owhinata/zaitaku-mealpace/docs/img/cover.png

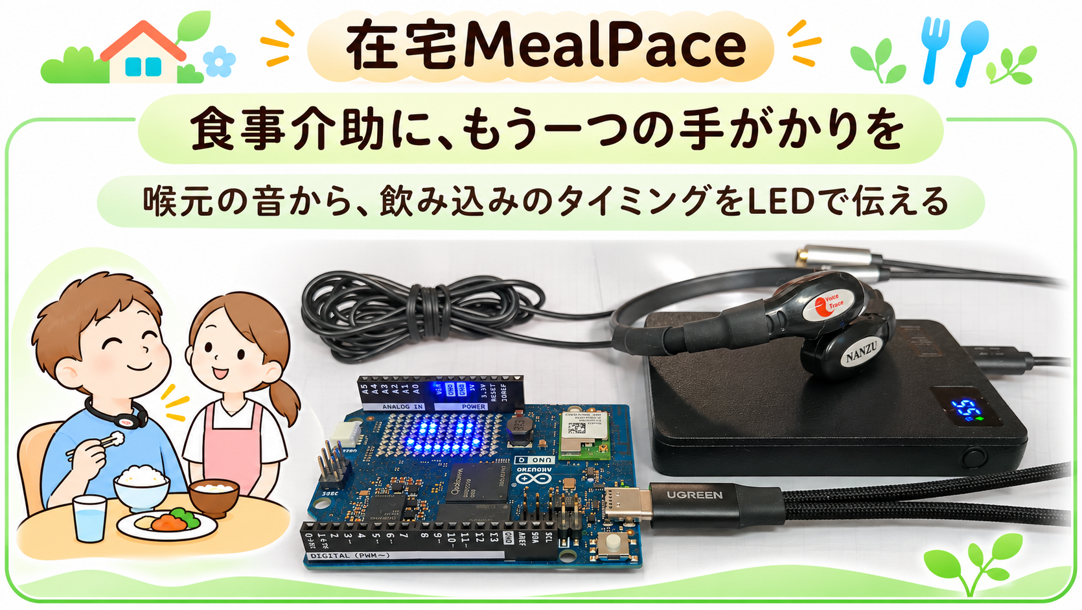
docs/img/cover.png
