owhinata/zaitaku-mealpace/data/README.md

# data/

- `raw/`: ローカルのみ。.gitignore 済み。**コミットしない。**
- `sample/`: 被験者 `self` の 10 秒以内の見本のみ。形式の確認用。
  `tools/record.py` の出力先は `raw/` 固定なので、見本は `raw/` から手でコピーして置く
  （docs/decisions/0007）。
  見本は `self` / `quiet` の記録から、連続する 10.000 秒（音声 2500 チャンクと同じ時刻の範囲の IMU）を
  切り出したもの。`sample_index` は 0 始まりに振り直し、`t_ms` は元のまま（装置の `millis()`。0 始まりではない）。
  IMU の実効レートは約 105.5 Hz（公称 104 Hz）。時刻は `t_ms` が正。

被験者 `p1` の生データは `self` と同じく `raw/` に置き、モデル確定後に削除する。`sample/` には置かない（CLAUDE.md、docs/decisions/0048）。
