owhinata/zaitaku-mealpace/analysis/README.md

# analysis/

PC 側の解析・評価。ファームウェアが何で書かれていても、`docs/data-schema.md` の形式が入力。

- `features.py`   窓ごとの特徴量（IMU＋音。M1 の式、docs/decisions/0012。咽喉マイクは音の 15 次元だけ、docs/decisions/0031）
- `features_m2.py`  窓ごとの特徴量（IMU＋音。M2 の式、docs/decisions/0020。IMU と窓は `features.py` を流用）
- `evaluate.py`   `docs/evaluation.md` の定義でイベント単位の検出率・誤検出率を出す
- `split.py`      セッション単位で学習／評価を分ける（窓単位の分割は実装しない）
- `train_eval.py` M1 の分岐点: ロジスティック回帰で学習し、上の3つを使って採点した報告を出す（`--throat` で咽喉マイクのセッション。M3）
- `features_v2.py`・`postprocess.py`・`compare.py`・`visualize.py` 咽喉マイクの特徴量の組と後処理を学習側の交差検証だけで比べ、図にする（#43、docs/decisions/0033）
- `features_np.py`・`make_features_np_consts.py` 咽喉マイクの間引き・`mfe40`・`a52`・CNN の順伝播の numpy だけの実装（装置と PC で同じコード）と、それが読むメル行列・照合用の参照を作るスクリプト（#44、docs/decisions/0035 の追記）
- `make_runtime_models.py` 乱数の重みの CNN を ONNX・TFLite・ncnn に書き出す（UNO Q の推論ランタイムの比較の計測用。学習済みではない。#51、docs/decisions/0039）
- `final_eval.py` 咽喉マイクの評価側を、事前に登録した 2 つの構成で 1 回だけ採点する（#40、docs/decisions/0034）
- `m4_compare.py` M4 の誤検出を減らす候補（後処理・種の平均・hard negative）を M4 の学習側の交差検証だけで比べ、構成（docs/decisions/0038）と最終モデルを作る（#45）
- `m4_infer.py`   M4 の推論を装置（UNO Q の `detector.py`）と PC で同じコードで行う（重みの読み込み・`model_prob`・1 窓ずつ進める `Detector`・`code_sha256`。#47。`device/unoq/m4_infer.py` はこのファイルへのリンク）
- `evaluate_detector.py` M2 の検出器のセッション（`detect.csv`・`events.csv`）を `evaluate.py` の数え方で採点した報告を出す（#23、docs/decisions/0021）
- `led_rule.py`   `detect.csv` の `positive` と `window_t_ms` から LED の状態（1 黄 / 2 緑）を docs/decisions/0018 の規則で再計算する（#25。`firmware/detector/led_rule.h` と同じ式。評価には使わない）。1 窓ずつの `LedStepper` は装置の `detector.py` も使う（#47。`led_states` はその繰り返し）
- `ei_upload.py`  M2 の特徴量ベクトル（1 窓 1 項目）を Edge Impulse に投入する（#21。生の音声・IMU は上げない）
- `m2_norm_header.py` `m2_norm.json` → `firmware/detector/m2_norm.h`（正規化の定数。#22）
- `m2_scorer.py`  書き出した C++ ライブラリを PC 上で動かす実行ファイルで窓を採点する scorer（`evaluate_detector.py --scorer` の形。#22）
- `m2_threshold.py` 検証側（収集日4）をイベント単位に採点し、閾値の表を出して `firmware/detector/m2_threshold.h` に凍結する（#22）
- `ei_testing_result.py` Edge Impulse の Model testing の窓ごとの結果を API で取り、PC の確率と突き合わせる（#22）

M1 では `features.py` ＋ ロジスティック回帰、M2 から Edge Impulse。

## 特徴量（`features.py`）

窓は 1.0 秒 / 0.25 秒（`evaluate.py` の `WINDOW_S` / `HOP_S` を import する）。1窓 29 次元。式の定義と理由は
`docs/decisions/0012-feature-definitions.md`。M1 の PC 側の評価用の定義で、#13 の結果を見てから動かさない。
依存は numpy と標準ライブラリだけ。

```
python analysis/features.py <セッションフォルダ>
```

表示するのはセッション名・窓の数・次元・`valid` の数・最初と最後の `t_start_s` だけ。特徴量の値は表示しない。
特徴量をファイルに書く機能は無い（使う側が `extract_session` を呼んで、その場で計算する）。

```python
f = features.extract_session(session_dir)   # WindowFeatures(session, t_start_s (n,), X (n, 29) float32, valid (n,) bool)
s = features.Standardizer.fit([学習側の WindowFeatures, ...])   # valid な窓だけ。s.sessions に使ったセッション名
Z = s.transform(f.X)
```

`extract_session` は常に正規化前の値を返す。正規化の統計量は `Standardizer.fit` に渡したセッションだけから作る
（評価側を渡さない）。`std` が 0 の次元は 1 に置き換える。有効な窓が無い `fit`、末尾が 29 次元でない `transform` は
`ValueError`。戻り値に生の波形と IMU の系列は含めない。

### 次元の一覧（`FEATURE_NAMES` と同じ順）

前処理: 加速度 3 軸とジャイロ 3 軸は、それぞれ窓内の平均を引く。フィルタは掛けない。分散・RMS は ÷ n。

| # | 名前 | 定義 | 次元 |
|---|---|---|---|
| 0–2 | `acc_ptp_x` `acc_ptp_y` `acc_ptp_z` | 振幅: 加速度の各軸の peak-to-peak（g） | 3 |
| 3 | `gyro_norm_ptp` | 振幅: ジャイロのノルムの peak-to-peak（deg/s） | 1 |
| 4–6 | `acc_rms_x` `acc_rms_y` `acc_rms_z` | RMS: 加速度の各軸 | 3 |
| 7–9 | `gyro_rms_x` `gyro_rms_y` `gyro_rms_z` | RMS: ジャイロの各軸 | 3 |
| 10 | `acc_peak_count` | ピーク数: 加速度のノルムの局所極大（`x[i] > x[i−1]` かつ `x[i] ≥ x[i+1]`、窓の両端は数えない）。高さがノルムの窓内 RMS × 1.0 以上、最小間隔 50 ms（`t_ms` の差。近いものは高いほうを残す） | 1 |
| 11–13 | `acc_axis_x` `acc_axis_y` `acc_axis_z` | 主軸方向: 加速度の 3×3 共分散行列の第1固有ベクトル（単位ベクトル）。符号は Y、X、Z の順で最初の `|成分|` ≥ 1e-6 を正に。λ1 < 1e-8 g²（静止）か `λ1 − λ2 < 0.01 × λ1` のときは `[0, 1, 0]` | 3 |
| 14–26 | `mfcc_0` 〜 `mfcc_12` | MFCC: フレーム 25 ms（400）/ 10 ms（160）、Hamming、プリエンファシス 0.97、`n_fft` 512、パワーは `|FFT|² ÷ 512`、メル 26 本（0〜8000 Hz、HTK 式、三角フィルタは面積の正規化なし）、`log(E + 1e-10)`、DCT-II（ortho）の先頭 13 係数（c0 を含む）。窓内の 98 フレームの平均 | 13 |
| 27 | `spectral_centroid_hz` | スペクトル重心: フレーム（MFCC と同じ切り方、Hamming、プリエンファシス前）ごとの `Σ f·P / Σ P`（Hz）の窓内平均。`Σ P < 1e-12` のフレームは 0 | 1 |
| 28 | `zero_crossing_rate` | ゼロ交差率: 窓内の平均を引いた波形の符号（`≥ 0` を正）の変化回数 ÷ (N − 1) | 1 |

音声は int16 を 32768 で割った float32。読み込みは標準ライブラリの `wave`。

### 定数（`features.py` の冒頭）

| 定数 | 値 | 意味 |
|---|---|---|
| `AUDIO_HZ` | 16000 | これ以外のサンプルレートは `ValueError` |
| `AUDIO_CHUNK_T_OFFSET_MS` | 0.0 | 先頭サンプルの時刻への換算のあとに足す補正（下の #15 の注記） |
| `GAP_RATIO` | 1.5 | 1周期のこの倍以上の差分を飛びとする（`tools/check_session.py` と同じ）。音声は空白が周期の `GAP_RATIO − 1` 倍以上 |
| `MIN_IMU_ROW_RATIO` | 0.9 | 窓の IMU 行数が期待（1.0 ÷ 周期）のこの割合未満なら `valid = False` |
| `PEAK_HEIGHT_RMS_RATIO` / `PEAK_MIN_DISTANCE_S` | 1.0 / 0.050 | ピーク数 |
| `AXIS_SIGN_EPS` / `AXIS_MIN_EIGENVALUE` / `AXIS_MIN_EIGEN_GAP_RATIO` / `AXIS_DEFAULT` | 1e-6 / 1e-8 / 0.01 / `[0, 1, 0]` | 主軸方向 |
| `FRAME_LEN` / `FRAME_HOP` / `PREEMPHASIS` / `N_FFT` / `N_MEL` / `MEL_FMIN_HZ`–`MEL_FMAX_HZ` / `LOG_FLOOR` / `N_MFCC` | 400 / 160 / 0.97 / 512 / 26 / 0–8000 / 1e-10 / 13 | MFCC |
| `CENTROID_MIN_POWER` | 1e-12 | スペクトル重心を 0 にするフレームの `Σ P` の境 |

### `t_ms` の扱いと窓

- 時間軸は装置の `t_ms` ÷ 1000（秒）。0 への付け替えはしない。`evaluate.load_events` と同じ軸なので、`t_start_s` は
  そのまま `event_metrics` の `positive_windows` に使える。
- チャンクの `t_ms` は、装置がそのチャンクを読み出した直後の時刻（論理上はチャンクの終端側。`docs/data-schema.md`、
  docs/decisions/0013）。チャンクごとの長さ `L[i] = sample_index[i+1] − sample_index[i]`（最終行は WAV のサンプル数 −
  `sample_index[last]`）を使い、先頭サンプルの時刻のアンカーを
  `anchor[i] = (t_ms[i] − 1000 × L[i] ÷ 16000 + AUDIO_CHUNK_T_OFFSET_MS) ÷ 1000` 秒とする（64 サンプルなら `t_ms` の 4 ms 前）。
- 音声サンプルの時刻は `(sample_index[i], anchor[i])` から出す。チャンクの間は線形補間、最後のアンカー以後は 16 kHz の
  傾きで WAV の最後まで補外する。最頻のチャンク長（`sample_index` の差分の最頻値）は、入力の検証と音声の1周期に使う。
- 各ストリームの範囲は半開区間。音声は `[先頭サンプルの時刻, 最終サンプルの直後の時刻)`、IMU は
  `[最初の行の t_ms, 最後の行の t_ms + 1周期)`。窓は両者の重なりに、遅いほうの開始から 0.25 秒刻みで置く。
  IMU の1周期は、飛びでない `t_ms` の差分（中央値の 1.5 倍未満）の平均。
- IMU は `t_ms` が `[開始, 開始 + 1.0)` に入る行（約 105 行）。音声は窓の開始時刻に最も近いサンプルから 16000 サンプル固定。
- 取りこぼし: IMU は `t_ms` の差分が 1.5 周期以上の箇所を飛びとし、飛びの区間は `(前の時刻, 次の時刻)`。音声は換算後の
  時刻から出す。前のチャンクの推定の終端 `end[i] = anchor[i] + L[i] ÷ 16000` と次のチャンクの推定の先頭 `anchor[i+1]` の
  間の空白が、周期（最頻のチャンク長 ÷ 16000）の `GAP_RATIO − 1` = 0.5 倍（64 サンプルなら 2 ms）以上なら飛びとし、
  飛びの区間は `(end[i], anchor[i+1])`。チャンク長が一定なら「`t_ms` の差分が 1.5 周期以上」（`tools/check_session.py`）と
  同じ判定で、長さの違う正常なチャンク（32 / 96 サンプル）は飛びにならない。
- 飛びの区間と交わる窓、IMU の行数が期待の 90% 未満の窓、音声が 16000 サンプルに満たない窓は `valid = False`。
  窓は落とさず、グリッドは等間隔のまま返す。
  無効な窓でも `X` は有限値（窓に入ったサンプルで計算。IMU が 2 行未満なら IMU の 14 次元、音声が足りなければ音の
  15 次元を 0 にする）。無効な窓を学習と正規化から外すこと、評価での扱いは #13 で決める。
- 入力の検証（合わなければ `ValueError`）: `audio.wav` が mono・int16・16000 Hz（`meta.json` のトップレベル `audio_hz`
  を優先し、無ければ `sample_rates.audio_hz`。docs/decisions/0006。WAV のヘッダーとも一致）、`audio_chunks.csv` が
  2 行以上・最初の `sample_index` が 0・`sample_index` が狭義の単調増加・`t_ms` が単調非減少、最終チャンクの長さ
  （WAV のサンプル数 − 最後の `sample_index`）が 1 以上チャンク長以下、`imu.csv` が 2 行以上で `t_ms` が単調非減少。

### #15 の注記（`AUDIO_CHUNK_T_OFFSET_MS`）

#15 の結論（docs/decisions/0013）: 文書を実装に合わせた。チャンクの `t_ms` は「読み出した直後の時刻」で、先頭サンプルの
時刻は上の換算（`t_ms` − チャンクの長さぶん）で出す。この換算はコードから定めた論理上の時刻で、約 4 ms を実測で証明した
ものではない。記録済みのセッションの変換は要らない（CSV と WAV の値は変わらず、読み方だけが変わる）。
`AUDIO_CHUNK_T_OFFSET_MS`（既定 0.0）は、換算のあとに足す補正（ms）。系統的なずれが分かったとき用で、0.0 のまま残してある。

## M2 の特徴量（`features_m2.py`）

M2 の検出器（Edge Impulse の分類器）に渡す 29 次元。式の定義と理由は `docs/decisions/0020-m2-audio-features.md`。
0012 の式のうち音の 15 次元（MFCC 13、スペクトル重心、ゼロ交差率）だけを M2 用に置き換えたもので、IMU 14 次元・
読み込みと検証・チャンクの時刻の換算・飛び・窓の格子・`valid` の規則は `features.py` の関数を import して使う
（`features.py` は M1 の定義として残し、変えていない）。依存は numpy と標準ライブラリだけ。

| 項目 | M2（`features_m2.py`） | M1（`features.py`） |
|---|---|---|
| 音の周波数 | 8 kHz（16 kHz の隣り合う 2 サンプルの平均 `(a + b) >> 1`。int32 の整数演算、奇数長は最後を捨てる） | 16 kHz |
| 窓 | 8000 サンプル（開始に最も近い 8 kHz のサンプルから固定長） | 16000 |
| フレーム | 25 ms（200）/ stride 25 ms（200、重なりなし）。1 窓 40 フレーム、1 ホップ 10 フレーム | 400 / 160、98 フレーム |
| プリエンファシス | 0.97。フレームごとに独立（各フレームの `pre[0] = x[0]`） | 窓全体に掛けてから切る |
| FFT・メル | Hamming（200）、`n_fft` 256（129 ビン）、メル 26 本 0〜4000 Hz、DCT-II の先頭 13 | 512、0〜8000 Hz |
| スペクトル重心 | MFCC と同じ（プリエンファシス後の）パワースペクトルから | プリエンファシス前の別の FFT |
| ゼロ交差率 | 8000 サンプル ÷ 7999 | 16000 ÷ 15999 |

- 公開する API は `features.py` と同じ形。`extract_session(session_dir) → features.WindowFeatures`（`X` は (n, 29) float32、正規化前）。
  窓の数・`t_start_s`・IMU 14 次元・`valid` は同じセッションに対して `features.extract_session` と一致する。
- `FEATURE_NAMES` は `features.FEATURE_NAMES` の再公開（同じ順・同じ名前）。M1 の値と取り違えない目印は
  `FEATURE_SET = "m2-0020"`（`analysis/m2_norm.json` と検出器のセッションの `meta.json` の `feature_set` に書く）。
- 正規化は `features.Standardizer` をそのまま使う（`fit` / `transform` は次元数 29 だけを見る）。
- 表示（`python analysis/features_m2.py <セッションフォルダ>`）はセッション名・式の識別子・窓の数・次元・`valid` の数・最初と最後の
  `t_start_s` だけ。特徴量の値は表示せず、ファイルにも書かない。
- 定数（`FEATURE_SET`、`AUDIO_HZ_IN`、`AUDIO_HZ`、`DECIMATION`、`WINDOW_SAMPLES`、`HOP_SAMPLES`、`FRAME_LEN`、`FRAME_HOP`、`PREEMPHASIS`、
  `N_FFT`、`N_MEL`、`MEL_FMIN_HZ`–`MEL_FMAX_HZ`、`LOG_FLOOR`、`N_MFCC`、`CENTROID_MIN_POWER`）はモジュール冒頭。0020 で固定し、動かさない。
- 装置側の同じ式は `firmware/bench/`（`-DAF_PROFILE=1`）で、`firmware/bench/host/check_port.py --profile m2` が `features_m2` と比べる。

## Edge Impulse への投入（`ei_upload.py`）

`features_m2.extract_session` で出した 29 次元を `features.Standardizer` で正規化し、1 窓 = 1 項目（`swallow` / `cough` / `other`）として
Edge Impulse（EI）の ingestion API に送る。生の音声・IMU の窓は上げない。投入するデータ・ラベルの規則・分け方は docs/decisions/0019、
式と正規化の定数は 0020。依存は numpy と標準ライブラリ（`urllib`）だけで、EI の SDK は使わない。

```
python analysis/ei_upload.py data/raw --bucket training --days 20260921,20260922,20260923 --workers 8 [--dry-run]
python analysis/ei_upload.py data/raw --bucket training --days 20260921 --reuse-norm --workers 8 [--dry-run]
python analysis/ei_upload.py data/raw --bucket testing --days 20260924 --workers 8 [--dry-run]
python analysis/ei_upload.py --probe [--dry-run]
```

- **分割**: `split.split_sessions(root, 7, "self")` の `train` が収集日 `20260921`・`20260922`・`20260923` の各 7 本、`eval` が `20260924` の
  7 本ちょうどであることを検査する（外れたら止まる）。`--days` はその収集日の部分集合。`--bucket training` に収集日4 は入れられず、
  `--bucket testing` は収集日4 だけを受け付ける。subject は `self` 固定（`p1` のセッションは投入しない）。
- **ラベル**（`window_labels3`）: 全窓を `other` にし、各 `c` について窓の中心が `[t_c − 0.5, t_c + 1.5]` の窓を境目、次に `[t_c, t_c + 1.0]` を
  `cough` にし、その後で各 `s` について同じ形で境目 → `swallow` を掛ける（`s` の陽性と境目が `c` の規則より優先。近接した 2 つの嚥下では
  陽性が境目より優先）。`swallow` の窓は `train_eval.window_labels` の陽性と同じ集合。`t`・`n`・`q` は `other`。
- **投入しない窓**: `valid = False` の窓と境目の窓。除外した数（無効 / 境目）をセッションごとに出す。`other` の間引きはしない。
- **正規化**: `--bucket training` は fit セッション（`--days` から `--validation-day` を除いたもの）の `valid` な窓の全部で
  `Standardizer.fit` し、定数を `analysis/m2_norm.json`（`feature_set`、`feature_names`、`mean`、`std`、`stats_sessions`、`n_windows`、
  `commit`。集計値のみ）に書く。ファイルが既にあって `commit` 以外の内容が違えば止まる（黙って上書きしない。作り直すときは人が消す）。
  `--bucket testing` はそのファイルを読んで使い（無ければ止まる。`stats_sessions` に収集日4 があれば止まる）、収集日4 から統計量を作らない。
  投入する値は `transform` の後の float32。
- **`--reuse-norm`**（既定 off。`--bucket training` 専用）: 一部の収集日だけを入れ直すとき（例 `--days 20260921`）、統計量を作り直さず
  既存の `m2_norm.json` をそのまま使う。`stats_sessions` が収集日1〜3 の 21 本で `--days` のセッションを含み、`feature_set` と
  `feature_names` が一致することを確かめ、違えば止まる。ファイルは書き換えない。一覧の「正規化の定数」に「既存の定数を使用」と出す。
  `--reuse-norm` なしで `--days` が 3 日そろっていないと、`m2_norm.json` があれば従来どおり内容の不一致で止まる。
- **項目の形**: EI のデータ取得の JSON（`protected.alg = "none"`、`interval_ms` 1000、`sensors` は `FEATURE_NAMES` の 29 個、`values` は
  1 行 29 個）。ファイル名 `<セッション名>_<t_ms>.json`（`t_ms` は窓の開始 `round(t_start_s × 1000)`）。ヘッダは `x-label`、
  `x-metadata`（`session`・`day`・`t_ms`・`subject`・`feature_set`。値はすべて文字列）、`x-file-name`（ファイル名と同じ。EI の ingestion API が
  要求し、無いと HTTP 422。#21 の probe で判明）、`x-disallow-duplicates: 1`、`x-api-key`。multipart の form field 名は `data`。
  `protected.iat` は決定的（セッション名の先頭 `YYYYMMDD-HHMMSS` を JST の epoch 秒にし `t_ms // 1000` を足す。実行時刻は使わない）なので、
  再送は同じバイト列になり EI の重複検査で弾かれる。
- **転送**: `https://ingestion.edgeimpulse.com/api/<training|testing>/data` に multipart/form-data を POST。**1 リクエスト 1 項目**
  （`x-metadata` がリクエスト単位に掛かるため）。失敗（HTTP 4xx/5xx、接続の失敗）は 3 回まで再試行し（待ち 1・2・4 秒）、それでも
  失敗したら、止まった場所（セッション名、そのセッションで送った項目数、全体で受け付けられた項目数）を出して止まる。
  `x-disallow-duplicates` で弾かれた項目（HTTP 400 で本文に duplicate / already exists）は再試行せず数だけ数える（再実行のとき）。
  進み具合はセッションごとに 1 行。送信の関数は `run(argv, send=..., sleep=...)` で差し替えられる（`send(url, headers, files) → (status, body)`）。
- **`--workers N`**（既定 1 = 逐次）: N 本のスレッドで項目を並列に送る（1 リクエスト 1 項目・ヘッダ・再試行・重複の扱いは同じ）。
  進み具合の 1 行はセッションの全項目が終わってから。ある項目が 4 回失敗したら、未着手の項目を取り消し、進行中の送信を待ってから止まる。
- **API キー**: 環境変数 `EI_API_KEY`。無ければ `--dry-run` 以外は止まる。値を標準出力・例外・ログに出さない（応答の本文に含まれていても伏せる）。
- **`--dry-run`**: 送信も `m2_norm.json` の書き込みもせず、一覧だけを出す。投入の前に人が一覧を見る。
- **`--probe`**: 乱数（seed 固定）の 29 次元を 9 項目（`swallow` / `cough` / `other` × 3。群 `probe-a` / `probe-b` / `probe-c`、
  `day` = `probe-1` / `probe-2` / `probe-3`、件数 2 / 3 / 4、`t_ms` は群の中で 0, 1000, …。`subject` と `feature_set` は `probe`）を
  training に送り、EI の受け付け（1 行の項目、`x-metadata`、メタデータの鍵による validation の分割）を確かめる。実データは使わない。
  送る先は `EI_API_KEY` の指すプロジェクト（#17 のダミー）。
- **標準出力**（`docs/log/` に貼る）: 実行の条件（コマンドライン、コミット、`feature_set`、numpy の版、dry-run か）、セッションごとの表
  （収集日、bucket、役割 fit / validation / test、全窓、`valid`、投入、クラスごと、除外）、合計（bucket・役割・収集日・クラスごと）、
  `stats_sessions` と窓の数、収集日ごとの投入数、送信したリクエスト数と受け付けられた項目数（Studio の項目数と照合する）。
  `--bucket training` では収集日ごとの投入数が互いに異なることを検査する（同数の日があれば止まる。EI の validation の件数から
  選ばれた日を読み取るため）。特徴量の値・波形・個々の窓の一覧は出さない。

## 学習と評価（`train_eval.py`）

M1 の分岐点の数字（#13）を出す。手順の定義と理由は `docs/decisions/0014-m1-training-procedure.md`。
実データを見る前に固定した。結果を見てから、ラベルの規則・閾値の決め方・モデルの設定・分割を動かさない。
依存は numpy と scikit-learn（`tools/requirements.txt`）。

```
python analysis/train_eval.py data/raw --eval-min <N>           # 既定。学習側だけ
python analysis/train_eval.py data/raw --eval-min <N> --final   # 評価側を採点する
```

- `--eval-min` は必須。最後の2収集日のセッション数（`docs/recording-protocol.md`。`--throat` では最後の 1 収集日、下の「咽喉マイク」）。subject は `self` 固定。
- **既定の実行**は学習側のセッションだけを使い、交差検証の数字と閾値を出す。何度実行してもよい。評価側は
  `meta.json`（`split_sessions` が subject の検査に読む）のほかは開かず、報告にはセッション名だけを出す。
- **`--final`** を付けたときだけ、評価側を採点する。実行した後は評価側を動かさない。
- 報告は標準出力に Markdown で出す。ファイルは書かない（モデル・特徴量・確率を保存しない）。
  波形、特徴量の値、個々の窓の確率は出さない。

### 手順の要約

1. 分割: `split_sessions(root, eval_min, subject="self")`。フォルダ名の日付で、評価側がちょうど 2 収集日、学習側が
   1 収集日以上、学習側のどの日も評価側のどの日より前、を検査する。外れたら止まる。
2. 特徴量: `features.extract_session`。`valid = False` の窓は学習と正規化に使わず、採点では陰性として扱う
   （陽性にしない）。数を報告に出す。
3. 学習のラベル: 嚥下のマーカー `t` に対して、窓の中心 `w + 0.5` が `[t, t + 1.0]` に入る窓が陽性。中心が
   `[t − 0.5, t)` か `(t + 1.0, t + 1.5]` の窓は学習に使わない。どの嚥下の `[t − 0.5, t + 1.5]` にも中心が入らない窓が
   陰性。学習のラベルだけの規則で、評価の数え方（`docs/evaluation.md`、docs/decisions/0011）は変えない。
4. モデル: `features.Standardizer`（統計量は、学習に使うセッションの `valid` な窓の全部。「使わない」窓も入れる）＋
   `LogisticRegression(C=1.0, class_weight="balanced", max_iter=1000)`（`lbfgs`。乱数を使わない）。探索しない。
5. 交差検証（学習側だけ）: 学習側の収集日が 2 日以上なら収集日ごと、1 日なら1セッションごと。fold ごとに
   `Standardizer` とモデルを作り直す。グループが 2 つ未満、fold の学習側に陽性と陰性がそろわない、合算で嚥下が 0 件か
   非嚥下の時間が 0、のときは fold とセッション名を示して止まる。
6. 閾値: 候補 0.05, 0.10, …, 0.95 を、交差検証の確率に対して評価と同じ数え方（`event_metrics` → 回数の合算）で採点する。
   誤検出率が 3.0 回/分以下の候補のうち検出率が最大（同率なら高いほう）。無ければ誤検出率が最小（同率なら高いほう）。
7. 最終モデルは学習側の全セッションで作り直す。`--final` のときだけ、評価側のセッションごとに `event_metrics` を計算し、
   `split_sessions` が返した `eval` の一覧をそのままキーにして `evaluate.aggregate` に渡す。
8. 参考値として、常時陽性の場合（全窓を陽性にした場合）の数字と、陽性窓の割合（陽性窓 ÷ 全窓）を並べる
   （docs/decisions/0011「既知の弱点」）。

### 再現の条件

同じ入力で、同じコミット・同じ依存の版（scikit-learn、numpy）・同じ実行環境なら、報告は一字一句同じになる
（`lbfgs` は乱数を使わない）。版や BLAS、実行環境をまたいだ一致は保証しない。報告の「実行の条件」に出る
コミットのハッシュと scikit-learn・numpy の版が、再現の条件。
追跡しているファイルに未コミットの変更があると、報告のコミットに `-dirty` が付く。`--final` は、その状態では
採点せずに止まる（先にコミットする）。既定の実行は止まらない。

### 咽喉マイク（`--throat`。M3、docs/decisions/0031・0032）

咽喉マイクのセッション（`meta.json` の `fw` が `pc-throat`、iface `sh12jk-wired-unoq-usbaudio`。docs/decisions/0028・0029）は、
**咽喉マイクのセッションだけで**分割・学習・評価する（M1 の 28 本・M2 の `meal` と混ぜない）。

```
python analysis/split.py data/raw --kind throat --eval-min 7                 # 分割の一覧だけ（ファイルの中身は開かない）
python analysis/train_eval.py data/raw --eval-min 7 --throat                 # 既定。学習側だけ
```

- **`--throat --final` は止まる**（CLI と `run()` の両方。評価側のファイルを開く前）。咽喉マイクの評価側は `final_eval.py` で 1 回だけ採点する
  （下の「咽喉マイクの評価側の採点」、docs/decisions/0034）。

- 分割: `split_sessions(root, eval_min, subject="self", kind="throat")`（CLI は `split.py --kind throat`。既定の `kind="m1"` は
  今までどおり）。`kind="throat"` は `fw` が `pc-throat` のセッションだけを分け、M1 と `detector` は戻り値の `excluded` に並べる。
  iface が違う、`throat.wav`・`throat_chunks.csv` が無い、`imu.csv`・`audio.wav`・`audio_chunks.csv`・`detect.csv`・`feat.csv` の
  どれかがある、のときは止まる（`meta.json` とファイルの有無だけを見る）。`kind="m1"` は咽喉マイクのセッションを `train` / `eval` に
  入れず、戻り値の `throat` に並べる。`fw` が `pc-throat` でないのに `throat.wav` があるセッションは、どちらの `kind` でも止まる。
  `data/raw/` の直下で名前がちょうど `trial-throat` のディレクトリ（シンボリックリンクでないもの）は読まずに飛ばし、`skipped` に並べる。
- **評価側の収集日は最後の 1 収集日**（`train_eval.THROAT_EVAL_DAYS = 1`。docs/decisions/0032）。M1 は最後の 2 収集日
  （`EVAL_DAYS = 2`）のまま。日数は `--throat` の有無だけで決まり、引数では選べない。`--eval-min` は最後の 1 収集日のセッション数。
  学習側は 1 収集日なので、交差検証は1セッションごと（0014 手順 4）。
- 特徴量: `features.extract_throat_session`。0012 の音の 15 次元（`AUDIO_FEATURE_NAMES` = `FEATURE_NAMES[14:]`）、IMU なし（0026）。
  `throat.wav` の L（ch0）を `scipy.signal.resample_poly(x, 1, 3)` で 16 kHz に落とし、32768 で割る。16 kHz のサンプル `j` の時刻は
  `tools/throat_check.py` の `sample_time_map` の対応で `τ(3j)`（叩きの `Δ` で直さない）。窓の作り方は M1 と同じで、
  `valid = False` は 16000 サンプルに満たない窓だけ。入力の検査（`fw`、`sample_rates.audio_hz` と WAV のヘッダが 48000、2 ch・16 bit、
  `sample_index` が 0 から厳密に増加して N 未満）と、`throat_check.check()` の `flags`（overrun の行・`|推定差|` > 125 ms・段差）に
  当たるセッションは `ValueError` で止まる。叩きの `tap_flags` では止めない。
- 記録の範囲: `evaluate.throat_session_span`。始まり = `events.csv` の `o start`（note が `start` の `o`）の `t_ms`、終わり = 最後の
  サンプルの時刻 `τ(N)`。`o start` が無い・2 つ以上、始まりが終わり以降、`throat_chunks.csv` の `t_ms` の逆行・1 秒超の飛びは止まる。
  `s` 以外のマーカーが `o start` より前にあっても止めない（範囲の外の `s` は `event_metrics` がエラー）。
- 既定の実行では評価側の `throat.wav`・`throat_chunks.csv`・`events.csv` を開かない。報告の見出しは「M3 咽喉マイク」、
  実行の条件に対象・`kind=throat`・評価側の収集日（1）・scipy の版が出る。M3 の数字を M1 と並べるときは「評価側 1 収集日」を注記する。
- 依存: 咽喉マイクの経路だけ scipy を使う（`.venv` にある）。scipy と `tools/throat_check.py` は咽喉マイクの経路の関数の中で読み込み、
  M1 の経路は numpy だけで動く。**再現の条件**は上の M1 の条件に scipy の版を足したもの（`resample_poly` が採点の経路に入る）。

## 咽喉マイクの特徴量の組と後処理の比較（`features_v2.py`・`postprocess.py`・`compare.py`・`visualize.py`。#43）

式・格子・選び方は `docs/decisions/0033-throat-mic-feature-set-comparison.md`（学習側の数字を見る前に固定）。手順は 0014・0032 のまま
（ラベル、正規化、ロジスティック回帰、閾値の格子と規則、止まる条件、評価側 = 最後の 1 収集日）。**学習側（収集日 1）だけを読む。**
評価側は `split_sessions` が返す名前だけを扱い、`throat.wav`・`throat_chunks.csv`・`events.csv` を開かない。評価側を採点する引数は無い
（評価側の数字は #40 で、選んだ組について 1 回だけ）。

```
python analysis/compare.py data/raw --eval-min 7                                   # 比較の表（標準出力に Markdown）
python analysis/compare.py data/raw --eval-min 7 --figures docs/log/<日付>-43       # 選んだ行の図も描く
python analysis/visualize.py data/raw --eval-min 7 --set a52 --post hyst --out docs/log/<日付>-43 [--sessions <名前> ...]
```

- `features_v2.py`: 組 `base15`（0012 の 15 次元。`features._audio_features` と同じ値を librosa の部品で）、`a52`（MFCC 13 係数、メル 26 本
  0〜4000 Hz の、窓内の平均・最大・標準偏差・デルタの絶対値の平均。52）、`base15_mw`・`a52_mw`（同じ式を判定の窓と中心をそろえた
  0.5・1.0・2.0 秒に当てて並べる。45・156）、CNN の入力 `mfe40`（対数メル 40 本 0〜4000 Hz、98 × 40）。中心はメモリ上の信号から作る
  `window_features(x16k, starts, feature_set, lo, hi)`・`features_one(seg_by_length, feature_set)`・`mfe_one(seg)` で、セッションフォルダの
  読み込みは外側の `extract(session_dir, feature_set)`・`extract_mfe(session_dir)` だけ。窓の格子・`valid`・記録の範囲・サンプルの時刻は
  `features._throat_windows`（`extract_throat_session` と同じもの）。CNN の numpy の順伝播 `cnn_forward` もここから同じ名前で出す
  （本体は `features_np.py`。`mfe40`・`a52` の式も `features_np.py` を呼ぶ。下の節。#44）。
- **`o start` より前の音**: 16 kHz の信号はセッション全体を `features_np.decimate3`（`resample_poly(x, 1, 3)` と同じ係数・位置合わせ。#44）で落としてから窓を切る（`extract_throat_session` と同じ）。
  保証するのは窓の選び方で、どの窓（0.5・2.0 秒を含む）も `[lo, hi)`（`lo` = `o start` に最も近いサンプル、`hi` = 時刻が範囲の終わりより
  前のサンプルの数）の外を切り出さない（2.0 秒の窓は範囲の端で切り詰める）。リサンプルのフィルタの裾（数 ms）による `o start` 直前の音の
  混入は `extract_throat_session`（基準 15 次元）と同じで、変えない。
- 複数窓の 0.5・2.0 秒の窓の開始は、判定の窓の開始サンプルからの固定の差（+4000 / −8000 サンプル）。2.0 秒の窓は判定の窓の終端より
  0.5 秒先の音を要るので、装置では結果が 0.5 秒遅れて出る（報告の「追加の待ち時間」。採点はこの遅れを含まない）。
- `postprocess.py`: `threshold(prob, valid, thr)`（`train_eval.positive_windows` と同じ規則）と `hysteresis(prob, valid, enter, exit, t_start_s)`
  （初期は陰性、陰性のとき `valid` かつ `prob >= enter` で入り、陽性のとき `prob < exit` か `valid = False` で出る）。格子 `HYST_GRID` は
  enter 0.05〜0.95、exit = enter − 0.1 / 0.2 / 0.3（exit ≥ 0.05）の 45 点。多数決は入れない。
- `compare.py`: 組 5 つ × 後処理 2 = 10 行。ロジスティック回帰は `train_eval.cross_validate`、CNN は同じ fold（`cv_groups`）で fold の学習側
  だけで正規化（メルの帯域ごと）・陽性の重み・学習（PyTorch、CPU、種 0、決定的、4 スレッド）。採点の確率は numpy の順伝播。閾値は
  `train_eval.threshold_table`・`pick_threshold`、ヒステリシスは格子の各点を同じ規則で選ぶ。**#40 の候補はロジスティック回帰の 8 行だけ**
  （CNN の 2 行と種 1・2 は参考。#40 で採点する構成は docs/decisions/0034 で改めた。下の節）。報告は標準出力だけ（ファイルを書かない）。波形・特徴量の値・個々の窓の確率は出さない。
- `visualize.py`: 学習側のセッションだけ（評価側・`self` 以外は止まる）。PNG は `docs/log/` の下だけ（外は止まる）、100 dpi。
  セッションごとの図（窓平均 RMS、窓平均メル（0.25 秒ごと）、マーカー、陽性確率、後処理後の陽性、検出／見逃し／誤検出）、イベントごとの
  小図（`s` の前後 2 秒の 20 ms の包絡とフレームごとのメル。検出・見逃し・誤検出から各 4 件、1 枚に 2 件）、組の比較の散布図。
  1 枚の細かい表示（波形と 25 ms 以下の時間分解能）の合計が 10 秒を超えたら止まる（0033 の 6）。
- 依存: librosa・matplotlib（`tools/requirements.txt`）、PyTorch CPU（`analysis/requirements-cnn.txt`。CPU の索引から入れる）。
  `features.py`・`evaluate.py`・`split.py`・`train_eval.py` はこれらを読まない。torch は CNN の学習の関数の中でだけ読む。
- **再現の条件**: 同じコミット・同じ依存の版（報告の実行の条件に `.venv` の全パッケージの版を出す）・同じ実行環境で同じ報告
  （末尾の「時間の実測」の節を除く）。CNN は PyTorch の版・CPU の命令セットをまたいだ一致を保証しない。
  librosa のキャッシュの環境変数（`LIBROSA_CACHE_DIR`（空でも）、`LIBROSA_CACHE_VERBOSE` > 0）や import 済みの librosa のキャッシュが
  有効なときは、特徴量をディスク・標準出力に出さないため `features_v2.py` が止まる（環境変数を外して実行し直す）。
- 計算の時間（D8）: 1 回の実行が PC で 30 分以内の予算。CNN の学習（14 fold × 20 エポック × 種 3 つ）が大半を占める。

## numpy だけの間引き・特徴量・順伝播（`features_np.py`・`make_features_np_consts.py`。#44）

UNO Q の Linux 側（numpy 2.2.4 だけ。librosa・scipy は無い）と PC で同じコードを使う（0025、0035 の追記）。`device/unoq/features_np.py` は
このファイルへのリンクで、`deploy-unoq` が中身を配る。依存は numpy と標準ライブラリだけ。ファイルを書かず、標準出力に出さない。

- 間引き（48 kHz → 16 kHz）: `decimate3(x)`（セッション全体。`scipy.signal.resample_poly(x, 1, 3)` と同じ 61 タップ（`firwin(61, 1/3,
  window=("kaiser", 5.0))` と同じ式）・同じ位置合わせ・長さ ceil(n / 3)）と、ブロックごとの `Decimate3().process(block)`（出力をつなぐと
  `decimate3` の先頭と一致。遅れは入力 30 サンプル）。`tools/throat_check.py` の `to_analysis` も `decimate3` を使うので、学習用 `meal` の経路
  （`features._throat_windows` → `features_v2`）も装置と同じ係数で間引く。
- 特徴量: `mfe40(seg)`（`features_v2.mfe_one` と同じ式、(98, 40) float32）、`a52(seg)`（MFCC 13 は DCT-II（ortho）の行列、デルタは中心の係数
  k / 60・端は複製で `librosa.feature.delta(width=9, mode="interp")` と同じ値）。`cnn_forward(params, M)`（`features_v2` から移した）。
- メル行列は `mel40_htk_0_4000.npy`（40 × 257）・`mel26_htk_0_4000.npy`（26 × 257）を読む（`librosa.filters.mel`、HTK、0〜4000 Hz、面積の
  正規化なし）。`features_np_ref.npz` は照合用の参照（間引きのタップと、決定的な合成入力（`reference_signal`・`reference_cnn`。乱数を使わない
  数式）に対する librosa 版の `mfe40`・`a52` と順伝播の出力。入力の信号そのものは入れない）。どれも音声ではない。
- 作り直し（PC。librosa・scipy を使う）: `python analysis/make_features_np_consts.py` は作り直した値と既にあるファイルを比べるだけ（違えば 1）。
  `--write` のときだけ上の 3 つを書く。`features_v2` は import の時点で `.npy` を読むので、消えたときは git から戻す。
- 装置の計測は `device/unoq/bench_infer.py`（合成入力だけ。最初に `features_np_ref.npz` と照合）。走らせ方は docs/unoq-setup.md、結果は docs/log/2026-10-24.md。
- `random_cnn(rng)` は時間を測るための乱数の重み（`compare.measure_timings` と同じ作り方。学習済みではない）。`bench_infer.py`・`bench_runtimes.py`・
  `make_runtime_models.py`・`test_runtime_models.py` が同じこの関数から重みを作る（#51）。

## 推論ランタイムの比較の計測用のモデル（`make_runtime_models.py`。#51）

UNO Q の CNN の段を別の推論ランタイムに替えて時間を測るため（docs/decisions/0039。計測だけで、装置の推論は numpy のまま）、`random_cnn(default_rng(0))` の重みを
`compare._make_net`（M3 の学習と同じ定義）に載せ、入力 (1, 98, 40) float32・出力ロジット (1,) で書き出す。どれも音声・学習の成果・特徴量ではない（合計 87,069 B）。

- `cnn_rand0.onnx`: `torch.onnx.export`（dynamo、外部データなし）。dynamo は opset 18 で作るので、この CNN で 17 と 18 で違う ReduceMean の axes を属性に戻して opset 17 にし
  （ほかの演算子が出たら止まる）、`ir_version` を 10 以下にする（UNO Q の Debian の ONNX Runtime 1.21 でも読める値）。
- `cnn_rand0.ncnn.param`・`cnn_rand0.ncnn.weights`: `pnnx.export`（`fp16=False`）を一時フォルダに書かせ、ncnn の 2 つだけを持ってくる。最後の 0 次元への Reshape は ncnn で
  実行できないので外す。重みの名前は `.gitignore` の `*.bin` を避けて `.ncnn.weights`。
- `cnn_rand0.tflite`: `litert_torch.convert`（float32、量子化しない）。変換用の venv（リポジトリの外）で走らせる。
- 既定は作り直した物の出力が、置いてある物の出力と同じかを比べるだけ（違えば・無ければ 1）。変換は版でバイト列が変わるので比べるのは出力。`--write` で上の固定のパスに書く。
  `--only onnx,ncnn`（`.venv`）、`--only tflite`（変換用の venv）。
- 依存（装置には要らない）: `.venv` に `requirements-runtimes.txt`（onnx・onnxscript・onnxruntime・ai-edge-litert・ncnn・pnnx。torch は `requirements-cnn.txt` から先に入れる）。
  変換用の venv（`~/.venvs/zaitaku-mealpace-litert-convert`）に `requirements-convert-litert.txt`（torch・numpy・litert-torch と、`compare` が import する scipy・librosa・scikit-learn）。
  作り方は各ファイルの先頭のコメント。
- UNO Q での計測は `device/unoq/bench_runtimes.py`（`bench_infer.py` の (c)・(f) の CNN の段だけをバックエンドに替える。numpy の書き方 3 つ、ONNX Runtime、LiteRT、Arm NN、
  ncnn の CPU と GPU。合成入力だけ、ファイルを書かない）。モデルは `device/unoq/` の同名のリンクで配る。走らせ方は docs/unoq-setup.md、結果は docs/log/2026-10-24.md「#51」。

## 咽喉マイクの評価側の採点（`final_eval.py`。#40）

構成と手順は `docs/decisions/0034-throat-mic-final-eval-cnn-judgment.md`（評価側を開く前に固定し、コミットしてから実行する）。
評価側（最後の 1 収集日の 7 本。0032）を **1 回だけ**採点し、その 1 回で事前に登録した 2 つの構成の数字を出す。

- 構成 J（判定（#41）に使う）: CNN、入力 `mfe40`、種 0、0033 §2 の構成と学習、ヒステリシス 入り 0.95・出 0.85。
- 構成 R（M1 と同じ手法の参照）: `a52` ＋ ロジスティック回帰（0014）、ヒステリシス 入り 0.85・出 0.65。

どちらも学習側の全 14 本で学習し直す（正規化・陽性の重みも学習側だけ）。閾値・後処理・組・種は選び直さない。

```
python analysis/split.py data/raw --kind throat --eval-min 7   # 分割の一覧（名前だけ）を 0034 の FINAL-TRAIN・FINAL-EVAL と照らす
python analysis/final_eval.py data/raw                          # 評価側を 1 回だけ採点する（引数は root だけ）
```

- **引数は root だけ。** 構成・閾値・後処理・種・評価側の日数・`--eval-min`（定数 `EVAL_MIN = 7`）を選ぶ引数も、再実行の引数（`--reproduce` など）も無い。
- **止まる条件**（どれもデータを開く前。印も書かない）: 追跡しているファイルに未コミットの変更がある（`train_eval.git_dirty()`）、
  `analysis/`・`tools/`・`docs/decisions/`・`docs/evaluation.md` に未コミットの変更か未追跡のファイルがある、git が使えない、0034 が無い・git に
  追跡されていない、0034 の `FINAL-` で始まる行が `final_eval.py` の定数（`CONFIGS`・`EXPECTED_TRAIN`・`EXPECTED_EVAL`）と一字一句一致しない、
  印 `docs/log/m3-final-40.txt` がある（中身は見ない）、図の出力先 `docs/log/<実行日>-40/` が既にある、torch・librosa・matplotlib を import できない・
  librosa のキャッシュが有効。続いて `split_sessions(kind="throat")` の一覧が `EXPECTED_TRAIN`・`EXPECTED_EVAL`（順序も）と違えば止まる
  （ここまでで開くのは `meta.json` とファイルの有無だけ）。学習側で止まる条件は 0014・0033 のまま（このときも印は書かない）。
- **印（1 回だけにする仕組み）**: 学習が済み、評価側を開く直前に、固定のパス `docs/log/m3-final-40.txt` を `O_EXCL` で排他作成し、書き込み・fsync・
  close（親のディレクトリも fsync）の後に評価側を開く。中身は実行の開始時刻・HEAD のコミット・0034 のパス・コマンドだけ。作成・書き込み・fsync の
  どれかに失敗したら評価側を開かずに止まる。印は、その後の手順で止まっても消さない（評価側を開いたかもしれない実行として扱う）。
  実行の後、印は log・図と一緒にコミットする。以後、`final_eval.py` はどのコミット・どの実行日からでも止まる。
- **再現**: 人が、初回の採点に使ったコミット（印に書いたコミット）の別 worktree（`git worktree add <場所> <そのコミット>`）で、同じ入力
  （元の `data/raw/` を絶対パスで渡す。`data/raw/` には何も書かない）・同じ依存の版・同じ環境で同じコマンドを走らせ、元の log に
  「再現の実行（初回のコミットの別 worktree）」として記録する。worktree の中の印と図は worktree ごと捨てる。再現の実行の数字は、#41 の数字の
  差し替えにも、構成・閾値・種の選択にも使わない。初回と差が出たら記録して人に渡す。
- **出すもの**: 標準出力に Markdown（実行の条件、学習・評価のセッション一覧と cond、構成ごとの学習の要約・セッションごとの表・合算・混同行列・
  参考値（常時陽性、陽性窓の割合）・合格線との比較（満たす / 満たさない の事実だけ。M3 の判定は #41 で人が行う）、注記、末尾に時間の実測）。
  図は `docs/log/<実行日>-40/`（PNG、100 dpi）: 構成 J のセッションごと（`session_<名前>.png`）、イベントごとの小図（`events_NN.png`）、
  評価側の構成 J・R の 2 点と合格線の比較（`final.png`）。図は手順 5 の確率と mask から描き、採点し直さない。
- **出さないもの**: 波形、特徴量の値、個々の窓の確率。モデル・特徴量・確率はファイルに保存しない（書くのは印と PNG だけ）。
- 評価側の図は `visualize.draw(..., side="eval")`（`final_eval.py` からだけ。`visualize.py` の CLI には無い）。評価側の名前だけを受け付け
  （学習側の名前・`self` 以外は止まる）、出力先が既にあれば止まる。細かい表示の 10 秒の上限は学習側と同じ。
- 依存と再現の条件は `compare.py` と同じ（報告の実行の条件に `.venv` の全パッケージの版、CPU、torch のスレッド数を出す）。
- `fixed_eval.py`: 0034 の評価側の 7 本（`FINAL-EVAL`）が学習側に入る分割では、`train_eval.py --throat`・`compare.py`・`visualize.py` がデータを読む前に
  止まる（後日セッションを足しても評価側を学習・交差検証に戻さない）。印があるときは、`--throat` と `compare.py` の報告の冒頭に「評価側は採点済み」の 1 行が出る。
- `fixed_eval.py` の M4 の定数と検査（#46、docs/decisions/0037）: M4 は日付の境と名前の固定の一覧で分ける（締め `M4_TRAIN_CUTOFF` = 20261028、
  評価側の窓 `M4_EVAL_FROM`〜`M4_EVAL_TO` = 20261029〜20261101。0037 の追記（10/29）で同じ日数のまま前倒し）。M3 の 21 本（`M4_TRAIN_M3`。M3 の評価側だった 7 本を含む）は M4 では学習側。
  `assert_m4_train` は締めより後の日付・`M4_EXPECTED_EVAL` の名前・21 本の欠け・`M4_EXPECTED_TRAIN` との不一致で止まり、`assert_m4_eval` は
  `M4_EXPECTED_EVAL` が `None`（一覧の追記の前）・一覧との不一致・窓の外の日付・3 本未満で止まる。`m4_lines_match` は 0037 の `M4-` で始まる行と
  定数の一致を返し、印のパスは `M4_MARKER`（`docs/log/m4-final-49.txt`）。どれも名前だけを見てデータを開かない。呼ぶのは #45（学習の入口）と
  #49（評価側の入口）で、#46 の時点ではどこからも呼んでいない。M3 の一覧と `assert_fixed_eval_not_in` は変えていないので、学習用 `meal` を
  `data/raw/` に足すと M3 の経路（`train_eval.py --throat`・`compare.py`）は今までどおり止まる。テストは `test_fixed_eval.py`（合成の名前だけ）。
- `train_eval._git()` の作業ディレクトリはリポジトリ直下（`train_eval.GIT_ROOT`）。パスを指定した `git status` のため。

## M4 の誤検出を減らす候補の比較と構成の固定（`m4_compare.py`。#45）

手順は plan #45（学習側の数字を見る前に固定）。構成は docs/decisions/0038（ステップ 2 で書く）に、評価用 `meal`（11/1〜）の記録の前に固定する。
**M4 の学習側だけを読む。** 評価側（`M4_EVAL_FROM` 以降の名前）は開かない・採点しない（#49）。

```
python analysis/m4_compare.py data/raw --smoke                                        # ステップ 1: 予行（性能の数字を出さない）
python analysis/m4_compare.py data/raw --figures docs/log/2026-10-29-45               # ステップ 2: 本番（表・選んだ行・誤検出の中身・図）
python analysis/m4_compare.py data/raw --final-model analysis/models/m4-0038.npz      # ステップ 3: 最終モデル
```

- **順序**（コードで止める）: 予行は `fixed_eval.M4_EXPECTED_TRAIN` が `None` の間だけ（入っていれば止まる）。本番は `M4_EXPECTED_TRAIN` が入っていて
  0037 の `M4-` の行と一致し（`m4_lines_match`）、追跡しているファイルに未コミットの変更が無いときだけ（どれもデータを読む前に止まる）。最終モデルは
  さらに `fixed_eval.M4_CONFIG` が入っていて 0038 の `M4-CONFIG`・`M4-MODEL` の行と一致するときだけ（`m4_config_file_matches`）。出力先が既にあれば止まる。
- **学習側の一覧**（`list_train`）: `data/raw/` の直下を名前順に見る。名前の日付が `M4_TRAIN_CUTOFF`（20261028）より後のフォルダは `meta.json` を含めて
  何も開かず、名前だけを報告に出す（`M4_EVAL_FROM` 以降を含む）。残りには `split.split_sessions` と同じ検査（シンボリックリンク、名前の形、`meta.json`、
  subject の一致、`fw` と `throat.wav`・`detect.csv`・`feat.csv` の組、`pc-throat` の iface とファイルの有無）を同じ順で当て、`self` の `pc-throat` だけを採る
  （`p1`・`fw` が無い・`detector` は採らない）。最後に `fixed_eval.assert_m4_train`。M3 の `assert_fixed_eval_not_in` は呼ばない（0037 の 2）。
- **交差検証**: `train_eval.cv_groups`（学習側が 2 収集日以上なら収集日ごと）。正規化・陽性の重み・hard negative は fold の学習側だけで作る。
- **候補**: 分類器 C1（LR `a52`、0014）・C2（CNN 種 0、0033 §2）・C3（C2 ＋ hard negative）・C4（CNN 種 0・1・2 の確率の算術平均）・C5（C4 の各種を
  hard negative で学習）× 後処理 P0（なし、閾値 19 点）・P1（ヒステリシス 45 点）・P2（＋不応期 0.5 秒）・P3（＋塊の上限 1.5・2.0・2.5 秒、135 点）・
  P4（＋上限＋不応期、135 点）= 25 行。参考の行: R0（構成 J のまま、入り 0.95・出 0.85 に固定）、CNN 種 1・2 の単独、その hard negative の単独。
- **hard negative**: 学習の集合 S の中の交差検証（`cv_groups(S)`）で同じ種の C2 が出した確率に、固定の動作点 0.95 / 0.85 を当て、0011 の数え方で誤検出に
  なった塊のうち、陰性のラベルで `valid` な窓の損失に 3.0 を掛ける（条件別のセッションだけ。`meal` には付けない）。外側の fold k の hard negative は、
  k の学習側の中の交差検証だけで決める（入れ子。外側の検証側の窓・確率・マーカーを使わない）。内側の学習は「学習に使うセッションの集合」の鍵で使い回す。
  重み付きの学習は `compare.cnn_fit(..., sample_weight=…)`（省くと今の経路のまま。`compare.weighted_loss` は全部 1 なら今の損失と同じ）。
- **後処理**（`postprocess.py`、装置にも配る）: `PostStepper` は 1 窓ずつ進める状態機械（ヒステリシス → 不応期 → 塊の上限。因果的）。不応期は、新しい塊の
  最初の窓と直前の塊の最後の窓の開始時刻の差が 0.5 秒以下なら塊ごと抑える。塊の上限は、抑えていない塊の最初の窓から `cap_s ÷ 0.25` 窓までを陽性に
  し、それより後は陰性。`post_mask` は `PostStepper` を先頭から回すだけで、上限・不応期が無ければ `hysteresis` とビット一致する。`ensemble_mean` は
  種ごとの確率の算術平均。数え方・窓・非嚥下区間・ホップは変えない。
- **選び方**: 行の中では、誤検出率が 1.0 回/分以下の点のうち検出率が最大（同率なら 入り・出・上限 が高い・長いほう、P0 は閾値が高いほう。無ければ誤検出率が
  最小）。25 行の中では、同じ規則で、同率なら単純なほう（C1 < … < C5、次に P0 < … < P4）。比べるのは学習側の全セッションの合算（`meal` だけ・条件別だけの
  数字は並べるが選択に使わない）。検出率の合格線（85%）は選択に入れない。0014・0033 の 3.0 を 1.0 に読み替えたもの。
- **報告**（本番）: 標準出力に Markdown。実行の条件（コミット、依存の版、CPU、種、格子、hard negative の値）、学習側のセッション（cond、`s` の数、非嚥下の
  分数）、使わないセッション（名前だけ）、fold と正規化のセッション、fold ごとの hard negative の窓の数、25 行と参考の行の表（検出率・誤検出率・TP / FN / FP・
  陽性窓の割合・`meal` だけ・条件別だけ・合格線 85% / 1.0 を満たすか）、常時陽性の場合、選んだ行と 0038 の `M4-CONFIG` の行、誤検出の中身（R0 と選んだ行。
  主分類は排他: 嚥下の直後の延び・直前・動作に付くもの（t・c・n）・`meal` の会話あり・なし・その他。主分類の合計が誤検出の回数と一致しなければ止まる）、
  付録に行ごとの格子、末尾に時間の実測。
- **予行**（`--smoke`）: 学習側の一覧・使わない名前・fold の分け方・窓の数・`plan_trainings` の回数（予行の時点と、学習用 `meal` を 1〜3 収集日に分けた本番の
  見込み 3 通り）と、外側の最初の fold・種 0 の 3 回の学習（重みなし、その内側の最初の fold の重みなし、予行専用の重み付き）の時間・窓 1,000 あたりの時間・
  本番の見積もり・最大の常駐メモリだけを出す。検出率・誤検出率・陽性窓・hard negative の窓の数・確率・選んだ行は出さず、図も描かない。
- **図**（本番の `--figures`。`docs/log/` の下だけ）: `visualize.draw_m4`（`draw(..., side="m4train")`。M4 の学習側の一覧にある名前だけ）。25 行の比較
  （破線 85% / 1.0 回/分）、選んだ行のセッションごとの図（`meal` は 300 秒ごとの頁、条件別は誤検出か見逃しがあるものだけ）、イベントごとの小図（条件別だけ。
  **`meal` の細かい表示（20 ms の包絡・フレームごとのメル・波形）は描かない**。0037 の 4 と同じ理由）、誤検出の中身の棒。
- **最終モデル**（`--final-model`。`analysis/models/m4-0038.npz`）: 0038 の構成で学習側の全セッションから学習し（hard negative は全セッションの交差検証で決める）、
  `numpy.savez`（`allow_pickle` を使わない）で保存する。鍵: `config`（`M4-CONFIG` の値）・`format`（1）、CNN は種ごとに `s<種>/conv1.weight` など
  PyTorch の名前の重み（float32）と `s<種>/mean`・`s<種>/std`（float64、40）、LR は `std_mean`・`std_std`・`coef`（52、陽性の向き）・`intercept`。保存の直後に
  `load_model` で読み戻し、学習側の全窓で確率の差の最大 1e-6 以下・後処理の出力の完全な一致を確かめ、外れたらファイルを消して止まる。報告に
  `M4-MODEL: path=… sha256=…` の行を出す。`load_model`・`model_prob` などの推論の部分は #47 で `m4_infer.py` に移した（`m4_compare.py` は同じ名前を
  再輸出する。`m4_compare.py` の import は scikit-learn・librosa・torch の経路を含むので装置に配れない。下の「装置と PC で共有する M4 の推論」）。
- `fixed_eval.py` の `M4_CONFIG`・`M4_MODEL`（ステップ 1 では `None`）と `m4_config_lines_match`・`m4_config_file_matches`: 0038 の `M4-CONFIG:`・`M4-MODEL:` で
  始まる行と定数の一字一句の一致。
- ファイルは書かない（`--figures` の PNG と `--final-model` の重みを除く）。波形・特徴量の値・個々の窓の確率は出さない。計算の予算は本番 1 回が PC で 3 時間以内。

## 検出器の評価（`evaluate_detector.py`）

M2 の数字（#27）を出す。検出器ファームウェア（#24）で録ったセッションには `imu.csv`・`audio_chunks.csv` が無く、
`detect.csv`（`t_ms, window_t_ms, positive, prob, led`）・`feat.csv`・`events.csv`・`meta.json` がある（`docs/data-schema.md`）。
数え方は `evaluate.event_metrics` / `evaluate.aggregate` をそのまま使う。記録の範囲だけを検出器のセッション向けに読み替え、
docs/decisions/0021 に記録した。`positive` と `events.csv` の `s` だけを使い、`led` と `prob` は評価に使わない。
依存は標準ライブラリと、`train_eval` 経由の numpy / scikit-learn。

```
python analysis/evaluate_detector.py data/raw                        # 既定: self の meal で fw が detector のセッション全部
python analysis/evaluate_detector.py data/raw --sessions A B C        # 明示したセッションだけ（除外を報告に出す）
python analysis/evaluate_detector.py data/raw --scorer path/to/m2_scorer.py   # feat.csv の再採点と装置の出力の差（#22）
```

- **対象**: 既定は subject `self`・cond `meal`・`meta.json` の `fw` が `detector` のセッション全部。`meal` なのに `fw` が
  `detector` でないセッションがあれば止まる（消してから走らせる）。`--sessions` で明示したときはそれだけ（cond は問わず、
  `meal` 以外は「M2 の数字に使わない」と印を付ける）。root の検出器のセッション全部と採否を報告に出す。評価に使うセッションの
  `threshold`・`model`・`feature_names` が一致しなければ止まる（同じファームウェアで録ったものだけを合算する）。
- **記録の範囲**（docs/decisions/0021）: 始まりは `detect.csv` の最初の窓の開始。終わりは `detect.csv` の送信時刻、最後の窓の終端、
  `feat.csv`（あれば）の送信時刻の最大。両ファイルで `window_t_ms` は狭義に単調増加、`t_ms` は単調非減少、隣との差 1000 ms 以下、
  送信の遅れ `t_ms − (window_t_ms + 1000)` は 1000 ms 以下（`MAX_SEND_LAG_MS`）。`feat.csv` の窓は `detect.csv` の窓の部分集合。
  外れたセッションは止まる。範囲より前のマーカーは `event_metrics` がエラーにする。
- **合算**: 既定の実行は `evaluate.aggregate`（3 セッション未満は止まる）。`--sessions` で 3 セッション未満のときだけ、
  セッションごとの数字を出し、合算は「出さない」と明記する（#24 の 60 秒の確認用。M2 の数字ではない）。
- **参考値**: 常時陽性の場合の数字、陽性窓の割合、`positive != (prob >= threshold)` の行数（比較は float32）、`c` に紐づく
  誤検出の塊（塊の最初の窓の中心 − `t_c` が `[−1.0, +5.0]` 秒）、収集日ごと・会話の有無ごと（`o` の note が `conv`）の合算。
  `led` と、`positive`・`window_t_ms` から 0018 の規則で再計算した値（`led_rule.py`）の不一致の行数（不一致の行の `led` の値と
  セッションごとの内訳。#25）。装置の `led` は実際に表示していた状態なので、NINA の書き込みを飛ばした窓もここに現れる。評価の数字には使わず、止めない。
- **`--scorer PATH`**: `score(features: list[list[float]], meta: dict) -> list[float]` を持つ Python ファイルで `feat.csv` を
  再採点し、装置の `positive` との差（装置 1 / PC 0、装置 0 / PC 1、`|prob − prob_pc|` の最大）と PC の陽性で数えた数字を出す。
  閾値は `meta.json` の `threshold`（上書きの引数は無い）。scorer の実物は `m2_scorer.py`（下の「M2 の scorer と閾値」）。
- 報告は標準出力に Markdown。ファイルは書かない。個々の窓の確率と特徴量の値は出さない。未コミットの変更があってもコミットに
  `-dirty` を付けて止めない（#27 の M2 の数字はコミット済みの状態で走らせる）。

`split.py` は `fw` が `detector` のセッションを M1 の分割（`train` / `eval`）に入れず、戻り値の `detector` に列挙する。
`fw` が `unoq-detector`（M4 の装置のセッション。#47）も同じ扱い（`--kind throat` では `excluded`。`m4_compare.list_train` も同じ集合で見る）。
`fw` がどちらでもないのに `detect.csv` か `feat.csv` があるセッションは止まる。`evaluate_detector.py` は `fw` = `detector` だけを拾う（変えていない。M4 の採点の入口は #49）。

## 装置と PC で共有する M4 の推論（`m4_infer.py`。#47）

- `m4_compare.py` から移したもの: `CONFIG_KEYS`・`CNN_SHAPES`・`N_MEL`・`N_LR`・`MODEL_FORMAT`・`CNN_SET`・`LR_SET`・`HN_WEIGHT`・`parse_config`・`config_mask`・
  `_expected_keys`・`_check_arrays`・`load_model`・`model_prob`（`m4_compare` は同じ物を再輸出する）。依存は numpy・`features_np`・`postprocess`・`led_rule` と標準ライブラリだけ。
- `Detector(model, feat=False).step(seg16k, window_t_ms) -> (prob, positive, led, feat | None)`: 1 窓（16 kHz・16000 サンプル・`/ 32768` の後の float32）を
  `mfe40`（`feat=True` なら `features_np.mfe_and_feat` で FEAT の 82 次元も）→ `model_prob`（窓 1 つ）→ `postprocess.PostStepper`（0038 の enter 0.85・exit 0.65・不応期 0.5 秒、
  t = 0.25 k）→ `led_rule.LedStepper` の順に進める。`model_prob` を窓 1 つずつ呼んだ値とは同じ式（差 1e-12 以内）。まとめて呼んだ値（バッチ）とは float32 の行列の積の
  和の順が変わるので 1e-8 程度の差がある（einsum の版でも同じ。テストは 1e-6 で確かめる）。`positive`・`led` は `post_mask`・`led_states` と完全に一致。
- `sha256_file`、`code_sha256(paths)`: 拡張子が `.py`・`.npy`・`.npz` のファイルを名前の順に並べ、各行「`<名前> <sha256>`」をつないだ文字列の sha256。
  装置は配った先のディレクトリの中、PC（`tools/record.py --unoq-detector`）は `device/unoq/DEPLOY_FILES` の行で計算し、H 行の `code_sha256` と照らす。
- `features_np.mfe_and_feat(seg)`: `mfe40` と同じ値（ビット一致）と FEAT の 82 次元（`FEAT82_NAMES`。式は `docs/data-schema.md` の装置のセッション）。
- `features_np._conv3x3` は im2col ＋ 行列の積（docs/decisions/0040 決定 1）。旧実装（einsum）は `test_features_np.py` に写してあり、乱数の重み・`m4-0038.npz`・
  `features_np_ref.npz` で差 1e-6 以下（参照とは 1e-5 以下）を確かめる。
- PC の道具（`tools/`）: `unoq_replay_check.py`（学習用 `meal` の `throat.wav` を装置の再生モードに流し、PC の再計算と比べる。集計だけを出し、ファイルを書かない）、
  `unoq_session_check.py`（評価用 `meal` の採否の材料。`detect.csv`・`feat.csv` は時刻の列だけを読む）。

## M4 の評価側の採点（`m4_final_eval.py`。#49）

手順・記録の範囲・出す数字・切り分けの定義は `docs/decisions/0041-m4-final-eval-procedure.md`（評価側を開く前に固定し、コミットしてから実行する）。
対象は 0037 の `M4-EVAL` の 4 本（`fixed_eval.M4_EXPECTED_EVAL`。`evaluate_detector.scan_root` は使わない）、構成は 0038。評価側を **1 回だけ**採点する。
採点するのは装置の `detect.csv` の `positive`（0038 の後処理の出力）で、PC では採点し直さない。`evaluate_detector.py`（M2 の数字を出したコード）は変えず、
その関数（`DetectRow`・`SessionData`・`cough_linked`・`led_mismatch`・`_runs`）と `evaluate`・`train_eval.sum_metrics`・`m4_compare.classify_run`・`fp_runs` を使う。

```
python analysis/m4_final_eval.py data/raw     # 引数は root だけ
```

- **引数は root だけ。** 構成・閾値・後処理・対象・記録の範囲を選ぶ引数も、再実行の引数（`--reproduce` など）も無い。
- **印の前に止まる条件**（評価側のファイルを 1 つも開かない。印も作らない）: 追跡しているファイルに未コミットの変更がある、`analysis/`・`tools/`・`device/`・
  `docs/decisions/`・`docs/evaluation.md` に未コミットの変更か未追跡のファイルがある、git が使えない、0037・0038・0041 が無い・git に追跡されていない、
  0037 の `M4-` の行・0038 の `M4-CONFIG`・`M4-MODEL` の行・0041 の `M4-EVAL-PROC:` の行（定数 `PROC_LINE`）が一字一句一致しない、`M4_EXPECTED_EVAL` が `None`・
  `assert_m4_eval` に当たる、印 `docs/log/m4-final-49.txt` がある（リンクを含む）、依存を import できない、`analysis/models/m4-0038.npz` の sha256 が `M4-MODEL` と違う、
  4 本のフォルダが `root` 直下に無い・ディレクトリでない・シンボリックリンク（`lstat` だけで見る）。
- **印（1 回だけにする仕組み）**: 固定のパス `docs/log/m4-final-49.txt` を `O_EXCL` で排他作成し、書き込み・fsync・close（親のディレクトリも fsync）の後に評価側を開く。
  中身は開始時刻・HEAD のコミット・決定（0037 0038 0041）・コマンド・4 本の名前だけ（数字は書かない）。印は、その後の手順で止まっても消さない。
- **印の後・数字の前に止まる条件**（印は残る。標準出力は実行の条件だけ、標準エラーに `未完了:` の行、終了コード 1）: `meta.json` の照合（`fw` `unoq-detector`・
  `m4_config`・`model.sha256`・`feature_set`・`feature_names`・`rpc` false・`window_ms`・`hop_ms`・`unoq_detector.header.code_sha256` が手元の `DEPLOY_FILES` の値と一致）、
  `events.csv` の `o start`（ちょうど 1 つ、最初の窓より前でない、終わりより前、その前に `s`・`t`・`c` が無い）、終わりの 1.5 秒以内の `s`、`detect.csv`・`feat.csv` の
  形と時刻（0021）、`feat.csv` の窓が `detect.csv` の部分集合、窓の隣との差が 250 ms、`PostStepper` と `post_mask` の一致、誤検出の主分類の合計の一致。
  実行の条件・報告の書き出しと flush の失敗（容量不足・パイプの切断）も同じ扱い（印は残る。`未完了:` に段の名前と例外の型の名前だけ、終了コード 1）。
  標準出力が閉じていても、失敗した出力先の記述子を `/dev/null` に差し替えるので、終了時の再 flush のメッセージ（「Exception ignored」・終了コード 120）は出ない。
- **記録の範囲**: 始まり = `o start`、採点に入れる窓 = 開始が `o start` 以上（0041。0021 の始まりの読み替え）、終わり = 0021 のまま。装置と PC の一致だけは全窓で見る。
- **出すもの**（標準出力に Markdown。最後に `完了:` の行）: セッションごとの表、合算・混同行列・評価に使ったセッション一覧、合格線（0.85 / 1.0 回/分）との比較
  （満たす / 満たさない）、参考値（常時陽性・陽性窓の割合・収集日ごと・会話の有無ごと）、装置と PC の一致（`positive`・丸めの候補の窓・`led`）、切り分け
  （`classify_run` の主分類・`cough_linked`・見逃しの ±3.0 秒・塊の長さ）、M2・M3 と並べる表、注記。
- **出さないもの**: 波形、FEAT の値と集計、個々の窓の `prob`、行の中身、例外のメッセージとトレースバック（印の後の想定外の例外は型の名前だけ）。
  `feat.csv` は各行の先頭 2 列（`t_ms`・`window_t_ms`）のほかを保持も変換もしない。ファイルに書くのは印だけ。
- 依存は `.venv`（`m4_compare` を import するので scikit-learn を含む。torch は要らない）。
- テスト（`test_m4_final_eval.py`、plan #49 の E1〜E10）は合成のリポジトリ（0037・0038・0041 の文、重みの代わりのファイル、`DEPLOY_FILES`）と合成の 4 本の
  セッションを一時フォルダに作り、`fixed_eval.REPO_ROOT`・`fixed_eval.M4_MODEL`・`train_eval._git` を差し替える。印の前に `root` の中を開かないこと
  （`open`・`io.open` を見張る）、診断に値・行の中身が出ないこと、装置と PC の一致（9 桁の有効数字の `prob` から）を確かめる。`data/` は使わない。
  実物から読むのは docs/decisions の 0027・0036・0037・0038・0041 の本文だけ。

## M2 の scorer と閾値（`m2_norm_header.py`・`m2_scorer.py`・`m2_threshold.py`・`ei_testing_result.py`）

Issue #22。Edge Impulse から書き出した C++ ライブラリ（`firmware/detector/src/`。zip の中身をそのまま置き、編集しない）を PC 上で動かし、
検証側（収集日4）をイベント単位に採点して閾値を凍結する。前提は docs/decisions/0019（正規化の定数と閾値を `firmware/detector/` に置く、
閾値は収集日4 だけで 0014 の形で決めて凍結）・0020（式 `m2-0020`）・0021（`score(features, meta)`、閾値は float32 で比べる）。
**ここで出す数字は装置上の推論の前の参考値で、M2 の合格線の数字は #27 で出す。**

### 正規化の定数のヘッダ（`m2_norm_header.py`）

```
python analysis/m2_norm_header.py            # analysis/m2_norm.json → firmware/detector/m2_norm.h
python analysis/m2_norm_header.py --check    # 一致するかだけを返す
```

- `M2_FEATURE_SET`（`"m2-0020"`）、`M2_N_FEATURES`（29）、`M2_FEATURE_NAMES`、`M2_NORM_MEAN` / `M2_NORM_STD`（double、`%.17g`。JSON の float64 が
  そのまま往復する桁数）、`m2_normalize(const float* x, float* z)`（double で `(x − mean) / std` を計算してから float32 に落とす。
  `features.Standardizer.transform` と同じ順序なので、同じ `x` に対して PC の実行ファイル・装置・EI に投入した値が同じ float32 になる）。
  `<stdint.h>` 以外を include しない（docs/decisions/0001）。
- 書いた後に読み戻し、定数が JSON とビット一致することを確かめる。`std` に 0 か有限でない値があれば止まる。出力が既にあって内容が違えば止まる
  （黙って上書きしない。作り直すときは人が消す）。コメントに書くのは `stats_sessions` の本数・`n_windows`・`commit` だけ（`self` の集計値なので公開してよい）。

### PC 上の実行ファイル（`firmware/detector/host/score_windows.cpp`、`build.sh`）

```
bash firmware/detector/host/build.sh         # → build-host/score_windows（firmware/detector/src/ に書き出しが要る。無ければ止まる）
```

- 標準入力の 1 行 1 窓（正規化前の 29 個、`FEATURE_NAMES` の順、空白区切り）を `m2_normalize` → `run_classifier` に掛け、見出し行
  （`model <project_id> <deploy_version>`、`feature_set`、`n_features`、`labels`、`input_datatype`、`quantized`、`selfcheck`）の後に
  1 行 1 窓で `LABEL_COUNT` 個の確率（`%.9g`、`labels` の順）を出す。`static_assert` で書き出しの define（29 次元、3 クラス、EI 側の正規化なし）を、
  起動時に Raw data ブロックが 1 つで `scale_axes == 1` であることを確かめる。「特徴量の後の装置の経路」の PC 版で、#24 の装置も同じ `m2_norm.h` と
  `run_classifier` を使う。
- `build.sh` は g++ で EI の `example-standalone-inferencing` の Makefile と同じソースの集合（`tflite-model/`、`dsp/kissfft`、`dsp/dct`、
  `porting/posix`、`tensorflow/lite/...`）をコンパイルする。CMSIS は x86 では使わないので入れない。CMake のターゲットは足さない。

### scorer（`m2_scorer.py`）

```python
import m2_scorer

s = (
    m2_scorer.Scorer()
)  # 既定 build-host/score_windows。環境変数 M2_SCORE_BIN で差し替え（テスト用）
s.model, s.labels, s.n_features, s.swallow_index
P = s.score_rows(
    rows
)  # (n, LABEL_COUNT)。1 回の起動で全行を流す。行数が合わなければ止まる
m2_scorer.score(
    features, meta
)  # evaluate_detector.py --scorer の形。swallow の列を返す
```

- `Scorer` は起動時に見出しの `selfcheck`（実行ファイルが `SELFCHECK_INPUT` の 29 個を `m2_normalize` した値）を、`m2_norm.json` から作った
  `Standardizer.transform` の同じ入力の結果とビット一致で比べ、違えば止まる（ヘッダと JSON の食い違い、演算の順序の違いをここで捕まえる）。
- `score(features, meta)` は `meta["feature_set"]`（`m2-0020`）、`feature_names`、次元、`meta["model"]`（あれば `project_id` と
  `deploy_version` が実行ファイルの見出しと一致すること。装置と違うライブラリで再採点しない）を検査する。閾値との比較は `evaluate_detector.py` が行う。
- scorer は正規化しない（実行ファイルの中で `m2_norm.h` が行う）。特徴量・確率をファイルに書かず、標準出力に値を出さない。

### 検証側の採点と閾値の凍結（`m2_threshold.py`）

```
python analysis/m2_threshold.py data/raw              # 表と参考値（ファイルは書かない）
python analysis/m2_threshold.py data/raw --freeze     # 加えて firmware/detector/m2_threshold.h を書く（未コミットの変更があれば止まる）
```

1. `ei_upload.check_split` で `train` = 収集日1〜3 各 7 本、`eval` = 収集日4 の 7 本を検査する。対象は `eval` だけ。収集日1〜3 は `meta.json` 以外を開かない。
2. `m2_norm.json` の `stats_sessions` に収集日4 が無いこと、`m2_norm.h` が `m2_norm.json` と一致すること（`m2_norm_header.differences`）を検査する。
3. 7 本それぞれを `features_m2.extract_session` → 実行ファイルに流し、`swallow` の確率を得る。`valid = False` の窓は陽性にしない。
4. 候補 0.05, 0.10, …, 0.95（`train_eval.THRESHOLDS`）ごとに `evaluate.event_metrics` → `train_eval.sum_metrics` で合算し、表にする。
5. 規則（`pick_threshold(table, 1.0)`）: 誤検出率が 1.0 回/分以下の候補のうち検出率が最大（同率なら高いほう）。無ければ誤検出率が最小（同率なら高いほう）。
   3.0 のときは `train_eval.pick_threshold` と同じ結果になる（テストで固定）。候補と規則は引数で変えられない。
6. 採用した閾値で、セッションごとの表、`evaluate.aggregate`（辞書のキーが `eval` の一覧と一致することを確かめる）の検出率・誤検出率・混同行列（TP / FN / FP）、
   合格線（85% / 1 回/分）との比較（参考）、参考値（常時陽性、陽性窓の割合、`c` に紐づく誤検出の塊、無効な窓）、窓単位（投入した窓の argmax × ラベルの 3 × 3 と accuracy。
   EI の Model testing との突き合わせ用）を Markdown で出す。波形・特徴量の値・個々の窓の確率は出さない。
7. `--freeze` は `train_eval.git_dirty()` なら止まる。`m2_threshold.h` は `static const float M2_THRESHOLD = 0.85f;` の形（値は候補の短い表記。
   コメントに float32 の 9 桁 `%.9g` と「META の `threshold` にはこの 9 桁の値を書く」）と `M2_THRESHOLD_FP_PER_MIN_LIMIT 1.0`、決めた日・コミット・
   EI の deploy version。既にあって内容が違えば止まる。順序は「書き出し・ヘッダ・スクリプト・テストをコミット → `--freeze` → `m2_threshold.h` をコミット」。
   以降、#27 の記録が終わるまで閾値もモデルも変えない。

### EI の Model testing との突き合わせ（`ei_testing_result.py`）

```
EI_API_KEY=... python analysis/ei_testing_result.py data/raw --project-id <ID>
```

- `GET https://studio.edgeimpulse.com/v1/api/<projectId>/classify/page?variant=int8&limit=..&offset=..` をページ分割で全件取り、
  `variant=float32` も参考に取る。**応答はメモリ上で突き合わせ、ファイルにも scratchpad にも書かない。** 標準出力に出すのは集計値だけ。
- PC 側は `m2_threshold.py` と同じ経路で収集日4 の投入した窓（`valid` かつ境目でない窓）を採点し、`(session, t_ms)` で対応づける。EI の項目数が投入数と
  一致しなければ止まる。`--project-id` は実行ファイルの見出しと一致しなければ止まる（値は出さない）。閾値は `firmware/detector/m2_threshold.h` から読む。
- 出す数字: 窓の数、int8 同士の `max |Δp|`（クラスごと）、`|Δp| > 0` / `> 1/256` の窓の数、argmax が違う窓の数、凍結した閾値で `swallow` の陽性・陰性が違う窓の数、
  3 × 3 の混同行列の一致、参考として float32（EI）と int8（PC）の `max |Δp|`。「一致」は argmax の不一致 0・閾値での不一致 0・`max |Δp| = 0` のときだけ（決定 F1）。
- 応答の項目名（`result[].sample.name / metadata / label`、`classifications[0].result[0]` のクラス名 → 確率）は EI の API 文書の要約から置いた仮定で、
  実際の応答で確かめて `parse_item` を直す（コードに注がある）。送受信は `run(argv, fetch=...)` で差し替えられ、テストは偽の応答で動く。
- API キーは環境変数 `EI_API_KEY`、プロジェクト ID は引数。どちらも標準出力・例外に出さない。

## テスト

`evaluate.py` と `split.py` の数え方、`features.py` の窓と特徴量、`train_eval.py` の手順、`evaluate_detector.py` の記録の範囲と
対象の選び方は、合成データのテスト
（`test_evaluate.py`・`test_split.py`・`test_features.py`・`test_train_eval.py`・`test_evaluate_detector.py`・`test_features_m2.py`・`test_ei_upload.py`・
`test_m2_norm_header.py`・`test_m2_scorer.py`・`test_m2_threshold.py`・`test_m2_ei_testing_result.py`・`test_led_rule.py`）で固定している。
`test_led_rule.py` の入力の表は `firmware/detector/host/test_detector.cpp` の `test_led_rule` と同じ（値を両方に書いてある）。
`test_features.py`・`test_features_m2.py`・`test_ei_upload.py`・`test_m2_*.py` は numpy、`test_train_eval.py` は numpy と scikit-learn を使う。
咽喉マイクの経路のテスト（`test_features.py`・`test_evaluate.py`・`test_train_eval.py` の Throat の付くクラス）は、48 kHz・2 ch の
合成の `throat.wav` を一時フォルダに作り、scipy と `tools/throat_check.py` を使う。
#44 のテスト（`test_features_np.py`）は librosa・scipy を使い、`features_np.py` のメル行列・タップ・間引き・`mfe40`・`a52`・デルタを librosa・scipy の式と
比べ、合成の咽喉マイクのセッションを旧の参照経路（`resample_poly` と librosa・scipy の式。変更前の式を写したもの）と今の経路の両方に通して比べる。
`features_np_ref.npz` が古くなっていないこと、`features_np.py` が numpy と標準ライブラリ以外を import せず書き込みと `print` が無いことも確かめる。
#51 のテスト（`test_runtime_models.py`）は onnxruntime・ai-edge-litert・ncnn（`requirements-runtimes.txt`）を使い、torch は使わない。4 つのモデルの CPU（fp32）の出力に
sigmoid を掛けた値が `cnn_forward`（同じ乱数の重み）と 1e-5 以内であること（合成の入力 6 つ）、演算子が標準のものだけであること、ONNX の opset 17・`ir_version` 10 以下、
合計 200 KB 以下を確かめる。ランタイムが入っていない形式は飛ばす（このリポジトリの確かめでは飛ばし 0 件を見る）。
#43 のテスト（`test_features_v2.py`・`test_postprocess.py`・`test_throat_compare.py`・`test_visualize.py`）と #40 のテスト（`test_final_eval.py`）は
librosa・matplotlib・torch を使い、
`test_throat_compare.py`・`test_visualize.py` は合成の咽喉マイクのセッション 6 本で交差検証（CNN を含む）を回すので 1 分ほど掛かる。
#45 のテスト（`test_m4_compare.py`、`test_postprocess.py`・`test_visualize.py`・`test_fixed_eval.py` に足した分）は、合成の `data/raw`（`meta.json` と空のファイル）と
合成の SessionData で、CNN の学習を偽の関数に差し替えて回す（`compare.cnn_fit` の `sample_weight` と `weighted_loss` だけは本物の torch）。図の頁分けは
合成の咽喉マイクのセッション（320 秒の `meal` を含む）で確かめる。
`compare.py` のテストの名前が `test_compare.py` でないのは、`test_ei_upload.py` より前に並ぶテストのモジュールがあると、unittest が
モジュールの終わりに登録済みの片付けを全部実行し、`test_ei_upload.py` が import の時点で作った一時フォルダが先に消えるため。
図は一時フォルダに書く（`visualize.LOG_ROOT` を差し替える）。`test_final_eval.py` は印・図・合成の 0034 を一時フォルダに置き
（`final_eval.REPO_ROOT` も差し替える）、git の検査は `train_eval._git` を差し替えるか、一時フォルダの git リポジトリで確かめる
（このリポジトリの git と `docs/log/` は使わない。git が要る）。
ほかは標準ライブラリの `unittest` だけで動く。
合成データは一時フォルダに作り、`data/` は使わない。`test_train_eval.py` は 60 秒の合成セッションを 9 つ作って
学習を繰り返すので、20 秒ほど掛かる。#22 のテストは実行ファイルを一時フォルダの Python スクリプトで、EI の送受信を偽の応答で差し替え、
ネットワークに出ず g++ も要らない。

```
python -m unittest discover -s analysis -v
```

`docs/evaluation.md` が決めていない点（窓が区間に「ある」の判定、連続する陽性の数え方、記録の範囲、
複数セッションの集計、混同行列）の解釈は `docs/decisions/0011-evaluation-interpretation.md` にある。
