owhinata/zaitaku-mealpace/docs/status.md

# 現在地

更新: 2026-11-13

## 段階

M4 検出器（咽喉マイク版）の関門（#50）は 11/1 に**通過しない**と人が判定した（docs/decisions/0042。検出率 0.957 は合格線を満たす、誤検出率 1.25 回/分は満たさない。`review-M4` = `5601b59`。人がタグを打ち、#50 と Milestone M4 を close した（11/1）。次の関門のレビューの base は `review-M4`）。**時間がないので M5（公開、11/8〜11/17、11/10 に下書き公開）へ進む**（人の決定 11/1）。M5 の前に行うこと: MCU の自律消灯（0035 を改める decision、関門レビューの指摘 2）→ 済み（#52、0049）、UNO Q の自動起動 → 済み（#53、0050）、1 ホップ 0.1 秒と `p1` の記録先を M5 の前に決めるか（0042。1 ホップは 0.25 秒のまま（#54、0047）、`p1` は `self` と同じ扱い（#55、0048））。M5 の後の改善候補: マイクへの接触・叩きの音を hard negative として学習で弾く（人の観察 11/1、0042）。
M5 公開の Issue は 11/1 夜に起票した（#52〜#59。草案は人がレビューし、人の決定で直してから起票。控えは `~/work/zaitaku-mealpace-scratch/m5issues/`）。**M5 は 11/2 から前倒し**（人の決定 11/1。11/10 に一般公開（開発中）、11/17 まで更新。plan.md と Milestone の説明は 11/1 にメインが直した。Milestone の期限は 11/17 のまま）。
M3 咽喉マイクの試用は 10/13 に**通過**と人が判定した（docs/decisions/0036。`gate-M3` = `595650f`。人の指示でメインがタグを打った。#41 は人が close（10/13 夜））。M4 検出器（咽喉マイク版）の Issue は 10/14 未明に起票した（#44〜#50。草案は人がレビューし、起票後に削除。控えは `~/work/zaitaku-mealpace-scratch/m4issues/`）。人の決定: M4 は 10/14 から前倒し（11/7 まで。plan.md と Milestone の説明は 11/1 にメインが直した。Milestone の期限は 11/17 のまま）。M2 検出器の関門（#28）は 10/4 に**通過しない**と判定した（docs/decisions/0027。検出率 0.150、誤検出率 2.03 回/分。`review-M2` タグは人）。0024 のとおり咽喉マイクへ進む:
咽喉マイク SH-12JK は発注済み、基板は手元の UNO Q、IMU なしで始める（docs/decisions/0025・0026）。本人試用は応募期間の外（0024）。M1 ロギング・分岐点の関門は 9/24 に通過（docs/decisions/0017、`gate-M1` = `b70a0cb`）。
M0 準備の関門は 9/20 に通過（docs/decisions/0010、`gate-M0`）。

## 直近の状態

- リポジトリ初期化。文書・骨格・記録スクリプトを配置。
- GitHub に Milestone M0〜M6 とラベル3つを作成。
- M0 の Issue（#1〜#6）と M1 の Issue（#7〜#15）を起票。
- Codex のレビュールールと plan レビューのゲートを配置（docs/workflow.md、docs/decisions/0004）。
  承認は plan ファイルのハッシュと Codex 出力の PLAN-SHA 行に結びつく。hook は判定できないとき block する。
  hook は単体で動作確認済み（承認→通過、plan を1文字変えると block）。
- #1: 開発環境を導入し、`firmware/logger` のビルドが無修正で通った（arduino:mbed_nano 4.6.0、docs/log/2026-09-19.md）。
  Python 依存は `.venv` に入れ、`-DPYTHON3=` で渡す。
- #2: 実機への書き込みと10秒の記録が通った。META 1 / IMU 1045 / AUDIO 2475 フレーム、XOR 不一致 0、
  実効 105.5 Hz / 16006.5 Hz（docs/log/2026-09-19.md）。`record` ターゲットの引数の不具合を直し、
  `tools/record.py` に `--duration` とフレーム数の表示を足した。`docs/data-schema.md` の記載漏れ2点は
  docs/decisions/0006 に記録。音声チャンクの `t_ms` の食い違いは #15 に切り出した。
- Codex を実際に呼ぶ plan レビューを #2 で初めて通した（3回、計約41分、CONCERN 10件、BLOCKING 0）。
- #3: 生の音声波形の線引きを docs/decisions/0005 に記録し、AGENTS.md・docs/workflow.md・codex-review skill を直した。
  CLAUDE.md の該当行も差し替え済み。
- #4: Edge Impulse のプロジェクト `zaitaku-mealpace` を作成（Private、One label per data item、
  Target は Raspberry Pi RP2040 / RAM 264 KB / ROM 16 MB、docs/log/2026-09-20.md）。データは未投入。
- #6: 関門のレビュー（Codex、base は初期コミット）を1回回した。公開情報の線引きへの指摘はなし。
  指摘は1件: `tools/record.py` の `--out` と `.gitignore` の `!data/sample/**` により、p1 の生データを
  コミットできる場所へ記録できる。対応として `--out` を廃止し、出力先を `data/raw/` に固定した
  （docs/decisions/0007）。リポジトリ外の cwd から3秒の記録で確認済み。`git add -f` と手での移動は塞いでいない。
  再レビュー1回目の指摘（`cond` に `../` を入れると `data/raw/` の外に記録できる）には、`cond` を英数字と
  ハイフンに限り、`Session` が出力先の直下にしか作らない形で対応した。
  再レビュー2回目（最後）の指摘は1件: `data/raw` をシンボリックリンクに差し替えると直下の検査を抜ける。
  今の `data/raw` は実ディレクトリで、違反は起きていない。人の判断で CONCERN とし、運用で注意する
  （docs/decisions/0007「塞がっていない経路」）。関門のレビューに BLOCKING は残っていない。
- #6: plan の再レビューは前回の Codex スレッドを resume する（docs/decisions/0008）。初回と関門は fresh。
  再レビューの回数の上限はなくした。止める条件は BLOCKING の有無と人の採否（docs/decisions/0009）。
- #7: 喉元に装着して60秒記録した（`self` / `quiet`）。IMU 6321 / AUDIO 14976 フレーム、XOR 不一致 0、
  `t_ms` の飛びは IMU・音声とも 0 箇所（取りこぼしの推定 0.000%）、実効 105.51 Hz / 15999.7 Hz
  （docs/log/2026-09-20.md）。ファームウェアは直していない。数えるために `tools/check_session.py` を足した
  （`imu.csv` と `audio_chunks.csv` の `t_ms` の飛びから取りこぼしを推定する。以降の記録でも使う）。
- #8: `self` の記録手順を `docs/recording-protocol.md` に固定した。1セッション 180 秒、1収集日 = 7セッション
  （`water` ×2、`saliva`、`talk`、`cough`、`neck`、`quiet`）。評価に回すのは最後の2収集日のセッション全部で、
  日数は先に固定しない。非嚥下の「50回」は `t`+`c`+`n` の合計50以上・各10以上・`quiet` 合計5分以上。
  手順を決める前のセッション（#2・#6・#7 の確認用）は M1 の学習・評価に使わない。
  plan レビューは1回（BLOCKING 0、CONCERN 4、採否は #8 のコメント）。
- #10: `analysis/evaluate.py` と `analysis/split.py` に、`docs/evaluation.md` との食い違いが9件あった
  （同じ陽性窓を検出と誤検出の両方に数える、重なった嚥下の区間を二重に引く、記録の端を切り詰めない、
  区間をまたぐ連続を2回と数える、`--eval-min 0` で全セッションが評価側になる、など）。実装のほうを直し、
  合成データのテスト 42 件で数え方を固定した（`python -m unittest discover -s analysis -v`）。
  定義が決めていない点の解釈（窓の中心で判定、連続は塊で1回、記録の範囲、回数の合算、イベント単位の混同行列）は
  docs/decisions/0011。`docs/evaluation.md` は変えていない。plan レビューは2回（初回 BLOCKING 2、再レビューで3面 LGTM）。
  コミット前の adversarial-review の指摘3件のうち、外れた `t_ms` による記録の長さの水増しと、シンボリックリンクの
  セッションは直した。`aggregate` が呼び出し側を信用する点は CONCERN とし、#13 で経路を1本にする。
  既知の弱点: 常に陽性を出す分類器でも M1 の合格線を通りうる。定義は動かさず、#13 の報告に常時陽性の場合の数字と
  陽性窓の割合を並べ、#14 で人が見る。
- #11: `analysis/features.py` を足した。窓（1.0 秒 / 0.25 秒）ごとに 29 次元（IMU 14: 振幅 4・RMS 6・ピーク数 1・
  主軸方向 3、音 15: MFCC 13・スペクトル重心 1・ゼロ交差率 1）。`docs/evaluation.md` は特徴量の名前だけを決めていて
  式が無いので、実データを見る前に式を docs/decisions/0012 に固定した。#13 の結果を見てから式を動かさない。
  IMU のキャリブレーションは前提にせず、加速度とジャイロの両方で窓内の平均を引く。依存は numpy だけ。特徴量は
  ファイルに保存しない。正規化（`Standardizer`）は渡されたセッションだけから統計量を作る。取りこぼしに掛かる窓は
  落とさず `valid = False` で返す（評価での扱いは #13 で決める）。合成セッションのテスト 34 件（全体で 76 件）が通る。
  60 秒のセッションで約 0.16 秒。plan レビューは3回（BLOCKING 0、CONCERN 7 → 3 → 0）。
  この定義は M1 の PC 側の評価用で、M2 の装置上の実装は保証しない。
- #9: `data/sample/20260920-000000_self_quiet/` に `self` / `quiet` の見本を置いた。音声 10.000 秒（2500 チャンク）と同じ時刻の
  範囲の IMU 1055 行。`sample_index` は 0 始まりに振り直し、`t_ms` は元のまま。`tools/check_session.py` は飛び 0、
  `analysis/features.py` は 36 窓 × 29 次元（#11 の見本での確認）。最初の見本はテレビの音が入っていたので捨て、
  録り直してから人が音声を聞いて確かめた。コミット前の adversarial-review は2回（1回目の指摘2件は CONCERN として
  `data/README.md` に明記、2回目は approve）。見本の `meta.json` には装置の申告値（`fw` など）が無い。基板をリセットせずに
  記録を始めると META フレームが届かないためで、#12 の記録でも起こりうる（扱いは docs/decisions/0006）。
- #15: 音声チャンクの `t_ms` の意味を、文書を実装に合わせる形でそろえた（docs/decisions/0013）。`t_ms` は装置が
  チャンクを読み出した直後の `millis()` で、論理上は終端側の時刻。先頭サンプルの時刻は `t_ms − 1000 × サンプル数 ÷ audio_hz` ms。
  ファームウェアと記録済みのデータは変えていない（読み方だけが変わる）。`analysis/features.py` の換算と音声の飛びの判定を直し、
  テストは 81 件。叩きの実測（50 対）は、どちらの読み方でも ±10 ms 程度（中央値 −3.9 / −7.9 ms）で、4 ms を切り分ける
  分解能は無い。送信中のバッファの上書きの競合は塞がっていない点として 0013 に記録した。plan レビューは3回
  （BLOCKING 0、CONCERN 5 → 1 → 0）。
- #13（スクリプトまで）: 実データを見る前に、学習と評価のやり方を `analysis/train_eval.py` とテストで固定した
  （docs/decisions/0014）。学習のラベルは窓の中心が `[t, t + 1.0]` なら陽性・境目は使わない、モデルは
  `LogisticRegression(C=1.0, class_weight="balanced")` で探索なし、閾値は学習側の交差検証（収集日ごと）で誤検出 3.0 回/分以下の
  うち検出率が最大、正規化は学習側の `valid` な窓の全部。既定の実行は学習側だけで、`--final` のときだけ評価側を採点する。
  報告には、学習と評価のセッションの一覧、混同行列、常時陽性の場合の数字、陽性窓の割合を出す。`scikit-learn` を足した。
  テストは全体で 120 件。plan レビューは2回（BLOCKING 0、CONCERN 4 → 0）。コミット前の adversarial-review の指摘2件のうち、
  未コミットの変更の検出（`-dirty` の表示、`--final` は止まる）は直し、セッションの中のファイルのリンクやコピーは CONCERN として
  0014 に記録した。**実データでの実行はまだ**（#12 のデータがそろってから、0014 の手順で行う）。
- #16: `tools/record.py` が終わった後、端末に打った文字が表示されなくなるのを直した（docs/log/2026-09-20.md）。
  原因は、マーカー入力の daemon スレッドが `tty.setcbreak()` を戻す `finally` を、プロセス終了時に実行しないこと。
  端末の設定の保存と復元をメイン（`atexit` と `finally`）に移し、入力スレッドは `select` + `os.read` で
  終了の印を見て自分で止まる形にした。`o` の note は元の設定に戻してから読む（打っている文字が見える。打ち終える前に
  終了したら、その `o` は記録しない）。SIGTERM も後始末を通すようにし、`Session.mark()` は `close()` の後は書かない。
  記録の形式・マーカーの時刻の取り方・引数・出力先は変えていない。pty の上で子プロセスを動かすテスト 13 件を足した
  （`tools/test_record_tty.py`。修正前のコードでは 12 件が落ちる）。実機での確認（10 秒の記録。終了後の入力、マーカー、
  `o` の note の表示）は人が行い、問題は無かった。
- 進め方: plan の素案づくりと Codex の plan レビューの実施も subagent に移した（docs/decisions/0016、docs/workflow.md
  「メインと subagent」、codex-review skill）。メインが plan mode にいるのは、確定した plan を承認する間だけ。
  `plan-approve.sh` はメインだけが実行する（plan を書いた本人が承認しない）。ゲートの hook と
  「Issue の着手は plan mode から」は変えていない。
- #12（着手）: 人が試しに1セッション（180 秒）を録った。記録は取りこぼし 0.000%（IMU・音声とも飛び 0）、マーカーの
  キーは全部記録された。試しの1本は1セッションに全部の条件を入れていたので、本番には使わず消す。手順の読み違い
  （1セッションで全部の条件を行う）が元だったので、`docs/recording-protocol.md` の冒頭に早見表（7本のコマンド、
  打つマーカー、回数の目安）を足し、「1セッションで行う条件は1つだけ」を明記した。1セッション 180 秒、回数、基準は
  変えていない（300 秒にする案は、読み違いが分かったので取り下げた）。
- #12（収集日1）: 7セッションを録り、人が収集日1として採用した（docs/log/2026-09-21.md に集計表）。`s` 32、`t`+`c`+`n` 45
  （20 / 10 / 15）、`quiet` 3 分。取りこぼしは全部基準内。採用を決めた後で、解析の経路と信号を集計値で確かめた
  （`features.py` は7本とも通る。`s` の 32 回すべてでマーカーの位置に IMU と音の信号がある。首の動き・咳・発話は
  嚥下より大きく出るので、大きさだけでは区別できない。区別できるかは未確認）。`train_eval.py` は収集日が3日そろうまで
  設計どおり止まる。人の決定で、収集日1の7本だけの交差検証（セッションごとの fold、既存の `cross_validate` をそのまま呼ぶ使い捨て）を
  1回だけ走らせた: 閾値 0.95 で検出 22/32、誤検出 60 回 / 19.94 分 = 3.01 回/分（混同行列とセッション一覧は log）。
  同じ日・同じ装着の中の数字で楽観側に出るので、合格線との比較にも #13 の報告にも使わない。誤検出の 65% は `neck` と
  `cough` のセッション。式（0012）と手順（0014）は動かしていない。「各50回以上」にはまだ届いていない。
- #12（収集日2）: 7セッションを録った（docs/log/2026-09-22.md に集計表）。`s` 43、`t`+`c`+`n` 62（22 / 17 / 23）、
  `quiet` 3 分。取りこぼしは全部基準内（IMU 0、音声は最大 0.004%）、`t_ms` の逆行 0、`o` 0。`water` の `s` の間隔
  10 秒未満が4箇所（区間の重なりは無し）、`cough` の中に `s` 2回、2本目の `water` の最後の `s` が記録の端の 0.6 秒前。
  **採否は未決（人が決める）。** 特徴量と分類器は走らせていない。採用すれば収集日1+2で `s` 75、`t`+`c`+`n` 107、
  `quiet` 6 分となり「各50回以上」は満たすが、評価には収集日3が要る（評価側は最後の2収集日）。→ 9/24 に採用。
- #12（収集日3）: 7セッションを録った（docs/log/2026-09-23.md に集計表）。`s` 35、`t`+`c`+`n` 52（22 / 11 / 19）、
  `quiet` 3 分。取りこぼしは全部基準内（IMU 最大 0.005%、音声は最大 0.004%）、`t_ms` の逆行 0、`o` 0。`water` の `s` の
  間隔 10 秒未満は 0、`talk` の中に `s` 1回。2本目の `water` の後に記録ファームウェアがフレームを送らなくなり（USB の列挙は
  残る、約 22 分動いた後）、人が挿し直して回復した。1回きりとして Issue は立てず、収集日4で様子を見る。止まっていた間の
  `20260923-223501_self_cough` は空（0 行、マーカー `c` 2つが `t_ms` 0）で、`cough` は `223530` を使う。
  **収集日2・3の採否と空の `223501` の扱いは未決（人が決める）。** 特徴量と分類器は走らせていない。収集日2・3を採用すれば
  収集日1+2+3で `s` 110、`t`+`c`+`n` 159、`quiet` 9 分となり、分割の決まりの上では評価を始められる（評価側は収集日2+3）。
  人は 9/24 を最終の収集日にする予定で、その場合は評価側が収集日3+4になるので、#13 は収集日4の採否の後に回す。→ 9/24 に採用（空の `223501` は人が消した）。
- #12（収集日4）: 7セッションを録った（docs/log/2026-09-24.md に集計表）。人の決定で収集の最終日。`s` 34、`t`+`c`+`n` 54
  （24 / 12 / 18）、`quiet` 3 分。取りこぼしは全部基準内（IMU 最大 0.011%、音声は最大 0.007%、どちらも `quiet`）、`t_ms` の逆行 0、
  `o` 0。`water` の `s` の間隔 10 秒未満は 0、非嚥下の条件の中の `s` は 0、終わりの 1.5 秒以内の `s` は 0。記録ファームウェアは
  止まらなかった（基板は 7 本を通してリセットなしで約 26.4 分動き、収集日3で止まった約 22 分を越えた）。収集日3の空の
  `20260923-223501_self_cough` は人が `data/raw/` から消していた。**人が収集日1〜4の全部を採用した（9/24）。** 特徴量と分類器は
  走らせていない。累計 `s` 144、`t`+`c`+`n` 213、`quiet` 12 分で、学習側は収集日1+2（`s` 75）、評価側は
  収集日3+4（14本、`s` 69）で確定。`analysis/split.py data/raw --eval-min 14` の `eval` は収集日3+4の14本の名前とちょうど一致した。
  収集日3の挿し直しのとき基板は首から外していない（人に確認）。#12 は人が閉じた（9/24）。次は #13 の実データでの実行。
- #13（実データ）: docs/decisions/0014 の手順どおりに走らせた（docs/log/2026-09-24.md に `--final` の出力の全文）。コードと手順は
  変えていない。コミット `d5330ef`、`--eval-min 14`、学習側は収集日1+2、評価側は収集日3+4（一覧を照合済み）。閾値 0.90（学習側の
  交差検証で決定。交差検証は検出率 0.453、誤検出率 2.61 回/分）。評価側: 検出率 0.783（54/69）、誤検出率 1.99 回/分（79 回 / 39.70 分）、
  混同行列 TP 54 / FN 15 / FP 79。合格線は両方とも満たす。ただし常時陽性でも検出率 1.000、誤検出率 0.35 回/分で合格線を通る
  （docs/decisions/0011「既知の弱点」）。モデルの陽性窓の割合は 0.031。交差検証と評価側の検出率の開きは調べていない。
  誤検出の多いセッションは評価側の `cough`（収集日4、15 回）と `neck`（収集日3、14 回）。`--final` は1回だけで、評価側はこれ以降動かさない。
- #14: 関門のレビュー（Codex、`--base gate-M0`）を1回回した。指摘は1件（セッションのフォルダの中のファイルのリンクやコピーで、
  評価側の中身を学習側に重ねられる）。docs/decisions/0014「塞がっていない経路」と同じ経路で、実データでは起きていない（28 セッションで
  シンボリックリンク 0、リンク数 2 以上のファイル 0、4 種のファイルの sha256 の重複 0）。人の判断で CONCERN。公開の線引きへの指摘は無し。
  判定の材料として事後の参考解析をした（#13 の数字・定義・手順は変えない。集計値は docs/log/2026-09-24.md）。常時陽性が合格線を通るのは
  指標の本当の穴だが、モデルは陽性窓 3.1% で、偶然の基準は 200 シードのどれも検出率 0.783 に届かない。評価側の PR-AUC 0.357（偶然 0.028）。
  **人が M1 を通過とした（9/24、docs/decisions/0017）。** 条件として M2 の課題を3つ明記した: 日をまたいでも崩れないこと
  （交差検証の fold で検出率 0.938 と 0.093）、咳のときの誤検出を減らすこと（咳のマーカーの 48% に誤検出）、IMU と音の結合の方式を
  決めること（評価側の検出率は IMU のみ 0.464、音のみ 0.435、両方 0.783）。今の特徴量とモデルでは、M2 の合格線（85% / 1 回/分）を
  同時に満たす閾値は無い（事後の参考）。人が `gate-M1` タグを `b70a0cb` に打ち、#14 を閉じた（9/24）。
- #19: 一口ボタンは M2 で使わず、LED は緑・黄の2色を「目安」として点ける規則を docs/decisions/0018 に記録した。
  緑は最初の陽性窓で点け、最後の陽性窓から 2.0 秒（開始が 1.75 秒以内の窓まで）保ってから黄に戻る。赤・点滅・音は無し。
  窓の結果が 1.0 秒出なければ消灯（`millis()` の独立したタイムアウト）。
  装置の LED は基板の RGB（WiFiNINA 経由、#25 で `deps` に足す）で、隠れる・処理が収まらない・ビルドできないときは外付け 2 灯に切り替える。
  DETECT の `led` は 0 消灯 / 1 黄 / 2 緑（#23）。点灯の条件を案A（最初の陽性窓）のままにするかは #20 の塊の長さ別の集計で確かめ、
  案C（2 窓連続）に変えるなら #25 の plan で記録に追記する。装置に貼る表示とカードの文面は記録にある。`docs/evaluation.md` は変えていない。
- #20: **参考のみ。#13 の数字は変えていない。** 既存の 28 本で、収集日を 1 日ずつ検証側にする 4 fold（残り 3 日で 0014 の手順）を回した
  （使い捨てスクリプト、集計値は docs/log/2026-09-24.md「#20」）。方式 A の検出率は 0.349（収集日2）〜0.938（収集日1）、誤検出率 1.01〜4.41 回/分、
  ROC-AUC 0.851〜0.947。#21 と同じ分け方（学習側 収集日1〜3、検証側 収集日4）は 0.735 / 1.01 回/分で、M2 の合格線には届かない。
  仮説: H1（学習日数）は 1 日 → 2 日で残り 2 日 → 3 日は判断できない、H2（収集日2 が当てにくい。IMU の主軸方向のずれが最大）は残る、
  H3（確率の目盛りのずれ）は残る、H4（夜の音のずれ）は判断できない。日をまたいで動くのは音の特徴量（ずれの平均 0.205 vs IMU 0.090）。
  日ごとの正規化（検証日の特徴量で正規化した原因切り分けで、運用可能な性能値ではない）で陽性窓の割合の開きは縮まるが、検出率と誤検出率が
  同時に良くなる fold は無い。咳: `c` に紐づく誤検出は全誤検出の 20.8%（37/178）、`c` 50 回の 52% に誤検出が付く。`c` と `s` は 29 次元で
  線形に分かれる（fold の外の ROC-AUC 合算 0.902）ので 3 クラスにする意味はあるが、減る誤検出は最大でも約 2 割。咳の直後の陽性は咳の開始から
  90 パーセンタイルで 2.37 秒続く。`s` の最初の陽性の遅れは中央値 0.35 秒、1 窓の塊の 78% が誤検出（#19 の材料。決めるのは #19）。
- #17: 装置上の特徴量の計算コストを 3 案で測った（`firmware/bench/`、合成信号のみ、docs/log/2026-09-24.md「#17」）。
  1 ホップ（250 ms）あたり: 案3（0012 の IMU 14 次元）8.1 ms で収まる。案2（0012 の音 15 次元の移植）は全窓 4.18 秒、フレーム再利用でも
  1.10 秒。案1（EI の DSP ブロック、ダミー impulse `bench-dummy-17`）は MFCC 全窓 3.55 秒 / スライス 0.73 秒、MFE 2.21 秒 / 0.56 秒。
  音の 3 案はどれも 250 ms に収まらない（FPU なしの soft-float FFT が支配的。案2 は FFT が 1 ホップの約 82%）。RAM は全案で収まる
  （静的＋ヒープ最大＋スタック 32 KB: 案1 155648 B、案2 173660 B、案3 117004 B / 256 KB）。案1 のフラッシュ 241613 B には落ちない tflite の
  ランタイムとモデル 85 KB を含む。見立て: 窓長・次元・周波数のどれか 1 つでは足りず、効くのは 1 ホップのフレーム数（フレーム stride）と
  FFT の回数（8 kHz ＋ 重心なし ＋ stride 20 ms で約 150 ms の見込み。実測ではない）。#18 の判断材料（0012 の式は変えていない。
  docs/decisions/0001 の再検討条件に当たるかは人が決める）。案2 の移植は `analysis/features.py` と答え合わせ済み（最大相対誤差 1e-6）。
  ボードには bench（案1 の裏取りビルド）が入ったまま。logger は書き戻していない。
- #26: M2 の通し記録（`meal`）の手順を `docs/recording-protocol.md` に足した（早見表の小表と末尾の節）。1 セッション = 1 食
  （`--duration 1800` を上限に Ctrl-C で止める。30 分で自動終了した記録もそのまま 1 セッション）、3 セッション以上・合計 `s` 50 以上・会話なし 1・会話あり 1・収集日 2 日以上が
  望ましい。打つのは `s`（嚥下ごと）・`c`（咳ごと）・`t`（話し始め、5 秒以上黙った後に 1 回）で、`b`・`n`・`q` は打たない
  （docs/decisions/0018）。50 口は `s` の合計で数える。非嚥下の回数の下限は置かない。採否の材料は M1 と同じに `fw` が
  `detector` であることを足した。会話ありは記録の最初に `o` の note `conv` で示す。M2 の数字は検出器で録った `meal` だけで出す。
  `record.py` の引数・`detect.csv`・`feat.csv`・`check_session.py` の対応は #23 で確定（手順に「#23 で確定」と明記）。
  68 行目の一口ボタンの記述は 0018 への参照に直した。`docs/evaluation.md`・`docs/data-schema.md` は変えていない。
  plan レビューは 4 回（BLOCKING 1 → 0、CONCERN 4 → 4 → 1 → 0）。
- #18: IMU と音の結合の方式を docs/decisions/0019 に記録した。装置が窓ごとに IMU 14 次元（0012 のまま）と M2 用に削った音の特徴量を自前で計算し、
  1 本のベクトルにして Edge Impulse で学習した分類器（int8）に入れる。EI は分類器の学習・量子化・C++ ライブラリの書き出しだけに使う（EI の DSP は使わない）。
  音の式は 0012 のままでは載らない（#17: 1099 ms）ので、8 kHz・重心は同じ FFT から・stride 20 ms を既定の候補として（`docs/evaluation.md` 8 行目の特徴量の名前の
  並びは保つ。重心を落とす段は評価の定義の逸脱として記録が要る）、#21 の plan で実機の計測と収集日1〜3 の中の確認を通してから新しい記録に固定する
  （0012 は M1 の定義として残す）。投入は `self` 28 セッションの特徴量ベクトル（1 窓 1 項目、正規化の統計量は fit に使うセッションだけ）。ラベルは 0014 のまま。
  学習は 3 クラス（`swallow` / `cough` / `other`）、装置の出力は 2 値で `cough` は陰性に畳む。EI の training は収集日1〜3、test は収集日4、validation はメタデータで
  セッション単位。公開範囲は Public（#21 で投入後に `self` のみ・線引き（所有者の表示名を含む）の確認を log に書いてから切り替え）。C++ ライブラリは書き出しのまま
  コミット（`model_metadata.h` の ID・所有者名は残す。API キーは含まれない）。`docs/evaluation.md`・0012・0014 は変えていない。
- #23: 検出器の DETECT（`0x04`: 窓の開始 `window_t_ms`、`swallow` の確率 float32、`positive`、`led`）と FEAT（`0x05`: `window_t_ms` ＋ 正規化前の特徴量 float32 × N。
  N はフレームの長さ、名前は `meta.json` の `feature_names`）の形式を `docs/data-schema.md` と docs/decisions/0021 に固定した。`frame.h` に enum を足しただけで
  logger は変えていない。`tools/record.py` は `detect.csv`・`feat.csv` を書き、ストリームのファイルは最初のフレームで作る（検出器のセッションに空の `imu.csv` を
  作らない）。マーカーの `t_ms` は送信時刻のまま。`tools/check_session.py` は `window_t_ms` の飛びで取りこぼしを出す（陽性は数えない）。
  `analysis/evaluate_detector.py`（新規）は `detect.csv` の `positive` と `s` から 0011 の数え方で数字を出し、記録の範囲は最初の窓の開始〜最後の窓の終端か
  最後に届いたフレーム（DETECT / FEAT）の送信時刻の遅いほう。送信の遅れは 1.0 秒まで（0011 の読み替え。0021）。`--scorer` で `feat.csv` の再採点と装置の出力の差を出す（scorer の中身は #22）。`analysis/split.py` は
  `fw` が `detector` のセッションを M1 の分割に入れない。テストは合成データで 201 件（`analysis` 172 件、`tools` 29 件）。実機には触っていない。
  plan レビューは 3 回（BLOCKING 2 → 1 → 0、CONCERN 2 → 2 → 0）。
- #21: M2 の音の式を docs/decisions/0020 に固定し（8 kHz・25 ms フレーム・stride 25 ms。`analysis/features_m2.py`、`FEATURE_SET = "m2-0020"`、実機 1 ホップ IMU 込み 134.3 ms）、
  `analysis/ei_upload.py` で正規化後の 29 次元の特徴量ベクトルを 1 窓 1 項目で Edge Impulse に投入した（training = 収集日1〜3 の 21 本 14440 項目、swallow 437 /
  cough 152 / other 13851。testing = 収集日4 の 7 本 4824 項目。生の音声・IMU は上げていない。定数は `analysis/m2_norm.json`、21 本の `valid` な窓 15030）。
  EI のメタデータの鍵による分割は群を指定できず C-1（validation = 収集日3）は成立しなかったので、人の決定で C-2（鍵 `session`、33%。0019 に追記）。EI が選んだ
  validation のセッション名は取得できていない（`cough` の 3 本が含まれないことだけ分かる）。学習は Raw data・3 クラス・Auto-weight・cycles 50・lr 0.0005・batch 32 で、
  候補 B（Dense 32 → Dropout 0.1 → Dense 16）を人が選び（validation int8: accuracy 91.2%、`swallow` F1 0.46、再現率 65.6%。再学習の差 0）、版 1「#21 candidate B 2026-09-24」に
  固定した。test set（収集日4）の Model testing は最後の 1 回: accuracy 85.74%（float32）/ 85.28%（int8）、`swallow` の再現率 52.2 / 54.4%（**窓単位の参考値。合格線は
  イベント単位で #27**）。以後モデル・設定は変えない。**Public に切り替え済み（9/24）**（条件 1 は log に記録。条件 2（プロジェクト名・説明・所有者の表示名）は
  人が確認した。Private に戻す操作は Dashboard にある。戻していない）。plan レビューは 3 回（BLOCKING 0、CONCERN 2 → 1 → 0）。
- #22: 版 1「#21 candidate B 2026-09-24」の C++ ライブラリ（Quantized int8、EON Compiler、deploy version 2、Studio 1.95.14）を `firmware/detector/src/` に書き出しのまま
  置いた（1383 ファイル、編集しない。ラベル順 cough / other / swallow、`scale_axes` 1、EI 側の正規化なし。Public なので ID・所有者名は書き換えない）。PC 上の実行ファイルは
  `bash firmware/detector/host/build.sh` → `build-host/score_windows`（13 秒、警告 0、CMSIS 不要）。正規化の定数は `firmware/detector/m2_norm.h`（`analysis/m2_norm.json` から生成、
  double で計算して float32 に落とす。selfcheck ビット一致）。検証側（収集日4、7 本）の参考値: 閾値 0.95 で検出率 58.8%（20 / 34）、誤検出率 0.75 回/分（15 回 / 19.87 分）、
  TP 20 / FN 14 / FP 15。**85% と 1.0 回/分を同時に満たす閾値は無い**（0.85 で 85.3% / 1.76 回/分。**参考値。M2 の合格線の数字は #27**）。人の決定で 0.95 を
  `firmware/detector/m2_threshold.h` に凍結（float32 0.949999988。#27 の記録が終わるまで閾値もモデルも変えない）。EI の Model testing（int8、API で 4824 窓）との突き合わせは
  **差あり**（閾値での陽性・陰性の不一致 0、argmax の不一致 3。API の 5 桁の丸めを合わせると完全一致 4648 / 差あり 176 窓、最大 43/256。入力の量子化は原因でなく、推論エンジンの
  丸めの違いと推定。許容幅は決めず、装置との一致は #24 で見る）。`firmware/bench/src/`（#17 のダミー）は人が削除。plan レビューは 3 回（BLOCKING 1 → 1 → 0、CONCERN 3 → 2 → 1、
  残りは E1 の突き合わせで解消）。
- #24: 検出器ファームウェア `firmware/detector/` を作った（`detector.ino` ＋ `sensors` / `audio_capture` / `imu_capture` / `pipeline` / `classify` / `detector_meta` / `detector_frames`。
  Arduino / mbed の API は `detector.ino` と `sensors.cpp` だけ、Edge Impulse SDK は `classify.cpp` だけ。bench・logger のソースはシンボリックリンクで参照。コミット `04a84a9`（段階 1）・
  `f72fbf6`（段階 2〜3）、docs/log/2026-09-26.md）。生の音声は 16 kHz の 2 面（最長 0.5 秒）と 8 kHz のリングにしか無く、送信関数の呼び出しは META・DETECT・FEAT の 3 箇所だけ
  （grep は log）。`CMakeLists.txt` は `SKETCH_NAME=detector` で基底フラグを自動付与（`build-detector`。logger は `build` のまま）。PC のテスト 230 件（`bash firmware/detector/host/test_detector.sh`）。
  実機では最初、4 スライス目の全窓計算 1.2 秒で追いつかず窓が出なかったので、`firmware/bench/audio_features.cpp` の再利用版をスライスごとの分割計算に変えた（**plan の「bench を
  変えない」から外れる**。`check_port.py` はビット一致）。次に IMU の poll スレッド（2 ms・I2C 100 kHz）が 1 ホップを 293 ms にしていたので、切り分け P1〜P6 の後、人の決定で
  本番の既定を I2C 400 kHz・poll 4 ms・`-Os` にした（`-O2` は利得 2% で採らない）。**1 ホップ 208 ms**（音 188・IMU 12・推論 6・送信 1。壁時計 最大 214 ms）で 250 ms に収まり、
  docs/decisions/0001 の再検討には当たらない。RAM は静的 161872 B ＋ ヒープ最大 5644 B ＋ スタック（主 32 KB ＋ IMU 2 KB）≒ 200 KB / 264 KB、フラッシュ 159190 B。
  IMU の基準の周期は「直近 512 行の全差分の平均を公称の 1/1.25〜1.25 倍に収める」に変えた（plan の「飛びでない差分の移動平均」は起動直後に自己固定して約 11 秒窓が出なかった）。
  60 秒の記録 `20260926-114039_self_water`（装着、水 5 回）: DETECT 206 / FEAT 206 / META 1、XOR 0、飛び 0、逆行 0、DETECT と FEAT の不一致 0。PC の再採点（`--scorer`）との差は
  装置 1 / PC 0 = 0、装置 0 / PC 1 = 0、`max |prob − prob_pc|` = 0（ビット一致）。**#24 の完了の条件 4 つを満たした。** 参考値（1 セッション。M2 の数字ではない）: 検出 4 / 5、
  誤検出 0 回。記録は `data/raw/` に残す（M1 の分割にも #27 の既定にも入らない）。マーカーの `t_ms` は押した時刻より 0〜0.25 秒早い側（装着 120 秒、10 回、d1 0.1〜228 ms）で
  `docs/recording-protocol.md` の前提と合う。**人に諮ること: 送信の遅れの上限 1000 ms（0021）を詰めるか。** 実測は `t_ms − window_t_ms` 1201〜1205 ms（窓の終端から 201〜205 ms）。
  詰めるなら 0021 に追記して `analysis/evaluate_detector.py` を直す（別の作業、Codex のレビュー）。確かめていないこと: IMU スレッドのスタック高水位（走査が 2044 を返す）、
  DRDY 割り込み（未実装。要らなかった）、実信号での特徴量の正しさ（bench の合成信号の答え合わせに依る）、窓の数 206 が見込み 236〜238 より少ない理由。
  **実機には本番の detector が入ったまま。logger は書き戻していない。**
- #25: 検出器に LED の表示（嚥下の「目安」。判定ではない）を載せた。`led_rule`（0018 の規則。Arduino 依存なし）と `led_out`（基板の RGB LED を NINA 経由で書く。黄 = 赤＋緑。
  WiFiNINA の API は `led_out.cpp` だけ）、DETECT の `led` は実際に表示している状態、1.0 秒結果が出なければ消灯。PC 側は `analysis/led_rule.py` で再計算し、`evaluate_detector.py` の
  参考値に `led` の不一致の行数を出す。コミット `795773a`、docs/log/2026-09-26.md「#25」。WiFiNINA 2.1.1 / Arduino_SpiNINA 0.0.2。本番 160682 B / 162048 B（#24 比 +1492 / +176 B）。
  実機: 極性 `HIGH` = 点灯で正しい（起動直後は消灯、ポートを開くと黄）。止めると約 1 秒以内に消灯。プロファイル 60 秒（装着）で `total_max` 207.9 ms・`wall_max` 212 ms、
  `digitalWrite` 1 回の最大 373 µs、`led_skipped` 0、飛び 0 で 250 ms に収まった。記録 A `20260926-142926_self_water`（水 6 口）と B `20260926-144044_self_cough`（咳払い 3・首 3）で
  `led` の不一致 0、PC の再採点との差 0、飛び 0。緑の遅れ（A。緑ありは 6 口のうち 3 口）中央値 750 ms・最大 1250 ms、嚥下に紐づかない緑は A 1 回・B 0 回（参考。M2 の数字ではない）。
  **0018 の切り替え条件 (a) に当たった: 基板の LED は喉に当てる面にあり、装着すると見えない。** (b)(c) には当たらない。緑は目で確かめられていない（データでは緑への書き込み 37 行）。
  **人に諮ること: 外付け 2 灯（RP2040 の GPIO 直結の緑・黄）へ切り替えるか（切り替えの実装は別の Issue）、案A のままか案C にするか。** どちらも未決。
  META の無い B の 2 本（USB を挿し直しても META が届かなかった回を含む）は評価に使わない。**実機には LED 付きの本番 detector（`795773a`）が入ったまま。logger は書き戻していない。**
- #29: 検出器の基板の LED が装着で見えない（0018 の (a)）ので、もう 1 枚の Nano RP2040 Connect を表示器にし（`firmware/indicator/`）、`record.py --indicator` が
  DETECT の `led` を 1 バイトずつ USB シリアルで中継する形にした（人の決定。0018 に追記）。検出器のファームウェアと記録の形式は変えていない。表示器の緑 → 黄を目で確かめた（6/6 口）。
  表示器の有無で検出器の記録は変わらない（セッション C `20260926-161925_self_water`・D `20260926-162247_self_water`（途中で表示器を抜いた。記録は続き、送った 58 / 失敗 134）とも
  取りこぼし 0%、飛び 0、`t_ms − window_t_ms` 1202〜1208 ms、`led` 不一致 0、再採点の差 0。#25 の A と同じ）。PC → 表示器の往復（同期で送ったとき。状態が変わる回）
  中央値 0.82 / 最大 2.13 ms（本番の送信スレッドの起床と PC の読み取りの待ち 最大約 50 ms は含まない。測っていない）。コミット `8680504`（段階 1）、indicator 本番 94961 B / 43828 B。
  書き込みは by-id のパスでは 1200 bps のタッチの後にポートを見失って失敗し、実体の `/dev/ttyACM1` で通った（README と `CMakeLists.txt` の書き込みの例は実体のパスに直した）。
  docs/log/2026-09-26.md「#29」。BLE への置き換えは #30。**実機: 検出器に本番 detector（`795773a`）、表示器に本番 indicator（`8680504`）が入っている。logger は書き戻していない。**
- #32: 表示器を UNO R4 WiFi の 12×8 LED マトリクスに替え、状態を形で示す（1 = 流れる波線の動画、2 = 微笑む顔、0 = 消灯。人の決定。0018 に追記）。
  `led` の値・規則・記録の形式・検出器のファームウェアは変えていない。顔に変わり約 2 秒で戻るのを目で確かめた（最初の C' で 3/6 口。この C' は META が届かず消した。録り直しの C' では数えていない）。
  食卓の距離での見え方: 「問題なかった」（開発者が介助者の代わりに見た。形の見分け・明るさ・赤・波線が急かすように見えないか、とも問題なし）。
  表示器の有無で検出器の記録は変わらない（C' `20261001-134602_self_water`・D' `20261001-134924_self_water`（途中で表示器を抜いた。記録は続き、表示器は消えた）とも
  取りこぼし 0%、飛び 0、`t_ms − window_t_ms` 1202〜1206 ms、`led` 不一致 0、再採点の差 0。#29 の C・D と同じ。`record.py` の終了時の XOR 不一致と転送の件数は控えていない）。
  PC → 表示器の往復（同期で送ったとき。状態が変わる回）中央値 1.42 / 最大 2.12 ms（#29 は 0.82 / 2.13。本番の送信スレッドの起床と PC の読み取りの待ちは含まない）。
  コミット `2bc1ef6`（段階 1）、indicator 本番 54792 B / 6996 B（ボードコア `arduino:renesas_uno` 1.6.0）。detector の `.bin` の sha256 は変わらない。
  書き込みの `-DPORT` は実体の `/dev/ttyACMx`（by-id は bossac で失敗）。検出器の USB を挿し直さずに始めると META が届かなかった（0006。#25 の B で 2 回、#32 で 1 回）。#33 で対策した（挿し直しは不要になった）。
  docs/log/2026-10-01.md「#32」。**実機: 検出器に本番 detector（`795773a`）、表示器に本番 indicator（`2bc1ef6`、UNO R4 WiFi）が入っている。logger は書き戻していない。**
- #33: `record.py` が開始時に合図 `'M'` を送り、検出器が META を送り直す。5 秒以内に届かなければ記録を始めない（フォルダを作らない）。挿し直しは不要（検出器のみ。
  logger は合図に応えないので今までどおり挿し直す）。META の JSON・フレーム形式・`meta.json` のキーは変えていない（0006 に追記、0021 に 1 行）。コミット `102a83e`（段階 1）、
  detector 本番 160808 B / 162056 B（#25 比 +126 / +8）。挿し直さずに 2 回続けて録って両方 META が届いた。60 秒の `water`（表示器なし・あり）で取りこぼし 0・`led` 不一致 0・
  再採点の差 0、1 ホップの時間は #24 と同等（`total_max` 207.2〜208.0 ms、`wall_max` 211〜212 ms、再送の所要は最大 2620 µs）。範囲外の既存の欠点（SYNC の途中で読み取りが切れると
  フレームを 1 つ失う）は #34。docs/log/2026-10-01.md「#33」。**実機: 検出器に本番 detector（`102a83e`。計測の後に人が書き戻した）、表示器に本番 indicator（`2bc1ef6`）。logger は書き戻していない。**
- #34: `tools/record.py` の `parse_frames` を直し、SYNC（`0xA5` `0x5A`）の間で読み取りが切れてもフレームを失わないようにした（末尾が `0xA5` なら 1 バイト残す）。
  テストは tools 47 → 50、analysis 261（不変）。PC 側だけの変更で、ファームウェア・フレーム形式は変えていない。docs/log/2026-10-01.md「#34」。
- #27: `meal` の 1 本目を録った（会話あり、`s` 45）。採否の規則を変え、10/4 で打ち切ると決めた（`s` の打ち忘れ・打ち遅れで捨てない、
  `s` は意識した食べ物・飲み物の嚥下。docs/decisions/0023）。陽性は見ていない。予行の `water`（参考。M2 の数字ではない）で、装着し直すと検出が 0 / 3 から 3 / 3 に
  変わった（装着で検出が変わる。#20 の主軸方向のずれと同じ形、断定はしない）。docs/log/2026-10-02.md。
- #27: `meal` の 2 本目 `20261003-194511_self_meal` を録った（会話なし、`s` 49）。0023 で採用（XOR 不一致 0）。採用 2 本（会話あり 1・会話なし 1）、`s` 合計 94、収集日 2 日。陽性は見ていない。docs/log/2026-10-03.md。
- #27: `meal` の 3 本目 `20261004-192754_self_meal` を録った（会話なし、`s` 46、記録の途中で付け直し）。0023 で採用（XOR 不一致 0）。10/4 で打ち切り。採用 3 本（会話あり 1・会話なし 2）、`s` 合計 140、収集日 3 日（記録手順の望ましい条件は全部届いた）。採否の確認の前に `detect.csv` の 4 行（`positive` 0）が目に入った逸脱あり（採否には使っていない。扱いは人の判断）。docs/log/2026-10-04.md。
- #27: 検出器で `meal` を 3 セッション（収集日 3 日、会話なし 2・会話あり 1、`s` 合計 140）録り、`evaluate_detector.py`（既定の対象、HEAD `4f4ca8e`）で
  検出率 0.150（TP 21 / FN 119）、誤検出率 2.03 回/分（FP 89 回 / 非嚥下 43.86 分）。M2 の合格線（85% 以上、1 回/分以下）に対して 検出率 満たさない・誤検出 満たさない。
  評価に使ったセッション: `20261002-203031_self_meal`、`20261003-194511_self_meal`、`20261004-192754_self_meal`。再採点の差は装置 1 / PC 0 が 0、装置 0 / PC 1 が 0、
  max |prob − prob_pc| 0。`positive` と `prob`、`led` と再計算の不一致は 0 行。定義・閾値・モデルは動かしていない。扱いは #28（人）。docs/log/2026-10-04.md「#27 M2 の数字」。
- #28: 関門のレビュー（Codex、`--base gate-M1`、`b70a0cb`..`4d48e9d`）を 1 回回した。指摘 3 件（合格線未達 [high]、検出器の取り込み面の波形が上書きまで RAM に残る [high]、
  `evaluate_detector.py` の `--sessions` が `cond` を確かめない [medium]）。公開の線引きへの指摘は無し。人の判断で後の 2 件は CONCERN（RAM 上の上書き待ちは「破棄」に含める解釈を 0027 に残す。
  `--sessions` は運用で注意）。BLOCKING は残っていない。**人が M2 を通過しないと判定した（10/4、docs/decisions/0027）**: 検出率 0.150（TP 21 / FN 119）、誤検出率 2.03 回/分（FP 89 / 43.86 分）、
  評価に使ったセッションは `meal` 3 本（docs/log/2026-10-04.md）。次の段は 0024・0025 のとおり咽喉マイク＋UNO Q。`gate-M2` は打たず、人が `review-M2` タグを判定のコミットに打つ。#28 を閉じるのは人。
- 10/2: 人の決定でマイルストーンを組み替え（0024）、音を咽喉マイク＋UNO Q に切り替え（0025）、
  IMU なしで始める（0026）。docs/plan.md・docs/proposal.md・AGENTS.md を直した。GitHub の Milestone も合わせた（M3「咽喉マイクの試用」、M4「検出器（咽喉マイク版）」、Issue なしの「応募後」を新設。期限は変えていない。付け替えた Issue は無い）。CLAUDE.md の差し替えは人。
- 10/3: CLAUDE.md の「データの扱い」の 1・2 項目と「実装方針」を UNO Q の構成に合わせて差し替えた（人がメインに頼んだ。文面は人が承認した
  組み替えの plan の 7.2・7.3、記録は docs/decisions/0025）。同じコミットで AGENTS.md の冒頭と不変条件 4・8、codex-review skill の観点 1（生データ。検出器の全体で保存も送信もしないか）・
  観点 3（M2 の構成と UNO Q の構成に分けた）、docs/workflow.md の旧構成前提の例 2 行とセンサ構成の参照先（0002・0025・0026）を直した。M1・M2（Nano）の決まり（EI の C++ ライブラリ形式、A 案、検出器は生の音声を保存も送信もしない）は残した。
  0025 の「UNO Q の推論のコードを書く前」の条件はこれで満たす。無線リンクの境界は #42。
- 10/3: コードにフォーマッタをかけた（人の依頼。行幅 80）。Python は ruff（`pyproject.toml`）、C++ と .ino は clang-format（`.clang-format`、Google スタイル土台）。`bash tools/format.sh` で両方を実行する。`firmware/detector/src/`（EI の書き出し）は整形しない。生成物 `shapes.h` は gen_shapes.py が `// clang-format off` を出す。clang-format のコメント折り返しは切った（日本語の文中に空白が入る）。代わりに、行が 80 を超える行末コメントは前の行へ移し、80 を超えるコメント行は使い捨てのスクリプトで折り返した（空白・句読点を優先、カタカナ語の途中では切らない）。docstring も同じ規則で折り返し、使い方の表はコマンドの行と説明の行に分けた。出力の文面の文字列、生成物のヘッダ（m2_norm.h・m2_threshold.h は整形しない）、detector_meta.h の JSON の例と URL は 80 を超えたまま。テスト（analysis 261、tools 50、test_detector 309、test_indicator 837）と logger・detector・indicator のビルドは整形後も通る。
- #36（10/7、main）: PC がアダプタ（UGREEN CM721）を認識せず UNO Q が認識するので、UNO Q の `arecord` の生 PCM を ssh で PC に流して録る経路にした（docs/decisions/0028、`fdde805`）。
  `tools/record.py --throat <iface>`（装置をつながない咽喉マイクだけのセッション。`throat.wav` 48 kHz・2 ch 受けたまま、`throat_chunks.csv`、`fw` = `pc-throat`、時計は PC の単調時計）、
  `tools/throat_check.py`（受信の時刻による対応、叩きの確かめ、使わない目安）、`docs/data-schema.md` の追記、docs/decisions/0029。判定の条件は #37 の記録の前に
  docs/log/2026-10-07.md に固定した（コミット済み）。合成で対応の誤差 最大 1.8 ms（20 ms の要求の内）。実機の疎通 10 秒で overrun 0・`buffer_size` 96000。
  コミット前の adversarial-review 1 回目で PCM 名の検査の穴を 1 件直した。2 回目の指摘（ALSA の設定による再定義）は CONCERN（人の決定）で、起動前の `~/.asoundrc`・`/etc/asound.conf` の検査と 0029 の記録で対応した。テストは tools 50 → 75、analysis 261（不変）。集計スクリプトは使い捨て（`~/work/zaitaku-mealpace-scratch/issue36/`）。docs/log/2026-10-07.md。
- #37（10/8、有線のみ）: 人が有線（`sh12jk-wired-unoq-usbaudio`）で 5 条件を録った（`data/raw/trial-throat/`。中断の 1 本は使わない。採否は数字の前に人が決定）。5 本とも overrun 0・段差 0・使わない目安に当たらない。叩きは 5 / 5 見つかったが `Δ` の中央値が −55〜−74 ms で 50 ms を超え、人の決定で直さず印を付けて使う。
  10/7 の規則のまま集計した: `s` の振幅の比の中央値 137.66（IQR 103.65〜193.95）、`quiet` 1.10（1.08〜1.44）、`c` 405.35・`n` 40.12・`t` 22.60。条件 1〜3 は 3 つとも満たす（条件 3 は 6 回のうち 6 回）。**信号の有無の判定は人**。NZ-210C 経由は未（変換ケーブル待ち）で、経路の差もその後。docs/log/2026-10-08.md。
- #38（10/8、plan の前の実機の試し）: NZ-210C の直接ペアリング（A2DP）は**構成 B（送信機 → UNO Q）で動いた**（SBC、`pw-record` の標準出力に 48 kHz・2 ch、マイクの音が乗る）。要ったのは Class of Device を Audio/Video に（人、sudo）、lightdm 側の bluez の監視を止める（人、sudo）、arduino 側の seat-monitoring を disabled、鍵を消してからエージェント NoInputNoOutput で承認。
  3 秒の 0 の区間（原因未確認）、`JustWorksRepairing = always`（未適用）、記録の経路にする手順は plan で。構成 A は試していない。UNO Q のホームと `/tmp` に音声のファイルは無い（確認の方法は log）。#38 の他の項目（LED の RPC、PD 電源、arduino-cli）は未着手。docs/log/2026-10-08.md。
- #38（10/9、main）: plan #38（Codex の 3 面 LGTM）を実装した。**実装済み・実測待ち。** `tools/record.py --throat sh12jk-nz210c-a2dp-unoq` で、UNO Q の bluez_input のノードから ssh 越しの `pw-record`（標準出力だけ、`-P` で node.dont-reconnect・node.dont-fallback・node.name = zm-throat-record）を受ける。
  `--throat-device` は iface と形を結ぶ（構成 B は bluez_input だけ、USB は hw / plughw だけ）、省けば自動で探す。起動前の PipeWire の確認（設定・ノード・ミュート・他の取り込み・pipe-tunnel）、起動後のリンクの確認（`throat.pipewire.link_check`）、2 秒の受信の止まり（`stall`）。
  `tools/throat_check.py` に 0 の区間（構成 B だけ使わない目安）。`alsa` の経路は変えていない。`docs/data-schema.md`、0029 に 1 行、`docs/unoq-setup.md`（新規）。テストは tools 75 → 84、analysis 261（不変）。
  **実測 E1〜E9 は未実測**（UNO Q に届かない。10/8 と同じ）。`ZERO_RUN_MS` = 10 ms は仮置きで、合成と疎通にだけ使う。E3 → 人の閾値決定 → 規則の log のコミット → E7 (b)（6b）→ 疎通の後でなければ #37 の構成 B の正式な記録に進まない。
  #38 の従の項目（LED の RPC、PD 電源、arduino-cli）は #38 の未完として残し、次の plan で扱う（10/10 は #38b に切り出す案だったが、人の決定（10/12）で #38 のまま進める）。docs/log/2026-10-09.md。
- #38（10/10）: **実測 E1〜E6・E9 済み、取りこぼしの規則を固定、6b（E7 (b)）待ち。** 人が `ZERO_RUN_MS` = 100 ms に決め、plan 第 4.2 節の規則を docs/log/2026-10-10.md に固定した（E3: 自然な 0 の最長 0.06 ms、63.8 ms の途切れ 1 回）。
  plan の見込みと違った 6 点（ノードの `media.class` は `Stream/Output/Audio`、`90-bluez-no-seat.conf` は入れ子の 5 行、ノードは 44100 Hz、E6 は child-exit、linger が要る、`stream-properties` は音声でない）に合わせて検査・テスト・`docs/unoq-setup.md` を直した。
  E9: `JustWorksRepairing = always` ＋ trust 1 回でエージェントは要らない。再起動後は `pairable on` と WirePlumber の再起動。linger はメインが有効にする。E7 (a)・E8 は未。次は 6b → 疎通 → #37 の構成 B の記録。
  **6b 合格（10/10）。正式な記録に進める。** E7 (b) は時間終了・Ctrl-C・stall・起動待ちのタイムアウト (b)（実在のノードに SIGTERM）のどれでも UNO Q に `pw-record` とストリームが残らなかった（(a) は 1 回試して窓に当たらず、人の決定で (b) で足りるとした）。
  E8: 送信機の入れ直しでノード名は `.2` のまま。trust 済み・エージェントなしで約 2 秒で再接続。次は疎通（任意）→ #37 の構成 B の 5 条件（人）→ 集計と経路の差。docs/log/2026-10-10.md。
  **構成 B の 1 回目の 5 本は送信機のノイズゲートの 0 で使わない（10/10）。取説の確認待ち。** 5 本とも 0 の区間で使わない目安に当たった。切り分け（各 60 s）で、送信機 NZ-W210C が入力のごく小さいとき（RMS おおよそ 10〜15 LSB 未満）にちょうど 0 を送ると分かった（PipeWire・Bluetooth・PC 側ではない）。
  `quiet` が 0 に寄るので plan #38 第 4.2 節により止まり、振幅の集計はしていない。人が取説でゲートを切れるか確かめてから扱いを決める。叩きの `Δ` は +31〜+168 ms（無線の遅延）。docs/log/2026-10-10.md。
- #46（10/24）: plan #46（Codex 2 回、3 面 LGTM。人が 10/24 に承認）を実装した。M4 の学習・評価の分割と記録の計画を docs/decisions/0037（採用）に、
  M4 のどの記録も録る前に固定した。評価側は装置で録る `self` の `meal` 3 本以上・収集日 2 日以上（窓は 10/29〜11/1 に前倒し（0037 の追記 10/29。日数は同じ）、打ち切り 11/1 の終わり）、学習側は M3 の 21 本
  （M3 の評価側だった 7 本を含む）＋学習用 `meal` 3 本（10/25〜10/28、締め 10/28 の終わり）。追加の条件別セッションは録らない。評価用では FEAT を窓ごとの要約の値（82 次元の方針）で有効にする。
  `analysis/fixed_eval.py` に M4 の定数と検査（`assert_m4_train`・`assert_m4_eval`・`m4_lines_match`・`M4_MARKER`。呼ぶのは #45・#49）を足し、M3 の一覧と検査は変えていない。
  `tools/record.py --throat` が `--cond meal` を有線の iface（`sh12jk-wired-unoq-usbaudio`）だけ受けるようにした。`docs/recording-protocol.md` に「M4 の `meal`（咽喉マイク）」の節と早見表。
  テストは analysis 390 → 410、tools 86 → 88。`split.py --kind throat` の一覧は 0034 の 14 本・7 本のまま。合成の 30 分のセッションで `throat_check.py` と
  `throat_session_span` が通った（PC で 27 秒、最大常駐 約 3.6 GiB。docs/log/2026-10-24.md「#46」）。`M4-TRAIN`・`M4-EVAL` の一覧は締め・打ち切りの後に 0037 と `fixed_eval.py` に追記する。
- #44（10/24）: plan #44（Codex 3 回、3 面 LGTM。人が 10/24 に承認）を実装し、UNO Q で測った。`analysis/features_np.py`（numpy だけの間引き・`mfe40`・`a52`・
  `cnn_forward`。`features_v2.py`・`tools/throat_check.py` もこれを呼ぶ）、メル行列の `.npy` と照合用の `features_np_ref.npz`（`make_features_np_consts.py`）、
  `device/unoq/bench_infer.py`、`analysis/` へのリンクと `deploy-unoq` の `--copy-links`・リンクの先の検査（配るのは 9 つ）。テストは analysis 378 → 390、tools 85 → 86、device/unoq 19 → 24。
  合成のセッションで旧の経路（`resample_poly`・librosa）との差は 0（M3 の性能の数字は確かめ直していない）。UNO Q（numpy 2.2.4、参照の BLAS、1 スレッド）で照合 OK（最大の差 6.1e-08）、
  1 窓の全体（間引き → 特徴量 → 推論 → 後処理 → RPC）の中央値は構成 J 41.6〜45.0 ms、構成 J＋R 48.2〜53.8 ms、最大 58.1 ms 以下で、ホップ 0.25 秒の 250 ms・0.1 秒の 100 ms に収まる
  （CNN だけで約 27.8 ms）。ホップの変更は決めていない（別の decision）。`arduino-router` 0.11.0 でソケットの権限が変わり、人が `arduino` を `arduino-router` のグループに足した。
  UNO Q に音声のファイルは無い。docs/log/2026-10-24.md「#44」、0035 の追記。ランタイムの比較（B・C・D）は人の決定で別 Issue。
- #51（10/24）: plan #51（Codex 2 回、3 面 LGTM。人が 10/24 に承認）を実装し、UNO Q で測った（計測だけ。装置の推論は numpy のまま、採否は別の decision で #47 の plan の前）。
  `analysis/make_runtime_models.py`（乱数の重みの CNN を ONNX・TFLite・ncnn に。4 つで 87,069 B、PC の CPU で `cnn_forward` と 1e-7 以下）、`test_runtime_models.py`、
  `device/unoq/bench_runtimes.py`（`bench_infer` の (c)・(f) の CNN の段を替える。CPU 時間・60 秒の持続的な負荷・スレッドで投入する重ね合わせも測る）、配る一覧は 14 個。
  テストは analysis 410 → 418、device/unoq 24 → 30。一時的に入れたものと装置で使うものの区別は docs/decisions/0039（採用）、0035 に追記。
  UNO Q（合成入力・乱数の重み・RPC 込み）: CNN 1 窓の中央値は numpy 27.7 ms（参照 BLAS）・14.6〜14.9 ms（OpenBLAS）、CPU のランタイム（LiteRT・ONNX Runtime・ncnn・Arm NN CpuAcc）
  1.3〜2.2 ms、GPU（ncnn の Vulkan）8.7〜9.7 ms（CPU 時間 約 2.5 ms）。構成 J の全体は測れた全部の行で 250 ms・100 ms 未満（中央値 17.3〜45.9 ms。numpy の書き方の
  einsum `optimize=False` だけ 80〜86 ms）。動作しなかったもの: ONNX Runtime の XNNPACK の EP、Arm NN GpuAcc（ACL）、LiteRT の GPU（SIGILL）。既定のスレッドの ONNX Runtime と
  OpenBLAS は持続的な負荷でこのプロセスの CPU 使用率 118〜320%（1 スレッド指定で 13〜76%）。ONNX Runtime は `~/.cache/Microsoft/` にファイルを書く（音声ではない）。
  BLAS の alternatives は参照実装に戻したが manual mode。UNO Q に音声のファイルは無い。docs/log/2026-10-24.md「#51」。
- #45 ステップ 1（10/24）: plan #45（Codex 3 面レビュー LGTM。人が 10/24 に承認）のステップ 1 のコードと合成のテストを書いた（M4 のどの性能の数字も見ていない）。
  `analysis/postprocess.py` に 1 窓ずつ進める後処理 `PostStepper`（ヒステリシス → 不応期 0.5 秒（塊ごと抑える）→ 塊の上限 1.5・2.0・2.5 秒）・`post_mask`・`ensemble_mean`
  （上限・不応期なしは `hysteresis` とビット一致。装置に配るので numpy と `evaluate` だけ）、`compare.cnn_fit` に省略可の `sample_weight`（省くと今の経路のまま）、
  `analysis/m4_compare.py`（M4 の学習側の一覧 `list_train`（締めより後は `meta.json` も開かない）、収集日ごとの CV、入れ子の hard negative、種の平均、分類器 5 × 後処理 5 = 25 行と
  参考の行、選び方（1.0 回/分以下で検出率が最大、同率は単純なほう）、誤検出の中身の排他の主分類、報告、`--smoke`・`--final-model`、`load_model`・`model_prob`、`plan_trainings`）、
  `visualize.py` の `side="m4train"`（`meal` は 300 秒ごとの頁、細かい表示を描かない）、`fixed_eval.py` の `M4_CONFIG`・`M4_MODEL`（`None`）と 0038 の行の照合。
  テストは analysis 418 → 472（device/unoq 30・tools 88 は変わらず）。予行（`--smoke`）の結果は docs/log/2026-10-24.md「#45 ステップ 1」。
- GitHub Projects `zaitaku-mealpace - Development Management`（`https://github.com/users/owhinata/projects/6`、Private）を 11/2 に作った（docs/decisions/0046）。フィールド 8 つと View 5 つ（Overview / Execution Board / Milestone / Gate / Risks & Decisions / Roadmap）、#1〜#59 を登録して初期値を付けた。正の所在と更新の規則は docs/workflow.md「GitHub Projects」。グループ化・並び順・Board の列・Roadmap の日付欄は API に無く、人が Web UI で設定する。
- #54（11/3）: 1 ホップは M5 では 0.25 秒のまま（人の決定 11/1、(a)）を docs/decisions/0047 に記録した。公開の数字は 0.25 秒のもの。1 ホップの `proc_ms` は 30 分で中央値 79.8・最大 86.1 ms、180 秒の回に最大 106.2 ms があり「0.1 秒に収まる」とは書かない。
  0.1 秒は M6 以降で、新しい評価側の記録と 1 回だけの採点、`docs/evaluation.md` の変更（人、Codex のレビュー）、LiteRT CPU の採否（0040 決定 4）、MCU の表示の更新間隔、M2・M4 との並べ方をそろえてから。文書だけ（コード・`docs/evaluation.md` は変えていない）。
- #55（11/3）: `p1` の記録先を docs/decisions/0048 に記録した（人の決定 11/3。11/1 の (a) は取り消し）。`p1` は `self` と同じく `data/raw/` に記録し、暗号化ディスクの要件を外す。コミットしない・貼らない・公開は集計値と匿名化した切り出しのみ・モデル確定後に削除、は変えない。
  `tools/record.py`・`analysis/` は変えず、本人試用の前の実装 Issue も作らない。CLAUDE.md の該当行は人が書き換え、AGENTS.md は同じコミットで見直す（暗号化に触れる行は無い）。`data/README.md` と `docs/plan.md` を直した。
- #52（11/3）: MCU は `loop()` が `zm_set_state` の受信に気づいてから約 2 秒（2000 ms）次の受信が無ければ自分で消灯する（docs/decisions/0049、0035 に追記。plan は Codex 3 回・BLOCKING なし）。
  Linux 側の `detector.py` は変えず（窓ごとに送る）、`led_check.py` の文言だけを直したので `code_sha256` は `88af2198…`（配り直し済み）。実機の確かめ (0)〜(4) は人が行い通過（router の停止では即消えた。理由は推測。
  docs/log/2026-11-03.md）。確かめ用の `water` 4 本は人の決定で消した。
- #58（11/13）: README の 3 点だけを直して済みとした（人の決定。コミット `3d922c2`・`8f31e80`、コードは変えていない。Issue #58 のコメント）。人が close した。作品ページは https://protopedia.net/prototype/10013 。残り: #56 の公開（11/14〜15）と応募フォーム（11/24 まで）、#59 の関門の判定。
- #57（11/13）: 動画を人がアップロードした（https://youtu.be/y1x6TrA4hLw ）。素材は動画・アイキャッチ・構成図の 3 つですべて（人の決定）。PR #60 は 11/9 に人がマージした。`story.md`（元のドラフト）と `story.1.md`（公開に使う修正版）は両方残す（人の決定 11/9）。残り: 作品ページへの貼りつけ（LED の絵の URL の置き換え）、11/14〜15 の公開、応募フォーム、#58、#59。
- #56（11/5〜11/9）: ストーリーの修正は PR #60（ブランチ `56-story-revision`、`docs/protopedia/story.1.md`）で、人がチャットで細かく指示し、メインが当てた。4 節（場面 / 目安 / 作り方 / どこまでできたか）。評価は検出率 95.7%・誤検出率 1.25 回/分と目標との比較、M2 との比較表だけで、混同行列・セッション一覧・分母は本文に置かない（人の決定 11/5、docs/decisions/0051。CLAUDE.md「評価」と AGENTS.md の該当行に例外を書いた。人の指示でメインが書き換えた）。LED の表の絵は `tools/gen_led_images.py` が `docs/img/led_*.png` に作る（赤。実機は青だが人の判断でそのまま、11/9）。扉絵 `docs/img/cover.png` と構成図 `docs/img/system-diagram.png` は人が作り、11/9 にコミットした。**公開は 11/14〜15 に変更**（人の決定 11/9。動画 #57 が 11/11 の後になるため）。概要欄は 92 字の新版（Issue #56 のコメント 11/9）。残り: 動画（#57）、PR #60 のマージ、貼る版の画像 URL の置き換え、公開、応募フォーム。
- #56（11/4）: ストーリー本文の下書きを人が書き、`docs/protopedia/story.md` に置いた（見出しに絵文字。内容は人のドラフトのまま）。人の決定 11/4: 細かい結果レポート（セッション一覧の表・誤検出の内訳）は本文に入れない、既存製品の調査日は無くてよい、誤検出の原因は推測の書き方で十分。残りの枠: 動画 URL（#57）、「評価資料」の図。メインが数字と固有名を 0042・0027・proposal 6 章に当てて確かめた（食い違い無し。禁句・公開の線引きも問題無し）。
- #53（11/3、ステップ B 済み）: 単独モード `detector.py --live --standalone`（標準入力・標準出力を使わず、journald には文だけ）、ユニット `device/unoq/zaitaku-detector.service`（`flock -n -F -E 75 /home/arduino` の下で起動、`Restart=on-failure`、10 回/120 秒で止まる）、`record.py` の排他（記録の子と検出器を同じロックの下で起動、起動前にユニットの状態を確かめる）を実装した（docs/decisions/0050）。
  ロックの fd は `arecord` にも渡し、`/proc/self/fd` の列挙と fstat の失敗は fail-closed（adversarial-review 3 回の指摘。4 回目は回さず収束しないとして人がコミットを決定）。テスト 129 件。
  実機の確かめ (0)〜(8) は人が行い通過（docs/log/2026-11-03.md「#53」）。`code_sha256` は `1fd5b820…`（配り直し済み）。ユニットは link・enable 済みで、電源投入から PC なしで動く（波線まで約 40 秒。起動直後は MCU の RPC が揃わず 2 回再起動）。
  打ち切り（11/7）は要らない。(6) の後にアダプタを戻して電源投入すると自動で active になり波線が戻った。確かめ用のセッション 2 本は人の決定で消した。

## 次にやること

M0〜M3 は済み（関門の判定: 0010・0017・0027（M2 は通過しない）・0036。M2・M3 の Issue の結果は「直近の状態」と各 decision にある）。

M4 検出器（咽喉マイク版）（10/14〜11/7、人の決定で前倒し。Issue #44〜#51。草案は人がレビューし、起票後に削除。控えは `~/work/zaitaku-mealpace-scratch/m4issues/`）:

日程（人の決定 10/24、docs/decisions/0037。10/13 の 10/18〜10/22・10/30〜11/2 を改めた）: 学習用 `meal` は 3 本（10/25〜10/28、締め 10/28 の終わり）、評価用 `meal` は 3 本以上・収集日 2 日以上（10/29〜11/1 に前倒し、打ち切り 11/1 の終わり。0037 の追記 10/29）、#49 は 11/5、#50 は 11/7 まで。追加の条件別セッションは録らない。削るかは 10/28 ごろに判断。
起票時の人の決定（10/14）: 評価用の `meal` では FEAT（窓ごとの要約の値）を有効にする（D7 の例外、0005 の範囲内。中身は 0037）、48 kHz → 16 kHz の間引きは装置と PC で同じ numpy のコード（#44 で実装）、不応期は N = 0.5 秒だけ（嚥下回数と衝突）、hard negative を候補に明示、`detector.py` は `python3 -u` で起動し受信時刻との差を log に、D8 は (b)（検出器に音声の出口を作らない）。

**今（11/1、計測終了）:** 人の決定で評価用 `meal` の記録を 4 本で終えた（打ち切り 11/1。0037 の `M4-EVAL` と `fixed_eval.M4_EXPECTED_EVAL` に 4 本を固定、追記 2026-11-01。性能の数字は未見。テストは None 前提の箇所を差し替え。docs/log/2026-11-01.md）。次は #49 の plan（評価側を 1 回だけ、M2・M3 と並べる。11/5 まで）→ #50（11/7 まで）。#48 は人が close した（11/1）。**plan #49 は承認済み（11/1。Codex 4 回、PLAN-SHA `15e1f59302953f8c`、3 面 LGTM。人の決定は docs/log/2026-11-01.md）**。**ステップ A・B・C は済み（11/1）**。評価側 4 本を 1 回だけ採点した（人の合図、メインが実行、印 `docs/log/m4-final-49.txt`）: 検出率 0.957（199/208）は合格線（0.85）を満たす、誤検出率 1.25 回/分（70 回 / 56.00 分）は合格線（1.0）を**満たさない**。装置と PC の不一致 0。会話あり 1.56・会話なし 0.95 回/分。主分類は会話あり 26・会話なし 22・直後の延び 10・直前 6・動作 6。出力の全文は docs/log/2026-11-01.md、結果の追記は 0041。#49 は人が close した（11/1）。評価側を見た後に構成・閾値・後処理を変えない（0038）。
**#50（関門）:** 関門のレビュー（adversarial-review、base `gate-M3`、39 コミット）は 11/1 に 1 回回した: needs-attention、high 2 件、BLOCKING なし。人の決定（11/1）: 1（印がチェックアウトごとで `497b066` の別 worktree で再採点できる）は CONCERN・運用で注意（0041 に追記済み）、2（Linux と MCU の RPC が途切れると最後の表示が残る。MCU に消灯タイマーが無い）は CONCERN・M5 の前に MCU 側の自律消灯を 0035 を改める decision つきで足す。生の出力と裏取りは Issue #50 のコメント。判定の decision は 0042: **人の判定（11/1）: 通過しない。M5 へ進む。** `review-M4` = `5601b59`（人が打った）。#50 と Milestone M4 は人が close した（11/1）。
**前（11/1 昼）:** 評価用 `meal` の 4 本目を録った（`20261101-134412_self_meal`、会話なし、同席者なし、855 秒、`s` 54・`t` 0・`c` 0、窓 3415・取りこぼし 0、`delay_meas` 最大 640 ms、時計のずれ 11 ms、`proc_ms` 中央値 63.8 ms。0037 の 5 の 1〜9 に当たらず、人の決定で採用。陽性・`prob`・FEAT の値は見ていない。docs/log/2026-11-01.md）。累計 4 本（会話あり 2・なし 2）・収集日 3 日・`s` 208。打ち切りは 11/1 の終わり。打ち切りの後に 0037 の `M4-EVAL` と `fixed_eval.M4_EXPECTED_EVAL` に一覧を追記してから #49。
**前（10/31 夜）:** 評価用 `meal` の 3 本目を録った（`20261031-195410_self_meal`、会話なし、同席者なし、1076 秒、`s` 51・`t` 0・`c` 1、窓 4300・取りこぼし 0、`delay_meas` 最大 513 ms、時計のずれ 12 ms、`proc_ms` 中央値 63.6 ms。0037 の 5 の 1〜9 に当たらず、人の決定で採用。陽性・`prob`・FEAT の値は見ていない。docs/log/2026-10-31.md）。累計 3 本（会話あり 2・なし 1）・収集日 2 日・`s` 154 で 0037 の目安を満たした。打ち切りは 11/1 の終わり（それまでの採用分はすべて評価側）。打ち切りの後に 0037 の `M4-EVAL` と `fixed_eval.M4_EXPECTED_EVAL` 相当に一覧を追記してから #49。
**前（10/31）:** 評価用 `meal` の 2 本目を録った（`20261031-145803_self_meal`、会話あり、同席者あり、850 秒、`s` 50・`t` 0・`c` 1、窓 3397・取りこぼし 0、`delay_meas` 最大 412 ms、時計のずれ 11 ms、`proc_ms` 中央値 63.6 ms。0037 の 5 の 1〜9 に当たらず、人の決定で採用。陽性・`prob`・FEAT の値は見ていない。docs/log/2026-10-31.md）。累計 2 本・収集日 2 日・`s` 103。残りは 11/1 で 1 本以上（会話なしが目安）。打ち切りは 11/1 の終わり。採否の後に 0037 の `M4-EVAL` と `fixed_eval` に一覧を追記してから #49。
**前（10/30 夜）:** 評価用 `meal` の 1 本目を録った（`20261030-201124_self_meal`、会話あり、同席者あり、1023 秒、`s` 53・`t` 8・`c` 2、窓 4088・取りこぼし 0、`delay_meas` 最大 564 ms、時計のずれ 18 ms、`proc_ms` 中央値 63.8 ms。0037 の 5 の 1〜9 に当たらず、人の決定で採用。陽性・`prob`・FEAT の値は見ていない。docs/log/2026-10-30.md）。残りは 10/31・11/1 で 2 本以上（うち会話なし 1 が目安）、収集日あと 1 日以上。打ち切りは 11/1 の終わり。採否の後に 0037 の `M4-EVAL` と `fixed_eval` に一覧を追記してから #49。
**前（10/29 夜）:** #47 は実装・配置・動作確認まで済み（plan #47、人の承認 10/29。ハートビートの追記は人の決定で Codex を回さない）。装置は UNO Q の Linux 側の `detector.py`
（numpy の im2col ＋ OpenBLAS 1 スレッド、0038 の構成と重み）、PC は `record.py --unoq-detector`。再生モードで装置と PC の再計算が一致（窓 3979、`prob` の差 1.61e-07、`positive`・`led` の
不一致 0）、ライブの `water` で人がマトリクスの波線 → 顔 → 波線を目で確かめ、Ctrl-C・Wi-Fi 切断（2 秒で消灯）・`kill -9` の後始末・`--no-rpc` の前の消灯が通った。1 ホップの `proc_ms` は
30 分で中央値 79.8・最大 86.1 ms（0040 の目安に当たらない）、電池は約 8%/時。数字は docs/log/2026-10-29.md「#47」。評価用 `meal` は 10/29〜11/1（0037 の追記 10/29。#48、`--feat --no-rpc`、
`docs/recording-protocol.md`）。コミット前の adversarial-review（3 回、収束せず人に渡した）の指摘で配るファイル（`detector.py`・`audio_in.py`・`features_np.py`）を直したので、
10/29 夜に配り直して照合した（`--selftest` OK、H 行の `code_sha256` `7b98bde5…` = PC、再生モードの一致は前回と同じ値。UNO Q の `core_pattern` は `core`、zram の書き戻し無し）。
ステップ B の 11.2・11.3 の数字は修正の前のコードで測った（修正はホップの処理に触れない）。配り直しの後に人が短いライブ（`water` 60 秒、RPC あり）で起動・受信・終了時の消灯を確かめた（10/29。proc_ms 中央値 80.5 ms）。
**人の作業（#47）:** 条件 4（受信の遅れ）の当て方と時計のずれの許す幅は**済み（10/29）**（人の決定: `delay_meas` の最大 > 1000 ms、`anchor_spread_ms`・`clock_drift_*_ms` の絶対値 > 250 で当たる。0037 の追記と `tools/unoq_session_check.py`。評価用の叩きはしないまま）。
10/29 の `water` のセッション 6 本を `data/raw/` から消す（人の決定 10/29: 残さない）。#47 の close。
**前（10/29、#47 の前）:** #44・#46・#51 は済み（人が close）。#45 は plan が承認され（10/24）、ステップ 1（コード・合成のテスト・予行）まで済み。学習用 `meal` は 5 本（10/25 会話あり、10/26 会話なし、10/27 会話あり 2 本、10/28 会話なし。すべて採用、docs/log/2026-10-25.md〜2026-10-28.md。収集日 4 日、`s` 合計 257。10/28 の 1 本は叩きの `Δ` 中央値 −72.3 ms で印つきのまま使う）。学習用の締めは 10/28 の終わり。#45 ステップ 2 の (1) は 10/28 夜に済み（0037 の `M4-TRAIN` と `fixed_eval.M4_EXPECTED_TRAIN` に 26 本 = M3 の 21 本＋`meal` 5 本。性能の数字は未見）。#45 ステップ 2 の (2) 本番 CV は 10/28 夜に済み（学習 81 回、2 時間 35 分。docs/log/2026-10-28.md、図は docs/log/2026-10-28-45/）、(3) の 0038 は 10/29 に人の決定で確定（採用: CNN `mfe40` 種 0・1・2 の平均、hard negative なし、ヒステリシス 入り 0.85・出 0.65 ＋ 不応期 0.5 秒、塊の上限なし = C4 × P2。規則が選んだのは P4（0.960 / 0.99 回/分）だったが、誤検出側の余裕と評価側が `meal` だけであることを理由に人が次点の P2（0.955 / 0.86 回/分、`meal` だけ 0.973 / 1.25）に変えた。0038 の決定 2 に理由と代償。`fixed_eval.M4_CONFIG` に同じ値。学習側 CV の数字は楽観側で、合格線の判定には使わない）。ステップ 3 の最終モデルも 10/29 に済み（`analysis/models/m4-0038.npz`、sha256 `c786086f…`、0038 の `M4-MODEL` と `fixed_eval.M4_MODEL` に同じ値。読み戻しの確率の差の最大 0・後処理の出力は完全に一致。docs/log/2026-10-29.md）。#45 は人が close した（10/29）。ランタイムの採否は 0040（人の決定 10/29）: 装置は numpy の im2col ＋ OpenBLAS（1 スレッド。`libopenblas0-pthread` を人が入れ直す）、LiteRT CPU は M5 へ、GPU は採らない。#47 で 1 ホップ全体を実測し、中央値 125 ms 超または最大 250 ms 超なら見直す。次は #47 の plan。
次は学習用 `meal` の締め（10/28）と採否の後のステップ 2（0037 の `M4-TRAIN`・`fixed_eval.M4_EXPECTED_TRAIN` の追記 → 本番の実行 → 0038）、ステップ 3（最終モデルと sha256）を 10/29〜10/30 に。#47 の plan は 0038 の後で、0038 と #47 の実装は 10/29〜10/31 に収める必要がある（評価用 `meal` が 11/1 から）。装置のランタイムの採否（候補: numpy im2col＋OpenBLAS / LiteRT CPU / ncnn CPU / ncnn Vulkan。材料は docs/log/2026-10-24.md「#51」）は 0038 の後に別の decision で決める（0039 決定 5。0038 が LR なら numpy のまま）。
**人の作業（#47 の前）:** 学習用 `meal` の記録と一覧の固定は 10/28 に済み（#48 の学習用。評価用 `meal` は 10/29〜11/1）。plan.md の M4 の日程（10/14〜11/7）と Milestone の日付、`device/` を edit-gate の対象に（#38 D8）。CLAUDE.md・AGENTS.md の文言（0035 D1b）は 10/29 に人の指示でメインが直した（再生モードの入力も入れた。#47 plan Q12）。Issue #44・#46・#51 は人が close した（10/24）。

| Issue | 内容 | 依存 |
|---|---|---|
| #44 | **済み（10/24）** UNO Q の Linux 側で推論を動かす土台と 1 窓の処理時間の計測。numpy だけの `features_np.py`、`bench_infer.py`。全体 45 ms（0.25 秒ホップ、RPC 込み）で 250 ms・100 ms に収まる（docs/log/2026-10-24.md「#44」、0035 追記） | なし |
| #45 | 誤検出を減らす検討（学習側だけ。候補: ヒステリシスの出、塊の上限、不応期 0.5 秒、種の平均、データ増強と hard negative。構成を 0038 で事前に固定） | #46 |
| #46 | **済み（10/24）** M4 の学習・評価の分割と記録の計画（0037 採用。評価側は装置の `meal` 3 本以上・2 収集日以上（11/1〜11/4）、学習は M3 の 21 本＋`meal` 3 本、FEAT は窓ごとの要約 82 次元、`record.py --throat --cond meal` は有線だけ） | なし |
| #47 | **実装・配置・動作確認まで済み（10/29）** 装置上の推論と表示（`detector.py`、`audio_in.py`、マトリクス、`record.py --unoq-detector`、標準入力のハートビート。音声の出口を作らない。再生モードで再計算が一致、ライブの消灯の確かめが通過、`proc_ms` 中央値 79.8 ms。close は人） | #44、#45 |
| #48 | **記録は済み（11/1）** 学習用 `meal` 5 本（10/25〜10/28）、評価用 `meal` 4 本（10/30・10/31×2・11/1。すべて採用）。0037 の `M4-TRAIN`・`M4-EVAL` と `fixed_eval` に固定済み。人が close（11/1） | #46、#47 |
| #49 | **済み・人が close（11/1。採点 1 回: 検出率 0.957 満たす、誤検出率 1.25 回/分 満たさない）** M4 の評価（評価側を 1 回だけ。M2・M3 と並べる。11/5 まで） | #45、#47、#48 |
| #50 | **判定済み・人が close（11/1、通過しない。0042。`review-M4` = `5601b59`）** M4 の判定（関門。人が閉じる。11/7 まで） | #49 |
| #51 | **済み（10/24）** UNO Q の推論ランタイムの比較（計測のみ。CNN 1 窓: numpy 27.7 ms、OpenBLAS 14.7、CPU のランタイム 1.3〜2.2、ncnn Vulkan 8.7〜9.7（CPU 時間 2.5）。全行 250/100 ms 未満。0039、docs/log/2026-10-24.md「#51」。計測用の導入は外した。残り: 採否の decision） | #44 |

マイルストーンなし（M0 は 9/22 にクローズ）

- #5 代替センサ（ロボセンサー技研）の入手性を問い合わせる（人、優先度最低）。

## 次にやること（M5 公開、11/2〜11/17。Issue #52〜#59）

| Issue | 中身 | 依存 | 目安 |
|---|---|---|---|
| #52 | **済み（11/3、0049。close は人）** MCU の自律消灯（最後の更新から 2 秒。0035 を改める decision。関門 #50 の指摘 2） | なし | 11/2〜11/4 |
| #53 | **済み（11/3、0050。close は人）** UNO Q での検出器の自動起動（単独モード、systemd のユーザーサービス、`record.py` との排他）。11/7 までに電源投入からの確かめが取れなければ M6 か応募後へ | #52 | 11/3〜11/7 |
| #54 | **decision 済み（11/3、0047。close は人）** 1 ホップ 0.1 秒の扱いの決定（人の決定: 0.25 秒のまま。decision だけ） | なし | 11/2〜11/4 |
| #55 | **decision 済み（11/3、0048。close は人）** `p1` の記録先の決定（人の決定 11/3: `self` と同じ扱い、暗号化ディスクの要件を外す。11/1 の (a) は取り消し。CLAUDE.md の該当行は人が書き換える） | なし | 11/2〜11/4 |
| #56 | **本文の下書き済み（11/4、`docs/protopedia/story.md`）** ProtoPedia の作品ページ（タイトル「在宅MealPace」、アカウント・枠・応募手順の確認済み（11/2）。構成は mfmf（9969）の 7 段。既存製品の位置づけと経緯を入れる。**公開は 11/14〜15 に変更（人の決定 11/9）**、11/17 まで更新。修正は PR #60） | #57、#54 | 11/2〜11/17 |
| #57 | **済み（11/13、人が動画の中身を確かめて close）** 動画 https://youtu.be/y1x6TrA4hLw 、アイキャッチ `docs/img/cover.png`、構成図 `docs/img/system-diagram.png`。素材はこの 3 つですべて（人の決定 11/13。装着写真と表示の文言の写真は用意しない）。動画の中身は人が確かめて問題なし（docs/log/2026-11-13.md） | #52、#53 | 11/5〜11/14 |
| #58 | **済み（11/13、人が close）** README の 3 点だけを直した（構成と使い方を UNO Q に、数字に混同行列とセッション 4 本と 0042 へのリンク、作品ページと動画へのリンク）。ほかは現状のまま（人の決定 11/13） | #54、#55 | 11/8〜11/15 |
| #59 | 【判定】M5 公開（人が閉じる。関門レビューの base は `review-M4`） | 全部 | 11/16〜11/17 |

人の作業（11/1 夜時点）: 応募手順（イベントページでの応募操作とタグ）と作品ページの枠の確認（11/5 まで、#56）。済み: plan.md と Milestone（メインが直した）、ProtoPedia のアカウント（人、11/1）、**作品タイトル「在宅MealPace」（人の決定 11/1）**。

## 保留中の判断

- M5 の後の改善候補（人の観察 11/1、0042 末尾）: 咽喉マイクに手で触れる・叩くと必ず誤認識する。接触・叩きの音を非嚥下の学習データ（hard negative）として集めて学習時に弾く。
  進め方は `touch` の条件別セッション → 学習側に足して CV → 新しい評価側の `meal` で 1 回だけ採点。M5 の後に Issue にする。
- 済み（11/3、#52）: MCU 側に、`loop()` が受信に気づいてから約 2 秒（2000 ms）次の受信が無ければ自律的に消灯する規則を足した（0042、関門レビューの指摘 2。0035 に追記）。docs/decisions/0049。
- 咽喉マイク SH-12JK は発注済み（10/2、0025）。人の作業: Qwiic の LSM6DSOX を先に手配しておく（音だけで M3 の分岐点の合格線に届かなければ M3 の中で IMU を足して再試験するため。0026）。手元に無く、人が手配する（10/3。使うのは音だけで届かなかった場合に限る）。NZ-210C の受信機を 3.5 mm の入力へつなぐ変換ケーブルは手配しない（10/8、構成 A は使わない）。圧電の再試行は配線の改良から（#35）。
- 済み（11/3、#55）: `p1` の記録先は `self` と同じく `data/raw/`。暗号化ディスクの要件は外す（人の決定 11/3）。docs/decisions/0048。CLAUDE.md の該当行は人が書き換える。
- 済み（10/3）: CLAUDE.md の実装方針・データの扱いの差し替え（人の依頼）、AGENTS.md の冒頭と不変条件 4・8、codex-review skill の観点 1・3、
  docs/workflow.md の例 2 行と参照先 1 行の直し（0025）。
  組み替えの plan の 7.1 の任意の 1 文は入れていない。無線リンクの境界は #42 で決める。
- 済み（10/10 夜）: NZ-W210C のノイズゲートは取説に切替なし。人の決定で構成 B を記録の経路から外し、有線で進む（docs/log/2026-10-10.md「人の決定（10/10 夜）」）。0025 への追記は #42。本人試用で無線が要るならゲートのない送信機を別に探す（人）。
- 済み（10/12、#42）: 無線化と CLAUDE.md「検出器は生の音声波形を保存も送信もしない」の関係は docs/decisions/0025 の追記（2026-10-12）で決めた（入力のリンクは装置の内側。受け取った後の禁止は変えない。無線を採る前の条件）。proposal.md 7 章の 1 文も入れた。CLAUDE.md・AGENTS.md の差し替えは、無線の入力を検出器で採るときに人が行う。
- 済み（11/3、#54）: 1 ホップは M5 では 0.25 秒のまま（人の決定 11/1）。docs/decisions/0047。0.1 秒は M6 以降で、0047 決定 3 の条件をそろえてから（人の意向 10/11 の出どころは docs/log/2026-10-11.md）。
