owhinata/zaitaku-mealpace/docs/protopedia/story.md

## 🍽️ 「ごっくん、できた？」

食事の介助をしているとき、気になることがあります。  
**「今の一口、ちゃんと飲み込めたのだろうか？」**  
口に食べ物を運び、飲み込むのを待つ。  

でも、口の動きが止まったからといって、飲み込めたとは限りません。  
喉の動きを見ていても、よく分からないことがあります。  

次の一口を運ぶタイミングは、介助者が本人の様子を見ながら考えています。  
病院では、嚥下内視鏡検査（VE）などで飲み込みの状態を詳しく調べることができます。  
しかし、それは検査を受けたときの状態です。  

家での食事は毎日のこと。  
体調も、姿勢も、食べるペースも、毎回同じではありません。  

**専門職が見ていない日々の食卓で、飲み込みのタイミングを知る手がかりを作れないだろうか。**  
そんな思いから「在宅MealPace」の開発を始めました。  

## 💡 飲み込んだ「目安」を光で伝える

在宅MealPaceは、喉元に装着した小さなマイクから音を取り込み、AIで飲み込みのタイミングを推定する装置です。  
結果はLEDで介助者に伝えます。  

- **波線の表示：** 装置が動作している
- **顔の表示：** 飲み込みを検出した目安
- **消灯：** 装置が動作していない

介助者が食事中に、手元の表示で飲み込みの目安を確かめられるようにします。  
ただし、この装置で分かるのは、音から推定した飲み込みのタイミングです。  

食べ物が安全に飲み込めたかどうかは分かりません。  
食べ物が気道に入ったかどうかも分かりません。  

LEDは、次の一口を出してよいという合図ではありません。  
**介助者が本人の様子を確かめるための、もう一つの手がかり。**  
それが、在宅MealPaceの役割です。  

## 👀 介助者が、その場で確かめられること

目指したのは、複雑な操作を必要としない装置です。  
食事のたびにPCを操作したり、画面のグラフを読み取ったりするのではなく、飲み込みを検出したときに光で知らせる。  
介助者は、その表示と本人の様子を合わせて確認できます。  
そのために、装置は次のことを重視しました。  

- 食事中に使えること
- できるだけ操作を増やさないこと
- 飲み込みの目安をその場で返すこと
- 食卓の会話を録音・保存しないこと

現段階では、開発者自身の食事で装置の動作を確かめています。  
実際の介護を受ける人が使用した場合の有効性や使いやすさは、まだ確かめられていません。  

## 🛠️ どうやって作ったのか

### 🔬 最初は、Arduinoのセンサだけで試した

開発当初は、Arduino Nano RP2040 Connectに搭載されているマイクと加速度・角速度センサ（IMU）を使っていました。  
音と動きから特徴量を取り出し、機械学習で飲み込みを識別する方法です。  
しかし、実際の食事で評価すると、飲み込みの検出率は **0.150** でした。  
この構成では、必要な情報を十分に捉えられていないと考えました。  

次に、喉元の振動を捉える圧電コンタクトマイクも試しましたが、試作した構成では利用できる信号を得られませんでした。  

そこで、喉元の音を拾う咽喉マイクを使うことにしました。  
失敗した試作も含めて、この経緯を残しています。  

### 🎤 咽喉マイクとArduino UNO Q

現在の構成は次のとおりです。

**咽喉マイク → USBオーディオアダプタ → Arduino UNO Q → LED**

咽喉マイクにはSH-12JKを使用しています。  
Arduino UNO QのLinux側で音声を取り込み、特徴量を計算します。  
その特徴量をCNN（畳み込みニューラルネットワーク）で処理し、飲み込みらしい音があったかを推定します。  
推定結果を後処理したあと、UNO QのMCU側へ伝え、LEDに表示します。  

Linux側とMCU側を分担させることで、AIによる推論と表示制御を一つの装置で行っています。

### 🔒 食卓の音を残さないために

マイクを使う以上、プライバシーも重要です。  
装置の検出プログラムでは、生の音声をメモリ上で特徴量に変換し、処理後に破棄します。  
音声波形をファイルに保存したり、外部へ送信したりしない設計です。  
なお、モデルの学習に必要な音声を収集するための開発用記録システムは別に用意しています。  

### ⚖️ 動いた。でも、まだ十分ではなかった

ここが、この作品で最も伝えたいところです。  
咽喉マイクを使った構成では、Arduino UNO Q上で飲み込みの検出とLED表示を動かせました。  
では、実際の食事でどのくらい正しく検出できるのでしょうか。  

開発者自身の食事を使って評価しました。

### 📊 評価結果

| 評価項目 | 結果 | 目標 | 比較 |
|---|---:|---:|---|
| 検出率 | 0.957 | 0.85以上 | 満たす |
| 誤検出率 | 1.25回/分 | 1.00回/分以下 | 満たさない |

混同行列の主要な集計値は次のとおりです。

| 項目 | 件数 |
|---|---:|
| TP：正しく検出した飲み込み | 199 |
| FN：見逃した飲み込み | 9 |
| FP：誤って検出したもの | 70 |

※評価には、事前に分離した評価用セッション4本を使用しました。学習結果を見たあとで評価データに合わせた調整を行わないよう、評価側の採点は1回だけとしました。

**飲み込みを検出する性能は目標を満たしましたが、誤検出率は目標を満たしませんでした。**

食卓では会話や食器の音、マイクへの接触など、飲み込み以外の音も発生します。  
そうした音を十分に区別できないことが、今後解決すべき課題です。  

### 🔁 最初の構成から何が変わったのか

| 項目 | 基板搭載センサ（M2） | 咽喉マイク（M4） |
|---|---:|---:|
| 検出率 | 0.150 | 0.957 |
| 誤検出率 | 2.03回/分 | 1.25回/分 |

センサと処理方式を見直した結果、検出率と誤検出率の両方に改善が見られました。  
ただし、M2とM4ではセンサ・モデル・評価用の食事データが異なるため、この比較だけから改善の原因を一つに特定することはできません。  

### 🎬 今回の動画で見せること

開発者自身が装置を装着し、水や食事を飲み込んだ際に、LEDがどのように変化するかを紹介します。  
動画は、実際に装置が動くことを示すためのものです。  
動画だけで検出性能や介護現場での有効性を証明するものではありません。  

### ❓ まだ確かめていないこと

現時点では、次のことは未検証です。

- 実際に介護を受ける人による試用
- 食事中の姿勢と飲み込みの同時記録
- マイクの接触・叩きなどによる誤検出への十分な対策
- 音声の取り込み経路の違いによる影響
- 介助者が日常的に使った場合の負担や有用性

できたことと、できていないことを分けて公開することも、この開発の大切な部分だと考えています。

## 🏠 目指しているのは、いつもの食卓で使える道具

飲み込みの状態を詳しく調べるには、専門職による評価が必要です。  
その一方で、家庭では検査と検査の間にも毎日の食事があります。  
在宅MealPaceが目指すのは、専門職の検査に代わることではありません。  

**専門職が見ていない日々の食卓で、飲み込みを観察する手がかりを増やすことです。**

既存の取り組みには、嚥下を計測するGOKURIや、訓練を支援するB4Sなどがあります。  
在宅MealPaceでは、家庭の毎食で使い、介助者にその場で飲み込みの目安を返すことに重点を置きました。  
※既存製品との比較は公開情報に基づくものであり、調査日と参照元を公開時に追記します。

将来的には、飲み込みの記録と姿勢の変化を同時に捉えることも考えています。  

ただし、まず必要なのは、飲み込み以外の音による誤検出を減らすことです。  
マイクへの接触音や叩いた音などを学習データに加え、食卓でより安定して使える検出器へ改善していきます。  
そのうえで、本人の同意を得た試用を通じて、実際の介護場面で使えるかを確かめたいと考えています。  

## ✨ 小さな光が、介助の手がかりになる未来へ

「ごっくん、できた？」

その答えを、この装置だけで確実に知ることはできません。

でも、これまで目で見るしかなかった飲み込みのタイミングに、別の手がかりを加えることはできるかもしれません。  
Arduinoと小さなマイク、そしてAI。  
特別な検査室ではなく、いつもの食卓で使える道具を目指しています。  

**在宅MealPaceは、まだ開発途中です。**

今回の評価では、目標に届かなかった項目もあります。  
その結果を隠さずに公開し、一つずつ改善を重ねていきます。  
食事をする人にも、介助する人にも、少しでも安心して向き合える時間を増やせるように。  

## 📦 開発とデモについて

### 🧰 使用技術・機材

- Arduino UNO Q（Linux側でAI推論、MCU側でLED制御）
- SH-12JK 咽喉マイク
- USBオーディオアダプタ
- Python / NumPy / CNN
- Edge Impulse（初期試作のM2で使用）
- GitHub（開発記録、設計判断、評価結果の管理）

設計・実装・文章の整理には、AIコーディングエージェントやCodexも活用しています。  
ただし、評価基準、使用データ、構成の変更、公開内容については人が確認・決定する形で進めています。  
評価に使用したデータは開発者自身のものです。今回のデモや評価には家族のデータを使用していません。  

### 💻 ソースコード・開発記録

https://github.com/owhinata/zaitaku-mealpace

### ▶️ デモ動画

［Issue #57で作成した動画のURLを挿入］

### 📁 評価資料

［評価用4セッションの一覧、混同行列の図、誤検出の分類図を挿入］
