owhinata/zaitaku-mealpace/docs/log/2026-11-03.md

# 2026-11-03

## #52 MCU の自律消灯（docs/decisions/0049）

plan #52（PLAN-SHA `93a3cc05c81d9aad`、Codex の plan レビュー 3 回・BLOCKING なし、人が 11/3 に承認。指摘と裏取りは Issue #52 のコメント）。
MCU は `loop()` が `zm_set_state` の受信に気づいてから約 2 秒（2000 ms）次の受信が無ければ自分で消灯する。Linux 側（`detector.py`）は変えていない（窓ごとに送る）。

### ステップ A（エージェント、PC だけ）

- `firmware/unoq_mcu/`: `rx_hold.h/.cpp`（Arduino 非依存、`UNOQ_RX_OFF_MS = 2000`）、`led_out.cpp`（受信の数の `std::atomic<uint32_t>`、`static_assert(std::atomic<uint32_t>::is_always_lock_free)`）、
  コメントと README の直し、ホストテストを 8 件足した（`test_8`〜`test_15`）。
- `device/unoq/led_check.py` の文言だけを直した（送る値は同じ）。`device/unoq/test_detector.py` に `test_r11_same_state_resent_every_window`（合成の入力だけ）、
  `device/unoq/test_mcu_rpc.py` の Arduino 非依存の検査に `rx_hold` を足した。`detector.py`・`DEPLOY_FILES` は変えていない。
- テストとビルドの結果: 下の「テスト」。実機と `data/raw/` には触れていない。

### `code_sha256` と「評価の期間中は変えない」

- `led_check.py` は配るファイルなので、H 行の `code_sha256` が評価用 `meal` 4 本の値（`7b98bde5…`、10/29 夜の配布）から変わる。`record.py --unoq-detector` は H 行と手元の
  `DEPLOY_FILES` の値を比べるので、次の記録の前に `deploy-unoq` で配り直す。
- 0037 の 5「途中で装置の構成やプログラムを書き換えたら、それより前の評価用 `meal` は M4 の数字に使わない」・0041 の採点の手順の期間は、評価用 `meal` の打ち切り（11/1 の終わり）、
  評価側の 1 回だけの採点（11/1、印 `docs/log/m4-final-49.txt`）と関門の判定（0042、11/1）で終わっている。M4 の評価側は再採点しない（0041 決定 6。`analysis/m4_final_eval.py` は印があるので
  実行の前に止まる）。`code_sha256` の変化と MCU のスケッチの書き換えは M4 の数字に影響しない。

### ステップ B（人が行う。結果を下の雛形に書く）

準備（UNO Q の USB-C を PC に直挿し）:

```
ssh arduino@unoq.local 'python3 -B ~/zaitaku-mealpace-device/led_check.py bench --n 100 --warmup 5'   # 書き込み前
cmake --build build-unoq --target build && cmake --build build-unoq --target upload                     # 書き込み（remoteocd）
cmake --build build-unoq --target deploy-unoq                                                            # 配り直し
ssh arduino@unoq.local 'ls -A ~/zaitaku-mealpace-device/'                                                # 一覧と一致、__pycache__ 無し
ssh arduino@unoq.local 'cd ~/zaitaku-mealpace-device && env OPENBLAS_NUM_THREADS=1 OMP_NUM_THREADS=1 MKL_NUM_THREADS=1 python3 -B detector.py --selftest --expect-config "set=mfe40 classifier=cnn seeds=0,1,2 hard_negative=none post=hyst threshold=- enter=0.85 exit=0.65 cap_s=none refractory_s=0.5" --expect-sha256 c786086f069c55c55b27eea860963c3c950c04b728fe65d52bc35a7a4a806d90'
ssh arduino@unoq.local 'python3 -B ~/zaitaku-mealpace-device/led_check.py bench --n 100 --warmup 5'   # 書き込み後
```

(0)・(1) で確かめるのは、操作（`led_check.py` の実行、`kill -9`）から消灯までの全体の時間（人の目視。ストップウォッチ可）。受信から `loop()` が気づくまでの遅れは切り分けない。

- (0) MCU だけ: `ssh arduino@unoq.local 'python3 -B ~/zaitaku-mealpace-device/led_check.py smile'`（`wave`・`off` も）→ 約 2 秒で消える（`off` は消えたまま）。
- (1) 検出器の `kill -9`（直接起動。`record.py` の後始末の `led_check.py off` が混ざらないように）: PC の端末で
  `while true; do echo; sleep 0.5; done | ssh arduino@unoq.local 'cd ~/zaitaku-mealpace-device && exec env OPENBLAS_NUM_THREADS=1 OMP_NUM_THREADS=1 MKL_NUM_THREADS=1 python3 -u -B detector.py --live --expect-config "<上と同じ>" --expect-sha256 <上と同じ>' > /dev/null`
  （改行を 0.5 秒ごとに送ってハートビートの代わりにする。標準出力は捨てる。記録ではないので `data/raw/` に何も書かない）。嚥下して顔が出た間（打てなければ波線の間）に、
  別の端末で `ssh arduino@unoq.local 'pkill -9 -f detector.py'` → 約 2 秒で消える。続けて `record.py --unoq-detector` の経路でも 1 回 `kill -9` し、消えるまでの様子を書く。
- (2) router の停止: `.venv/bin/python tools/record.py --unoq-detector --position lateral-below-cricoid --band sh12jk-strap --cond water`（RPC あり）。波線・顔が出ている間に
  UNO Q で `sudo systemctl stop arduino-router` → 約 2 秒で消える。`record.py` は窓ごとの行を表示せず、窓が届き始めた時・1 秒以上届かない時（「窓の行が N 秒届いていない」）・
  届き直した時だけを表示する。止めている間は、`record.py` が動き続けていて「窓の行が N 秒届いていない」が出ないことを確かめる（言えるのは「1 秒以上の途切れは表示されなかった」まで）。
  `sudo systemctl start arduino-router` で戻し、表示が戻るかを見る。その後に Ctrl-C で止め、終わりの集計の「RPC の失敗」の数を控える。router を止めている間に Ctrl-C しない。
- (3) 通常の動作: `.venv/bin/python tools/record.py --unoq-detector --position lateral-below-cricoid --band sh12jk-strap --cond water --duration 180`（RPC あり）。波線・顔が 2 秒ごとに途切れないことを目で見る。
  終わりの集計の `proc_ms`（中央値・95 パーセンタイル・最大）と「RPC の失敗」を控える。
- (4) `--no-rpc` の起動直後の消灯: `.venv/bin/python tools/record.py --unoq-detector --no-rpc --position lateral-below-cricoid --band sh12jk-strap --cond water --duration 60`。
  先に消灯が送られ、マトリクスが消えていることを確かめて Enter。記録の間ずっと消灯のまま。
- 終わりに UNO Q の読み取りの確かめ（docs/unoq-setup.md「確かめ方（読み取り）」）: 新しいファイル 0 件、音声の拡張子 0 件、`__pycache__` 無し。
- (1)・(2)・(3)・(4) で `data/raw/` にできた `water` のセッションは動作の確かめ用で、M4・M5 の数字に使わない。残すか消すかは人が決める。中身（`prob`・`positive`・`led` の列）は log に出さない。

### 結果（ステップ B。人が行い、メインが控えたものを写した。数字は計算し直していない）

- 書き込み: 2026-11-03 09:48 JST ごろ、USB-C を PC に直挿し（adb 越しの remoteocd）、スケッチ 90,348 B、コア `arduino:zephyr@1.0.0`・`Arduino_RouterBridge@0.4.3`。
  1 回目は UGREEN アダプタ（PD 給電 + USB オーディオ）が UNO Q の USB-C を占めていて adb に見えず失敗した。アダプタを外して PC に直挿しすると `lsusb` に `2341:0078` が出て
  `/dev/ttyACM0` と adb に現れ、書き込みが通った。書き込みの後にアダプタを戻した。
- 配り直し（`deploy-unoq`）: 09:4x JST。一覧 14 個と一致、`__pycache__` 無し。`code_sha256` は `88af2198…`（評価用 `meal` 4 本の H 行は `7b98bde5…`）。
  `--selftest` OK（参照との差の最大 2.04e-08、im2col 7.39e-09、重みの sha256 一致、構成一致）。
- 往復（`led_check.py bench --n 100 --warmup 5`）: 書き込み前 中央値 / 95% / 最大 = 5.295 / 5.418 / 5.486 ms、書き込み後 = 5.292 / 5.418 / 5.467 ms。
- (0) smile → 約 2 秒で消えた / wave → 約 2 秒で消えた / off → 消えたまま（人の目視。2 回送って 2 回目で確かめた）。**通過。**
- (1a) 直接起動で `kill -9`（09:54:35、波線の間）→ 約 2 秒で消えた（人の目視）。**通過。**
- (1b) `record.py --unoq-detector` の経路（`20261103-095644_self_water`、`--duration 120`）で `kill -9`（09:57:02）→ 約 2 秒で消えた（人の目視）。**通過。**
  `record.py` の集計: 止まり方 `child-exit`（終了コード 255。ssh の終了コードで、遠隔が SIGKILL）、窓 74、取りこぼし 0、行の途切れ 0 回、`proc_ms` 中央値 81.0・95% 82.7・最大 85.0 ms
  （RPC あり）、RPC の失敗 `None`（E 行が来ないため）。
- (2) `record.py --unoq-detector` の経路（`20261103-095812_self_water`）で `arduino-router` を停止（人、`sudo`）→ マトリクスは**停止と同時に（即）消えた**（人の目視。約 2 秒ではなく即）。
  約 2 秒より早い理由は、router の停止が MCU 側の接続を切る経路と見られる（推測。確かめていない）。止めている間、`record.py` は動き続け、「窓の行が N 秒届いていない」は出なかった
  （1 秒以上の途切れは表示されなかった）。`start` の後: 波線が戻った（人の目視。つなぎ直しは 1 秒ごと）。**通過。**
  Ctrl-C の後の集計: 窓 404、止まり方 `interrupt`（検出器 `eof`）、overrun 0、RPC の失敗 37、行の途切れ 0 回、`proc_ms` 中央値 73.1・95% 81.7・最大 85.3 ms。
- (3) `water` 180 秒（`20261103-101054_self_water`、RPC あり）: 窓 721、取りこぼし 0、止まり方 `duration`、overrun 0、RPC の失敗 0、行の途切れ 0 回。
  `proc_ms` 中央値 79.0・95% 82.0・最大 95.5 ms（#47: 79.8 / 81.4 / 86.1（30 分）、79.9 / 82.8 / 106.2（180 秒））。波線・顔の途切れ: なし（2 秒ごとの途切れは無く、飲み込んだときに顔が出た。
  人の目視）。**通過。**
- (4) `--no-rpc` 60 秒（`20261103-101428_self_water`）: 記録の前の消灯を確かめて Enter → 記録の間ずっと消灯のまま（人の目視）。**通過。** 窓 241、`proc_ms` 中央値 63.8・95% 66.9・最大 78.9 ms（RPC なし）。
- UNO Q の読み取り（10:2x JST、メインが ssh で読むだけ）: 09:40 以降の新しい普通のファイル 0 件（`~`・`/tmp`・`/var/tmp`、`-xdev`）、音声の拡張子（wav/raw/pcm/flac/ogg/mp3）0 件、
  `~/zaitaku-mealpace-device` に `__pycache__` 無し、`/var/lib/systemd/coredump` は空、配布ファイル 14 個。
- 確かめ用の `water` セッション 4 本（`20261103-095644`・`095812`・`101054`・`101428`、いずれも `self`）: M4・M5 の数字に使わない。人の決定（11/3）で消した（メインが `rm`）。
- 補足: (1a)・(1b) の `kill -9` は、1 回目に `pkill -9 -f detector.py` が ssh 側の自分のシェルにも当たり、ssh が 255 で終わった（検出器は消えていた。`pgrep` で確かめた）。
  (1b) は `pkill -9 -x python3` で行った。

`proc_ms` と往復は合否を付けない（上の値を並べるだけ）。

### コミット前の adversarial-review（11/3）

- 指摘 2 件（README の数字は #58 へ、一周の再点灯は採って直した）。直した版の書き込みは下。
- 直したこと: `rx_hold_shown` は時間切れになったら `has_rx` を下ろし、次の受信に気づくまで消灯を保つ（受信が無いまま約 49.7 日たって `millis()` の差が一周しても再点灯しない）。
  ホストテストを 1 件足した（`test_16`）。0049 の決定 1 に 1 文を足した。上の (0)〜(4) は直す前の版で確かめた。
- 直した版の書き込み: 2026-11-03 10:43 JST、スケッチ 90,348 B（前と同じ大きさ）。USB の直挿しをせず、**ssh 経由で書いた**: remoteocd が adb で運ぶ 3 つのファイル
  （vendor の `flash_sketch.cfg`、`zephyr-arduino_uno_q_stm32u585xx.elf`、`unoq_mcu.ino.elf-zsk.bin`。sha256 を PC と照合）を scp で `/tmp/remoteocd/` に置き、基板上の
  `/opt/openocd/bin/openocd -s /opt/openocd -f /opt/openocd/openocd_gpiod.cfg -c "set filename0 …elf" -c "set filename1 …bin" -f /tmp/remoteocd/flash_sketch.cfg` を
  `arduino`（gpiod グループ）で実行（`-s` が無いと `stm32u5x.cfg` が見つからず init の前で止まる）。出力は adb 経由と同じ（verify → write、`shutdown command invoked`）。
  書いた後に `/tmp/remoteocd` を消した。remoteocd 自身の ssh モード（`-a`）はパスワード認証だけで鍵では入れない。
  確かめ: 往復 bench 中央値 5.383 / 95% 5.524 / 最大 5.660 ms。(0) smile → 約 2 秒で消えた / wave → 約 2 秒で消えた / off → 消えたまま（人の目視。2 回送って 2 回目で確認）。通過。
  (1)〜(4) はやり直していない（通常の動作は変わらない。変わるのは受信が無いまま約 49.7 日たった後だけ）。

### テスト（ステップ A）

- `bash firmware/unoq_mcu/host/test_unoq_mcu.sh`: 3653 passed, 0 failed（足した 8 件を含む）。
- `.venv/bin/python -m unittest discover -s device/unoq`: 59 件 OK（`test_r11` を含む）。
- `bash firmware/detector/host/test_detector.sh`: 309 passed, 0 failed。`bash firmware/indicator/host/test_indicator.sh`: 837 passed, 0 failed（共有の `led_rule.h` は変えていない）。
- `cmake --build build-unoq --target build`: 通った（スケッチ 90,348 B）。

## #53 UNO Q での検出器の自動起動（単独モード、docs/decisions/0050）

plan #53（PLAN-SHA `8d08124527bcf3e6`、Codex の plan レビュー 4 回。1・2 回目の BLOCKING（排他の確かめと起動の隙間、ロックのパスが ssh のユーザーで変わる）は直した。
人が 11/3 に承認。指摘と裏取りは Issue #53 のコメント）。

### ステップ A（エージェント、PC だけ）

- `device/unoq/detector.py`: `--live --standalone`（`--feat`・`--no-rpc`・`--replay`・`--selftest` とは併用しない）。単独モードは `NullOutput`（行を捨てる）、標準入力を `select` に入れず
  ハートビートを作らない。標準エラーに始めの `code_sha256` の先頭 12 桁と、終わりの `windows`・`rpc_errors`・`overrun_lines` を 1 行ずつ。`record.py` から起動したときの振る舞いは変えていない。
- `device/unoq/zaitaku-detector.service`（新規）と DEPLOY_FILES に 1 行（15 個）。ユニットは `flock -n -F -E 75 /home/arduino` の下で `detector.py --live --standalone` を起動する。
- `tools/record.py`: UNO Q の上の子（`arecord`・`pw-record`・`detector.py`）を `exec flock -n -F -E 75 /home/arduino` の下で起動する（`UNOQ_LOCK_DIR`）。起動前に
  `systemctl --user is-active zaitaku-detector.service` を読み、`inactive`・`failed` 以外なら始めない（`--unoq-detector` と UNO Q を通す `--throat`）。子が最初のバイト・H 行の前に 75 で
  終わったらロックの文で止める（フォルダを作らない）。
- 文書: 0050（新規。「確かめたこと」は空欄）、0025・0035・0037 の末尾に追記、`docs/unoq-setup.md`（常駐の記述、配る一覧、止め方、「自動起動」の節）。
- テスト: 下の「テスト（ステップ A）」。実機と `data/raw/` には触れていない。

### `code_sha256`

- `detector.py`・`audio_in.py` が変わったので、H 行の `code_sha256` は #52 の配布の `88af2198…` から `1fd5b820…` に変わる（`.service` は数えない。`audio_in.py` はコミット前の adversarial-review の指摘 3 件で、ロックの fd を `arecord` に渡すこと、
`/proc/self/fd` を読めなければ入力を開かないこと、受け継いだ fd の `fstat` が `EBADF` 以外で失敗したら入力を開かないこと（fail-closed）を直した）。次の記録・自動起動の前に `deploy-unoq` で配り直す。
- 0037 の 5・0041 の期間は 11/1 に終わっている（#52 の節と同じ）。評価用 `meal` 4 本の H 行は `7b98bde5…`。M4 の数字に影響しない。

### ステップ B（人が行う。結果を下の雛形に書く）

非対話の ssh から `systemctl --user` を打つとき、効かなければ `XDG_RUNTIME_DIR=/run/user/$(id -u)` を前に付ける（docs/unoq-setup.md「自動起動」）。

- **(0) `flock` の確かめ（最初に行う）**:

  ```
  ssh arduino@unoq.local 'flock --version; flock --help | grep -e --no-fork; ls -ld /home/arduino'
  ssh arduino@unoq.local 'flock -n -F -E 75 /home/arduino true; echo $?'                  # 0
  ssh arduino@unoq.local 'flock -n -F -E 75 /home/arduino sleep 30'                        # 端末 1（持つ）
  ssh arduino@unoq.local 'flock -n -F -E 75 /home/arduino true; echo $?'                  # 端末 2: 75
  ```

  `--no-fork`（`-F`）が無ければ**ここで止め、ユニットを有効にせず、plan を直す**（人の決定 11/3）。
- **準備**: #52 のスケッチ（0049）が入っていること（済み、11/3）。`cmake --build build-unoq --target deploy-unoq` → `ls -A ~/zaitaku-mealpace-device/` が 15 個 → `--selftest` OK
  （docs/unoq-setup.md「検出器」）→ `ssh arduino@unoq.local 'systemd-run --user --wait -P id'`（`arduino-router`・`audio` があること）→
  `systemctl --user link ~/zaitaku-mealpace-device/zaitaku-detector.service` → `systemctl --user enable zaitaku-detector` → 時刻を控える（`date -u`）。
- **(1) 電源投入**: 電源を切り、USB オーディオアダプタと咽喉マイクを挿したまま入れる。PC から ssh しない。波線が出るまでの秒数（目視）。後で
  `journalctl --user -u zaitaku-detector -b` で再起動が何回あったか。
- **(2) 飲み込む → 顔**: 咽喉マイクを着けて水を飲み込む → 微笑む顔（目安）。数回。
- **(3a) 直接起動で `kill -9`（消灯）**: `systemctl --user stop zaitaku-detector` の後、PC の端末で

  ```
  while true; do echo; sleep 0.5; done | ssh arduino@unoq.local 'cd ~/zaitaku-mealpace-device && exec flock -n -F -E 75 /home/arduino env OPENBLAS_NUM_THREADS=1 OMP_NUM_THREADS=1 MKL_NUM_THREADS=1 python3 -u -B detector.py --live --expect-config "set=mfe40 classifier=cnn seeds=0,1,2 hard_negative=none post=hyst threshold=- enter=0.85 exit=0.65 cap_s=none refractory_s=0.5" --expect-sha256 c786086f069c55c55b27eea860963c3c950c04b728fe65d52bc35a7a4a806d90' > /dev/null
  ```

  （標準出力は捨てる。記録ではないので `data/raw/` に何も書かない）。顔か波線の間に、別の端末で `ssh arduino@unoq.local 'pgrep -a -x python3'`（この検出器だけのこと）→
  `ssh arduino@unoq.local 'pkill -9 -x python3'` → 約 2 秒で消えて、消えたまま（再起動が無い）。
- **(3b) ユニットで `kill -9`（戻り）**: `systemctl --user start zaitaku-detector` の後、顔か波線の間に
  `ssh arduino@unoq.local 'systemctl --user kill --kill-whom=main --signal=SIGKILL zaitaku-detector'` → 消える → 約 2 秒＋起動の時間の後に波線が戻る。消えていた間が見えたか、戻るまでの秒数、
  `systemctl --user show -p NRestarts,ExecMainStatus,ExecMainCode zaitaku-detector`。
- **(4) `stop`** → すぐ消える、`inactive`、再起動しない。`start` で戻る。
- **(5) 電源を切る** → 消える。
- **(6) アダプタ未接続**: アダプタを抜いて `start`（または電源投入）→ 0 以外で終わって 2 秒ごとに起動し直し、120 秒に 10 回を超えて `failed`。**終了コードの実測値を書く**
  （`systemctl --user show -p ExecMainStatus zaitaku-detector` と `journalctl` の `detector: ` の文。読みでは 1 の見込み）。その間マトリクスは消えたまま（推測。目で見る）。
  挿して `reset-failed` → `start` で戻る。
- **(7) 排他**: ユニットが動いている間に `record.py --unoq-detector --cond water` → 「自動起動の検出器…が動いています」で始めない、`data/raw/` にフォルダができない。
  `record.py --throat sh12jk-wired-unoq-usbaudio --cond quiet` → 始めない。`stop` の後に `record.py --unoq-detector --cond water` が始まる（10 秒で `q`。動作の確かめ用で数字に使わない。残すか消すかは人）。
  逆向き: `record.py --throat …` で記録している間に `systemctl --user start` → 75 で終わり、再起動しない（`failed`、`ExecMainStatus=75`）。
  ロックを手で持つ: UNO Q で `flock -n -F -E 75 /home/arduino sleep 30` の間に `record.py --throat …` → 「ロックを持っています」で始めない。
  `kill -9` の直後（`activating` の 2 秒の間）に `record.py --unoq-detector` → 始めない。
- **(8) 読み取り**:
  - 普通のファイル: `find ~ /tmp /var/tmp -xdev -type f -newermt "<時刻>"` が 0 件。音声の拡張子の `find`（docs/unoq-setup.md）が 0 件、`__pycache__` 無し、`ls /var/lib/systemd/coredump/ /var/crash/` が空。
  - リンク: 時刻に頼らず `find ~ -xdev -type l` で全部出す。ユニットの 2 つのリンクの先が `~/zaitaku-mealpace-device/zaitaku-detector.service` か `~/.config/systemd/user/zaitaku-detector.service` の
    どちらかで、ほかに知らないリンクが無いこと。
  - journald: `journalctl --user -u zaitaku-detector -b --no-pager -o cat` の全行で、まず D/T/F/H/E の形の行が 0 であることを確かめる。そのうえで「`detector: ` の行」
    「systemd の既知の行」「どちらでもない行」の 3 つに分けて数え、3 つ目が 1 行でもあれば中身の種類を調べる。中身は貼らず、数と文の種類だけを書く。journald の置き場所（`ls /var/log/journal`）。
  - 動画を撮るならマトリクスだけを写し、人を含めない。

### 結果（ステップ B。人が行い、メインが控えたものを写した。数字は計算し直していない）

- **(0) flock**: util-linux 2.41.5、`-F`（`--no-fork`）あり。`/home/arduino` はディレクトリ。`flock -n -F -E 75 /home/arduino true` → 0、別のプロセスが持っている間 → 75。通過。
- **前提**: user manager のグループに `arduino-router` と `audio` あり（`systemd-run --user --wait --pipe id`）。`sound.target` は user manager にある（loaded inactive dead）。journald は永続（`/var/log/journal` あり）。
- **配り直し**（`deploy-unoq`、11:3x JST、#52 と別）: 15 個（`zaitaku-detector.service` を含む）、`__pycache__` 無し。`--selftest` OK。`code_sha256` `1fd5b820…`（journal の始めの文の先頭 12 桁 `1fd5b820f452`。
  評価用 `meal` 4 本の H 行は `7b98bde5…`）。0037 の 5・0041 の期間は 11/1 に終わっている。
- **時刻の控え**: 2026-11-03 02:41:41 UTC（11:41 JST）。
- **link・enable**: `~/.config/systemd/user/zaitaku-detector.service` と `default.target.wants/zaitaku-detector.service` の 2 つのリンク（どちらも `~/zaitaku-mealpace-device/zaitaku-detector.service` を指す）。enable 済み。
- **start**（11:41 JST）: active、MainPID は python3（`flock -F` で本体が python3）、NRestarts 0。journal: Started の行と `detector: ` の文 5 行（照合 OK ×2、重みの sha256 一致、構成一致、
  単独モードで始める（`code_sha256` 先頭 12 桁））。窓の行なし。
- **(1) 電源投入**（boot 12:17 JST。PC から ssh せず）→ 波線まで約 40 秒（人の目視）。journal: 起動の失敗 2 回（どちらも「RPC を開けない（始めない）: McuRpcError: zm_set_state の誤り:
  method zm_set_state not available」= MCU の RPC がまだ揃っていない → 終了コード 1 → 2 秒後に再起動）、3 回目で動いた。NRestarts 2。D/T/F/H/E の形の行 0。
  `detector: ` の文は照合 OK ×2・重みの sha256・構成・単独モードで始める・RPC を開けない ×2・終わり（error）windows=0 ×2。systemd の行は Started ×3、Main process exited ×2、Failed ×2、
  Consumed ×2、Scheduled restart ×2。通過（起動の順は `Restart` が受け持つ設計どおり）。
- **(2) 飲み込む → 顔**: 出た（人の目視、数回）。通過。
- **(3a) 直接起動で `kill -9`**: `systemctl --user stop` → inactive、python3 なし（12:2x JST）。flock の下で直接起動した検出器に 12:20:13 に `kill -9` → 約 2 秒で消え、消えたまま（人の目視）。
  `kill` の 1.5 秒後にはロックも外れていた（`flock … true` → 0）。通過。
- **(3b) ユニットで `kill -9`**: 12:21:48 に本体へ SIGKILL（`systemctl --user kill --kill-whom=main`）→ 波線が消え、2〜3 秒で波線が戻った（人の目視。消えた間は見えた）。NRestarts 1、
  ExecMainStatus 0（再起動後）。journal は文だけ。通過。
- **(4) stop・start**: 12:22:18 に stop → inactive、python3 なし、再起動なし。journal「終わり（signal）windows=102 rpc_errors=0 overrun_lines=0」（数だけ）。12:22:32 に start → active。
  やり直し（12:32:16 stop → 12:32:25 start）で人が目視: stop で消え、start で波線が戻った。通過。
- **(5) 電源断** → マトリクスが消えた（人の目視）。通過。
- **(6) アダプタ未接続**（UGREEN のアダプタを外し、PC の USB-C から給電して電源投入。boot 12:33 JST）: マトリクスは消えたまま（人の目視、一瞬も出ない）。ユニットは失敗を繰り返し、
  起動から約 2 分の時点で failed（Result exit-code、NRestarts 10、「Start request repeated too quickly」= `StartLimitBurst` 10／120 秒）。**終了コードの実測値 1**（ExecMainStatus 1）。
  失敗の文: 1 回目は「RPC を開けない（始めない）: … method zm_set_state not available」（起動直後、MCU の RPC がまだ無い）、2〜10 回目は「入力の標準エラー: arecord: audio open error: No such device」
  「ALSA lib … Cannot get card index for Audio」「入力が途中で終わった」。journal の `detector: ` の文は照合・重み・構成・単独モードで始める ×10、終わり（error）windows=0 ×10（数だけ）、
  窓の行なし。暴走しない。通過。
- **(6) の戻し**: アダプタを戻して電源投入（boot 12:41 JST）→ ユニットは起動時に自動で active（NRestarts 0。`failed` と start-limit は再起動で消えるので `reset-failed` は要らなかった。打っても害はない）→ 波線が出た（人の目視）。journal は文だけ。**通過。**
- **(7) 排他**（5 つの形）:
  - ユニットが active の間: `record.py --unoq-detector` → 「自動起動の検出器（zaitaku-detector.service）が動いています（active）…始めません」終了コード 1、フォルダなし。
    `record.py --throat sh12jk-wired-unoq-usbaudio` → 同じ文で始めない。通過。
  - stop の後: `record.py --unoq-detector --duration 10` が始まった（窓 41、止まり方 duration）。通過。
  - 手で持ったロック（`flock -n -F -E 75 /home/arduino sleep 40`）の間の `record.py --throat` → 「UNO Q で別の記録か検出器がロックを持っています（…0050 決定 4）。記録を始めません」、フォルダなし。通過。
  - `record.py --throat`（30 秒。`arecord` が flock の下で動く）の間に `systemctl --user start` → ExecMainStatus 75、Result exit-code、failed、NRestarts 0（再起動しない）。
    journal「Main process exited, code=exited, status=75/TEMPFAIL」。記録は 30 秒で正常に終わった。通過。
  - ユニット active → 本体に SIGKILL → 0.3 秒後 activating → その間に `record.py --unoq-detector` → 「…動いています（activating）…」で始めない、フォルダなし。その後ユニットは active に戻った（NRestarts 1）。通過。
- **(8) 読み取り**（12:2x JST、メインが ssh で読むだけ。時刻の控え 02:41:41 UTC 以降）:
  - 新しい普通のファイルは 2 件で、どちらも検出器のものではない（`~/.local/state/wireplumber/stream-properties` = PipeWire の状態、`/tmp/.X0-lock` = X のロック。どちらも docs/unoq-setup.md の既知のもの）。
    音声の拡張子 0 件。`~/zaitaku-mealpace-device` に `__pycache__` 無し。`/var/lib/systemd/coredump` 空、`/var/crash` 無し。journald は永続（`/var/log/journal/<machine-id>`）。
  - リンク: `~` 全体で 9 件。新しいのはユニットの 2 件（`~/.config/systemd/user/zaitaku-detector.service` と `default.target.wants/zaitaku-detector.service`。どちらも
    `~/zaitaku-mealpace-device/zaitaku-detector.service` を指す）。残り 7 件は前からある（arduino-app-cli の AGENTS.md、zephyr の toolchain）。
  - journal（今の起動）: D/T/F/H/E の形の行 0。`detector: ` の行 44（照合 ×16（2 種 ×8）、重みの sha256 ×8、構成 ×8、単独モードで始める ×8、RPC を開けない ×2、終わり ×5（error ×2、signal ×3。数だけ））。
    systemd の行 40（Started ×9、Stopping ×3、Stopped ×3、Consumed ×7、Failed（exit-code ×3、signal ×2）、Killing process (arecord) SIGKILL ×2（`KillMode=mixed` の後始末）、
    Main process exited ×5、Scheduled restart ×4、Sent signal SIGKILL ×2）。どちらでもない行 0。窓ごとの値は無い。通過。
- **確かめ用のセッション 2 本**（`20261103-122332_self_water`（(7) の stop の後、10 秒）、`20261103-122409_self_water`（(7) の `--throat` 30 秒。生の音声あり））: 数字に使わない。人の決定（11/3）で消した（メインが `rm`）。
- 打ち切り（11/7）は要らない（(1) が 11/3 に取れた）。

### 打ち切り（人の決定 11/1）

11/7 の終わりまでに (1)（電源投入から PC なしで目安が動く）が取れなければ、動画（#57）は `record.py --unoq-detector` で撮り、#53 は M6 か応募後に回す。

### テスト（ステップ A）

- `PYTHONPATH=device/unoq:tools .venv/bin/python -m unittest device/unoq/test_detector.py device/unoq/test_mcu_rpc.py tools/test_record_unoq.py tools/test_record_throat.py`:
  123 件 OK（足したもの: `test_detector.py` の `StandaloneTest` 7 件（sa1〜sa7）、`test_record_unoq.py` の `test_u3b`・`test_c4`（PC の `flock` でロックの競合と `kill -9` の後の解放）、
  `test_record_throat.py` の `test_h18`・`test_h19`）。`PYTHONPATH` なしでは `record` を import できず読み込みで止まる（パスでテストを渡す形のとき）。
- `bash tools/format.sh`: 4 ファイルを整形（ruff format）。`analysis/` の前からの差分には触れていない。
- コミット前の adversarial-review の指摘（ロックの fd が `arecord` に渡らない）を直した後: 同じコマンドで 126 件 OK（足したもの: `test_detector.py` の `LockFdTest` 2 件、
  `test_record_unoq.py` の `test_c5`（PC の `flock` で、持ち手が SIGKILL で死んでも子が生きている間は 75、子が死ねば 0。`pass_fds` を外すと 0 になることを手で確かめた））。
- 2 回目の adversarial-review の指摘（`/proc/self/fd` を読めないとロックを渡さずに起こす）を直した後: 127 件 OK（`LockFdTest` の `test_l3`: 列挙できなければ偽の arecord を起こさず、
  `detector.main` は 1 で終わる。`test_l2` は空を返す代わりに例外を確かめる形に直した）。
- 3 回目の adversarial-review の指摘（ロックの fd の `fstat` の失敗を飛ばして起こす）を直した後: 129 件 OK（`test_l4`: `EACCES` で `InputError`、偽の arecord を起こさない。
  `test_l5`: `EBADF` は飛ばして起こす）。再レビューはしない（人の決定 11/3）。
