owhinata/zaitaku-mealpace/docs/decisions/0025-throat-mic-uno-q.md

# 0025 音のチャンネルを咽喉マイク SH-12JK に替え、基板を手元の UNO Q にする

日付: 2026-10-02　状態: 採用　追記: 2026-10-12（#42）

人が 10/2 に決めた（決定 3・4・6・7・8）。IMU の扱い（決定 5）は docs/decisions/0026、日程（決定 1・2）は docs/decisions/0024。
`docs/evaluation.md`・`docs/data-schema.md`・`analysis/`・`tools/`・`firmware/` は変えていない。CLAUDE.md の「実装方針」「データの扱い」の該当行は人が差し替える
（下の「CLAUDE.md・AGENTS.md との関係」）。M1・M2 の記録・数字・決定（0001〜0023）は Nano RP2040 Connect の構成のものとして残す。

## 決定

### センサ

- 音のチャンネルを咽喉マイク 南豆無線 SH-12JK（エレクトレット、3.5 mm 3 極）にする。発注済み（10/2、即納）。
- M1・M2 の第一候補（Nano RP2040 Connect 基板の LSM6DSOX と PDM マイク MP34DT06JTR、docs/decisions/0002）は、M3 以降の構成では使わない。
  IMU は 0026 の条件で外付けを足す。

### 基板

- 手元の Arduino UNO Q を使う。4GB 版を検出器、2GB 版をベンチと予備にする。
- 「UNO Q は応募時点では使わない」というこれまでの前提（`docs/proposal.md` 7 章）を取り消す。

### 構成

```
 [咽喉マイク SH-12JK]（喉元。エレクトレット）
        │ 3.5 mm 3 極
 [USB オーディオアダプタ]
        │ USB
 [USB-C ハブ（PD パススルー）] ◀── [PD 対応モバイルバッテリー]
        │ USB-C
 [UNO Q]
   ├─ Linux 側: ALSA → メモリ上のバッファ → 窓ごとの特徴量 → 推論 → 波形は破棄
   │             （ディスクに音声を書かない。WAV・raw とも）
   │        ▲▼ RPC（表示の状態を渡す。音声は渡さない）
   └─ MCU 側: LED（表示。docs/decisions/0018 の規則）
```

- Linux 側: ALSA から音声をメモリに取り、`docs/evaluation.md` の窓（1.0 秒 / ホップ 0.25 秒）ごとに特徴量に変換して破棄する。ディスクに WAV を書かない。
- MCU 側: LED。Linux 側と RPC で結合する。
- 電源は PD 対応モバイルバッテリー。

### データの扱い（検出器）

- 検出器の Linux 側は音声をディスクに書かない（WAV・raw とも）。メモリ上で特徴量に変換して破棄する。ログ、標準出力、ネットワーク、MCU への RPC にも
  音声の波形を出さない。docs/decisions/0005 の「検出器ファームウェアは生の音声波形を保存も送信もしない」を、UNO Q の構成では Linux 側のプログラムと
  MCU 側のスケッチの両方に当てる。
- 学習用の `self` の生の音声（開発用の計測。0005 の記録ファームウェアに当たるもの）は、USB オーディオアダプタを PC に挿して PC で録り、`data/raw/` に置く
  （`self` のみ。CLAUDE.md「データの扱い」の `self` の規則）。UNO Q の検出器のプログラムには録音の機能を持たせない。UNO Q を通した生の音声の記録が要る
  ことになったら、検出器とは別のプログラムとして、先に `docs/decisions/` に記録する。
- 検出器が窓ごとの特徴量と検出の結果を PC に送る経路と形式（0021 の DETECT / FEAT に当たるもの）は、M3・M4 の Issue で決め、`docs/data-schema.md` を直す
  plan で Codex のレビューを通す。特徴量は生の波形ではないので 0005 の範囲内（`self` のみ。`p1` は本人試用の前に別に決める）。
- `docs/data-schema.md` は、時刻の基準を装置の `millis()` とし（「共通」の節）、音声を基板の PDM マイクから装置経由で受ける前提で書かれている。この記録だけでは
  M3・M4 の数字は出せない。後の plan（M3 の Issue。`docs/data-schema.md`・`tools/`・`analysis/` を同時に直す）で、少なくとも次を決める。
  1. PC で録る咽喉マイクの音声と、マーカー（`events.csv`）の時刻の合わせ方（共通の時計を何にするか）。
  2. 音声の形式（サンプリング周波数、ビット深度、チャンネル数、ファイル名）と `meta.json` の `sensors`・`sample_rates`。
  3. UNO Q の検出器が PC に送る DETECT / FEAT に当たるものと META（0021 の形式をそのまま使うか、変えるか）。
  4. 既存の評価器（`analysis/split.py`、`analysis/evaluate.py`、`analysis/evaluate_detector.py`）との接続（読めるファイルの形にするか、読み口を足すか）。

### 0001（開発環境・実装方針）との関係

- 0001 の「推論は Edge Impulse の C++ ライブラリ形式で書き出す」は、咽喉マイク版の検出器では UNO Q の Linux 側の Python に置き換わる。装置の推論と PC 側の
  解析・評価は同じ Python のコードを使う。分類器を何で作るか（Edge Impulse を使うか、PC の Python で学習するか）は M4 の plan で決める。
- 0001 の A 案（CMake が arduino-cli を呼ぶ）は、UNO Q の MCU 側のスケッチに当てる。Linux 側の Python の配置の方法は M3 の Issue で決める。
- 「Arduino の型を漏らさない」は MCU 側に当てる。RPC の呼び出しは Linux 側・MCU 側とも 1 つのモジュールの内側に閉じ、特徴量の計算と記録の形式に
  RPC と Arduino の型を漏らさない。
- 「解析と評価は PC 側の Python で完結させる」は変えない。
- 0001 の「再検討の条件」（M2 で RP2040 の性能が足りないと判明したら Nano 33 BLE Sense Rev2）は、10/2 の時点で成立していない。基板を替えるのは、その条件に
  よらず、下の「理由」による人の判断。

### 0002（センサ）との関係

- 0002 の「切り替えの条件」（M1 分岐点で届かない場合に圧電を追加、基板マイクが食卓の音に負ける（M2 以降で誤検出が減らない）場合にピエゾ電線を検討）は、
  10/2 の時点で成立を確かめていない。M1 は通過し（docs/decisions/0017）、M2 の数字（#27）は 10/4 の打ち切りの後に出る。
- この記録は、条件の成立を待たずに、人の判断で咽喉マイクを代替候補に加えて切り替えるもの。咽喉マイクは 0002 の代替候補 1（圧電コンタクトマイク）・
  2（ピエゾ電線）のどちらでもない。条件が成立したかどうか（M2 が届いたか）は #28 の記録に書く。
- 圧電（#35、ブランチ `trial/piezo-dfr0052`。信号の大半がハムで、配線の改良が要る）とピエゾ電線（#5）は、選択肢として残す。

### 0019（結合の方式）との関係

- 0019 の結合の方式（窓ごとの特徴量ベクトルを 1 本の分類器に入れる）は特徴量の結合の話で、変わらない。IMU を足す場合（0026）もこの形で結合する。
- 0019 のうち Edge Impulse に関わる部分（EI の分類器、int8、C++ ライブラリのコミット、EI プロジェクトの公開範囲）と RP2040 の 1 ホップの時間の制約は、
  M2（Nano）の構成についての決定として残す。咽喉マイク版に当てるかは、上の「0001 との関係」と同じく M4 の plan で決める。

### 評価の定義との関係（決定 7）

- `docs/evaluation.md` は変えない。窓（1.0 秒 / 0.25 秒）、イベント単位の数え方、非嚥下区間、セッション単位の分割、評価 3 セッション以上、混同行列と
  セッション一覧、合格線の数字を、そのまま新しいセンサに当てる。
- 定義は変えないが、新しい構成では次の箇所をこう読む（`docs/evaluation.md` は書き換えない）。
  - 8 行目の特徴量（IMU（振幅、RMS、ピーク数、主軸方向）＋ 音（MFCC 13 次元、スペクトル重心、ゼロ交差率））: 音の名前の並びを咽喉マイクの音に当てる。
    IMU の特徴量は、IMU なしで始める間は無い。これは 0019 が「評価の定義からの逸脱に当たる。記録を先に書く」とした経路（IMU の特徴量を外す）に当たり、
    その記録は docs/decisions/0026。
  - 29 行目（M2 検出器の手法「Edge Impulse（int8、Nano 上で推論）」）: 咽喉マイク版の検出器（M4）では手法を「UNO Q の Linux 側の Python で推論」と読み、
    合格線の数字（検出率 85% 以上、誤検出 1 回/分以下）を当てる。
  - 28 行目（M1 分岐点「手作り特徴量＋ロジスティック回帰」、70% / 3 回/分）: M3 の (3) にそのまま当てる。
  - 34 行目（「`p1` については、M4 で本人データで再学習」）: docs/decisions/0024 のとおり「応募後の本人試用」と読む。
- 音のサンプリング周波数は `docs/evaluation.md` に無い。USB オーディオアダプタで取る周波数と記録の形式は、M3 の Issue で `docs/data-schema.md` を直す plan で決める。

### 試用（決定 8）

- マイクの PC 録音による信号の確認と UNO Q の立ち上げは、#35 と同じ「代替センサの試用」として、試用ブランチで #28 の前に始めてよい。main に入れるのは
  #28 の後。扱いは docs/decisions/0024「関門の決まりとの関係」。

### CLAUDE.md・AGENTS.md との関係

- CLAUDE.md の「実装方針（docs/decisions/0001）」と「データの扱い」の該当行は、この記録と合わない箇所がある（EI の C++ ライブラリ形式、検出器ファームウェア）。
  差し替えは人が行う。
- 順序: UNO Q の推論のコード（Linux 側の Python。試用ブランチを含む）を書く前に、人が CLAUDE.md を差し替え、同じコミットで `AGENTS.md` の冒頭と不変条件 8 を
  直す。それまでは、試用ブランチで行うのはマイクの PC 録音と UNO Q の立ち上げ（音が取れること、LED が点くこと）までにし、推論のコードは書かない。
- `AGENTS.md` の不変条件 4 に「検出器の Linux 側は音声をディスクに書かない（WAV・raw とも）。メモリ上で特徴量に変換して破棄する」を足した。
  `AGENTS.md` の冒頭の要約と不変条件 8 は、CLAUDE.md の差し替えと同じコミットで直す（`docs/workflow.md`「CLAUDE.md を変えたら `AGENTS.md` も同じコミットで直す」）。

## 理由（人）

- UNO Q は手元にある。
- 咽喉マイクの入力が、USB オーディオアダプタで電子工作なしに取れる見込み（バイアスと ALSA での取り込みは未確認。M3 で確かめる。下の「確かめていないこと」）。
- 装置と PC の推論コードが同じ Python になる。

## 選ばなかった案

- **UNO Q＋UNO Media Carrier（3.5 mm のマイク・ヘッドホン兼用ジャック）、UNO Q＋UNO Breakout Carrier（MIC IN がピン。ジャックとバイアスは自作）。**
  兼用ジャックに 3 極のマイクを挿せるか、バイアスが出るかが未確認。USB オーディオアダプタなら電子工作が要らない。
- **今の Nano RP2040 Connect＋プリアンプ→ADC。** #35 と同じ道で、ハムと ADC の取りこぼしが課題。
- **圧電の再試行を先にする。** #35 の構成では信号が見えず、配線の改良からになる。
- **#28 の判定を待ってから決める。** 次の手に移るのが遅れる（0024）。

## 確かめていないこと

- SH-12JK で嚥下の信号が見えるか（M3 の (1)）。
- USB オーディオアダプタがマイクのバイアス（プラグインパワー）を出すか。UNO Q の ALSA で取れるか。取れるサンプリング周波数。
- PD パススルーのハブ経由で UNO Q とアダプタが給電されたまま動くか。モバイルバッテリーの持ち時間。電源由来の雑音。
- arduino-cli で UNO Q の MCU 側のビルドと書き込みができるか（0001 の A 案）。
- Linux 側の 1 ホップ（0.25 秒）の処理時間、RPC の遅れ。
- LED をどこに出すか（UNO Q の基板の LED か、#32 の表示器か）。0018 の規則（緑・黄の「目安」、更新が 1.0 秒無ければ消灯）をそのまま当てられるか。

## 追記（2026-10-12）: NZ-210C の構成 A・B の結果と、検出器の境界（#42）

#37・#38 の結果と、人の決定（10/8・10/10 夜・10/11）による。上の本文（決定・理由・選ばなかった案・確かめていないこと）は変えていない。
学習用の記録の経路は docs/decisions/0028（有線、`sh12jk-wired-unoq-usbaudio`）と 0030（構成 B、`sh12jk-nz210c-a2dp-unoq`）。0030「検出器と無線リンクの境界」が
「#42 で決める」とした点に、この追記で答える。

### 構成 A・B の結果

- 構成 A（送信機 NZ-W210C → 受信機 NZ-W210R → USB オーディオアダプタ → UNO Q）は試していない。人の決定（10/8）で使わない（受信機の出力を 3.5 mm の入力へ
  つなぐ変換ケーブルは手配しない）。iface の名前 `sh12jk-nz210c-rx-unoq-usbaudio` は予約のまま（0030 決定 9）。
- 構成 B（送信機 → UNO Q の A2DP シンク → `pw-record` の標準出力 → ssh → PC。記録専用の経路、0030）は 10/8 に動いた。`tools/record.py`・`tools/throat_check.py` の
  対応と実測（取りこぼしの規則 `ZERO_RUN_MS` = 100 ms、止めた後に UNO Q に `pw-record` が残らないこと）は 10/9〜10/10 に済ませた（docs/log/2026-10-08.md〜2026-10-10.md）。
- 構成 B の 1 回目の 5 本（`self`）は、5 本とも 0 の区間で使わない目安に当たった。切り分けで、送信機 NZ-W210C が入力のごく小さいとき（RMS おおよそ 10〜15 LSB 未満。
  L を 16 bit で読んだ値）に無音（ちょうど 0）を送るノイズゲートを持つと分かった。PipeWire・Bluetooth・PC 側の原因ではない。取扱説明書にゲートの記述と切替は無い。
  静かな区間が無音に置き換わることは確かめた。嚥下の信号への影響は確かめていない（0 の区間は動作の最中にも出た）。
  叩きの `Δ` の中央値は +31〜+168 ms（無線と符号化の遅延。有線は −55〜−74 ms）。docs/log/2026-10-10.md。
- #37 の経路の差（有線の中央値に対する相対差 20% 以内）は「判定できない」として記録した。規則は変えていない。

### 採った構成（人の決定、10/10 夜）

- 構成 B は学習用の記録に使わない。#39 以降の記録と M4 の検出器は有線（UNO Q の USB オーディオアダプタ、0028）で進める。
  理由: 装着して静止した間（`quiet`）が無音に置き換わり、10/7 の規則の `quiet` の基準が成り立たない。学習データとしても静かな区間の情報が失われる。遅延が大きく、記録ごとに揺れる。
- NZ-W210C は、記録にも検出器にも採らない。無線そのものは閉じない。本人試用（応募後、0024）で無線が要るときは、ゲートの無い送信機を人が探す。
- 構成 B の実装（`record.py`・`throat_check.py`、0030）と UNO Q の設定（`docs/unoq-setup.md`）は残す。CLAUDE.md「データの扱い」の構成 B の文（記録専用の経路として
  認める）も残す。再び使うときの手順は `docs/unoq-setup.md`。

### UNO Q の Bluetooth（10/11）

- 人が `sudo rfkill block bluetooth` で無効にした（構成 B を使わないと決めた後も Discoverable が yes のまま残っていたため）。状態は再起動後も保たれる。
  `rfkill block all` は使わない（Wi-Fi も止まり、ssh の経路が落ちる）。
- 構成 B を再び試すときだけ、人が `sudo rfkill unblock bluetooth` で戻す（`docs/unoq-setup.md`）。無効の間、`record.py --throat sh12jk-nz210c-a2dp-unoq` は起動前の検査で止まる。
- 送信機の BD アドレスは文書に書かない（0030）。

### 検出器の境界

1. 装置（食卓で使う形態）は、咽喉マイク、マイクから UNO Q への入力のリンク、UNO Q（Linux 側・MCU 側）、LED までを指す。
2. マイクから UNO Q への入力のリンクは、有線（3.5 mm のケーブルと USB オーディオアダプタ）でも無線（送信機から UNO Q の Bluetooth の A2DP シンクへ）でも、
   装置の内側のセンサ入力として扱う。マイクの音がこのリンクを通ることは、検出器が生の音声波形を「送信する」ことに当たらない。無線の入力は USB オーディオの入力と同じに扱う。
3. 「検出器は生の音声波形を保存も送信もしない」（CLAUDE.md「データの扱い」、0005、上の「データの扱い（検出器）」）は、検出器のプログラム（UNO Q の Linux 側のプログラム・
   MCU 側のスケッチ）が入力を受け取った後の扱いの決まりで、変えない。Linux 側は受けた音声をメモリ上で特徴量に変換して破棄し、ディスク（WAV・raw・一時ファイルとも）、
   ログ、標準出力、ネットワーク、MCU への RPC に波形を出さない。無線で受けた入力にも同じに当てる。
4. 入力を受けた後に、検出器のプログラムの外の仕組みが波形を別の出口へ流すことも、送信（または保存）に当たるものとして扱う。例: PipeWire / WirePlumber が入力のノードを
   再生の出力（USB オーディオアダプタのヘッドホン出力など）、別のユーザーのセッション、ネットワークのモジュールにつなぐこと。構成 B の試しでは、既定の自動リンクで
   アダプタの再生側へつながり、設定の前はログイン画面（lightdm）側の PipeWire が音を受けていた（docs/log/2026-10-08.md、0030「UNO Q に残した設定」）。
5. 無線のとき、送信機が音を送ってよい相手は、その家庭の装置の UNO Q だけ（ペアリング済みの 1 台）。送信機が他の機器（スマートフォン、他の Bluetooth の受信機など）と
   つながりうる状態は、装置の外への出力として扱う。
6. 学習用の記録の経路（0028・0030。生の音声を ssh で PC に流し、PC が `data/raw/` に書く）は、検出器ではなく記録専用の経路のまま（0005 の記録ファームウェアと
   同じ扱い。`self` のみ）。この境界は記録の経路を広げない。同じ UNO Q で検出器と記録を同時に動かさない（0028 決定 3）も変えない。

### この境界で認めること・認めないこと

- 認める: 検出器の入力を無線の送信機にすること自体を、「検出器は送信しない」の違反としない（下の「無線を採る前の条件」を満たしたうえで）。
- 認めない（今までどおり）: 検出器の Linux 側が音声をディスク・ログ・標準出力・ネットワーク・RPC に出すこと。UNO Q から外へ音声を出すこと（Bluetooth・Wi-Fi・有線の
  ネットワーク・再生の出力）。PC へ生の音声を送る機能を検出器に持たせること。`p1` の生の音声の記録の経路を、この追記で決めること（本人試用の前に別に決める。0024、0028 決定 4）。
- 今は採っていない: 検出器（M4）の入力は有線。無線の入力を検出器で採るときは、次の条件を満たす送信機と設定を `docs/decisions/` に新しく記録し、Codex の plan レビューを
  通し、CLAUDE.md の該当行（「UNO Q の Linux 側は ALSA からメモリに取り」。A2DP の入力は PipeWire から取る）を人が直してから実装する。それまでは、検出器のプログラムが
  無線の入力を読む plan は、CLAUDE.md の今の文言のとおりに扱う。

### 無線を採る前の条件（採るときの記録で満たす）

- 入力が小さいときに無音に置き換えない送信機（ゲートが無いか、切れる）。`quiet` の基準を、有線と同じ規則（10/7 に固定した規則）で確かめる。
- 送信機は家庭内で UNO Q とだけペアリングする。初回のペアリングは UNO Q を先に起動して行う。ペアリングの後は、UNO Q の Discoverable・Pairable を切る。
- 送信機の接続先を UNO Q に固定する方法と、UNO Q が無い・切断した・再起動したときにも送信機が他の機器へ音声を送らないことの確かめ方（上の境界 5）。
  今の送信機は電源を入れるたびに新規ペアリングで来る（0030「UNO Q に残した設定」）。確かめられるまでは採らない。
- 入力のノードを、検出器のプログラムの外の出口（再生の出力、別のユーザーのセッション、ネットワーク）へつながない設定と、その確かめ方（上の境界 4）。
- ProtoPedia の記事に、マイクと UNO Q の間が無線であることと、届く範囲（使う送信機の仕様の値）を書く。
- 遅延（構成 B では叩きの `Δ` が +31〜+168 ms）が、LED の目安の表示（docs/decisions/0018 の規則）とイベントの数え方に与える影響を確かめる。

### 根拠（人の考え、10/3）

- 決まりの意図は、食卓の会話を録音・保存せず、音声を装置の外へ出さないこと（`docs/proposal.md` 5 章「処理は装置内で完結し、音声も映像も外に出さない」
  「食卓の会話を録音・保存しない」）。マイクから基板への無線のリンクは装置への入力で、有線のケーブルを置き換えたもの。
- ただし電波は家の外へ届きうる。送信機は起動後に近くの接続できる機器を探す（10/8 は UNO Q の Class of Device を Audio/Video に変えるまで UNO Q を相手にしなかった）。
  そのため、境界 4・5 と「無線を採る前の条件」を文章にした。

### 確かめていないこと

- 無線のリンクの暗号化の有無。構成 B のペアリングは Secure Simple Pairing（入出力の無い承認、Just Works）で行ったが、リンクが暗号化されていたかは確かめていない。
  Just Works は中間者への耐性が無い。
- ペアリングの相手を取り違えたとき（近くに別の A2DP の受け手がある、別の UNO Q がある）の送信機の挙動。`JustWorksRepairing = always` の下で、同じアドレスを名乗る
  機器の再ペアリングを UNO Q が受けるか。
- 製品ページ・取扱説明書の電波に関する注意書きの中身（10/10 に人が取扱説明書の 5・6 を読み、ゲートの記述が無いことだけを確かめた）。
- 家の外へ届く距離（取扱説明書の通信距離 約 20 m は見通しの値）。
- ゲートの無い送信機の候補と、その遅延・コーデック。
- NZ-W210C のノイズゲートが嚥下の信号に与える影響（静かな区間が無音に置き換わることだけを確かめた）。
- メーカー（南豆無線）が公開している使用例（咽喉マイクを食事中に着けて嚥下音を確かめた例、言語聴覚士が嚥下音と咽頭の残留音を聞いた例）の出どころ（人の考え 10/3 の材料。出どころを確かめていない）。

## 追記（2026-11-03、Issue #53）: 単独モード

上の決定の本文は変えない。

- 「データの扱い（検出器）」は、PC なしで電源投入から動かす単独モード（docs/decisions/0050）にもそのまま当てる。単独モードは標準出力にも行を出さず、
  journald（標準エラー）には文だけ（照合・止まり方、`code_sha256` の先頭 12 桁、窓の数と失敗の数）を出す。窓ごとの値・特徴量・波形は出さない。音声はメモリだけで、ディスクに書かない。
- 「装置の推論と PC 側の解析・評価は同じ Python のコード」は変わらない（単独モードも同じ `detector.py`・`m4_infer.py`）。
