owhinata/zaitaku-mealpace/docs/log/2026-10-27.md

# 2026-10-27

## #48 学習用 `meal` 3 本目（学習用の収集日 3）

- M4 の学習用 `meal`（docs/decisions/0037。3 本、10/25〜10/28、締め 10/28 の終わり）。PC の記録の経路（`record.py --throat sh12jk-wired-unoq-usbaudio --cond meal --duration 1800`、
  docs/decisions/0028）。手順は `docs/recording-protocol.md`「M4 の `meal`（咽喉マイク）」。被験者 `self`。1 本目は docs/log/2026-10-25.md、2 本目は docs/log/2026-10-26.md。
- `throat_check.py --tap-mode enter` の数字は人が実行した出力から写した。マーカーの数は `events.csv`、記録の形は `meta.json` から写した（音声の中身は見ていない。
  振幅・特徴量・分類器の結果は出していない）。採否は人が記録の直後に決めた（下の「人の決定（10/27）」）。
- 装着の側は M3 と同じ側。

| セッション | 条件 | 長さ（秒） | 止まり方 | 会話 | 同席者 | `s` | `t` | `c` | `o`（tap / start / conv / その他の note） | overrun の行 | 推定差（ms） | 段差 | 叩き 見つかった数 / `Δ` 中央値 | 使わない目安 | 打ち忘れの体感 | 打ち遅れの体感 | 記録時の `s` の決まり | 採否と理由 |
|---|---|---|---|---|---|---|---|---|---|---|---|---|---|---|---|---|---|---|
| `20261027-144545_self_meal` | meal | 1303.625 | interrupt（食べ終わって Ctrl-C） | あり（`o conv`） | あり | 60 | 3 | 0 | 5 / 1 / 1 / 0 | 0 | −8 | なし | 5 / 5、−46.2 ms（印なし。\|Δ\| ≤ 50 ms） | 当たらない | 数回 | ほぼ無し | 0023（意識した食べ物・飲み物の嚥下に `s`） | 採用（人の決定 10/27、数字を見る前） |

- `o start` は 1 つ（43.2 秒）で、その前に `s`・`t`・`c` は無い。`o conv` は `o start` の 2.4 秒後。`o start` から記録の終端まで 21.0 分。`s` はすべて `o start` の後で、
  最初の `s` は `o start` の 31.4 秒後、最後の `s` は終端の 9.8 秒前（0023 の 6「終わりの 1.5 秒以内の `s`」に当たらない）。`s` の間隔 10 秒未満は 15 組（`meal` では制限なし）。
- 時刻の対応: c0 −140.2 ms、クロックの差 +5.0 ppm、残差の中央値 8.5 ms・95 パーセンタイル 23.9 ms・最大 306.7 ms。L と R の相関 1.000、RMS の比 1.000。0 の区間 0 回。
  `meta.json`: `fw` `pc-throat`、`sensors[0].iface` `sh12jk-wired-unoq-usbaudio`、`position` `lateral-below-cricoid`、`band` `sh12jk-strap`、`throat.mixer` Mic 58・on、`throat.stop` `interrupt`。
- 捨てる条件（0037 の 5: M3 の 1〜7・9・10、0023 の 6・8・9）はどれにも当たらない。叩きの `Δ` の中央値は 50 ms 以下で、印は付かない（3 本のうち初めて）。
- 学習用 `meal` の累計: 3 本（10/25 会話あり、10/26 会話なし、10/27 会話あり）、収集日 3 日、`s` の合計 174、`o start` から後の合計 65.5 分。会話あり 1・会話なし 1 の目安は満たしている。

### 人の決定（10/27）

- 採用。体感: 打ち忘れ「数回」、打ち遅れ「ほぼ無し」。体感は採否に使わない（0023）。
- 同席者あり、会話あり。食べ終わって Ctrl-C で止めた。
- 4 本目を 10/28 に録る予定（締めの 10/28 の終わりまでの採用分はすべて学習側に入る。0037）。

## #48 学習用 `meal` 4 本目（同じ日の 2 本目。収集日は 3 日のまま）

- 同じ経路・同じ手順。`throat_check.py --tap-mode enter` の数字は人が実行した出力から写し、マーカーの数は `events.csv`、記録の形は `meta.json` から写した（音声の中身は見ていない）。
  採否は人が記録の直後に決めた（下の「人の決定（10/27、2 本目）」）。装着の側は M3 と同じ側。
- 同じ日の 2 本は 1 収集日に数える（0014・0031。フォルダ名の日付）。学習側 CV の fold は収集日ごとなので、この 2 本は同じ fold に入る。

| セッション | 条件 | 長さ（秒） | 止まり方 | 会話 | 同席者 | `s` | `t` | `c` | `o`（tap / start / conv / その他の note） | overrun の行 | 推定差（ms） | 段差 | 叩き 見つかった数 / `Δ` 中央値 | 使わない目安 | 打ち忘れの体感 | 打ち遅れの体感 | 記録時の `s` の決まり | 採否と理由 |
|---|---|---|---|---|---|---|---|---|---|---|---|---|---|---|---|---|---|---|
| `20261027-203815_self_meal` | meal | 1113.875 | interrupt（食べ終わって Ctrl-C） | あり（`o conv`） | あり | 42 | 2 | 0 | 5 / 1 / 1 / 0 | 0 | +77 | なし | 5 / 5、−39.3 ms（印なし。\|Δ\| ≤ 50 ms） | 当たらない | ほぼ無し | 数回 | 0023（意識した食べ物・飲み物の嚥下に `s`） | 採用（人の決定 10/27、数字を見る前） |

- `o start` は 1 つ（49.5 秒）で、その前に `s`・`t`・`c` は無い。`o conv` は `o start` の 3.2 秒後。`o start` から記録の終端まで 17.7 分。`s` はすべて `o start` の後で、
  最初の `s` は `o start` の 61.3 秒後、最後の `s` は終端の 17.0 秒前（0023 の 6 に当たらない）。`s` の間隔 10 秒未満は 8 組（`meal` では制限なし）。
- 時刻の対応: c0 −135.2 ms、クロックの差 +83.0 ppm、残差の中央値 8.9 ms・95 パーセンタイル 27.7 ms・最大 165.1 ms。L と R の相関 1.000、RMS の比 1.000。0 の区間 0 回。
  `meta.json`: `fw` `pc-throat`、`sensors[0].iface` `sh12jk-wired-unoq-usbaudio`、`position` `lateral-below-cricoid`、`band` `sh12jk-strap`、`throat.mixer` Mic 58・on、`throat.stop` `interrupt`。
- 注記（捨てる理由ではない）: 叩きの `Δ` は 5 回のうち 1 回だけ +200.8 ms に外れ、ほかの 4 回は −58.4〜−38.7 ms。規則（条件 9・10）は中央値で見るので印は付かない。
  推定差 +77 ms とクロックの差 +83 ppm は前の 3 本（−8〜+27 ms、+5〜+27 ppm）より大きいが、使わない目安（125 ms）の内。`Δ` で時刻の対応は直さない（0029）。
- 捨てる条件（0037 の 5: M3 の 1〜7・9・10、0023 の 6・8・9）はどれにも当たらない。
- 学習用 `meal` の累計: 4 本（10/25 会話あり、10/26 会話なし、10/27 会話あり 2 本）、収集日 3 日、`s` の合計 216、`o start` から後の合計 83.2 分。

### 人の決定（10/27、2 本目）

- 採用。体感: 打ち忘れ「ほぼ無し」、打ち遅れ「数回」。体感は採否に使わない（0023）。
- 同席者あり、会話あり。食べ終わって Ctrl-C で止めた。
- 10/28 にもう 1 本録る予定（締めの 10/28 の終わりまでの採用分はすべて学習側に入る。0037）。

## 次

- 学習用 `meal` 5 本目（10/28）。締め（10/28 の終わり）の後、採用分の名前を 0037 の `M4-TRAIN` と `fixed_eval.M4_EXPECTED_TRAIN` に追記（plan #45 のステップ 2 の (1)）。
