owhinata/zaitaku-mealpace/docs/log/2026-10-13.md

# 2026-10-13

## #40 評価側の採点（1 回だけ）

Issue #40。docs/decisions/0034 と plan #40（PLAN-SHA `32c78f532c84a0a7`）のステップ 2。人の合図の後、subagent（opus）が 1 回だけ実行した。

### 実行の条件

- 実行: リポジトリのルートで `( time .venv/bin/python analysis/final_eval.py data/raw )`（標準出力を scratchpad のファイルへ、標準エラーを別のファイルへ）。1 回だけ。終了コード 0。
- HEAD: `45f329e`（`git status --short` は空）。docs/decisions/0034 はこのコミット（2026-10-13 00:53）に入っており、実行（05:30）より前にコミット済み。
- 実行の前の確認: `split.py data/raw --kind throat --eval-min 7` の学習側 14 本・評価側 7 本は 0034 の `FINAL-TRAIN`・`FINAL-EVAL` と名前が一致した。
  印 `docs/log/m3-final-40.txt` と図の出力先 `docs/log/2026-10-13-40/` は実行の前には無かった。
- 印 `docs/log/m3-final-40.txt`（実行で作られた）: 見出しの 1 行（この印があれば `final_eval.py` は止まる）、`started`（2026-10-13T05:30:25+09:00）、
  `commit`（45f329e の全桁）、`decision`（0034 のパス）、`command`（`python analysis/final_eval.py data/raw`）。数字は含まない。
- 壁時計: 1 分 29 秒（`time` の real 88.98 秒。上限 15 分以内）。`time` の行は標準エラーに出た（標準出力には入っていない）。
  標準エラーはこのほかに図の枚数の 1 行（12 枚）だけ。

### `final_eval.py` の出力（そのまま）

見出しがこの log の見出しと混ざらないよう、コードブロックに入れた。中身は標準出力のままで、手を加えていない（`diff` で一致を確かめた）。
個々の窓の確率・特徴量の値は含まれない。

````markdown
# M3 咽喉マイク: 評価側の採点（1 回だけ。#40、docs/decisions/0034）

## 実行の条件

- 実行: 評価側の採点（印 `docs/log/m3-final-40.txt` を作成してから評価側を開いた）
- `--eval-min` に当たる定数: 7（引数では選べない）
- subject: `self`、分割: `kind=throat`
- 評価側の収集日: 1（docs/decisions/0032。M1 は 2 収集日）
- コミット: 45f329e
- 手順と構成の定義: docs/decisions/0034-throat-mic-final-eval-cnn-judgment.md
- numpy 2.5.3、scipy 1.18.1、scikit-learn 1.9.1、librosa 1.0.0、torch 2.14.1+cpu
- `.venv` の全パッケージ（間接依存を含む）: certifi==2026.7.22、cffi==2.1.1、charset-normalizer==3.5.2、cloudpickle==3.1.2、contourpy==1.4.0、cycler==0.12.1、decorator==5.3.1、filelock==3.32.3、fonttools==4.66.1、fsspec==2026.7.0、idna==3.20、jinja2==3.1.6、joblib==1.6.0、kiwisolver==1.5.1、lazy-loader==0.6、librosa==1.0.0、llvmlite==0.50.0、markupsafe==3.0.3、matplotlib==3.11.2、mpmath==1.3.0、msgpack==1.2.3、narwhals==2.26.0、networkx==3.6.1、numba==0.68.0、numpy==2.5.3、packaging==26.3、pillow==12.3.0、pip==24.0、platformdirs==4.13.0、pooch==1.9.0、pycparser==3.11、pyparsing==3.3.3、pyserial==3.5、python-dateutil==2.9.0.post0、requests==2.34.2、ruff==0.16.10、scikit-learn==1.9.1、scipy==1.18.1、setuptools==78.1.0、six==1.17.0、soundfile==0.14.0、soxr==1.1.0、sympy==1.14.0、threadpoolctl==3.7.0、torch==2.14.1+cpu、typing_extensions==4.16.0、urllib3==2.8.0
- Python 3.12.3
- CPU: AMD Ryzen 7 8840U w/ Radeon 780M Graphics、コア数（os.cpu_count）16
- torch のスレッド数: 4
- 構成 J の固定値（0034）: `FINAL-CONFIG J: set=mfe40 classifier=cnn seed=0 post=hyst enter=0.95 exit=0.85`
- 構成 R の固定値（0034）: `FINAL-CONFIG R: set=a52 classifier=lr post=hyst enter=0.85 exit=0.65`
- ロジスティック回帰: LogisticRegression(C=1.0, class_weight="balanced", max_iter=1000, solver="lbfgs")（docs/decisions/0014）
- CNN: Conv 1→8→16→32（3×3）、パラメータ 5921、Adam 学習率 0.001、バッチ 64、20 エポック、陽性の重み = 陰性数 ÷ 陽性数、決定的（docs/decisions/0033 §2）
- 窓 1.0 秒 / ホップ 0.25 秒

## 学習に使ったセッション（14）

- 20261011-100847_self_quiet（quiet）
- 20261011-101644_self_water（water）
- 20261011-102354_self_talk（talk）
- 20261011-102854_self_saliva（saliva）
- 20261011-103352_self_neck（neck）
- 20261011-103912_self_water（water）
- 20261011-104408_self_cough（cough）
- 20261011-202238_self_quiet（quiet）
- 20261011-202730_self_water（water）
- 20261011-203152_self_talk（talk）
- 20261011-203631_self_saliva（saliva）
- 20261011-204057_self_neck（neck）
- 20261011-204526_self_water（water）
- 20261011-204956_self_cough（cough）

## 評価に使ったセッション（7）

- 20261012-191826_self_quiet（quiet）
- 20261012-192531_self_water（water）
- 20261012-193001_self_talk（talk）
- 20261012-193459_self_saliva（saliva）
- 20261012-193929_self_neck（neck）
- 20261012-194417_self_water（water）
- 20261012-194854_self_cough（cough）

## 構成 J（判定に使う）: mfe40 CNN 種 0、ヒステリシス 入り 0.95・出 0.85

### 学習（学習側だけ）

- 正規化と学習に使ったセッション: 14 本（学習側 14 本のうち。学習側だけ: はい）
- fit に使った窓（valid かつ陽性か陰性）: 9221
- 陽性の重み（陰性数 ÷ 陽性数）: 33.4067

### セッションごと

| セッション | cond | 嚥下 | 検出 | 誤検出（回） | 非嚥下（分） | 陽性窓 / 全窓 |
|---|---|---|---|---|---|---|
| 20261012-191826_self_quiet | quiet | 0 | 0 | 0 | 2.79 | 0 / 665 |
| 20261012-192531_self_water | water | 11 | 11 | 1 | 2.60 | 61 / 708 |
| 20261012-193001_self_talk | talk | 0 | 0 | 4 | 2.89 | 8 / 689 |
| 20261012-193459_self_saliva | saliva | 9 | 9 | 5 | 2.61 | 44 / 696 |
| 20261012-193929_self_neck | neck | 0 | 0 | 5 | 2.92 | 14 / 697 |
| 20261012-194417_self_water | water | 10 | 10 | 8 | 2.65 | 74 / 712 |
| 20261012-194854_self_cough | cough | 0 | 0 | 0 | 2.91 | 0 / 695 |

### 合算

- 検出率: 1.000（30/30）
- 誤検出率: 1.19 回/分（23 回 / 19.36 分）
- 無効な窓（採点では陰性として扱う）: 0 / 4862

### 混同行列（イベント単位。TN は定義できないので出さない）

| | 陽性と出た | 陽性と出なかった |
|---|---|---|
| 嚥下 | TP 30 | FN 0 |
| 非嚥下区間 | FP 23（回） | — |

### 参考値（docs/decisions/0011「既知の弱点」）

- 常時陽性の場合（全窓を陽性にした場合）: 検出率 1.000（30/30）、誤検出 7 回、誤検出率 0.36 回/分
- モデルの陽性窓の割合（陽性窓 ÷ 全窓）: 0.041（201/4862）

### 合格線との比較（docs/evaluation.md、M1 分岐点の合格線を咽喉マイクに当てる。docs/plan.md の M3 (3)）

- 検出率 1.000（合格線 0.70 以上）: 満たす
- 誤検出率 1.19 回/分（合格線 3.0 回/分以下）: 満たす

## 構成 R（M1 と同じ手法の参照）: a52 ロジスティック回帰、ヒステリシス 入り 0.85・出 0.65

### 学習（学習側だけ）

- 正規化と学習に使ったセッション: 14 本（学習側 14 本のうち。学習側だけ: はい）
- fit に使った窓（valid かつ陽性か陰性）: 9221

### セッションごと

| セッション | cond | 嚥下 | 検出 | 誤検出（回） | 非嚥下（分） | 陽性窓 / 全窓 |
|---|---|---|---|---|---|---|
| 20261012-191826_self_quiet | quiet | 0 | 0 | 0 | 2.79 | 0 / 665 |
| 20261012-192531_self_water | water | 11 | 11 | 4 | 2.60 | 76 / 708 |
| 20261012-193001_self_talk | talk | 0 | 0 | 3 | 2.89 | 3 / 689 |
| 20261012-193459_self_saliva | saliva | 9 | 9 | 9 | 2.61 | 54 / 696 |
| 20261012-193929_self_neck | neck | 0 | 0 | 4 | 2.92 | 10 / 697 |
| 20261012-194417_self_water | water | 10 | 10 | 4 | 2.65 | 63 / 712 |
| 20261012-194854_self_cough | cough | 0 | 0 | 1 | 2.91 | 1 / 695 |

### 合算

- 検出率: 1.000（30/30）
- 誤検出率: 1.29 回/分（25 回 / 19.36 分）
- 無効な窓（採点では陰性として扱う）: 0 / 4862

### 混同行列（イベント単位。TN は定義できないので出さない）

| | 陽性と出た | 陽性と出なかった |
|---|---|---|
| 嚥下 | TP 30 | FN 0 |
| 非嚥下区間 | FP 25（回） | — |

### 参考値（docs/decisions/0011「既知の弱点」）

- 常時陽性の場合（全窓を陽性にした場合）: 検出率 1.000（30/30）、誤検出 7 回、誤検出率 0.36 回/分
- モデルの陽性窓の割合（陽性窓 ÷ 全窓）: 0.043（207/4862）

### 合格線との比較（docs/evaluation.md、M1 分岐点の合格線を咽喉マイクに当てる。docs/plan.md の M3 (3)）

- 検出率 1.000（合格線 0.70 以上）: 満たす
- 誤検出率 1.29 回/分（合格線 3.0 回/分以下）: 満たす

## 注記

- 判定（#41）は構成 J の数字で読む。構成 J は `docs/evaluation.md` 28 行目の手法（手作り特徴量＋ロジスティック回帰）と8 行目の特徴量の並びからの記録した逸脱（docs/decisions/0034）。構成 R の `a52` は 8 行目の「広げた読み」（docs/decisions/0033 §5）で、28 行目の手法のまま。
- 2 つの構成は評価側を開く前に固定した（docs/decisions/0034）。どちらも学習側の全 14 本で学習し直し、閾値・後処理・種は選び直していない。
- 評価側は 1 収集日（docs/decisions/0032）。M1 の評価側は 2 収集日。
- 参考: M1 の評価側の数字（基板の IMU＋PDM マイク、docs/decisions/0017）は検出率 0.783（54/69）、誤検出率 1.99 回/分。センサも装着も手法も違うので、そのまま比べない。
- 学習側 CV の数字（docs/log/2026-10-12.md「#43 段階 2」）は選択に使った数字で楽観側。評価側の数字とは別に読む。

## 時間の実測（再現の条件の対象外）

- 手順 1〜5 の時間: 79.4 秒
- 学習（構成 J、特徴量の計算を含む）: 46.9 秒
- 学習（構成 R、特徴量の計算を含む）: 14.6 秒
- 評価側の特徴量と採点（構成 J）: 10.3 秒
- 評価側の特徴量と採点（構成 R）: 6.7 秒
- 図（12 枚）: 8.1 秒
- 全体: 87.5 秒
````

### 図（`docs/log/2026-10-13-40/`、12 枚）

- `session_<セッション名>.png` 7 枚（評価側の 7 本、構成 J の確率）: `20261012-191826_self_quiet`・`20261012-192531_self_water`・`20261012-193001_self_talk`・
  `20261012-193459_self_saliva`・`20261012-193929_self_neck`・`20261012-194417_self_water`・`20261012-194854_self_cough`。題に「評価側（#40、1 回だけの採点の確率）」。
- `events_01.png`〜`events_04.png` 4 枚（構成 J のイベントの小図。1 枚に 2 つ、各 ±2 秒）: 01・02 は検出の 4 例（`192531_self_water`）、
  03・04 は誤検出の 4 例（`192531_self_water` 1、`193001_self_talk` 3）。
- `final.png` 1 枚（評価側の構成 J・R の 2 点と、合格線 70% / 3 回/分の破線）。
- 12 枚を開いて確かめた: 題が評価側であること、イベントの小図が 1 枚に 2 つ以下（細かい表示は 4 秒）、`final.png` の 2 点と破線。禁じた語は無い。

### #41 に渡す数字

判定（#41）は構成 J の数字で読む。構成 R は M1 と同じ手法の参照として並べるだけ（0034「事前登録と、後から選ばないこと」）。

| | 構成 J（判定に使う） | 構成 R（参照） |
|---|---|---|
| 構成 | `mfe40` CNN 種 0、ヒステリシス 入り 0.95・出 0.85 | `a52` ＋ ロジスティック回帰、ヒステリシス 入り 0.85・出 0.65 |
| 混同行列 | TP 30、FN 0、FP 23 回 | TP 30、FN 0、FP 25 回 |
| 検出率 | 1.000（30/30） | 1.000（30/30） |
| 誤検出率 | 1.19 回/分（23 回 / 19.36 分） | 1.29 回/分（25 回 / 19.36 分） |
| 陽性窓の割合 | 0.041（201/4862） | 0.043（207/4862） |
| 常時陽性の場合 | 検出率 1.000（30/30）、誤検出 7 回、0.36 回/分 | 同じ |
| 検出率（合格線 0.70 以上） | 満たす | 満たす |
| 誤検出率（合格線 3.0 回/分以下） | 満たす | 満たす |

セッションごと（検出 / 嚥下、誤検出の回数。非嚥下の分は上の出力の表）:

| セッション | cond | J 検出 | J 誤検出 | R 検出 | R 誤検出 |
|---|---|---|---|---|---|
| 20261012-191826_self_quiet | quiet | — （嚥下 0） | 0 | — （嚥下 0） | 0 |
| 20261012-192531_self_water | water | 11/11 | 1 | 11/11 | 4 |
| 20261012-193001_self_talk | talk | — （嚥下 0） | 4 | — （嚥下 0） | 3 |
| 20261012-193459_self_saliva | saliva | 9/9 | 5 | 9/9 | 9 |
| 20261012-193929_self_neck | neck | — （嚥下 0） | 5 | — （嚥下 0） | 4 |
| 20261012-194417_self_water | water | 10/10 | 8 | 10/10 | 4 |
| 20261012-194854_self_cough | cough | — （嚥下 0） | 0 | — （嚥下 0） | 1 |

- 評価に使ったセッション（7、収集日 2 = 2026-10-12）: `quiet`・`water`・`talk`・`saliva`・`neck`・`water`・`cough` 各 1（名前は上の出力）。
- 学習に使ったセッション（14、収集日 1 = 2026-10-11）: 上の出力の一覧。0034 の `FINAL-TRAIN` と同じ。
- 見逃しは J・R とも 0。誤検出は J では `194417_self_water`（8）・`193459_self_saliva`（5）・`193929_self_neck`（5）・`193001_self_talk`（4）に集まり、`quiet`・`cough` は 0。
- 常時陽性の場合の誤検出率（0.36 回/分）は J・R の誤検出率より低い。0011「既知の弱点」のとおり、誤検出の数え方では陽性を出し続けると少なく数えられる。
  J・R の陽性窓の割合は 0.041・0.043 で、陽性を出し続けた結果ではない。

注記（#41 の判定と並べ方に添える）:

- 構成 J は `docs/evaluation.md` 28 行目（手法）と 8 行目（特徴量の並び）からの記録した逸脱（docs/decisions/0034）。
- 構成 R の `a52` は 8 行目の「広げた読み」（docs/decisions/0033 §5）。手法は 28 行目のまま。
- 評価側は 1 収集日（docs/decisions/0032）。M1 の評価側は 2 収集日。
- M1 の数字（docs/decisions/0017: 検出率 0.783、誤検出率 1.99 回/分）とは、センサ・装着・手法・評価側の日数が違うので、そのまま比べない。
- 評価側は `meal` を含まない 7 条件の 1 セット（嚥下 30 回、非嚥下 19.36 分）。
- CNN の UNO Q での推論時間は未確認（M4）。PC では numpy の順伝播で 1 窓 1.05 ms（docs/log/2026-10-12.md）。
- 判定は人が #41 で行う。この log は数字と合格線との比較（満たす / 満たさない）だけを記録する。

## M1 と M3 の評価側の比較（#41 の材料。メインが整理、人の指示 10/13）

出典: M1 は docs/decisions/0017 と docs/log/2026-09-24.md「#13 実データでの実行」、M3 は上の「#40 評価側の採点（1 回だけ）」と docs/decisions/0034。

### 合算

| 項目 | M1（0017） | M3 構成 J（CNN、判定） | M3 構成 R（a52＋LR、参照） |
|---|---|---|---|
| センサ | Nano の IMU 14 次元＋PDM マイク 15 次元 | SH-12JK 咽喉マイク、音のみ | 同左 |
| 手法 | 手作り特徴量＋ロジスティック回帰、閾値 0.90 | 対数メル 40 本＋小さな CNN、ヒステリシス 0.95/0.85 | MFCC 統計 52 次元＋LR、ヒステリシス 0.85/0.65 |
| 評価側 | 2 収集日、14 本、嚥下 69、非嚥下 39.70 分 | 1 収集日、7 本、嚥下 30、非嚥下 19.36 分 | 同左 |
| 検出率 | 0.783（54/69） | 1.000（30/30） | 1.000（30/30） |
| 誤検出率 | 1.99 回/分（79 回） | 1.19 回/分（23 回） | 1.29 回/分（25 回） |
| 陽性窓の割合 | 3.1% | 4.1% | 4.3% |
| 常時陽性の参照 | 0.35 回/分 | 0.36 回/分 | 0.36 回/分 |
| 合格線 70% / 3 回/分 | 満たす | 満たす | 満たす |

### 条件ごとの誤検出率（回/分。M3 は構成 J、非嚥下区間で数える）

| 条件 | M1 | M3 構成 J |
|---|---|---|
| cough | 3.33 | 0.00（0 回 / 2.91 分） |
| saliva（非嚥下区間） | 3.08 | 1.92（5 / 2.61） |
| neck | 2.83 | 1.71（5 / 2.92） |
| talk | 1.34 | 1.38（4 / 2.89） |
| water（非嚥下区間） | 1.04 | 1.71（9 / 5.25） |
| quiet | 1.17 | 0.00（0 / 2.79） |

### 読み取り

- 見逃しが M1 の 15 回から 0 回。M1 の最大の課題だった「日が変わると確率の目盛りがずれる」（学習側 CV 0.453 と評価側 0.783 の乖離、0017）は、M3 では学習側 CV（J 67/67、R 67/67）と評価側（30/30）で検出率が揺れていない。
- M1 の 2 番目の課題だった咳の誤検出（マーカーの 48% に誤検出、3.33 回/分）は M3 で 0 回。首の動きも半分近く（2.83 → 1.71）。咽喉マイクが喉の振動を直接拾い、体動や口の音を拾いにくいことと合う。
- 水の嚥下の区間（嚥下の直前直後、飲む音）と会話では M3 の方が多め。M3 の誤検出 23 回のうち 9 回が water の非嚥下区間。
- 陽性窓の割合は 3〜4% で同程度。誤検出率の差は陽性を出し続けた結果ではない。常時陽性の参照がどちらの数字より低いという 0011 の既知の弱点は M1 と M3 で同じ。

### そのまま比べられない点

- 評価側の大きさが半分（嚥下 30、1 収集日）。検出率の 1 回分は M1 の 1.4 ポイントに対し M3 では 3.3 ポイント。誤検出率は非嚥下 19 分で数えている。
- 評価側が 1 日分（0032）なので、M1 で見えた「日をまたぐ揺れ」は M3 では 1 回しか試していない。M3 の学習側は 2 セットとも同じ日。
- 構成 J は手法が違う（`docs/evaluation.md` 28 行目からの記録した逸脱、0034）。手法をそろえた比較は構成 R と M1 の間で、R でも検出率 1.000、誤検出 1.29 回/分。
- M2（検出器で `meal` を通し記録、0027: 0.150、2.03 回/分）は条件が食事の通し記録なのでここには並べない。

### 動作の密度の違い（人の指摘 10/13: M1 の方がイベントの間隔が狭く、誤検出が多めに出ていないか）

誤検出率は非嚥下の分数で割るが、誤検出の多くは咳・首の動き・発話の動作に付くので、動作の密度が違えば分母が同じでも回数が変わる。評価側の密度を数えると M1 の方が詰まっている。

| | M1（評価側、14 本） | M3（評価側、7 本） |
|---|---|---|
| 非嚥下の動作 `t`+`c`+`n` | 106 回 / 39.70 分 = 2.67 回/分（talk 46、neck 37、cough 23） | 33 回 / 19.36 分 = 1.70 回/分（talk 12、neck 11、cough 10） |
| 嚥下 `s` | 69 回（1.74 回/分） | 30 回（1.55 回/分） |

動作 1 回あたりの誤検出（その条件のセッションの誤検出 ÷ 動作の数。個別の突き合わせではない粗い値。M3 は構成 J）:

| 条件 | M1 | M3 構成 J |
|---|---|---|
| cough | 20 / 23 = 0.87 | 0 / 10 = 0.00 |
| neck | 17 / 37 = 0.46 | 5 / 11 = 0.45 |
| talk | 8 / 46 = 0.17 | 4 / 12 = 0.33 |
| water（嚥下 1 回あたり、非嚥下区間の誤検出） | 11 / 44 = 0.25 | 9 / 21 = 0.43 |
| saliva（同上） | 16 / 24 = 0.67 | 5 / 9 = 0.56 |

- 密度をそろえても残る改善は咳（1 回あたり 0.87 → 0）。首の動きは同じ程度。発話と水の嚥下まわりは動作 1 回あたりでは M3 の方が多め。
- 合算の「M3 は誤検出が 4 割少ない（1.99 → 1.19 回/分）」は密度の差で膨らんでいる。M1 と同じ密度なら M3 の誤検出率は 1.19 回/分より上に出ると見るのが妥当。
- 検出率（見逃し 15 → 0）と咳の改善は密度の影響を受けない。
- M1 の 0017 にある「咳のマーカーの 48% に誤検出が付く」のような動作ごとの突き合わせは、M3 側では出していない（出すなら #41 の前に学習側・評価側の採点結果からではなく、記録の手順を変えずに後から数えられる。評価側の確率は保存していないので、数えるなら再現の実行が要る）。

## #38 の続き（LED の RPC・PD 電源・arduino-cli）の plan

- 人の合図（10/13）で着手。plan の素案と Codex の plan レビューは subagent（opus）。UNO Q には ssh が届かなかった（名前も IP も応答なし。電源が切れていると思われる）ので、
  RPC の仕組み・LED・numpy の実機の確認は実装の最初の読み取りの手順（R0）に回し、plan では「見込み（確かめていない）」と書く。
  見込み: `arduino-router` が UNIX ソケットで MessagePack-RPC を仲立ちし、MCU 側は `Arduino_RouterBridge` の `Bridge.provide` で関数を公開する。PC の arduino-cli は 1.5.1、UNO Q のコアは未導入（索引に `arduino:zephyr` 1.0.0）。FQBN は `arduino:zephyr:unoq` の見込み。
  書き込みは USB の adb 越しの見込み（A3 で確かめる）。副作用: `arduino-cli lib search` で PC の索引のキャッシュだけが更新された。
- 1 回目（fresh、PLAN-SHA `b5da59363b6ce6d0`）: 制約 CONCERN 1・評価 LGTM・設計 CONCERN 2、BLOCKING なし。
- 人の決定（10/13）: D1 Linux 側のコードは `device/unoq/` に置き、決めたファイルだけを rsync で UNO Q の `~/zaitaku-mealpace-device/` に配る（常駐させない。0035 に記録。0028「UNO Q 側にプログラムを置かない」は記録の経路の決まりという読みも 0035）。
  D1b CLAUDE.md の「置かず」の文言は M4 で人が直す。D2 素の MessagePack-RPC で router のソケットを呼ぶ。D3 版は UNO Q の上の版に合わせる（分からなければコア 1.0.0・RouterBridge 0.4.3）。
  D4 名前はスケッチ `firmware/unoq_mcu/`、`build-unoq`、`deploy-unoq`、`zm_set_led`。D5 PD 電源の 60 秒のセッションは `data/raw/trial-throat/` へ。D6 MCU 側の RGB LED の 1 色。
  D7 UNO Q での 1 窓の計算時間の実測は M4 に回す（numpy・librosa を UNO Q に入れるかは M4 の設計と一緒に決める）。D8 `device/` を edit-gate の対象に入れる（hook の変更は人が承認する別コミット）。
  CONCERN 3 件は採用（P2 に `--subject self`、UNO Q の実行は `python3 -B`、消灯を送るのは `bench` だけ）。
- 再レビュー（resume、同じスレッド、PLAN-SHA `fa908f0da6355c58`）: 3 面 LGTM、残る CONCERN なし。メインが plan ファイルへコピーし `plan-approve.sh` を通した（10/13）。Issue #38 のコメントに全文（折りたたみ）。
- 実装は subagent（opus）。順: R0（UNO Q の読み取り。電源が要る）→ PC にコアとライブラリ → 空のスケッチ → `firmware/unoq_mcu/`・CMake・`device/unoq/`・テスト → 書き込み（USB-C 直挿し）→ 配る → LED と往復の遅れ（人が目で見る）→ PD 電源（人が配線）→ 音声が無いことの確かめ → 0035・unoq-setup。
  UNO Q に届かない間は PC 側の作業だけを進め、実機の手順は人が電源を入れてから。

## #38（続き）R0 と PC 側の実装（subagent）

- R0（10/13 06:45 JST、読み取りだけ。UNO Q は UTC で 10/12 21:45）: 分かれ道 (a)。見込みとの違いは無く plan の直しは要らない。
  - Debian 13、カーネル 7.0.0。arduino のグループは adm・dialout・sudo・audio・docker・gpiod など。
  - `arduino-router.service` が active（`--unix-port /var/run/arduino-router.sock --serial-port /dev/ttyHS1 --serial-baudrate 115200`）。ソケットは `srw-rw-rw- root` で arduino から開ける。
    ほかに arduino-app-cli.service（:8800）、arduino-router-serial、cloud-connector、docker が動いている。router の journal は内部メソッドの登録とシリアルの open だけ。
  - 基板の上: arduino-cli 1.5.1、arduino-app-cli 0.13.0、arduino-router 0.10.0（dpkg）。コア zephyr 1.0.0、Arduino_RouterBridge 0.4.3、Arduino_RPClite 0.3.1、MsgPack 0.4.2。Python 3.13.5。msgpack・numpy は無い。
  - App Lab のアプリは examples だけ（uninitialized）。既定のアプリは無い。
  - `/sys/class/leds`: mmc0::、unoq:{bt-blue2, panic-red2, user-blue1, user-green1, user-red1, wlan-green2}（Linux 側。使わない）。
  - rfkill0 soft=1、Bluetooth は Powered: no（無効のまま）。
- PC: コア `arduino:zephyr@1.0.0` と `Arduino_RouterBridge@0.4.3` を入れた（基板の上の版と同じ。D3）。依存の RPClite は 0.3.0 → 0.3.1。FQBN は `arduino:zephyr:unoq`（`board listall`）。
  variant `arduino_uno_q_stm32u585xx` の LED は LED3_R/G/B（PH10/11/12）と LED4_R/G/B、LED_BUILTIN は PH10。極性は dts が ACTIVE_LOW、ピン表の旗は 0 で、LOW で点く見込み（実機で確かめる）。
  書き込みは platform.txt の `tools.remoteocd.upload.pattern`（adb のシリアル番号で基板の上の openocd を動かす）。network 用（`remoteocd_network`、パスワードの欄あり）もある。`board list` には今は network の `192.168.11.22` だけ（USB は未接続）。
- ビルド: 空のスケッチ 73,396 B（9%）、`unoq_mcu` 89,280 B（11%、警告なし）。既定の `SKETCH_NAME` の FQBN は今までどおり。
- 足したもの: `firmware/unoq_mcu/`（`unoq_mcu.ino`、`led_out.h/.cpp`、`rpc_server.h/.cpp`。RPC は `rpc_server.cpp` だけ。LED3 の緑 1 色、赤・青は起動時に消す。`rpc_poll()` は作らない。RouterBridge 0.4.3 は別スレッドで RPC を受けるため。ハンドラは `provide`）、
  `device/unoq/`（`mcu_rpc.py`: router のソケットへの素の MessagePack-RPC、符号化は内蔵。`led_check.py`: on / off / bench。`DEPLOY_FILES`: 2 ファイル。`test_mcu_rpc.py`: 16 件）、
  `CMakeLists.txt`（`unoq_mcu` の FQBN、`deps` に固定版の 2 行、`deploy-unoq` と `UNOQ_HOST`）、docs/decisions/0035（状態「案（実測待ち）」）。
- subagent が自分で決めたこと: `set_led` は応答の result が true でなければ `McuRpcError`。テスト 8 の socket の検査から `test_*.py` を外した（偽の router に socketpair を使う。テストは配らない）。
- テスト: device/unoq 16 件、analysis 378 件、tools 85 件 OK。`tools/format.sh` と `clang-format --dry-run`（未追跡のため別に）で差分なし。
- 残り（実機。人の作業が要る）: USB-C を PC に直につないで書き込み（4.3）→ 配る（6.3）→ LED の点灯・消灯を人が目で見る、`bench`（6.4）→ PD 電源 P1〜P4（人が配線）→ §11 の find と R0-9 → 0035 を「採用」、docs/unoq-setup.md。

## #38（続き）実機: 書き込み・配置・LED・往復の遅れ（10/13 06:00〜07:20 JST）

- 人が UNO Q の USB-C を PC に直につないだ。`arduino-cli board list` に `/dev/ttyACM0 serial "Serial Port (USB)" Arduino UNO Q arduino:zephyr:unoq`（中身は adb の USB ポート。vid 0x2341 / pid 0x0078）。
- 書き込み（4.3）: `-DPORT=/dev/ttyACM0` で `--target upload`。経路は remoteocd（adb で UNO Q の `/tmp/remoteocd/` に置き、基板の上の openocd が SWD で書く）。所要 10.3 秒、89,280 B（11%）。
  成功の行: `Cortex-M33 r0p4 processor detected`、`device idcode = 0x30076482 (STM32U57/U58xx)`、`Built target upload`。消したのはスケッチの領域だけで、ローダは書いていない（ブートローダの書き込みはしていない）。
  UNO Q の `/tmp/remoteocd/` に書き込みツールの残り 3 ファイル（flash_sketch.cfg、unoq_mcu.ino.elf-zsk.bin、zephyr-…elf。音声ではない）。消すかは人。
- 配置（6.3）: 1 回目の `deploy-unoq` は UNO Q に rsync が無く失敗（何も書かれていない）。人の決定が「tar を ssh で流す」→「rsync を入れる」と変わり、その間に subagent が tar の形で一度配置と `on` を実行した
  （置かれたファイルは同じ）。人が UNO Q に rsync 3.5.0 を入れた後、CMake と 0035 を rsync の文言に戻し（plan どおり。差分なし）、rsync で配り直した（中身が同じなので書き換えなし）。
  `~/zaitaku-mealpace-device/` は `led_check.py` 3,237 B と `mcu_rpc.py` 10,375 B の 2 つだけ（DEPLOY_FILES と一致）。`__pycache__` は無い（`python3 -B`）。
- LED（6.4、USB-C 直挿し）: `led_check.py on` → **人が LED3 の緑の点灯を確認**（LOW で点く。`led_out.cpp` の見込みどおり）。`off` → **人が消灯を確認**。
  `bench --n 100 --warmup 5`: 件数 100、**中央値 5.103 ms、95 パーセンタイル 5.239 ms、最大 5.377 ms**（ssh の外側の時間は含まない。Linux 側の Python から RPC を送って応答を受けるまで）。終わりに消灯。
- router の journal: `on`・`off`・bench は `Accepted connection` / `Connection closed by peer` だけでエラーなし。書き込み直後の MCU の起動時刻に `decoding packet: invalid packet, expected array` が 6〜14 行
  （RouterBridge が起動時にシリアルへ書く "MCU starting RPC Bridge communication" を router が読んだものという見立て。その後の RPC はすべて通る）。router の PID が R0 の 624 から 626 に変わっていた（再起動の時刻は未確認）。
- 残り: PD 電源（第 7 節、人が配線）→ §11 の find と R0-9 → 0035 を「採用」→ docs/unoq-setup.md。

## #38（続き）PD 電源 P1・P3・P2b（10/13 07:20〜 JST）

- 機器（人）: バッテリー SMARTCOBY SLIM CIO-MB20W2C-5000（5000 mAh）。USB-C は UGREEN の USB-C → 3.5 mm オーディオ変換アダプタ（DAC 搭載、PD 60 W パススルー、ASIN B0CJXWJ596。`lsusb` では `2b89:64ed UGREEN CM721 USB Audio`）。
  plan のハブではなく、このアダプタの PD の入口にバッテリーをつなぎ、3.5 mm に SH-12JK を挿す構成。
- P1: PD 給電で起動し Wi-Fi に乗った。`arecord -l` に `card 0: Audio [UGREEN CM721 USB Audio]`（`hw:CARD=Audio`）。見えた。
- P3: `/sys/class/power_supply/` は無く電圧は読めない。今の起動のカーネルログに電圧・過電流・USB のリセットの行は無い。起動から 8.1 秒に `usb 1-1: USB disconnect, device number 2` が 1 行
  （起動の途中の数え直しと見ている。今は Device 003 で見える）。`--list-boots` では今の起動（22:18 UTC）の直前に約 9 秒だけの起動が 1 回（PD へ切り替えたときの電源の入り直しの可能性。見立て）。
  その前の起動は 22:02 で、USB-C を PC につないだときの再起動と見ている（router の PID が 624 → 626 に変わっていた理由）。
- P2b（PD 給電）: `on`・`off` とも rc=0（点灯・消灯の目視は間が短く未確認）。`bench --n 100 --warmup 5`: 中央値 5.090 ms、95 パーセンタイル 5.216 ms、最大 5.341 ms。直挿し（5.103 / 5.239 / 5.377）とほぼ同じ。
  router の warning 以上は無し。`~/zaitaku-mealpace-device` は 2 ファイルのまま、`__pycache__` 無し。
- 残り: P2（装着して 60 秒の `quiet` の記録。`throat_check.py` → `trial-throat/` へ）、P4（持ち時間。任意）、§11 の確かめ、0035 を採用、docs/unoq-setup.md。

## #38（続き）P4 持ち時間（止めた。人の判断 10/13）

- 20:39 に LCD 34% から PD 給電の待機で開始し、PC から 5 分おきに ssh の応答を記録（UNO Q には書かない）。応答は 21:19 まですべて返った（起動から 49 分）。
- 減り方: 20:39 の 34% → 21:07 の 31%（28 分で 3 ポイント。LCD の % は粗く ±1 ポイントの幅）。待機だけの消費で約 6〜7% / 時間、満充電の上限の概算は 15 時間前後。
- 21:23 にメインが記録を止めた。人の「待機だけの計測に意味はあるか」という問いかけを決定と取り違えたもので、人の判断ではない。21:25 に再開（放電は続いていたので 20:39 の 34% からの計測として継続。ssh の記録に 7 分の空きがある）。
- 22:24 の LCD は 22%。34% → 22% が 105 分（6.8 %/時。28 分の区間の 6.4 %/時とほぼ同じ）。**人の決定（22:25）: 減り方が揃ったのでここで止める。** 満充電からの待機の上限の概算は約 14〜15 時間（LCD の % の粗さによる幅あり）。
  ssh の応答は 20:39〜22:25 の全部の記録（5 分おき。21:18〜21:25 の空きを除く）で返った。UNO Q は待機のまま落ちなかった。
- M4 では音声の取り込みと推論を回しながらの持ち時間も測る（M4 の Issue の草案に入れる）。待機の値は上限の参考値。

## #38（続き）マトリクス版の書き込みと確認（10/13 22:30〜22:35 JST）

- 1 回目の USB-C の接続では PC から UNO Q が見えなかった（UNO Q の USB-C に CM721 がついたままで、UNO Q がホストのまま）。人が CM721 を外して PC に直結し、`/dev/ttyACM0`（adb）が出た。
- マトリクス版（c15f9a9）を USB（adb、remoteocd）で書き込み（88,208 B、10.2 秒）。`on` で顔は出たが、**人の目視で上下が反転**して見えた。
  `led_out.cpp` で行を上下反転して書く版（表 `shapes_unoq.h` は #32 のまま、左右はそのまま。UNO Q のマトリクスは R4 WiFi と行の向きが逆）に直して書き込み直し（10.25 秒）、**人が「これでよい」と確認**。
- `off` で全消灯（**人が確認**）。`bench --n 100 --warmup 5`（直挿し、マトリクス版）: 中央値 5.293 ms、95 パーセンタイル 5.412 ms、最大 5.471 ms（LED3 版より約 0.2 ms 遅い。マトリクスの描画の分）。
- router の journal: MCU 起動時の `expected array` の行だけ。`on`・`off`・bench の接続にエラーなし。`~/zaitaku-mealpace-device` は 2 ファイルのまま、`__pycache__` 無し。rfkill0 soft=1、Powered: no。
- 0035 の決定 7 と「確かめたこと」（遅れの表を 3 行に）、docs/unoq-setup.md を更新。device/unoq 16 件 OK、format・clang-format 差分なし。
- #38 の 3 項目はこれで全部済み（LED の RPC = マトリクスの顔、PD 電源、arduino-cli）。
- **人の決定（22:40）: 非嚥下の画（流れる波線）も #38 のうちに入れる。** RPC を状態（0 消灯 / 1 波線 / 2 顔。0018 の `led` の値）に替え、`firmware/indicator/` の波線 6 フレームと `shape_seq` を UNO Q に移す。
  受け取った状態をそのまま表示するだけで、0018 の規則（保持 2.0 秒、1.0 秒で消灯）は M4。表示ロジックは制約領域なので短い plan を書いて Codex のレビューを 1 回通す（subagent）。close はその後、人。

## #38（続き 2）波線の plan（承認）

- plan-38d（subagent）。1 回目（PLAN-SHA `b6c8cfe04a10a085`）は制約・評価 LGTM、設計 CONCERN 3（volatile では同期にならない／描画と範囲の検査にテストが無い／新しい bench は描画を含まない）。
  人の決定（10/13 夜）: A `zm_set_led` は残さず `zm_set_state(int)`（0 消灯 / 1 波線 / 2 顔。0018 の値）に一本化。B 図形と順序のコードは `firmware/indicator/`（`shapes.h`・`shape_seq`）と `firmware/detector/led_rule.h` へのシンボリックリンク（`shapes_unoq.h` は消す）。
  C サブコマンドは `wave` / `smile` / `off` / `bench`（`ok` は「許可」と読めるので採らない）。CONCERN 3 件は採用（状態は `std::atomic<uint8_t>` で共有し描画は main スレッドだけ、Arduino 非依存の `matrix_frame` と g++ のホストテスト、bench の文言「描画は含まない」）。
- 2 回目（resume、PLAN-SHA `1922dee707ff3658`）は 3 面 LGTM。メインが plan ファイルへコピーし `plan-approve.sh` を通した。#38 のコメントに全文（折りたたみ）。
- 表示の規則（0018 の保持・消灯のタイムアウト）は持たず、受け取った状態をそのまま画にする。規則は M4。0018 は変えない。

## #38（続き 2）波線と顔の版: 実装・書き込み・確認（10/13 22:45〜23:00 JST）

- 実装（subagent、plan-38d）: RPC は `zm_set_state(int)`（0 消灯 / 1 流れる波線 / 2 微笑む顔。`zm_set_led` は残さない）。`firmware/unoq_mcu/` に Arduino 非依存の `matrix_frame.h/.cpp`（範囲の検査、上下反転と 13 列の左寄せ、同じフレームを書き直さない）、
  `led_out`（状態は `std::atomic<uint8_t>` で共有、`static_assert` で lock-free、描画は `loop()` の `led_tick()` だけ）、`firmware/indicator/` の `shapes.h`・`shape_seq.h/.cpp` と `firmware/detector/led_rule.h` へのシンボリックリンク（`shapes_unoq.h` は削除）。
  `device/unoq/`: `set_state(int)`（bool と範囲外は ValueError）、`led_check.py` は `wave` / `smile` / `off` / `bench`（bench の文言「状態を渡して応答が返るまで。描画は含まない」）。
- テスト: device/unoq 19 件、`host/test_unoq_mcu.sh` 793 件、indicator のホストテスト 837 件と gen_shapes の一致、analysis 378・tools 85、すべて OK（メインの環境でも確認）。ビルド 89,972 B（リンクの .cpp と `static_assert` がビルドに入ったことを出力で確認）。
- 実機: USB（adb）で書き込み（10.4 秒）、rsync で配置（2 ファイル、`__pycache__` 無し）。`wave`: **人が確認。点滅せず流れるが、上下反転の結果、左から右へ流れて見える。人はこのままでよいとした**（0018 の追記は「左へ流れる」。UNO Q では右へ。表は変えない）。
  `smile` で顔、`off` で全消灯（**人が確認**）。`bench --n 100 --warmup 5`: 中央値 5.301 ms、95 パーセンタイル 5.426 ms、最大 5.574 ms（描画を含まない。前の数字（ハンドラの中で描画）とは範囲が違う）。
  router の journal は MCU 起動時の行だけでエラーなし。
- §11（基準 2026-10-12 21:44:57 UTC）: 音声の拡張子 0 件。新しいファイルは配った 2 つ、既知の非音声 3 つ、`/tmp/remoteocd/` の 3 つ（書き込みツールの残り。tmpfs）。rfkill0 soft=1、Powered: no。
- subagent の注意: `test_mcu_rpc.py` の機械的な置き換え 1 回を sed で行った（指示は Edit）。中身はテストで確認。
- 0035（決定 4・7、確かめたこと、遅れの表 4 行）と docs/unoq-setup.md を波線版に合わせた。0018 は変えない。
- **#38 の残り 3 項目はすべて済み。close は人。** D8（`device/` を edit-gate に入れる hook の変更）は人が承認する別コミット。

## #41 M3 の判定の材料と関門レビュー（10/13 夜）

- 人の合図で着手。#41 の本文の `--base gate-M2` は人の指示で `--base review-M2` に直した（M2 は通過しなかったので `gate-M2` は無い。0027）。
- 関門の adversarial-review（`--base review-M2`、e175e69 → f1aa122、65 コミット）: **approve、実質的な指摘なし**。焦点は検出器の側の生の音声の経路（0025 の追記の境界）、評価の分割・1 回だけ・事前登録、公開の線引き。
  Codex の環境では RPC の通信テストが sandbox で動かなかった（メインの環境では device/unoq 19 件 OK）。全文は #41 のコメント（折りたたみ）。
- 判定の材料（subagent が下書き、メインが確認）: docs/decisions/0036「判定待ち（人）」。完了の条件のうち Issue の close（#36〜#40・#42・#43・#38）、混同行列とセッション一覧、評価の分割、生の音声の確かめ、関門レビューは揃った。
  残りは人の判定（通過／IMU を足して再試験／やり直し）と M4 で削るものの判断、`gate-M3`、close。
- 注記: 構成 J の 1.19 回/分は M3 の合格線（3 回/分）を満たすが M4 の合格線（1 回/分）には届かない値。M3 で確かめた「音声を保存・送信しない」は、今あるプログラムが音声を扱わないことまで（音声を受けて推論する検出器は M4 で作る）。
- **人の判定（10/13 夜）: M3 は通過。M4 へ。** 0036 を「採用」にした。`gate-M3` と close は人。
- M4 で削るものは今は決めない（人）。人の考え: このまま進めても構成 J の 1.19 回/分では M4 の合格線（1 回/分）を通らないので、誤検出を減らす取り組みが要る。UNO Q での推論時間の計測は必要。M4 の草案の中心に据える。

## M4 の Issue の草案（メイン、10/13 深夜）

- 人の指示（#41 の close の後、席を外す間）: M4 の草案を作り、決定が要るものは推奨で埋め、何を・なぜ・どのようにを報告する。
- `docs/m4-issues-draft.md` に 7 本（M4-1〜M4-7）と、メインが決めた点 D1〜D11、人に決めてもらう点 8 つを書いた。起票は人のレビューの後。
- 主な決め方: M4 を 10/14 から前倒し（M3 が早く終わった）。評価側は `meal` 3 本以上・最後の 2 収集日（M2 と同じ）、学習に `meal` を入れる（M2 は条件別だけで学習して `meal` で 0.150）。
  装置の推論は numpy だけ（メルの行列は PC で作って定数として配る。UNO Q に入れるのは `python3-numpy` だけ）。判定の構成は M4-2 で学習側だけで選び直して 0038 に事前に固定（候補: ヒステリシスの出、塊の上限、不応期、種の平均、データ増強。多数決は採らない）。
  1 ホップは 0.25 秒のまま（0.1 秒は実測の後に別の decision）。表示の規則は Linux 側、MCU は画にするだけ。PC への出力は窓ごとの結果だけ。評価用の `meal` は検出器だけで録り、再計算の一致は学習用 `meal` の再生モードで確かめる（検出器に音声の出口を作らない）。
  削るかは 10/28 ごろに判断（候補の順: 評価用 `meal` を 3 本に絞る → 装置の推論を PC に置き換え）。
- 人のレビュー（10/13 深夜）: 承認できる水準。直す点 4 つ（評価用 `meal` の原因切り分けの材料として FEAT を有効に／48 kHz → 16 kHz の間引きを装置と PC で同じコードに／不応期は嚥下回数と衝突するので N ≤ 0.5 秒／ssh の標準出力の遅れに `python3 -u` と受信時刻の差の記録）と、D8 の表の行を (b) に揃える。
  人の決定: D1 採用（plan.md の日付は人）、D2 採用で学習用 `meal` 3 本、D8 は (b)＋FEAT、D4 は候補 1・2・4・5 と hard negative、D9・D10 採用。日程は学習用 10/18〜10/22、評価用 10/30〜11/2。人の作業（edit-gate、CLAUDE.md・AGENTS.md）は #47 の plan の前。
- 草案を直して起票（10/14 未明）: #44〜#50（Milestone M4）。草案は削除し、控えは `~/work/zaitaku-mealpace-scratch/m4issues/`。
