owhinata/zaitaku-mealpace/docs/log/2026-10-10.md

# 2026-10-10

## やったこと

- #38: UNO Q に届くようになったので、plan #38 第 2.3 節の実測 E1〜E6（実装担当の subagent）と E9（メイン）を行った。E7 (a)・E8 は行っていない（人が送信機の電源を切る操作が要る）。
  UNO Q では読み取りと標準出力への `pw-record` だけを行い、受けた PCM はファイルにせず、PC のパイプで集計値だけを出した。送信機の BD アドレスは `<addr>` と書く。
- 人が `ZERO_RUN_MS` を **100 ms** に決めた（10/10。下の「#38 構成 B の取りこぼしの規則」）。
- plan の見込みと違った点（下の 6 点）に合わせて、`tools/record.py` の起動前の検査と `tools/test_record_throat.py`、`tools/throat_check.py`（`ZERO_RUN_MS` = 100）と
  `tools/test_throat_check.py`（k8）、`docs/unoq-setup.md` を直した。plan #38 の本文は直していない。

## #38 構成 B の取りこぼしの規則（#37 の構成 B の記録の前に固定）

人が 10/10 に決めた。plan #38 第 4.2 節の規則に、閾値 `ZERO_RUN_MS` = 100 ms を入れたもの。**#37 の構成 B の記録を見る前に固定し、結果を見てから緩めない**（0030 決定 5）。

- **0 の区間**: L と R が**両方ちょうど 0** のフレームが **100 ms（48 kHz で 4,800 フレーム）以上**続く区間。`tools/throat_check.py` が回数・合計の ms・最長・位置（秒）を出す。
  - 記録の**先頭**（フレーム 0 から始まる）の区間は「先頭の 0」として別に出し、回数に入れない。末尾の区間は回数に入れる。
  - 100 ms 未満の 0 の連続の最長も参考に出す。
- **使わない目安**（録り直す）。iface が `sh12jk-nz210c-a2dp-unoq` のときだけ当てる:
  1. 0 の区間（先頭を除く）が 1 回以上。
  2. `throat.stop` が `stall`（受信が 2 秒止まった）。
  3. `throat.pipewire.link_check` が `ok` でない。
- 10/7 の 3 つの目安（overrun の行 > 0 は構成 B では `null` で当たらない、`|推定差|` > 125 ms、段差 50 ms 超）と叩きの規則は、構成 B にもそのまま当てる（数字は変えない）。
- `alsa` の iface（有線など）では 0 の区間を数えて表示するだけで、使わない目安に入れない（10/7 の規則と 10/8 の有線の 5 本の扱いは変えない）。
- 根拠（E3、静かにしたまま 60 秒、1 回）: 自然な信号の中の「両方 0」の連続の最長は 3 フレーム（0.06 ms）。先頭以外で 1 ms を超えた区間は 1 回だけで 63.8 ms（12.2 秒目。前後の振幅に変化なし）。
  100 ms はこの 63.8 ms の途切れ 1 回を許し、10/8 に見えた 3 秒級の 0 は拾う。仮の値（10 ms）なら 63.8 ms で毎回当たっていた。
- 0 の区間が「静かにしている間にだけ」出る挙動かは、60 秒 1 回では分からない（63.8 ms は静かな区間の真ん中）。構成 B の `quiet` が毎回この目安に当たるようなら、
  規則を緩めずに止まり、構成 B を `quiet` の基準に使えるかを人に渡す（plan 第 4.2 節）。
- 合成の確かめ（k8。**合成**。48 kHz・2 ch、雑音 RMS 約 60 LSB に、ちょうど 0 の区間を 5 ms・25 ms・64 ms・3 s、先頭に 200 ms、L だけ 0 の区間を 150 ms 入れた）:
  100 ms 以上の区間は 1 回（3 s、10.0 秒目）、合計 3000 ms、最長 3000 ms。先頭の 0 は 200 ms で回数に入らない。L だけ 0 の区間は数えない。100 ms 未満の最長 64.00 ms。
  構成 B の iface では使わない目安に当たり、有線の iface では当たらない。

## 実測の結果（E1〜E6・E9。plan #38 第 2.3 節）

| # | 結果 |
|---|---|
| E1 ノードの性質 | ノード `bluez_input.<addr>.2`: **`media.class` = `Stream/Output/Audio`**、`api.bluez5.profile` = `a2dp-source`・`api.bluez5.codec` = `sbc` は**ノードの props**（デバイス `bluez_card.<addr>` の props には無い）。`params.Format` は S16LE・**44100 Hz**・2 ch。`params.Props` は `mute` false、`channelVolumes` [1.0, 1.0]。`node.driver-id` はヘッドホン出力（48 kHz）で、bluez のノードは driver ではない。リンクは bluez のノード → ヘッドホン出力（WirePlumber の自動リンク）。pipe-tunnel のモジュールは無い。`pw-dump` は 0.6 秒前後、約 124 KB |
| E2 `pw-record` の引数 | 1.4.2 の `--help` に `--raw`・`-P` がある。記録中の `pw-dump` で、ストリームに `node.name` = `zm-throat-record`・`node.dont-fallback`・`node.dont-reconnect` が付いた（`Stream/Input/Audio`、48 kHz）。ストリームの入力は bluez のノードだけ |
| E3 60 秒の連続受信（静かにしたまま、1 回） | 2,970,624 フレーム（61.888 秒）、最初のバイトまで 0.62 秒、到着から見たレート 48,007 フレーム/秒。到着の間隔は中央値 21.3 ms、95 パーセンタイル 23.9 ms、最大 97.1 ms。0 の区間は上の「根拠」。1 秒ごとの RMS（L）は 23.5〜78.7（36 秒目から底が上がった。原因未確認）。「話す・叩く」の 60 秒は行っていない |
| E4 xrun | `pw-top` の ERR は前・最中・後とも、bluez のノード・ストリーム・ヘッドホン出力のどれも 0。E3 の後、UNO Q に `pw-record` のプロセスは無い |
| E5 設定の場所 | `~/.config/pipewire`・`~/.config/wireplumber/wireplumber.conf`・`/etc/pipewire`・`/etc/wireplumber` は無い。`wireplumber.conf.d/` は `90-bluez-no-seat.conf` だけで、中身はコメント 1 行と**入れ子の 5 行**（`wireplumber.profiles = { main = { monitor.bluez.seat-monitoring = disabled } }`） |
| E6 目的のノードが無いとき | 架空のノード名と同じ `-P` で起動すると、PC に届いたバイトは 0。`pw-record` は約 0.6 秒で自分から終わった（終了コード 1、「defined target not found」）。既定の入力に落ちなかった |
| E7 (a) | 行っていない（人が送信機の電源を切る操作が要る）。記録中に送信機が切れたときの止まり方は 6b の stall で見た（下） |
| E8 再接続で `N` が変わるか | 20:32 に送信機の電源を入れ直した後もノード名は `bluez_input.<addr>.2` のまま（N は変わらなかった。1 回） |
| E9 `JustWorksRepairing` | 人が適用済み（`/etc/bluetooth/main.conf`）。エージェントなしだと再ペアリングは通るが A2DP の認可が拒まれた（bluetoothd「Authentication attempt without agent」）。`bluetoothctl trust <addr>` の後は、送信機の次の試行で A2DP がつながった。**答え: `JustWorksRepairing = always` ＋ trust（1 回）でエージェントは要らない。** UNO Q の再起動の後は `bluetoothctl pairable on` と `systemctl --user restart wireplumber`（A2DP Sink の登録が戻る）が要った |

- E9 の補足（20:32）: trust 済み・エージェントなしで、送信機の電源を入れて約 2 秒で再接続した（`JustWorksRepairing = always`）。
- UNO Q に音声のファイルが無いことの確認（10/8 の方法）: 実測の開始より新しいファイルは `~/.local/state/wireplumber/stream-properties`（WirePlumber の音量の復元の状態。テキスト、音声ではない）の 1 つだけ。音声の拡張子のファイルは 0 件。

## plan の見込みと違った点とその扱い（plan #38 は直していない）

1. bluez のノードの `media.class` が `Stream/Output/Audio`（plan 第 3.3 節は `Audio/Source` を求めていた）。→ 起動前の検査と自動で探す条件を「`media.class` が `Stream/Output/Audio` か `Audio/Source`」かつ
   `api.bluez5.profile` = `a2dp-source` に直す。テストは実物の形に合わせ、`Audio/Source` も受けることを 1 件で確かめる。
2. `90-bluez-no-seat.conf` は入れ子の 5 行（plan は 1 行の形を見込んでいた）。→ 中身の検査を、コメント行と空行を除き空白を正規化した上で、期待する 5 行と一致するかを確かめる形にする（1 行の正規表現は使わない）。
3. ノードの形式のレートは 44100。→ `throat.pipewire.node_rate_hz` には 44100 が入る（`pw-record --rate 48000` は PipeWire の変換）。SBC の符号化のレート（`codec_rate_hz`）は確かめていないので `null` と理由のまま。
4. E6 では子がすぐ終わる（起動待ちのタイムアウトではなく `child-exit` の経路。安全側）。→ E7 (b) の「起動待ちのタイムアウト (b)」は架空のノードでは 10 秒より前に子が終わるので、
   実在のノードに対して子と同じ argv を起動し、10 秒後にプロセスグループへ SIGTERM を送る形に変える。
5. ssh のセッションが無いと約 10 秒で arduino の PipeWire が止まり、送信機の A2DP が切れる（`Linger=no`）。→ linger を有効にする（人が決定、メインが `loginctl enable-linger arduino` を実行）。`docs/unoq-setup.md` の設定の表に足した。
6. `pw-record` の起動で WirePlumber が `~/.local/state/wireplumber/stream-properties` を書く（音声ではない状態ファイル）。→ 音声のファイルの確認から除く（`docs/unoq-setup.md`）。

## E7 (b): 記録を止めた後に UNO Q 側の `pw-record` が残らないこと（plan #38 第 2.4 節、6b。メインが実機で、20:27〜20:33）

- 「残りなし」の確かめ方: 終了の 2 秒後に UNO Q で `pgrep -c pw-record` が 0、`pw-dump` に `node.name` = `zm-throat-record` のノードが 0。UNO Q では読み取りだけ。
- 録ったセッション（`self`）は数字（振幅）を見ずに消した。見たのは `stop`・`frames`・`link_check` だけ。

| 止め方 | 結果 | 可否 |
|---|---|---|
| 時間終了（`--duration 10`） | 残りなし | 合格 |
| Ctrl-C（SIGINT、8 秒） | `stop` = `interrupt`、`link_check` = `ok`、残りなし。1 回目はメインの手順のミス（別の PID を掴み、記録中にフォルダを消した）で無効とし、やり直した | 合格 |
| stall（記録中に送信機の電源を切る） | 25.0 秒で「受信が 2 秒止まった」の警告、`stop` = `stall`、終了コード 1、残りなし | 合格 |
| 起動待ちのタイムアウト (a) `record.py` の経路 | 1 回試したが、送信機を切るのが音の到着（約 0.6 秒）より遅れ、13.3 秒の記録の後に stall で止まった（窓に当たらず、数えない）。残りなし | 当たらず（人の決定で (b) の合格で足りるとした） |
| 起動待ちのタイムアウト (b) 止め方の仕組み | `record.py` の外で子と同じ argv を**実在のノード**に対して新しいセッションで起動し（上の「違った点」4）、10 秒後にプロセスグループへ SIGTERM。9.3 秒分を受信、終了コード 255、残りなし | 合格 |

- 人の決定（10/10）: 起動待ちのタイムアウトは (b) の合格で足りるとし、次へ進む。(a) は「1 回試して窓に当たらなかった」とだけ残す。
- **6b は合格**（どの止め方でも `pw-record` とストリームが残らなかった）。取りこぼしの規則の log はコミット済み（`5de0a4f`）なので、#37 の構成 B の正式な記録に進める（plan 第 4.3 節の 2 つの前提がそろった）。

## #37 構成 B の記録（1 回目）と切り分け: 送信機のノイズゲート

人とメインが実機で行った（21:02〜21:42）。被験者は `self`。数字は `tools/throat_check.py`（規則は上の「#38 構成 B の取りこぼしの規則」、`ZERO_RUN_MS` = 100 ms）の出力から写した。
振幅の集計（`s` の比など）はしていない。

### 記録の表（5 本。21:02〜21:14）

- 配置: 送信機は机の上（装着していない）。UNO Q まで約 50 cm で、間にノート PC。`--throat sh12jk-nz210c-a2dp-unoq --position lateral-below-cricoid`。手順は plan #38 第 8.1 節（冒頭の叩きは Enter をマイクのケースで押す）。
- セッション（`throat_check.py` の出力から。メインが転記）:
  `20261010-210231_self_quiet`（100.0 s、`o` 5、`Δ` 中央値 +30.9 ms）、`20261010-210506_self_water`（126.7 s、`s` 6・`o` 5、+94.6 ms）、
  `20261010-210813_self_cough`（87.5 s、`c` 6・`o` 5、+151.7 ms）、`20261010-211027_self_neck`（88.3 s、`n` 6・`o` 5、+151.9 ms）、
  `20261010-211233_self_talk`（83.8 s、`t` 6・`o` 5、+168.0 ms）。L と R の相関 1.000、RMS の比 0.998〜1.000。

| 条件 | overrun | 推定差 | 段差 | `link_check` | stop | 0 の区間 回数 / 合計 / 最長（先頭の 0） | 叩き 見つかった数 | 使わない目安 | 採否 |
|---|---|---|---|---|---|---|---|---|---|
| `quiet` | なし（`null`） | ±11 ms 以内 | 0 | ok | stall なし | 6 回 / 5.4 s / 1.3 s（位置 17〜33 s、装着の後） | 4 / 4 | 当たる（0 の区間） | **使わない**（0 の区間） |
| `water` | なし（`null`） | ±11 ms 以内 | 0 | ok | stall なし | 16 回 / 11.6 s / 3.8 s | 5 / 5 | 当たる（0 の区間） | **使わない**（0 の区間） |
| `cough` | なし（`null`） | ±11 ms 以内 | 0 | ok | stall なし | 13 回 / 11.5 s / 1.9 s | 5 / 5 | 当たる（0 の区間） | **使わない**（0 の区間） |
| `neck` | なし（`null`） | ±11 ms 以内 | 0 | ok | stall なし | 2 回 / 1.8 s / 1.6 s（先頭の 0 1.2 s） | 5 / 5 | 当たる（0 の区間） | **使わない**（0 の区間） |
| `talk` | なし（`null`） | ±11 ms 以内 | 0 | ok | stall なし | 11 回 / 7.9 s / 1.5 s（先頭の 0 0.7 s） | 5 / 5 | 当たる（0 の区間） | **使わない**（0 の区間） |

- 叩きの `Δ` の中央値は 5 本で **+31〜+168 ms**（音がマーカーより遅れる。無線と符号化の遅延）。有線（10/8）は −55〜−74 ms で向きが逆。50 ms を超えるので規則どおり印が付く。
  時刻の対応は受信の時刻のまま（直さない）。
- 0 の区間は、叩きの最中（1〜5 s、マイクを手に持つ）と動作の最中（`water` の 50〜120 s など）、`quiet` の装着後の静かな間に集まっていた。
  E3（机の上・静か・60 s）の 63.8 ms 1 回とは様子が違う。

### 切り分けの表（各 60 s、`self`。振幅は見ずに削除）

| # | 時刻 | 配置と動作 | 0 の区間 | 読み |
|---|---|---|---|---|
| (1) | 21:19 | 装着・静止（UNO Q は約 50 cm、間に PC） | 0 回 | 装着だけでは出ない |
| (2) | 21:21 | 装着・首と体を動かす（同じ配置） | 0 回 | 動きだけでは出ない |
| (3) | 21:22 | 送信機を手で覆う・マイクを手に持つ・腕を喉元へ上げる（同じ配置） | 11 回 / 合計 9.2 s / 最長 3.2 s | 出た（この時点では遮蔽と見た） |
| (4) | 21:25 | 送信機と UNO Q を間に何も置かず 20〜30 cm の見通しに並べ、(3) と同じ動作 | 0 回 | 出なかった |
| 録り直しの `quiet` | 21:28 | UNO Q は送信機のすぐ横（遮れない配置）。5 条件の録り直しの 1 本目 | 2 回 / 合計 3.4 s（1.4 s・4.8 s、叩きの最中） | 使わない目安に当たる → **使わない**。叩き 5 / 5、`Δ` +74 ms。`t` の誤入力 1 件（無害） |
| (5) | 21:34 | 同じ配置で、マイクをノート PC のケースに強く打ち付ける・大声（手は送信機と UNO Q から離す。人の申告: PC のケースを叩いた） | 0 回（RMS 最大 5044） | 大きな音も、マイクの PC への接近も原因でない |
| 読み取りの停止 | 21:37 | PC 側の読み取りを 8 s 目に 1.5 s 止める | 止めた位置と無関係に 2〜9 s・12〜20 s に長い 0 | PC 側の詰まりでない。その間、人がマイク面に触れていた可能性 |
| (6) | 21:41 | マイク面を指でふさぐ 10 s ↔ 離す 10 s を 3 回 | ふさいだ間に 0 | 1 秒ごとの RMS(L) と 0 の割合が対応。RMS ≤ 9 の秒は 0 が 70〜100%、RMS ≥ 20 の秒は 0%。先頭 3.4 s も 0（最初からふさいでいた） |

- RMS は L を 16 bit で読んだ値（LSB）。波形とサンプル値は貼らない。

### 結論

- **送信機 NZ-W210C は、入力がごく小さいとき（RMS おおよそ 10〜15 LSB 未満、L を 16 bit で読んだ値）に無音（ちょうど 0）を送るノイズゲートを持つ。**
- 0 の区間は、PipeWire の補填でも、Bluetooth の途切れでも、PC 側の詰まりでもない。大きな音（(5)）は無関係。
- (3) の遮蔽は、同時にマイク面に触れていた可能性があり、切り分けられていない。(4) で 0 回だった理由も分けられていない。

### 影響と扱い

- 構成 B の `quiet` は、装着して静止すると入力が小さくてゲートが閉じ、0 が並ぶ（1 回目の `quiet` は 17〜33 s）。
  10/7 の規則の条件 3 の「静止の中央値」と、条件 2 の `quiet` の四分位範囲が 0 に寄り、条件 2・3 と経路の差（20%）の基準が成り立たない。
- plan #38 第 4.2 節の「0 の区間が静かな間にだけ出る場合は、規則を緩めずに止まり、構成 B を `quiet` の基準に使えるかを人に渡す」に当たる。
  そのため振幅の集計（plan 第 8.2 節）は行っていない。規則も変えていない。採否は人。1 回目の 5 本は「使わない」。
- **人の決定（10/10）**: 送信機の取扱説明書で、ノイズゲート・無音検出・オートミュートの設定の有無を確かめてから決める。
  - 切れるなら切って、5 条件を録り直す。
  - 切れなければ、構成 B を記録の経路から外して有線で進むか、ゲートを前提に規則を変えるか（docs/decisions に記録して Codex のレビュー）を人が決める。

### 配置の知見（M4 で装置を食卓に置くときの条件の候補。断定しない）

- 送信機と UNO Q の間に PC や手・腕が入る配置で (3) の途切れが出たが、(6) の結果から、原因が遮蔽かゲートかの切り分けは済んでいない。
  見通しを確保する配置を勧めるにとどめる。

### 置き場所

- 使わない 6 本（21:02〜21:14 の 5 本と 21:28 の録り直しの `quiet`）は `data/raw/trial-throat/` に置いた。消すかは人。
- 切り分けの (1)〜(6) と読み取りの停止の記録は、振幅を見ずに消した。

## 人の決定（10/10 夜）: 構成 B は記録の経路から外し、有線で進む

- 取扱説明書（5. 主な仕様、6. 注意事項）にノイズゲート・無音検出・オートミュートの記述と切替は無い（Bluetooth V2.1 EDR、A2DP、Class 1、通信距離約 20 m、
  送信出力 +5 dBm、周波数特性 25〜19 kHz（NZ-W210C））。ゲートは送信機の内部の挙動で、こちらから変えられない。
- 人の決定: **構成 B（NZ-W210C → UNO Q の A2DP）は咽喉マイクの学習用の記録に使わない。#39 以降の記録と M4 の検出器は有線（UNO Q の USB オーディオアダプタ、0028）で進める。**
  理由: 静かな区間が無音に置き換わり、10/7 の規則の `quiet` の基準（静止の中央値、IQR）が成り立たず、有線と同じ規則で比べられない。学習データとしても静かな区間の情報が失われる。
  遅延も +31〜+168 ms と大きく、記録ごとに揺れる。
- #37 の「経路の差」（有線の中央値に対する相対差 20% 以内）は、**判定できない（送信機のゲートで構成 B の `quiet` が成り立たない）**として記録する。規則は変えない。
- `record.py`・`throat_check.py` の構成 B の実装（0030、`3d000d0`・`5de0a4f`）と UNO Q の設定（`docs/unoq-setup.md`）は残す（消さない）。「動いたが記録には使わない」経路として、
  0025 への追記（#42）でまとめて記録する。本人試用で無線が要るときは、ゲートのない送信機を別に探す（人）。
- 使わない 6 本（`data/raw/trial-throat/` の 10/10 の分）を消すかは人。

## 人の判定（10/10 夜）: #37 有線で嚥下の信号は見えた

- 有線（`sh12jk-wired-unoq-usbaudio`）の 5 本（10/8。docs/log/2026-10-08.md）について、人が **「信号が見えた」と判定**した。M3 の (1)（docs/decisions/0024）の判定。
  根拠は 10/7 に固定した 3 条件をすべて満たすこと（`s` の振幅の比の中央値 137.66、`s` の IQR が `quiet` の IQR と重ならない、6 回のうち 6 回）。
  叩きの `Δ` が 50 ms を超えた印（−55〜−74 ms）は付いたままで、人がそのまま判定した。
- 経路の差は「判定できない」（上の人の決定）。#37 の完了の条件のうち NZ-210C 経由の表は、構成 B の 1 回目（使わない）の表で代える。#37 を閉じるのは人。

## 次

1. #42: docs/decisions/0025 の追記（構成 A は使わない、構成 B は動いたがノイズゲートで記録に使わない、M3・M4 は有線、無線リンクと検出器の境界）。plan と Codex のレビュー。
2. #38b（LED の RPC・PD 電源・arduino-cli）の plan。
3. #39: 記録の経路は有線（`sh12jk-wired-unoq-usbaudio`）。信号の有無の判定（#37、人）の後に着手。
