owhinata/zaitaku-mealpace/docs/log/2026-10-09.md

# 2026-10-09

## やったこと

- #38: plan #38（構成 B を `record.py --throat` の記録の経路にする）を Codex の 3 面レビュー（LGTM）の後に実装した（plan 第 11 節 5・6・7）。実装は main。
  - `tools/record.py`: iface ごとに子の種類を持たせた（`alsa` = `arecord`、`a2dp` = `pw-record`）。`sh12jk-nz210c-a2dp-unoq` の子は ssh 越しの
    `pw-record --target <ノード> --rate 48000 --channels 2 --format s16 -P '{ node.dont-reconnect = true node.dont-fallback = true node.name = zm-throat-record }' --raw -`（出力先は標準出力だけ）。
    `--throat-device` はこの iface では `bluez_input.<XX_XX_XX_XX_XX_XX>.<番号>` だけを受け、USB の iface では今までどおり hw / plughw だけを受ける（iface と形を結ぶ）。
    省けば `pw-dump` から条件に合うノードがちょうど 1 つのときだけそれを使う（`device_source` = `auto`）。
  - 子を起動する前に 1 回の ssh で、ユーザーの PipeWire・WirePlumber の設定、ノードの有無・`media.class`・プロファイル・ミュート、他の取り込みのストリーム、pipe-tunnel のモジュールを
    読み取りで確かめ、当たれば記録を始めない（asoundrc の検査と `amixer` は構成 B では行わない）。起動後に `pw-dump` をもう 1 回読み、`zm-throat-record` のストリームが
    目的のノードにだけつながっているかを `throat.pipewire.link_check`（`ok` / `ng` / `error`）に残す。受信が 2 秒止まったら記録を止める（`stop` = `stall`、終了コード 1）。
    `alsa` の経路（`arecord` の引数、asoundrc の検査、ミキサー、`meta.json` のキー）は変えていない。
  - `tools/throat_check.py`: L と R が両方ちょうど 0 のフレームが `ZERO_RUN_MS` 以上続く区間（0 の区間）を数えて出す。先頭の区間は「先頭の 0」として別に出し、回数に入れない。
    構成 B の iface だけ、0 の区間が 1 回以上・`stop` = `stall`・`link_check` が `ok` でない、を使わない目安に入れる。有線の iface では表示だけ（10/7 の規則と 10/8 の有線の 5 本の扱いは変えない）。
  - テスト（合成。ssh・実機を使わない）: `tools/test_record_throat.py` に h12〜h17、`tools/test_throat_check.py` に k8・k9。tools のテストは 75 → 84（全部通る）。analysis は 261（変わらない）。
  - 文書: `docs/data-schema.md`（構成 B の iface・`device` の形・`device_source`・`stall`・`throat.pipewire`・`meta.json` の例）、docs/decisions/0029 に 0030 への 1 行、
    `docs/unoq-setup.md`（新規。UNO Q に残した設定、構成 B の接続の手順、音声のファイルの確かめ方）。
- 実測 E1〜E9（plan 第 2.3 節）を始めようとしたが、UNO Q に届かなかった（下）。

## 分かったこと

- **E1〜E9 は全部未実測。** UNO Q に届かなかった（ssh は `No route to host`、ping に応答なし、ARP も返らない、`unoq.local` も引けない。PC は同じ網にいてルータには届く）。
  plan を書いた 10/8 の状況（plan 第 2.1 節）が続いた。UNO Q の電源が切れているか、ネットワークから外れている見込み（確かめていない）。
  UNO Q では何も実行していない（読み取りも含めて）ので、音声のファイルの確かめも行っていない。
- よって、`pw-record` の `-P` で `node.name` がストリームに付くか（E2）、0 の区間の長さと出方（E3）、`/etc/pipewire` の配布元のファイル（E5）、ノードが無いとき既定の入力に落ちないか（E6）、
  `JustWorksRepairing` の適用（E9）は分からないまま。`-P` の固定の文字列は plan のとおりに実装した。
- **`ZERO_RUN_MS` = 10 ms は仮置き。** 合成テスト（k8）と疎通にだけ使う。E3 → 人の決定 → 第 4 節の規則の log のコミットが済むまで、#37 の構成 B の正式な記録には進まない（plan 第 4.3 節、0030 決定 5）。
  第 4 節の規則はこの log にはまだ固定しない（E3 の後に人が決めてから別に書く）。
- 合成の確かめ（k8。**合成**。48 kHz・2 ch、雑音 RMS 約 60 LSB に、ちょうど 0 の区間を 5 ms・25 ms・3 s、先頭に 200 ms、L だけ 0 の区間を 50 ms 入れた）:
  10 ms 以上の区間は 2 回、合計 3025 ms、最長 3000 ms、位置 5.0 秒・10.0 秒。先頭の 0 は 200 ms で回数に入らない。L だけ 0 の区間は数えない。閾値未満の 0 の連続の最長 5.00 ms。
  構成 B の iface では使わない目安に当たり、有線の iface では当たらない。
- 実機で確かめていないこと（実装の前提）: `~/.config/wireplumber/wireplumber.conf.d/90-bluez-no-seat.conf` の実物が、許す 1 行の形に合うか（合わなければ起動前の確認で止まる）。
  `pw-dump` に `params.Format`・`node.driver-id` が無い場合は `node_rate_hz`・`driver` が `null` になる（PC の `pw-dump` では使われていないノードの `Format` が空だった）。疎通で確かめる。

## Issue #38 の本文との違い（plan #38 第 0 節）

- ブランチ: 本文は試用ブランチ `trial/throat-mic`。#28 は 10/4 に判定済みなので、#36 と同じく main で行った（0024）。
- 取り出しのコマンド: 本文は `arecord`。bluez のノードは PipeWire にあり ALSA の PCM としては出ていない（10/8 の試し）ので `pw-record`。
- 「UNO Q を通した生の音声の記録を仕組みとして作らない（0025。要るなら先に `docs/decisions/` に記録）」: この plan はその仕組みを作るので、先に docs/decisions/0030 を書き、人が採用した（10/8）。
- #38 の他の項目（USB オーディオの確認の整理、LED の RPC、PD 電源、arduino-cli）は、plan #38 では確かめの手順（第 10 節）だけを書き、実装は次の plan **#38b** に分けた（人の決定 Q11）。
  これらは #38 の未完として残る。

## 次

1. UNO Q の電源とネットワークを戻し（人）、送信機の電源を入れて、実測 E1〜E9（plan 第 2.3 節）。UNO Q では読み取りと標準出力への `pw-record` だけ。
2. E3 の数字を見て、人が `ZERO_RUN_MS` と規則を決める。
3. 第 4 節の規則（決めた値を含む）を log に書き、メインがコミットする（構成 B の記録の前）。
4. 実測 E7 (b)（記録を止めた後に UNO Q 側の `pw-record` が残らないこと。plan 第 2.4 節、6b）。どれかで残れば先に進まない。
5. 疎通（構成 B で `--cond quiet --duration 10` を 1 回、`throat_check.py`、数字だけを log に書いてフォルダは消す）。UNO Q に音声のファイルが無いことを確かめる。
6. #37 の構成 B の 5 条件の記録（人）と、集計・経路の差（エージェント。plan 第 8 節）。
7. #38b（LED の RPC、PD 電源、arduino-cli）の plan。
