owhinata/zaitaku-mealpace/docs/log/2026-10-08.md

# 2026-10-08

この日の #37 の集計は docs/log/2026-10-07.md「#36 判定の条件（#37 の記録の前に固定）」の規則による（規則は変えていない）。

## やったこと

- #37 の有線の経路（`sh12jk-wired-unoq-usbaudio`）で 5 条件を録った（人）。記録は `data/raw/trial-throat/` の 6 フォルダ（1 本は中断）。NZ-210C 経由はまだ録っていない（変換ケーブル待ち）。
- 採否は人が数字（振幅の比）を見る前に決めた（10/8）。中断の 1 本を使わず、5 本を使う。
- `tools/throat_check.py` を 6 本に当て、使い捨ての集計 `~/work/zaitaku-mealpace-scratch/issue36/aggregate_throat.py` を有線の経路で 1 回だけ走らせた
  （`--path wired --quiet <quiet> --sessions <water> <cough> <neck> <talk>`）。出力の全文は貼らず、集計値を下に写す。スクリプトは直していない。
- `s` の 1 回分の包絡を SVG に描いた（下の「波形の切り出し」）。
- #38: NZ-210C の直接ペアリング（A2DP）を、plan の前に人とメインが実機で試した（下の「#38 NZ-210C の直接ペアリング（構成 B）の試し」）。推論・特徴量のコードと `record.py` には触れていない。

## 分かったこと

- 有線の 5 本は overrun の行 0、段差 0、使わない目安に当たらない。叩きは 5 本とも 5 / 5 回見つかった。
- 叩きの `Δ` の中央値が 5 本とも −55〜−74 ms で、判断の 50 ms を超えた（音がマーカーより先に立ち上がる向き）。人の決定で、対応は直さず、表に印を付けて使う（下の「叩きの Δ」）。
- 判定の条件 1〜3 の値は下の「判定の条件に照らした結果」。**信号の有無の判定は人**。経路の差は NZ-210C 経由を録ってから。
- クロックの差（受信の時刻による対応の傾き）は −10.9〜−26.6 ppm で、10/7 の実測（180 秒、−8.1 ppm）より大きめに出た。原因は確かめていない。
- #38: **構成 B（送信機 → UNO Q の A2DP シンク）は動いた**（SBC、`pw-record` の標準出力に 48 kHz・2 ch）。要ったのは Class of Device を Audio/Video に、lightdm 側の bluez の監視を止める、arduino 側の seat-monitoring を disabled、鍵を消してからの承認。
- #38: 12 秒の確認の途中に 3 秒ちょうど 0 の区間があった（原因未確認）。構成 A は試していない。UNO Q のホームと `/tmp` に音声のファイルは無い。

## 人の決定（10/8）: NZ-210C は構成 B だけを使い、構成 A は使わない

- 構成 B（送信機 NZ-W210C → UNO Q の A2DP シンク）が動いたので（下の #38 の節）、構成 A（送信機 → 受信機 NZ-W210R → 変換ケーブル → UNO Q の USB オーディオ）は**使わない**。
  受信機の 6.3 mm 出力を 3.5 mm の入力へつなぐ変換ケーブルは手元に無く、手配もしない。
- #37 の「経路の差」（有線の中央値に対する相対差で 20% 以内。10/7 に固定）の比べる相手は、`sh12jk-nz210c-rx-unoq-usbaudio`（構成 A）から
  `sh12jk-nz210c-a2dp-unoq`（構成 B）に替える。数字（20%）と計算（比だけで比べる）は変えない。経路の名前だけの置き換えで、構成 B の記録はこの決定より後に録る。
- 構成 B で `self` を録るには、`tools/record.py` の `--throat` の子プロセスを `pw-record`（PipeWire のノード）にも向けられるようにする必要がある（今は `arecord` と `hw` / `plughw` だけ。
  10/7 の adversarial-review で絞った検査を広げることになるので、#38 の plan で Codex のレビューを通す）。
- docs/decisions/0025 への追記（構成 A/B、無線リンクと検出器の境界）は #42 で行う。この決定はその材料。

## 次

- #38 の plan: `record.py` の `--throat` を構成 B（`pw-record`、`sh12jk-nz210c-a2dp-unoq`）に対応させる（`--throat-device` の検査の広げ方、取りこぼしの検査、毎回のペアリングの手順、エージェントの起動、
  `JustWorksRepairing`、3 秒の 0 の区間の切り分け）。残りの項目（PD 電源、LED の RPC、arduino-cli）も同じ plan か別の plan で。
- 人: `JustWorksRepairing = always` を適用し、送信機の電源を入れ直すだけで再接続できるかを確かめる。
- 人: 構成 B で #37 の 5 条件を録る（`record.py` の対応の後。同じ手順、冒頭の叩き、記録の直後に `throat_check.py`、すぐに `data/raw/trial-throat/` へ移す）。
- エージェント: 構成 B の集計（同じスクリプトを 1 回）と、経路の差 `|s の比の中央値（B） − s の比の中央値（有線）| ÷ s の比の中央値（有線）` の計算（`--compare`）。
- 人: 信号の有無の判定（経路ごと）と経路の差の判定。

## #37 有線（`sh12jk-wired-unoq-usbaudio`）

Issue #37。被験者 `self`。UNO Q に挿した USB オーディオアダプタから `arecord` の生 PCM を ssh で PC に流す経路（docs/decisions/0028・0029）。
`meta.json` の装着の値は 6 本とも `position` = `midline-below-thyroid`、`band` = `elastic-25mm`、`firmware_sha` = `25af568`（PC 側の HEAD）。
`position` は `record.py` の既定値のままで、実際の装着位置は気管の脇・輪状軟骨の直下（人の申告、10/8）。以後の咽喉マイクの記録は `--position lateral-below-cricoid` で指定する。
ミキサーは 6 本とも `Mic Capture` 58（+4.00 dB、on）。

### 記録の表

`throat_check.py`（`--tap-mode enter`）の出力から写した。推定差は `meta.json` の値（到着から再計算した診断値を括弧に）。叩きの `Δ` に「印」とあるのは `|Δ の中央値|` > 50 ms。

| セッション | 条件 | 長さ（フレーム / 秒） | 終わり方 | マーカー | overrun の行 | 推定差（フレーム） | 段差 | 叩き 見つかった数 / `Δ` 中央値 | 使わない目安 | 採否と理由 |
|---|---|---|---|---|---|---|---|---|---|---|
| `20261008-203539_self_quiet` | `quiet` | 408,000 / 8.500 | **中断**（Ctrl-C、8.5 秒） | なし | 0 | −273（−288、−6 ms） | 0 | 0 / 0（叩きなし） | 当たらない（叩き 3 回未満の印） | **使わない**（中断。人の決定） |
| `20261008-203608_self_quiet` | `quiet` | 4,806,000 / 100.125 | 時間（`--duration`） | `o`（tap）5 | 0 | −499（−528、−11 ms） | 0 | 5 / 5、−55.2 ms（**印**） | 当たらない | 使う（`Δ` に印） |
| `20261008-203930_self_water` | `water` | 5,226,000 / 108.875 | Ctrl-C | `o`（tap）5、`s` 6 | 0 | −689（−720、−15 ms） | 0 | 5 / 5、−72.7 ms（**印**） | 当たらない | 使う（`Δ` に印） |
| `20261008-204146_self_cough` | `cough` | 3,978,000 / 82.875 | Ctrl-C | `o`（tap）5、`c` 6 | 0 | +164（+144、+3 ms） | 0 | 5 / 5、−66.2 ms（**印**） | 当たらない | 使う（`Δ` に印） |
| `20261008-204335_self_neck` | `neck` | 4,380,000 / 91.250 | Ctrl-C | `o`（tap）5、`n` 6 | 0 | −221（−240、−5 ms） | 0 | 5 / 5、−73.7 ms（**印**） | 当たらない | 使う（`Δ` に印） |
| `20261008-204532_self_talk` | `talk` | 3,930,000 / 81.875 | Ctrl-C | `o`（tap）5、`t` 6 | 0 | −301（−336、−7 ms） | 0 | 5 / 5、−70.9 ms（**印**） | 当たらない | 使う（`Δ` に印） |

- 録音の取りこぼし（overrun の行）は 6 本とも 0。
- 長さは Issue の目安（`quiet` 60 秒、`water` 120 秒、`cough`・`neck` 90 秒、`talk` 60 秒）と違う。`quiet` は 100 秒、ほかは人が Ctrl-C で止めた。どの本もマーカーは 6 回ずつそろっている。

時刻の対応と L / R（`throat_check.py`）:

| セッション | 到着の行 | `c0` | クロックの差 | 残差 中央値 / 95 パーセンタイル / 最大 | L と R の相関 / RMS の比（R / L） | 叩きの `Δ` 四分位範囲 / 最小 / 最大 |
|---|---|---|---|---|---|---|
| `203539_quiet`（中断） | 68 | −141.0 ms | 0（20 秒未満） | 8.0 / 17.0 / 52.0 ms | 1.000 / 1.000 | — |
| `203608_quiet` | 801 | −146.5 ms | −10.9 ppm | 8.7 / 20.4 / 42.7 ms | 1.000 / 1.000 | −59.9〜−34.4 / −76.5 / −32.5 ms |
| `203930_water` | 871 | −138.4 ms | −26.6 ppm | 8.4 / 28.7 / 173.8 ms | 1.000 / 1.000 | −75.8〜−64.0 / −113.3 / +50.3 ms |
| `204146_cough` | 663 | −132.0 ms | −11.8 ppm | 8.1 / 18.9 / 39.1 ms | 1.000 / 1.000 | −97.4〜−40.7 / −111.8 / +130.9 ms |
| `204335_neck` | 730 | −140.1 ms | −18.3 ppm | 8.5 / 19.5 / 71.3 ms | 1.000 / 1.000 | −153.0〜−48.4 / −208.7 / −33.9 ms |
| `204532_talk` | 655 | −140.2 ms | −22.5 ppm | 8.4 / 19.8 / 80.7 ms | 1.000 / 1.000 | −90.2〜−53.2 / −239.3 / −47.6 ms |

- L と R は 6 本とも相関 1.000、RMS の比 1.000（10/7 の実測と同じく、L と R は同じ値）。
- クロックの差は −10.9〜−26.6 ppm で、10/7 の実測（180 秒の連続受信、−8.1 ppm）より大きめに出た。記録の長さは 82〜109 秒。原因は確かめていない（推測しない）。
- `water` の残差の最大 173.8 ms は、到着の遅れ（下側の包絡からの上振れ）の 1 回。段差（区間の最小の差 50 ms 超）には当たっていない。

### 叩きの Δ が 50 ms を超えた件

- 5 本とも叩きは 5 / 5 回見つかったが、`Δ` の中央値が −55.2〜−73.7 ms で、判断の `|Δ の中央値|` ≤ 50 ms を外れた。向き（負。音の立ち上がりがマーカーの `t_ms` より前）と大きさは 5 本でそろっている。
  合成の確かめ（10/7。鍵盤の遅れ 3 ms で `Δ` −11 ms）から、包絡の窓による前への出方は 10 ms 程度で、残りの大半は Enter のキーが押されてから `record.py` が `t_ms` を取るまでの遅れと見られる（確かめていない）。
- 人の決定（10/8）: 規則のとおり `Δ` で対応を直さない。表に「`Δ` が 50 ms 超」の印を付けて使う。
- 判定の条件の窓（`(t, t + 1.5 s]`、`[t − 0.5 s, t + 1.5 s]`）の幅に比べると約 70 ms は小さいが、影響の大きさは測っていない。

### 集計の表（有線）

`aggregate_throat.py` の出力から写した。単位は LSB（L を 16 kHz に落とした値）。比と塊は使ったマーカーごとの値の中央値（四分位範囲）と最小・最大。

静止（`20261008-203608_self_quiet` の 16 kHz の値全体。冒頭の叩きを含む）:

| 項目 | 値 |
|---|---|
| 平均 / 標準偏差 | −0.27 / 1017.16 |
| 最小 / 最大 | −42455 / 39960 |
| 包絡 中央値 / 95 パーセンタイル / 最大 | 43.35 / 516.11 / 26134.40 |
| 条件 3 の「静止の中央値」（仮のマーカーの `[t − 2 s, t + 2 s]` を合わせた範囲の包絡の中央値） | 43.29 |
| L と R の相関 / RMS の比 | 1.000 / 1.000 |

ラベルごと:

| ラベル | マーカー | 使った | 除外（端 / 別のマーカー） | 振幅の比 中央値（IQR） | 比 最小 / 最大 | 塊の長さ 中央値（IQR） | 塊 最小 / 最大 | 基準の包絡の中央値（中央値） |
|---|---|---|---|---|---|---|---|---|
| `s` | 6 | 6 | 0 / 0 | 137.66（103.65〜193.95） | 48.42 / 235.02 | 258.2 ms（183.1〜356.7） | 164.1 / 508.5 ms | 18.50 |
| `c` | 6 | 6 | 0 / 0 | 405.35（334.12〜517.04） | 282.35 / 592.06 | 317.5 ms（309.9〜342.9） | 282.6 / 411.3 ms | 20.68 |
| `n` | 6 | 6 | 0 / 0 | 40.12（21.86〜45.52） | 11.35 / 54.04 | 1124.7 ms（989.9〜1231.0） | 42.8 / 1624.6 ms | 32.50 |
| `t` | 6 | 6 | 0 / 0 | 22.60（19.02〜24.22） | 17.31 / 36.71 | 380.9 ms（269.9〜543.6） | 144.4 / 728.1 ms | 24.24 |
| `quiet`（仮のマーカー） | 25 | 20 | 0 / 5 | 1.10（1.08〜1.44） | 1.06 / 62.63 | 18.2 ms（11.5〜24.5） | 0.0 / 235.1 ms | 43.32 |

- `c`・`n`・`t` との違いは数字を並べるだけにする（条件にしない。分けられるかは #40）。
- `quiet` の仮のマーカーの除外 5 は、冒頭の叩きの `o` の近く（別のマーカー）。比の最大 62.63 の 1 回が何によるかは見ていない。
- 基準の包絡の中央値は `quiet` のセッション（43.32）が `water`（18.50）・`cough`（20.68）・`talk`（24.24）・`neck`（32.50）より大きい。条件 3 のしきい（静止の中央値の 2 倍 = 86.6）は
  `quiet` のセッションから取る規則のとおり（規則は変えていない）。

帯域のエネルギーの割合（100〜4000 Hz の和に対する割合。条件にしない）:

| ラベル | 100〜500 Hz | 500〜1000 Hz | 1000〜2000 Hz | 2000〜4000 Hz |
|---|---|---|---|---|
| `s` | 0.029 | 0.112 | 0.326 | 0.533 |
| `c` | 0.152 | 0.058 | 0.274 | 0.516 |
| `n` | 0.034 | 0.021 | 0.116 | 0.829 |
| `t` | 0.894 | 0.046 | 0.017 | 0.043 |
| `quiet` | 0.131 | 0.126 | 0.223 | 0.520 |

### 判定の条件に照らした結果（有線）

| 条件 | 値 | 結果 |
|---|---|---|
| 1. `s` の振幅の比の中央値が 2 以上 | 137.66 | 満たす |
| 2. `s` の IQR が `quiet` の IQR と重ならない | `s` の第 1 四分位 103.65 > `quiet` の第 3 四分位 1.44 | 満たす |
| 3. 6 回の `s` のうち 5 回以上で `(t, t + 1.5 s]` に包絡 > 静止の中央値の 2 倍（86.6） | 使えた `s` 6 回ちょうど。6 回のうち 6 回 | 満たす |

- 3 つとも満たす（スクリプトの出力）。ただし 5 本とも叩きの `Δ` に印が付いている（上）。**信号の有無の判定は人**。
- 経路の差（20% 以内）は NZ-210C 経由を録ってから計算する。

「規則の外」の集計はしていない。

### 波形の切り出し

self、water、1 回目の s の包絡（有線）

- `20261008-203930_self_water` の 1 回目の `s`（時刻の順で最初。選んでいない）の `[t − 0.5 s, t + 1.5 s]`（2 秒）。L を 16 kHz に落とし、集計と同じ包絡
  （`|x − 静止の中央値|` の 20 ms 中心の移動 RMS）を、描画のため 5 ms ごとの最大に間引いて描いた。横軸は受信の時刻による対応での `t` からの時間（叩きの `Δ` の印あり、直していない）。
- この 1 回の振幅の比は 48.42（6 回のうちの最小）、基準の包絡の中央値 18.94 LSB、最大 916.9 LSB。
- `self` の包絡（波形のサンプル値そのものではない）。描画の使い捨てのスクリプトはリポジトリに入れていない。

## #38 NZ-210C の直接ペアリング（構成 B）の試し

Issue #38 の項目のうち「NZ-210C の直接ペアリング」だけを、plan を書く前に人とメインが実機で確かめた（人の希望、10/8）。被験者 `self`（開発用の計測）。
推論・特徴量のコードは書いていない。`tools/record.py` には触れていない（A2DP の経路を `record.py` に足すのは #38 / #39 の plan で、`--throat-device` の検査を広げる必要がある）。
受信機 NZ-W210R は電源 OFF のまま（Issue のとおり）。送信機 NZ-W210C は受信機と一度もつないでいない。#38 の他の項目（USB オーディオの確認の整理、LED の RPC、PD 電源、arduino-cli）は未着手。

### 版と機器

| 項目 | 値 |
|---|---|
| 基板 | UNO Q、Linux 側 Debian 13 (trixie) aarch64 |
| Bluetooth | コントローラ hci0（UART）、bluez 5.82-1.1 |
| 音声 | PipeWire 1.4.2-1~qcom1（libspa-0.2-bluetooth 1.4.2）、WirePlumber 0.5.8-2。pulseaudio-utils は無い |
| 送信機 | NZ-W210C（Taiwan Carol Electronics の OUI）。接続が無いと約 3 分で自動 OFF。電源を入れるたびにペアリングモードで来る |
| コーデック | SBC（UNO Q 側の A2DP Sink のエンドポイントは sbc / opus_05 / opus_g。aptX 系は無い。送信機とは SBC で合意） |

送信機の BD アドレスは log に載せない（機器の識別子。下のノード名も `<addr>` に置き換えた）。

### 経過（試した順）

| # | 何をしたか | 結果 | 分かった原因 |
|---|---|---|---|
| 1 | UNO Q を discoverable（180 秒、のちに timeout 0）にし、エージェント NoInputNoOutput で待ち受け。送信機をペアリングモードに | 送信機から来ない。LE の scan では見えない。`transport bredr` の scan で一度見えたが、scan を止めると bluez のキャッシュから消えて `pair` できない。以後 inquiry にも出ない | 送信機は自分から探す側で、探す相手を Class of Device で絞っていると見た。UNO Q の既定の Class は 0x6c0000（major = Misc） |
| 2 | `/etc/bluetooth/main.conf` に `Class = 0x240414` を書き、bluetooth を再起動（人、sudo） | 実効 0x6c0414（Audio/Video・Loudspeaker）。直後に送信機が UNO Q を見つけ、ペアリング・ボンディング成立（送信機の UUID は Audio Source のみ） | 見立てどおり Class で絞っていた |
| 3 | A2DP の接続を待つ / UNO Q から connect | AVDTP が成立しない（timeout、`Host is down`、`Connection refused`。ACL は一瞬つながって切れる） | 下の 4・5 |
| 4 | btmon（人、sudo。HCI ログ、音声なし） | 送信機は NoInputNoOutput・General Bonding で SSP を始めるが、UNO Q が User Confirmation に即 Negative Reply → Authentication Failure → 送信機が切断 | (a) `bluetoothctl` にコマンドを流し込む形ではエージェントが登録されていなかった（"Failed to register agent object"）。(b) 鍵が残っていると bluez の既定 `JustWorksRepairing = never` で再ペアリングを拒む。送信機は電源のたびに新規ペアリングで来るので、UNO Q 側の鍵を `bluetoothctl remove` で消す必要がある |
| 5 | `bluetoothctl --agent NoInputNoOutput` を起動し、標準入力に `yes` を 0.5 秒おきに流す | ペアリング成立、A2DP の接続成立（UUID に Advanced Audio Distribution が増えた）。trust 済み | ただし A2DP のエンドポイントを bluez に登録していたのは lightdm（ログイン画面）の WirePlumber で、arduino の PipeWire には bluez のノードが無い（先に登録した側が持つ） |
| 6 | lightdm 側で bluez の監視を止める: `/var/lib/lightdm/.config/wireplumber/wireplumber.conf.d/90-disable-bluez.conf`（`monitor.bluez` / `monitor.bluez-midi` = disabled）を置き、lightdm の wireplumber を止めた（人、sudo） | lightdm 側のエンドポイントは消えたが、arduino 側の WirePlumber も登録しない | arduino の WirePlumber は bluez の監視を logind の seat に結んでいて、ssh のセッションは seat0 の active ではない（"Seat state changed: online"）。`WIREPLUMBER_DEBUG=3` で確認 |
| 7 | `~/.config/wireplumber/wireplumber.conf.d/90-bluez-no-seat.conf`（`wireplumber.profiles.main.monitor.bluez.seat-monitoring = disabled`。arduino のホーム、sudo 不要）を置き、`systemctl --user restart wireplumber` | arduino の WirePlumber が A2DPSink（sbc など）を登録 | — |
| 8 | UNO Q 側の鍵を `bluetoothctl remove` で消し、5 のエージェントを起動した状態で送信機の電源を入れる | **構成 B 成立**。PipeWire に Device `NZ-W210C [bluez5]` と Source `bluez_input.<addr>.2`（codec sbc、profile a2dp-source） | WirePlumber の既定でアダプタの再生側に自動でつながる（ヘッドホン出力に流れる。記録には関係しない） |
| 9 | `pw-record --target bluez_input.<addr>.2 --rate 48000 --channels 2 --format s16 --raw -`（標準出力だけ。ファイルに書かない） | S16_LE・48 kHz・2 ch が出る。8.9 秒で 425,984 フレーム（48 kHz で連続）。L と R は同じ値ではない | — |
| 10 | 9 の出力をその場で 1 秒ごとの RMS（L）に畳み、マイクを叩く・声を出す（12 秒） | RMS の列: 58, 71, 58, 255, 541, 0, 0, 0, 2362, 6647, 6008, 6034（最大絶対値 32768 でクリップあり）。マイクの音は乗る | 途中にちょうど 3 秒の 0 の区間がある。ストリームの停止か PipeWire の無音の補填か、原因は確かめていない |

### 結果

- **構成 B（送信機 NZ-W210C → UNO Q の A2DP シンク）は動いた**（条件: 上の版、Class = 0x240414、lightdm 側の bluez の監視を止め、arduino 側の seat-monitoring を disabled、鍵を消してからエージェント NoInputNoOutput で承認、取り出しは `pw-record` の標準出力）。
- 構成 A（送信機 → 受信機 → USB オーディオ → UNO Q）は今日は試していない（受信機を 3.5 mm の入力へつなぐ変換ケーブルの有無は人）。
- Issue の文面の `arecord` ではなく `pw-record` で取った（bluez のノードは PipeWire にあり、ALSA の PCM としては出ていない）。

### UNO Q に残した設定とファイル（音声は無い）

| 場所 | 中身 | 置いた人 |
|---|---|---|
| `/etc/bluetooth/main.conf` | `Class = 0x240414` | 人（sudo） |
| `/var/lib/lightdm/.config/wireplumber/wireplumber.conf.d/90-disable-bluez.conf` | lightdm の WirePlumber で bluez の監視を止める | 人（sudo） |
| `~/.config/wireplumber/wireplumber.conf.d/90-bluez-no-seat.conf`（arduino） | bluez の監視を seat に結ばない | メイン（ssh。sudo 不要） |
| `~/btmon-nz2.txt`（arduino） | 人が取った HCI ログ（音声なし。消してよい） | 人 |

- `bluetoothctl --agent` のプロセスは ssh のバックグラウンドの終了で消える。ペアリングの鍵は残っているが、送信機は次も新規ペアリングで来るので消す必要がある（上の 4）。

### UNO Q に音声のファイルが残っていないことの確認

- 取り出しは `pw-record … -`（標準出力）だけで、ファイルには書いていない。RMS もその場で畳んだ。UNO Q の上で `arecord` は今日のこの試しでは使っていない。
- 確認の方法（読み取りのみ。10/8 にメインが実行）: 試しを始める前の時刻を基準に、ホームと `/tmp` の新しいファイルを列挙する。

  ```
  ssh arduino@<UNO Q> 'find ~ /tmp -xdev -type f -newermt "2026-10-08 11:00" 2>/dev/null'
  ssh arduino@<UNO Q> 'find ~ /tmp -xdev -type f \( -iname "*.wav" -o -iname "*.raw" -o -iname "*.pcm" -o -iname "*.flac" -o -iname "*.sbc" -o -iname "*.mp3" -o -iname "*.ogg" \)'
  ```

- 結果: 新しいファイルは 5 つ。`~/btmon-nz2.txt`（HCI ログ）、`~/.config/wireplumber/wireplumber.conf.d/90-bluez-no-seat.conf`（上の設定）、`~/.bash_history`、
  `~/.local/state/wireplumber/stream-properties`（WirePlumber の音量などの状態。ASCII テキスト）、`/tmp/.X0-lock`。音声の形式のものは無い。音声の拡張子のファイルはホームと `/tmp` に 0 件。
- `/etc` と `/var/lib/lightdm` の設定（上の表）は人が置いたもので、この確認の範囲の外。

### 未適用・未確認

- `/etc/bluetooth/main.conf` の `JustWorksRepairing = always`（sudo。未適用）。無いと送信機の電源を入れるたびに UNO Q 側で `bluetoothctl remove` が要る。
- 3 秒の 0 の区間の原因。長時間の安定（今日は 12 秒まで）。
- #38 の他の項目: PD 電源、LED の RPC、arduino-cli のビルドと書き込み（未着手）。
- 記録の経路として使う場合に要るもの（毎回のペアリングの手順、エージェントの起動、取りこぼしの検査）は #38 / #39 の plan で決める。無線リンクの扱い（検出器の境界）は #42。
