owhinata/zaitaku-mealpace/docs/log/2026-10-01.md

# 2026-10-01

## やったこと

- #32 表示器を Arduino UNO R4 WiFi の 12×8 LED マトリクスに替え、状態を形で示すようにした（1 = 流れる波線の動画、2 = 微笑む顔、0 = 消灯。人の決定）。
  段階 1（ファームウェア、テスト、文書、0018 の追記）はコミット `2bc1ef6`。段階 2（書き込み、表示器単体の目視、往復の計測）と段階 3（記録 C'・D'）は実機の確認と記録だけで、ソースは変えていない。
  実機の操作と `data/raw/` の記録は人、ビルドと PC 側の集計、log は subagent。
- 記録は C' を 2 回録った。最初の C' は検出器の USB を挿し直さずに始めて META が届かず、人が消した。録り直しの C' と D'（途中で表示器を抜く）を使った。
- #33 `record.py` が開始時に合図 `'M'` を送り、検出器が META を送り直すようにした。届かなければ記録を始めない。段階 1 はコミット `102a83e`、段階 2 は実機の確認（人）。

## 分かったこと

- 表示器を UNO R4 WiFi に替えても、検出器の記録は変わらない（C'・D' とも取りこぼし 0%、飛び 0、`led` 不一致 0、再採点の差 0。#29 の C・D と同じ）。
- PC → 表示器の往復（同期で送ったとき）は、状態が変わる回で中央値 1.42 ms・最大 2.12 ms（単体）。変わらない回でも中央値 1.16〜1.56 ms で、#29 の Nano 版（0.29〜0.30 ms）より大きい。
  UNO R4 WiFi は USB を別のチップ（ブリッジ）が受けて UART で渡すので、その分の見込み（測り分けていない）。どれも 1 窓の間隔（250 ms）より十分小さい。
- **検出器の USB を挿し直さずに `record.py` を始めると META が届かない**（docs/decisions/0006 の手順どおり、挿し直しが要る）。#25 の B で 2 回、#32 の最初の C' で 1 回。
  META の無いセッションは `evaluate_detector.py` が止まるので評価に使えない。対策は別の Issue（メインが起票）。→ #33 で対策した（下の「#33」）。
- #33 の後は、検出器の USB を挿し直さずに続けて録っても META が届く（10 秒 ×2、60 秒 ×2）。60 秒の `water` で取りこぼし 0、`led` 不一致 0、再採点の差 0、
  1 ホップの時間は #24・#25 と同等（`total_max` 207.2〜208.0 ms、`wall_max` 211〜212 ms）。META の再送の所要は最大 2620 µs。

## 次

- 人: #32 を閉じるか。META の取りこぼしの対策の Issue。#27 `meal` の通し記録（表示器はつながない）。
- 実機には検出器に本番 detector（`795773a`）、表示器に本番 indicator（`2bc1ef6`、UNO R4 WiFi）が入っている。logger は書き戻していない。
- （#33 の後）人: #33 を閉じるか。次は #27 の `meal`（挿し直しは不要）。#34（SYNC の途中で読み取りが切れるとフレームを 1 つ失う）。
  実機は検出器に本番 detector（`102a83e`。計測の後に人が書き戻した）、表示器に本番 indicator（`2bc1ef6`）。

## #32 表示器を UNO R4 WiFi の LED マトリクスに（形で示す）

Issue #32。plan は Codex のレビュー（再レビュー 1 で 3 面 LGTM。PLAN-SHA `c9eafda1aa42c649`）を通した。人が決めた点と Codex の CONCERN の採否は plan 第 13 節
（Issue #32 のコメント）。実施日は 10/1（段階 1〜3）。表示は嚥下の「目安」で、判定ではない（docs/decisions/0018、`firmware/indicator/README.md`）。
**この節の検出・誤検出の数字は 1 セッションずつの参考値で、M2 の数字ではない（M2 の数字は #27）。**

### 条件

- コミット: 段階 1 `2bc1ef6`（`firmware/indicator/` の UNO 版、`CMakeLists.txt` の FQBN の自動切り替え、`tools/record.py` のコメント、README 2 つ、`docs/data-schema.md` の `led` の説明、
  コメントの色名、0018 の追記）。段階 2〜3 は実機の確認と記録だけで、ソースは変えていない（`evaluate_detector.py` の出力のコミット表示も `2bc1ef6`）。
- 開発環境: arduino-cli 1.5.1、ボードコア `arduino:renesas_uno` 1.6.0（表示器、FQBN `arduino:renesas_uno:unor4wifi`）。検出器・logger は `arduino:mbed_nano` 4.6.0 のまま。
- **検出器のファームウェアは `795773a`（#25 の本番）のまま。** 書き込み直していない。セッション C'・D' の `meta.json` の `firmware_sha` は記録したときの PC 側の HEAD で、
  検出器に入っているのは `795773a` のビルド（#29 と同じ）。
- ビルドの表示（`arduino-cli compile`。表示器はフラッシュの最大 262144 B、RAM の最大 32768 B。検出器はフラッシュの最大 16777216 B、RAM の最大 270336 B）:

| ビルド | `BUILD_FLAGS` | スケッチ（フラッシュ） | グローバル変数（静的 RAM） |
|---|---|---|---|
| indicator 本番（`2bc1ef6`、UNO R4 WiFi） | 空 | 54792 B（20%） | 6996 B（21%） |
| indicator 計測（`2bc1ef6`） | `-DINDICATOR_PROFILE=1` | 54888 B | — |
| detector 本番（変えていない） | 空 | 160682 B | 162048 B（#25 と同じ） |

  警告 0。indicator 計測のグローバル変数は控えていない。detector の `.bin` の sha256 は変更（`firmware/detector/led_rule.h:2` のコメント）の前後で同じ
  （`248e6b1460f688364c0a116aea9a8d3b348624a0fc2aebd36672a7617fe573d4`）。logger のビルドも変わらない。
- PC のテスト: host tests indicator 837（`gen_shapes.py --check`: `shapes.h` は元と一致）・detector 300、tools 37、analysis 261 すべて通過（10/1、HEAD `2bc1ef6` で再実行）。
- 実機の書き込み・目視・記録は人（開発者 `self`）。subagent はビルドと PC 側の集計、log まで。

### 人の決定と 0018 の追記

- 9/29（Issue #32 の本文）: 表示器の基板を UNO R4 WiFi に替え、基板上の 12×8 LED マトリクスで形によって示す。B: 明るさは固定（段階の表示にしない）。
- 10/1（Issue #32 のコメント「形は Q3」。候補 12 組を実機で見比べた）: 状態 1 = 波線がゆっくり左へ流れる動画（1 列ずつ 200 ms × 6 フレーム、周期 1.2 秒、どのフレームも 12 個が点く）、
  状態 2 = 微笑む顔（静止画。輪郭は描かない）、状態 0 = 消灯。0018 が避けていた点滅と、Issue の当初の方針（静止した 2 種類）から外れて動画と顔を使うのは人の決定。
- 10/1（plan の初回レビューの後）: C1（Nano の表示器を UNO 版に置き換える。Nano 版は `8680504` に残る）、S1（`shapes/gen_shapes.py` と `shapes.h` の両方をコミットし、`--check` をテストに入れる）、
  F1（スケッチ名で FQBN を自動に決める）、T1（200 ms × 6 で固定）、W1（カードに「顔は嚥下の目安で、食べ方のよしあしを表すものではありません」）、
  R1（「赤い色に意味はありません」を貼る表示とカードの両方に）。すべて推奨どおり。Codex の初回レビューの CONCERN 3 件（流れる波線が急かすように見えないかの目視、
  境界の grep をコメントを除いてから掛ける、語の grep から `×` を外す）を採った。D（#30 の BLE の受け側）はこの Issue では決めない。
- docs/decisions/0018 の末尾に「追記（2026-10-01、Issue #32）」を足した（既存の本文と #29 の追記は変えていない）。`led` の値（`0` / `1` / `2`）・条件（案A、`[w − 1.75, w]`、保持 2.0 秒、
  消灯 1.0 秒）・PC が 1 バイトずつ中継する形・記録の形式は変えない。マトリクスの赤は基板の発光色で、合図の色ではない。表示器が実際に何を表示したかは記録に残らない（#29 と同じ）。
- `meal`（#27）では表示器をつながない（#29 の決定 I1 のまま）。

### ファイル構成と Arduino の閉じ込め（docs/decisions/0001）

| ファイル | 役割 | Arduino / ライブラリの API |
|---|---|---|
| `indicator.ino` | `setup()`（`Serial.begin(115200)`、`matrix_out_begin()`、`indicator_rx_init`）、`loop()`（受けたバイトを読み、目標を決めて `matrix_out_show`） | `Serial`、`millis` |
| `indicator_rx.h/.cpp` | 受けたバイト列から表示の目標を決める（#29 のまま） | 無し（PC のテスト） |
| `shape_seq.h/.cpp` | 目標の状態と時刻から、出すフレームの番号を決める（動画の位相、状態が変わったら最初から） | 無し（PC のテスト） |
| `shapes.h` | 図形の表（`FRAMES`、`FRAME_MS`、状態ごとの最初のフレームと枚数）。生成物 | 無し |
| `matrix_out.h/.cpp` | マトリクスの初期化と、フレームが変わったときだけの書き込み。起動失敗の `LED_BUILTIN` の点滅 | `Arduino_LED_Matrix.h`（`ArduinoLEDMatrix`、`begin`、`renderBitmap`）、`pinMode`・`digitalWrite`（`LED_BUILTIN`）。このファイルだけ |
| `led_rule.h` | リンク → `../detector/led_rule.h`。`LedState` と `led_off_due` | 無し |
| `shapes/gen_shapes.py` | 図形の元（ASCII）と `shapes.h` の生成、`--check` | （PC の Python。標準ライブラリだけ） |
| `host/test_indicator.cpp`・`test_indicator.sh` | `indicator_rx` と `shape_seq` と `shapes.h` の PC 上のテスト | 無し |

境界の grep（plan 第 12 節 5。コメントを `g++ -fpreprocessed` で除いてから見る。行番号はコメントを消した後のもの。10/1、HEAD `2bc1ef6` で再実行）:

```
$ for f in firmware/indicator/*.h firmware/indicator/*.cpp firmware/indicator/*.ino; do
    g++ -x c++ -fpreprocessed -dD -E -P "$f" 2>/dev/null | grep -nE '#include *[<"](Arduino|Arduino_LED_Matrix)\.h|ArduinoLEDMatrix|renderBitmap|LED_BUILTIN|pinMode|digitalWrite|\bSerial\b|\bmillis *\(' | sed "s|^|$f:|"
  done
firmware/indicator/matrix_out.cpp:1:#include <Arduino.h>
firmware/indicator/matrix_out.cpp:2:#include "Arduino_LED_Matrix.h"
firmware/indicator/matrix_out.cpp:8:static ArduinoLEDMatrix s_matrix;
firmware/indicator/matrix_out.cpp:17:  s_matrix.renderBitmap(s_frame, 8, 12);
firmware/indicator/matrix_out.cpp:26:    pinMode(LED_BUILTIN, OUTPUT);
firmware/indicator/matrix_out.cpp:27:    digitalWrite(LED_BUILTIN, LOW);
firmware/indicator/matrix_out.cpp:35:      digitalWrite(LED_BUILTIN, level);
firmware/indicator/indicator.ino:9:  Serial.begin(115200);
firmware/indicator/indicator.ino:16:  uint32_t now = millis();
firmware/indicator/indicator.ino:17:  while (Serial.available() > 0) {
firmware/indicator/indicator.ino:19:    while (n < sizeof buf && Serial.available() > 0) {
firmware/indicator/indicator.ino:20:      int c = Serial.read();
firmware/indicator/indicator.ino:25:    now = millis();
firmware/indicator/indicator.ino:29:  now = millis();
firmware/indicator/indicator.ino:32:  if (total > 0) { uint8_t e = matrix_out_state(); Serial.write(&e, 1); }
$ ls -l firmware/indicator/ | grep -- "->"
lrwxrwxrwx led_rule.h -> ../detector/led_rule.h
```

`Arduino.h`・`Arduino_LED_Matrix.h` の `#include`、`ArduinoLEDMatrix`、`renderBitmap`、`LED_BUILTIN`、`pinMode`、`digitalWrite` は `matrix_out.cpp` の 7 行だけ。`Serial` と `millis(` は
`indicator.ino` の 8 行だけ。`indicator_rx.*`・`shape_seq.*`・`shapes.h`・`matrix_out.h`・`led_rule.h`（リンク）は何も出さない。リンクは `led_rule.h` だけ（`led_out.*` のリンクは消した）。

### 書き込みのポート

- `-DPORT=` には実体のパス `/dev/ttyACM0`（表示器）を渡して書き込んだ。by-id のパスを渡すと bossac に `serial/by-id/...` が渡って失敗する（10/1 の下調べ。#29 の Nano とは失敗の仕方が違う）。
  1200 bps のタッチの後もポート名は変わらない。`CMakeLists.txt` のコメントと `firmware/indicator/README.md` に、`ls -l /dev/serial/by-id/` で表示器（名前に `UNO_WiFi_R4`）の実体を確かめてから渡すと書いた（段階 1）。
- 記録と計測のスクリプト（`record.py --port` / `--indicator`、`indicator_rtt.py`）には by-id のパスを渡した（検出器と表示器の取り違えを避けるため）。
- configure の表示は `FQBN=arduino:renesas_uno:unor4wifi`（スケッチ名から自動。決定 F1）。

### 表示器単体の確認と見え方（段階 2、机上。人の目視）

scratchpad の使い捨てスクリプト `issue29/indicator_manual.py`（コミットしない）で、本番ビルドの表示器に 0.25 秒ごとに値を送って見た（plan 第 10.2 節）。
人の報告は**「問題なかった」**（個別の言葉は無し）。報告に含まれる項目:

- 波線が左へ流れ続ける（止まらない、速さが変わらない）、顔は静止している。
- `1` を 1 回だけ送ると約 1 秒で消える。ゴミのバイトを混ぜても形は変わらない。スクリプトを止めると消灯する。
- **見え方（完了の条件）:** 食卓の距離と斜めから 2 つの形が見分けられる、明るさは足りる、赤が「異常」に見えない、流れる波線が急かすように見えない。いずれも問題なし。
  見たのは開発者（`self`）で、介助者の代わり。

### 遅れの計測（段階 2、`-DINDICATOR_PROFILE=1`、机上、装着なし）

scratchpad の使い捨てスクリプト `issue29/indicator_rtt.py`（コミットしない。ファイルに書かない。集計値だけを表示）の出力（そのまま）。返送なしは 0 で、無効の測定は無い。
計測の後、表示器は本番のビルドに書き戻した（人の報告）:

```
$ .venv/bin/python $S/indicator_rtt.py solo --indicator $IND
== 単体 60 秒（0.25 秒ごと、状態 1 を 8 回 → 状態 2 を 8 回 の繰り返し）
  状態が変わった回（書き込みあり）: 30 件  中央値 1.42 ms  90% 1.98 ms  最大 2.12 ms
  変わらない回（書き込みなし）: 210 件  中央値 1.56 ms  90% 1.95 ms  最大 2.28 ms
  返送なし 0 / 返送の値が送った値と違う 0 / 書けなかった 0
$ .venv/bin/python $S/indicator_rtt.py with-detector --indicator $IND --port $DET
== 検出器と一緒 60 秒（DETECT の led を同期で送る）
  状態が変わった回（書き込みあり）: 1 件  中央値 0.89 ms  90% 0.89 ms  最大 0.89 ms
  変わらない回（書き込みなし）: 231 件  中央値 1.16 ms  90% 2.09 ms  最大 2.64 ms
  返送なし 0 / 返送の値が送った値と違う 0 / 書けなかった 0
  DETECT 232 本 / led を取れなかった 0 / XOR 不一致 0
```

（`$IND`・`$DET` は表示器・検出器の by-id のパス。検出器と一緒の 60 秒は机上で陽性が無く、状態の変化は消灯 → 状態 1 の 1 回だけ。）

#29（Nano RP2040 Connect、RGB LED）との比較:

| 測った回 | #29 Nano（中央値 / 最大 ms） | #32 UNO R4 WiFi（中央値 / 最大 ms） |
|---|---|---|
| 単体・状態が変わった回 | 0.82 / 2.13 | 1.42 / 2.12 |
| 単体・変わらない回 | 0.30 / 0.55 | 1.56 / 2.28 |
| 検出器と一緒・状態が変わった回（1 件） | 0.84 / 0.84 | 0.89 / 0.89 |
| 検出器と一緒・変わらない回 | 0.29 / 0.70 | 1.16 / 2.64 |

読み方:

- 得られた値は**同期で送ったときの往復**（PC の送信 → USB → 表示器の読み取りとマトリクスへの書き込み → 返送の到着）。
  **本番の `record.py` の送信スレッドの起床と PC の読み取りの待ち（最大約 50 ms。コードからの読み）は含まない**（測っていない）。この値を「本番の転送の上限」とは呼ばない。
- 変わらない回（書き込みなし）でも 1.2〜1.6 ms かかり、#29 より 1 ms ほど大きい。UNO R4 WiFi は USB を別のチップ（ブリッジ）が受けて UART で主のマイコンに渡すので、その分と見ている（測り分けていない）。
  状態が変わる回の最大は #29 とほぼ同じ。どれも 1 窓の間隔（250 ms）や送信の遅れ（`t_ms − window_t_ms` 約 1.2 秒）より十分小さい。

### 記録（段階 3、検出器は本番 `795773a`、表示器は本番 `2bc1ef6`、装着、`self`）

`fw` が `detector` で cond が `water` なので、M1 の分割にも #27 の既定にも入らない（docs/decisions/0021）。記録は `data/raw/` に残す（最初の C' を除く）。

**最初の C'** `20261001-134204_self_water`（消した）

- 検出器の USB を挿し直さずに始めたので、META が届かなかった（docs/decisions/0006）。`evaluate_detector.py` は「`--sessions` のセッションが root の検出器のセッション（fw が detector）にありません」で止まった。
- `check_session.py`: 窓 361、飛び 0、取りこぼし率 0.000%、`t_ms − window_t_ms` 1202 / 1204 / 1207 ms（DETECT）。陽性窓 6、`led` = 2 の行 27、`s` 6。
  `led` と PC の再計算の不一致は 0 / 361 行（`analysis/led_rule.py` で直接計算）。
- 目で見た結果（人）: **6 口中 3 口で表示器が微笑む顔に変わり、波線に戻った。**
- META が無く評価に使えないので、人が消した（`data/raw/` に無い）。

**セッション C'** `data/raw/20261001-134602_self_water`（録り直し。検出器の USB を挿し直してから `record.py --port <検出器> --indicator <表示器> --cond water --duration 90`、
表示器を正面の机に置く、水 6 口、`s` 6）

- META 1。陽性窓 10、`led` = 2 の行 38。
- 目で見た口の数は数えていない（人）。`record.py` の終了時の表示（XOR 不一致、表示器への転送）は控えていない。
- `.venv/bin/python tools/check_session.py data/raw/20261001-134602_self_water` の出力（そのまま）:

```
=== data/raw/20261001-134602_self_water ===
[DETECT]
  窓の数: 271
  記録の長さ（DETECT だけの値。目安）: 68.707 秒
  実効レート（装置の送信時刻から。窓の開始の間隔）: 4.00 窓/秒（公称 4 Hz 比 100.0%）
  飛び: 0 箇所 / 失われた窓数(推定): 0 / 取りこぼし率: 0.000%
  window_t_ms の最大差分: 251 ms / window_t_ms の逆行: 0 箇所 / t_ms の逆行: 0 箇所
  送信時刻 − 窓の開始（t_ms − window_t_ms）: 最小 1202 / 中央値 1204 / 最大 1206 ms
[FEAT]
  窓の数: 271
  次元数 N: 29
  記録の長さ（FEAT だけの値。目安）: 68.707 秒
  実効レート（装置の送信時刻から。窓の開始の間隔）: 4.00 窓/秒（公称 4 Hz 比 100.0%）
  飛び: 0 箇所 / 失われた窓数(推定): 0 / 取りこぼし率: 0.000%
  window_t_ms の最大差分: 251 ms / window_t_ms の逆行: 0 箇所 / t_ms の逆行: 0 箇所
  送信時刻 − 窓の開始（t_ms − window_t_ms）: 最小 1203 / 中央値 1204 / 最大 1207 ms
  DETECT との window_t_ms の不一致: 0 窓（DETECT にだけある 0 / FEAT にだけある 0）

[判定] 取りこぼし率 1%未満を「基準内」とする（Issue #7 の作業上の基準。docs/evaluation.md の合格線ではない）
  DETECT:基準内（0.000%）
  FEAT:  基準内（0.000%）
  ※ XOR 不一致数はここでは分からない。tools/record.py の終了時の表示を見ること。
```

- `python analysis/evaluate_detector.py data/raw --sessions 20261001-134602_self_water --scorer analysis/m2_scorer.py` の出力（そのまま。参考値。M2 の数字ではない）:

```markdown
# M2 検出器の評価（detect.csv の positive と events.csv の s）

## 実行の条件

- 実行: `python analysis/evaluate_detector.py data/raw --sessions 20261001-134602_self_water --scorer analysis/m2_scorer.py`
- 対象: --sessions で明示したセッション
- コミット: 2bc1ef6
- 窓 1.0 秒 / ホップ 0.25 秒。数え方は docs/evaluation.md と docs/decisions/0011、記録の範囲（送信の遅れの上限 1000 ms）は docs/decisions/0021
- `threshold`: 0.949999988（float32 0.949999988。装置の申告値）、`model`: {"deploy_version": 2, "project_id": 1117130, "source": "edge-impulse"}、`feature_set`: 'm2-0020'

## root の検出器のセッション（fw が `detector`。7）

| セッション | cond | 評価 | 理由 |
|---|---|---|---|
| 20260926-114039_self_water | water | 使わない | --sessions に無い |
| 20260926-142926_self_water | water | 使わない | --sessions に無い |
| 20260926-144044_self_cough | cough | 使わない | --sessions に無い |
| 20260926-161925_self_water | water | 使わない | --sessions に無い |
| 20260926-162247_self_water | water | 使わない | --sessions に無い |
| 20261001-134602_self_water | water | 使う |  |
| 20261001-134924_self_water | water | 使わない | --sessions に無い |

## 評価に使ったセッション（1）

| セッション | cond | 収集日 | 会話 | 嚥下 | 検出 | 誤検出（回） | 非嚥下（分） | 次元数 | FEAT に無い窓 | M2 の数字 |
|---|---|---|---|---|---|---|---|---|---|---|
| 20261001-134602_self_water | water | 20261001 | なし | 6 | 4 | 0 | 0.95 | 29 | 0 | 使わない（cond が meal でない） |

## 合算

合算は出さない（1 セッション。3 セッション未満。M2 の数字ではない）。

## 参考値（docs/decisions/0011「既知の弱点」、#27）

- 常時陽性の場合（全窓を陽性にした場合）: 検出率 1.000（6/6）、誤検出 1 回、誤検出率 1.06 回/分（非嚥下 0.95 分）
- 陽性窓の割合（陽性窓 ÷ 全窓）: 0.037（10/271）
- `positive != (prob >= threshold)` の行数（float32 で比較）: 0
- `led` と docs/decisions/0018 の規則からの再計算（`analysis/led_rule.py`）の不一致の行数（評価には使わない）: 0
- `c` に紐づく誤検出の塊（塊の最初の窓の中心 − t_c が [-1.0, +5.0] 秒）: `c` 0 回、紐づく塊 0 / 誤検出の塊 0、紐づく塊が 1 つ以上ある `c` の割合 —（0/0）
- 収集日ごと（式は回数の合算。3 セッション未満でも出す）:
  - 20261001: 検出率 0.667（4/6）、誤検出 0 回、誤検出率 0.00 回/分（非嚥下 0.95 分）
- 会話の有無ごと（`o` の note が `conv` のセッションが会話あり）:
  - 会話なし: 検出率 0.667（4/6）、誤検出 0 回、誤検出率 0.00 回/分（非嚥下 0.95 分）

## 再採点（`--scorer analysis/m2_scorer.py`。feat.csv を PC で採点し、閾値 float32 0.949999988 で陽性にした）

| セッション | 窓 | 装置 1 / PC 0 | 装置 0 / PC 1 | max abs(prob − prob_pc) | 装置: 検出 / 誤検出 | PC: 検出 / 誤検出 |
|---|---|---|---|---|---|---|
| 20261001-134602_self_water | 271 | 0 | 0 | 0 | 4/6 / 0 回 | 4/6 / 0 回 |

- 装置の合算: 検出率 0.667（4/6）、誤検出 0 回、誤検出率 0.00 回/分（非嚥下 0.95 分）
- PC の合算: 検出率 0.667（4/6）、誤検出 0 回、誤検出率 0.00 回/分（非嚥下 0.95 分）
- 差のある窓の合計: 装置 1 / PC 0 が 0、装置 0 / PC 1 が 0
```

**セッション D'** `data/raw/20261001-134924_self_water`（同じコマンド、`--duration 60`。途中で表示器の USB を抜き、水を飲んで記録を続けた。`s` 5）

- META 1。陽性窓 8、`led` = 2 の行 30。
- 人の報告: **表示器を抜いた後も記録は止まらずに続き、表示器は消えた。** `record.py` の終了時の「表示器への転送」（送った / 失敗の件数）と最初の失敗の文、XOR 不一致は控えていない。
- `.venv/bin/python tools/check_session.py data/raw/20261001-134924_self_water` の出力（そのまま）:

```
=== data/raw/20261001-134924_self_water ===
[DETECT]
  窓の数: 232
  記録の長さ（DETECT だけの値。目安）: 58.956 秒
  実効レート（装置の送信時刻から。窓の開始の間隔）: 4.00 窓/秒（公称 4 Hz 比 100.0%）
  飛び: 0 箇所 / 失われた窓数(推定): 0 / 取りこぼし率: 0.000%
  window_t_ms の最大差分: 251 ms / window_t_ms の逆行: 0 箇所 / t_ms の逆行: 0 箇所
  送信時刻 − 窓の開始（t_ms − window_t_ms）: 最小 1202 / 中央値 1204 / 最大 1206 ms
[FEAT]
  窓の数: 232
  次元数 N: 29
  記録の長さ（FEAT だけの値。目安）: 58.956 秒
  実効レート（装置の送信時刻から。窓の開始の間隔）: 4.00 窓/秒（公称 4 Hz 比 100.0%）
  飛び: 0 箇所 / 失われた窓数(推定): 0 / 取りこぼし率: 0.000%
  window_t_ms の最大差分: 251 ms / window_t_ms の逆行: 0 箇所 / t_ms の逆行: 0 箇所
  送信時刻 − 窓の開始（t_ms − window_t_ms）: 最小 1203 / 中央値 1204 / 最大 1206 ms
  DETECT との window_t_ms の不一致: 0 窓（DETECT にだけある 0 / FEAT にだけある 0）

[判定] 取りこぼし率 1%未満を「基準内」とする（Issue #7 の作業上の基準。docs/evaluation.md の合格線ではない）
  DETECT:基準内（0.000%）
  FEAT:  基準内（0.000%）
  ※ XOR 不一致数はここでは分からない。tools/record.py の終了時の表示を見ること。
```

- `python analysis/evaluate_detector.py data/raw --sessions 20261001-134924_self_water --scorer analysis/m2_scorer.py` の出力（そのまま。参考値。M2 の数字ではない）:

```markdown
# M2 検出器の評価（detect.csv の positive と events.csv の s）

## 実行の条件

- 実行: `python analysis/evaluate_detector.py data/raw --sessions 20261001-134924_self_water --scorer analysis/m2_scorer.py`
- 対象: --sessions で明示したセッション
- コミット: 2bc1ef6
- 窓 1.0 秒 / ホップ 0.25 秒。数え方は docs/evaluation.md と docs/decisions/0011、記録の範囲（送信の遅れの上限 1000 ms）は docs/decisions/0021
- `threshold`: 0.949999988（float32 0.949999988。装置の申告値）、`model`: {"deploy_version": 2, "project_id": 1117130, "source": "edge-impulse"}、`feature_set`: 'm2-0020'

## root の検出器のセッション（fw が `detector`。7）

| セッション | cond | 評価 | 理由 |
|---|---|---|---|
| 20260926-114039_self_water | water | 使わない | --sessions に無い |
| 20260926-142926_self_water | water | 使わない | --sessions に無い |
| 20260926-144044_self_cough | cough | 使わない | --sessions に無い |
| 20260926-161925_self_water | water | 使わない | --sessions に無い |
| 20260926-162247_self_water | water | 使わない | --sessions に無い |
| 20261001-134602_self_water | water | 使わない | --sessions に無い |
| 20261001-134924_self_water | water | 使う |  |

## 評価に使ったセッション（1）

| セッション | cond | 収集日 | 会話 | 嚥下 | 検出 | 誤検出（回） | 非嚥下（分） | 次元数 | FEAT に無い窓 | M2 の数字 |
|---|---|---|---|---|---|---|---|---|---|---|
| 20261001-134924_self_water | water | 20261001 | なし | 5 | 3 | 0 | 0.82 | 29 | 0 | 使わない（cond が meal でない） |

## 合算

合算は出さない（1 セッション。3 セッション未満。M2 の数字ではない）。

## 参考値（docs/decisions/0011「既知の弱点」、#27）

- 常時陽性の場合（全窓を陽性にした場合）: 検出率 1.000（5/5）、誤検出 1 回、誤検出率 1.23 回/分（非嚥下 0.82 分）
- 陽性窓の割合（陽性窓 ÷ 全窓）: 0.034（8/232）
- `positive != (prob >= threshold)` の行数（float32 で比較）: 0
- `led` と docs/decisions/0018 の規則からの再計算（`analysis/led_rule.py`）の不一致の行数（評価には使わない）: 0
- `c` に紐づく誤検出の塊（塊の最初の窓の中心 − t_c が [-1.0, +5.0] 秒）: `c` 0 回、紐づく塊 0 / 誤検出の塊 0、紐づく塊が 1 つ以上ある `c` の割合 —（0/0）
- 収集日ごと（式は回数の合算。3 セッション未満でも出す）:
  - 20261001: 検出率 0.600（3/5）、誤検出 0 回、誤検出率 0.00 回/分（非嚥下 0.82 分）
- 会話の有無ごと（`o` の note が `conv` のセッションが会話あり）:
  - 会話なし: 検出率 0.600（3/5）、誤検出 0 回、誤検出率 0.00 回/分（非嚥下 0.82 分）

## 再採点（`--scorer analysis/m2_scorer.py`。feat.csv を PC で採点し、閾値 float32 0.949999988 で陽性にした）

| セッション | 窓 | 装置 1 / PC 0 | 装置 0 / PC 1 | max abs(prob − prob_pc) | 装置: 検出 / 誤検出 | PC: 検出 / 誤検出 |
|---|---|---|---|---|---|---|
| 20261001-134924_self_water | 232 | 0 | 0 | 0 | 3/5 / 0 回 | 3/5 / 0 回 |

- 装置の合算: 検出率 0.600（3/5）、誤検出 0 回、誤検出率 0.00 回/分（非嚥下 0.82 分）
- PC の合算: 検出率 0.600（3/5）、誤検出 0 回、誤検出率 0.00 回/分（非嚥下 0.82 分）
- 差のある窓の合計: 装置 1 / PC 0 が 0、装置 0 / PC 1 が 0
```

**#29 のセッション C・D（Nano の表示器）との比較**（表示器を替えても検出器の記録が変わらないこと）:

| 項目 | C `20260926-161925`（#29、表示器あり） | D `20260926-162247`（#29、途中で切り離し） | C' `20261001-134602`（#32、表示器あり） | D' `20261001-134924`（#32、途中で切り離し） |
|---|---|---|---|---|
| DETECT / FEAT / META | 292 / 292 / 1 | 192 / 192 / 1 | 271 / 271 / 1 | 232 / 232 / 1 |
| `record.py` の XOR 不一致 | 0 | 0 | 控えていない | 控えていない |
| 飛び / 取りこぼし率（DETECT） | 0 / 0.000% | 0 / 0.000% | 0 / 0.000% | 0 / 0.000% |
| `t_ms − window_t_ms`（DETECT、最小 / 中央値 / 最大 ms） | 1202 / 1204 / 1208 | 1202 / 1204 / 1206 | 1202 / 1204 / 1206 | 1202 / 1204 / 1206 |
| DETECT と FEAT の `window_t_ms` の不一致 | 0 | 0 | 0 | 0 |
| `led` と PC の再計算（`analysis/led_rule.py`）の不一致 | 0 | 0 | 0 | 0 |
| `positive` の再採点の差（装置 1 / PC 0、装置 0 / PC 1）、`max abs(prob − prob_pc)` | 0、0、0 | 0、0、0 | 0、0、0 | 0、0、0 |
| 表示器への転送（送った / 失敗） | 292 / 0 | 58 / 134 | 控えていない | 控えていない |
| 目で見た口（顔・緑になった口 / 口） | 6 / 6（緑） | — | 数えていない（最初の C' で 3 / 6） | — |

→ 取りこぼし 0%、飛び 0、`t_ms − window_t_ms` 1202〜1206 ms、`led` 不一致 0、再採点の差 0 で #29 の C・D と同じ。**表示器を UNO R4 WiFi に替えても、途中で抜いても、検出器の記録は変わらなかった。**
参考値（1 セッションずつ。M2 の数字ではない）: C' は検出 4/6・誤検出 0 回 / 0.95 分、D' は検出 3/5・誤検出 0 回 / 0.82 分。

### META の取りこぼし

- 検出器の USB を挿し直さずに `record.py` を始めると META が届かない（docs/decisions/0006 の手順は挿し直してから始める）。これまでに #25 の B で 2 回、#32 の最初の C' で 1 回。
- META の無いセッションは `evaluate_detector.py` の対象（fw が `detector`）に入らず、評価に使えない。録り直しが要る。
- 対策（記録の前に META が届いたかを確かめる、など）は別の Issue（メインが起票）。この Issue では手順も `record.py` も変えていない。

### 語の grep（plan 第 12 節 4。10/1、HEAD `2bc1ef6` で再実行。段階 1 と同じ）

`firmware/indicator`・`tools/record.py`・`docs/data-schema.md`・`firmware/detector/README.md` に plan 第 12 節 4 の語（英語の禁止の名前と、合図・警告・許可・異常・安全などの語）を掛けた。出たのは次だけ:

- `firmware/indicator/indicator.ino:4` のコメント「表示は嚥下の目安で、判定ではない。」
- README 2 つ（`firmware/indicator/README.md:52,61`、`firmware/detector/README.md:35,44`）の貼る表示の 1 行目「嚥下の目安（判定ではありません）」とカードの 1 行目（否定の文。0018 の追記と一字一句同じ）。
- `tools/record.py:293,403` の既存の「警告:」（PC の端末への表示で、装置の表示の文言ではない）と、`:300,531` の「正常受信フレーム数」（受信の数え方の名前）。

`docs/data-schema.md` には出ない。`OK`・`NG`・`✓`（語として）は `firmware/indicator` と `firmware/detector/README.md` に 0 件。
0018 の追記の節に同じ語を掛けると、出るのは否定の文だけ（「点滅を急かす合図に見えるとして採らず」「安全・許可の意味を持たない」「『OK』『NG』『✓』…は使わない」「赤は…『異常』と読まれやすい」
「禁止の名前は使わない」、貼る表示とカードの 1 行目）。README 2 つの貼る表示とカードは 0018 の追記と一字一句同じ（段階 1 で `diff`）。

### plan から外れた点

- 段階 3 の C' を録り直した（最初の C' は META が無く、評価に使えない）。目で見た口の数は最初の C' の 3/6 口だけで、録り直しの C' では数えていない。
- `record.py` の終了時の表示（XOR 不一致、表示器への転送の件数、D' の最初の失敗の文）を C'・D' とも控えていない（plan 第 10.4 節 8・9 は控える手順だった）。
- 表示器単体の目視（plan 第 10.2 節）は、項目ごとの言葉ではなく「問題なかった」の一言で受けた。

### 確かめていないこと

- **録り直しの C' の目視の口の数**（数えていない）。完了の条件の「顔に変わり約 2 秒で戻る」は、最初の C'（6 口中 3 口）と段階 2 の単体の確認で見た。顔にならなかった 3 口と
  陽性窓（最初の C' で 6）の対応は、口ごとには突き合わせていない。
- **C'・D' の `record.py` の XOR 不一致と表示器への転送の件数**（控えていない）。D' で抜いた後に書き込みが毎回失敗して数えられたか（#29 の D のような件数）は、この記録では分からない。
- 2 つの形の見分け、赤が「異常」と読まれないか、明るさ、波線が急かすように見えないかは、開発者が介助者の代わりに見た（問題なし）。介助者本人と、実際の食卓の明るさでは見ていない。
- `renderBitmap`（`loadFrame` の `memcpy`）と、マトリクスの割り込みが同じ framebuffer を読む間の食い違い（1 走査分のちらつき）。目視で問題なしだけで、測っていない。
- PC がポートを開いたときに表示器が再起動するか（ブリッジの DTR の扱い）。単体の確認の報告に個別の言葉が無く、控えていない。
- `Arduino_LED_Matrix` は `ArduinoGraphics` があると継承の形が変わる（今は入っていない）。`deps` の `core install arduino:renesas_uno` は版を固定しない（今は 1.6.0）。版が上がるとビルドが通らなくなるおそれ。
- PC の負荷で `record.py` の読み取りが遅れたときに、表示器の消灯（1.0 秒）が遅れる、または一時的に消灯するか（#29 と同じ。DETECT の到着間隔は #25 で最大 270.7 ms）。
  送信スレッドの起床と読み取りの待ち（最大約 50 ms）は測っていない。
- 表示器が実際に何を表示したかは記録に残らない（目視と `INDICATOR_PROFILE` の返送でしか分からない）。
- 食事の一口の間隔に対して 2.0 秒の保持が長すぎないか（#27 の `meal` では表示器をつながないので、別に見る必要がある）。
- #30（BLE）の受け側を UNO R4 WiFi にできるか（UNO R4 WiFi の BLE は ESP32-S3 側で、ArduinoBLE で使えるかは未確認。#30 で決める）。
- 実機には検出器に本番 detector（`795773a`、`BUILD_FLAGS` 空）、表示器に本番 indicator（`2bc1ef6`、UNO R4 WiFi、`BUILD_FLAGS` 空）が入っている。logger は書き戻していない。

## #33 META を記録の開始時に確実に受け取る

Issue #33。plan は Codex のレビュー（再レビュー 2 で 3 面 LGTM、BLOCKING・CONCERN 0。PLAN-SHA `d14af4eb565ac3e8`）を通した。plan とレビューの経過は Issue #33 のコメント。
実施日は 10/1（段階 1〜3）。記録の手順の不具合の対策で、M2 の数字は出さない。
**この節の検出・誤検出の数字は 1 セッションずつの参考値で、M2 の数字ではない（M2 の数字は #27）。** 被験者は `self` のみ。

### 背景

- 検出器は `setup()` の `while (!Serial) {}` の後に META を 1 回だけ送る。mbed_nano 4.6.0 の `SerialUSB::write()` はポートが開かれていない（DTR が立っていない）と
  何も送らない。起動後に最初にポートを開いた相手が META を受け、その後に始めた `record.py` には届かない。#25 の B で 2 回、#32 の最初の C' で 1 回、録り直しになった（上の「#32」の「META の取りこぼし」）。

### 人の決定（10/1）

- 案 **A1**: `record.py` が開始時に合図を送り、検出器が `setup()` と同じ META を送り直す（起動時の 1 回は残す）。
- 合図のバイトは **`'M'`（0x4D）**（表示器の値 0/1/2 と制御文字を避けた）。
- META が 5 秒以内に届かなければ **警告して止まる**。記録を始めず、フォルダを作らない（`meal` で気づかずに 1 食を無駄にする事故を開始時に止める）。
  記録ファームウェア（logger）は合図に応えないので、logger で録るときは今までどおり挿し直す（忘れると止まる）。
- 決定の記録は **docs/decisions/0006 に追記＋0021 に 1 行**。`meta.json` に合図で受けたことは **書かない**（形式とキーを変えない）。
- 受信の確認の間隔は **20 ms ごと**。
- plan レビュー 1 回目の CONCERN C1〜C4 と、再レビュー 1 回目の C2 の残り（`fw` は空でない文字列に限る。`--cond meal` では `fw == "detector"` も開始の条件）をすべて採る。
- #27 の `meal` の記録の前に行う（`data/raw/` に `meal` は 0 本）。

### 変えたファイル（段階 1、コミット `102a83e`）

- `firmware/detector/detector.ino`: `loop()` の先頭で 20 ms ごとに受信を確かめ（1 回に最大 64 バイト）、合図 `'M'` で `setup()` と同じ META を 1 回送り直す。他のバイトは捨てる。
  `DETECTOR_PROFILE` の統計行に `meta_resends`（送り直した回数）・`meta_send_max`（合図による META の `frame_send` 1 回の所要の最大、µs）を足した。
- `firmware/detector/detector_meta.h/.cpp`: 合図のバイトを見分ける関数 `detector_meta_is_request` を足した。META の JSON の中身は 1 バイトも変えていない。
- `tools/record.py`: 開始の順を「表示器 → 検出器のポート → 合図 → META を待つ → セッションを作る」にした。待つ間に届いた DETECT・FEAT は記録の開始前として書かない。
  META の後ろに続いたバイトは記録に引き継ぐ。止まる場合はいずれもフォルダを作らず終了コード 1。
- テスト: `tools/test_record.py`（r18〜r24）、`tools/test_record_tty.py`（偽物のシリアルを合図に合わせ、t10 を足した）、`firmware/detector/host/test_detector.cpp`。
- 文書: `docs/recording-protocol.md`（M2 は挿し直し不要。M1 の logger は挿し直す）、`docs/data-schema.md` の文 2 箇所、docs/decisions/0006 の追記、0021 の 1 行、`firmware/detector/README.md`。
  段階 3 で `firmware/indicator/README.md` の「ポートの見分け方」の記録の行（挿し直してから → 挿し直し不要）を直した。
- 変えていないもの: `firmware/logger/`、`firmware/bench/`、`firmware/indicator/` のソース、`analysis/`、`docs/evaluation.md`、フレーム形式、META の JSON の中身、
  セッションのファイル・列・`meta.json` のキー、検出・特徴量・推論・閾値・LED の規則。

### テストとビルド（段階 1）

- PC のテスト: tools 47（r18〜r24、t10 を含む）、host（detector）309（`test_meta` の期待値は変えずに通る = META の JSON は不変）、analysis 261（変えていない）。すべて通過。
- ビルドの表示（`arduino-cli compile`。フラッシュの最大 16777216 B、RAM の最大 270336 B）:

| ビルド | `BUILD_FLAGS` | スケッチ（フラッシュ） | グローバル変数（静的 RAM） |
|---|---|---|---|
| detector 本番（`102a83e`） | 空 | 160808 B（#25 の 160682 B から +126） | 162056 B（#25 の 162048 B から +8） |
| detector 計測 | `-DDETECTOR_PROFILE=1` | 163788 B | 164672 B |
| detector FEAT なし | `-DDETECTOR_SEND_FEAT=0` | 160744 B | — |
| logger | 空 | 変わらない | 変わらない |

### grep（段階 1）

- `grep -n "frame_send" firmware/detector/*.ino firmware/detector/*.cpp` → `detector.ino` の META 2 箇所（`setup()` と合図）・DETECT・FEAT の 4 箇所だけ。`FRAME_AUDIO` を送る呼び出しは無い。
- `grep -n "Serial\." firmware/detector/detector.ino` → `begin`・`available`・`read`・`write`（統計行のみ）。`Serial.print`・`println` は無い。
- `git diff --stat` で `analysis`・`docs/evaluation.md`・`firmware/logger`・`firmware/bench`・`firmware/indicator` は空。
- 追加行に CLAUDE.md が禁じる表現は新しく入っていない（plan 4.1 の語の確認）。LED は「目安」のまま。

### 実機の確認（段階 2、人。検出器に本番 `102a83e` を書き込み、`self`）

書き込みの `-DPORT` は実体の `/dev/ttyACMx`。セッションは `data/raw/` に残す（`fw` が `detector`、cond が `water` なので M1 の分割にも #27 の既定にも入らない。docs/decisions/0021）。

**挿し直さずに 2 回続けて 10 秒**（`record.py --cond water --duration 10`）

| セッション | 開始時の表示 | DETECT / FEAT | META | XOR 不一致 |
|---|---|---|---|---|
| `20261001-155956_self_water` | 「META を受けました（fw=detector）」 | 36 / 36 | 2（書き込み直後の起動時の META ＋ 合図の再送） | 0 |
| `20261001-160014_self_water` | 同 | 40 / 40 | 1（合図の再送だけ） | 0 |

**USB を挿し直してから 1 回 10 秒**

| セッション | 開始時の表示 | DETECT / FEAT | META | XOR 不一致 |
|---|---|---|---|---|
| `20261001-160046_self_water` | 「META を受けました（fw=detector）」 | 36 / 36 | 2（観察。起動時の META ＋ 再送。plan 2.4 の見込みどおり） | 0 |

**60 秒の `water`**（表示器なし・あり）

| 項目 | `20261001-160128_self_water`（表示器なし） | `20261001-160247_self_water`（表示器あり、`--indicator`） |
|---|---|---|
| META / DETECT / FEAT / XOR 不一致 | 1 / 240 / 240 / 0 | 1 / 240 / 240 / 0 |
| 飛び、取りこぼし率 | 0、0.000% | 0、0.000% |
| `t_ms − window_t_ms`（DETECT、最小 / 中央値 / 最大 ms） | 1201 / 1204 / 1208 | 1201 / 1203 / 1206 |
| DETECT と FEAT の `window_t_ms` の不一致 | 0 | 0 |
| `led` と PC の再計算（`analysis/led_rule.py`）の不一致 | 0 | 0 |
| 再採点の差（装置 1 / PC 0、装置 0 / PC 1）、`max abs(prob − prob_pc)` | 0、0、0 | 0、0、0 |
| `detect.csv` の最初の `window_t_ms` ≦ 最初の `s` の `t_ms` | 範囲内 | 範囲内 |
| `evaluate_detector.py` | エラーなし | エラーなし |
| 表示器への転送（送った / 失敗） | — | 240 / 0 |

- 5 本すべて `meta.json` に `fw`（`detector`）・`threshold`（0.949999988）・`model`・`feature_names`（29）が入った。
- 取りこぼし 0、`t_ms − window_t_ms` 1201〜1208 ms で #25・#32 と同じ帯。待つ間の DETECT・FEAT を捨てても、DETECT と FEAT の窓は食い違わず、最初のマーカーは記録の範囲に入った（C1）。

`.venv/bin/python tools/check_session.py data/raw/20261001-160128_self_water` の出力（そのまま）:

```
=== data/raw/20261001-160128_self_water ===
[DETECT]
  窓の数: 240
  記録の長さ（DETECT だけの値。目安）: 60.953 秒
  実効レート（装置の送信時刻から。窓の開始の間隔）: 4.00 窓/秒（公称 4 Hz 比 100.0%）
  飛び: 0 箇所 / 失われた窓数(推定): 0 / 取りこぼし率: 0.000%
  window_t_ms の最大差分: 251 ms / window_t_ms の逆行: 0 箇所 / t_ms の逆行: 0 箇所
  送信時刻 − 窓の開始（t_ms − window_t_ms）: 最小 1201 / 中央値 1204 / 最大 1208 ms
[FEAT]
  窓の数: 240
  次元数 N: 29
  記録の長さ（FEAT だけの値。目安）: 60.953 秒
  実効レート（装置の送信時刻から。窓の開始の間隔）: 4.00 窓/秒（公称 4 Hz 比 100.0%）
  飛び: 0 箇所 / 失われた窓数(推定): 0 / 取りこぼし率: 0.000%
  window_t_ms の最大差分: 251 ms / window_t_ms の逆行: 0 箇所 / t_ms の逆行: 0 箇所
  送信時刻 − 窓の開始（t_ms − window_t_ms）: 最小 1201 / 中央値 1205 / 最大 1209 ms
  DETECT との window_t_ms の不一致: 0 窓（DETECT にだけある 0 / FEAT にだけある 0）

[判定] 取りこぼし率 1%未満を「基準内」とする（Issue #7 の作業上の基準。docs/evaluation.md の合格線ではない）
  DETECT:基準内（0.000%）
  FEAT:  基準内（0.000%）
  ※ XOR 不一致数はここでは分からない。tools/record.py の終了時の表示を見ること。
```

`.venv/bin/python tools/check_session.py data/raw/20261001-160247_self_water` の出力（そのまま）:

```
=== data/raw/20261001-160247_self_water ===
[DETECT]
  窓の数: 240
  記録の長さ（DETECT だけの値。目安）: 60.954 秒
  実効レート（装置の送信時刻から。窓の開始の間隔）: 4.00 窓/秒（公称 4 Hz 比 100.0%）
  飛び: 0 箇所 / 失われた窓数(推定): 0 / 取りこぼし率: 0.000%
  window_t_ms の最大差分: 251 ms / window_t_ms の逆行: 0 箇所 / t_ms の逆行: 0 箇所
  送信時刻 − 窓の開始（t_ms − window_t_ms）: 最小 1201 / 中央値 1203 / 最大 1206 ms
[FEAT]
  窓の数: 240
  次元数 N: 29
  記録の長さ（FEAT だけの値。目安）: 60.954 秒
  実効レート（装置の送信時刻から。窓の開始の間隔）: 4.00 窓/秒（公称 4 Hz 比 100.0%）
  飛び: 0 箇所 / 失われた窓数(推定): 0 / 取りこぼし率: 0.000%
  window_t_ms の最大差分: 251 ms / window_t_ms の逆行: 0 箇所 / t_ms の逆行: 0 箇所
  送信時刻 − 窓の開始（t_ms − window_t_ms）: 最小 1201 / 中央値 1204 / 最大 1208 ms
  DETECT との window_t_ms の不一致: 0 窓（DETECT にだけある 0 / FEAT にだけある 0）

[判定] 取りこぼし率 1%未満を「基準内」とする（Issue #7 の作業上の基準。docs/evaluation.md の合格線ではない）
  DETECT:基準内（0.000%）
  FEAT:  基準内（0.000%）
  ※ XOR 不一致数はここでは分からない。tools/record.py の終了時の表示を見ること。
```

`python analysis/evaluate_detector.py data/raw --sessions 20261001-160128_self_water --scorer analysis/m2_scorer.py` の出力（そのまま。参考値。M2 の数字ではない）:

```markdown
# M2 検出器の評価（detect.csv の positive と events.csv の s）

## 実行の条件

- 実行: `python analysis/evaluate_detector.py data/raw --sessions 20261001-160128_self_water --scorer analysis/m2_scorer.py`
- 対象: --sessions で明示したセッション
- コミット: 102a83e
- 窓 1.0 秒 / ホップ 0.25 秒。数え方は docs/evaluation.md と docs/decisions/0011、記録の範囲（送信の遅れの上限 1000 ms）は docs/decisions/0021
- `threshold`: 0.949999988（float32 0.949999988。装置の申告値）、`model`: {"deploy_version": 2, "project_id": 1117130, "source": "edge-impulse"}、`feature_set`: 'm2-0020'

## root の検出器のセッション（fw が `detector`。12）

| セッション | cond | 評価 | 理由 |
|---|---|---|---|
| 20260926-114039_self_water | water | 使わない | --sessions に無い |
| 20260926-142926_self_water | water | 使わない | --sessions に無い |
| 20260926-144044_self_cough | cough | 使わない | --sessions に無い |
| 20260926-161925_self_water | water | 使わない | --sessions に無い |
| 20260926-162247_self_water | water | 使わない | --sessions に無い |
| 20261001-134602_self_water | water | 使わない | --sessions に無い |
| 20261001-134924_self_water | water | 使わない | --sessions に無い |
| 20261001-155956_self_water | water | 使わない | --sessions に無い |
| 20261001-160014_self_water | water | 使わない | --sessions に無い |
| 20261001-160046_self_water | water | 使わない | --sessions に無い |
| 20261001-160128_self_water | water | 使う |  |
| 20261001-160247_self_water | water | 使わない | --sessions に無い |

## 評価に使ったセッション（1）

| セッション | cond | 収集日 | 会話 | 嚥下 | 検出 | 誤検出（回） | 非嚥下（分） | 次元数 | FEAT に無い窓 | M2 の数字 |
|---|---|---|---|---|---|---|---|---|---|---|
| 20261001-160128_self_water | water | 20261001 | なし | 1 | 0 | 0 | 0.98 | 29 | 0 | 使わない（cond が meal でない） |

## 合算

合算は出さない（1 セッション。3 セッション未満。M2 の数字ではない）。

## 参考値（docs/decisions/0011「既知の弱点」、#27）

- 常時陽性の場合（全窓を陽性にした場合）: 検出率 1.000（1/1）、誤検出 1 回、誤検出率 1.02 回/分（非嚥下 0.98 分）
- 陽性窓の割合（陽性窓 ÷ 全窓）: 0.000（0/240）
- `positive != (prob >= threshold)` の行数（float32 で比較）: 0
- `led` と docs/decisions/0018 の規則からの再計算（`analysis/led_rule.py`）の不一致の行数（評価には使わない）: 0
- `c` に紐づく誤検出の塊（塊の最初の窓の中心 − t_c が [-1.0, +5.0] 秒）: `c` 0 回、紐づく塊 0 / 誤検出の塊 0、紐づく塊が 1 つ以上ある `c` の割合 —（0/0）
- 収集日ごと（式は回数の合算。3 セッション未満でも出す）:
  - 20261001: 検出率 0.000（0/1）、誤検出 0 回、誤検出率 0.00 回/分（非嚥下 0.98 分）
- 会話の有無ごと（`o` の note が `conv` のセッションが会話あり）:
  - 会話なし: 検出率 0.000（0/1）、誤検出 0 回、誤検出率 0.00 回/分（非嚥下 0.98 分）

## 再採点（`--scorer analysis/m2_scorer.py`。feat.csv を PC で採点し、閾値 float32 0.949999988 で陽性にした）

| セッション | 窓 | 装置 1 / PC 0 | 装置 0 / PC 1 | max abs(prob − prob_pc) | 装置: 検出 / 誤検出 | PC: 検出 / 誤検出 |
|---|---|---|---|---|---|---|
| 20261001-160128_self_water | 240 | 0 | 0 | 0 | 0/1 / 0 回 | 0/1 / 0 回 |

- 装置の合算: 検出率 0.000（0/1）、誤検出 0 回、誤検出率 0.00 回/分（非嚥下 0.98 分）
- PC の合算: 検出率 0.000（0/1）、誤検出 0 回、誤検出率 0.00 回/分（非嚥下 0.98 分）
- 差のある窓の合計: 装置 1 / PC 0 が 0、装置 0 / PC 1 が 0

```

`python analysis/evaluate_detector.py data/raw --sessions 20261001-160247_self_water --scorer analysis/m2_scorer.py` の出力（そのまま。参考値。M2 の数字ではない）:

```markdown
# M2 検出器の評価（detect.csv の positive と events.csv の s）

## 実行の条件

- 実行: `python analysis/evaluate_detector.py data/raw --sessions 20261001-160247_self_water --scorer analysis/m2_scorer.py`
- 対象: --sessions で明示したセッション
- コミット: 102a83e
- 窓 1.0 秒 / ホップ 0.25 秒。数え方は docs/evaluation.md と docs/decisions/0011、記録の範囲（送信の遅れの上限 1000 ms）は docs/decisions/0021
- `threshold`: 0.949999988（float32 0.949999988。装置の申告値）、`model`: {"deploy_version": 2, "project_id": 1117130, "source": "edge-impulse"}、`feature_set`: 'm2-0020'

## root の検出器のセッション（fw が `detector`。12）

| セッション | cond | 評価 | 理由 |
|---|---|---|---|
| 20260926-114039_self_water | water | 使わない | --sessions に無い |
| 20260926-142926_self_water | water | 使わない | --sessions に無い |
| 20260926-144044_self_cough | cough | 使わない | --sessions に無い |
| 20260926-161925_self_water | water | 使わない | --sessions に無い |
| 20260926-162247_self_water | water | 使わない | --sessions に無い |
| 20261001-134602_self_water | water | 使わない | --sessions に無い |
| 20261001-134924_self_water | water | 使わない | --sessions に無い |
| 20261001-155956_self_water | water | 使わない | --sessions に無い |
| 20261001-160014_self_water | water | 使わない | --sessions に無い |
| 20261001-160046_self_water | water | 使わない | --sessions に無い |
| 20261001-160128_self_water | water | 使わない | --sessions に無い |
| 20261001-160247_self_water | water | 使う |  |

## 評価に使ったセッション（1）

| セッション | cond | 収集日 | 会話 | 嚥下 | 検出 | 誤検出（回） | 非嚥下（分） | 次元数 | FEAT に無い窓 | M2 の数字 |
|---|---|---|---|---|---|---|---|---|---|---|
| 20261001-160247_self_water | water | 20261001 | なし | 1 | 0 | 0 | 0.98 | 29 | 0 | 使わない（cond が meal でない） |

## 合算

合算は出さない（1 セッション。3 セッション未満。M2 の数字ではない）。

## 参考値（docs/decisions/0011「既知の弱点」、#27）

- 常時陽性の場合（全窓を陽性にした場合）: 検出率 1.000（1/1）、誤検出 1 回、誤検出率 1.02 回/分（非嚥下 0.98 分）
- 陽性窓の割合（陽性窓 ÷ 全窓）: 0.000（0/240）
- `positive != (prob >= threshold)` の行数（float32 で比較）: 0
- `led` と docs/decisions/0018 の規則からの再計算（`analysis/led_rule.py`）の不一致の行数（評価には使わない）: 0
- `c` に紐づく誤検出の塊（塊の最初の窓の中心 − t_c が [-1.0, +5.0] 秒）: `c` 0 回、紐づく塊 0 / 誤検出の塊 0、紐づく塊が 1 つ以上ある `c` の割合 —（0/0）
- 収集日ごと（式は回数の合算。3 セッション未満でも出す）:
  - 20261001: 検出率 0.000（0/1）、誤検出 0 回、誤検出率 0.00 回/分（非嚥下 0.98 分）
- 会話の有無ごと（`o` の note が `conv` のセッションが会話あり）:
  - 会話なし: 検出率 0.000（0/1）、誤検出 0 回、誤検出率 0.00 回/分（非嚥下 0.98 分）

## 再採点（`--scorer analysis/m2_scorer.py`。feat.csv を PC で採点し、閾値 float32 0.949999988 で陽性にした）

| セッション | 窓 | 装置 1 / PC 0 | 装置 0 / PC 1 | max abs(prob − prob_pc) | 装置: 検出 / 誤検出 | PC: 検出 / 誤検出 |
|---|---|---|---|---|---|---|
| 20261001-160247_self_water | 240 | 0 | 0 | 0 | 0/1 / 0 回 | 0/1 / 0 回 |

- 装置の合算: 検出率 0.000（0/1）、誤検出 0 回、誤検出率 0.00 回/分（非嚥下 0.98 分）
- PC の合算: 検出率 0.000（0/1）、誤検出 0 回、誤検出率 0.00 回/分（非嚥下 0.98 分）
- 差のある窓の合計: 装置 1 / PC 0 が 0、装置 0 / PC 1 が 0

```

### 1 ホップの時間（`-DDETECTOR_PROFILE=1`）

計測ビルドを書き込み、scratchpad の使い捨ての読み取りスクリプト（`serial_probe_meta.py`。#24・#25 の `serial_probe.py` と同じ解析に合図の送信を足したもの。コミットしない。
`data/raw/` に書かない。ペイロードは記録しない）を 70 秒動かし、開始時と 10 秒ごとに `'M'` を送った。

- 合図 7 回に対して META 8（最初の合図のときに起動時の META ＋ 再送）。どの合図にも META が 1 つ届いた。`meta_resends` は送った合図の数だけ増えた（2 → 7）。
- 合図から META までの遅れ: 20〜248 ms。最初だけ 1052 ms（起動待ち。ポートが開くまで `setup()` が `while (!Serial)` で待ち、その後の初期化の分）。
  250 ms 近くまで延びるのは、受信の確認が 1 ホップの処理（約 207 ms）の合間にしか回らないためと見ている（推測。測り分けていない）。`record.py` の待ち 5 秒より十分小さい。
- `meta_send_max` 2620 µs（合図による META 564 B の `frame_send` 1 回の所要の最大）。
- 統計行: `total_max` 207.2〜208.0 ms、`wall_max` 211〜212 ms、`dropped_chunks` 0、`pdm_gaps` 0、`hop_false_reset`・`hop_false_imu_short`・`hop_false_classify` 0、
  `imu_rows_total` は 10 秒で約 1055 増えた。#24・#25（`total_max` 206〜210 ms、`wall_max` 211〜214 ms）と同等。
  合図を受けた期間も `wall_max` は 250 ms 以内で、`dropped_chunks`・`pdm_gaps` は増えなかった。
- 統計行の 10 秒の期間はどれも合図を 1 回含む（合図の間隔と同じ 10 秒）。plan 4.2 の 6. の「合図の無い期間」は取れておらず、#24・#25 の値と比べた（下の「plan から外れた点」）。
- `hop_false_not_filled` 3 は起動直後に窓が埋まるまでの分で、増えていない。

人が貼った出力（そのまま）:

```
probe... 合図 'M' を開始時と 10 秒ごとに送る / Ctrl-C で終了
  -> request #1 at 0.0 s (wrote 1 B)
  META #1 t_ms=16155 len=564 B (1052.1 ms after request #1)
  META #2 t_ms=16177 len=564 B (1072.4 ms after request #1)
  -> request #2 at 10.0 s (wrote 1 B)
  META #3 t_ms=25138 len=564 B (20.4 ms after request #2)
  [text] prof t=26367 imu_thread=1 pdm=1 i2c_hz=400000 poll_ms=4 n=40 windows=37 total_med=206.296 total_max=207.314 wall_med=210.000 wall_max=211.000 audio_med=186.445 audio_max=187.581 imu_copy_med=0.183 imu_copy_max=1.100 imu_feat_med=11.879 imu_feat_max=13.551 nn_med=5.740 nn_max=6.804 send_med=0.732 send_max=2.674 led_med=0.000 led_max=0.709 wait_max=5 imu_rows_min=105 imu_rows_max=106 hops=40 windows_total=37 hop_false_not_filled=3 hop_false_reset=0 hop_false_imu_short=0 hop_false_classify=0 last_reason=0 imu_rows_last=106 classify_err_last=0 slices_taken=40 slices_ready_max=1 dropped_chunks=0 pdm_odd_chunks=0 pdm_gaps=0 pdm_chunks_total=2552 pdm_bytes_last=128 pdm_cb_max=96 imu_rows_total=1088 imu_polls=2568 heap_peak=5788 stack_main=1784 stack_imu=2044 led_write_max=371 led_writes=5 led_skipped=0 led_state=1 led_begin_ms=763 meta_resends=2 meta_send_max=2620
  -> request #3 at 20.0 s (wrote 1 B)
  META #4 t_ms=35157 len=564 B (40.6 ms after request #3)
  [text] prof t=36367 imu_thread=1 pdm=1 i2c_hz=400000 poll_ms=4 n=40 windows=40 total_med=206.264 total_max=207.219 wall_med=210.000 wall_max=211.000 audio_med=186.411 audio_max=187.368 imu_copy_med=0.183 imu_copy_max=0.862 imu_feat_med=11.889 imu_feat_max=13.423 nn_med=5.977 nn_max=6.915 send_med=0.696 send_max=2.592 led_med=0.000 led_max=0.000 wait_max=5 imu_rows_min=105 imu_rows_max=106 hops=80 windows_total=77 hop_false_not_filled=3 hop_false_reset=0 hop_false_imu_short=0 hop_false_classify=0 last_reason=0 imu_rows_last=106 classify_err_last=0 slices_taken=80 slices_ready_max=1 dropped_chunks=0 pdm_odd_chunks=0 pdm_gaps=0 pdm_chunks_total=5052 pdm_bytes_last=128 pdm_cb_max=96 imu_rows_total=2143 imu_polls=5054 heap_peak=5788 stack_main=1784 stack_imu=2044 led_write_max=371 led_writes=5 led_skipped=0 led_state=1 led_begin_ms=763 meta_resends=3 meta_send_max=2620
  -> request #4 at 30.0 s (wrote 1 B)
  META #5 t_ms=45368 len=564 B (247.9 ms after request #4)
  [text] prof t=46368 imu_thread=1 pdm=1 i2c_hz=400000 poll_ms=4 n=40 windows=40 total_med=206.070 total_max=207.967 wall_med=210.000 wall_max=212.000 audio_med=186.455 audio_max=187.494 imu_copy_med=0.184 imu_copy_max=1.082 imu_feat_med=11.899 imu_feat_max=13.351 nn_med=6.073 nn_max=6.740 send_med=0.681 send_max=2.520 led_med=0.000 led_max=0.000 wait_max=5 imu_rows_min=105 imu_rows_max=106 hops=120 windows_total=117 hop_false_not_filled=3 hop_false_reset=0 hop_false_imu_short=0 hop_false_classify=0 last_reason=0 imu_rows_last=106 classify_err_last=0 slices_taken=120 slices_ready_max=1 dropped_chunks=0 pdm_odd_chunks=0 pdm_gaps=0 pdm_chunks_total=7552 pdm_bytes_last=128 pdm_cb_max=96 imu_rows_total=3198 imu_polls=7534 heap_peak=5788 stack_main=1784 stack_imu=2044 led_write_max=371 led_writes=5 led_skipped=0 led_state=1 led_begin_ms=763 meta_resends=4 meta_send_max=2620
  -> request #5 at 40.0 s (wrote 1 B)
  META #6 t_ms=55368 len=564 B (228.0 ms after request #5)
  [text] prof t=56368 imu_thread=1 pdm=1 i2c_hz=400000 poll_ms=4 n=40 windows=40 total_med=206.678 total_max=207.252 wall_med=210.000 wall_max=212.000 audio_med=187.129 audio_max=187.402 imu_copy_med=0.183 imu_copy_max=0.858 imu_feat_med=11.924 imu_feat_max=13.353 nn_med=5.931 nn_max=6.648 send_med=0.840 send_max=2.494 led_med=0.000 led_max=0.000 wait_max=5 imu_rows_min=105 imu_rows_max=106 hops=160 windows_total=157 hop_false_not_filled=3 hop_false_reset=0 hop_false_imu_short=0 hop_false_classify=0 last_reason=0 imu_rows_last=105 classify_err_last=0 slices_taken=160 slices_ready_max=1 dropped_chunks=0 pdm_odd_chunks=0 pdm_gaps=0 pdm_chunks_total=10052 pdm_bytes_last=128 pdm_cb_max=96 imu_rows_total=4253 imu_polls=10015 heap_peak=5788 stack_main=1784 stack_imu=2044 led_write_max=371 led_writes=5 led_skipped=0 led_state=1 led_begin_ms=763 meta_resends=5 meta_send_max=2620
  -> request #6 at 50.0 s (wrote 1 B)
  META #7 t_ms=65157 len=564 B (20.1 ms after request #6)
  [text] prof t=66368 imu_thread=1 pdm=1 i2c_hz=400000 poll_ms=4 n=40 windows=40 total_med=206.311 total_max=207.331 wall_med=210.000 wall_max=212.000 audio_med=186.525 audio_max=187.421 imu_copy_med=0.184 imu_copy_max=0.871 imu_feat_med=11.928 imu_feat_max=13.494 nn_med=5.945 nn_max=6.788 send_med=0.732 send_max=2.575 led_med=0.000 led_max=0.000 wait_max=5 imu_rows_min=105 imu_rows_max=106 hops=200 windows_total=197 hop_false_not_filled=3 hop_false_reset=0 hop_false_imu_short=0 hop_false_classify=0 last_reason=0 imu_rows_last=105 classify_err_last=0 slices_taken=200 slices_ready_max=1 dropped_chunks=0 pdm_odd_chunks=0 pdm_gaps=0 pdm_chunks_total=12552 pdm_bytes_last=128 pdm_cb_max=96 imu_rows_total=5308 imu_polls=12494 heap_peak=5788 stack_main=1784 stack_imu=2044 led_write_max=371 led_writes=5 led_skipped=0 led_state=1 led_begin_ms=763 meta_resends=6 meta_send_max=2620
  -> request #7 at 60.0 s (wrote 1 B)
  META #8 t_ms=75368 len=564 B (229.0 ms after request #7)
  [text] prof t=76368 imu_thread=1 pdm=1 i2c_hz=400000 poll_ms=4 n=40 windows=40 total_med=206.313 total_max=207.235 wall_med=210.000 wall_max=211.000 audio_med=186.576 audio_max=187.505 imu_copy_med=0.184 imu_copy_max=1.092 imu_feat_med=11.902 imu_feat_max=13.474 nn_med=5.760 nn_max=6.852 send_med=0.799 send_max=2.634 led_med=0.000 led_max=0.000 wait_max=5 imu_rows_min=105 imu_rows_max=106 hops=240 windows_total=237 hop_false_not_filled=3 hop_false_reset=0 hop_false_imu_short=0 hop_false_classify=0 last_reason=0 imu_rows_last=105 classify_err_last=0 slices_taken=240 slices_ready_max=1 dropped_chunks=0 pdm_odd_chunks=0 pdm_gaps=0 pdm_chunks_total=15052 pdm_bytes_last=128 pdm_cb_max=96 imu_rows_total=6364 imu_polls=14979 heap_peak=5788 stack_main=1784 stack_imu=2044 led_write_max=371 led_writes=5 led_skipped=0 led_state=1 led_begin_ms=763 meta_resends=7 meta_send_max=2620

==== 集計（ペイロードは記録していない） ====
frames: DETECT=272, FEAT=272, META=8
xor_err: 0
合図を送った数: 7 / 届いた META: 8
統計行（期間ごと。meta_resends・meta_send_max は累計）:
  t total_max wall_max dropped_chunks pdm_gaps hop_false_reset hop_false_imu_short imu_rows_total meta_resends meta_send_max
  26367 207.314 211.000 0 0 0 0 1088 2 2620
  36367 207.219 211.000 0 0 0 0 2143 3 2620
  46368 207.967 212.000 0 0 0 0 3198 4 2620
  56368 207.252 212.000 0 0 0 0 4253 5 2620
  66368 207.331 212.000 0 0 0 0 5308 6 2620
  76368 207.235 211.000 0 0 0 0 6364 7 2620
```

- 計測の後、人が検出器を本番ビルドに書き戻した（#27 は本番ビルドで録る。人が確認）。

### 合格の条件（plan 4.3）との照合

- 挿し直さずに 2 回続けて、両方の `meta.json` に 4 つのキー、`META` 1 以上 → 満たす（2、1）。
- 60 秒の `water` で取りこぼし 0、`led` 不一致 0、再採点の差 0、DETECT と FEAT の窓の不一致 0、最初のマーカーが範囲に入る → 満たす（表示器なし・ありの 2 本とも）。
- 1 ホップの時間が #24・#25 と同等、合図を受けた期間も `wall_max` 250 ms 以内、`dropped_chunks`・`pdm_gaps` が増えない、`meta_send_max` を記録 → 満たす（2620 µs）。
- 挿し直した直後の `META: 2` は合格条件にしない（観察。この 1 回では 2 だった）。

### 範囲外で見つかったこと

- `record.py` の解析は、読み取りの切れ目が SYNC（`0xA5` `0x5A`）の 2 バイトの間に来ると、そのフレームを 1 つ失う（既存の欠点。plan が「SYNC の探し方は今のまま」としたので
  この Issue では直していない）。Issue #34。この記録の 5 本と 70 秒の計測では、取りこぼし・飛びは 0 だった。

### plan から外れた点

- 1 ホップの時間の計測で、合図の無い期間を取らなかった（統計行の期間と合図の間隔がどちらも 10 秒で、どの期間も合図を 1 回含む）。合図の無い期間の値の代わりに #24・#25 の値と比べた。
- plan 4.2 の 3.（存在しないポートなどで止まる様子を実機で 1 回見る。任意）は報告に無い。止まり方は自動テスト（r19・r21・r22・r22b、t10）だけで確かめた。

### 確かめていないこと

- 挿し直した直後に合図が USB の受信側で失われないこと（`setup()` の間はホストの送信が待たされ、`loop()` で読まれるという core の読みに基づく推測）。
  挿し直してからの 1 回では `META: 2` で、合図は失われなかった。1 回だけなので、いつもそうなるかは分からない（失われても起動時の META が届けば記録は始まる）。
- `Serial.available()` を 20 ms ごとに呼ぶ負荷そのもの（µs の桁の見込み）。統計行の `total_max`・`wall_max` が #24・#25 と同等なので影響は見えないが、測り分けていない。
- 合図から META までの遅れが 250 ms 近くまで延びる理由（1 ホップの処理の合間にしか受信を確かめないため、という推測）。
- #25 の B で「挿し直したのに META が届かなかった」原因（他のプログラムが先にポートを開いて META を受けた、などが考えられるが未確認）。再現は見ていない。
  合図で送り直すので、原因が何であれ記録の開始時に届く見込み。
- 記録ファームウェア（logger）で `record.py` を使ったときの止まり方（自動テストでだけ確かめた。logger を書き込んで録る確認はしていない）。
- `pyserial` の `write_timeout=1.0` で合図の書き込みが止まる状況（ポートは開けたがホスト側の送信が詰まる）。実機では起きない見込み。
- `meal`（最長 30 分）の長さで合図と META の受け取りが問題なく続くか（確かめたのは 10 秒と 60 秒。合図は開始時の 1 回だけなので、長さには依らない見込み）。
- 実機の状態: 検出器は本番 `102a83e`（人が計測の後に本番を書き戻した）、表示器は本番 `2bc1ef6`（UNO R4 WiFi）。logger は書き戻していない。

## #34 record.py: SYNC の途中で読み取りが切れてもフレームを失わない

Issue #34。#33 の段階 1 で見つかった既存の欠点（上の「範囲外で見つかったこと」）への対応。`tools/record.py` の `parse_frames` だけを直した。
PC 側だけの変更で、ファームウェア・フレーム形式・`read_frames`/`wait_meta` の呼び出し方は変えていない。

- 問題: `buf.find(SYNC)` が失敗すると `buf.clear()` で全部捨てていたため、`ser.read(4096)` の切れ目が SYNC（`0xA5` `0x5A`）の間に来ると
  末尾の `0xA5` が失われ、次の読み取りの先頭が `0x5A …` になって、そのフレームを 1 つ失っていた（実機では確率が低く、#24〜#33 の記録では取りこぼし 0）。
- 直し: SYNC が見つからないとき、`buf` の末尾が `0xA5`（`SYNC[0]`）ならその 1 バイトだけ残し、それ以外なら今までどおり全部捨てる。長さ不足・XOR の分岐は変えていない。
- テスト: `tools/test_record.py` に r25（SYNC の `A5`/`5A` の間で切って `read_frames`、3 組とも届く）・r25b（1 バイトずつ）・r25c（末尾が `0xA5` 以外のゴミだけなら今までどおり捨てる）を足した。
  `.venv/bin/python -m unittest discover -s tools -v` は 47 → 50 件、すべて OK。`-s analysis` は 261 件で不変。
