owhinata/zaitaku-mealpace/docs/decisions/0018-bite-button-and-led-rule.md

# 0018 一口ボタンは M2 で使わず、LED は緑・黄の2色を「目安」として点ける

日付: 2026-09-24　状態: 採用

人が 9/24 に決めた方向（一口ボタンは M2 で使わない、LED は緑・黄のみ、赤は出さない、むせの分類は作らない）と、
その上で人が決めた数値と文言（基板の RGB LED、最初の陽性窓で点ける、保持 2.0 秒、1.0 秒で消灯）をここに固定する。
`docs/evaluation.md` の定義と合格線は変えていない。採否の経緯は Issue #19 のコメントにある。
点灯の条件を案A のままにするかは、#20 の集計値で確かめる（「#20 で確かめる箇所」）。

## 決定

### 一口ボタン

- M2 では一口ボタン（マーカー `b`）を使わない。嚥下イベントの時刻と回数はボタンなしで取る。
- 潜時（口に入れてから嚥下開始までの秒数）は一口の時刻が要るので、M3 以降で扱う。M3 の本人試用で `b` を打つかどうかは、
  M3 の前に別に決める（`docs/plan.md`「M3 の前に行うこと」と同じ時期）。
- `docs/data-schema.md` の `events.csv` の `b` は残す（形式は変えない）。`tools/record.py` のキーも変えない。
  #26 の `meal` の手順では `b` を打たない。
- 検出器ファームウェアにボタン入力を付けない。装置の入力はセンサだけ。

### LED の色と条件（M2）

窓は `docs/evaluation.md` の 1.0 秒 / ホップ 0.25 秒。「陽性」は装置の2値の出力（#18 の方式、#22 で凍結した閾値）。
LED は窓の結果が出るたび（0.25 秒ごと）に更新する。

| 表示 | 意味（介助者向け） | 条件 |
|---|---|---|
| 緑 | 嚥下を確認した目安 | 現在の窓（開始 `w`）を含めて、開始が `[w − 1.75, w]` にある陽性の窓が1つ以上ある（窓の開始時刻の差で数える） |
| 黄 | 嚥下をまだ確認していない目安 | 装置が動いていて、緑の条件を満たさない |
| 消灯 | 動作していない | 起動から最初の窓の結果が出るまで。センサの初期化に失敗したとき。新しい窓の結果が 1.0 秒（4 ホップ分）以上出ないとき（窓の結果とは別に `millis()` で測る） |

- **緑を点ける時点**: 最初の陽性窓が出た直後（案A）。陽性の連続の終わりを待たない。
- **緑を保つ時間**: 最後の陽性窓の開始 `w_p` から、開始が `w_p + 1.75` 以下の窓まで緑、開始が `w_p + 2.0` の窓から黄。
  ホップ 0.25 秒なら緑は結果 8 回分 = 2.0 秒。陽性窓が続けば延びる（陽性のたびに `w_p` を取り直す）。
  k 窓の連続なら、緑は `(k − 1) × 0.25 + 2.0` 秒。
- **黄に戻る条件**: 開始が `[w − 1.75, w]` にある陽性の窓が無い。
- 条件を窓の番号（直近 8 窓）ではなく開始時刻の差で書くのは、窓の飛び（取りこぼし）があっても装置の状態と PC 側の再計算が同じ式で
  一致するため。装置は `w_p` を保持して現在の窓の開始と比べるだけで、窓の履歴を持たない。
- **赤は出さない。** 黄は時間が経っても色を変えない（「未嚥下が続く」の段階付けは赤の役割で、M3 以降）。
  咳・むせを表す表示は無い（装置の出力は2値で、咳は陰性に畳む。#18）。
- **緑と黄は常時点灯。** 点滅、明るさの段階、回数の表示、音は使わない。
- 起動失敗の表示は記録ファームウェアと同じ `LED_BUILTIN`（D13、RGB とは別の LED）の 200 ms 点滅。RGB は消灯のまま。
- **LED は評価に関わらない。** M2 の検出評価は `detect.csv` の `positive` だけを `docs/evaluation.md` のとおり数える。緑の保持
  （1.75 秒）は評価の「陽性が連続する窓」の数え方（docs/decisions/0011 の 0.375 秒）とは別物で、評価の数え方を変えない。
- **DETECT の `led` の値**: `0` 消灯、`1` 黄、`2` 緑。#23 が `docs/data-schema.md` に書くときにこの値を使う。
  `positive` と `window_t_ms` の列から上の規則で `led` を PC 側で再計算でき、装置の `led` 列と一致することを #25 で確かめる。
  一致の確認は結果が届いた行（`detect.csv` の各行）に限る。消灯の時点は行として残らない。

嚥下の開始から緑までの遅れ: 陽性になる窓の終端（検出の定義では窓の中心が `[t − 0.5, t + 1.5]` なので、終端は開始から
0〜2.0 秒）＋ 1 ホップ分の処理（#24 の上限 250 ms）。実際の値は #25 で `events.csv` の `s` と `detect.csv` の `led` から出す。

### 装置の LED

- **基板の RGB LED（NINA-W102 経由）を使う。** WiFiNINA ライブラリが要る（`CMakeLists.txt` の `deps` に
  `arduino-cli lib install WiFiNINA` を足す。#25）。`NinaPin` 版の `pinMode` / `digitalWrite` は `firmware/detector/` の
  LED モジュールの内側だけで呼ぶ（docs/decisions/0001）。「開始が `[w − 1.75, w]` にある陽性窓があるか」の規則は Arduino に
  依存しない関数に分け、PC 側の再計算と同じ式にする。1.0 秒の消灯は窓の結果とは独立した `millis()` のタイムアウトで実装する。
- 黄は赤＋緑の同時点灯。見え方（緑と区別が付くか）と極性は #25 で実機で確かめる。
- **外付けに切り替える条件**（どれか1つで切り替える。規則と文言は同じ）:
  (a) バンドやケースで隠れて、介助者側から見えない。
  (b) NINA への書き込みで `t_ms` の飛びが作業上の基準（1%、#7）を超える、または 1 ホップの処理が 250 ms に収まらなくなる。
  (c) WiFiNINA を入れたビルドが通らない、または NINA のファームウェアの版で動かない。
  切り替え先は RP2040 の GPIO に直結した緑・黄の 2 灯（抵抗付き。M2 は2色なので3色は要らない）。

### 文言

対象は、装置に貼る表示、介助者に渡すカード、`docs/`（`firmware/detector/README.md` を含む）、log、Issue、コードの名前。

装置に貼る表示（ケースの介助者側。本人の正面から見えにくい向きに貼る）:

```
嚥下の目安（判定ではありません）
緑: 嚥下を確認した目安（約 2 秒）
黄: まだ確認していない目安
```

介助者に渡すカード:

```
この光は嚥下の目安です。判定や指示ではありません。
緑: 喉の動きと音から嚥下らしいと見た目安。約 2 秒で黄に戻ります。
黄: まだ確認していない目安。時間が経っても色は変わりません。
消灯: 動いていません。
次の一口をいつにするかは、介助者が決めます。
咳や首の動きの直後に緑が点くことがあります。
誤嚥（気管に入ること）が起きたかどうかは、この装置では分かりません。
```

書き方の決まり:

- 「目安」を使う。装置を主語にした「判定」「判断」「指示」「合図」「許可」「警告」「注意」と、「安全」「危険」「正常」「異常」
  「OK」「NG」「進んでよい」「止めて」は使わない。「判定ではない」のような否定は可。
- 表示は介助者に向けて書く。本人に「見てください」「待ってください」と言わない。
- 「誤嚥」の語は、装置に貼る表示には入れない。カードと文書では「分からない」という否定の形でだけ使う。
  「誤嚥検出」「aspiration」「risk」に当たる語は、文書・コード・ラベルのどこにも入れない（CLAUDE.md「作らないもの」）。
- コードの名前は色と状態で付ける（`LED_OFF` / `LED_YELLOW` / `LED_GREEN`、`led_hold_windows` など）。
  `alert` / `alarm` / `warn` / `risk` / `verdict` / `safe` / `unsafe` / `judge` に当たる名前を使わない。

## 理由

- **ボタンを使わない。** 企画書 12章の対策どおり、検出と回数はボタンなしで取れる設計にし、潜時だけをボタン依存にする。
  M2 の合格線（検出率、誤検出率）は `docs/evaluation.md` のとおり `s` と非嚥下区間だけで決まり、`b` を使わない。
  M2 の通し記録（#27）は開発者が1人で行うので、ボタンを足すと記録の手が1つ増えるだけで数字は変わらない。
- **緑は最初の陽性窓で点ける（案A）。** 介助者が食事中に見る表示なので、遅れが最も小さい条件を採る。連続の終わりを待つ案は
  最低 0.25 秒、M1 の評価側の最長の塊（7 窓）では 1.75 秒遅れる。M1 の評価側では塊の 46% が 1 窓だけなので、連続の終わりを
  待っても得られる情報は少ない。塊の長さと誤検出の関係はまだ集計していない（#20 で集計する）。
- **保持は 2.0 秒。** 1 窓だけの塊（46%）は保持が無いと 0.25 秒しか点かず、目で追えない。2.0 秒は `docs/evaluation.md` の
  嚥下の区間 `[t − 0.5, t + 1.5]` の長さと同じで、1回の嚥下の陽性窓がこの中に収まる。M1 の記録手順の嚥下の間隔（10 秒以上）より
  十分に短く、次の嚥下の前に黄へ戻る。食事の一口の間隔は M2 の `meal` の記録（#27）で初めて分かる。
- **黄は変化させない。** 「未嚥下が続く」を段階で示すのは赤の役割であり、時間の閾値を置くと「そろそろ次へ」という指示に読める。
  M2 の LED は「確認したか、まだか」だけを示す。
- **消灯の規則を置く。** 窓の結果が止まったときに最後の色が残ると、動いていない装置の緑を介助者が信じてしまう。
  1.0 秒（4 ホップ）で消灯にすれば、止まったことが表示で分かる。止まっている間は窓の結果が来ないので、この監視は窓の結果とは
  別の時計（`millis()`）で動かす。
- **基板の RGB LED を使う。** 追加の部品と配線が要らず、M2 の期間（2 週間）に収まる。喉元の基板の LED は本人からは見えず、
  向かい合う介助者からは見えるので、企画書 10章「表示は介助者側に向ける」と合う。NINA 経由の書き込みのコストは未確認なので、
  切り替える条件を先に書いておく。
- **文言は否定を1つ入れる。** 「目安」だけでは装置が何をしないかが伝わらない。企画書 12章の「装置の表示にも『目安』と明記」に加え、
  「判定ではありません」を表示に、「誤嚥は分からない」をカードに置く。

## #20 で確かめる箇所

- 点灯の条件を案A（最初の陽性窓）のままにするか、案C（陽性窓が2つ連続したとき）にするか。#20 が出す「塊の長さ別の誤検出の割合」
  （人の決定で #20 に足した）と「咳の開始から何秒後に誤検出が起きるか」を見て、1 窓だけの塊の大半が誤検出なら案C を候補にする
  （遅れは 0.25 秒増える）。そうでなければ案A のまま。
- #20 の塊の集計は探索的な参考解析で、既に数字を見た M1 の評価側（収集日3+4）を含む。この集計で表示規則を決め切らない。
  案C に変えるかどうかの最終確認は、#25 の実機の記録（M1 の 28 セッションとは別の、新しいセッション）で LED の遅れと誤表示を
  見て行う。
- M2 の検出評価（#27）は `positive` だけを使う。案A でも案C でも評価の数字は変わらない。
- 保持 2.0 秒と消灯 1.0 秒は決定で、#20 では動かさない。
- 案C に変えるときは、#25 の plan（Codex のレビューを通す）でこの記録に「追記」の節を足す。番号は変えない。

## 選ばなかった案

- **M2 でも一口ボタンを使う。** 潜時が M2 で出せるが、合格線に関係なく、記録の負担が増える。企画書 12章の対策に反する。
- **赤を出す／3段階にする。** 「むせ」は咳の分類が要り、M2 では作らない（人の決定、#18）。「未嚥下が続く」の段階付けは時間の閾値が
  指示に読める。M3 以降で、本人の記録を見てから決める。
- **陽性の連続の終わりで点ける（案B）。** 遅れが増え、得られる情報が少ない（上の理由）。
- **陽性窓が2つ連続したときに点ける（案C）。** 今の集計では 1 窓の塊が誤検出に偏っているかが分からず、遅れが 0.25 秒増える分の
  根拠が無い。#20 の集計で偏りが出たときの切り替え先として残す（「#20 で確かめる箇所」）。
- **保持 1.0 秒。** 1 窓の塊で 1.0 秒しか点かず、目で追えないことがある。**保持 3.0 秒以上。** 近接した嚥下（水の記録では 10 秒以上
  あけるが、食事では未知）が1つの緑に見え、黄に戻るのが遅れる。
- **消灯の規則を置かない（最後の色を残す）。** 窓の結果が止まったときに緑が残り、動いていない装置の表示を介助者が信じてしまう。
- **黄を「未確認・待つ」と書く。** 企画書 5章の語だが、「待つ」は介助者への指示に読める余地がある。「まだ確認していない目安」にした。
- **カードに「誤嚥は分からない」を書かない。** 「目安」だけでは装置が何をしないかが伝わらず、緑を安心と読まれる。装置に貼る表示には
  入れず（短く保つ）、カードにだけ否定の形で書く。
- **点滅・明るさの段階・確率の表示。** 点滅は急かす合図に見える（企画書 10章）。確率を明るさで出すのは「スコア」に読める
  （CLAUDE.md「risk score に相当する表現」）。回数は `detect.csv` に残るので、表示しない。
- **ブザー・音。** 食卓で本人にも聞こえ、急かす道具になる。
- **黄を時間で変える（例: 30 秒で点滅）。** 赤の役割で、M3 以降。
- **外付けの3色 LED。** 配線と部品が要り、M2 の期間に収めるための余裕が減る。基板の LED が使えない場合の切り替え先として
  2 灯の形で残す。
- **`LED_BUILTIN` だけで表す。** 1色しか無く、緑と黄を分けられない。起動失敗の点滅にだけ使う。
- **RGB LED を WiFiNINA なしで直接駆動する。** コアが `NinaPin` の `pinMode` / `digitalWrite` をエラーにするので不可。

## 実装に渡すこと

- #23: DETECT の `led` は `0` 消灯 / `1` 黄 / `2` 緑。`analysis/evaluate_detector.py` は `led` を評価に使わない。
- #25: 上の表の規則。WiFiNINA を `deps` に足す。LED モジュールの境界。「開始が `[w − 1.75, w]` にある陽性窓があるか」の規則を
  Arduino に依存しない関数にし、`positive` と `window_t_ms` からの再計算と `led` 列の一致を確かめる。一致の確認は結果が届いた行に限る。
  1.0 秒の消灯は窓の結果とは独立した `millis()` のタイムアウトで実装し、止めたとき（センサを止める、USB を抜かずに推論を止める、など）に
  消灯することは実機で確かめる（`detect.csv` には残らない）。極性、黄の見え方、1 回の書き込みの時間、`t_ms` の飛びを実機で確かめて
  log に書く。表示とカードの文面をそのまま `firmware/detector/README.md` に載せる。開発者が装着したまま目で確かめるには鏡かカメラが要る。
- #26: `meal` の手順に「`b` は打たない」と書く。`docs/recording-protocol.md` 68 行目の「（一口ボタンの扱いは保留中の判断）」を
  この記録への参照に直す。

## 確かめていないこと

- `digitalWrite(NinaPin)` 1 回の時間と、PDM・IMU の取り込みへの影響（#25 で実測）。
- RGB LED の極性と、赤＋緑が黄に見えるか（#25）。
- 喉元に付けた基板の LED が、25 mm のバンドとケースで隠れないか（#25 で人が確かめる。隠れるなら外付け 2 灯へ）。
- 食事の一口の間隔と、2.0 秒の保持が食事で長すぎないか（#27 の `meal` の記録で初めて分かる）。

## 追記（2026-09-26、Issue #29）: 表示を別基板の RGB LED に移す（PC 経由。後に BLE）

- **切り替え条件 (a) に当たった。** #25 の実機の確認で、検出器の基板の RGB LED は喉に当てる面にあり、装着すると介助者側から見えないことが分かった
  （docs/log/2026-09-26.md「#25」）。(b)（`t_ms` の飛び・250 ms）と (c)（ビルド・NINA の版）には当たらなかった。
- **切り替え先を変える（人が決定、9/26）。** 上の「切り替え先は RP2040 の GPIO に直結した緑・黄の 2 灯」は採らない。もう 1 枚の Nano RP2040 Connect を表示器
  （`firmware/indicator/`）にし、その基板の RGB LED（NINA-W102 経由。#25 の書き込みを流用）で表示する。検出器は今のとおり USB で PC につながり、PC（`tools/record.py --indicator`）が
  DETECT の `led` を 1 バイト（`0` / `1` / `2`）ずつそのまま表示器へ USB シリアルで送る。後で、BLE で検出器から直接受ける形に置き換える（#30）。
- **理由。** 喉元の基板から配線を出さない（バンドの装着と首の動きの妨げ、引っ張り）。手元の基板で部品と配線を足さずに済む。表示器は本人から離し、介助者側に置ける
  （企画書 10章「表示は介助者側に向ける」）。PC 経由を先にするのは、検出器のファームウェアを変えずに済み、#25 で確かめた 1 ホップの処理時間（250 ms に収まる）に触れないため。
- **変えないこと。** 表示の規則（緑・黄・消灯の条件、案A、保持 2.0 秒、消灯 1.0 秒）と文言（装置に貼る表示、カード、書き方の決まり）。装置に貼る表示は表示器の介助者側に貼り、
  カードは介助者に渡す。表示器も、状態が 1.0 秒届かなければ消灯する（表示器の `millis()` で測る。状態が届かないことを「新しい窓の結果が出ない」と同じに扱う）。
  規則は検出器だけが持ち、PC と表示器は計算しない。
- **DETECT の `led` の意味は変えない。** `docs/data-schema.md` の「この窓の結果を反映した後の状態」は、検出器が自分の基板の LED に書いた後の状態のまま。検出器のファームウェアは
  変えないので、検出器の基板の LED は今までどおり点く（見えない）。表示器が実際に何を表示したかは記録に残らない。LED は評価に関わらない（上の「LED の色と条件」のとおり）。
- **`tools/record.py`。** 引数 `--indicator <port>` を足す（既定は無し。無ければ今までと同じ）。記録を始める前に表示器のポートが開けなければ記録を始めない。
  記録を始めた後に送れなくなっても記録は止めない（終了時に失敗の回数を表示する）。送信は別のスレッドで行い、記録の読み取りとマーカーが書き込みを待つ経路は無い。書くファイル・列・出力先
  （docs/decisions/0007）・マーカーの取り方は変えない（docs/decisions/0021 の「引数…は変えない」は #23 の範囲の決定で、この追記で引数を 1 つ足す）。転送の時刻は記録しない。
- **選ばなかった案。** GPIO 直結の 2 灯（喉元の基板から配線を出す）。検出器の基板の向きを変える・ケースに窓を開ける（LED は喉に当てる面にあり、センサの当て方を変えることになる）。
  最初から BLE で直結する（検出器のファームウェアと 1 ホップの処理時間に触れる。#30 で測ってから）。
- **確かめていないこと（#29 で確かめる）。** 表示器の緑・黄が介助者側から見えるか（置き方、明るさ）、PC → 表示器の遅れ（log に目安）、表示器を外しても検出器の記録が変わらないこと。

## 追記（2026-10-01、Issue #32）: 表示器を UNO R4 WiFi の LED マトリクスにし、区別を色から形にする

- **表示器の基板を替える（人が決定、9/29）。** #29 の表示器（Nano RP2040 Connect の基板の RGB LED）は緑と黄の区別が付きにくかった（#31）。表示器を Arduino UNO R4 WiFi にし、
  基板上の 12×8 LED マトリクスで示す（`firmware/indicator/`）。PC（`tools/record.py --indicator`）が DETECT の `led` を 1 バイトずつ中継する形、表示器が状態を 1.0 秒受けなければ消灯すること、
  規則を検出器だけが持つことは #29 の追記のまま。
- **区別を色から形に変える（人が決定、10/1。候補 12 組を実機で見比べた）。** マトリクスは単色なので、状態を形で示す。

  | `led` | 意味（介助者向け。変えない） | 表示器の形 |
  |---|---|---|
  | `2` | 嚥下を確認した目安 | 微笑む顔（静止画。目と口だけで輪郭は描かない） |
  | `1` | 嚥下をまだ確認していない目安 | 波線がゆっくり左へ流れる動画（1 列ずつ 200 ms × 6 フレーム、周期 1.2 秒。どのフレームも 12 個が点く） |
  | `0` | 動作していない | 消灯 |

  条件（案A、`[w − 1.75, w]`、保持 2.0 秒、消灯 1.0 秒）と `led` の値（`0` / `1` / `2`）は変えない。検出器の基板の RGB LED は今までどおり緑・黄で点く（装着すると見えない）。
- **動画と顔を使うのは人の決定。** この記録の「選ばなかった案」は点滅を「急かす合図に見える」として採らず、Issue #32 の当初の方針も静止した 2 種類（アニメーション・文字・記号を使わない）だった。
  人の方針（「食べている間は動きがあって、嚥下を確認したら笑顔」）により、状態 1 にだけ動画を使い、状態 2 に顔を使う。
  - 状態 1 の動画は点滅ではない。どのフレームも点く数が同じ（12 個）で、全体が消える瞬間も明るさの変化も無く、波の位置が 200 ms ごとに 1 列ずれるだけの静かなループ。
    時間が経っても速さも形も変わらない（「未嚥下が続く」の段階付けはしない。上の「黄は変化させない」と同じ）。
  - 状態 2 の顔は「嚥下を確認した目安」で、食べ方のよしあし・安全・許可の意味を持たない。顔は静止画で、動かさない。表情を状態や時間で変えない（顔は 1 種類だけ）。
  - 文字・数字・記号（「OK」「NG」「✓」「×」など判定に読めるもの）・バー・明るさの段階は使わない。マトリクスの明るさは固定（人が決定 B）。
- **マトリクスの赤は基板の発光色で、合図の色ではない。** 上の「赤は出さない」は、「未嚥下が続く」の段階付けに赤を使わない、という意味で、この決定はそれを変えない。
  赤は介助者に「異常」と読まれやすいので、貼る表示とカードに「赤い色に意味はない」と書く。
- **文言を形の名前に替える。** 書き方の決まり（上の「文言」）はそのまま。「判定ではありません」「判定や指示ではありません」と「誤嚥…分かりません」は残す。表示器の装置に貼る表示:

      嚥下の目安（判定ではありません）
      微笑む顔: 嚥下を確認した目安（約 2 秒）
      流れる波線: まだ確認していない目安
      赤い色に意味はありません

  介助者に渡すカード:

      この表示は嚥下の目安です。判定や指示ではありません。
      微笑む顔: 喉の動きと音から嚥下らしいと見た目安。約 2 秒で波線に戻ります。
      流れる波線: まだ確認していない目安。時間が経っても形や速さは変わりません。
      消灯: 動いていません。
      赤い色に意味はありません（基板の光の色です）。
      顔は嚥下の目安で、食べ方のよしあしを表すものではありません。
      次の一口をいつにするかは、介助者が決めます。
      咳や首の動きの直後に顔が出ることがあります。
      誤嚥（気管に入ること）が起きたかどうかは、この装置では分かりません。

- **コードの名前。** 状態の値の名前（`LED_OFF` / `LED_YELLOW` / `LED_GREEN`）は検出器と共有するので変えない（表示器では「状態 1 / 2」と読む）。表示器の図形の名前は形で付ける（`wave` / `smile`）。
  上の禁止の名前（`alert` / `warn` / `safe` / `judge` など）は使わない。
- **起動失敗の表示。** マトリクスのタイマが取れないとき（`begin()` が失敗）は、マトリクスを消灯のままにし、`LED_BUILTIN`（D13）を 200 ms で点滅する（上の「起動失敗の表示」と同じ形）。
- **DETECT の `led` の意味と記録は変えない。** `docs/data-schema.md` の `led` の説明は、値の意味（`1` まだ確認していない目安 / `2` 確認した目安）で書き、検出器の基板の色と表示器の形を括弧で添える。
  表示器が実際に何を表示したかは記録に残らない（#29 の追記のまま）。
- **選ばなかった案。** 静止画だけの組（外周の枠と全面、点と菱形など。動きが無いと動作中か止まっているかが分かりにくく、人の方針に合わなかった）。
  状態 2 も動画にする組（水滴・波紋・輪。確認の目安に動きを付けると目を引く合図に寄る）。状態 1 を口が開閉する顔にする組（顔が 2 種類になり、表情の違いが評価に読まれやすい）。
  外付けの 2 色 LED（配線と部品が要る。#29 の追記と同じ理由）。
- **確かめていないこと（#32 で確かめる）。** 2 つの形が食卓の距離で見分けられるか、赤が介助者に「異常」と読まれないか（人が見て、log に書く）、明るさが介助者側から見えるか、
  PC → 表示器の遅れ（#29 と同じ往復の測り方）、表示器を替えても検出器の記録が変わらないこと。
