owhinata/zaitaku-mealpace/docs/log/2026-09-26.md

# 2026-09-26

## やったこと

- #24 検出器ファームウェアの段階 2〜3（実機で追いつかせる、60 秒の記録）。段階 1（モジュール、PC のテスト、ビルド）は 9/25 の
  コミット `04a84a9`、段階 2〜3 は `f72fbf6`。実機の操作と `data/raw/` の記録は人、コードとビルドは subagent、記録はこのファイル。
- 実機で最初は窓が 1 つも出なかった（4 スライス目の全窓計算 1.2 秒で毎ホップ捨てる）。`firmware/bench/audio_features.cpp` の再利用版を
  スライスごとの分割計算に変え（PC の答え合わせはビット一致）、IMU スレッドの負担（1 ホップ 293 ms）を切り分け P1〜P6 で測って、
  人の決定で本番の既定を I2C 400 kHz・poll 4 ms・`-Os` にした。1 ホップ 208 ms。
- 装着して 60 秒の記録 `20260926-114039_self_water`（水 5 回）。DETECT / FEAT 206 窓、飛び 0、PC の再採点との差 0。**#24 の完了の条件 4 つを満たした。**

## 分かったこと

- RP2040（FPU なし、`-Os`）で 0020 の式 ＋ int8 の推論 ＋ 送信は 1 ホップ 208 ms（音 188、IMU 12、推論 6、送信 1。壁時計 最大 214 ms）。
  250 ms に収まったので docs/decisions/0001「再検討の条件」には当たらない。余裕は約 40 ms。
- 装置の推論は PC の `score_windows`（同じ EON のコードと `m2_norm.h`）と 206 窓すべてでビット一致（`max |prob − prob_pc|` = 0）。
- IMU の poll スレッドは I2C 100 kHz・2 ms では主スレッドの時間を 138 ms 食う（mbed の I2C は転送中も CPU を使う。plan 第 6 節 (b) の見込みの 3〜4 割を超えた）。
- 送信の遅れ（`t_ms − window_t_ms`）は 1201〜1205 ms、つまり窓の終端から 201〜205 ms。0021 の上限 1000 ms に対して十分小さい。詰めるかは人が決める。
- マーカーの `t_ms` は押した時刻より 0〜0.25 秒早い側に丸まる（装着 120 秒、10 回の実測）。`docs/recording-protocol.md` の前提どおり。

## 次

- 人: 送信の遅れの上限 1000 ms を詰めるか（0021 への追記と `analysis/evaluate_detector.py` の変更は別の作業）。#24 を閉じるか。
- #25 LED（`led` は今は 0）。#27 `meal` の通し記録。実機には本番の detector が入ったまま（logger は書き戻していない）。

## #24 検出器ファームウェア

Issue #24。plan は Codex のレビュー 4 回（初回 CONCERN 4、再レビュー 1 CONCERN 2、再レビュー 2 CONCERN 2、再レビュー 3 で 3 面 LGTM。
人がすべて採用。PLAN-SHA `cf4f308c9b6e0a06`）を通した。人が決めた点 A〜P は plan 第 16 節（Issue #24 のコメントに一覧）。
実施日は段階 1 が 9/25、段階 2〜3 が 9/26。**この節の検出率・誤検出の数字は 1 セッションの参考値で、M2 の合格線の数字は #27 で出す。**

### 条件

- コミット: 段階 1 `04a84a9`（モジュール、PC のテスト、ビルド、`docs/data-schema.md` の META の例を `m2-0020` に修正）、段階 2〜3 `f72fbf6`
  （実機で追いつかせる変更、切り分け、60 秒の記録の確認）。`evaluate_detector.py` の出力のコミット表示は `04a84a9-dirty`（段階 2〜3 のコミット前に実行）。
- 開発環境: arduino-cli 1.5.1、ボードコア arduino:mbed_nano 4.6.0、Arduino_LSM6DSOX、arm-none-eabi-gcc 7-2017q4（ボードコア同梱）、PC は g++ 13.3.0。
- ビルド: `cmake -S . -B build-detector -DSKETCH_NAME=detector -DPORT=… -DPYTHON3=…` → `build` → `upload`。`SKETCH_NAME=detector` のとき CMake が基底フラグ
  `-I firmware/detector/src -DEI_PORTING_MBED=0 -DAF_PROFILE=1 -DEI_CLASSIFIER_TFLITE_ENABLE_CMSIS_NN=0 -DEI_LOG_LEVEL=1` を `build.extra_flags` の先頭に置き、
  `BUILD_FLAGS` はその後ろに足す（plan 第 11 節、決定 H）。本番は `BUILD_FLAGS` 空、計測は `-DDETECTOR_PROFILE=1`。logger は `build`（`SKETCH_NAME=logger`）のまま。
- 本番の既定（`firmware/detector/sensors.h`。人の決定 9/26）: `DETECTOR_I2C_HZ` 400000（`IMU.begin()` の後に `Wire.setClock`）、`DETECTOR_IMU_POLL_MS` 4、
  最適化はボードコアの既定（`-Os`）。`DETECTOR_SEND_FEAT` 1（決定 G）。
- 実機の書き込みと記録は人が行った。subagent はビルドまで。

### ファイル構成と Arduino の閉じ込め（docs/decisions/0001。実物）

`firmware/detector/` 直下（`src/` は #22 の書き出しのまま、編集していない）:

| ファイル | Arduino / mbed の API | 役割 |
|---|---|---|
| `detector.ino` | あり（`Serial`、`millis`、`micros`、`LED_BUILTIN`、`delay`。`DETECTOR_PROFILE` のときは mbed のメモリトレースと RTX のスレッド構造体） | `setup()` / `loop()`。META を 1 回送り、READY のスライスごとに `w1 + 5 ms` まで待って `pipeline_hop` → `frame_send`（DETECT、FEAT）。統計行（`DETECTOR_PROFILE`） |
| `sensors.h/.cpp` | あり（`PDM`、`IMU`、`Wire`、`rtos::Thread`、`ThisThread::sleep_for`、`millis`、`micros`、mbed の critical section。切り分け用に `mbed::Ticker`） | `sensors_begin()`（logger と同じ設定: `IMU.begin()`、`PDM.setBufferSize(512)`、`PDM.begin(1, 16000)`。その後 `Wire.setClock(400000)`）、PDM のコールバック `on_pdm()`（`PDM.available()` → `PDM.read()` → `millis()` → `audio_capture_push_chunk`）、IMU スレッド（AboveNormal、スタック 2048 B、4 ms ごとに poll → `imu_capture_push`）。公開する関数の引数・戻り値は C の型だけ |
| `audio_capture.h/.cpp` | なし | 16 kHz スライス（4000 サンプル）の 2 面（FREE / WRITING / READY / IN_USE）、`t0_ms`、連番、`dropped_chunks`・`pdm_odd_chunks`・`pdm_gaps` |
| `imu_capture.h/.cpp` | なし | IMU の行のリング（192 行）、窓 `[w0, w1)` の取り出し（直前の 1 行も添える）、基準の周期、`imu_window_valid`（0012 の規則の装置での近似） |
| `pipeline.h/.cpp` | なし（`audio_features.h`・`imu_features.h`・`m2_norm.h`・`m2_threshold.h`・`classify.h` を使う） | 1 ホップ: 連番の帳簿 → `audio_reuse_push` → IMU の窓 → `imu_features` → 29 次元 → `m2_normalize` → `classify_run` → `positive`。前段 `pipeline_prepare`（PC のテストが classify 無しで試す）と後段に分けてある |
| `classify.h/.cpp` | なし（Edge Impulse SDK はこの中だけ） | `classify_init()`（`score_windows.cpp` と同じ `check_raw_block` と `static_assert`、`swallow` の添字をラベル名で引く）、`classify_run`、`classify_project_id()`、`classify_deploy_version()` |
| `detector_meta.h/.cpp` | なし | META の JSON（`snprintf`。564 B。`char[768]`） |
| `detector_frames.h` | なし | DETECT（10 B）と FEAT（4 + 4 × 29 B）のペイロードを LE で詰める |
| `frame.h` | リンク → `../logger/frame.h` | `frame_send` |
| `audio_features.h/.cpp`、`fft512.h/.cpp`、`imu_features.h/.cpp` | リンク → `../bench/…` | 特徴量（0020 の式の移植） |
| `m2_norm.h`、`m2_threshold.h`、`src/` | なし | #22 のまま（変えていない） |
| `host/test_detector.cpp`、`host/test_detector.sh` | なし（PC の g++） | Arduino に依存しないモジュールのテスト。**230 件が通る**（`bash firmware/detector/host/test_detector.sh`。SDK 不要、`data/` 不使用） |

- arduino-cli はスケッチ直下のシンボリックリンクの `.h` / `.cpp` を追ってコンパイルする（plan 第 4.8 節。決定 A）。`firmware/logger/` に差分なし（決定 B）。
- `static_assert`（`pipeline.h`）: `AF_PROFILE == 1`、`AF_AUDIO_HZ == 8000`、`AF_N_FEATURES + IMU_N_FEATURES == M2_N_FEATURES`、`AF_IN_HOP_SAMPLES == 4000`。
  `classify.cpp` に `EI_CLASSIFIER_DSP_INPUT_FRAME_SIZE == 29`、ラベル 3、`HAS_DATA_NORMALIZATION == 0` の確認。
- `firmware/detector/README.md` は作っていない（#25 が LED の文言と一緒に作る。0018）。ビルドの手順は `CMakeLists.txt` のコメントと `detector.ino` の冒頭。

### `window_t_ms` の定義と取りこぼし時の挙動

- `window_t_ms` は窓の最初のサンプルの時刻の推定値で、リングにある 4 スライスのうち最も古いスライスの `t0_ms`（決定 F、plan 第 6 節 (d)）。
  `t0_ms = chunk_t_ms − round(k × 1000 ÷ 16000)`（`chunk_t_ms` はチャンクを読んだ直後の `millis()`（0013 の終端側の時刻）、k はそのチャンクのうち面の先頭以降のサンプル数。
  先頭から始まれば −4 ms、後半 32 サンプルからなら −2 ms）。窓の終端は `window_t_ms + 1000`。IMU の窓 `[w0, w1)` も同じ時計（`millis()`）で切る。
  連続するホップの `window_t_ms` の差は 250 ms（60 秒の記録で最大差分 250 ms）。
- 追いつかないとき（決定 E、plan 第 6 節 (c)）: 面の遷移はコールバックが FREE → WRITING → READY、主スレッドが READY → IN_USE → FREE だけ。FREE の面が無い
  （一方が IN_USE、もう一方が READY）ときに届いたチャンクは捨てて `dropped_chunks` を数え、次に始まるスライスの連番を 1 つ飛ばす。`pipeline` は連番の飛びで
  `audio_reuse_init` に戻す（連続でない音声で窓を作らない）。次の窓が出るまで 4 スライス（1 秒）空き、`check_session.py` の `window_t_ms` の飛びとして見える。
- PDM 側の欠落: `n ≠ 128` B のコールバックは `pdm_odd_chunks`、`n == 0` またはコールバックの `millis()` の差が 6 ms 以上なら `pdm_gaps` を数え、WRITING の面の途中までの
  サンプルを捨てて `t0_ms` を次のチャンクで取り直し、飛んだ連番で始める（再レビュー 1・2 の採用）。
- IMU の窓が無効（0012 の規則: 行が 2 未満、行数が 0.9 × 1000 ÷ 周期 未満、窓内の差分が 1.5 × 周期 以上、窓の直前または直後の飛びが窓と交わる）なら DETECT / FEAT を
  出さず `imu_short` を数える（初回・再レビュー 1 の採用）。周期は装置が保持する基準（下の「plan から外れた点」）。
- 起動: `Serial.begin(2000000); while (!Serial) {}` → `pipeline_init()`（表、`classify_init`）→ META を作る → `sensors_begin()` → META を送る。失敗は `LED_BUILTIN` の
  200 ms 点滅で止まる（logger と同じ。0018）。

### ビルドの表示（`arduino-cli compile`。フラッシュの最大 16777216 B、RAM の最大 270336 B）

| ビルド | `BUILD_FLAGS` | スケッチ（フラッシュ） | グローバル変数（静的 RAM） |
|---|---|---|---|
| 本番（段階 1、`04a84a9`） | 空 | 159138 B | 161848 B |
| 計測（段階 1） | `-DDETECTOR_PROFILE=1` | 160970 B | 163656 B |
| **本番（HEAD `f72fbf6`）** | 空 | **159190 B** | **161872 B（59%）** |
| 計測（HEAD） | `-DDETECTOR_PROFILE=1` | 161782 B | 164176 B（60%） |
| 計測 ＋ `-O2`（P6） | `-DDETECTOR_PROFILE=1 -O2`（I2C 400 kHz・poll 4 ms） | 167640 B | （控えなし。`size` の bss は計測ビルドと同じ） |

- HEAD の 2 行は log を書くときに同じソースで再ビルドして控えた（キャッシュあり。9/26 11:39 の `.elf` と同じソース）。警告の数は控えていない。
- plan 第 5.3 節の見込み（静的 142〜160 KB）に対して実測 161872 B。#17 案1（155648 B、ダミーの書き出し）と案2（173660 B）の間。
- `firmware/detector/src/`（1383 ファイル）の RP2040 でのコンパイルは、CMSIS-NN を 0 にした構成で通った（#22 の G1 の確認）。

### 段階 2 の経過（実機で追いつくまで）

実機に書き込んで scratchpad の使い捨てスクリプト `serial_probe.py`（`record.py` の `read_frames` と同じ解析。ヘッダの `t_ms`・`stream_id` と PC の到着時刻だけを持ち、
ペイロードは捨てる。ファイルに書かない。plan 第 13.3 節 m3）で統計行を読んだ。

1. 1 回目: META だけが届き、統計行が 1 本も出なかった。統計行は「成功ホップ 40 回ごと」の設計で、窓が出ないと何も見えない。→ 統計行を時間で出す形に変えた
   （10 秒ごと。ホップが 0 でも出す。累計の `hops` / `hop_false_*` / `slices_taken` / `pdm_chunks_total` / `imu_polls` を足した。**plan 第 10 節から外れる**）。
2. 2 回目: 4 スライス目（最初の窓）の全窓計算が **1177 ms** で、そこから毎ホップ FREE の面が無くチャンクを捨てる（`dropped_chunks` 40%）→ 連番の飛び → リセット → また
   4 スライス目、の繰り返しで窓が 1 つも出ない。IMU の窓は 60〜68 行（取り出しが 2 秒遅れ、リング 192 行（約 1.85 秒）から押し出されていた）。
   → `firmware/bench/audio_features.cpp` の `audio_reuse_push` を、窓が満ちる前のスライスでもそのスライスで決まる末尾の `AF_HOP_FRAMES` フレームだけを計算する形に変えた
   （1 ホップの費用が最初から定常状態と同じになる。**plan の「bench を変えない」・決定 C「無変更で流用」から外れる**。下の「plan から外れた点」）。
   `firmware/bench/host/check_port.py` の出力は変更前後でビット一致。`test_detector` の `reuse first window vs full: max_rel_err=0.000e+00`。
3. 3 回目（= P3）: 音の段が **293 ms** で毎ホップ捨てる（`dropped` 15%）。bench の実測（#21 段階 1: 126 ms、割り込みなし）の 2.3 倍。→ 切り分け P1〜P6（下の表）。
4. 人の決定（9/26）: 本番の既定は P4（I2C 400 kHz、poll 4 ms、`-Os`）。`-O2`（P6）は利得 2% で採らない（PC の `-Os` と条件をそろえる）。
5. P6 の実行で起動後約 11 秒すべての窓が `imu_short`（累計 44）だった。原因の見立て: 基準の周期の推定（plan: 「飛びでない差分（1.5 × 現在の基準 未満）の移動平均」）が、
   poll で 4〜16 ms に量子化された差分の大きい側だけを除いて下に偏り、基準が下がる → 閾値が下がってさらに除く、の自己固定。→ 「直近 512 行の全差分の平均を公称の
   1/1.25〜1.25 倍に収める」に変えた（**再レビュー 2 の採用から外れる**。飛びそのものは窓ごとの規則 (ii)〜(iv) で弾く）。
6. 既定のプロファイル版で机上 60 秒: 1 本目の統計行から窓 37（起動直後の `imu_short` 0）、以後 40 窓 / 10 秒。
7. 本番ビルドで装着して 60 秒の記録（下）。

### 切り分け P1〜P6（`-DDETECTOR_PROFILE=1`、机上、各 40 秒。人が `serial_probe.py --duration 40` で控えた統計行の要点。時間は ms）

| 段 | IMU スレッド | PDM | I2C | poll | 最適化 | `audio_med`（max） | `total_med`（max） | `wall_med` / `wall_max` | `dropped` | 備考 |
|---|---|---|---|---|---|---|---|---|---|---|
| P1 | なし | なし（4 ms のタイマで合成チャンク） | — | — | `-Os` | 128.4〜128.7（128.9） | 128.5〜128.8 | 131〜132 / 133 | 0 | bench の case2 再利用版 126.152 ms と一致（計算は正しい）。`pdm_cb_max` 66 µs |
| P2 | なし | あり | — | — | `-Os` | 154.6〜154.9（155.7） | 154.7〜154.9 | 158〜158.5 / 160 | 0 | PDM の変換（4 ms ごとの割り込み）の負担 ≒ +26 ms（17%）。`pdm_cb_max` 95 µs |
| P3 | あり | あり | 100 kHz（既定） | 2 ms | `-Os` | 292.8 | 293.1 | 337 / 348 | 15% | IMU スレッドの負担 ≒ +138 ms（47%）。毎ホップ捨てる |
| **P4** | あり | あり | **400 kHz** | **4 ms** | `-Os` | 188.0 | 207.4〜207.7（208.4） | 211 / 214 | 0 | **本番の既定（人の決定）。** IMU スレッドの負担 ≒ +33 ms。`imu_feat_med` 12.0（13.8）、`nn_med` 5.6（6.7）、`send_med` 0.7〜0.9（2.8）、`imu_copy_med` 0.17。`imu_rows` 105〜106、`imu_rows_total` 1055 / 10 秒、`imu_polls` 2470 / 10 秒、`pdm_gaps` 0、`pdm_cb_max` 89 µs、`heap_peak` 5644、`stack_main` 1736、`stack_imu` 2048（未計測の疑い）。到着間隔 min 227.9 / median 248.3 / max 269.9、drift −12.2 ms / 40 秒 |
| P5 | あり | あり | 100 kHz | 2 ms | `-O2` | （控えなし） | | | | ビルドはある（`build-detector-p5`）。統計行の控えは材料に無い |
| P6 | あり | あり | 400 kHz | 4 ms | `-O2` | 183.0〜183.4 | 203.0〜203.3（204.7） | 206〜207 / 209 | 0 | P4 より 2% 速い。採らない（人の決定）。起動後約 11 秒は `imu_short`（上の 5.） |

- 読み方: 音の段（`audio`）は P1 128 → P2 155 → P4 188 で、割り込み（PDM の変換 ＋ IMU スレッドの I2C）が主スレッドの時間を食う分。計算そのものは bench と同じ。
  `pdm_cb_max` は 4 ms（4000 µs）に対して 100 µs 未満で、コールバックの複写と面の切り替えは 4 ms に収まる。フィルタ（`Open_PDM_Filter_64`）の時間そのものは未実測
  （P2 − P1 ≒ 26 ms / ホップが割り込み全体の目安）。
- 切り分け用の切り替え（`DETECTOR_PROF_NO_IMU`、`DETECTOR_PROF_NO_PDM`）は `DETECTOR_PROFILE=1` のときだけ通り、本番のビルドでは `#error`。

### 本番の既定（P4）を装着して 120 秒（計測ビルド。静止、水 10 口、少し話す。`s` を 10 回。plan 第 13.1・13.3 節）

- 統計行 12 本すべて: 窓 40 / 10 秒（最初の期間は 37。累計 437 / 440、`not_filled` 3）、`total_med` 207.2〜207.8、`total_max` 208.3〜209.9、`wall_med` 211、
  `wall_max` 213〜214。`audio_med` 187.9〜188.2（max 190.1）、`imu_feat_med` 11.8〜12.0（max 13.8）、`nn_med` 5.2〜5.7（max 6.8）、`send_med` 0.7〜1.4（max 2.8）、
  `imu_copy_med` 0.17（max 1.1）、`wait_max` 5。
- `imu_rows` 105〜106、`imu_rows_total` 1055 / 10 秒、`imu_polls` 2450 / 10 秒。`dropped` 0、`pdm_odd` 0、`pdm_gaps` 0、`pdm_cb_max` 90 µs、`reset` 0、`imu_short` 0、
  `classify_err` 0。`heap_peak` 5644、`stack_main` 1736、`stack_imu` 2048（未計測の疑い）。
- 集計（PC 側）: DETECT 475 / FEAT 475 / META 1、XOR 0。DETECT の到着間隔 min 228.6 / median 248.0 / max 270.9 ms（n 474）。到着時刻 − `t_ms` の drift −1.1 ms / 120 秒。
- **250 ms に収まった**: 1 ホップ 約 208 ms（`total_max` 209.9）、壁時計（スライスが READY になってから送信完了まで）最大 214 ms。余裕は約 40 ms。
  docs/decisions/0001「再検討の条件」（FPU なしで性能が足りない）には当たらない。基板は替えない。
- **RAM の最大**: 静的 161872 B（本番）＋ ヒープ最大 5644 B ＋ 主スレッドのスタック 32768 B（高水位は約 1.7 KB）＋ IMU スレッドのスタック 2048 B（高水位は未計測）
  = 202332 B ≒ **約 200 KB / 264 KB**（arduino-cli の表示は 270336 B）。plan 第 5.3 節の見込み 180〜195 KB よりやや多い。
- **マーカーの `t_ms` と押した時刻の差**（10 回）: `d1` = 押した時刻 − 直前のフレームの到着時刻: min 0.1 / median 154.7 / max 228.2 ms。`d2`（装置の時計での差）:
  min −4.6 / median 162.7 / max 235.2 ms。直前のフレームはすべて FEAT。→ マーカーは押した時刻より **0〜0.25 秒早い側**に丸まる。`docs/recording-protocol.md`
  「押した時刻より最大 0.25 秒早い側に丸まる」の前提と合う。
- 既定のプロファイル版（基準の周期の変更後）で机上 60 秒: 1 本目から窓 37、以後 40 / 10 秒。`total_med` 207.4〜207.6、`total_max` 209.0、`wall_max` 213〜214。
  `dropped` 0、`pdm_gaps` 0、`reset` 0、`imu_short` 0。`stack_main` 1728〜1736、`stack_imu` 2044（Stack Magic Word を飛ばしても塗りつぶしがすべて壊れて見える。未計測のまま）。
  集計: DETECT 235 / FEAT 235、XOR 0、到着間隔 median 248.8（228.5〜270.3）、drift +0.9 ms / 60 秒。

### 60 秒の記録（完了の条件。本番ビルド、装着、`record.py --cond water --duration 60`、水 5 回、`s` 5。plan 第 13.2 節、決定 K・L）

- セッション `data/raw/20260926-114039_self_water`（9/26）。`record.py` の終了時の表示: **DETECT 206 / FEAT 206 / META 1、XOR 不一致 0**。
- `.venv/bin/python tools/check_session.py data/raw/20260926-114039_self_water` の出力（そのまま）:

```
=== data/raw/20260926-114039_self_water ===
[DETECT]
  窓の数: 206
  記録の長さ（DETECT だけの値。目安）: 52.453 秒
  実効レート（装置の送信時刻から。窓の開始の間隔）: 4.00 窓/秒（公称 4 Hz 比 100.0%）
  飛び: 0 箇所 / 失われた窓数(推定): 0 / 取りこぼし率: 0.000%
  window_t_ms の最大差分: 250 ms / window_t_ms の逆行: 0 箇所 / t_ms の逆行: 0 箇所
  送信時刻 − 窓の開始（t_ms − window_t_ms）: 最小 1201 / 中央値 1203 / 最大 1204 ms
[FEAT]
  窓の数: 206
  次元数 N: 29
  記録の長さ（FEAT だけの値。目安）: 52.453 秒
  実効レート（装置の送信時刻から。窓の開始の間隔）: 4.00 窓/秒（公称 4 Hz 比 100.0%）
  飛び: 0 箇所 / 失われた窓数(推定): 0 / 取りこぼし率: 0.000%
  window_t_ms の最大差分: 250 ms / window_t_ms の逆行: 0 箇所 / t_ms の逆行: 0 箇所
  送信時刻 − 窓の開始（t_ms − window_t_ms）: 最小 1201 / 中央値 1203 / 最大 1205 ms
  DETECT との window_t_ms の不一致: 0 窓（DETECT にだけある 0 / FEAT にだけある 0）

[判定] 取りこぼし率 1%未満を「基準内」とする（Issue #7 の作業上の基準。docs/evaluation.md の合格線ではない）
  DETECT:基準内（0.000%）
  FEAT:  基準内（0.000%）
  ※ XOR 不一致数はここでは分からない。tools/record.py の終了時の表示を見ること。
```

- `python analysis/evaluate_detector.py data/raw --sessions 20260926-114039_self_water --scorer analysis/m2_scorer.py` の出力（そのまま。`build-host/score_windows` は
  `bash firmware/detector/host/build.sh` で作ったもの。特徴量・確率の値は含まれない）:

```markdown
# M2 検出器の評価（detect.csv の positive と events.csv の s）

## 実行の条件

- 実行: `python analysis/evaluate_detector.py data/raw --sessions 20260926-114039_self_water --scorer analysis/m2_scorer.py`
- 対象: --sessions で明示したセッション
- コミット: 04a84a9-dirty
- 窓 1.0 秒 / ホップ 0.25 秒。数え方は docs/evaluation.md と docs/decisions/0011、記録の範囲（送信の遅れの上限 1000 ms）は docs/decisions/0021
- `threshold`: 0.949999988（float32 0.949999988。装置の申告値）、`model`: {"deploy_version": 2, "project_id": 1117130, "source": "edge-impulse"}、`feature_set`: 'm2-0020'

## root の検出器のセッション（fw が `detector`。1）

| セッション | cond | 評価 | 理由 |
|---|---|---|---|
| 20260926-114039_self_water | water | 使う |  |

## 評価に使ったセッション（1）

| セッション | cond | 収集日 | 会話 | 嚥下 | 検出 | 誤検出（回） | 非嚥下（分） | 次元数 | FEAT に無い窓 | M2 の数字 |
|---|---|---|---|---|---|---|---|---|---|---|
| 20260926-114039_self_water | water | 20260926 | なし | 5 | 4 | 0 | 0.71 | 29 | 0 | 使わない（cond が meal でない） |

## 合算

合算は出さない（1 セッション。3 セッション未満。M2 の数字ではない）。

## 参考値（docs/decisions/0011「既知の弱点」、#27）

- 常時陽性の場合（全窓を陽性にした場合）: 検出率 1.000（5/5）、誤検出 1 回、誤検出率 1.41 回/分（非嚥下 0.71 分）
- 陽性窓の割合（陽性窓 ÷ 全窓）: 0.078（16/206）
- `positive != (prob >= threshold)` の行数（float32 で比較）: 0
- `c` に紐づく誤検出の塊（塊の最初の窓の中心 − t_c が [-1.0, +5.0] 秒）: `c` 0 回、紐づく塊 0 / 誤検出の塊 0、紐づく塊が 1 つ以上ある `c` の割合 —（0/0）
- 収集日ごと（式は回数の合算。3 セッション未満でも出す）:
  - 20260926: 検出率 0.800（4/5）、誤検出 0 回、誤検出率 0.00 回/分（非嚥下 0.71 分）
- 会話の有無ごと（`o` の note が `conv` のセッションが会話あり）:
  - 会話なし: 検出率 0.800（4/5）、誤検出 0 回、誤検出率 0.00 回/分（非嚥下 0.71 分）

## 再採点（`--scorer analysis/m2_scorer.py`。feat.csv を PC で採点し、閾値 float32 0.949999988 で陽性にした）

| セッション | 窓 | 装置 1 / PC 0 | 装置 0 / PC 1 | max abs(prob − prob_pc) | 装置: 検出 / 誤検出 | PC: 検出 / 誤検出 |
|---|---|---|---|---|---|---|
| 20260926-114039_self_water | 206 | 0 | 0 | 0 | 4/5 / 0 回 | 4/5 / 0 回 |

- 装置の合算: 検出率 0.800（4/5）、誤検出 0 回、誤検出率 0.00 回/分（非嚥下 0.71 分）
- PC の合算: 検出率 0.800（4/5）、誤検出 0 回、誤検出率 0.00 回/分（非嚥下 0.71 分）
- 差のある窓の合計: 装置 1 / PC 0 が 0、装置 0 / PC 1 が 0
```

- `meta.json`（1 フレームで届いた）: `fw` `detector`、`imu_hz` 104、`audio_hz` 16000、`window_ms` 1000、`hop_ms` 250、`threshold` `0.949999988`（`snprintf("%.9g")` は
  実機でも 9 桁で出た）、`feature_set` `m2-0020`、`feature_names` 29 個、`model` `{"source":"edge-impulse","project_id":1117130,"deploy_version":2}`。
  `m2_scorer.check_meta` を通った（`feature_names` は `features_m2.FEATURE_NAMES` と完全一致、`model` は `score_windows` の見出しと一致）。
- **完了の条件（Issue #24 本文）の照合**: (1) ビルドと書き込みが通り、装着 60 秒で DETECT と FEAT が 0.25 秒ごとに届き `window_t_ms` の飛び 0（取りこぼし 0.000% < 1%）
  → 満たす。(2) 同じ 60 秒の `feat.csv` を PC で再採点した陽性と装置の `positive` が一致（装置 1 / PC 0 = 0、装置 0 / PC 1 = 0、`positive != (prob >= threshold)` 0。
  `max |prob − prob_pc|` = 0 で確率もビット一致）→ 満たす。(3) 処理時間と RAM の数字がこの log にある → 満たす。(4) 生の音声を保存も送信もしていないことをコードの
  経路で示す（下の grep）→ 満たす。
- 参考値（1 セッション。M2 の数字ではない）: 検出 4 / 5、誤検出 0 回、非嚥下 0.71 分、陽性窓 16 / 206。#27 の既定の対象（`cond` が `meal`）にも M1 の分割
  （`fw` が `detector` は除外）にも入らない。記録は `data/raw/` に残す（決定 L）。
- 送信の遅れ: `t_ms − window_t_ms` 1201〜1205 ms → 窓の終端（`window_t_ms + 1000`）からの遅れは **201〜205 ms**（1 ホップの処理 208 ms とほぼ同じ。送信は窓の最後の
  スライスが READY になってから 1 ホップの処理の後）。0021 の上限 `MAX_SEND_LAG_MS` 1000 ms に対して十分小さい。**詰めるかは人が決める**（0021 への追記と
  `analysis/evaluate_detector.py` の変更は別の作業。決定 M）。
- 到着間隔（PC 時計）は 120 秒の計測で 228.6〜270.9 ms（median 248.0）で、公称 250 ± 20 ms 程度。装置の `window_t_ms` の間隔はきっかり 250 ms なので、揺れは USB の
  遅れと `millis()` の刻みの側。

### 生の音声が外に出ない経路（plan 第 9 節の grep。9/26、HEAD `f72fbf6` で実行）

1. 送信関数の呼び出し箇所（`src/` を除く。リンク先の bench・logger のファイルも対象）:

```
$ grep -n "frame_send\|Serial\.\|ei_printf" firmware/detector/*.ino firmware/detector/*.h firmware/detector/*.cpp
firmware/detector/detector.ino:162:  Serial.write((const uint8_t*)prof_line, len);   // 数字と見出しだけ（サンプル・特徴量・確率は出さない）
firmware/detector/detector.ino:204:  Serial.begin(2000000);
firmware/detector/detector.ino:215:  frame_send(Serial, FRAME_META, millis(), (const uint8_t*)meta_buf, (uint16_t)n);
firmware/detector/detector.ino:245:    frame_send(Serial, FRAME_DETECT, millis(), p, sizeof p);
firmware/detector/detector.ino:248:    frame_send(Serial, FRAME_FEAT, millis(), f, sizeof f);
firmware/detector/frame.h:19:static void frame_send(Out& out, uint8_t id, uint32_t t_ms, const uint8_t* payload, uint16_t len) {
```

   期待どおり: `frame_send` の呼び出しは `detector.ino` の 3 箇所（META・DETECT・FEAT）だけ（`frame.h:19` は定義）。`Serial.` は `begin`、`frame_send` の引数、
   `DETECTOR_PROFILE` の統計行の `write`（本番のビルドには入らない）だけ。`ei_printf` の呼び出しは無い。`while (!Serial)` は `Serial.` に当たらない（`Serial)`）。

2. `FRAME_AUDIO` / `0x02` の不在（`-r` はシンボリックリンクを追わず 0 件になるので `-R` で実行）:

```
$ grep -Rn "FRAME_AUDIO\|0x02" firmware/detector --include=*.ino --include=*.h --include=*.cpp --exclude-dir=src
firmware/detector/frame.h:8://   FRAME_AUDIO  int16 x N
firmware/detector/frame.h:13:// 検出器ファームウェアは FRAME_AUDIO を送らない（docs/decisions/0005）。形式の決定は docs/decisions/0021。
firmware/detector/frame.h:15:  FRAME_IMU = 0x01, FRAME_AUDIO = 0x02, FRAME_ANALOG = 0x03, FRAME_DETECT = 0x04, FRAME_FEAT = 0x05, FRAME_META = 0x7F
```

   期待どおり: `frame.h`（リンク先 `firmware/logger/frame.h`）の enum の定義行とコメントだけ。検出器のコードに `FRAME_AUDIO` は無い。

3. 各フレームのペイロード: META は固定の JSON（上）。DETECT は `window_t_ms` u32 ＋ `prob` float32 ＋ `positive` u8 ＋ `led` u8（10 B）。FEAT は `window_t_ms` u32 ＋
   正規化前の特徴量 float32 × 29（IMU 14 ＋ 40 フレームの平均の MFCC 13・重心・ゼロ交差率。波形の標本は含まない。0021）。

4. 16 kHz のスライスと 8 kHz のリングの参照箇所:

```
$ grep -n "slice\|ring" firmware/detector/audio_capture.cpp firmware/detector/pipeline.cpp firmware/detector/detector.ino
firmware/detector/pipeline.cpp:5:#include <string.h>
firmware/detector/pipeline.cpp:8:static uint32_t s_slice_t0[PIPELINE_N_SLICES];   // 直近 4 スライスの先頭の時刻（ms）。添字 0 が最も古い
firmware/detector/pipeline.cpp:9:static uint32_t s_slices_in_run;                 // リセット後に受け取ったスライスの数（4 で飽和）
firmware/detector/pipeline.cpp:25:  s_slices_in_run = 0;
firmware/detector/pipeline.cpp:28:  memset(s_slice_t0, 0, sizeof(s_slice_t0));
firmware/detector/pipeline.cpp:40:  // 次のスライスを足したとき最も古くなるのは s_slice_t0[1]（3 スライス受け取り済みなら）。それ以外は公称で t0 + 250
firmware/detector/pipeline.cpp:41:  if (s_slices_in_run >= PIPELINE_N_SLICES - 1) return s_slice_t0[1] + PIPELINE_WINDOW_MS;
firmware/detector/pipeline.cpp:45:bool pipeline_prepare(const int16_t* slice16k, uint32_t t0_ms, uint32_t seq, const ImuWindowSource* imu, HopResult* r) {
firmware/detector/pipeline.cpp:57:    s_slices_in_run = 0;
firmware/detector/pipeline.cpp:63:  for (uint32_t i = 1; i < PIPELINE_N_SLICES; i++) s_slice_t0[i - 1] = s_slice_t0[i];
firmware/detector/pipeline.cpp:64:  s_slice_t0[PIPELINE_N_SLICES - 1] = t0_ms;
firmware/detector/pipeline.cpp:65:  if (s_slices_in_run < PIPELINE_N_SLICES) s_slices_in_run++;
firmware/detector/pipeline.cpp:70:  bool filled = audio_reuse_push(&s_st, slice16k, r->features + IMU_N_FEATURES);   // 16 kHz → 間引いて 8 kHz リングへ
firmware/detector/pipeline.cpp:80:  uint32_t w0 = s_slice_t0[0], w1 = w0 + PIPELINE_WINDOW_MS;
firmware/detector/pipeline.cpp:108:bool pipeline_hop(const int16_t* slice16k, uint32_t t0_ms, uint32_t seq, const ImuWindowSource* imu, HopResult* r) {
firmware/detector/pipeline.cpp:109:  if (!pipeline_prepare(slice16k, t0_ms, seq, imu, r)) return false;
firmware/detector/detector.ino:124://   3 IMU 不足/4 推論エラー）imu_rows_last classify_err_last slices_taken slices_ready_max dropped_chunks pdm_odd_chunks pdm_gaps
firmware/detector/detector.ino:126:// 読み方: pdm_chunks_total が 10 秒で約 2500 増え pdm_bytes_last が 128 なら PDM は届いている。slices_taken が 40 増えなければ面が満ちていない。
firmware/detector/detector.ino:149:               " slices_taken=%lu slices_ready_max=%lu dropped_chunks=%lu pdm_odd_chunks=%lu pdm_gaps=%lu pdm_chunks_total=%lu pdm_bytes_last=%lu"
firmware/detector/detector.ino:156:               (unsigned long)ss.slices_taken, (unsigned long)ss.slices_ready_max, (unsigned long)ss.dropped_chunks,
firmware/detector/detector.ino:226:  const int16_t* slice; uint32_t t0, seq, ready_ms;
firmware/detector/detector.ino:227:  if (!sensors_take_slice(&slice, &t0, &seq, &ready_ms)) return;       // READY の面が無ければ次の loop へ
firmware/detector/detector.ino:238:  bool ok = pipeline_hop(slice, t0, seq, sensors_imu_source(), &r);
firmware/detector/detector.ino:239:  sensors_release_slice();                                             // 16 kHz の面を空ける（次の書き込みで上書きされる）
firmware/detector/audio_capture.cpp:3:#include <string.h>
firmware/detector/audio_capture.cpp:96:      s_stats.slices_started++;
firmware/detector/audio_capture.cpp:113:bool audio_capture_take(const int16_t** slice, uint32_t* t0_ms, uint32_t* seq, uint32_t* ready_t_ms) {
firmware/detector/audio_capture.cpp:124:  s_stats.slices_taken++;
firmware/detector/audio_capture.cpp:128:  *slice = face.buf;
```

   16 kHz のスライス（`slice16k`）は `pipeline.cpp:70` で `audio_reuse_push` に渡るだけ。8 kHz のリングは `AudioReuseState`（`audio_features.cpp`）の中にあり、
   `pipeline.cpp` からは触らない。どちらも `frame_send` に渡らない（1. の 3 箇所の引数は `meta_buf`、`p`（DETECT 10 B）、`f`（FEAT 120 B））。

5. `DETECTOR_PROFILE` の統計行は数字と見出しだけ（`detector.ino` の `prof_emit` のコメントに明記。サンプル・特徴量・確率を出すコードは無い）。本番のビルドには入らない。
6. 装置が出す文字列は META、統計行（計測ビルドのみ）、SDK のエラー文（`EI_LOG_LEVEL=1`。値ではなくメッセージ）だけ。

### plan から外れた点

1. **`firmware/bench/audio_features.cpp` を変えた**（plan 第 3 節「`firmware/bench/` は変えない」、決定 C「`audio_reuse_push` を無変更で流用」から外れる）。
   再利用版が最初の窓で全フレーム（40 フレーム、FFT 40 回）をまとめて計算する設計だったため、4 スライス目に 1177 ms 掛かって装置が追いつけなかった。
   窓が満ちる前のスライスでも末尾の 10 フレームだけを計算する形に変え（M2 はフレームごとのプリエンファシスなので新しいスライスのサンプルだけで決まる。
   M1 の経路も窓が満ちた時点のリングが同じ値になる）、`check_port.py` の出力は変更前後でビット一致、`test_detector` の全窓版との差 0。式（0020）は変えていない。
2. **IMU の基準の周期の推定**（再レビュー 2 の採用「飛びでない差分（1.5 × 現在の基準 未満）の移動平均（512 行）」から外れる）。装置の `t_ms` は poll（4 ms）で量子化されて
   差分が 4〜16 ms に散り、大きい側だけを除くと基準が下に偏って自己固定する（P6 で起動後約 11 秒すべての窓が無効）。「直近 512 行の全差分の平均（= 経過時間 ÷ 行数）を
   公称 9.6 ms の 1/1.25〜1.25 倍に収める」に変えた。飛び G ms の影響は G ÷ 511 ms に留まり、飛びそのものは窓ごとの規則 (ii)〜(iv) で弾く。`features.py` の `valid` との
   突き合わせのテストはそのまま通る。
3. **I2C のクロックと poll 間隔の既定**（決定 D「I2C はボードコアの既定、2 ms poll」から外れる。決定 P の 1・2 段目を既定にした）。`sensors.h` の `DETECTOR_I2C_HZ`
   400000 と `DETECTOR_IMU_POLL_MS` 4 で切り替えられる（0 で既定のまま）。logger の記録（I2C は既定）と IMU の読み出しの条件が違う（読む値は同じレジスタ。影響は見ていない）。
4. **`-O2` は計測したが採らない**（決定 P の 3 段目。P4 で 250 ms に収まったので要らず、利得 2% で PC の `-Os` と条件をそろえる。人の決定）。DRDY 割り込み（4 段目）は未実装。
5. **統計行の設計変更**（plan 第 10 節「40 ホップごと」から外れる）: 10 秒ごとに時間で出す（ホップが 0 でも出る）。項目に累計の `hops`・`windows_total`・`hop_false_*`・
   `last_reason`・`slices_taken`・`slices_ready_max`・`pdm_chunks_total`・`pdm_bytes_last`・`imu_rows_total`・`imu_polls`、期間の `wait_max`、ビルドの切り替え
   （`imu_thread`、`pdm`、`i2c_hz`、`poll_ms`）を足した。
6. **切り分け用の切り替え** `DETECTOR_PROF_NO_IMU`（IMU スレッドを起動しない）と `DETECTOR_PROF_NO_PDM`（PDM の代わりに 4 ms のタイマで固定の合成チャンク）を足した
   （plan に無い。`DETECTOR_PROFILE=1` のときだけ通り、本番では `#error`）。
7. 小さい差: `sensors_take_slice` に `ready_t_ms`（壁時計の計測用）を足した。`pipeline_hop` を前段 `pipeline_prepare` と後段に分けた（PC のテストが classify 無しで前段を試す）。
   IMU の最後の行の待ちは plan どおり `w1 + 5 ms`（`wait_max` 5）。

### 確かめていないこと

- IMU スレッドのスタックの高水位（走査が 2048 → Stack Magic Word を飛ばしても 2044 を返す。塗りつぶしの時期（`rtos::Thread` の生成がスタックを先に触る）の問題と推定。
  スタック 2048 B が足りているかは、動作している事実（120 秒 ＋ 60 秒で `imu_rows` 105〜106、落ちない）からの推定）。
- DRDY 割り込み（`INT_IMU`、GPIO 21 の配線）。未実装・未確認（要らなかった）。
- PDM のフィルタ（`Open_PDM_Filter_64`）の時間そのもの（P2 − P1 の差 約 26 ms / ホップが割り込み全体の目安）。
- 装置で計算した特徴量そのものの正しさは、bench の合成信号の答え合わせ（#21 段階 1: 最大相対誤差 6.4e-7）と、今回の分割計算の変更でのビット一致に依る。
  実信号での PC との突き合わせは、検出器が波形を送らない設計なのでできない（設計どおり）。装置と PC の一致（`--scorer`）は「同じ `feat.csv` を同じモデルに入れる」の一致で、
  特徴量の計算の一致ではない。
- #22 の EI との差あり 176 窓が装置でも同じ側に出るか（60 秒の記録は収集日4 の窓ではないので見られない。装置と PC の `score_windows` は同じ EON のコードでビット一致）。
- 60 秒の記録の窓の数 206（52.5 秒）が plan の見込み 236〜238 より少ない理由（`record.py` の開始から最初の窓までの時間、`while (!Serial)` の待ちと `pipeline_init` の
  表づくり、装置の起動と記録の開始のずれのどれか。材料に無い。取りこぼしではない: 飛び 0、`window_t_ms` の差分は全部 250 ms）。
- 長時間の安定性（記録ファームウェアは収集日3 で約 22 分後に止まった例がある）。#27 の `meal`（最長 30 分）で見る。
- 60 秒の記録の IMU の取りこぼしは `feat.csv` からは分からない（計測ビルドの `imu_rows` 105〜106、`imu_short` 0 からの推定）。
- `while (!Serial) {}` により、ホストがポートを開くまで装置は動かない（logger と同じ）。介助者向けの単独動作は #25 以降の論点。
- USB を挿し直さずに `record.py` を始めると META が届かない（0006）。今回は挿し直して META 1 が届いた。
- 実機には本番の detector（`f72fbf6`、`BUILD_FLAGS` 空）が入ったまま。logger は書き戻していない。

## #25 LED の表示（目安）

Issue #25。plan は Codex のレビュー（再レビュー 5 で 3 面 LGTM。PLAN-SHA `ad7f30b562735e91`）を通した。人が決めた点 A〜H と Codex の CONCERN の採否は plan 第 14 節
（Issue #25 のコメントに一覧）。実施日は 9/26（段階 1〜3）。LED の表示は嚥下の「目安」で、判定ではない（docs/decisions/0018、`firmware/detector/README.md`）。
**この節の検出・誤検出の数字は 1 セッションの参考値で、M2 の数字ではない（M2 の数字は #27）。**

### 条件

- コミット: 段階 1 `795773a`（`led_rule`・`led_out`・`detector.ino`・`pipeline` の変更、`analysis/led_rule.py`、`evaluate_detector.py` の `led` の不一致の行数、README、`CMakeLists.txt`）。
  段階 2〜3 は実機の確認と記録だけで、ソースは変えていない（`evaluate_detector.py` の出力のコミット表示も `795773a`）。
- 開発環境: arduino-cli 1.5.1、ボードコア arduino:mbed_nano 4.6.0（#24 と同じ）。**WiFiNINA 2.1.1、Arduino_SpiNINA 0.0.2**（`CMakeLists.txt` の `deps` に WiFiNINA を足した。
  版は固定しない。決定 H1）。
- ビルド: 本番は `BUILD_FLAGS` 空、計測は `-DDETECTOR_PROFILE=1`、止めたときの消灯の確認は `-DDETECTOR_PROFILE=1 -DDETECTOR_PROF_STOP_AFTER_MS=20000`
  （本番に `DETECTOR_PROF_STOP_AFTER_MS` を付けると `#error` で止まることを確かめた）。基底フラグは #24 と同じ。
- PC のテスト: host tests 300、analysis 261、tools 29 すべて通過（段階 1）。
- 実機の書き込み・目視・記録は人（開発者 `self`）。subagent はビルドと PC 側の集計まで。

### ファイル構成と Arduino の閉じ込め（docs/decisions/0001）

| ファイル | 役割 | Arduino / ライブラリの API |
|---|---|---|
| `led_rule.h/.cpp`（新規） | 0018 の規則。`window_t_ms` と `positive` から `led`（1 = 黄 / 2 = 緑）を決める。状態は最後の陽性窓の開始 `w_p` とその有無だけ。`led_off_due`（1.0 秒の消灯）と `led_shown_after`（書き込みを飛ばしたときの表示の進め方）も純粋な式 | 無し（`stdint.h` だけ。PC のテストでビルド） |
| `led_out.h/.cpp`（新規） | 基板の RGB LED（NINA 経由）への書き込み。黄 = 赤＋緑、青は使わない。変化したピンだけ書く。ACK ピンが準備できていなければ書かずに `led_skipped` を数える | WiFiNINA（`NinaPin` 版の `pinMode` / `digitalWrite`、`LEDR/LEDG/LEDB`、`SPIWIFI_ACK`）。**このファイルだけ** |
| `pipeline.cpp` | `pipeline_hop` の末尾で `led_rule_update` を呼び `r->led` に入れる | 無し（今までどおり） |
| `detector.ino` | `led_out_begin()`（センサの前）、窓の結果ごとに `led_out_set(r.led)` → DETECT の `led` = `led_out_state()`（実際に表示している状態）、`loop()` の 1.0 秒の消灯、統計行の `led` の段 | `millis`、`micros`（今までどおり） |

境界の grep（plan 第 13 節 6。9/26、HEAD `795773a` で再実行。段階 1 と同じ）:

```
$ grep -n "WiFiNINA\|NinaPin\|LEDR\|LEDG\|LEDB\|SPIWIFI_ACK" firmware/detector/*.h firmware/detector/*.cpp firmware/detector/*.ino
firmware/detector/led_out.cpp:2:// Arduino / WiFiNINA の API を呼ぶ（WiFiNINA.h、NinaPin 版の pinMode / digitalWrite、LEDR / LEDG / LEDB、SPIWIFI_ACK）のは
firmware/detector/led_out.cpp:5:// 極性: WiFiNINA（utility/nano_rp2040_support.cpp）は digitalWrite(NinaPin, LOW) で NINA に 1 を、それ以外で 0 を書く
firmware/detector/led_out.cpp:8:// 準備の確認: NINA に書く前に ACK ピン（SPIWIFI_ACK。SpiDrv::begin() が INPUT にする）を読み、LOW（Arduino_SpiNINA の
firmware/detector/led_out.cpp:14:#include <WiFiNINA.h>
firmware/detector/led_out.cpp:37:static void write_pin(NinaPin pin, bool on) {
firmware/detector/led_out.cpp:50:  pinMode(LEDR, OUTPUT);   // 最初の NINA への書き込みで SpiDrv::begin()（NINA のリセット + 約 760 ms）が走る
firmware/detector/led_out.cpp:51:  pinMode(LEDG, OUTPUT);
firmware/detector/led_out.cpp:52:  pinMode(LEDB, OUTPUT);
firmware/detector/led_out.cpp:53:  write_pin(LEDR, false);
firmware/detector/led_out.cpp:54:  write_pin(LEDG, false);
firmware/detector/led_out.cpp:55:  write_pin(LEDB, false);
firmware/detector/led_out.cpp:62:  bool ready = digitalRead((pin_size_t)SPIWIFI_ACK) == LOW;
firmware/detector/led_out.cpp:69:  if (from.red != to.red) write_pin(LEDR, to.red);
firmware/detector/led_out.cpp:70:  if (from.green != to.green) write_pin(LEDG, to.green);
```

`led_out.cpp` だけが出る。`led_out.h` は `stdint.h` しか include しない。

### ビルドの表示（`arduino-cli compile`。フラッシュの最大 16777216 B、RAM の最大 270336 B）

| ビルド | `BUILD_FLAGS` | スケッチ（フラッシュ） | グローバル変数（静的 RAM） |
|---|---|---|---|
| #24 本番（`f72fbf6`） | 空 | 159190 B | 161872 B |
| **#25 本番（`795773a`）** | 空 | **160682 B（+1492）** | **162048 B（+176）** |
| #25 計測（`795773a`） | `-DDETECTOR_PROFILE=1` | 163579 B | 164656 B |

### 極性・黄の見え方・止めたときの消灯（段階 2、机上。人の目視）

- 本番ビルド: 起動直後は消灯、ホストがポートを開くと黄になった。**極性は `HIGH` = 点灯で正しい**（`led_out.cpp` の表は直していない）。黄は赤＋緑で点いた
  （緑と区別しにくいという報告は無く、決定 F1 の `analogWrite` は入れていない）。起動から黄までの時間は `led_begin_ms` 762〜763 ms（`setup()` の中の NINA の初期化）の後、
  ポートを開いて最初の窓の結果が出たとき（`while (!Serial)` の待ちがあるので、実時間はポートを開く時刻による。測っていない）。机上なので緑はここでは見ていない。
- 止めたときの消灯: `-DDETECTOR_PROFILE=1 -DDETECTOR_PROF_STOP_AFTER_MS=20000` で、起動 20 秒後にスライスを取らなくなったあと**約 1 秒以内に LED が消えた**（目視）。
  統計行でも `hops` 42 で止まり、`led_state` 1 → 0、`led_writes` 5 → 7（黄 → 消灯の 2 回）。`dropped_chunks` が増えるのは止めた後の仕様（面を取らない）。

統計行（`serial_probe.py --duration 40`。人が控えたものをそのまま）:

```
[text] prof t=19457 imu_thread=1 pdm=1 i2c_hz=400000 poll_ms=4 n=40 windows=37 total_med=203.716 total_max=204.761 wall_med=207.000 wall_max=209.000 audio_med=184.105 audio_max=185.557 imu_copy_med=0.186 imu_copy_max=1.093 imu_feat_med=11.815 imu_feat_max=13.249 nn_med=5.786 nn_max=6.899 send_med=0.692 send_max=1.838 led_med=0.000 led_max=1.679 wait_max=5 imu_rows_min=105 imu_rows_max=106 hops=40 windows_total=37 hop_false_not_filled=3 hop_false_reset=0 hop_false_imu_short=0 hop_false_classify=0 last_reason=0 imu_rows_last=106 classify_err_last=0 slices_taken=40 slices_ready_max=1 dropped_chunks=0 pdm_odd_chunks=0 pdm_gaps=0 pdm_chunks_total=2552 pdm_bytes_last=128 pdm_cb_max=91 imu_rows_total=1088 imu_polls=2568 heap_peak=5788 stack_main=1776 stack_imu=2044 led_write_max=1103 led_writes=5 led_skipped=0 led_state=1 led_begin_ms=763
[text] prof t=29457 imu_thread=1 pdm=1 i2c_hz=400000 poll_ms=4 n=2 windows=2 total_med=203.648 total_max=203.855 wall_med=207.000 wall_max=208.000 audio_med=183.984 audio_max=184.114 imu_copy_med=0.185 imu_copy_max=0.186 imu_feat_med=12.238 imu_feat_max=12.835 nn_med=5.902 nn_max=6.756 send_med=1.052 send_max=1.388 led_med=0.000 led_max=0.000 wait_max=5 imu_rows_min=105 imu_rows_max=105 hops=42 windows_total=39 hop_false_not_filled=3 hop_false_reset=0 hop_false_imu_short=0 hop_false_classify=0 last_reason=0 imu_rows_last=105 classify_err_last=0 slices_taken=42 slices_ready_max=1 dropped_chunks=2302 pdm_odd_chunks=0 pdm_gaps=0 pdm_chunks_total=5052 pdm_bytes_last=128 pdm_cb_max=91 imu_rows_total=2143 imu_polls=5067 heap_peak=5788 stack_main=1776 stack_imu=2044 led_write_max=1103 led_writes=7 led_skipped=0 led_state=0 led_begin_ms=763
[text] prof t=39457 imu_thread=1 pdm=1 i2c_hz=400000 poll_ms=4 n=0 windows=0 total_med=0.000 total_max=0.000 wall_med=0.000 wall_max=0.000 audio_med=0.000 audio_max=0.000 imu_copy_med=0.000 imu_copy_max=0.000 imu_feat_med=0.000 imu_feat_max=0.000 nn_med=0.000 nn_max=0.000 send_med=0.000 send_max=0.000 led_med=0.000 led_max=0.000 wait_max=0 imu_rows_min=0 imu_rows_max=0 hops=42 windows_total=39 hop_false_not_filled=3 hop_false_reset=0 hop_false_imu_short=0 hop_false_classify=0 last_reason=0 imu_rows_last=105 classify_err_last=0 slices_taken=42 slices_ready_max=1 dropped_chunks=4802 pdm_odd_chunks=0 pdm_gaps=0 pdm_chunks_total=7552 pdm_bytes_last=128 pdm_cb_max=91 imu_rows_total=3198 imu_polls=7567 heap_peak=5788 stack_main=1776 stack_imu=2044 led_write_max=1103 led_writes=7 led_skipped=0 led_state=0 led_begin_ms=763
集計: frames DETECT=39 FEAT=39 META=1, xor_err 0, DETECT 到着間隔 min=229.4 median=248.2 max=269.3 n=38, drift −6.6 ms
```

### プロファイル 60 秒（段階 2、`-DDETECTOR_PROFILE=1`、装着、水 5 口）

統計行（`serial_probe.py --duration 60`。人が控えたものをそのまま）:

```
[text] prof t=71973 imu_thread=1 pdm=1 i2c_hz=400000 poll_ms=4 n=39 windows=36 total_med=205.911 total_max=207.890 wall_med=210.000 wall_max=212.000 audio_med=186.223 audio_max=187.951 imu_copy_med=0.183 imu_copy_max=1.111 imu_feat_med=11.916 imu_feat_max=13.725 nn_med=5.727 nn_max=6.900 send_med=0.683 send_max=2.636 led_med=0.000 led_max=0.701 wait_max=5 imu_rows_min=105 imu_rows_max=106 hops=39 windows_total=36 hop_false_not_filled=3 hop_false_reset=0 hop_false_imu_short=0 hop_false_classify=0 last_reason=0 imu_rows_last=106 classify_err_last=0 slices_taken=39 slices_ready_max=1 dropped_chunks=0 pdm_odd_chunks=0 pdm_gaps=0 pdm_chunks_total=2500 pdm_bytes_last=128 pdm_cb_max=87 imu_rows_total=1067 imu_polls=2512 heap_peak=5788 stack_main=1776 stack_imu=2044 led_write_max=373 led_writes=5 led_skipped=0 led_state=1 led_begin_ms=762
[text] prof t=82182 imu_thread=1 pdm=1 i2c_hz=400000 poll_ms=4 n=41 windows=41 total_med=205.504 total_max=207.012 wall_med=209.000 wall_max=212.000 audio_med=185.785 audio_max=187.173 imu_copy_med=0.184 imu_copy_max=1.107 imu_feat_med=11.851 imu_feat_max=13.628 nn_med=5.967 nn_max=6.738 send_med=0.882 send_max=1.880 led_med=0.000 led_max=0.000 wait_max=5 imu_rows_min=105 imu_rows_max=106 hops=80 windows_total=77 hop_false_not_filled=3 hop_false_reset=0 hop_false_imu_short=0 hop_false_classify=0 last_reason=0 imu_rows_last=105 classify_err_last=0 slices_taken=80 slices_ready_max=1 dropped_chunks=0 pdm_odd_chunks=0 pdm_gaps=0 pdm_chunks_total=5052 pdm_bytes_last=128 pdm_cb_max=90 imu_rows_total=2144 imu_polls=5042 heap_peak=5788 stack_main=1808 stack_imu=2044 led_write_max=373 led_writes=5 led_skipped=0 led_state=1 led_begin_ms=762
[text] prof t=92183 imu_thread=1 pdm=1 i2c_hz=400000 poll_ms=4 n=40 windows=40 total_med=205.456 total_max=207.403 wall_med=209.000 wall_max=211.000 audio_med=186.026 audio_max=187.377 imu_copy_med=0.183 imu_copy_max=1.097 imu_feat_med=11.827 imu_feat_max=13.252 nn_med=5.735 nn_max=6.735 send_med=0.709 send_max=2.545 led_med=0.000 led_max=0.000 wait_max=5 imu_rows_min=105 imu_rows_max=106 hops=120 windows_total=117 hop_false_not_filled=3 hop_false_reset=0 hop_false_imu_short=0 hop_false_classify=0 last_reason=0 imu_rows_last=105 classify_err_last=0 slices_taken=120 slices_ready_max=1 dropped_chunks=0 pdm_odd_chunks=0 pdm_gaps=0 pdm_chunks_total=7552 pdm_bytes_last=128 pdm_cb_max=90 imu_rows_total=3200 imu_polls=7520 heap_peak=5788 stack_main=1816 stack_imu=2044 led_write_max=373 led_writes=5 led_skipped=0 led_state=1 led_begin_ms=762
[text] prof t=102183 imu_thread=1 pdm=1 i2c_hz=400000 poll_ms=4 n=40 windows=40 total_med=205.243 total_max=206.613 wall_med=209.000 wall_max=211.000 audio_med=185.646 audio_max=186.953 imu_copy_med=0.184 imu_copy_max=1.109 imu_feat_med=11.875 imu_feat_max=13.284 nn_med=5.702 nn_max=6.726 send_med=0.883 send_max=2.654 led_med=0.000 led_max=0.000 wait_max=5 imu_rows_min=105 imu_rows_max=106 hops=160 windows_total=157 hop_false_not_filled=3 hop_false_reset=0 hop_false_imu_short=0 hop_false_classify=0 last_reason=0 imu_rows_last=105 classify_err_last=0 slices_taken=160 slices_ready_max=1 dropped_chunks=0 pdm_odd_chunks=0 pdm_gaps=0 pdm_chunks_total=10052 pdm_bytes_last=128 pdm_cb_max=90 imu_rows_total=4255 imu_polls=10002 heap_peak=5788 stack_main=1816 stack_imu=2044 led_write_max=373 led_writes=5 led_skipped=0 led_state=1 led_begin_ms=762
集計: frames DETECT=181 FEAT=181 META=1, xor_err 0, DETECT 到着間隔 min=228.1 median=248.8 max=270.7 n=180, drift +7.4 ms
```

読み方:

- `total_max` 206.6〜207.9 ms、`wall_max` 211〜212 ms（#24 の 208〜210 / 213〜214 と同等）。**LED 込みで 250 ms に収まった。**
- `led_write_max` 373 µs（NINA への `digitalWrite` 1 回の最大。0018 の「1 回の書き込みの時間」。机上の手順 2 では 1103 µs）。`led_max` 0.701 ms（状態変更 1 回分 =
  `digitalWrite` 1〜2 回 ＋ ACK の確認。手順 2 では 1.679 ms）。`led_med` 0.000（書かないホップは 0）。
- `led_writes` 5（`led_out_begin` の 3 回 ＋ 消灯 → 黄の 2 回）のまま 60 秒変わらず、`led_state` 1。この 60 秒（157 窓）では緑への書き込みが無かった
  （統計行は確率を出さないので、陽性窓が無かったのか規則の出力が緑にならなかったのかは統計行からは分からない。段階 3 の記録の `detect.csv` で緑への書き込みを確かめた。下）。
- `led_skipped` 0、`led_begin_ms` 762〜763。`dropped_chunks` 0、`pdm_gaps` 0、`hop_false_imu_short` 0、`hop_false_reset` 0。`heap_peak` 5788（#24 の 5644 から +144）、`stack_main` 1776〜1816。
- 集計（PC 側）: DETECT 181 / FEAT 181 / META 1、XOR 0、到着間隔 min 228.1 / median 248.8 / max 270.7 ms。
- **0018 の切り替え条件 (b)（`t_ms` の飛びが 1% を超える、または 1 ホップが 250 ms に収まらない）には当たらない。**
- NINA の応答停止の兆候（統計行が 10 秒ごとに出なくなる、DETECT が 0.25 秒ごとに届かない、`led_skipped` が増え続ける、LED が最後の色のまま残る）は、手順 1〜3 と
  段階 3 の記録のどれにも出なかった。**0018 の (c)（ビルドが通らない、NINA のファームウェアの版で動かない）にも当たらない。**

### 記録（段階 3、本番ビルド `795773a`、装着、`self`）

`fw` が `detector` なので M1 の分割にも #27 の既定にも入らない。記録は `data/raw/` に残す。

**セッション A** `data/raw/20260926-142926_self_water`（`record.py --cond water`、Ctrl-C で 63 秒。水 6 口、`s` 6）

- `record.py` の終了時の表示: DETECT 239 / FEAT 239 / META 1、XOR 不一致 0。
- `.venv/bin/python tools/check_session.py data/raw/20260926-142926_self_water` の出力（そのまま）:

```
=== data/raw/20260926-142926_self_water ===
[DETECT]
  窓の数: 239
  記録の長さ（DETECT だけの値。目安）: 60.704 秒
  実効レート（装置の送信時刻から。窓の開始の間隔）: 4.00 窓/秒（公称 4 Hz 比 100.0%）
  飛び: 0 箇所 / 失われた窓数(推定): 0 / 取りこぼし率: 0.000%
  window_t_ms の最大差分: 251 ms / window_t_ms の逆行: 0 箇所 / t_ms の逆行: 0 箇所
  送信時刻 − 窓の開始（t_ms − window_t_ms）: 最小 1202 / 中央値 1204 / 最大 1206 ms
[FEAT]
  窓の数: 239
  次元数 N: 29
  記録の長さ（FEAT だけの値。目安）: 60.705 秒
  実効レート（装置の送信時刻から。窓の開始の間隔）: 4.00 窓/秒（公称 4 Hz 比 100.0%）
  飛び: 0 箇所 / 失われた窓数(推定): 0 / 取りこぼし率: 0.000%
  window_t_ms の最大差分: 251 ms / window_t_ms の逆行: 0 箇所 / t_ms の逆行: 0 箇所
  送信時刻 − 窓の開始（t_ms − window_t_ms）: 最小 1203 / 中央値 1204 / 最大 1206 ms
  DETECT との window_t_ms の不一致: 0 窓（DETECT にだけある 0 / FEAT にだけある 0）

[判定] 取りこぼし率 1%未満を「基準内」とする（Issue #7 の作業上の基準。docs/evaluation.md の合格線ではない）
  DETECT:基準内（0.000%）
  FEAT:  基準内（0.000%）
  ※ XOR 不一致数はここでは分からない。tools/record.py の終了時の表示を見ること。
```

- `python analysis/evaluate_detector.py data/raw --sessions 20260926-142926_self_water --scorer analysis/m2_scorer.py` の出力（そのまま。参考値。M2 の数字ではない）:

```markdown
# M2 検出器の評価（detect.csv の positive と events.csv の s）

## 実行の条件

- 実行: `python analysis/evaluate_detector.py data/raw --sessions 20260926-142926_self_water --scorer analysis/m2_scorer.py`
- 対象: --sessions で明示したセッション
- コミット: 795773a
- 窓 1.0 秒 / ホップ 0.25 秒。数え方は docs/evaluation.md と docs/decisions/0011、記録の範囲（送信の遅れの上限 1000 ms）は docs/decisions/0021
- `threshold`: 0.949999988（float32 0.949999988。装置の申告値）、`model`: {"deploy_version": 2, "project_id": 1117130, "source": "edge-impulse"}、`feature_set`: 'm2-0020'

## root の検出器のセッション（fw が `detector`。2）

| セッション | cond | 評価 | 理由 |
|---|---|---|---|
| 20260926-114039_self_water | water | 使わない | --sessions に無い |
| 20260926-142926_self_water | water | 使う |  |

## 評価に使ったセッション（1）

| セッション | cond | 収集日 | 会話 | 嚥下 | 検出 | 誤検出（回） | 非嚥下（分） | 次元数 | FEAT に無い窓 | M2 の数字 |
|---|---|---|---|---|---|---|---|---|---|---|
| 20260926-142926_self_water | water | 20260926 | なし | 6 | 3 | 1 | 0.81 | 29 | 0 | 使わない（cond が meal でない） |

## 合算

合算は出さない（1 セッション。3 セッション未満。M2 の数字ではない）。

## 参考値（docs/decisions/0011「既知の弱点」、#27）

- 常時陽性の場合（全窓を陽性にした場合）: 検出率 1.000（6/6）、誤検出 1 回、誤検出率 1.23 回/分（非嚥下 0.81 分）
- 陽性窓の割合（陽性窓 ÷ 全窓）: 0.046（11/239）
- `positive != (prob >= threshold)` の行数（float32 で比較）: 0
- `led` と docs/decisions/0018 の規則からの再計算（`analysis/led_rule.py`）の不一致の行数（評価には使わない）: 0
- `c` に紐づく誤検出の塊（塊の最初の窓の中心 − t_c が [-1.0, +5.0] 秒）: `c` 0 回、紐づく塊 0 / 誤検出の塊 1、紐づく塊が 1 つ以上ある `c` の割合 —（0/0）
- 収集日ごと（式は回数の合算。3 セッション未満でも出す）:
  - 20260926: 検出率 0.500（3/6）、誤検出 1 回、誤検出率 1.23 回/分（非嚥下 0.81 分）
- 会話の有無ごと（`o` の note が `conv` のセッションが会話あり）:
  - 会話なし: 検出率 0.500（3/6）、誤検出 1 回、誤検出率 1.23 回/分（非嚥下 0.81 分）

## 再採点（`--scorer analysis/m2_scorer.py`。feat.csv を PC で採点し、閾値 float32 0.949999988 で陽性にした）

| セッション | 窓 | 装置 1 / PC 0 | 装置 0 / PC 1 | max abs(prob − prob_pc) | 装置: 検出 / 誤検出 | PC: 検出 / 誤検出 |
|---|---|---|---|---|---|---|
| 20260926-142926_self_water | 239 | 0 | 0 | 0 | 3/6 / 1 回 | 3/6 / 1 回 |

- 装置の合算: 検出率 0.500（3/6）、誤検出 1 回、誤検出率 1.23 回/分（非嚥下 0.81 分）
- PC の合算: 検出率 0.500（3/6）、誤検出 1 回、誤検出率 1.23 回/分（非嚥下 0.81 分）
- 差のある窓の合計: 装置 1 / PC 0 が 0、装置 0 / PC 1 が 0
```

**セッション B** `data/raw/20260926-144044_self_cough`（`record.py --cond cough`、Ctrl-C で 30 秒。軽い咳払い `c` 3、首を左右に向ける `n` 3。嚥下なし）

- `record.py` の終了時の表示: DETECT 115 / FEAT 115 / META 1、XOR 不一致 0。
- 録り直しの経過: 1 回目（`20260926-143231_self_cough`）は USB を挿し直さずに始めて META が届かず、2 回目（`20260926-143751_self_cough`）は挿し直したのに META が届かなかった。
  3 回目（上）で META 1。META の無い 2 本は `meta.json` に `fw`・`threshold` などが無いので評価に使わない（人が消す。9/26 のこの log を書いた時点で `data/raw/` に無い）。
  参考: 1 回目（咳・首の 33 秒）では陽性窓 1、`led` = 2 の行 8 があった（META が無いので数字には使わない）。
- `.venv/bin/python tools/check_session.py data/raw/20260926-144044_self_cough` の出力（そのまま）:

```
=== data/raw/20260926-144044_self_cough ===
[DETECT]
  窓の数: 115
  記録の長さ（DETECT だけの値。目安）: 29.704 秒
  実効レート（装置の送信時刻から。窓の開始の間隔）: 4.00 窓/秒（公称 4 Hz 比 100.0%）
  飛び: 0 箇所 / 失われた窓数(推定): 0 / 取りこぼし率: 0.000%
  window_t_ms の最大差分: 251 ms / window_t_ms の逆行: 0 箇所 / t_ms の逆行: 0 箇所
  送信時刻 − 窓の開始（t_ms − window_t_ms）: 最小 1202 / 中央値 1204 / 最大 1208 ms
[FEAT]
  窓の数: 115
  次元数 N: 29
  記録の長さ（FEAT だけの値。目安）: 29.705 秒
  実効レート（装置の送信時刻から。窓の開始の間隔）: 4.00 窓/秒（公称 4 Hz 比 100.0%）
  飛び: 0 箇所 / 失われた窓数(推定): 0 / 取りこぼし率: 0.000%
  window_t_ms の最大差分: 251 ms / window_t_ms の逆行: 0 箇所 / t_ms の逆行: 0 箇所
  送信時刻 − 窓の開始（t_ms − window_t_ms）: 最小 1203 / 中央値 1204 / 最大 1208 ms
  DETECT との window_t_ms の不一致: 0 窓（DETECT にだけある 0 / FEAT にだけある 0）

[判定] 取りこぼし率 1%未満を「基準内」とする（Issue #7 の作業上の基準。docs/evaluation.md の合格線ではない）
  DETECT:基準内（0.000%）
  FEAT:  基準内（0.000%）
  ※ XOR 不一致数はここでは分からない。tools/record.py の終了時の表示を見ること。
```

- `python analysis/evaluate_detector.py data/raw --sessions 20260926-144044_self_cough --scorer analysis/m2_scorer.py` の出力（そのまま。参考値。M2 の数字ではない）:

```markdown
# M2 検出器の評価（detect.csv の positive と events.csv の s）

## 実行の条件

- 実行: `python analysis/evaluate_detector.py data/raw --sessions 20260926-144044_self_cough --scorer analysis/m2_scorer.py`
- 対象: --sessions で明示したセッション
- コミット: 795773a
- 窓 1.0 秒 / ホップ 0.25 秒。数え方は docs/evaluation.md と docs/decisions/0011、記録の範囲（送信の遅れの上限 1000 ms）は docs/decisions/0021
- `threshold`: 0.949999988（float32 0.949999988。装置の申告値）、`model`: {"deploy_version": 2, "project_id": 1117130, "source": "edge-impulse"}、`feature_set`: 'm2-0020'

## root の検出器のセッション（fw が `detector`。3）

| セッション | cond | 評価 | 理由 |
|---|---|---|---|
| 20260926-114039_self_water | water | 使わない | --sessions に無い |
| 20260926-142926_self_water | water | 使わない | --sessions に無い |
| 20260926-144044_self_cough | cough | 使う |  |

## 評価に使ったセッション（1）

| セッション | cond | 収集日 | 会話 | 嚥下 | 検出 | 誤検出（回） | 非嚥下（分） | 次元数 | FEAT に無い窓 | M2 の数字 |
|---|---|---|---|---|---|---|---|---|---|---|
| 20260926-144044_self_cough | cough | 20260926 | なし | 0 | 0 | 0 | 0.50 | 29 | 0 | 使わない（cond が meal でない） |

## 合算

合算は出さない（1 セッション。3 セッション未満。M2 の数字ではない）。

## 参考値（docs/decisions/0011「既知の弱点」、#27）

- 常時陽性の場合（全窓を陽性にした場合）: 検出率 —（0/0）、誤検出 1 回、誤検出率 2.02 回/分（非嚥下 0.50 分）
- 陽性窓の割合（陽性窓 ÷ 全窓）: 0.000（0/115）
- `positive != (prob >= threshold)` の行数（float32 で比較）: 0
- `led` と docs/decisions/0018 の規則からの再計算（`analysis/led_rule.py`）の不一致の行数（評価には使わない）: 0
- `c` に紐づく誤検出の塊（塊の最初の窓の中心 − t_c が [-1.0, +5.0] 秒）: `c` 3 回、紐づく塊 0 / 誤検出の塊 0、紐づく塊が 1 つ以上ある `c` の割合 0.000（0/3）
- 収集日ごと（式は回数の合算。3 セッション未満でも出す）:
  - 20260926: 検出率 —（0/0）、誤検出 0 回、誤検出率 0.00 回/分（非嚥下 0.50 分）
- 会話の有無ごと（`o` の note が `conv` のセッションが会話あり）:
  - 会話なし: 検出率 —（0/0）、誤検出 0 回、誤検出率 0.00 回/分（非嚥下 0.50 分）

## 再採点（`--scorer analysis/m2_scorer.py`。feat.csv を PC で採点し、閾値 float32 0.949999988 で陽性にした）

| セッション | 窓 | 装置 1 / PC 0 | 装置 0 / PC 1 | max abs(prob − prob_pc) | 装置: 検出 / 誤検出 | PC: 検出 / 誤検出 |
|---|---|---|---|---|---|---|
| 20260926-144044_self_cough | 115 | 0 | 0 | 0 | 0/0 / 0 回 | 0/0 / 0 回 |

- 装置の合算: 検出率 —（0/0）、誤検出 0 回、誤検出率 0.00 回/分（非嚥下 0.50 分）
- PC の合算: 検出率 —（0/0）、誤検出 0 回、誤検出率 0.00 回/分（非嚥下 0.50 分）
- 差のある窓の合計: 装置 1 / PC 0 が 0、装置 0 / PC 1 が 0
```

**`led` の一致と書き込みを飛ばした窓**: DETECT の `led` は実際に表示している状態（`led_out_state()`）なので、ACK 待ちで書き込みを飛ばした窓は `detect.csv` の `led` が
前の状態のまま残り、PC 側の再計算（`analysis/led_rule.py`）と食い違って `led` の不一致の行数に数えられる。

| | `led` の不一致の行数 | `led_skipped` |
|---|---|---|
| セッション A（本番。239 行、陽性窓 11、`led` = 2 の行 37） | 0 | 本番のビルドは出さない |
| セッション B（本番。115 行、陽性窓 0、`led` = 2 の行 0） | 0 | 同上 |
| プロファイル 60 秒（装着、水 5 口） | （記録なし） | 0 |

→ 書き込みを飛ばした窓は本番の 2 本に無く、規則の実装（装置の `led_rule` と PC の `led_rule.py`）は 354 行で一致した。確率と `positive` も PC の再採点と差 0。

### 緑の遅れと嚥下に紐づかない緑（plan 第 9.5 節 3）

scratchpad の使い捨てスクリプト `issue25/led_timing.py`（コミットしない。`data/raw/` は読むだけ、集計値だけを表示、ファイルに書かない）の出力（そのまま）:

```
session: 20260926-142926_self_water
  DETECT 行: 239、led=2 の行: 37
  events: s 6、c 0、n 0
  緑の遅れ（s ごと）: n=6、緑なし 3
    中央値 750 ms、90 パーセンタイル 1150 ms、最大 1250 ms（緑ありの 3 件）
  緑の点灯（led 1→2）: 4、嚥下に紐づかない緑: 1（うち c の [t−0.5, t+5.0] 秒に入る 0、n の同区間に入る 0）
session: 20260926-144044_self_cough
  DETECT 行: 115、led=2 の行: 0
  events: s 0、c 3、n 3
  緑の遅れ（s ごと）: n=0、緑なし 0
  緑の点灯（led 1→2）: 0、嚥下に紐づかない緑: 0（うち c の [t−0.5, t+5.0] 秒に入る 0、n の同区間に入る 0）
```

- 定義: 各 `s`（`events.csv` の `t_ms`。押した時刻より 0〜0.25 秒早い側に丸まる。#24）に対し、窓の中心が `docs/evaluation.md` の区間の始まり以降（`window_t_ms + 500 >= t_s − 500`）
  かつ `t_ms <= t_s + 3500` の行のうち最初の `led` = 2 の行の `t_ms − t_s` を「緑の遅れ」とする。無ければ「緑なし」。緑の点灯（`led` 1 → 2）のうち、どの `s` の
  `[t_s − 0.5, t_s + 3.5]` 秒にも入らないものを「嚥下に紐づかない緑」とする。90 パーセンタイルは線形補間（緑ありが 3 件なので参考）。
- 読み: A では 6 口のうち 3 口で緑が点き（`evaluate_detector.py` の検出 3/6 と合う）、遅れは中央値 750 ms、最大 1250 ms（`t_ms` は装置の送信時刻で、送信の遅れ
  `t_ms − window_t_ms` 約 1.2 秒を含む）。緑なしの 3 口は `evaluate_detector.py` でも検出されなかった口（規則の側ではなく検出器の取りこぼし。PC の再計算との `led` の不一致は 0）。嚥下に紐づかない緑は A で 1 回（`evaluate_detector.py` の誤検出 1 回と合う）、
  B（咳払い 3・首 3）で 0 回。
- 目で見た結果: **緑が点いて黄に戻るのは目で確かめられなかった**（下の (a)）。咳・首の動きで緑が点いた回数も目では見ていない（データでは B の緑は 0 行）。

### 語の grep（plan 第 13 節 5。9/26、HEAD `795773a` で再実行。段階 1 と同じ）

```
$ grep -rniE "alert|alarm|\bwarn|risk|verdict|\bsafe|judge|判定|指示|合図|警告|VE の代替|aspiration" firmware/detector --exclude-dir=src analysis/led_rule.py analysis/evaluate_detector.py
firmware/detector/README.md:33:嚥下の目安（判定ではありません）
firmware/detector/README.md:41:この光は嚥下の目安です。判定や指示ではありません。
firmware/detector/host/test_detector.cpp:31:// ---------- classify のスタブ（SDK 無し。pipeline_hop の帳簿と positive の判定を試す） ----------
```

README の否定（「判定ではありません」「判定や指示ではありません」）と、既存のテストのコメント「positive の判定」（`host/test_detector.cpp:31`。plan の想定の `:30` から 1 行ずれた）だけ。

### 0018 の切り替え条件

- **(a) に当たった。** 基板の RGB LED は喉に当てる面にあり、装着すると物理的に見えない（人の報告、9/26）。介助者側から見えないので、0018 の「外付けに切り替える条件」の (a)
  「バンドやケースで隠れて、介助者側から見えない」に当たる。データでは緑への書き込みがあり（A の `led` = 2 の行 37、飛ばし 0、PC の再計算と一致）、規則と書き込みは動いている。
- (b) には当たらない（上のプロファイル: `total_max` 207.9 ms、`wall_max` 212 ms、`dropped_chunks`・`pdm_gaps`・`imu_short` 0。記録の 2 本は飛び 0、取りこぼし 0%）。
- (c) には当たらない（WiFiNINA 2.1.1 でビルドが通り、NINA の LED は点いて消えた。応答停止の兆候なし）。

### 人に諮ること（未決）

1. **外付け 2 灯への切り替え。** 0018 の決定では (a) に当たれば RP2040 の GPIO に直結した緑・黄の 2 灯（抵抗付き。規則と文言は同じ）へ切り替える。切り替えるか、いつ行うかは人が決める。
   切り替えの実装は別の Issue（plan 第 12 節: `led_out.cpp` の書き込み先だけを替え、`led_rule`・DETECT・PC 側は変えない）。0018 への追記は人の決定の後。
   #27 の `meal` の記録は切り替えが入ってから。
2. **案A / 案C。** この実装は案A（最初の陽性窓で点ける）のまま。材料: A の緑の遅れ（中央値 750 ms、最大 1250 ms、緑ありは 6 口のうち 3 口）、嚥下に紐づかない緑は A で 1 回、
   B（咳払い 3・首 3）で 0 回。1 セッションずつで数が少ない。案C（陽性が 2 窓連続で点ける）にすると点灯が 0.25 秒遅れ、1 窓だけの陽性の緑が消える（plan 第 11 節）。
   決めるのは人（決定は 0018 への追記）。

### 確かめていないこと

- **緑の目視。** 基板の LED が装着で隠れるので、緑が点いて黄に戻るのは目で見ていない（データでは緑への書き込み 37 行、飛ばし 0、PC の再計算と一致）。咳・首の動きで緑が点くかも目では見ていない。
- 隠れる問題が外付け 2 灯で解消するか（配置・見える向き・明るさ。切り替えの Issue で確かめる）。
- NINA の応答停止（書き込みを始めた後に NINA が応答を止めると `loop()` が止まり、1.0 秒の消灯も動かない。ACK の事前確認は入口を有界にするだけ）。今回の 60 秒 ＋ 記録 2 本（計約 2.5 分）
  では兆候は出なかったが、長時間は見ていない。外付けに切り替えればこの経路は無くなる。
- セッション B の 2 回目で USB を挿し直したのに META が届かなかった原因（0006 の「挿し直さないと META が届かない」とは別の事象。再現は見ていない）。
- `led_write_max` が机上（1103 µs）と装着（373 µs）で違う理由（最初の書き込みの時期の違いか。どちらも 250 ms の中で小さい）。
- 起動から黄までの実時間（`while (!Serial)` の待ちの後。測っていない）。
- 食事の一口の間隔に対して 2.0 秒の保持が長すぎないか（0018「確かめていないこと」。#27 の `meal` で分かる）。
- NINA の初期化（`SpiDrv::begin()`）が `SPI1` などのピンを設定すること以外の副作用（PDM・I2C・USB は今回の記録で飛び 0）。
- 実機には LED 付きの本番 detector（`795773a`、`BUILD_FLAGS` 空）が入ったまま。logger は書き戻していない。

## #29 表示器（別基板の RGB LED、PC 経由）

Issue #29。plan は Codex のレビュー（再レビュー 3 で 3 面 LGTM。PLAN-SHA `ecebec6d819e23b4`）を通した。人が決めた点 A〜J と Codex の CONCERN の採否は plan 第 15 節
（Issue #29 のコメント）。実施日は 9/26（段階 1〜3）。LED の表示は嚥下の「目安」で、判定ではない（docs/decisions/0018、`firmware/indicator/README.md`）。
**この節の検出・誤検出の数字は 1 セッションずつの参考値で、M2 の数字ではない（M2 の数字は #27）。**

### 条件

- コミット: 段階 1 `8680504`（`firmware/indicator/`、`tools/record.py` の `--indicator`、0018 の追記、README、`docs/recording-protocol.md`、`CMakeLists.txt` のコメント）。
  段階 2〜3 は実機の確認と記録だけで、ソースは変えていない（`evaluate_detector.py` の出力のコミット表示も `8680504`）。
- 開発環境: arduino-cli 1.5.1、ボードコア arduino:mbed_nano 4.6.0、WiFiNINA 2.1.1 / Arduino_SpiNINA 0.0.2（#25 と同じ）。
- **検出器のファームウェアは `795773a`（#25 の本番）のまま。** 書き込み直していない。セッション C・D の `meta.json` の `firmware_sha` は `8680504` だが、これは記録したときの
  PC 側のリポジトリの HEAD で、検出器に入っているのは `795773a` のビルド。
- ビルドの表示（`arduino-cli compile`。フラッシュの最大 16777216 B、RAM の最大 270336 B）:

| ビルド | `BUILD_FLAGS` | スケッチ（フラッシュ） | グローバル変数（静的 RAM） |
|---|---|---|---|
| indicator 本番（`8680504`） | 空 | 94961 B | 43828 B |
| indicator 計測（`8680504`） | `-DINDICATOR_PROFILE=1` | 94997 B | — |
| detector 本番（変えていない） | 空 | 160682 B | 162048 B（#25 と同じ） |

logger のビルドも変わらない。警告 0。indicator 計測のグローバル変数は控えていない。

- PC のテスト（段階 1）: host tests indicator 37・detector 300、tools 37、analysis 261 すべて通過。
- 実機の書き込み・目視・記録は人（開発者 `self`）。subagent はビルドと PC 側の集計、log まで。

### 人の決定と 0018 の追記

- #25 で 0018 の切り替え条件 (a)（装着すると検出器の基板の LED が介助者側から見えない）に当たった。人の決定（9/26）: 喉元の基板から配線を出さない。
  GPIO 直結の 2 灯は採らず、もう 1 枚の Nano RP2040 Connect を表示器にし、その基板の RGB LED で表示する。まず PC 経由（`record.py --indicator` が DETECT の `led` を
  1 バイトずつ中継）、後に BLE で検出器から直接受ける形（#30）。表示の規則は案A のまま、文言は変えない。
- docs/decisions/0018 の末尾に「追記（2026-09-26、Issue #29）」を足した（既存の本文は変えていない）。DETECT の `led` の意味（検出器が自分の基板の LED に書いた後の状態）は変えない。
  表示器が実際に何を表示したかは記録に残らない。
- `meal`（#27）では表示器をつながない（決定 I1。`docs/recording-protocol.md`）。

### ファイル構成と Arduino の閉じ込め（docs/decisions/0001）

表は `firmware/indicator/README.md`「ファイルと Arduino の閉じ込め」のとおり（`indicator.ino` が `Serial`・`millis`、`indicator_rx.h/.cpp` は Arduino 依存なし、
`led_out.*`・`led_rule.h` は `../detector/` へのシンボリックリンクで、WiFiNINA の API は `led_out.cpp` だけ）。

境界の grep（plan 第 14 節 5。9/26、HEAD `8680504` で再実行）:

```
$ grep -n "WiFiNINA\|NinaPin\|LEDR\|LEDG\|LEDB\|SPIWIFI_ACK" firmware/indicator/*.h firmware/indicator/*.cpp firmware/indicator/*.ino
firmware/indicator/led_out.cpp:2:// Arduino / WiFiNINA の API を呼ぶ（WiFiNINA.h、NinaPin 版の pinMode / digitalWrite、LEDR / LEDG / LEDB、SPIWIFI_ACK）のは
firmware/indicator/led_out.cpp:5:// 極性: WiFiNINA（utility/nano_rp2040_support.cpp）は digitalWrite(NinaPin, LOW) で NINA に 1 を、それ以外で 0 を書く
firmware/indicator/led_out.cpp:8:// 準備の確認: NINA に書く前に ACK ピン（SPIWIFI_ACK。SpiDrv::begin() が INPUT にする）を読み、LOW（Arduino_SpiNINA の
firmware/indicator/led_out.cpp:14:#include <WiFiNINA.h>
firmware/indicator/led_out.cpp:37:static void write_pin(NinaPin pin, bool on) {
firmware/indicator/led_out.cpp:50:  pinMode(LEDR, OUTPUT);   // 最初の NINA への書き込みで SpiDrv::begin()（NINA のリセット + 約 760 ms）が走る
firmware/indicator/led_out.cpp:51:  pinMode(LEDG, OUTPUT);
firmware/indicator/led_out.cpp:52:  pinMode(LEDB, OUTPUT);
firmware/indicator/led_out.cpp:53:  write_pin(LEDR, false);
firmware/indicator/led_out.cpp:54:  write_pin(LEDG, false);
firmware/indicator/led_out.cpp:55:  write_pin(LEDB, false);
firmware/indicator/led_out.cpp:62:  bool ready = digitalRead((pin_size_t)SPIWIFI_ACK) == LOW;
firmware/indicator/led_out.cpp:69:  if (from.red != to.red) write_pin(LEDR, to.red);
firmware/indicator/led_out.cpp:70:  if (from.green != to.green) write_pin(LEDG, to.green);
$ grep -n "Serial\|millis\|Arduino.h" firmware/indicator/indicator_rx.*
（出力なし）
$ ls -l firmware/indicator/ | grep -- "->"
lrwxrwxrwx led_out.cpp -> ../detector/led_out.cpp
lrwxrwxrwx led_out.h -> ../detector/led_out.h
lrwxrwxrwx led_rule.h -> ../detector/led_rule.h
```

`led_out.cpp`（リンク先は `firmware/detector/led_out.cpp`）だけが出る。`indicator_rx.*` は Arduino の API を使わない。

### 書き込みのポート

- `-DPORT=` に by-id のパス（`/dev/serial/by-id/…`）を渡すと、1200 bps のタッチ（ブートローダへの切り替え）の後にポートを見失って失敗した
  （`Failed uploading: uploading error: exit status 1`）。実体のパス `/dev/ttyACM1` を渡すと書き込めた（表示器だけを挿した状態）。
- 記録と計測のスクリプト（`record.py --port` / `--indicator`、`indicator_rtt.py`）には by-id のパスを渡した（検出器と表示器の取り違えを避けるため）。
  `CMakeLists.txt` のコメントと `firmware/indicator/README.md` の書き込みの例は、この実測に合わせて実体の `/dev/ttyACMx` を渡す書き方に直した（同じコミット）。

### 表示器単体の確認（段階 2、机上。人の目視）

scratchpad の使い捨てスクリプト `issue29/indicator_manual.py`（コミットしない）で、本番ビルドの表示器に 0.25 秒ごとに値を送って見た。人の報告は「すべて OK」:

- 起動直後は消灯（PC がポートを開くまで）。
- 黄 3 秒 → 緑 3 秒 → 黄 3 秒 → 消灯 3 秒の順に変わった。黄と緑は区別できた。
- `1` を 1 回だけ送ると約 1 秒で消えた（1.0 秒のタイムアウト）。
- `1` を送り続けながら `'A'`・`'T'`・`'\r'`・`'0'`（0x30）を混ぜても黄のまま。`'A'` だけを送り続けると約 1 秒で消えた（ゴミは消灯の時計を進めない）。
- スクリプトを止める（ポートを閉じる）と約 1 秒で消灯した。

### 遅れの計測（段階 2、`-DINDICATOR_PROFILE=1`、机上、装着なし）

scratchpad の使い捨てスクリプト `issue29/indicator_rtt.py`（コミットしない。ファイルに書かない。集計値だけを表示）の出力（そのまま）。返送なしは 0 で、無効の測定は無い:

```
$ .venv/bin/python $S/indicator_rtt.py solo --indicator $IND
== 単体 60 秒（0.25 秒ごと、黄 8 回 → 緑 8 回 の繰り返し）
  状態が変わった回（書き込みあり）: 30 件  中央値 0.82 ms  90% 1.49 ms  最大 2.13 ms
  変わらない回（書き込みなし）: 210 件  中央値 0.30 ms  90% 0.43 ms  最大 0.55 ms
  返送なし 0 / 返送の値が送った値と違う 0 / 書けなかった 0
$ .venv/bin/python $S/indicator_rtt.py with-detector --indicator $IND --port $DET
== 検出器と一緒 60 秒（DETECT の led を同期で送る）
  状態が変わった回（書き込みあり）: 1 件  中央値 0.84 ms  90% 0.84 ms  最大 0.84 ms
  変わらない回（書き込みなし）: 231 件  中央値 0.29 ms  90% 0.33 ms  最大 0.70 ms
  返送なし 0 / 返送の値が送った値と違う 0 / 書けなかった 0
  DETECT 232 本 / led を取れなかった 0 / XOR 不一致 0
```

（`$IND`・`$DET` は表示器・検出器の by-id のパス。検出器と一緒の 60 秒は机上で陽性が無く、状態の変化は消灯 → 黄の 1 回だけ。）

読み方:

- 得られた値は**同期で送ったときの往復**（PC の送信 → USB → 表示器の読み取りと NINA への書き込み → 返送の到着）。状態が変わる回（NINA への書き込みあり）は中央値 0.82〜0.84 ms、
  最大 2.13 ms、変わらない回は中央値 0.29〜0.30 ms、最大 0.70 ms。返送の値が送った値と違う回（書き込みを飛ばした回）は 0。
- **本番の `record.py` の送信スレッドの起床時間（Event を待つ時間）は含まない**（測っていない）。
- 「DETECT の到着から表示器の書き込みまで」の目安は、上の往復（片道はこれより短い）＋ 送信スレッドの起床（測っていない）＋ PC の読み取りの待ち
  （`record.py` の `read(4096)` が `timeout=0.05` で戻るまで。**最大約 50 ms はコードからの読みで、測っていない**）。往復は数 ms 以下なので、PC の読み取りの待ちの方が大きい見込み。
  どれも 1 窓の間隔（250 ms）や送信の遅れ（`t_ms − window_t_ms` 約 1.2 秒）より小さい。
- この値を「本番の転送の上限」とは呼ばない。

### 記録（段階 3、検出器は本番 `795773a`、表示器は本番 `8680504`、装着、`self`）

`fw` が `detector` で cond が `water` なので、M1 の分割にも #27 の既定にも入らない（docs/decisions/0021）。記録は `data/raw/` に残す。

**セッション C** `data/raw/20260926-161925_self_water`（`record.py --port <検出器> --indicator <表示器> --cond water --duration 90`、表示器を正面の机に置く、水 6 口、`s` 6）

- `record.py` の終了時の表示（メインが控えた要点）: DETECT 292 / FEAT 292 / META 1、XOR 不一致 0。表示器への転送（DETECT の led）: 送った 292 / 失敗 0 / 送らなかった 0 / 置き換えた 0。
- 目で見た結果（人）: **6 口中 6 口で表示器の LED が緑になり、黄に戻った。** Ctrl-C で止めた後、表示器は消灯した。
- データ: 陽性窓 23、`led` = 2 の行 72、`led` = 1 の行 220。
- `.venv/bin/python tools/check_session.py data/raw/20260926-161925_self_water` の出力（そのまま）:

```
=== data/raw/20260926-161925_self_water ===
[DETECT]
  窓の数: 292
  記録の長さ（DETECT だけの値。目安）: 73.956 秒
  実効レート（装置の送信時刻から。窓の開始の間隔）: 4.00 窓/秒（公称 4 Hz 比 100.0%）
  飛び: 0 箇所 / 失われた窓数(推定): 0 / 取りこぼし率: 0.000%
  window_t_ms の最大差分: 251 ms / window_t_ms の逆行: 0 箇所 / t_ms の逆行: 0 箇所
  送信時刻 − 窓の開始（t_ms − window_t_ms）: 最小 1202 / 中央値 1204 / 最大 1208 ms
[FEAT]
  窓の数: 292
  次元数 N: 29
  記録の長さ（FEAT だけの値。目安）: 73.957 秒
  実効レート（装置の送信時刻から。窓の開始の間隔）: 4.00 窓/秒（公称 4 Hz 比 100.0%）
  飛び: 0 箇所 / 失われた窓数(推定): 0 / 取りこぼし率: 0.000%
  window_t_ms の最大差分: 251 ms / window_t_ms の逆行: 0 箇所 / t_ms の逆行: 0 箇所
  送信時刻 − 窓の開始（t_ms − window_t_ms）: 最小 1202 / 中央値 1205 / 最大 1208 ms
  DETECT との window_t_ms の不一致: 0 窓（DETECT にだけある 0 / FEAT にだけある 0）

[判定] 取りこぼし率 1%未満を「基準内」とする（Issue #7 の作業上の基準。docs/evaluation.md の合格線ではない）
  DETECT:基準内（0.000%）
  FEAT:  基準内（0.000%）
  ※ XOR 不一致数はここでは分からない。tools/record.py の終了時の表示を見ること。
```

- `python analysis/evaluate_detector.py data/raw --sessions 20260926-161925_self_water --scorer analysis/m2_scorer.py` の出力（そのまま。参考値。M2 の数字ではない）:

```markdown
# M2 検出器の評価（detect.csv の positive と events.csv の s）

## 実行の条件

- 実行: `python analysis/evaluate_detector.py data/raw --sessions 20260926-161925_self_water --scorer analysis/m2_scorer.py`
- 対象: --sessions で明示したセッション
- コミット: 8680504
- 窓 1.0 秒 / ホップ 0.25 秒。数え方は docs/evaluation.md と docs/decisions/0011、記録の範囲（送信の遅れの上限 1000 ms）は docs/decisions/0021
- `threshold`: 0.949999988（float32 0.949999988。装置の申告値）、`model`: {"deploy_version": 2, "project_id": 1117130, "source": "edge-impulse"}、`feature_set`: 'm2-0020'

## root の検出器のセッション（fw が `detector`。5）

| セッション | cond | 評価 | 理由 |
|---|---|---|---|
| 20260926-114039_self_water | water | 使わない | --sessions に無い |
| 20260926-142926_self_water | water | 使わない | --sessions に無い |
| 20260926-144044_self_cough | cough | 使わない | --sessions に無い |
| 20260926-161925_self_water | water | 使う |  |
| 20260926-162247_self_water | water | 使わない | --sessions に無い |

## 評価に使ったセッション（1）

| セッション | cond | 収集日 | 会話 | 嚥下 | 検出 | 誤検出（回） | 非嚥下（分） | 次元数 | FEAT に無い窓 | M2 の数字 |
|---|---|---|---|---|---|---|---|---|---|---|
| 20260926-161925_self_water | water | 20260926 | なし | 6 | 6 | 1 | 1.03 | 29 | 0 | 使わない（cond が meal でない） |

## 合算

合算は出さない（1 セッション。3 セッション未満。M2 の数字ではない）。

## 参考値（docs/decisions/0011「既知の弱点」、#27）

- 常時陽性の場合（全窓を陽性にした場合）: 検出率 1.000（6/6）、誤検出 1 回、誤検出率 0.97 回/分（非嚥下 1.03 分）
- 陽性窓の割合（陽性窓 ÷ 全窓）: 0.079（23/292）
- `positive != (prob >= threshold)` の行数（float32 で比較）: 0
- `led` と docs/decisions/0018 の規則からの再計算（`analysis/led_rule.py`）の不一致の行数（評価には使わない）: 0
- `c` に紐づく誤検出の塊（塊の最初の窓の中心 − t_c が [-1.0, +5.0] 秒）: `c` 0 回、紐づく塊 0 / 誤検出の塊 1、紐づく塊が 1 つ以上ある `c` の割合 —（0/0）
- 収集日ごと（式は回数の合算。3 セッション未満でも出す）:
  - 20260926: 検出率 1.000（6/6）、誤検出 1 回、誤検出率 0.97 回/分（非嚥下 1.03 分）
- 会話の有無ごと（`o` の note が `conv` のセッションが会話あり）:
  - 会話なし: 検出率 1.000（6/6）、誤検出 1 回、誤検出率 0.97 回/分（非嚥下 1.03 分）

## 再採点（`--scorer analysis/m2_scorer.py`。feat.csv を PC で採点し、閾値 float32 0.949999988 で陽性にした）

| セッション | 窓 | 装置 1 / PC 0 | 装置 0 / PC 1 | max abs(prob − prob_pc) | 装置: 検出 / 誤検出 | PC: 検出 / 誤検出 |
|---|---|---|---|---|---|---|
| 20260926-161925_self_water | 292 | 0 | 0 | 0 | 6/6 / 1 回 | 6/6 / 1 回 |

- 装置の合算: 検出率 1.000（6/6）、誤検出 1 回、誤検出率 0.97 回/分（非嚥下 1.03 分）
- PC の合算: 検出率 1.000（6/6）、誤検出 1 回、誤検出率 0.97 回/分（非嚥下 1.03 分）
- 差のある窓の合計: 装置 1 / PC 0 が 0、装置 0 / PC 1 が 0

```

**セッション D** `data/raw/20260926-162247_self_water`（同じコマンド、`--duration 60`。30 秒ほどで表示器の USB を抜き、そのまま水 3 口、`s` 3）

- `record.py` の表示（人が貼ったもの）:

```
警告: 表示器に送れませんでした（記録は続けます）: write failed: [Errno 5] Input/output error
saved: data/raw/20260926-162247_self_water  DETECT 192 / FEAT 192 / META 1 / XOR 0
表示器への転送（DETECT の led）: 送った 58 / 失敗 134 / 送らなかった 0 / 置き換えた 0
最初の失敗: write failed: [Errno 5] Input/output error
```

- **表示器を抜いた後も記録は止まらずに続いた**（送った 58 ＋ 失敗 134 = DETECT 192）。抜いた後は毎回送ろうとして失敗を数えた（決定 E1）。
- データ: 陽性窓 10、`led` = 2 の行 56。
- `.venv/bin/python tools/check_session.py data/raw/20260926-162247_self_water` の出力（そのまま）:

```
=== data/raw/20260926-162247_self_water ===
[DETECT]
  窓の数: 192
  記録の長さ（DETECT だけの値。目安）: 48.955 秒
  実効レート（装置の送信時刻から。窓の開始の間隔）: 4.00 窓/秒（公称 4 Hz 比 100.0%）
  飛び: 0 箇所 / 失われた窓数(推定): 0 / 取りこぼし率: 0.000%
  window_t_ms の最大差分: 251 ms / window_t_ms の逆行: 0 箇所 / t_ms の逆行: 0 箇所
  送信時刻 − 窓の開始（t_ms − window_t_ms）: 最小 1202 / 中央値 1204 / 最大 1206 ms
[FEAT]
  窓の数: 192
  次元数 N: 29
  記録の長さ（FEAT だけの値。目安）: 48.956 秒
  実効レート（装置の送信時刻から。窓の開始の間隔）: 4.00 窓/秒（公称 4 Hz 比 100.0%）
  飛び: 0 箇所 / 失われた窓数(推定): 0 / 取りこぼし率: 0.000%
  window_t_ms の最大差分: 251 ms / window_t_ms の逆行: 0 箇所 / t_ms の逆行: 0 箇所
  送信時刻 − 窓の開始（t_ms − window_t_ms）: 最小 1203 / 中央値 1204 / 最大 1207 ms
  DETECT との window_t_ms の不一致: 0 窓（DETECT にだけある 0 / FEAT にだけある 0）

[判定] 取りこぼし率 1%未満を「基準内」とする（Issue #7 の作業上の基準。docs/evaluation.md の合格線ではない）
  DETECT:基準内（0.000%）
  FEAT:  基準内（0.000%）
  ※ XOR 不一致数はここでは分からない。tools/record.py の終了時の表示を見ること。
```

- `python analysis/evaluate_detector.py data/raw --sessions 20260926-162247_self_water --scorer analysis/m2_scorer.py` の出力（そのまま。参考値。M2 の数字ではない）:

```markdown
# M2 検出器の評価（detect.csv の positive と events.csv の s）

## 実行の条件

- 実行: `python analysis/evaluate_detector.py data/raw --sessions 20260926-162247_self_water --scorer analysis/m2_scorer.py`
- 対象: --sessions で明示したセッション
- コミット: 8680504
- 窓 1.0 秒 / ホップ 0.25 秒。数え方は docs/evaluation.md と docs/decisions/0011、記録の範囲（送信の遅れの上限 1000 ms）は docs/decisions/0021
- `threshold`: 0.949999988（float32 0.949999988。装置の申告値）、`model`: {"deploy_version": 2, "project_id": 1117130, "source": "edge-impulse"}、`feature_set`: 'm2-0020'

## root の検出器のセッション（fw が `detector`。5）

| セッション | cond | 評価 | 理由 |
|---|---|---|---|
| 20260926-114039_self_water | water | 使わない | --sessions に無い |
| 20260926-142926_self_water | water | 使わない | --sessions に無い |
| 20260926-144044_self_cough | cough | 使わない | --sessions に無い |
| 20260926-161925_self_water | water | 使わない | --sessions に無い |
| 20260926-162247_self_water | water | 使う |  |

## 評価に使ったセッション（1）

| セッション | cond | 収集日 | 会話 | 嚥下 | 検出 | 誤検出（回） | 非嚥下（分） | 次元数 | FEAT に無い窓 | M2 の数字 |
|---|---|---|---|---|---|---|---|---|---|---|
| 20260926-162247_self_water | water | 20260926 | なし | 3 | 3 | 5 | 0.72 | 29 | 0 | 使わない（cond が meal でない） |

## 合算

合算は出さない（1 セッション。3 セッション未満。M2 の数字ではない）。

## 参考値（docs/decisions/0011「既知の弱点」、#27）

- 常時陽性の場合（全窓を陽性にした場合）: 検出率 1.000（3/3）、誤検出 1 回、誤検出率 1.40 回/分（非嚥下 0.72 分）
- 陽性窓の割合（陽性窓 ÷ 全窓）: 0.052（10/192）
- `positive != (prob >= threshold)` の行数（float32 で比較）: 0
- `led` と docs/decisions/0018 の規則からの再計算（`analysis/led_rule.py`）の不一致の行数（評価には使わない）: 0
- `c` に紐づく誤検出の塊（塊の最初の窓の中心 − t_c が [-1.0, +5.0] 秒）: `c` 0 回、紐づく塊 0 / 誤検出の塊 5、紐づく塊が 1 つ以上ある `c` の割合 —（0/0）
- 収集日ごと（式は回数の合算。3 セッション未満でも出す）:
  - 20260926: 検出率 1.000（3/3）、誤検出 5 回、誤検出率 6.98 回/分（非嚥下 0.72 分）
- 会話の有無ごと（`o` の note が `conv` のセッションが会話あり）:
  - 会話なし: 検出率 1.000（3/3）、誤検出 5 回、誤検出率 6.98 回/分（非嚥下 0.72 分）

## 再採点（`--scorer analysis/m2_scorer.py`。feat.csv を PC で採点し、閾値 float32 0.949999988 で陽性にした）

| セッション | 窓 | 装置 1 / PC 0 | 装置 0 / PC 1 | max abs(prob − prob_pc) | 装置: 検出 / 誤検出 | PC: 検出 / 誤検出 |
|---|---|---|---|---|---|---|
| 20260926-162247_self_water | 192 | 0 | 0 | 0 | 3/3 / 5 回 | 3/3 / 5 回 |

- 装置の合算: 検出率 1.000（3/3）、誤検出 5 回、誤検出率 6.98 回/分（非嚥下 0.72 分）
- PC の合算: 検出率 1.000（3/3）、誤検出 5 回、誤検出率 6.98 回/分（非嚥下 0.72 分）
- 差のある窓の合計: 装置 1 / PC 0 が 0、装置 0 / PC 1 が 0

```

**#25 のセッション A（表示器なし）との比較**（表示器の有無と切り離しで検出器の記録が変わらないこと）:

| 項目 | A `20260926-142926`（#25、表示器なし） | C `20260926-161925`（表示器あり） | D `20260926-162247`（途中で切り離し） |
|---|---|---|---|
| DETECT / FEAT / META | 239 / 239 / 1 | 292 / 292 / 1 | 192 / 192 / 1 |
| `record.py` の XOR 不一致 | 0 | 0 | 0 |
| 飛び / 取りこぼし率（DETECT） | 0 / 0.000% | 0 / 0.000% | 0 / 0.000% |
| `t_ms − window_t_ms`（DETECT、最小 / 中央値 / 最大 ms） | 1202 / 1204 / 1206 | 1202 / 1204 / 1208 | 1202 / 1204 / 1206 |
| DETECT と FEAT の `window_t_ms` の不一致 | 0 | 0 | 0 |
| `led` と PC の再計算（`analysis/led_rule.py`）の不一致 | 0 | 0 | 0 |
| `positive` の再採点の差（装置 1 / PC 0、装置 0 / PC 1）、`max abs(prob − prob_pc)` | 0、0、0 | 0、0、0 | 0、0、0 |
| 表示器への転送（送った / 失敗） | — | 292 / 0 | 58 / 134 |

→ 取りこぼし 0%、飛び 0、`led` 不一致 0、再採点の差 0 で A と同じ。C の `t_ms − window_t_ms` の最大は 1208 ms で A より 2 ms 大きい（DETECT の送信時刻の揺れの幅。検出器のファームウェアは同じ `795773a`）。**表示器の有無と途中の切り離しで検出器の記録は変わらなかった。** 参考値（1 セッションずつ。M2 の数字ではない）:
C は検出 6/6・誤検出 1 回 / 1.03 分、D は検出 3/3・誤検出 5 回 / 0.72 分。

### 語の grep（plan 第 14 節 4。9/26、HEAD `8680504` で再実行。段階 1 と同じ）

```
$ grep -rniE "alert|alarm|\bwarn|risk|verdict|\bsafe|judge|判定|指示|合図|警告|許可|VE の代替|aspiration" firmware/indicator tools/record.py
firmware/indicator/indicator.ino:3:// 状態は検出器の DETECT の led をそのまま中継したもの。規則（緑・黄の条件）は検出器が持ち、表示器は計算しない。LED は嚥下の目安で、判定ではない。
tools/record.py:293:            print(f"警告: meta.json の feature_names は {len(names)} 個ですが、feat.csv の次元数は {self.n_feat} です")
tools/record.py:403:            print(f"警告: 表示器に送れませんでした（記録は続けます）: {e}")
firmware/indicator/README.md:32:嚥下の目安（判定ではありません）
firmware/indicator/README.md:40:この光は嚥下の目安です。判定や指示ではありません。
```

`indicator.ino:3` のコメントと README の否定（「判定ではありません」「判定や指示ではありません」）、`record.py` の既存の「警告: meta.json の feature_names…」と
新しい「警告: 表示器に送れませんでした」（PC の端末への表示で、装置の表示・LED の文言ではない）だけ。README の表示とカードは 0018 と一字一句同じ（段階 1 で `diff`）。

### 確かめていないこと

- 表示器の緑・黄が**食卓の明るさで介助者側から**見えるか（今回は開発者が介助者の代わりに正面の机で見た。机上で黄と緑は区別できた）。
- `record.py` の読み取りの待ち（最大約 50 ms）と送信スレッドの起床時間はコードからの読みで、測っていない。PC の負荷で読み取りが遅れたときに、表示器の消灯（1.0 秒）が遅れる、
  または届く間隔が 1.0 秒を超えて一時的に消灯するか（DETECT の到着間隔は #25 で最大 270.7 ms なので、ふつうは起きない見込み）。
- pyserial の `write_timeout` の振る舞いと、表示器が読まずに詰まったときの実際の待ち時間（詰まっても待つのは送信のスレッドだけ、は偽物のシリアルのテスト r11・r16 での確認）。
  切り離し（D）では書き込みが `[Errno 5]` ですぐ失敗し、詰まりにはならなかった。
- NINA が書き込みの途中で応答を止めた場合（表示器の `loop()` が止まり、1.0 秒の消灯も動かず最後の色が残る）。今回の単体の確認 ＋ 計測 2 分 ＋ 記録 2 本では兆候は出なかったが、長時間は見ていない。
- ModemManager などのプロセスが表示器のポートを開いた場合の挙動（今回は起きなかった）。
- 表示器が実際に何を表示したかは記録に残らない（目視と `INDICATOR_PROFILE` の返送でしか分からない）。
- by-id のパスで書き込めなかった原因（1200 bps のタッチの後にパスが消える・変わるのか）。調べていない。
- 食事の一口の間隔に対して 2.0 秒の保持が長すぎないか、案A のままでよいか（#27 の `meal` では表示器をつながないので、別に見る必要がある）。
- #30 で BLE と WiFiNINA の LED が同じ NINA で同居できるか（#30 の範囲）。
- 実機には検出器に本番 detector（`795773a`、`BUILD_FLAGS` 空）、表示器に本番 indicator（`8680504`、`BUILD_FLAGS` 空）が入っている。logger は書き戻していない。
