owhinata/zaitaku-mealpace/docs/decisions/0007-record-output-fixed.md

# 0007 `tools/record.py` の出力先は `data/raw/` に固定する

日付: 2026-09-20　状態: 採用

## 決定

- `tools/record.py` から `--out` を廃止する。出力先はスクリプトの位置から解決したリポジトリの
  `data/raw/` とし、実行時の cwd にも引数にも依存させない。
- `cond` は英数字とハイフンだけを受ける（`--cond` と環境変数 `COND` の両方）。`Session` は、
  セッションフォルダが出力先の直下にならないときは作らずに終わる。
- `data/sample/` の見本（`self`、10秒以内）は、`data/raw/` から手でコピーして置く。
- `p1` の記録先は M3 の前に決める（`docs/plan.md`「M3 の前に行うこと」）。リポジトリごと
  暗号化ディスクに置くか、`p1` だけリポジトリ外の場所を必須にする。

## 理由

- M0 の関門レビュー（#6）の指摘。`--out` が任意のパスを受け、subject の検査は `self` / `p1` の
  列挙だけだったので、`--subject p1 --out data/sample` で、`.gitignore` が再包含する場所
  （`!data/sample/**`）へ生データを直接記録できた。
- 同じ関門の再レビューの指摘。`cond` はフォルダ名にそのまま連結されていたので、
  `--cond ../../../sample/leak` で `data/sample/` やリポジトリの外に出られた。
- 出力先を変える必要のある作業が、今の計画に無い。

## 塞がっていない経路

- `git add -f data/raw/...` と、記録したファイルを手で `data/sample/` に移す操作。git の側に
  検査（pre-commit など）は置いていない。
- `data/raw` をシンボリックリンクに差し替えると、`Session` の直下の検査を抜ける（両辺とも解決先で
  比べるため）。リンク先が `data/sample/` なら、そこに直接記録できる。M0 の関門の再レビュー2回目の
  指摘で、CONCERN として採用。運用で注意する（`data/raw` を `data/sample/` やリポジトリ内の別の場所への
  リンクにしない）。リンクは `p1` の記録先を暗号化ディスクに向ける手段にもなるので、一律には拒否しない。
- 出力先がリポジトリの中なので、`p1` の生データを「ローカルの暗号化ディスクにのみ置く」
  （CLAUDE.md）を満たすかどうかは、リポジトリを置くディスクで決まる。上の通り M3 の前に決める。
