owhinata/zaitaku-mealpace/docs/log/2026-09-19.md

# 2026-09-19

## やったこと

- #1 開発環境を導入し、`firmware/logger` のビルドを通した。実機は未接続。書き込みと記録（#2）はやっていない。
- `cmake --build build --target deps` でボードコアとライブラリ、Python 依存を導入。
- `cmake --build build --target build` がエラーなしで終わった。`firmware/` は変更していない。
- README と `CMakeLists.txt` のコメントに `deps` の手順と `-DPYTHON3=` を追記した。

### 使ったもの

| | バージョン |
|---|---|
| arduino-cli | 1.5.1（`~/.local/bin`、導入済みだった） |
| arduino:mbed_nano | 4.6.0 |
| arduino:arm-none-eabi-gcc | 7-2017q4（ボードコアが引く） |
| Arduino_LSM6DSOX | 1.1.2 |
| cmake | 3.28.3 |
| python3 | 3.12.3（リポジトリ直下の `.venv`） |
| pyserial / numpy | 3.5 / 2.5.3 |

FQBN は `arduino:mbed_nano:nanorp2040connect`。`PDM` はボードコア同梱のものを使う。

### ビルド結果

```
最大16777216バイトのフラッシュメモリのうち、スケッチが107749バイト（0%）を使っています。
最大270336バイトのRAMのうち、グローバル変数が101416バイト（37%）を使っていて、
ローカル変数で168920バイト使うことができます。
```

出力は `build/firmware/logger/`（`.bin` / `.elf` / `.hex` / `.map` / `.uf2`）。

## 分かったこと

- `deps` の `pip install` がシステムの Python で止まる。Ubuntu の Python 3.12 は PEP 668 で
  `externally-managed-environment` を返す。リポジトリ直下に `.venv` を作り、
  `-DPYTHON3=$PWD/.venv/bin/python3` を渡して回避した。`CMakeLists.txt` の
  `find_program(PYTHON3 ...)` はキャッシュに値があれば探索を飛ばすので、
  `CMakeLists.txt` 本体の変更は要らなかった。README とコメントに手順を足した。
- README の手順に `deps` が無く、初見では通らなかった。README を直した。
- ボードコアの取得に約 110 MB のダウンロードが要る（`arm-none-eabi-gcc` が 95 MB）。初回は数分かかる。
- `firmware/logger` は無修正でコンパイルが通る。ビルド時の警告も出ていない。
- グローバル変数が RAM の 37%。大半は mbed OS とシリアルのバッファと思われる（未確認）。
  M2 で推論を載せるときに残りを見る必要がある。

## 次

- #2 実機に書き込み、フレームの受信を確認する。そのときに見るもの。
  - `CMakeLists.txt` の `monitor` は `baudrate=115200`、`logger.ino` は `Serial.begin(2000000)`。
    値が食い違っている。USB CDC ではボーレートは無視されるはずだが、未確認。#2 で実測して
    どちらかに揃える。
  - `on_pdm()` は PDM の割り込みから `pdm_buf` に直接書き、`loop()` が同じ配列を読む。
    リングになっていないので、送信中に次のコールバックが来ると上書きされる可能性がある（推測）。
    取りこぼしの確認は #7 なので、そこで実測する。
  - `on_pdm()` の `pdm_available` はサンプル数、`PDM.available()` はバイト数。
    `sizeof(pdm_buf)` との比較もバイト単位で、単位は揃っている。ここは読み違えやすいので記録しておく。

# #2 実機への書き込みとフレームの受信

## やったこと

- `firmware/logger` を実機（Nano RP2040 Connect、`/dev/ttyACM0`）に書き込み、10秒の記録を取った。
  装置は机に置いたまま。装着していない。被験者 `self`、`cond=quiet`。
- 記録の前に `tools/record.py` と `CMakeLists.txt` を直した（下の「直したもの」）。
- `firmware/` は変更していない。ビルド結果は #1 と同じ（スケッチ 107749 バイト、グローバル 101416 バイト）。

## 書き込み

`cmake --build build --target upload` が成功。`New upload port: /dev/ttyACM0 (serial)`。

## 10秒の記録の数字

`SUBJECT=self COND=quiet DURATION=10 cmake --build build --target record`

| | 値 |
|---|---|
| 正常受信フレーム数 META | 1 |
| 正常受信フレーム数 IMU | 1045 |
| 正常受信フレーム数 AUDIO | 2475 |
| XOR 不一致数 | 0 |
| 記録の長さ（IMU の `t_ms` 範囲） | 9.894 秒 |
| 実効 IMU レート | 105.5 Hz（公称 104 Hz） |
| 実効音声レート | 16006.5 Hz（公称 16000 Hz） |
| audio.wav のサンプル数 | 158400 |

- 「正常受信フレーム数」は xor 検証を通ったフレームの数、「XOR 不一致数」は SYNC と長さと
  xor バイトまで読めたが xor が合わずに捨てた候補の数。`tools/record.py` が終了時に出す。
- セッションフォルダに `imu.csv` / `audio.wav` / `audio_chunks.csv` / `events.csv` / `meta.json` が
  そろった。`analog.csv` は代替センサ用なので出ない（正しい）。`events.csv` は見出し行だけ
  （tty が無くマーカーを打っていないため）。
- `meta.json` のキー: `subject` `cond` `position` `band` `firmware_sha` `sample_rates` `sensors`
  `notes` `fw` `imu_hz` `audio_hz`。後ろの3つは装置の META フレームがトップレベルに入ったもの。

## AUDIO フレーム1個あたりのサンプル数

**実測: 64 サンプル（128 バイト）。** `audio_chunks.csv` の `sample_index` の差分は全区間で 64、
チャンク間の `t_ms` の差は全区間で 4 ms。総サンプル数 ÷ AUDIO フレーム数 = 158400 ÷ 2475 = 64.000。

ボードコア（`mbed_nano` 4.6.0 の `libraries/PDM/src/rp2040/PDM.cpp`）を読んだ結果も同じ。
`decimation` の初期値は 128 だが、`begin()` で `16000 * 128 * 2 > 3250000` のため 64 に落ちる。
`RAW_BUFFER_SIZE`（512）÷（64 / 8）= 64 サンプルが1コールバックぶんで、16 kHz では 4 ms にあたる。

`logger.ino` の `AUDIO_CHUNK = 256` はアプリ側のバッファ設定であって、1フレームのサンプル数ではない。

## baudrate の実測

`monitor` の `baudrate=115200` と `Serial.begin(2000000)` の食い違い（#1 の申し送り）を実測した。
`tools/record.py` と同じ解析（SYNC / len / xor）をする使い捨てスクリプトで、3秒ずつ両方を開いた。

| baud | 受信バイト数 | 正常受信フレーム数 | XOR 不一致数 |
|---|---|---|---|
| 115200 | 115656 | IMU 321 / AUDIO 759 | 0 |
| 2000000 | 115656 | IMU 321 / AUDIO 759 | 0 |

受信バイト数もフレーム数も完全に一致した。**USB CDC ではボーレートが無視される**ことを実測で確認。
`CMakeLists.txt` の `monitor` を 2000000 に揃え、無視される旨のコメントを付けた。
（この2回はどちらも2回目以降のポートオープンなので META は来ない。想定どおり。）

## 未解決のスキーマ差異 → #15

`docs/data-schema.md` は「装置から届いた音声チャンクは**先頭サンプル**の `t_ms` を持つ」と定義して
いるが、`logger.ino` の `on_pdm()` は `PDM.read()` を済ませた**後**に `chunk_t_ms = millis()` を
実行している。ボードコアのコールバックは DMA の処理後に呼ばれるので、この時刻は先頭サンプルでは
なくチャンク末尾付近を指すと考えられる。

- 1チャンクは実測 64 サンプル＝ 4 ms なので、ずれの上限はその程度と見込まれる（**ずれ自体は未実測**）。
- どちらに揃えるか（ファームウェアを先頭サンプルの時刻に直すか、文書を実装に合わせるか）は
  **#15** で決める。#2 では `firmware/` も `docs/data-schema.md` のこの定義も変えていない。

## 直したもの

- `tools/record.py`
  - tty が無いときはキー入力のスレッドを起こさない（この環境には tty が無く、
    以前はスレッドが例外で落ちていた）。
  - 正常受信フレーム数（stream_id ごと）と XOR 不一致数を数えて、終了時に出す。
    以前は xor の合わないフレームを黙って捨てていて、数える経路が無かった。
  - `SUBJECT` / `COND` / `POSITION` / `BAND` / `DURATION` を対応する引数の既定値として読む。
  - `--duration <秒>` を足した。指定秒数で Ctrl-C と同じ後始末を通って自分から終わる。
  - 記録形式（フォルダ名、ファイル名、CSV の列、WAV の形式、フレームの解釈）は変えていない。
- `CMakeLists.txt`
  - `record` ターゲットが起動できなかったのを直した。`$ENV{SUBJECT}` などは configure 時に
    評価されるため、生成物には `--subject --cond --position` と値の無い引数が並び、
    `argument --subject: expected one argument` で落ちていた。引数に展開するのをやめ、
    環境変数をそのまま `record.py` に渡す形にした。
  - `monitor` の baudrate を 2000000 に揃えた（上の実測）。
- `docs/data-schema.md` と `docs/decisions/0006`: 記載漏れ2点の補完と、サンプルレートの正の決定。

## 動作確認のセッションを消したこと

手順どおり数字を取り `meta.json` を確認したあと、`data/raw/` のセッションフォルダを削除した。
`analysis/split.py` は名前に `_self_` を含むフォルダを**すべて**学習・評価の候補にする
（log を読まない）ので、「動作確認用」と書き残すだけでは除外にならないため。

## 詰まった点

- `cmake --build build --target record -- SUBJECT=...` の形は効かない。`$ENV{}` が configure 時に
  評価されるため。`SUBJECT=self ... cmake --build build --target record` の形に直した。
- 10秒で止める手段。tty が無いので Ctrl-C を送れず、`timeout -s INT` は cmake → make → python と
  プロセスを挟むので SIGINT が届く保証がない。届かずにやり直すと、そのたびにポートを開いて
  META を消費してしまう（META は `setup()` で一度だけ送られ、起動後の最初の接続でしか届かない）。
  `--duration` で自分から終わる形にした。
- そのため、書き込みのあと本番の記録まではポートを開かないようにした。CMake の展開結果の確認は
  configure だけで済ませ、環境変数が届くかどうかは `SUBJECT` に不正な値を入れて
  `subject は self か p1` で落ちることで確かめた（この経路はシリアルを開く前に終わる）。
