owhinata/zaitaku-mealpace/docs/log/README.md

# 実験ノート

1 日 1 ファイル。`YYYY-MM-DD.md`。CLAUDE.md の公開範囲ルールが適用される。

```
# 2026-09-22

## やったこと
- 

## 分かったこと
- 

## 次
- 
```
