owhinata/zaitaku-mealpace/docs/plan.md

# 計画と関門

応募締切 2026-11-24。1st Stage 審査会 2026-12-11。

関門を通過するまで、次の段階のものは作らない。判定は人が行い、`docs/decisions/` に残す。代替センサの試用は、試用ブランチで関門の前に始めてよい。main に入れるのは関門の後（docs/decisions/0024）。

| Milestone | 期間 | 内容 | 判定基準（通過条件） |
|---|---|---|---|
| **M0 準備** | 9/19〜9/21 | リポジトリ、CLAUDE.md、データスキーマ、評価定義、開発環境、Edge Impulse プロジェクト | ビルドと書き込みが通る。決定事項がすべてファイルにある |
| **M1 ロギング・分岐点** | 9/22〜9/27 | IMU＋マイクを CSV/WAV に落とす。自分の喉元で嚥下・非嚥下を各50回以上記録 | `docs/evaluation.md` の分岐点合格線（検出率70%以上、誤検出3回/分以下、手作り特徴量＋ロジスティック回帰、セッション分割） |
| **M2 検出器** | 9/28〜10/11 | #27 を 10/4 で打ち切り、#28 で判定する（docs/decisions/0023・0024） | 検出率85%以上、誤検出1回/分以下（変えない）。#28 の結果にかかわらず M3 へ進む（咽喉マイクに切り替える。docs/decisions/0025） |
| **M3 咽喉マイクの試用** | マイク到着〜10/25 | (1) PC のマイク入力で `self` を録り、嚥下の信号が見えるかを確かめる。(2) 見えたら基板と構成を決める（基板と構成は docs/decisions/0025・0026 で決めた。M3 ではその立ち上げ）。(3) 記録の経路を作り、`self` で嚥下・非嚥下を録る | (1) の信号の有無を人が判定。(3) は M1 の分岐点合格線（検出率70%以上、誤検出3回/分以下、セッション分割）を新しいセンサで満たす |
| **M4 検出器（咽喉マイク版）** | 10/26〜11/7 | 学習、装置上の推論、表示、`self` の `meal` の通し記録 | M2 と同じ合格線（85% / 1回/分）。届かない場合も、届かなかった数字と原因の切り分けを公開の材料にする |
| **M5 公開** | 11/2〜11/17（人の決定 11/1 で 11/8 から前倒し） | ProtoPedia 記事を **11/10 に一般公開（ステータス「開発中」）し 11/17 まで更新**、動画、コード整理、MCU の自律消灯、UNO Q の自動起動、1 ホップと `p1` の記録先の decision | 公開済み |
| **M6 バッファ** | 11/18〜11/24 | 記事の更新、抜けの補完 | 応募完了 |
| （応募後）本人試用 | 未定 | 同意のうえ記録のみで装着 | 応募期間の外。時期は決めない（docs/decisions/0024） |

## 分岐点で止める条件

M1 で合格線に届かない場合:
1. 圧電コンタクトマイク（または docs/decisions/0002 の代替センサ）を追加して再試験
2. それでも不可なら、本人試用に進まず、方式を見直すか計画を止める

## M2 までに決めること

- 一口ボタンの扱い（潜時の起点にのみ使う／使わない）→ 9/24 に決定: M2 では使わない（docs/decisions/0018）
- Edge Impulse プロジェクトの公開範囲 → 9/24 に決定: Public。切り替えは #21 で投入後に条件を記録してから（docs/decisions/0019）
- IMU と音の結合の方式（Edge Impulse は同じサンプリング周波数のチャンネルしか結合できない。docs/log/2026-09-20.md）
  → 9/24 に決定: 装置で計算した窓ごとの特徴量ベクトルを Edge Impulse の分類器に入れる。音の式は #21 で削って固定（docs/decisions/0019）

## 本人試用の前に行うこと

本人試用は応募期間の外。時期は決めない（docs/decisions/0024）。

- 本人への説明と同意（何を記録し、何を記録しないか）
- `p1` の記録先を決める → 11/3 に決定: `self` と同じ扱い。`data/raw/` に記録し、暗号化ディスクの要件は外す。
  コミットしない・貼らない・公開は集計値と匿名化した切り出しのみ、は変えない（docs/decisions/0007・0048）

## M5 の前に行うこと

- ProtoPedia アカウントと作品ページの枠

## 11月時点で「可能性の証明」と言える状態

- 開発者自身の体で検出が動いている（動画）
- 開発者自身の実際の食事での数字（混同行列とセッション一覧つき）
- 基板のセンサと咽喉マイクで何が変わったか（比較が 1 つ）
- 姿勢の同時記録と本人試用は未実施であること、何が未検証かを明記している
