owhinata/zaitaku-mealpace/docs/recording-protocol.md

# 記録手順（self）

対象は `self` のみ。M1 の収集（#12）用の手順と、M2 の通し記録（#27）用の手順（「M2 の通し記録（`meal`）」の節）。
M3 の咽喉マイクの記録（#39）の手順は「咽喉マイク（M3）」の節にある（M1 の手順との違いだけを書く。決定は docs/decisions/0031）。
`p1` の手順は M3 の前に別に決める。
`docs/evaluation.md`・`docs/data-schema.md` の定義と合格線はこの文書では変えていない。

評価側を最後の2収集日にする決定は #8 のコメントに、M2 の通し記録の手順の決定は #26 のコメントにある。

## 早見表（1収集日の7本）

1セッション（`record.py` の1回の実行、180 秒）で行う条件は1つだけ。1本の記録に複数の条件を
混ぜない。1収集日は下の7本をこの順で、装着し直さずに録る（記録時間 21 分）。詳しい決まりは
下の各節にある。

| # | コマンド | やること | 打つマーカー | 回数の目安 |
|---|---|---|---|---|
| 1 | `.venv/bin/python tools/record.py --cond quiet --duration 180` | 何もせず座っている | 開始直後に `q` を1回 | — |
| 2 | `.venv/bin/python tools/record.py --cond water --duration 180` | 水を一口ずつ飲む。前の嚥下から 10 秒以上あける | 嚥下ごとに `s` | 嚥下 10 回前後 |
| 3 | `.venv/bin/python tools/record.py --cond talk --duration 180` | 短い文を1つ読み上げ、黙る、を繰り返す | 発話の始めに `t` | 15 回前後 |
| 4 | `.venv/bin/python tools/record.py --cond saliva --duration 180` | 唾液を飲み込む（空嚥下）。無理に回数を稼がない | 嚥下ごとに `s` | 嚥下 5 回前後 |
| 5 | `.venv/bin/python tools/record.py --cond neck --duration 180` | うなずく、左右を向く、上を向く、を1回ずつ | 動きの始めに `n` | 15 回前後 |
| 6 | `.venv/bin/python tools/record.py --cond water --duration 180` | 水を一口ずつ飲む。前の嚥下から 10 秒以上あける | 嚥下ごとに `s` | 嚥下 10 回前後 |
| 7 | `.venv/bin/python tools/record.py --cond cough --duration 180` | 軽い咳払いか咳を1回。喉が痛ければ止める | 咳ごとに `c` | 10 回前後 |

- `.venv` を使わない環境では `python` に読み替える。
- どの条件でも嚥下したら必ず `s` を打つ（`talk`・`neck`・`quiet` 中の自然な嚥下も含む）。
- マーカーは動作の開始と同時に押す。気づいた打ち遅れ・打ち忘れ・打ち間違いは `o` を押して note
  に書く。
- 各セッションの直後に `.venv/bin/python tools/check_session.py data/raw/<セッション>` を実行し、
  使うか取り直すかをその場で決める（基準は「マーカーの打ち方」の「捨てる」）。
- 回数は目安で、合格の条件ではない（集めた量の基準は「『各50回以上』の数え方」）。

### 早見表（M2 の通し記録、`meal`）

1セッション = 1 食（食べ終わるまで。ただし 30 分で打ち切る）。検出器ファームウェア（#24・#25）で録る。詳しい決まりは「M2 の通し記録（`meal`）」の節にある。

| # | コマンド | やること | 打つマーカー | 目安 |
|---|---|---|---|---|
| M2 | `.venv/bin/python tools/record.py --cond meal --duration 1800` | 実際の食事（固形物を含む）を普段どおり食べる。食べ終わったら Ctrl-C（30 分で自動的に打ち切られる） | 食べ物・飲み物を意識して飲み込むごとに `s`（無意識の小さな唾液の嚥下は押せなくてよい。docs/decisions/0023）、咳・咳払いごとに `c`、話し始めに `t`。`b`・`n`・`q` は打たない | 1 セッション = 1 食（食べ終わるまで。ただし 30 分で打ち切る）、3 セッション以上、合計 `s` 50 以上、会話なし 1・会話あり 1、収集日 2 日以上が望ましい。2026-10-04 の終わりで打ち切る（届かなくても延ばさない。docs/decisions/0023） |

### 早見表（咽喉マイク（M3）、#39）

| # | コマンド | やること | 打つマーカー | 目安 |
|---|---|---|---|---|
| M3 | `.venv/bin/python tools/record.py --throat sh12jk-wired-unoq-usbaudio --position lateral-below-cricoid --band sh12jk-strap --cond <cond> --duration 210` | M1 と同じ 7 本を同じ順（`quiet` → `water` → `talk` → `saliva` → `neck` → `water` → `cough`）。各セッションの冒頭に叩き 5 回 → 装着 → `o start`、その後に条件の動作 | 叩きは `o` の note `tap`、区切りは `o` の note `start`。`o start` の後は M1 と同じ | 1 セッション 210 秒（`o start` の後が約 180 秒）。詳しくは「咽喉マイク（M3）」の節 |

### 早見表（M4 の `meal`（咽喉マイク）、#48）

| # | コマンド | やること | 打つマーカー | 目安 |
|---|---|---|---|---|
| M4 学習 | `.venv/bin/python tools/record.py --throat sh12jk-wired-unoq-usbaudio --position lateral-below-cricoid --band sh12jk-strap --cond meal --duration 1800` | 実際の食事。叩き 5 回 → 装着 → `o start`（会話ありは `o conv`）→ 食べる → 最後の嚥下から 5 秒後に Ctrl-C | `s`・`c`・`t`・`o`（0023 のまま） | 3 本、締めは docs/decisions/0037 |
| M4 評価 | `.venv/bin/python tools/record.py --unoq-detector --feat --no-rpc --position lateral-below-cricoid --band sh12jk-strap --cond meal --duration 1800` | 装置（UNO Q の `detector.py`）で録る。起動の直後に消灯を送るので、マトリクスが消えていることを目で確かめて Enter → 装着 → 「窓が届き始めた」の後に `o start`（会話ありは `o conv`）→ 食べる → 最後の嚥下から 5 秒後に Ctrl-C。叩きはしない | `s`・`c`・`t`・`o`（0023 のまま） | 3 本以上・収集日 2 日以上、2026-11-01〜11-04（0037）。直後に `tools/unoq_session_check.py` |

## 装着と環境

- 位置は正中、甲状軟骨のすぐ下（`position` = `midline-below-thyroid`、`record.py` の既定）。
  バンドは 25 mm の伸縮バンド（`band` = `elastic-25mm`）。変えたら `--position` / `--band` で渡す。
- 向きは `docs/data-schema.md` のとおり、基板の Y 軸が首の上下方向、+Y が頭側。
- 首を圧迫しない強さで留める。苦しければ外す。USB ケーブルは衣服に留め、基板を引っ張らせない。
- 椅子に座り、背を起こした姿勢。静かな部屋で、他の人の声とテレビ・音楽が入らないようにする
  （リポジトリは public。#9 の見本にも使う）。
- 収集日ごとに装着し直す。同じ日のセッションの間は外さない（外したら `o` の note ではなく、
  次のセッションから付け直したことを log に書く）。

## 記録の実行

- マーカーは tty が要る。端末から直接 `python tools/record.py --cond <cond> --duration 180` を
  実行し、`recording... keys:` の表示を確かめる。「tty が無いので…」と出たらマーカーが打てないので
  止め、できたフォルダを消してからやり直す。
- 出力先は `data/raw/` 固定（docs/decisions/0007）。コミットしない。
- 記録の直後に `python tools/check_session.py data/raw/<セッション>` を実行する。取りこぼしが
  1%以上、または `record.py` の XOR 不一致が0でないセッションは使わない（下の「捨てる」）。

## 条件ごとのセッション（1セッション 180 秒）

1セッションで行う条件は1つだけ。1本の記録に複数の条件を混ぜない。

| cond | やること | 打つマーカー | 1セッションの目安 |
|---|---|---|---|
| `water` | 水を一口ずつ飲む。前の嚥下から 10 秒以上あける | 嚥下ごとに `s` | 嚥下 10 回前後 |
| `saliva` | 唾液を飲み込む（空嚥下）。無理に回数を稼がない | 嚥下ごとに `s` | 嚥下 5 回前後 |
| `talk` | 短い文を1つ読み上げ、黙る、を繰り返す | 発話の始めに `t` | 15 回前後 |
| `cough` | 軽い咳払いか咳を1回。喉が痛ければ止める | 咳ごとに `c` | 10 回前後 |
| `neck` | うなずく、左右を向く、上を向く、を1回ずつ | 動きの始めに `n` | 15 回前後 |
| `quiet` | 何もせず座っている | 開始直後に `q` を1回 | — |

- 嚥下の間隔を 10 秒以上あけるのは、`[t − 0.5 s, t + 1.5 s]` の窓が重ならないようにするため。
- **どの条件でも、嚥下したら必ず `s` を打つ。** `talk`・`neck`・`quiet` の最中に出る自然な唾液の
  嚥下も含む。打たなかった嚥下は「非嚥下区間」に入り、正しい検出が誤検出に数えられる。
- `meal` は M1 では記録しない（M2 の手順は「M2 の通し記録（`meal`）」の節）。`b`（一口）は M1 でも M2 でも打たない
  （docs/decisions/0018。一口ボタンは M2 では使わない）。

## マーカーの打ち方

- マーカーは開始時刻（`docs/data-schema.md`）。自分の動作なので、飲み込み始める・話し始める・
  動き始めるのと同時にキーを押す。終わってから押さない。
- 打ち遅れ・打ち忘れ・打ち間違いに気づいたら、すぐ `o` を押して note に書く（例: `late s`、
  `missed s`、`wrong key`）。`events.csv` は後から手で直さない。`o` の `t_ms` は note を入力し
  終えた時刻なので、気づいた時刻としては使わない。採否に使うのは note の本文だけ。
- 捨てる: `s` の打ち忘れが1回でもある、`s` の遅れが 0.5 秒を超えたと思う、取りこぼしの基準を
  外れた、他の人の声が入った、のどれかに当たるセッションは、フォルダごと消して取り直す。
  `t`・`c`・`n` の打ち遅れは note に残すだけでよい（評価の定義はこれらのマーカーを使わない）。
- 捨てるかどうかは**記録の直後に**決める。特徴量や分類器の結果を見てから、セッションを
  捨てたり選んだりしない。

## 収集日とセッション数

- 1収集日 = 1セット7セッション: `water` ×2、`saliva`、`talk`、`cough`、`neck`、`quiet`
  （記録時間 21 分）。順番は `quiet` → `water` → `talk` → `saliva` → `neck` → `water` → `cough`
  （咳は最後）。
- 収集日は日を分ける。最小で3日（21 セッション）、目安は4日。1日あたりの目安は嚥下 約25回、
  `t`+`c`+`n` 約40回、`quiet` 3分。
- **評価に回すのは、最後の2収集日のセッション全部。** 学習はそれより前の収集日のセッション全部。
  日数は先に固定しない。下の「各50回以上」と、学習側に1収集日以上・評価側に2収集日、がそろったら
  評価する。
  - 評価セッション同士の収集日が分かれ、学習側とも収集日が重ならない（`docs/evaluation.md`
    「収集日が異なることが望ましい」）。同じ日・同じ装着のセッションが学習と評価の両側に入らない。
  - `analysis/split.py` は収集日を見ず、`_self_` を含むフォルダを名前順に並べて後ろから取るだけ。
    `python analysis/split.py data/raw --eval-min <最後の2収集日のセッション数>` を実行し、
    出力の `eval` が最後の2収集日のセッション名の一覧と完全に一致すること、`train` にそれ以外の
    使うセッションが全部入っていることを、#13 の前に目で照合する。一致しなければ `data/raw/` に
    余計なフォルダが残っている。
- `data/raw/` には、使うセッションだけを残す。次のフォルダは消す（`self` のデータに制限はない）。
  - この手順を決める前に録ったもの（#2・#6・#7 の確認用。#7 の `quiet` は tty なしで録っており、
    自然な嚥下に `s` が打たれていない）。
  - tty なし・中断・起動失敗でできたもの（`record.py` は tty の判定より先にフォルダを作る）。
  - 上の「捨てる」に当たったもの。
- #13 で評価側の数字を一度でも見た後は、評価側を動かさない。その後に収集日を足す場合の扱いは
  #14 で人が決める。

## 「各50回以上」の数え方

- 嚥下: 使うセッション全体の `s` の合計が 50 以上。
- 非嚥下: `t`・`c`・`n` の合計が 50 以上、かつ `t`・`c`・`n` がそれぞれ 10 以上、かつ `quiet` の
  セッションが合計 5 分以上。
- これは集めた量の目安で、#12 の集計表で確かめる。`docs/evaluation.md` の誤検出率は非嚥下区間の
  **分数**で割る定義のままで、`t`・`c`・`n` の回数は評価の式に入らない（誤検出の内訳を見るのに
  使う）。
- 評価側（最後の2収集日）だけで `s` が 20 以上、学習側だけでも `s` が 20 以上あることを確かめる。
  足りなければ収集日を足す。

## 1収集日の流れ

1. 装着する（上の「装着と環境」のとおり）。
2. 7セッションを決まった順で行う: `quiet` → `water` → `talk` → `saliva` → `neck` → `water` →
   `cough`。記録ファームウェアは合図に応えない。META を受けるため、記録の前に USB を挿し直す（docs/decisions/0006）。
   各セッションで次を行う。
   1. リポジトリのルートで実行する: `python tools/record.py --cond <cond> --duration 180`
      （`.venv` を使う場合は `.venv/bin/python tools/record.py --cond <cond> --duration 180`）。
   2. `recording... keys:` の表示を確かめる。「tty が無いので…」と出たら中止し、できたフォルダを
      消してからやり直す。
   3. 条件表の打つマーカーに従い、動作の開始と同時にキーを押す（`talk`・`neck`・`quiet` 中の
      自然な嚥下も含め、嚥下したら必ず `s`）。打ち遅れ・打ち忘れ・打ち間違いに気づいたら `o` を
      押して note に書く。
   4. 記録が終わったら直後に `python tools/check_session.py data/raw/<セッション>` を実行する。
   5. 「マーカーの打ち方」の「捨てる」に当たるか、取りこぼしの基準を外れていないかを確かめ、
      使うか取り直すかをその場で決める。特徴量や分類器の結果を見てから決めない。

## M2 の通し記録（`meal`）

対象は `self` のみ、M2 の通し記録（#27）用。検出器ファームウェア（#24・#25）で録る。装置は IMU と音声を PC に送らず、
セッションのフォルダには `detect.csv`・`feat.csv`・`events.csv`・`meta.json` だけができる（形式は `docs/data-schema.md`、決定は docs/decisions/0021。
docs/decisions/0005 のとおり、生の音声波形は装置の中で特徴量に変換した後に捨てられ、PC には届かない）。
`docs/evaluation.md` の定義と合格線はこの節でも変えていない。LED の表示は嚥下の目安であり、判定ではない。LED は評価に関わらない
（docs/decisions/0018）。
`meal` の `s` の押し方、捨てる条件、打ち切りは docs/decisions/0023 で決めた（打ち忘れ・打ち遅れでは捨てない）。M1 の「どの条件でも嚥下したら必ず `s`」と M1 の「捨てる」は `meal` には当てない。

### 何を録るか

- 1セッション = 1 食（食べ終わるまで。ただし 30 分で打ち切る）。実際の食事で、固形物を含む。飲み物を伴ってよい。普段どおりの速さで食べる。M1 の `water` の
  「前の嚥下から 10 秒以上あける」は使わない（近接した嚥下の区間は評価の側で和集合にして数える。docs/decisions/0011）。
- 3 セッション以上、合計で `s` 50 以上。うち 1 セッションは**会話なし**、1 セッションは**会話あり**。収集日は 2 日以上が
  望ましい。ただし 2026-10-04 の終わりまでに録った分で打ち切り、届かなくても延ばさない（届かなかった条件は #28 に「未達」として渡す。docs/decisions/0023）。
  2026-10-05 以降は `meal` を録らない。録ってしまった `meal` は `data/raw/` に残して評価に使わず、集計表に「打ち切りの後。M2 の数字に使わない」と書く。
  途中で装置に書き込んだ場合も、それより前の `meal` は「書き換え前。M2 の数字に使わない」として残す（下の「ファームウェアを書き換えたら…」と同じ）。
  どちらかがあるときの評価は、打ち切りまでに録った書き込み後の採用分の全部を `--sessions` で明示する（必須）。
  1 セッションの `s` は 10 以上を目安にする（目安で、採否の条件ではない）。
  - **会話なし**: 食事中に自分が話さず、他の人の声・テレビ・音楽も入らない食事。
  - **会話あり**: 食事中に自分が声を出して話す時間がある食事（同席者との会話でも、通話でもよい）。テレビ・音楽は入れない
    （会話と咀嚼のどちらで誤検出が増えるかを分けるため、会話以外の音は会話なしと同じにする）。
    同席者がいる場合、その人についてはログにも Issue にも「同席者あり」以上のことを書かない。
- 1 食を複数のセッションに分けない。会話なしと会話ありは別の食事にする（同じ食事の前半と後半にしない）。
- 3 セッション以上は、同じファームウェア（同じモデル、#22 で凍結した同じ閾値）で録る。ファームウェアを書き換えたら、それより前の
  `meal` は M2 の数字に使わない（ログに残し、参考値にとどめる）。
- `meal` の収集日は、学習側（収集日1〜3）と検証側（収集日4）に使った 2026-09-21〜24 とは別の日にする。検出器ファームウェアで
  録る時点で自然に満たすが、規則として書いておく。

### 装着と環境

- 装着の位置・バンド・向きは M1 と同じ（「装着と環境」）。`--position` / `--band` の既定値のまま録る。変えたら渡す。
- 食事ごとに装着し直してよい（食事の間隔は数時間あき、付けたままにしない）。付け直したことはログに書く。
- 椅子に座り、食卓で食べる。M1 の「静かな部屋で、他の人の声とテレビ・音楽が入らない」は、会話ありのセッションでは
  会話の相手の声を除いて同じ（テレビ・音楽は入れない）。
- 装置の LED の表示は嚥下の目安で、判定ではない（docs/decisions/0018）。記録中は見ない（喉元の LED は自分からは見えない。評価に関わらない）。
  介助者に見せる表示は別の基板の表示器（`firmware/indicator/`、#29）で行うが、`meal` の記録では表示器をつながない（`record.py` に `--indicator` を付けない）。
  見えると `s` の打ち方が表示に引きずられるおそれがある（#27）。表示器の有無で記録のファイルの形式は変わらない。

### 記録の実行

- `record.py` は始めるときに検出器へ合図を送り、META（`fw`・`threshold` など）を受けてから記録を始める。挿し直しは要らない。5 秒以内に META が
  届かなければ記録を始めずに止まる（フォルダはできない）。そのときはファームウェアとポートを確かめてからやり直す（docs/decisions/0006 の追記）。
  `fw` が `detector` でないセッションは、検出器で録ったことを後から示せないので使わない。
- リポジトリのルートで、端末から直接 `.venv/bin/python tools/record.py --cond meal --duration 1800` を実行する
  （`.venv` を使わない環境では `python` に読み替える）。`--duration 1800`（30 分）は上限で、
  食べ終わったら Ctrl-C で止める。食事が 30 分を超えて自動終了した場合は、その記録をそのまま 1 セッションにする（残りは録らない）。
  自動終了の位置は選べないので、終わりの 1.5 秒以内に `s` が掛かっていたら「捨てる」の規則で捨てる。上限は上げない。
  `recording... keys:` の表示を確かめる。「tty が無いので…」と出たら止め、できたフォルダを
  消してからやり直す。
- `recording... keys:` が出てから 5 秒以上待ち、フレームが届いてから食べ始める（届く前のマーカーは `t_ms` が 0 になり、評価でエラーになる。
  docs/decisions/0011「記録の範囲」）。
- 会話ありのセッションでは、食べ始める前に `o` を押して note に `conv` と書く。会話なしでは `o` を押さず、
  食べ始める（`conv` の note が無いセッションが会話なし）。この `o` は採否の材料の `o`（打ち間違いの `wrong key`。docs/decisions/0023）
  とは別で、ログの集計表にも会話の有無を書く。
- 最後の嚥下から 5 秒以上待ってから Ctrl-C で止める（終わりの 1.5 秒以内に `s` が入らないようにする）。
- 出力先は `data/raw/` 固定（docs/decisions/0007）。コミットしない。`feat.csv` も同じ扱い（特徴量は波形ではないが、
  生の計測データとして `data/raw/` の外に出さない）。

### 打つマーカー

| マーカー | いつ押すか |
|---|---|
| `s` | 食べ物・飲み物を意識して飲み込むごとに、飲み込み始めるのと同時に。1 口で 2 回飲み込んだと分かれば 2 回押す。無意識の小さな唾液の嚥下は押せなくてよい（押したものはそのまま残す）。打ち忘れ・打ち遅れでセッションは捨てない（docs/decisions/0023） |
| `c` | 咳・咳払い・むせごとに、その始めに（M1 の `cough` と同じ粒度） |
| `t` | 話し始めに。5 秒以上黙った後に話し始めるたびに 1 回（一言ごとには押さない）。同席者や通話の相手が話しても押さない |
| `o` | 打ち間違いに気づいたらすぐ押して note に `wrong key` と書く。会話ありのセッションの最初の `conv` も `o`。`s` の打ち忘れ・打ち遅れの note は求めない（打った場合も採否に使わない。体感はセッションの直後に集計表に書く） |

- `b`（一口）は打たない（docs/decisions/0018。一口ボタンは M2 では使わない）。`n`（首の動き）と `q`（静止）も打たない
  （食事中の首の動きは非嚥下区間に含めて数える。静止の区間は無い）。咀嚼・食器の音・飲み物を口に運ぶ動きにマーカーは
  無く、すべて非嚥下区間に入る（`docs/evaluation.md`「非嚥下区間」）。
- 50 口は `s` の合計で数える。1 口に複数の嚥下があればその数だけ `s` が増え、口に運ぶ回数とは一致しない。M2 の数字に使うのは
  `s` の数だけで、口に運んだ回数は数えない。
- `s` は押せた嚥下だけなので、「50 口」は押せた嚥下の合計で、食事中の嚥下の総数ではない（docs/decisions/0023）。
- マーカーの `t_ms` は直前に届いたフレームの時刻で、検出器はフレームを 0.25 秒ごとに送るので、押した時刻より最大 0.25 秒
  早い側に丸まる。検出の区間 `[t − 0.5, t + 1.5]` の幅 2.0 秒に対して小さいが、境界付近の窓の扱いは変わりうる。装置側の送信間隔と処理の遅れは #24 の実機の記録で確かめる（`tools/check_session.py` の実効レートと「送信時刻 − 窓の開始」は装置の送信時刻から出す目安）。PC への到着間隔と、マーカーの `t_ms` と押した時刻の差は `record.py` が PC 側の時刻を残さないので、確かめる方法は #24 で別に決める。打ち遅れの目安（0.5 秒）は M1 と同じにする。ただし `meal` では打ち遅れでセッションを捨てない（docs/decisions/0023）。

### 各セッションの直後にすること（採否は人。数字を見る前に決める）

1. Ctrl-C の直後、ほかの確認（`record.py` の終了時の表示の数を含む）を見る前に、`s` の打ち忘れの体感と打ち遅れの体感を
   それぞれ「ほぼ無し / 数回 / 多い」で控える。採否には使わない（docs/decisions/0023）。
2. `.venv/bin/python tools/check_session.py data/raw/<セッション>` を実行する（検出器のセッションでは `detect.csv`・`feat.csv` の `window_t_ms` の飛びから取りこぼしを推定し、`t_ms` の逆行・最大差分・DETECT と FEAT の窓の不一致を出す。陽性の数は出ない）。
   窓の飛び（取りこぼし）が 1% 以上、`record.py` の XOR 不一致が 0 でない、`detect.csv`・`feat.csv` の `t_ms` か `window_t_ms` に逆行がある、隣との差が 1 秒を超える、
   のどれかに当たるセッションは使わない（取りこぼしと XOR は M1 と同じ作業上の基準。逆行と 1 秒超の飛びは docs/decisions/0011
   「記録の範囲」が評価でエラーにする条件で、M1 の集計表でも毎回数えた）。`check_session.py` が出すのは `window_t_ms` の最大差分だけなので、
   `t_ms` の隣との差と送信の遅れは #27 の採否の補助スクリプトで見る。
3. `meta.json` の `fw` が `detector` であることを確かめる。違えば使わない。
4. `events.csv` の `s` の数、`c`・`t` の数、`o` の note を数えて、ログの集計表に書く。会話の有無、同席者の有無、
   付け直しの有無、記録の長さ、自動終了か Ctrl-C か、取りこぼし、XOR 不一致、`t_ms` の逆行、最大の飛び、ファームウェアのコミットも
   書く。打ち忘れの体感・打ち遅れの体感（3 段）、記録時の `s` の決まり（#26 / 0023）も書く。食事の内容は「固形物を含む」までにし、献立は書かない。
5. 捨てる: docs/decisions/0023 の捨てる条件（取りこぼし 1% 以上、XOR 不一致、`t_ms`・`window_t_ms` の逆行か 1 秒超の飛び、窓の終端からの送信の遅れ > 1 秒、
   記録の始まりより前のマーカー、終わりの 1.5 秒以内の `s`（30 分の自動終了で切れた場合を含む）、`fw` が `detector` でない、会話ありの `conv` の綴り違い、`s` に関わる `wrong key`）の
   どれかに当たるセッションは、フォルダごと消して、打ち切り（2026-10-04）の前なら次の食事で録り直す。`s` の打ち忘れ・打ち遅れでは捨てない。
   `c`・`t` の打ち遅れは note に残すだけでよい（評価の定義はこれらのマーカーを使わない）。
   M1 の「他の人の声が入った」は `meal` では捨てる理由にしない（会話ありは相手の声が入る。波形は残らない）。
6. 採否を決める前に `detect.csv` の陽性を数えない（`analysis/evaluate_detector.py` を走らせない）。#27 の「採用前に数字は見ない」
   と同じ。採否に使うのは上の 2〜5 だけ。体感は採否に使わない。

### 評価との関係（#27）

- M2 の数字（検出率、誤検出率、混同行列、セッション一覧）は、検出器で録った `meal` だけで出す。学習に使った 28 本
  （記録ファームウェア、2026-09-21〜24）は入れない。`analysis/split.py` は `fw` が `detector` のセッションを M1 の分割に入れない（docs/decisions/0021）。
- 3 セッション以上（`docs/evaluation.md`「評価には 3 セッション以上」）。会話なし・会話ありの別と収集日の別は、#27 の参考値
  （会話の有無ごと・収集日ごとの数字）に使う。合格線は全セッションの合算で見る。打ち切り（2026-10-04）までの採用が 3 セッション未満なら
  合算と合格線との比較は出さず、セッションごとの数字だけを M2 の数字ではないとして報告する（docs/decisions/0023）。
- `s` は本人が押せた嚥下だけ（docs/decisions/0023）。欠けた `s` で誤検出の回数は増えうるが、非嚥下区間の分も伸びるので、率のずれの向きと大きさは確定できない。
  押せた嚥下がはっきりしたものに偏っていれば検出率は高めに出るおそれがある。#27 の報告にこの読み方を書く。
- 記録の範囲は `detect.csv` の最初の窓の開始から、最後の窓の終端か最後に届いたフレーム（DETECT / FEAT）の送信時刻の遅いほうまで。送信の遅れが 1 秒を超えるセッションはエラー（docs/decisions/0021。docs/decisions/0011 の読み替え）。
- 合格線に届かなくても、定義・閾値・モデルを動かさない（#27）。届かなかったときの扱いは #28 で人が決める。

## 咽喉マイク（M3）

対象は `self` のみ、M3 の咽喉マイクの記録（#39）用。M3 の (3) の数字（#40）に使う（docs/decisions/0024）。決定と根拠は docs/decisions/0031（plan #39）。
M1 の手順（上の各節）を土台にし、この節には違いだけを書く。書いていないことは M1 のまま。
`docs/evaluation.md`・`docs/data-schema.md` の定義と合格線はこの節でも変えていない。

- 経路は有線（`--throat sh12jk-wired-unoq-usbaudio`）: 咽喉マイク SH-12JK → UNO Q の USB オーディオアダプタ → `arecord` の生の PCM → ssh → PC の `data/raw/`
  （docs/decisions/0028）。形式と時計は docs/decisions/0029 のまま（`throat.wav` 48 kHz・2 ch・int16、PC の単調時計、`fw` = `pc-throat`）。
- 無線（構成 B、`sh12jk-nz210c-a2dp-unoq`）は使わない（人の決定 10/10。送信機のノイズゲート。docs/log/2026-10-10.md）。
- 記録は `data/raw/` の直下に置く（docs/decisions/0007）。コミットしない。`data/raw/trial-throat/` は試用の置き場（#37）で、M3 の数字に使わない。

### 装着と環境

- 位置: 気管の脇・輪状軟骨の直下（`--position lateral-below-cricoid`。#37 の実際の位置）。左右の側は最初の収集日に人が決めてその日の log に書き、
  全収集日で同じ側にする（`--position` の値は変えない。側は log だけに書く）。
- バンド: SH-12JK の付属のバンド（`--band sh12jk-strap`）。`record.py` の既定 `elastic-25mm` は M1 の基板のバンドの名前なので、必ず `--band` を渡す。
  首を圧迫しない強さで留める。苦しければ外す。マイクのケーブルは衣服に留め、マイクを引っ張らせない。
- 環境: M1 の「装着と環境」と同じ（椅子に座り背を起こす、静かな部屋、他の人の声・テレビ・音楽を入れない）。
- 機材: UNO Q は PC の近くに置き、アダプタとマイクのケーブルを動かさない。UNO Q で検出器のプログラムを動かさない（docs/decisions/0028 決定 3）。
  UNO Q と PC に `~/.asoundrc`・`/etc/asound.conf` を置かない（docs/decisions/0029）。UNO Q のミキサーは変えない（`Mic Capture` 58、on。#37 と同じ）。
- **セッションごとに外して付け直す**（叩きでマイクを手に持つため。#37 と同じ）。同じ日の中でも位置・側・バンドの締め方を変えない。
  M1 の「同じ日のセッションの間は外さない」は咽喉マイクには当てない。

### 1 収集日 = 7 セッション × 1〜2 セット

- M1 と同じ 7 本を同じ順で録る: `quiet` → `water` → `talk` → `saliva` → `neck` → `water` → `cough`（咳は最後）。各条件のやること・打つマーカー・回数の目安は
  M1 の「条件ごとのセッション」の表のまま。1 セッションで行う条件は 1 つだけ。
- **収集日は日付で分ける。** 1 収集日の 7 本は同じ日付（フォルダ名の `YYYYMMDD`）の中で録る（`analysis/train_eval.py` は名前の先頭 8 文字で収集日を数える。
  docs/decisions/0014）。日付をまたぎそうなら始めない。
  同じ日に 2 セット（14 本）録ってよい（人の決定 10/11）。セットごとに 7 本を同じ順で録り、同じ日のセットの間で側・位置・バンドの締め方を変えない。
  2 セット録っても収集日は 1 日に数える（収集日は日付で数える）。2 セットを 2 収集日に見せるためにフォルダ名を変えたり移したりしない。
- リポジトリのルートで、端末から直接実行する（tty が要る。M1 の「記録の実行」と同じ）。

| # | コマンド |
|---|---|
| 1 | `.venv/bin/python tools/record.py --throat sh12jk-wired-unoq-usbaudio --position lateral-below-cricoid --band sh12jk-strap --cond quiet --duration 210` |
| 2 | `.venv/bin/python tools/record.py --throat sh12jk-wired-unoq-usbaudio --position lateral-below-cricoid --band sh12jk-strap --cond water --duration 210` |
| 3 | `.venv/bin/python tools/record.py --throat sh12jk-wired-unoq-usbaudio --position lateral-below-cricoid --band sh12jk-strap --cond talk --duration 210` |
| 4 | `.venv/bin/python tools/record.py --throat sh12jk-wired-unoq-usbaudio --position lateral-below-cricoid --band sh12jk-strap --cond saliva --duration 210` |
| 5 | `.venv/bin/python tools/record.py --throat sh12jk-wired-unoq-usbaudio --position lateral-below-cricoid --band sh12jk-strap --cond neck --duration 210` |
| 6 | `.venv/bin/python tools/record.py --throat sh12jk-wired-unoq-usbaudio --position lateral-below-cricoid --band sh12jk-strap --cond water --duration 210` |
| 7 | `.venv/bin/python tools/record.py --throat sh12jk-wired-unoq-usbaudio --position lateral-below-cricoid --band sh12jk-strap --cond cough --duration 210` |

### 1 セッション 210 秒（叩き・装着の分 約 30 秒 + 条件 約 180 秒）

- 冒頭に、叩き 5 回（約 3 秒おき、約 15 秒）→ 装着 → 区切りの `o start` が入る。合わせて約 30 秒の見込み（#37 の実際の所要は確かめていない）。
- `--duration 210` にして、`o start` から後の条件の時間を M1 と同じ約 180 秒にする（1 収集日の記録時間 24.5 分）。叩きを込みで 180 秒にすると、
  条件の時間が約 150 秒に減り、M1 の 1 日あたりの量と比べられなくなる。
- `--duration 210` で自動終了させる。Ctrl-C で早く止めた記録は使わない（下の「捨てる条件」）。条件の動作は終わりの 5 秒前までにやめる。

### 叩き（#37 と同じ）

1. `recording... keys:` の表示を確かめる。「tty が無いので…」と出たら止め、できたフォルダを消してからやり直す。
2. マイクを指で持ち、`o` を押して note に `tap` と打ち、**Enter をマイクのケースで押す**。約 3 秒おきに 5 回。
3. 代替の手順（`--tap-mode finger`。docs/log/2026-10-07.md）は使わない（#37 では Enter の叩きが 5 本とも 5 / 5 見つかった。finger では `Δ` が出ず、
   下の「捨てる条件」の 9 を当てられない）。

### 区切り `o start` と打つマーカー

- 叩きの後、マイクを装着し、**落ち着いてから** `o` を押し、note に `start` と打って Enter。**`o start` から後が記録の範囲**（docs/decisions/0031。
  docs/decisions/0011「記録の範囲」の咽喉マイクのセッションでの読み替え）。叩きと装着の音は評価にも学習にも入れない。
- `o start` の後、最初のマーカーまで 5 秒以上あける。`quiet` は `o start` の後に `q` を 1 回。
- 打つマーカーは M1 の「マーカーの打ち方」のまま: 嚥下ごとに `s`（どの条件でも。`talk`・`neck`・`quiet` 中の自然な嚥下も）、`t`・`c`・`n` は動作の開始と同時。
  打ち遅れ・打ち忘れ・打ち間違いは `o` の note（`late s`・`missed s`・`wrong key`）。`b` は打たない。
- `o` の note の決まった語は `tap`・`start` の 2 つ。綴りを間違えたら、そのセッションは使わない。

### 各セッションの直後にすること（採否は人。数字を見る前に決める）

1. `.venv/bin/python tools/throat_check.py data/raw/<セッション> --tap-mode enter` を実行する（M1 の `check_session.py` の代わり）。
2. `meta.json` の `fw`・`position`・`band`・`sensors[0].iface`・`throat.mixer`・`throat.stop` を確かめる（`grep` で読む。中身の音声は見ない）。
3. 下の「捨てる条件」に当たるかを、**マーカーごとの振幅の比・特徴量・分類器の結果を見る前に**その場で決める。捨てるものはフォルダごと消して録り直す。
   `throat_check.py` の出力（フレーム数、overrun、推定差、時刻の対応、段差、L と R の相関と RMS の比、0 の区間、叩き）は採否の材料として見てよい。
   L と R の RMS の比は 2 つのチャンネルが同じかを見る値で（#37 では 1.000）、条件ごと・マーカーごとの振幅ではない。
   `throat_check.py` は叩きの印の行に「使うかは人」と出すが、下の 9・10 の規則（人が記録の前に決めた）がこの表示より優先する。
4. log の集計表（下の「log に書くこと」）の行を書く（数字はメインまたは subagent が `throat_check.py` の出力と `events.csv` から写す）。

### 捨てる条件（どれかに当たれば使わない。記録の直後に人が決める）

`throat_check.py` の使わない目安（docs/log/2026-10-07.md。有線の iface の規則のまま）:

1. overrun の行 > 0。
2. `|推定差|` > 125 ms。
3. 段差あり（隣り合う 10 秒の区間の最小の差 > 50 ms）。

記録の形:

4. `meta.json` の `fw` が `pc-throat` でない、`sensors[0].iface` が `sh12jk-wired-unoq-usbaudio` でない、`position` が `lateral-below-cricoid` でない、`band` が `sh12jk-strap` でない。
5. `throat.stop` が `duration` でない（Ctrl-C・子の終了・エラー）。tty なし・中断・起動失敗でできたフォルダ（M1 と同じ）。
6. `throat.mixer` の `Mic` が 58・on でない。
7. `o start` が無い、2 つ以上ある、綴りが違う。`o start` より前に `s`・`t`・`c`・`n`・`q` がある。

M1 の「捨てる」（そのまま）:

8. `s` の打ち忘れが 1 回でもある、`s` の遅れが 0.5 秒を超えたと思う、他の人の声が入った。

叩き:

9. 叩き（Enter）が 3 回未満しか見つからない、または `|Δ の中央値|` > 125 ms → 使わない（録り直す）。
10. 叩きが 3 回以上見つかり 50 ms < `|Δ の中央値|` ≤ 125 ms → **印を付けたまま使う**（`throat_check.py` の 50 ms の印の表示は変えない。#37 の 5 本は −55〜−74 ms でここに当たる）。
    `|Δ の中央値|` ≤ 50 ms は印なしで使う。どの場合も `Δ` で時刻の対応を直さない（docs/decisions/0029）。

- 採否は数字（振幅の比・特徴量・分類器の結果）を見る前に人が決める。後から採否を変えない。
- 捨てた記録は消す（`trial-throat/` へは移さない）。`data/raw/` の直下には使うセッションだけを残す。

### 収集日の数と評価側

- **2 収集日以上**を録る（10/12 に改訂。docs/decisions/0032。10/11 の「3 収集日以上」、10/10 の「4 収集日を 2026-10-18 までに」を改めた。docs/decisions/0031）。
  1 日目（2026-10-11）に 2 セット（学習側）、2 日目（2026-10-12）に 1 セット（評価側）。2 日が最小なのは、評価側が最後の 1 収集日で、
  学習側に 1 収集日以上が要るため。「各 50 回以上」に届かなければ収集日を足す。
- **評価に回すのは最後の 1 収集日のセッション全部。学習はそれより前の収集日の全部**（M1 の規則（最後の 2 収集日。docs/decisions/0014）とは違う。docs/decisions/0032）。
- 「各 50 回以上」の数え方は M1 の「『各50回以上』の数え方」のまま、**咽喉マイクの採用セッションだけで数える**（M1 の 28 本は足さない）:
  `s` の合計 50 以上、`t`+`c`+`n` 50 以上かつ各 10 以上、`quiet` の合計 5 分以上（`o start` から後の分で数える）。評価側だけ・学習側だけでも `s` が 20 以上。
  足りなければ収集日を足す。
- 評価側の数字を一度でも見た後は、評価側を動かさない（M1 と同じ）。

### `trial-throat/` の扱い

- `data/raw/trial-throat/` はそのまま残す（消すかは人）。新しい試用の記録を `trial-throat/` へ入れない。
- `analysis/split.py` は `trial-throat/` を読まずに飛ばす（#39 ステップ B で、名前がちょうど `trial-throat` のディレクトリだけを飛ばす形にした。docs/decisions/0031）。
  それより前は `trial-throat/` があると止まっていた（docs/log/2026-10-07.md）。

### log に書くこと（収集日ごと）

`docs/log/<日付>.md` に「#39 収集日 N」の節を作り、M1 の集計表（docs/log/2026-09-21.md など）と同じ形に咽喉マイクの列を足した表を書く。

| セッション | 条件 | 長さ（秒） | 止まり方 | `s` | `t` | `c` | `n` | `q` | `o`（tap / start / その他の note） | overrun の行 | 推定差（ms） | 段差 | 叩き 見つかった数 / `Δ` 中央値 | 使わない目安 | 採否と理由 |
|---|---|---|---|---|---|---|---|---|---|---|---|---|---|---|---|

- 表の下: 位置の側・バンド・ミキサーの値・付け直しの回数・`firmware_sha`（PC の HEAD）・クロックの差（ppm）、`o start` から後の `quiet` の分数、
  その日の合計（`s`、`t`+`c`+`n`、各ラベル、`quiet` 分）と累計、`s` の間隔 10 秒未満の数、非嚥下の条件の中の `s` の数、終わりの 1.5 秒以内の `s` の数。
- 採否は人の決定として書く（数字を見る前に決めたこと）。振幅の比・特徴量・分類器の数字は書かない（#40 の前）。
- 被験者は `self` のみ。音声・写真は載せない。

## M4 の `meal`（咽喉マイク）

対象は `self` のみ、M4 の学習用と評価用の `meal`（#48）。決定は docs/decisions/0037。`s` の押し方・捨てる条件の趣旨・打ち切りの考え方は
「M2 の通し記録（`meal`）」（docs/decisions/0023）、装着・叩き・`o start` は「咽喉マイク（M3）」のまま。この節には違いだけを書く。
`docs/evaluation.md` の定義と合格線はこの節でも変えていない。LED の表示は嚥下の目安で、判定ではない。

### 学習用と評価用

| | 学習用 `meal` | 評価用 `meal` |
|---|---|---|
| 本数・日 | 3 本、2026-10-25〜10-28（締め 10/28 の終わり。0037） | 3 本以上、2026-10-29〜11-01、収集日 2 日以上（打ち切り 11/01 の終わり。当初の 11/1〜11/4 を同じ日数で前倒し。0037 の追記 10/29） |
| 経路 | PC の記録の経路（`record.py --throat sh12jk-wired-unoq-usbaudio`。`throat.wav` が PC に残る） | 装置（`record.py --unoq-detector`、#47。生の音声はどこにも残らない。FEAT を有効に） |
| 叩き | する（M3 と同じ 5 回） | しない（PC に音が無く、叩きを探せない。時刻の対応は #47 の受信時刻で確かめる） |
| UNO Q の上で動かすもの | `arecord` だけ（`detector.py` を動かさない。0028 決定 3） | `detector.py` だけ（`arecord` を動かさない） |

- 会話なし 1・会話あり 1 を、学習用・評価用のそれぞれに含めるのが目安（届かなくても延ばさない）。同席者については「同席者あり」以上を書かない。
- 食事は自由（固形物を含む）。献立は書かない。1 食を複数のセッションに分けない。

### 装着と環境

- 位置・側・バンドは M3 のまま（`lateral-below-cricoid`、M3 と同じ側、`sh12jk-strap`）。食事ごとに付け直す。
- 椅子に座り、食卓で食べる。テレビ・音楽は入れない（会話ありの相手の声は入ってよい）。
- UNO Q とアダプタは食卓の上、ケーブルを動かさない位置に置く。`~/.asoundrc`・`/etc/asound.conf` を置かない（0029）。ミキサーは変えない（`Mic Capture` 58、on）。
- **評価用では UNO Q のマトリクスが自分から見えない向きに置く（覆ってよい）。** 表示が見えると `s` の押し方が引きずられるおそれがある（M2 の表示器をつながなかったのと同じ理由）。
  #47 で、これを「RPC なしで動かす（`--no-rpc`。マトリクスは消灯のまま）」と読み替えた（人の決定 10/29。docs/decisions/0037 の追記）。目的は同じで、表示そのものが出ないので、より強い。

### 学習用 `meal` の記録（PC の経路）

1. リポジトリのルートで、端末から直接:
   `.venv/bin/python tools/record.py --throat sh12jk-wired-unoq-usbaudio --position lateral-below-cricoid --band sh12jk-strap --cond meal --duration 1800`
   （30 分は上限。食べ終わったら Ctrl-C。`recording... keys:` を確かめる。「tty が無いので…」と出たら止め、フォルダを消してやり直す）
2. 叩き 5 回（`o` の note `tap`、Enter をマイクのケースで。M3 と同じ）→ 装着 → 落ち着いてから `o start`。
3. 会話ありなら `o start` の後に `o conv`。`o start` の後、最初のマーカーまで 5 秒以上あける。
4. 食べる。マーカーは「M2 の通し記録（`meal`）」の「打つマーカー」のまま（`s`・`c`・`t`・`o`。`b`・`n`・`q` は打たない）。
5. 最後の嚥下から 5 秒以上待って Ctrl-C。

### 評価用 `meal` の記録（装置の経路）

#47 で確定した（docs/decisions/0037 の追記）。0037 の冒頭の人の決定（10/24）「評価用の `meal` の間はマトリクスを自分から見えない向きに置く」は、
**RPC なしで動かす（`--no-rpc`、マトリクスは消灯のまま）**と読み替える（人の決定 10/29）。`led` の列は `--no-rpc` でも装置が 0018 の規則で計算して
`detect.csv` に残す（`meta.json` に `rpc: false`）。LED の表示は嚥下の「目安」で、判定ではない。

1. 前日まで: `cmake --build build-unoq --target deploy-unoq` の後に `record.py` の照合（H 行の `code_sha256`）が通ること。評価用の期間（11/1〜11/4）に配るファイルを変えない
   （変えたら、それより前の評価用 `meal` は M4 の数字に使わない。0037 の 5）。
2. UNO Q とアダプタを食卓に置く。`arecord` を動かしていないこと（`record.py` が起動前に確かめ、動いていれば始めない）。
3. 装着 → リポジトリのルートで端末から直接:
   `.venv/bin/python tools/record.py --unoq-detector --feat --no-rpc --position lateral-below-cricoid --band sh12jk-strap --cond meal --duration 1800`
   （`cond` = `meal` では `--feat` と `--no-rpc` が無いと始まらない。`recording... keys:` と「窓が届き始めた」の表示を確かめる。「tty が無いので…」と出たら止め、
   フォルダを消してやり直す。叩きはしない）。起動の直後に `record.py` が消灯を送り（失敗すれば記録は始まらない）、「マトリクスが消えていることを目で確かめてから
   続ける（Enter）」と出るので、**マトリクスが消えていることを目で確かめてから** Enter を押す（確かめたら、以後はマトリクスを見ない）。
4. 窓が届き始めてから `o start`（会話ありはその後に `o conv`）。`o start` の後、最初のマーカーまで 5 秒以上あける。最初の窓より前のキーは記録されない。
5. 食べる。マーカーは学習用と同じ（`s`・`c`・`t`・`o`）。記録の間に画面の数字を見ない（数字は出ない）。装置が動いていることは、画面に「窓の行が N 秒届いていない」が
   出ないことで分かる（出たら途切れの秒数を控える。陽性は表示されない）。
6. 最後の嚥下から 5 秒以上待って Ctrl-C。
- `record.py` は検出器の標準入力に 0.5 秒ごとにハートビート（改行 1 バイト。音声ではない）を書く。PC の Wi-Fi が切れると、検出器は 2 秒で消灯して止まり
  （`heartbeat-timeout`）、PC 側は `child-exit` で終わる。そのセッションは捨てる（0037 の 5 の 2・3 に当たる見込み）。

### 各セッションの直後にすること（採否は人。数字を見る前に決める）

1. Ctrl-C の直後、ほかの出力を見る前に、`s` の打ち忘れ・打ち遅れの体感を「ほぼ無し / 数回 / 多い」で控える（0023）。
2. 学習用: `.venv/bin/python tools/throat_check.py data/raw/<セッション> --tap-mode enter`。評価用: `.venv/bin/python tools/unoq_session_check.py data/raw/<セッション>`
   （0037 の 5 の捨てる条件（装置）1〜9 を「当たる / 当たらない」と数で出す。`detect.csv`・`feat.csv` は時刻の列だけを読み、陽性・`prob`・`led`・FEAT の値を出さない。
   条件 4（受信の遅れ）は `delay_meas` の最大 > 1000 ms、時計のずれは `anchor_spread_ms` > 250 または `clock_drift_*_ms` の絶対値 > 250 で「当たる」と出す
   （人の決定 10/29、0037 の追記。`delay_upper` は値だけで判定に使わない）。
3. docs/decisions/0037 の 5 の捨てる条件（学習用 / 評価用）に当たるかを、振幅・特徴量・分類器の結果・陽性を見る前に決める。捨てるものはフォルダごと消す。
4. log の集計表を書く（下）。

### 締めと打ち切り

- 学習用の締め（0037）の後に録った `pc-throat` のセッションは M4 に使わない（残して集計表に書く）。
- 評価用の打ち切り（0037）までに録った採用分の全部を評価側にする。届かなくても延ばさない。
- 締め・打ち切りの後、一覧の名前を 0037 と `analysis/fixed_eval.py` に追記する（評価側は #49 が開く前）。

### log に書くこと

`docs/log/<日付>.md` に「#48 学習用 `meal`」「#48 評価用 `meal`」の節を作る。列は M3 の表に、会話の有無・同席者の有無・止まり方・体感 2 つ・
記録時の `s` の決まり（0023）を足したもの。評価用は M3 の音声の列（overrun、推定差、段差、叩き）の代わりに、取りこぼし・逆行・最大の飛び・
受信の遅れ（中央値・最大）・構成の識別子・FEAT の次元（0037 の要約の値。値は書かない）。陽性の数・`prob`・FEAT の値は書かない（#49 の前）。
