owhinata/zaitaku-mealpace/docs/log/2026-11-13.md

# 2026-11-13

## #57 動画と写真（素材がそろった。人の作業と決定）

- 動画（人が作成・アップロード）: https://youtu.be/y1x6TrA4hLw 。リポジトリには置かない（Issue #57 の本文のとおり）。
- アイキャッチ: `docs/img/cover.png`（人が作成、11/9 にコミット。人物は絵、写真は装置だけ）。
- システム構成図: `docs/img/system-diagram.png`（人が作成、11/9 にコミット）。
- **人の決定（11/13）: #57 で用意する素材は上の 3 つですべて。** Issue #57 の本文にある装着写真と、表示の文言（装置に貼る表示・
  介助者に渡すカード）を貼った状態の写真は用意しない。装置の写真はアイキャッチの中の写真で兼ねる。
- 動画の中身（本人（家族）が写っていない・聞こえていない、咽喉マイクの生の音声が入っていない）は、メインは動画を見られないので
  確かめていない。人の確認事項。
- 記事（#56）からの参照: 動画は ProtoPedia の動画の項目、アイキャッチと構成図は作品ページの画像とシステム構成の項目に人が入れる
  （ストーリー本文 `docs/protopedia/story.1.md` には置かない。11/5 の人の決定で「開発とデモについて」の節は無い）。
- 追記（11/13）: 動画の中身は人が確かめ、問題なし。人が #57 を close した。
