owhinata/zaitaku-mealpace/docs/decisions/0037-m4-split-and-recording-plan.md

# 0037 M4（検出器・咽喉マイク版）の学習・評価の分割と、学習用・評価用の `meal` の記録の計画

日付: 2026-10-24　状態: 採用（人が 10/24 に決定。下の「人の決定（10/24）」）

Issue #46（plan #46、Codex の plan レビューを通した plan による）。M4 の数字（#49、#50 の判定）を出すための分割と記録の規則を、
**M4 の記録（学習用 `meal`・評価用 `meal`）を 1 本も録る前**、つまり M4 のどの性能の数字も見る前に固定する。
`docs/evaluation.md` の定義と合格線は変えない。0011 の数え方、0014 のうち評価側の日数以外、0023 の `s` の押し方と捨てる条件の趣旨、
0031 の記録の範囲（`o start` から後）は変えない。

人の決定（10/24）: 日程（学習用 `meal` 10/25〜10/28・締め 10/28、評価用 `meal` 11/1〜11/4・打ち切り 11/4、#49 は 11/5、#50 は 11/7 まで。
10/13 の「学習用 10/18〜10/22、評価用 10/30〜11/2」を改める。学習用が 1 本も録られていなかったため）、評価側の収集日は 2 日以上、
M3 の検査は残して M4 の検査を別に足す、FEAT は窓ごとの要約の値だけ、`record.py --throat` の `meal` 対応をこの記録の範囲に入れる、
評価用の `meal` の間はマトリクスを自分から見えない向きに置く。

## 前提

- M4 の合格線は M2 と同じ（検出率 85% 以上、誤検出 1 回/分以下。`docs/plan.md`、0024・0027）。測るのは `self` の `meal` の通し記録。
- M3 の分割（0032・0034）は M3 の判定（0036）のためのもので、M3 の数字はすでに出ている（0034 の印 `docs/log/m3-final-40.txt`）。
- 被験者は `self` だけ（`docs/evaluation.md`「M1・M2 の数字は `self` のみ」を M4 にも当てる。`p1` は M4 に入れない。0024・D11）。

## 決定

### 1. 評価側

- 評価側は、**装置（#47 の `detector.py`）で録った `self` の `meal` の通し記録**。
- 評価側の収集日の窓: `M4_EVAL_FROM` = 2026-11-01 〜 `M4_EVAL_TO` = 2026-11-04。フォルダ名の日付（先頭 8 桁）で決める。
- 評価側 = 窓の中で録り、下の 5 の捨てる条件に当たらなかった装置の `meal` の**全部**。後から選んで外さない（0023 と同じ）。
- 本数と日数: **3 セッション以上**（`docs/evaluation.md`）。収集日は **2 日以上**（窓の中の採用分の全部。ちょうど 2 日に限らない）。
  目安は M2 と同じ: 合計 `s` 50 以上、会話なし 1・会話あり 1（0023 の「届かなくても延ばさない」の扱い。届かない条件は「未達」として #49・#50 に渡す）。
- **0014・0032 との関係**: 0014 は「最後の 2 収集日」、0032 は咽喉マイク（M3）で「最後の 1 収集日」に変えた。M4 では評価側と学習側でセッションの種類
  （装置 / PC の記録）が違い、「名前順で後ろから」の規則では分けられないので、**日付の境 `M4_EVAL_FROM` で分ける**。日数は 2 日以上
  （0014 の側。`docs/evaluation.md`「収集日が異なることが望ましい」を評価側の中でも満たす）。打ち切りまでに 1 日しか録れなかったときは、3 セッション以上なら
  合算を出し、「評価側 1 収集日（0037 の 2 日に届かない）」と注記する（0032 と同じ注記。日数は合算を止める条件にしない）。
- 評価側の装置の `detect.csv`・`feat.csv`（FEAT）は、名前と時刻の列（`t_ms`・`window_t_ms`、採否の確かめ）以外を #49 の 1 回の採点まで開かない
  （`positive`・`prob`・`led`・FEAT の値を見ない。0023「採用前に数字は見ない」と 0014「評価側の保護」）。

### 2. 学習側

- 学習側 = 次の全部（`fw` が `pc-throat`、iface `sh12jk-wired-unoq-usbaudio`、日付が `M4_EVAL_FROM` より前）:
  - M3 の 21 本（0034 の `FINAL-TRAIN` 14 本と `FINAL-EVAL` 7 本。**M3 の評価側だった 7 本は M4 では学習側**）。
  - 学習用の `meal` **3 本**（人の決定 10/13。日程は 2026-10-25〜10-28、人の決定 10/24）。PC の記録の経路（`tools/record.py --throat`、0028）で録る。
  - 追加の条件別セッション（10/11 の 7 本の形）: **録らない**（日程。人の決定 10/24）。
- M3 の評価側 7 本を学習に使うこと: M3 の評価側の数字は 0034 の 1 回で出し、M3 は判定済み（0036）。M4 の評価側は新しく録る `meal` で、
  7 本とは日付も種類も違う。7 本を M4 の学習・学習側 CV・構成の選択（#45）に使っても、M4 の評価側が学習に混ざることにはならない。
  ただし M3 の数字（0034）を出し直したり、M3 の構成を選び直したりすることには使わない（M3 の経路の検査 `assert_fixed_eval_not_in` は残す）。
- 学習側の一覧は、学習用の記録の締め（2026-10-28 の終わり）の後、#45 が構成を 0038 に固定する前に、名前で固定する（下の「機械が読む行」）。
  締めの後に録った `pc-throat` のセッションは M4 の学習に使わない（`data/raw/` に残し、集計表に「締めの後。M4 に使わない」と書く）。
- 学習のラベルは 0014 のまま（`s` の `[t, t + 1.0]` が陽性、境目は使わない、ほかは陰性）。`meal` では押せなかった嚥下が陰性に入る（下の「確かめていないこと」）。

### 3. 収集日の規則

- 学習側のどの日も、評価側のどの日より前（日付で `M4_EVAL_FROM` より前）。学習側の締め（10/28）と `M4_EVAL_FROM`（11/01）の間は空けてよい。
- `M4_EVAL_FROM` 以降に `pc-throat` のセッション（PC の経路の記録）を録らない。録ってしまったものは M4 に使わない（`data/raw/` に残す）。
- 装置の `meal` を `M4_EVAL_FROM` より前に録らない（#47 の動作確認は `water` など `meal` 以外で行う。`meal` の名前で録ったものは評価に使わない）。
- 収集日はフォルダ名の日付で数える（0014・0031。同じ日の複数の食事は 1 収集日）。

### 4. 評価用の `meal` は検出器だけで録る（D8 の (b)）

- 評価用の `meal` は装置（`tools/record.py --unoq-detector`、#47）だけで録る。生の音声は UNO Q にも PC にも残らない（CLAUDE.md「データの扱い」、0025・0035）。
- 0028 決定 3（記録の経路と検出器を同時に動かさない）はそのまま。学習用 `meal` の記録の間は `detector.py` を動かさない。評価用 `meal` の間は `arecord` を動かさない。
- 装置の出力と PC の再計算の一致は、評価側ではなく、**学習用 `meal` の `throat.wav` を `detector.py` の再生モード（#47。ファイルは読むが書かない）に流して**確かめる。
- **評価用の `meal` では FEAT を有効にする。** D7 の既定（窓ごとの結果だけ）の例外。
  - 根拠: 0005 の範囲内（特徴量に変換した後の値で、生の音声波形ではない）。M2 で #20 の FEAT を足した理由と同じく、届かなかった場合の原因の切り分け
    （咀嚼か会話か、嚥下の直後の延びか）に使う。`self` だけ。
  - **FEAT は窓ごとの要約の値だけ。CNN の入力（`mfe40` の 98 フレーム × 40 本の対数メル）をそのまま送らない。** フレーム単位（10 ms ごと）の
    時間周波数の行列は、食卓の会話（同席者の声を含む）の音に近いものを PC 側で組み立て直せるおそれがあるため。
  - 要約の値の方針（名前と次元の確定、`meta.json` の `feature_names` は #47）:
    - 1 窓（1.0 秒）に 1 行、0.25 秒ごと（DETECT と同じ窓）。値は窓の中の 98 フレームを時間方向に畳んだ統計量だけで、フレームごとの値を含めない。
    - 中身: `mfe40` と同じ前処理（16 kHz、0〜4000 Hz、メル 40 本の対数）の帯域ごとの窓内の平均 40（`mel_mean_00`〜`mel_mean_39`）と
      標準偏差 40（`mel_std_00`〜`mel_std_39`）、窓の対数エネルギーの平均と最大 2（`log_energy_mean`・`log_energy_max`）。計 82 次元。
    - 上限: 1 窓あたり 100 次元以下。窓より細かい時間の分解能を持つ値（フレームごとの値、デルタの系列、窓の一部だけの統計量）を入れない。
      フレームの系列を出さず、窓ごとに畳んで情報量を減らす。ただし FEAT から音を組み立て直せるか・内容（話の中身など）を推定できるかは
      確かめていない（下の「確かめていないこと」）。
    - 正規化の前の値（0021 の FEAT と同じ）。CNN の重み・中間層の出力は入れない。
  - FEAT は `data/raw/` の外に出さない・コミットしない（0021 と同じ。生の計測データとして扱う）。#49 の 1 回の採点の後に、原因の切り分けにだけ使う。
    FEAT を見た後に構成・閾値・後処理を変えない。

### 5. `s` の押し方、捨てる条件、打ち切り

- `s` の押し方は 0023 のまま（食べ物・飲み物を意識して飲み込んだときに押す。打ち忘れ・打ち遅れでは捨てない。体感の 3 段を集計表に書く）。学習用・評価用とも同じ。
- 区切り: 学習用・評価用とも `o start` から後が記録の範囲（0031）。会話ありは `o start` の後、食べ始める前に `o conv`（0023 と同じ綴り）。
- **捨てる条件（学習用 `meal`、PC の経路）**: `docs/recording-protocol.md`「咽喉マイク（M3）」の 1〜7・9・10 を当てる。ただし 5（止まり方）は
  `throat.stop` が `interrupt`（食べ終わって Ctrl-C）か `duration`（30 分の自動終了）なら使う（`stall`・`child-exit`・`error` は捨てる）。
  8（M1 の「捨てる」）は当てず、0023 の 6（終わりの 1.5 秒以内の `s`）・8（`conv` の綴り）・9（`s` に関わる `wrong key`）に置き換える。
  「他の人の声が入った」は捨てる理由にしない（会話ありは相手の声が入る）。
- **捨てる条件（評価用 `meal`、装置）**: 0023 の 1〜9 を装置の形に読み替える。
  1. 窓の取りこぼし（`window_t_ms` の飛び）が 1% 以上。
  2. （0023 の XOR の読み替え）`detector.py` の出力の行で読めないもの・形式の違うものが 1 行以上。
  3. `window_t_ms`・`t_ms` の逆行、隣との差が 1000 ms 超。
  4. 窓の終端から PC の受信までの遅れの最大が 1000 ms 超（0021 の上限。#47 が受信時刻を残す）。
  5. `o start` が無い・2 つ以上・最初の窓より前、`o start` より前に `s`・`t`・`c` がある。
  6. 終わりの 1.5 秒以内に `s` がある（30 分の自動終了を含む）。
  7. `meta.json` の `fw` が #47 で決める装置の値でない、構成（0038 の識別子）が 0038 と違う、FEAT が無効。
  8. 会話ありの `conv` の綴り違い。
  9. `s` に関わる `wrong key`。
  - 採否は `positive`・`prob`・`led`・FEAT の値を見ずに、人が記録の直後に決める（0023）。採否を確かめる道具は時刻の列だけを読む（#47・#48）。
- **打ち切り**: `M4_EVAL_TO` = 2026-11-04 の終わり（フォルダ名の日付が `20261104` 以前）。それより後に延ばさない。届かなくても延ばさない。
  - 3 セッション以上なら合算（M4 の数字）を出す。3 セッション未満なら合算と合格線との比較を出さず、セッションごとの数字を「M4 の合算は未達で出せない」と明記して出す（0023 と同じ）。
  - 打ち切りの後に録った `meal` は `data/raw/` に残して M4 に使わない。
  - 途中で装置の構成（0038）やプログラムを書き換えたら、それより前の評価用 `meal` は M4 の数字に使わない（0023 の「書き換え前」と同じ）。

### 6. M2・M3 との並べ方（#49 の表）

| | M2（0027） | M3（0034・0036） | M4（この記録） |
|---|---|---|---|
| センサ・基板 | 基板の IMU＋PDM、Nano RP2040 | 咽喉マイク、PC で採点 | 咽喉マイク、UNO Q の上で推論 |
| 評価側 | `meal` 3 本・3 収集日 | 条件別 7 本・1 収集日 | `meal` 3 本以上・2 収集日以上 |
| `s` の決まり | 0023 | M1 の決まり（すべての嚥下） | 0023 |
| 合格線 | 85% / 1 回/分 | 70% / 3 回/分（分岐点） | 85% / 1 回/分 |

- M4 と同じ条件（`meal`・0023・同じ合格線）で比べられるのは M2。M3 は条件別のセッションで `s` の決まりも違うので、M4 の数字と同じ表に並べるときはそう注記する。
- 手法の違い（`docs/evaluation.md` 29 行目の M2 の行「Edge Impulse（int8、Nano 上で推論）」からの逸脱。28 行目は M1 の行。2026-10-24 に行番号を直した）は 0034 と同じく記録した逸脱として 0038 に書く（#45）。
- 合格線との比較は「満たす / 満たさない」と書く。「85% 達成」のような書き方はしない。報告には混同行列と評価に使ったセッションの一覧を添える（CLAUDE.md）。

### 7. 一覧の固定と「1 回だけ」

- 学習側・評価側の一覧は名前で固定し、`analysis/fixed_eval.py` の定数と、この記録の `M4-` で始まる行を一致させる（0034 の `FINAL-` と同じ仕組み）。
  - 学習側: 学習用の記録の締めの後、#45 が 0038 を固定する前に追記する（この記録の追記として。日付と、追記の時点で M4 のどの性能の数字も見ていないことを書く）。
  - 評価側: 評価用の記録の打ち切りと採否の後、#49 が評価側を開く前に追記する（名前だけ。`self` のフォルダ名なので公開してよい）。
- 評価側の採点は 1 回だけ。印のファイルは `docs/log/m4-final-49.txt`（固定のパス）。#49 の入口が排他作成し、印があれば止まる（0034 3b と同じ）。
- 追記の前（一覧が空）の間は、M4 の学習の経路（#45）は「日付が `M4_EVAL_FROM` より前の `pc-throat`」だけを読み、評価側の入口（#49）は止まる。

```
M4-EVAL-WINDOW: from=2026-10-29 to=2026-11-01
M4-TRAIN-CUTOFF: 2026-10-28
M4-TRAIN: 20261011-100847_self_quiet 20261011-101644_self_water 20261011-102354_self_talk 20261011-102854_self_saliva 20261011-103352_self_neck 20261011-103912_self_water 20261011-104408_self_cough 20261011-202238_self_quiet 20261011-202730_self_water 20261011-203152_self_talk 20261011-203631_self_saliva 20261011-204057_self_neck 20261011-204526_self_water 20261011-204956_self_cough 20261012-191826_self_quiet 20261012-192531_self_water 20261012-193001_self_talk 20261012-193459_self_saliva 20261012-193929_self_neck 20261012-194417_self_water 20261012-194854_self_cough 20261025-200807_self_meal 20261026-190244_self_meal 20261027-144545_self_meal 20261027-203815_self_meal 20261028-193716_self_meal
M4-EVAL: 20261030-201124_self_meal 20261031-145803_self_meal 20261031-195410_self_meal 20261101-134412_self_meal
```

## #47・#49 への申し送り（この記録ではコードを変えない）

- #47: 装置のセッション（`detect.csv` があり `fw` が `detector` でない）が `data/raw/` に入っても、`split.py`（M1・M3 の経路）が止まらないようにする
  （今は「検出器のファイルがあるのに fw が detector ではない」で止まる）。装置の `fw` の値、FEAT の次元と名前、受信時刻の列は #47 で `docs/data-schema.md` に書く。
- #49: 評価側の入口は、評価側のファイルを開く前に印 `docs/log/m4-final-49.txt` を排他作成し、その後の手順で止まっても印を消さない（0034:32 の 3b と同じ）。
- #49: `evaluate_detector.py` の `scan_root` は、`self` の `meal` で `fw` が `detector` でないもの（学習用 `meal`）があると止まる。M4 の入口は
  `M4-EVAL` の一覧で対象を決め、M2 の `meal`（`fw` = `detector`、10/2〜10/4）を拾わないようにする。

## 理由

- 学習に `meal` を入れる: M2 は条件別だけで学習して `meal` で 0.150 だった（0027）。食事の咀嚼・会話・食器の音は条件別の 7 本に無い。
- 学習用 `meal` 3 本: 2 本では条件別 21 本に対する比率が小さい（人の決定 10/13）。
- 日付の境で分ける: 評価側と学習側でセッションの種類が違い、「名前順で後ろから」では分けられない。日付の境は記録の前に決められ、性能の数字に依らない。
- 評価用を装置だけで録る: 評価の数字は装置の出力で出す（`docs/plan.md`「装置上の推論」）。検出器に音声の出口を作らない（CLAUDE.md、D8）。
- 打ち切りを日付で決める: M4 の締め（11/7）は動かない。陽性を見る前に日付だけで決める（0023 と同じ）。

## 選ばなかった案

- 評価側を `split.py` の「後ろから N 本」で決める: 装置のセッションと PC のセッションを同じ並びに入れることになり、M1・M3 の経路の検査と衝突する。
- 評価用 `meal` で生の音声も録る（(a) ALSA の分岐）: 0029 の「ALSA のユーザー設定が無いこと」と衝突し、検出器の取り込み口を 2 つにする（人の決定 10/13 で (b)）。
- M3 の評価側 7 本を M4 でも学習に使わない: 条件別の学習データが 14 本に減る。M3 は判定済みで、M4 の評価側とは別の日・別の種類。
- FEAT を出さない（D7 の既定のまま）: 届かなかったときの切り分けの材料が無くなる（人の決定 10/13）。
- 評価側をちょうど 2 収集日に限る（0014 の文字どおり）: 窓の中で 3 日目に録った採用分を外すことになり、セッションを選んだ形になる。
- 評価側を 1 収集日以上にする（0032 と同じ）: 評価側の中で収集日が分かれず、M2（3 収集日）と並べにくい。
- 日程を 10/30〜11/2 のままにする: 学習用の締めから #45 の 0038 と #47 の配置まで 1 日しかない。学習用 `meal` を 2 本に減らす: 10/13 の「2 本では比率が小さい」に反する。
- M3 の検査（`assert_fixed_eval_not_in`）を外す: M3 の数字を M4 のデータで出し直す経路が開く。
- FEAT に `mfe40` の 98 × 40 をそのまま入れる（PC で評価側の確率を計算し直せる）: 会話の音に近いものを組み立て直せるおそれがある。
  装置と PC の一致は学習用 `meal` の再生モードで確かめる。

## 確かめていないこと

- `meal` の `s` は押せた嚥下だけ（0023）。学習用 `meal` で押せなかった嚥下は陰性として学習に入る。#45 の hard negative（学習側 CV で誤検出になった区間の
  重み付け）は、押せなかった本物の嚥下を重く陰性と教えるおそれがある。向きと大きさは確かめていない（#45 で扱う）。
- 学習用 `meal`（PC の経路、`arecord`）と評価用 `meal`（装置、ALSA から `detector.py`）で、入力の利得・間引きが同じ値を出すか。再生モード（#47）は
  同じファイルからの計算の一致を見るだけで、取り込み口の違いは見ない。
- 学習側の日（10/11・10/12・学習用 `meal` の日）と評価側の日の差（装着・体調）の影響。
- 評価用の FEAT（窓ごとの要約の値、0.25 秒ごと、窓は 0.75 秒ずつ重なる）から、音を組み立て直せるか、会話の内容を推定できるか。
  フレームの系列を出さないことで情報量は減るが、組み立て直せないことは確かめていない。

## 影響する場所

`analysis/fixed_eval.py`・`analysis/test_fixed_eval.py`（新規）、`tools/record.py`・`tools/test_record_throat.py`、`docs/recording-protocol.md`、
`analysis/README.md`、`docs/status.md`。

## 変えていないこと

`docs/evaluation.md`（窓、数え方、非嚥下区間、セッション単位の分割、3 セッション以上、合格線）、0011、0014 の評価側の日数以外、0023 の本文、
0031・0032・0034 の本文（M3 の一覧と検査 `assert_fixed_eval_not_in` を含む）、`split.py`・`evaluate.py`・`train_eval.py`・`compare.py`・`visualize.py`・
`final_eval.py`・`evaluate_detector.py`・`throat_check.py`、`docs/data-schema.md`。

## 追記（2026-10-28）: 学習側の一覧の固定

- 2026-10-28（学習用 `meal` の締めの日）の夜に、人の指示でメインが `M4-TRAIN` の行と `analysis/fixed_eval.py` の `M4_EXPECTED_TRAIN` に同じ 26 本の名前を入れた
  （7 節。M3 の 21 本 `M4_TRAIN_M3` と、学習用 `meal` 5 本: 2026-10-25、10-26、10-27 ×2、10-28。採否は人が記録の直後に決めた。docs/log/2026-10-25.md〜2026-10-28.md）。
- 追記の時点で M4 のどの性能の数字も見ていない（#45 のステップ 1 の予行は検出率・誤検出率・確率を出さない。plan #45 の 11 節）。
- 学習用 `meal` は 3 本の予定だったが、締めまでに採用した 5 本（収集日 4 日）をすべて学習側に入れる（2 節「締めの後に録ったもの以外は学習側」のとおり。本数の上限は決めていない）。
  これより後に録った `pc-throat` のセッションは M4 に使わない（2 節）。
- `M4-TRAIN-CUTOFF`・`M4-EVAL-WINDOW`・`M4-EVAL` の行は変えていない。

## 追記（2026-10-29、Issue #47）: #47 で確定した事項

上の決定の本文は変えない。`docs/data-schema.md` に装置のセッション（`fw` = `unoq-detector`）の節を足した記録を兼ねる（既存のファイル・列・単位・フレーム形式は
変えていないので、記録済みのセッションの変換は要らない）。

- **装置の `fw`**: `unoq-detector`（M2 の `detector` と `positive` の意味が違う: 0038 の後処理の出力）。`split.py` は `detector` と同じ扱い（M1 の分割に入れない。
  `--kind throat` では `excluded`）、`m4_compare.list_train` も同じ集合で見る（#47 への申し送り）。`evaluate_detector.py` は変えていない（`fw` = `detector` だけを拾う）。
- **FEAT の 82 次元**（4 の方針の確定。`feature_set` = `m4-0037-feat82`）: `mel_mean_00`〜`mel_mean_39`、`mel_std_00`〜`mel_std_39`（`mfe40` の時間方向の平均・標準偏差）、
  `log_energy_mean`・`log_energy_max`。式は `docs/data-schema.md`。`--feat` のときだけ出す。
- **評価用 `meal` の起動**: 冒頭の人の決定（10/24）「評価用の `meal` の間はマトリクスを自分から見えない向きに置く」は、**RPC なしで動かす（`--no-rpc`、マトリクスは
  消灯のまま）**と読み替える（人の決定 10/29）。目的（表示が `s` の押し方に影響しないこと）は同じで、表示そのものが出ないので、より強い。`led` の列は `--no-rpc` でも
  装置が 0018 の規則で計算して `detect.csv` に残す。`meta.json` に `rpc: false`。`cond` = `meal` では `record.py` は `--feat` と `--no-rpc` が無いと始めない。起動の前に
  消灯を送り、人がマトリクスの消灯を目で確かめて Enter で始める。手順は `docs/recording-protocol.md`「評価用 `meal` の記録（装置の経路）」。
- **ハートビート**（人の決定 10/29）: `record.py` が検出器の標準入力に 0.5 秒ごとに 1 バイトを書き、検出器は 2.0 秒届かなければ消灯して止まる（UNO Q の sshd が切断に
  気づかないため）。そのセッションは `child-exit` で終わる。
- **採否を確かめる道具**: `tools/unoq_session_check.py`。5 の捨てる条件（装置）1〜9 を「当たる / 当たらない」と数で出す。`detect.csv`・`feat.csv` は最初の 2 列
  （`t_ms`・`window_t_ms`）だけを読み、`positive`・`prob`・`led`・FEAT の値と集計を出さない。
- **受信の遅れ（条件 4 の材料）**: 受信時刻は `detect_rx.csv`（`window_t_ms, rx_ms, proc_us, lat_us, queue, backlog`。`prob`・`positive`・`led` を含めない）。
  2 つの時計は合わせていない。`offset` = 全 D 行の `(rx_ms − t_ms)` の最小（下側の包絡）として
  `delay_meas = (rx_ms − offset) − (window_t_ms + 1000)`（下側の値）、`delay_upper = delay_meas + rtt_max_ms`（記録の前後に同じ宛先へ ssh で測った往復時間の最大を、
  片方向の遅れの推定の上限とする）。装置の時計では `e2e_ms = t_ms − (window_t_ms + 1000)`。
  10/29 の動作確認（`water`、M4 には使わない）: 30 分で `delay_meas` 中央値 232・最大 494 ms、`delay_upper` 中央値 1103.6・最大 1365.6 ms（往復時間の最大 871.6 ms）、
  `e2e_ms` 中央値 213・最大 236 ms。180 秒で `delay_upper` 最大 1142.8 ms（往復時間の最大 776.8 ms）。
- **時計のずれの診断値**: `anchor_spread_ms`（最初の 1.0 秒の到着の揺れ）、`clock_drift_min_ms`・`clock_drift_max_ms`（到着の揺れと標本の時計のずれの合計）。
  ALSA・USB・arecord の中の固定の遅れは測れない（見込みは 1 ピリオド 125 ms 程度まで。推測）。10/29 の 30 分: `anchor_spread_ms` 0.089、`clock_drift_max_ms` 26.6（約 15 ppm）。
- **人が追記する欄**（評価用 `meal` の前。`tools/unoq_session_check.py` の `RX_DELAY_RULE`・`CLOCK_RULE` に同じ値を入れる）:
  - 条件 4 の当て方（人の決定 10/29）: **`delay_meas` の最大が 1000 ms を超えたら当たる**。`delay_upper` は使わない（往復時間は記録の前後に別の接続で測った値で、
    外れ値を含み、記録中の遅れではないため）。`delay_meas` は片方向の最小の遅れ（測れない）の分だけ小さく出る（注記）。
  - 時計のずれの許す幅と、測れない固定の遅れの扱い（人の決定 10/29）: **`anchor_spread_ms` ≤ 250、`clock_drift_min_ms`・`clock_drift_max_ms` の絶対値 ≤ 250**
    （評価の窓 [t − 0.5, t + 1.5] に対して 1 ホップ分）。超えたら当たる。ALSA・USB・arecord の中の測れない固定の遅れ（125 ms 程度までの推測）は補正しない
    （0029 と同じ扱い。窓の時刻が実際より少し遅い側に刻まれるだけで、窓の幅の内。#49 の報告に注記する）。
  - 10/29 の実測（30 分の `water`）に当てると: `delay_meas` の最大 494 ms → 当たらない、`anchor_spread_ms` 0.089・`clock_drift_max_ms` 26.6 → 当たらない。
  - 叩き: 評価用 `meal` ではしないまま（4 の表のとおり。人が 10/29 に再確認。PC に音が無く叩きを探せないため。FEAT の `log_energy_max` で粗く確かめる案は採らない）。

## 追記（人の決定 2026-10-29）: 評価側の窓を同じ日数で前倒しする

- #47 が 10/29 に終わり（実装・配置・動作確認・文書、コミット f8e9ff3・1e849bb）、評価用 `meal` を 10/29 から録れる状態になった。評価用の記録が **1 本も無い時点**で、
  人が次のように決めた（事前登録の変更。評価側の数字は何も見ていない）。
- **窓**: `M4_EVAL_FROM` = **2026-10-29** 〜 `M4_EVAL_TO` = **2026-11-01**（当初の 11/1〜11/4 と同じ 4 日を、そのまま 3 日前倒し）。上の「機械が読む行」の `M4-EVAL-WINDOW` と
  `fixed_eval.M4_EVAL_FROM`・`M4_EVAL_TO` を同じコミットで直した。本文の「2026-11-01〜11-04」「11/1〜11/4」の記述はこの追記で読み替える（本文は書き換えない）。
  学習側の締め（10/28 の終わり）より後なので、3 の「学習側のどの日も評価側のどの日より前」は守られる。締めの翌日が窓の初日になるため、「締めより後で窓より前」の名前は無くなる。
- **打ち切り**: 11/1 の終わり（フォルダ名の日付が `20261101` 以前）。延ばさない。それまでに録った採用分を**すべて**評価側にする（5 のとおり。本数で早く止める規則は置かない。
  一度その案を検討したが、日付だけで決める形（0023）を保つため採らなかった）。3 本以上・2 収集日以上に届かなければ、5 のとおり合算を出さずセッションごとの数字を出す。
- 理由: 日程（#49・#50・応募 11/24）に 3 日の余裕を作る。日数は同じなので、評価側の本数の見込みは変わらない。
- 叩きは評価用ではしないまま（10/29 に再確認済み）。採否の道具・条件 4・時計の許す幅は上の追記のとおり。

## 追記（2026-11-01）: 評価側の一覧の固定

- 2026-11-01（評価側の打ち切りの日）に、人の「計測はこれで終わりにします」を受けて、メインが `M4-EVAL` の行と `analysis/fixed_eval.py` の `M4_EXPECTED_EVAL` に同じ 4 本の名前を入れた
  （7 節。`20261030-201124_self_meal`（会話あり）、`20261031-145803_self_meal`（会話あり）、`20261031-195410_self_meal`（会話なし）、`20261101-134412_self_meal`（会話なし）。
  収集日 3 日、`s` の合計 208。採否は人が記録の直後に決めた。docs/log/2026-10-30.md、2026-10-31.md、2026-11-01.md）。
- 追記の時点で M4 のどの性能の数字も見ていない（4 本とも `detect.csv`・`feat.csv` は時刻の列だけを読み、陽性・`prob`・`led`・FEAT の値は誰も出していない。
  `tools/unoq_session_check.py` も時刻の列だけを読む）。
- 評価用 `meal` は 3 本以上の予定で、打ち切りまでに採用した 4 本（収集日 3 日、会話あり 2・会話なし 1 以上の目安を満たす）をすべて評価側に入れる
  （5 と追記 10/29「それまでに録った採用分をすべて評価側にする。本数で早く止める規則は置かない」のとおり）。捨てた記録は無い。
- 4 本とも H 行の `code_sha256` は `7b98bde5…`（10/29 夜の配布）、構成は 0038、`model.sha256` は `c786086f…` で同じ。評価の期間中に配るファイルを変えていない（5 の「書き換え前」に当たるものは無い）。
- `M4-EVAL-WINDOW`・`M4-TRAIN-CUTOFF`・`M4-TRAIN` の行は変えていない。

## 追記（2026-11-03、Issue #53）: ハートビートと単独モード

上の決定の本文と前の追記は変えない。

- 追記（10/29）のハートビートは `record.py` から起動したときのもので、変えない。
- 単独モード（docs/decisions/0050）はハートビートを持たない（受け手の PC が無い）。止まったときの消灯は docs/decisions/0049 の MCU の約 2 秒が受け持つ。
- 単独モードの窓は記録・評価に使わない（行を出さないので数字が出ない）。`code_sha256` の変化（`detector.py`）は、5 の期間（11/1 に終わった）の後なので M4 の数字に影響しない。
