owhinata/zaitaku-mealpace/docs/decisions/0047-hop-stays-0-25s-in-m5.md

# 0047 M5 では 1 ホップを 0.25 秒のままにする（#54。0.1 秒は M6 以降の条件つき）

日付: 2026-11-03　状態: 採用（人の決定 2026-11-01。Issue #54 の (a)）

## 前提

- 人の意向（10/11、docs/log/2026-10-11.md「M4 の 1 ホップの長さ」）: UNO Q で 1 窓あたりの処理が収まれば、1 ホップを 0.25 秒から 0.1 秒ほどに縮めたい。
  M4 起票の D5。0040 決定 4 は LiteRT CPU を M5 に送り、その検討の入口の 1 つにホップ 0.1 秒を挙げた。0042「M5 の前に決めるか」で人に渡された。
- 今のホップは 0.25 秒（`docs/evaluation.md`「窓長 1.0 秒、ホップ 0.25 秒」）。ホップは評価の定義に入る（`docs/evaluation.md`・0011・0012: 1 秒あたりの窓の数、
  連続する陽性の窓の塊の数え方、嚥下から最初の陽性までの遅れ。0012 の窓 k は `[t_lo + 0.25 k, t_lo + 0.25 k + 1.0)`）。
- 実測（0040 の追記 2026-10-29、docs/log/2026-10-29.md「#47」。0038 の構成・0040 の経路、RPC あり、`--feat`）: 1 ホップ全体の `proc_ms` は
  - 30 分の `water`（7201 窓）で中央値 79.8・95 パーセンタイル 81.4・最大 86.1 ms。
  - 180 秒の `water`（721 窓）で中央値 79.9・最大 106.2 ms。**0.1 秒（100 ms）を超える窓がある。**
  - 参考: RPC なしのライブで中央値 64.4 ms、再生モード（RPC なし）で中央値 35.8・最大 44.8 ms。どの回も 0040 決定 6 の見直しの目安（中央値 125 ms 超・最大 250 ms 超）に当たらない。
- M4 の評価側の数字（0042）は 0.25 秒で採点した: 検出率 0.957（199/208）、誤検出率 1.25 回/分（70 回 / 56.00 分）、混同行列 TP 199 / FN 9 / FP 70、評価側 4 本（0037 の `M4-EVAL`）。
  M2（0027）の 0.150 / 2.03 回/分も 0.25 秒。

## 決定

1. **M5 では 1 ホップを 0.25 秒のままにする。** 装置（`device/unoq/` の検出器）、PC 側の採点、`docs/evaluation.md` の定義は変えない。
2. **公開する数字（記事 #56、README、動画の説明）は 0.25 秒のもの。** 検出率・誤検出率は 0042 の数字（混同行列と評価に使ったセッション一覧を添える。CLAUDE.md「評価」）、
   処理時間は上の「前提」の実測をそのまま書く。「0.1 秒に収まる」とは書かない。
3. **0.1 秒にするのは M6 以降で、次の条件を全部そろえてから。** そろえる前に装置や採点のホップを変えない。
   1. **新しい評価側の記録と 1 回だけの採点。** 0.1 秒で M4 の評価側 4 本を採点し直さない（0041 決定 6: 印の後に構成・後処理・記録の範囲の定義を変えない。0038「事前登録と、後から選ばないこと」）。
      新しい評価側を録る前に、構成（0.1 秒での後処理の値を含む）と採点の手順を別の decision で固定する。
   2. **`docs/evaluation.md` の定義の変更は人が直す。** 変える案（ホップ、窓の数え方、塊の数え方、遅れの定義への影響）を docs/decisions に記録し、Codex の plan レビューを通してから
      人が `docs/evaluation.md` を直す（CLAUDE.md「評価」、docs/workflow.md「レビュー（Codex）」）。0011・0012 の該当箇所の読み替えも同じ記録に書く。
   3. **装置の処理が 0.1 秒に収まること。** 今の経路（0040: numpy の im2col ＋ OpenBLAS 1 スレッド）では最大 106.2 ms の回がある。LiteRT CPU の採否（0040 決定 4）を、
      0025「装置と PC で同じ Python のコード」・0039 との関係を含めて別の decision で決め、0.1 秒で 1 ホップ全体の中央値・95 パーセンタイル・最大を測り直す。
   4. **MCU の表示の更新間隔。** 0.1 秒にすると Linux 側から MCU への RPC が 1 秒に 10 回になる（0.25 秒では 4 回）。MCU の表示の更新と、#52 の自律消灯（最後の更新から 2 秒）
      との関係を確かめる。
   5. **M2・M4 との並べ方。** 0.25 秒の M2（0027）・M4（0042）の数字と 0.1 秒の数字は同じ定義で並ばない。並べるなら、ホップが違うことを表に書くか、同じ記録を 0.25 秒でも
      採点する手順を事前に決める（どちらにするかはそのときの decision で決める）。
4. **`docs/status.md`「保留中の判断」の 1 ホップの項目はこの記録で閉じる。** 0.1 秒の検討を再開するときは、上の 3 の条件を持った新しい Issue にする（M6 以降）。

## 理由

- **応募（11/24）までに、新しい評価側の記録と 1 回だけの採点をする時間が無い。** 0.1 秒にすると評価の定義が変わり、M4 の評価側 4 本は使えない（0041 決定 6）。
  評価側の `meal` を録り直し（0037 では 3 本以上・収集日 2 日以上）、構成を固定してから 1 回だけ採点することになる。M5 は 11/2〜11/17、記事の一般公開は 11/10（`docs/plan.md`）。
- **「0.1 秒に収まる」と書けない。** 30 分の記録の最大は 86.1 ms だが、180 秒の記録に最大 106.2 ms がある（前提）。今の経路のまま 0.1 秒にすると、1 ホップの処理が次のホップに掛かる窓が出うる。
- **ホップは評価の定義に入るので、変えると M2・M4 の数字と並ばなくなる。** 公開の材料の柱は M2（0.150 / 2.03 回/分）と M4（0.957 / 1.25 回/分）の比較（0042「M5（公開）に渡すもの」、
  `docs/plan.md`「基板のセンサと咽喉マイクで何が変わったか（比較が 1 つ）」）で、どちらも 0.25 秒。
- 0.25 秒では処理に余裕がある（最大 106.2 ms で 250 ms の半分以下、0040 決定 6 の目安に当たらない）。0.25 秒のままにして困ることは、表示の反応が 0.25 秒刻みになることのほかに見つかっていない。

## 選ばなかった案

- **(b) M5 で 0.1 秒に変える**: `docs/evaluation.md` の変更（人）、新しい評価側の記録と 1 回だけの採点、Codex のレビューが要る。上の「理由」の 1 つ目で時間が無い。人の決定（11/1）で扱わない。
- **装置の表示だけ 0.1 秒にし、評価は 0.25 秒のまま**: 公開する数字（0.25 秒の採点）と装置の動き（0.1 秒）が別の定義になる。装置と PC の一致（0041 の 4）も 0.25 秒の経路で確かめたもので、
  0.1 秒の装置には当たらない。採らない。
- **M4 の評価側 4 本を 0.1 秒で採点し直す**: 0041 決定 6 に反する（評価側を見た後の定義の変更）。採らない。

## 記事（#56）に渡す材料

数字はそのまま写す（丸めない）。

- 「装置は 0.25 秒ごとに 1 窓（1.0 秒）を処理する。1 ホップの処理時間（特徴量・CNN 3 回・後処理・表示の更新まで）は、30 分の記録で中央値 79.8 ms、最大 86.1 ms。180 秒の記録では最大 106.2 ms の回があった。」
- 記録の条件（`water`、RPC あり、`--feat`）は上の「前提」にある。記事の文は「30 分の記録で」のままでよい。
- 書かないこと: 「0.1 秒に収まる」。数字は丸めずに書く（Issue 本文の材料の文のように 80 ms に丸めない）。検出率・誤検出率は 0042 の数字で、混同行列とセッション一覧を添える。

## 変えていないこと

`docs/evaluation.md`（窓長 1.0 秒・ホップ 0.25 秒・合格線）、0011・0012、0038 の構成、0040 の経路と決定、0041 の手順と M4 の数字（0042）、装置と PC のコード。

## 影響する場所

`docs/status.md`（「保留中の判断」から 1 ホップの項目を閉じる、「直近の状態」）、記事（#56）の処理時間の文、M6 以降に 0.1 秒を検討するときの Issue。
