owhinata/zaitaku-mealpace/docs/log/2026-11-01.md

# 2026-11-01

## #48 評価用 `meal` 4 本目（評価用の収集日 3。打ち切りの日）

- M4 の評価用 `meal`（docs/decisions/0037 と追記 10/29。窓は 10/29〜11/1、打ち切り 11/1 の終わり）。装置の経路
  （`record.py --unoq-detector --feat --no-rpc --cond meal --duration 1800`、#47）。手順は `docs/recording-protocol.md`「評価用 `meal` の記録（装置の経路）」。被験者 `self`。
  1 本目は docs/log/2026-10-30.md、2・3 本目は docs/log/2026-10-31.md。生の音声はどこにも残っていない。
- `tools/unoq_session_check.py` の数字は人が実行した出力から写した。マーカーの数は `events.csv`、記録の形は `meta.json` から写した（`detect.csv`・`feat.csv` は時刻の列だけ。
  陽性・`prob`・`led`・FEAT の値は出していない）。採否は人が記録の直後に決めた（下の「人の決定（11/1）」）。
- 装着の側は M3 と同じ側。叩きはしない。マトリクスは `--no-rpc` で消灯のまま（起動直後の消灯を人が目で確かめて Enter）。

| セッション | 条件 | 長さ（秒） | 止まり方 | 会話 | 同席者 | `s` | `t` | `c` | `o`（start / conv / その他の note） | 窓の数 | 取りこぼし | 逆行・1000 ms 超の飛び | 受信の遅れ `delay_meas`（中央値 / 最大 ms） | 時計（`anchor_spread_ms` / `clock_drift_max_ms`） | 構成の識別子 | FEAT の次元 | 使わない目安 | 打ち忘れの体感 | 打ち遅れの体感 | 記録時の `s` の決まり | 採否と理由 |
|---|---|---|---|---|---|---|---|---|---|---|---|---|---|---|---|---|---|---|---|---|---|
| `20261101-134412_self_meal` | meal | 854.7 | interrupt（食べ終わって Ctrl-C。検出器 eof） | なし | なし | 54 | 0 | 0 | 1 / 0 / 1（`late`） | 3415 | 0 窓（0.00%） | 0 箇所 | 257.0 / 640 | 0.105 / 0.13（`clock_drift_min_ms` −10.821） | 0038（`mfe40` CNN 種 0・1・2、hyst 0.85 / 0.65、不応期 0.5 秒） | 82（`m4-0037-feat82`） | 当たらない | 数回 | 数回 | 0023（意識した食べ物・飲み物の嚥下に `s`） | 採用（人の決定 11/1、数字を見る前） |

- `o start` は 1 つ（7.5 秒）で、その前に `s`・`t`・`c` は無い。`o conv` は無い（会話なし）。`o` の note `late` が 44.7 秒に 1 つ（打ち遅れの自己申告。`meal` では打ち遅れで捨てない、0023）。
  `o start` から記録の終端まで 14.1 分。最初の `s` は `o start` の 32.5 秒後、最後の `s` は終端の 10.6 秒前（0037 の 5 の 6「終わりの 1.5 秒以内の `s`」に当たらない）。
  `s` の間隔 10 秒未満は 19 組（`meal` では制限なし）。`c`・`t` は 0。`wrong key` 0。
- 捨てる条件（0037 の 5、装置）1〜9: `unoq_session_check.py` の出力で 1〜8 は「当たらない」、9 は `wrong key` 0 で `s` に関わるものなし。条件 4 は `delay_meas` の最大 640 ms（規則 1000 ms。
  4 本の中で最大）、時計は `anchor_spread_ms` 0.105・`clock_drift_min_ms` −10.821・`clock_drift_max_ms` 0.13（規則 250）で当たらない。`delay_upper` は中央値 961.7・最大 1344.7 ms
  （ssh の往復時間の最大 704.7 ms。記録の後の測定 10 回のうち 1 回だけ大きく、ほかは 3 ms 前後。値だけで判定に使わない）。
- 装置の動作: 読めない行 0、overrun の行 0、RPC の失敗 0（RPC なし）、行の途切れ 0 回、ハートビート 1711 回・書き込みの失敗 0、最初の窓までの待ち 2.1 秒。
  1 ホップの `proc_ms` 中央値 63.8・95 パーセンタイル 67.8・最大 77.1 ms（RPC なし。0040 の目安 125 / 250 ms に当たらない）、`e2e_ms` 中央値 189.0・最大 206 ms（装置の時計。固定の遅れの分だけ小さく出る）。
- `meta.json`: `fw` `unoq-detector`、`m4_config` は 0038 と同じ、`model.sha256` `c786086f…` = 0038 の `M4-MODEL`、H 行の `code_sha256` `7b98bde5…`（1〜3 本目と同じ）、
  `sensors[0].iface` `sh12jk-wired-unoq-usbaudio`、`position` `lateral-below-cricoid`、`band` `sh12jk-strap`、`mixer` Mic 58・on、`rpc` false、`stop` `interrupt`、`bad_lines` 0。
- 評価用 `meal` の累計（打ち切りの日の昼の時点）: 4 本（10/30 会話あり、10/31 会話あり、10/31 会話なし、11/1 会話なし）、収集日 3 日、`s` の合計 208、`o start` から後の合計 62.9 分。
  打ち切りは 11/1 の終わり。それまでに録った採用分はすべて評価側にする（0037 の追記 10/29）。

### 人の決定（11/1）

- `20261101-134412_self_meal` は**採用**（数字を見る前。捨てる条件に当たらず、`wrong key` 0）。打ち忘れ・打ち遅れの体感はどちらも「数回」。同席者なし。

## #48 評価用 `meal` の打ち切りと一覧の固定（0037 の 7）

- 人の決定（11/1）: 「計測はこれで終わりにします」。打ち切りは 0037 の追記 10/29 のとおり 11/1 の終わり。これより後に録った `meal` は M4 に使わない。
- 評価側 = 窓（10/29〜11/1）で録って採用した 4 本すべて（本数で早く止める規則は置かない。0037 の追記 10/29）。捨てた記録は無い。
  `20261030-201124_self_meal`（会話あり）、`20261031-145803_self_meal`（会話あり）、`20261031-195410_self_meal`（会話なし）、`20261101-134412_self_meal`（会話なし）。
  収集日 3 日、`s` の合計 208、`o start` から後の合計 62.9 分。0037 の目安（3 本以上・収集日 2 日以上・会話あり 1・会話なし 1）を満たす。
- 一覧の固定（メイン、人の指示）: 0037 の `M4-EVAL` 行に 4 本の名前を入れ、追記（2026-11-01）を足した。`analysis/fixed_eval.py` の `M4_EXPECTED_EVAL` に同じ 4 本。
  追記の時点で M4 のどの性能の数字も見ていない（4 本とも時刻の列だけを読んだ）。
- テスト: 実物の `M4_EXPECTED_EVAL` が None でなくなったので、合成の名前のテスト（`test_fixed_eval.py` の F2・F4・F6、`test_m4_compare.py` の `ListingTest`・`RunCase`）は
  `M4_EXPECTED_TRAIN` と同じく None に差し替えて動かし、`test_stops_when_list_is_none` も None に差し替えて確かめる形にした。実物の照合（`test_real_0037_matches`）に
  評価側 4 本・学習側と重ならない・`assert_m4_eval`／`assert_m4_train` が通ることを足した。テストは `analysis` 491 件・`tools` 115 件とも通った。
- 次は #49 の plan（評価側を 1 回だけ採点。印は `docs/log/m4-final-49.txt`。11/5 まで）。#48 の close は人。

## #49 plan（M4 の評価側の採点）の下書きと Codex の plan レビュー

- #48 は人が close した（11/1）。人の指示で #49 の plan に着手。plan 担当の subagent（opus）が下調べ → `~/work/zaitaku-mealpace-scratch/issue49/plan-49.md` → Codex の plan レビュー → 裏取り → Issue #49 のコメント。
  メインは人とのやり取り（指摘の採否と Q の決定）と承認だけ（docs/decisions/0015・0016）。
- レビューは 4 回（同じ Thread を resume、0008）。Codex の出力と裏取りは Issue #49 のコメント 1〜4（生の出力は `<details>`）。
  1. PLAN-SHA `0b51ef310a2a4558`: 制約 BLOCKING / 評価 CONCERN / 設計 CONCERN。BLOCKING 1（FEAT の集計値を log に出す案が 0037「FEAT は `data/raw/` の外に出さない」と食い違う）、CONCERN 6
     （印の前に `meta.json`・`events.csv` を開く、範囲の検査の位置、0041 の定義とコードの一致、`cough_linked` が `o start` より前の陽性を数える、丸めた `prob` の一致のテスト、`tee` の終了コード）。
     人の決定: 7 件すべて採る、Q1〜Q9 は推奨のとおり（Q1 `o start` から、Q2 印の前に何も開かない、Q3 切り分けは同じ 1 回の実行で、Q4 `prob` の内訳なし、Q5 印は固定のパスに残し人が決める、
     Q6 FEAT は使わない、Q7 0041 を採点前にコミット、Q8 図なし、Q9 本番はメイン）。
  2. PLAN-SHA `e80a709c0fdd5861`: 制約 BLOCKING / 評価 CONCERN / 設計 CONCERN。新しい BLOCKING 1（異常な行で既存の読み込みがエラー文に行全体や `prob` の値を入れ、公開の log に出る。
     `feat.csv` も内部で全列を読む）、CONCERN 4（E4 が停止条件に当たる、終了コードが保存ファイルに残らない、Q5 (b) と「1 回だけ」の関係、`M4-EVAL-PROC` の行だけでは細部を確かめられない）。
     人の決定: 5 件すべて採る（Q5 (b) は保ち、再採点は 0037 の 7 の変更に当たると 0041 に書く）。
  3. PLAN-SHA `d4b62651ca899211`: 制約 LGTM / 評価 LGTM / 設計 CONCERN 1（範囲の内の `SessionData` で `coughs` を絞っていない）。人の決定: 直して 4 回目を回す。
  4. PLAN-SHA `15e1f59302953f8c`: 3 面とも LGTM。
- 承認（11/1）: メインが plan mode に入り、scratchpad の 4 版を plan ファイルへそのままコピー（ハッシュ一致）→ `plan-approve.sh`（承認 `15e1f59302953f8c`）→ `ExitPlanMode` で人が全文を見て承認。
- plan の要点: 新しい入口 `analysis/m4_final_eval.py`（`evaluate_detector.py` は変えず関数だけ使う）。印の前は評価側のファイルを 1 つも開かず、印の後・数字の前に検査をすべて済ませる。
  記録の範囲は `o start` から。FEAT は値も集計も出さない。値を出さない読み込み（診断は行番号と列名だけ）。0041 を採点の前にコミットして事前登録（`M4-EVAL-PROC:` の行を入口で照合）。
  日程: ステップ A（実装・テスト・0041）→ コミット前のレビュー → ステップ B（人の合図の後にメインが 1 回だけ実行）→ ステップ C（log と 0041 の追記）。11/5 まで。
- 実装（ステップ A）は別の subagent（opus）に渡した（11/1 夜）。

## #49 ステップ A: 評価側の採点の入口の実装と 0041 の事前登録（`data/raw/` は開いていない）

- 実装の subagent（opus）が plan #49 のステップ A を実装し、メインが確認した。`analysis/m4_final_eval.py`（新規）、`analysis/test_m4_final_eval.py`（新規、36 件）、
  `docs/decisions/0041-m4-final-eval-procedure.md`（新規。事前登録。「結果（追記）」は空）、`analysis/README.md` の 1 節。既存のファイルは変えていない。
- テスト（メインが実行）: analysis 527 件（既存 491 + 新規 36）、tools 115 件、device/unoq 58 件、すべて OK。合成の 4 本での通しの報告の形はメインが目で確認した
  （`~/work/zaitaku-mealpace-scratch/issue49/stepA-synthetic-report.md`。合成の数字で、実データではない）。
- plan から外れた点: なし。subagent が自分で決めた点（塊の長さ = 窓の数 × 0.25 秒、「嚥下を含む塊」の定義、M2 の検出率の定数の照らし方、終わりの 1.5 秒の境、
  `write_marker` を自前で書く、`assert_m4_eval(None)` の前に None を見る、依存は冒頭で import）は Issue #49 のコメントに書いた。
- コミット前の adversarial-review（`--scope working-tree`。焦点は 0041 とコードの対応・印の前に評価側を開かないこと・値が漏れない経路・CLAUDE.md の制約）: 3 回。
  1. needs-attention、high 1（採点後の報告の `print` が `try` の外。書き込みの失敗で報告が途切れトレースバックが出る）→ 当たっている。人の決定で採り、印の後の処理を 1 つの `try` に。
  2. needs-attention、high 1（受け手が閉じた標準出力の終了時の再 flush で「Exception ignored」と終了コード 120）→ 当たっている。人の決定で採り、`_to_devnull` で記述子を `/dev/null` に。
     子プロセスで実際のパイプを閉じるテスト 2 件（直す前のコードで 120 になることを確かめた）。
  3. approve、指摘なし。生の出力は Issue #49 のコメント（`<details>`）と `~/work/zaitaku-mealpace-scratch/issue49/adv-review-{1,2,3}.txt`。
- 次はステップ B: 人の合図の後にメインが `analysis/m4_final_eval.py data/raw` を 1 回だけ実行する（plan の 2 節のコマンド。印 `docs/log/m4-final-49.txt`）。実行の前に
  `git status` がきれいで、7.1 の検査（0037・0038・0041 の行、重みの sha256、`DEPLOY_FILES` の `code_sha256`）が通る見込みであること。

## #49 M4 の評価側の採点（1 回だけ）

- 人の合図（11/1 16:22）の後、メインがリポジトリのルートで plan #49 の 2 節のコマンドを 1 回だけ実行した。実行の前: 作業ツリーはきれい（HEAD `497b066`）、印は無し、7.1 の検査だけを
  先に走らせて通ることを確かめていた（評価側は開いていない）。
- コマンド: `bash -c 'O=~/work/zaitaku-mealpace-scratch/issue49/m4-final-49.md; .venv/bin/python analysis/m4_final_eval.py data/raw 2>&1 | tee "$O"; rc=${PIPESTATUS[0]}; echo "exit=$rc" | tee -a "$O"; exit $rc'`
- 終了コード: Python 0（保存したファイルの最後の `exit=0`）、シェル 0。標準エラーは空（出力の全文に `未完了:` の行は無く、`完了:` の行で終わる）。
- 印 `docs/log/m4-final-49.txt`（このコミットに含める。中身は started 2026-11-01T16:23:01+09:00、commit `497b066fd929…`、decisions 0037 0038 0041、command、4 本の名前。数字は無い）。
- 出力の全文（標準出力と標準エラーを合わせて保存したファイルの全体。一字も変えていない。窓ごとの値・FEAT は含まれない。貼る前にメインが目で確かめた）:

````
# M4 検出器（咽喉マイク版）: 評価側の採点（1 回だけ。#49、docs/decisions/0041）

## 実行の条件

- 実行: `python analysis/m4_final_eval.py data/raw`
- コミット: 497b066fd92986376c98f10b545593373beb6ef9
- 印: `docs/log/m4-final-49.txt`（作成してから評価側を開いた）
- 手順と定義: docs/decisions/0037-m4-split-and-recording-plan.md（対象・1 回だけ）、docs/decisions/0038-m4-detector-config.md（構成）、docs/decisions/0041-m4-final-eval-procedure.md（記録の範囲・出す数字・切り分け）
- `M4-EVAL-PROC: range=o-start windows=start>=o-start device-agree=poststepper,ledstepper breakdown=classify_run,cough_linked,fn_near3s,run_length feat=unused prob-breakdown=none`
- 構成: `M4-CONFIG: set=mfe40 classifier=cnn seeds=0,1,2 hard_negative=none post=hyst threshold=- enter=0.85 exit=0.65 cap_s=none refractory_s=0.5`
- 重み: `M4-MODEL: path=analysis/models/m4-0038.npz sha256=c786086f069c55c55b27eea860963c3c950c04b728fe65d52bc35a7a4a806d90`
- 手元の `code_sha256`（`device/unoq/DEPLOY_FILES`）: `7b98bde5877bd974f3a338aa47d32cfcf52518bf99e6d56584c4662e181fbe5b`
- 対象（`M4-EVAL`、この順）: 20261030-201124_self_meal, 20261031-145803_self_meal, 20261031-195410_self_meal, 20261101-134412_self_meal

## 評価に使ったセッション（4）

記録の範囲は `o start` から（0041）。採点に入れる窓は開始が `o start` 以上。窓 1.0 秒 / ホップ 0.25 秒、数え方は docs/evaluation.md と docs/decisions/0011、終わりは docs/decisions/0021。採点したのは装置の `positive`。

| セッション | 収集日 | 会話 | `s` | 検出 | 検出率 | 誤検出（回） | 非嚥下（分） | 誤検出率（回/分） | 陽性窓 / 全窓（範囲の内） | `o start` より前の窓 | FEAT に無い窓 | `marker_offset_shift_max_ms` |
|---|---|---|---|---|---|---|---|---|---|---|---|---|
| 20261030-201124_self_meal | 20261030 | あり | 53 | 49 | 0.925 | 26 | 15.12 | 1.72 | 314 / 4048 | 40 | 0 | 0 |
| 20261031-145803_self_meal | 20261031 | あり | 50 | 50 | 1.000 | 17 | 12.41 | 1.37 | 293 / 3373 | 24 | 0 | 1 |
| 20261031-195410_self_meal | 20261031 | なし | 51 | 51 | 1.000 | 22 | 16.15 | 1.36 | 314 / 4272 | 28 | 0 | 8 |
| 20261101-134412_self_meal | 20261101 | なし | 54 | 49 | 0.907 | 5 | 12.33 | 0.41 | 235 / 3388 | 27 | 0 | 0 |

## 合算（`evaluate.aggregate`。回数の合算）

- 検出率: 0.957（199/208）
- 誤検出率: 1.25 回/分（70 回 / 56.00 分）
- 評価に使ったセッション: 20261030-201124_self_meal, 20261031-145803_self_meal, 20261031-195410_self_meal, 20261101-134412_self_meal

混同行列（イベント単位。TN は定義できないので出さない）:

| | 陽性と出た | 陽性と出なかった |
|---|---|---|
| 嚥下 | TP 199 | FN 9 |
| 非嚥下区間 | FP 70（回） | — |

## 合格線との比較（docs/evaluation.md 29 行目の合格線を M4 に当てる。docs/plan.md の M4）

- 検出率 0.957（合格線 0.85 以上）: 満たす
- 誤検出率 1.25 回/分（合格線 1.0 回/分以下）: 満たさない

## 参考値（docs/decisions/0011「既知の弱点」）

- 常時陽性の場合（範囲の内の全窓を陽性にした場合）: 検出率 1.000（208/208）、誤検出 4 回、誤検出率 0.07 回/分（非嚥下 56.00 分）
- 陽性窓の割合（範囲の内の陽性窓 ÷ 全窓）: 0.077（1156/15081）
- 収集日ごと（式は回数の合算。3 セッション未満でも出す）:
  - 20261030: 検出率 0.925（49/53）、誤検出 26 回、誤検出率 1.72 回/分（非嚥下 15.12 分）
  - 20261031: 検出率 1.000（101/101）、誤検出 39 回、誤検出率 1.37 回/分（非嚥下 28.55 分）
  - 20261101: 検出率 0.907（49/54）、誤検出 5 回、誤検出率 0.41 回/分（非嚥下 12.33 分）
- 会話の有無ごと（`o` の note が `conv` のセッションが会話あり）:
  - 会話あり: 検出率 0.961（99/103）、誤検出 43 回、誤検出率 1.56 回/分（非嚥下 27.52 分）
  - 会話なし: 検出率 0.952（100/105）、誤検出 27 回、誤検出率 0.95 回/分（非嚥下 28.48 分）
- 評価側の収集日: 3 日（0037 の 1「2 日以上」: 満たす）

## 装置と PC の一致（全窓。`o start` より前の窓を含む）

PC の再計算は `postprocess.PostStepper` を窓ごとに回した出力（`step(prob, True, k × 0.25)`。装置の `Detector.step` と同じ呼び方）で、`post_mask` の一括の出力と一致することを確かめてから比べた。採点は装置の `positive` で行った（評価の数字は装置の出力）。

| セッション | 窓 | `positive` 装置 1 / PC 0 | 装置 0 / PC 1 | 丸めの候補の窓 | `led` の不一致（`LedStepper`） | `led` の不一致（`led_states`） |
|---|---|---|---|---|---|---|
| 20261030-201124_self_meal | 4088 | 0 | 0 | 0 | 0 | 0 |
| 20261031-145803_self_meal | 3397 | 0 | 0 | 0 | 0 | 0 |
| 20261031-195410_self_meal | 4300 | 0 | 0 | 0 | 0 | 0 |
| 20261101-134412_self_meal | 3415 | 0 | 0 | 0 | 0 | 0 |
| 計 | 15200 | 0 | 0 | 0 | 0 | 0 |

- 丸めの候補の窓: `|prob − 0.85|` か `|prob − 0.65|` が 1e-8 以下の窓（`prob` は 9 桁の有効数字で書かれているので比較が変わりうる。状態は後の窓に伝わりうる）。不一致の原因は断定しない。
- `led` の行: LED は嚥下の「目安」で、評価には使わない（docs/decisions/0018）。不一致は止めずに数だけを出す。

## 届かなかった場合の切り分け（0041 で固定した定義。満たす・満たさないによらず出す）

### 誤検出の主分類（`m4_compare.classify_run`。0038 の学習側の内訳と同じ定義。70 回）

| 主分類 | 20261030-201124_self_meal | 20261031-145803_self_meal | 20261031-195410_self_meal | 20261101-134412_self_meal | 計 |
|---|---|---|---|---|---|
| 嚥下の直後の延び | 5 | 3 | 2 | 0 | 10 |
| 嚥下の直前 | 2 | 2 | 1 | 1 | 6 |
| 動作に付くもの（t・c・n） | 4 | 1 | 1 | 0 | 6 |
| meal の会話あり | 15 | 11 | 0 | 0 | 26 |
| meal の会話なし | 0 | 0 | 18 | 4 | 22 |
| その他 | 0 | 0 | 0 | 0 | 0 |

| 主分類 | 会話あり | 会話なし | 計 |
|---|---|---|---|
| 嚥下の直後の延び | 8 | 2 | 10 |
| 嚥下の直前 | 4 | 2 | 6 |
| 動作に付くもの（t・c・n） | 5 | 1 | 6 |
| meal の会話あり | 26 | 0 | 26 |
| meal の会話なし | 0 | 22 | 22 |
| その他 | 0 | 0 | 0 |

副表（重複あり。「動作に付くもの」の塊で、範囲にあるマーカーの種類ごとの塊の数）: `t` 1、`c` 5、`n` 0

### 条件別（会話の有無）と学習側 CV

- 会話あり: 検出率 0.961（99/103）、誤検出 43 回、誤検出率 1.56 回/分（非嚥下 27.52 分）
- 会話なし: 検出率 0.952（100/105）、誤検出 27 回、誤検出率 0.95 回/分（非嚥下 28.48 分）
- 参考: 学習側 CV の `meal` だけ（0038。構成の選択に使った数字で楽観側）: 検出率 0.973（250/257）、誤検出率 1.25 回/分

### 嚥下の直後の延びと塊の長さ（集計だけ）

- 主分類「嚥下の直後の延び」: 10 回
- 陽性の塊の長さ（窓の数 × 0.25 秒）。「嚥下を含む塊」は窓の中心が `s` の `[t − 0.5, t + 1.5]` に入る窓を 1 つ以上含む塊、「誤検出の塊」は誤検出に数えた塊（両方に入る塊がある）:
  - 嚥下を含む塊: 199 個、中央値 1.25 秒・最大 2.50 秒
  - 誤検出の塊: 70 個、中央値 1.00 秒・最大 2.50 秒

### `c` に紐づく誤検出の塊（`evaluate_detector.cough_linked`。M2 と同じ定義。塊の最初の窓の中心 − t_c が [-1.0, +5.0] 秒）

- `c` 4 回、紐づく塊 6 / 誤検出の塊 70、紐づく塊が 1 つ以上ある `c` 4/4

### 見逃し（FN）

- 見逃した `s` 9 回のうち、`[t − 3.0, t + 3.0]` 秒に中心がある陽性窓（範囲の内の装置の `positive`）がある: 6、無い: 3。`prob` を使った見逃しの内訳は出さない（0041）。

### 装置と PC の差

- 上の「装置と PC の一致」の数。#47 の再生モードの一致（学習用 `meal`、docs/log/2026-10-29.md「#47」）では `prob` 1e-5、`positive`・`led` は完全に一致していた。
- 取り込み口（学習用 `meal` の `arecord` の経路と装置の ALSA）の差は #49 では調べない（FEAT を使わない。0041）。

## M2・M3 と並べる（docs/decisions/0037 の 6）

| | M2（0027） | M3 構成 J（0034・0036） | M4（この採点） | 参考: M4 学習側 CV（0038。楽観側） |
|---|---|---|---|---|
| センサ・基板 | 基板の IMU＋PDM、Nano RP2040 | 咽喉マイク、PC で採点 | 咽喉マイク、UNO Q の Linux 側で推論 | 咽喉マイク、PC |
| 手法 | Edge Impulse int8 | CNN `mfe40` 種 0、ヒステリシス | CNN `mfe40` 種 0・1・2 の平均、ヒステリシス＋不応期 0.5 秒 | 同左 |
| 評価側 | `meal` 3 本・3 収集日 | 条件別 7 本・1 収集日 | `meal` 4 本・3 収集日 | 26 本・収集日ごとの CV |
| `s` の決まり | 0023 | M1（すべての嚥下） | 0023 | 混在 |
| 検出率 | 0.150（21/140） | 1.000（30/30） | 0.957（199/208） | 0.955（338/354） |
| 誤検出率 | 2.03 回/分 | 1.19 回/分 | 1.25 回/分 | 0.86 回/分 |
| 合格線 | 85% / 1 回/分 | 70% / 3 回/分（分岐点） | 85% / 1 回/分 | （判定に使わない） |

- M4 と同じ条件（`meal`・0023・同じ合格線）で比べられるのは M2。M3 は条件別のセッションで `s` の決まりも違う。
- M4 の手法は `docs/evaluation.md` 29 行目（M2 の行）・28 行目・8 行目からの記録した逸脱（docs/decisions/0038）。学習側 CV は構成の選択に使った数字で楽観側（0038 の決定 2・3）。

## 注記

- `s` は押せた嚥下だけ（docs/decisions/0023「数字の読み方」）。打ち忘れ・打ち遅れの向きと大きさは確定できない。
- ALSA・USB・arecord の中の測れない固定の遅れ（125 ms 程度までの推測）は補正していない。窓の時刻は実際より少し遅い側に刻まれる（0037 の追記 10/29）。
- `events.csv` の `t_ms` は PC の受信時刻を `offset` で装置の時計に直した値（`marker_offset_shift_max_ms` は上の表。補正しない）。
- 記録の範囲の始まりは `o start`（0041）。装置の後処理と LED（目安）の状態は最初の窓から続いていて、`o start` より前の窓の状態の持ち越しは補正していない。
- FEAT は #49 では使っていない（0041。`feat.csv` は時刻の 2 列だけを読んだ。取り込み口の差は確かめていない）。
- LED は嚥下の「目安」で、評価には使わない（docs/decisions/0018）。
- 評価側の採点は 1 回だけ（印）。この後に構成・閾値・後処理を変えない（docs/decisions/0038）。

完了: 報告はここまで（m4_final_eval.py が最後まで走った）
exit=0
````

- 要点（事実）: 検出率 0.957（199/208）は合格線（0.85 以上）を**満たす**。誤検出率 1.25 回/分（70 回 / 56.00 分）は合格線（1.0 回/分以下）を**満たさない**。
  装置と PC の `positive`・`led` の不一致は 15200 窓で 0。会話ありの誤検出率 1.56 回/分（43 回）、会話なし 0.95 回/分（27 回）。誤検出 70 回の主分類は `meal` の会話あり 26、
  `meal` の会話なし 22、嚥下の直後の延び 10、嚥下の直前 6、動作に付くもの 6。見逃し 9 回のうち ±3 秒に陽性窓があるもの 6。結果の追記は 0041、判定（#50）は人。

## #50 関門のレビュー（adversarial-review、base `gate-M3`）

- #49 は人が close した（11/1）。人の指示でメインが関門のレビューを 1 回回した（`node … codex-companion.mjs adversarial-review --wait --base gate-M3 <focus>`、39 コミット、約 10 分）。
  focus は Issue #50 の 3 つ（生の音声の経路、評価の 1 回だけ・事前登録、LED の文言）＋公開の線引き。生の出力は `~/work/zaitaku-mealpace-scratch/issue50/gate-M4-1.txt` と Issue #50 のコメント（折りたたみ）。
- verdict: needs-attention、high 2 件（BLOCKING なし）。生の音声の経路・LED の文言・公開の線引きには指摘なし。
  1. 採点済みの印がチェックアウトごとの固定パスで、`497b066` を別の worktree に出すと再採点できる → 当たっている（故意の経路。0041 の「塞がっていない経路」の一種）。人の決定: CONCERN、運用で注意。0041 に 1 行追記。台帳は作らない。
  2. Linux と MCU の RPC が途切れると最後の表示が残る（MCU は 0035 の決定で消灯の規則を持たない）→ 当たっている。評価用 `meal` は `--no-rpc` なので M4 の数字に影響しない。人の決定: CONCERN、M5 の前に
     MCU 側の自律消灯（最後の更新から 2 秒程度）を 0035 を改める decision つきで足す。
- 判定の decision 0042 は subagent が「判定待ち（人）」で下書きし、レビューの結果を足す。判定・タグ・close は人。

## #50 判定（人、11/1）

- 人の判定: **M4 の関門は通過しない**（検出率 0.957 は満たす、誤検出率 1.25 回/分は満たさない）。**時間がないので M5（公開）へ進む**。0042 の「決定」に書き、状態を「採用」に改めた。
  `review-M4` タグと #50 の close は人。
- 人の観察（改善ネタ、M5 の後）: 咽喉マイクに手で触れる・手で叩くと必ず誤認識する。学習時に弾く（接触・叩きの音を hard negative に）ことで誤検出率を下げられる見込み。
  0042 の末尾「M5 の後の改善候補」と status の「保留中の判断」に書いた。評価用 `meal` の誤検出 70 回のうち接触によるものの数は分からない（`events.csv` に印が無く、FEAT も使っていない）。

## M5 の起票と人の決定（11/1 夜）

- M5 の Issue #52〜#59 を起票した（草案は人がレビューし、5 点を直した。docs/status.md「次にやること」）。M5 は 11/2 開始（plan.md と Milestone の説明をメインが直した）。
- README の冒頭を今の装置と M4 の数字に差し替えた（`39be5d8`）。残りの節は #58。
- 人: ProtoPedia のアカウントを作った。作品タイトルは**「在宅MealPace」**（#56 のコメント）。残りの人の確認は応募手順と作品ページの枠（11/5 まで）。
