owhinata/zaitaku-mealpace/docs/decisions/0042-gate-m4-throat-mic-detector.md

# 0042 M4 検出器（咽喉マイク版）の関門（#50）の判定

日付: 2026-11-01　状態: 採用（人の判定 2026-11-01。下の「決定」）

この記録は判定の材料と選択肢をまとめたもの。判定（下の「判定の選択肢」のどれか）は人が行い、人が決めた後に「決定」の節を書き、状態を改める。
エージェントは選択肢を選ばない。#50 を閉じるのと、タグを打つのは人。
番号: #50 の本文は「判定の decision（0039）」と書くが、0039 は #51 の記録（ランタイムの比較のための一時的な導入）で埋まったので、この記録を 0042 とする。

## 決定（人の判定 2026-11-01）

- **M4 の関門は通過しない**（選択肢 (a)）。評価側 4 本（収集日 3 日、`s` 208）の 1 回だけの採点で、検出率 0.957（199/208）は合格線（0.85 以上）を満たしたが、
  誤検出率 1.25 回/分（70 回 / 56.00 分）は合格線（1.0 回/分以下）を満たさない。混同行列は TP 199 / FN 9 / FP 70。数字と原因の切り分けは 0041 の追記と docs/log/2026-11-01.md。
- **時間がないので M5（公開）へ進む**（`docs/plan.md` の M4 の行「届かない場合も、届かなかった数字と原因の切り分けを公開の材料にする」、#50 の本文「届かなくても M5 へ進む」のとおり）。
  公開の材料は、届かなかった数字（上）、誤検出の内訳（会話あり 26・会話なし 22・嚥下の直後の延び 10・直前 6・動作に付くもの 6）、M2（0.150 / 2.03 回/分）との比較。
- 関門のレビューの指摘 2 件は CONCERN（上の「関門のレビュー」）。指摘 2 の MCU の自律消灯は M5 の前に行う。
- タグ: `gate-M4` は打たない。`review-M4` を判定のコミットに人が打つ（0027 と同じ。次の関門のレビューの base）。#50 の close は人。
- 評価側を見た後に構成・閾値・後処理を変えて同じ 4 本を採点し直すことはしない（0038、0041 決定 6）。

## 位置づけ

- 関門: #50「【判定】M4 検出器（咽喉マイク版）」。判定するのは人（CLAUDE.md、#50 の本文）。
- 判定基準（`docs/plan.md` の M4 の行、0024・0027）: **M2 と同じ合格線（検出率 85% 以上、誤検出 1 回/分以下）**を、`self` の `meal` の通し記録で当てる。
  `docs/evaluation.md` 29 行目（M2 の行）の数字を M4 に当てる（0041 決定 1）。`docs/evaluation.md` の定義と合格線は変えていない。
- 届かない場合（`docs/plan.md` の M4 の行・#50 の本文）: 届かなかった数字と原因の切り分けを公開の材料にする。届かなくても M5 へ進む。
- 構成は 0038（CNN `mfe40` 種 0・1・2 の平均、ヒステリシス 入り 0.85・出 0.65、不応期 0.5 秒）、分割は 0037、装置のランタイムは 0040、
  評価側の採点の手順は 0041（採点の前に固定）。評価側の採点は 1 回だけ実行した（印 `docs/log/m4-final-49.txt`）。
- 被験者は `self` だけ（0037「前提」。`p1` は M4 に入れない）。

## 数字（0041「結果（追記 2026-11-01）」と docs/log/2026-11-01.md「#49 M4 の評価側の採点（1 回だけ）」から写した。計算し直していない）

採点は 2026-11-01 16:23 に 1 回だけ（コミット `497b066`、終了コード 0、`完了:` の行あり）。採点したのは装置の `detect.csv` の `positive`（0041 決定 1）。

### 合算と合格線

- 検出率 **0.957（199/208）**。合格線 0.85 以上: **満たす**。
- 誤検出率 **1.25 回/分（70 回 / 非嚥下 56.00 分）**。合格線 1.0 回/分以下: **満たさない**。
- 合格線の 2 つのうち 1 つを満たさないので、この数字は合格線に届いていない。「達成」とは書かない。
- 混同行列（イベント単位。TN は定義しない）:

  | | 陽性と出た | 陽性と出なかった |
  |---|---|---|
  | 嚥下 | TP 199 | FN 9 |
  | 非嚥下区間 | FP 70（回） | — |

- 参考値（0011「既知の弱点」）: 常時陽性の場合は検出率 1.000（208/208）・誤検出率 0.07 回/分（4 回。長い陽性 1 つが塊 1 つに数えられるため）。陽性窓の割合 0.077（1156/15081）。

### 評価に使ったセッション（4 本、収集日 3 日）

一覧は 0037 の `M4-EVAL`（追記 2026-11-01）と `fixed_eval.M4_EXPECTED_EVAL` に、性能の数字を見る前に固定した。捨てた記録は無い。

| セッション | 収集日 | 会話 | `s` | 検出 | 検出率 | 誤検出（回） | 非嚥下（分） | 誤検出率（回/分） |
|---|---|---|---|---|---|---|---|---|
| `20261030-201124_self_meal` | 20261030 | あり | 53 | 49 | 0.925 | 26 | 15.12 | 1.72 |
| `20261031-145803_self_meal` | 20261031 | あり | 50 | 50 | 1.000 | 17 | 12.41 | 1.37 |
| `20261031-195410_self_meal` | 20261031 | なし | 51 | 51 | 1.000 | 22 | 16.15 | 1.36 |
| `20261101-134412_self_meal` | 20261101 | なし | 54 | 49 | 0.907 | 5 | 12.33 | 0.41 |

- 会話あり: 検出率 0.961（99/103）、誤検出率 1.56 回/分（43 回 / 27.52 分）。会話なし: 検出率 0.952（100/105）、誤検出率 0.95 回/分（27 回 / 28.48 分）。
- 学習側（0037 の `M4-TRAIN` 26 本 = M3 の 21 本＋学習用 `meal` 5 本、日付は 2026-10-28 まで）とは日付が分かれ、同じセッションの窓は片側にだけ入る（セッション単位の分割）。

## 完了の条件との照らし（#50 の本文の項目ごと）

- **#44〜#49 が閉じている**: 満たす。`gh issue view` で #44・#45・#46・#47・#48・#49 が CLOSED（2026-11-01 に確かめた）。#50 の本文に無い #51 も CLOSED。
- **報告に混同行列と評価に使ったセッション一覧がある。評価は 3 セッション以上、セッション単位の分割、評価側 2 収集日**: 満たす。
  - 混同行列とセッション一覧は docs/log/2026-11-01.md の出力の全文、0041 の追記、この記録の上の節。
  - 評価は 4 セッション（3 以上）。分割はセッション単位（日付の境で学習側と評価側を分けた。0037 の 1）。評価側の収集日は 3 日（0037 の「2 日以上」を満たす）。
- **検出器が生の音声を保存していない・装置の外に送っていない（関門のレビューの focus）**: 関門のレビュー（11/1、下）で生の音声の経路への指摘は無かった。最終の確認は人。
  境界の定義は 0025 の追記（2026-10-12、#42）「検出器の境界」と CLAUDE.md「データの扱い」。評価用 `meal` は検出器だけで録った（0037 の 4、D8 の (b)。検出器に音声の出口を作らない）。
- **関門のレビューで BLOCKING が残っていない。CONCERN の採否がコメントにある**: 満たす（11/1、下。BLOCKING なし、high 2 件は人の決定で CONCERN。採否は Issue #50 のコメント）。
- **通過・届かなかった（数字と原因）のどちらかが `docs/decisions/` に記録されている**: この記録（人の判定の後に「決定」の節を書く）。数字と原因の切り分けの材料は下の節と 0041 の追記にある。
- **通過したら人が `gate-M4` タグを打つ。届かなくても M5 へ進む**: 人（下の「タグ」）。

## 届かなかった数字と原因の切り分け（0041 の追記「切り分けの要点」を写した。事実と推測を分ける）

届かなかった数字: 誤検出率 1.25 回/分（合格線 1.0 回/分以下）。検出率 0.957 は合格線を満たす。

### 事実

- 装置と PC の一致: `positive`・`led` とも 15200 窓で不一致 0、丸めの候補の窓 0。装置の出力と PC の再計算の差は無い。
- 会話の有無: 会話あり 1.56 回/分（43 回 / 27.52 分）、会話なし 0.95 回/分（27 回 / 28.48 分）。会話ありの 2 本はどちらも合格線の外、会話なしは 1 本が外（1.36）・1 本が内（0.41）。
- 誤検出 70 回の主分類（0038 の学習側と同じ定義）: `meal` の会話あり 26、`meal` の会話なし 22、嚥下の直後の延び 10、嚥下の直前 6、動作に付くもの 6（`c` 5・`t` 1）、その他 0。
  `meal` の会話なし 22 のうち 18 は `20261031-195410`（会話なしの 1 本目）に集まっている。
- `c` 4 回に紐づく誤検出の塊 6（`c` 4/4 に 1 つ以上）。
- 見逃し 9 回のうち、±3 秒に陽性窓があるもの 6、無いもの 3。
- 陽性の塊の長さ: 嚥下を含む塊 199 個（中央値 1.25 秒・最大 2.50 秒）、誤検出の塊 70 個（中央値 1.00 秒・最大 2.50 秒）。
- 学習側 CV の `meal` だけの数字（0038。構成の選択に使った数字で楽観側）は 0.973 / 1.25 回/分で、評価側（0.957 / 1.25 回/分）と近い。

### 推測（0041 の追記の読み。確かめていない）

- 合格線に届かない分は、会話の音（会話ありの 2 本で 26 回）と、会話なしでも食事の音（咀嚼・食器など。`20261031-195410` の 18 回）に装置が反応したもの（推測）。
- 嚥下の直後の延び・直前・動作に付くものは合わせて 22 回で、不応期 0.5 秒と塊の数え方（0011）で吸収しきれていない分がある（推測）。
- マーカー側の要因（打ち忘れ・打ち遅れの体感は 4 本とも「数回」）は向きと大きさを確定できない。取り込み口の差（学習用 `meal` の `arecord` の経路と装置の ALSA）は調べていない（FEAT を使わない。0041）。

### M2（0027）・M3（0036）と並べる（0041 の表をそのまま）

| | M2（0027） | M3 構成 J（0034・0036） | M4（この採点） | 参考: M4 学習側 CV（0038。楽観側） |
|---|---|---|---|---|
| 評価側 | `meal` 3 本・3 収集日 | 条件別 7 本・1 収集日 | `meal` 4 本・3 収集日 | 26 本・収集日ごとの CV |
| `s` の決まり | 0023 | M1（すべての嚥下） | 0023 | 混在 |
| 検出率 | 0.150（21/140） | 1.000（30/30） | 0.957（199/208） | 0.955（338/354） |
| 誤検出率 | 2.03 回/分 | 1.19 回/分 | 1.25 回/分 | 0.86 回/分 |
| 合格線 | 85% / 1 回/分 | 70% / 3 回/分（分岐点） | 85% / 1 回/分 | （判定に使わない） |

M4 と同じ条件（`meal`・0023・同じ合格線）で比べられるのは M2。M3 は条件別で `s` の決まりも違う。

## 記録した逸脱と注記（判定の材料として引き継ぐ）

- **手法は `docs/evaluation.md` 29 行目（M2 の行の手法「Edge Impulse（int8、Nano 上で推論）」）・28 行目・8 行目からの記録した逸脱（0038）。** 咽喉マイク、UNO Q の Linux 側の推論、
  CNN の float32、種 3 つの平均。合格線の数字・窓・数え方・分割はそのまま当てた。逸脱は評価の実行の前に記録した。
- **構成は規則が選んだ行（P4）ではなく、人が表を見た後に次点の P2 に変えた（0038 決定 2、10/29）。** 評価側の記録の前の変更で、評価側の数字には影響しない。学習側 CV の数字はさらに楽観側。
- **記録の範囲の始まりは `o start`（0041 決定 2。0021 の「最初の窓の開始」の読み替え）。** 装置の後処理と LED（目安）の状態の持ち越しは補正していない。
- `s` は押せた嚥下だけ（0023「数字の読み方」）。ALSA・USB・arecord の中の固定の遅れは補正していない（0037 の追記 10/29）。
- 評価側の採点は 1 回だけ（印）。評価側を見た後に構成・閾値・後処理・種を変えて採点し直さない（0038「事前登録と、後から選ばないこと」、0041 決定 6）。
- `self` のデータだけ。

## 判定の選択肢（人が選ぶ。0041 の追記「判定の選択肢」を基にした）

- **(a) 通過しない（届かなかった数字と原因を記録して M5 へ進む）。**
  - 帰結: 誤検出率 1.25 回/分が合格線の外という事実のとおりに判定する。`gate-M4` は打たず、`review-M4` を判定のコミットに打つ（0027 と同じ）。
    誤検出の内訳（会話・食事の音）と M2 との比較を、届かなかった数字として M5 の公開の材料にする（`docs/plan.md` の M4 の行）。
- **(b) 合格線の一方（検出率）を満たしたことと、誤検出率の M2（2.03）・M3（1.19、条件別）との位置を踏まえ、試用（M5 以降）に進めるかを別に決める。**
  - 帰結: 合格線は満たさないという事実は変わらない（通過とは書けない）。進め方の判断を別の記録で分けて残す。タグをどうするか（`review-M4` か別の名前か）は人が決める。
- **(c) やり直し（M4 の中で誤検出を減らして新しい評価側を録る）。**
  - 帰結: 構成・閾値・後処理を変えるなら、同じ評価側 4 本で採点し直さず、新しい評価側の記録が要る（0038、0041 決定 6）。M4 の期限は 11/7、M5 の 11/10 の下書き公開に掛かる。
- どの選択肢でも、評価側を見た後に構成・閾値・後処理を変えて同じ 4 本を採点し直すことはしない。
- `docs/plan.md` との関係: M4 の行は「届かない場合も、届かなかった数字と原因の切り分けを公開の材料にする」、#50 の本文は「届かなくても M5 へ進む」。
  (a)・(b) はこれに沿う。(c) は M5 の日程と引き換えになる。

## M5（公開）に渡すもの（#50 の本文の 3 つ目）

- **数字**: この記録と 0041 の追記（合算、混同行列、セッション一覧、セッションごとの表、切り分け、M2・M3 と並べる表）。出力の全文は docs/log/2026-11-01.md。
  「85%」など合格線の一方だけを取り出すときも、混同行列と評価に使ったセッション一覧を添える（CLAUDE.md「評価」）。誤検出率が届いていないことを並べて書く。
  `docs/plan.md`「11月時点で『可能性の証明』と言える状態」の「基板のセンサと咽喉マイクで何が変わったか（比較が 1 つ）」は M2 と M4 の並べ（同じ `meal`・0023・同じ合格線）が当たる。
- **図**: #49 では作っていない（0041「選ばなかった案」）。作るなら M5 で。候補だけ挙げる（決めるのは人）:
  - M2 と M4 の検出率・誤検出率を合格線と並べた図（数字は上の表から）。
  - セッションごとの誤検出率と合格線（4 本、会話の有無で区別）。
  - 誤検出 70 回の主分類の内訳。
  - 注記: 上の候補は出力済みの集計値だけで描ける。窓ごとの値（`positive`・`prob` の時系列）を描くには評価側のファイルを開き直すことになり、0041「1 回だけ」との関係を人が決める。
    docs/log/2026-10-28-45/ の図は学習側（CV）のもので、評価側の数字ではない。図は記事のためのもので、装置のグラフ UI は作らない（CLAUDE.md「作らないもの」）。
- **装置の写真**: リポジトリに装着写真・装置の写真は無い（未撮影）。人が撮る。装着写真はマネキンか開発者自身で撮る（CLAUDE.md「公開してよい情報の線引き」）。本人は含めない。
- **表示の文言**: `firmware/unoq_mcu/README.md` の「装置に貼る表示」と「介助者に渡すカード」の文面（#47 で `firmware/indicator/README.md` から写したもの）。
  LED の表示は嚥下の「目安」で「判定」ではない（表示に「嚥下の目安（判定ではありません）」、カードに「判定や指示ではありません」とある）。書き方は 0018「文言」の決まりに従う。

## M5 の前に決めるか（#50 の本文の 4 つ目。どちらも人が決める）

### 1 ホップ 0.1 秒（M4 起票の D5）

- 事実: 今のホップは 0.25 秒（`docs/evaluation.md`）。装置の 1 ホップ全体の `proc_ms` は、30 分の `water` で中央値 79.8・95 パーセンタイル 81.4・最大 86.1 ms、
  180 秒で中央値 79.9・最大 106.2 ms（0040 の追記 2026-10-29、docs/log/2026-10-29.md「#47」）。180 秒の回の最大は 0.1 秒を超える。
  0040 決定 4 は LiteRT CPU を M5 に送り、その検討の入口の 1 つにホップ 0.1 秒を挙げた。
- ホップは評価の定義（`docs/evaluation.md`・0011・0012。窓の数え方、誤検出の塊）に入る。変えるなら decision に記録し、Codex のレビューを通してから人が文書を直す（`docs/status.md`「保留中の判断」）。
  M4 の数字（0.25 秒）との並べ方も同じ記録で決める。
- 選択肢: **M5 の前に決める**（変えるか・変えないか、変えるならランタイムを含めて）／ **M5 の中で決める**（公開の M4 の数字は 0.25 秒のまま出す）。人が決める。

### MCU の自律消灯（関門のレビューの指摘 2。人の決定 11/1）

- M5 の前に、MCU 側に「最後の状態の更新から一定時間（2 秒程度）で自律的に消灯」を足す（0035 の決定「MCU は表示の規則を持たない」を改める decision つき）。
  試用（M5 以降）で介助者に古い目安が見え続けないため。M4 の数字には影響しない。

### `p1` の記録先（保留中）

- 事実: `tools/record.py` の出力先はリポジトリ内の `data/raw/` 固定（0007）。候補は「リポジトリごと暗号化ディスクに置く」か「`p1` だけリポジトリ外を必須にする」（`docs/plan.md`「本人試用の前に行うこと」、
  `docs/status.md`「保留中の判断」）。CLAUDE.md は `p1` の生データをローカルの暗号化ディスクにのみ置くと定める。本人試用は応募期間の外で、時期は決めない（0024）。
- 選択肢: **M5 の前に決める**／ **M5 の中で決める**／ 本人試用の前まで保留のまま（`docs/plan.md` の今の置き場所）。人が決める。

## 関門のレビュー（adversarial-review、base `gate-M3`、39 コミット。2026-11-01 にメインが 1 回回した）

#50 の本文の focus: 検出器が生の音声を保存・送信していないこと（0025 の追記の境界）、評価の 1 回だけ・事前登録、LED の文言。公開の線引きも見た。
生の出力と裏取りは Issue #50 のコメント（生の出力は折りたたみ）と `~/work/zaitaku-mealpace-scratch/issue50/gate-M4-1.txt`。

- verdict: needs-attention、high 2 件。**BLOCKING は無い。** 生の音声の経路・LED の文言と語・公開の線引きへの指摘は無かった。
- 指摘 1（評価の 1 回だけ）: 採点済みの印がチェックアウトごとの固定パスで、採点したコミット `497b066`（採点器と 0041 があり印が無い唯一のコミット）を別の worktree に出して
  同じ `data/raw` を渡すと再採点できる。裏取り: 当たっている（故意の経路。0014・0034・0041 の「塞がっていない経路」の一種。それ以降のコミットには印が入っているので止まる）。
  M4 の採点は 1 回だけ済んでいて数字に影響しない。**人の決定（11/1）: CONCERN、運用で注意。** 0041 の「塞がっていない経路」に追記した。チェックアウト間で共有する台帳は作らない。
- 指摘 2（focus の外。表示）: Linux と MCU の間の RPC が途切れると、MCU に最後の表示（微笑む顔など）が残り続ける。MCU は自律の消灯タイマーを持たない。裏取り: 当たっている
  （0035 の決定で MCU は受け取った状態をそのまま画にするだけで、消灯の規則は Linux 側。PC と Linux の間はハートビート（#47）で塞いだが、Linux と MCU の間は塞がっていない）。
  評価用 `meal` は `--no-rpc` で録ったので M4 の数字に影響しない。影響するのは試用（M5 以降）の表示。**人の決定（11/1）: CONCERN、M5 の前に扱う。** MCU 側に
  「最後の状態の更新から一定時間（2 秒程度）で自律的に消灯」を足す変更を、0035 の決定を改める decision つきで M5 の前に行う。M4 の判定は止めない（下の「M5 の前に決めるか」にも足す）。

## タグ

- 通過なら、人が `gate-M4` タグを打つ。次の関門のレビューの base は `gate-M4`。
- 通過しないなら、`gate-M4` は打たず、`review-M4` を判定のコミットに打つ（0027 の `review-M2` と同じ）。次のレビューは `--base review-M4`。
- どちらにするかは人が決める。#50 を閉じるのも人。

## 確かめていないこと（0041 の追記のまま）

- 取り込み口の差（学習用 `meal` の `arecord` の経路と装置の ALSA）。
- `o start` より前の窓の後処理の状態の持ち越し（0 にはならないが、不一致 0 なので装置と PC で同じ）。
- 押せなかった嚥下・打ち遅れの向きと大きさ（0023）。
- 誤検出が会話・食事の音のどの音で出ているか（推測の裏取り）。日・会話・食事・装着の差の分離（4 本）。

## M5 の後の改善候補（人の観察 2026-11-01。M5 の後に Issue にする）

- 咽喉マイクの試用で、**マイクに手で触れる・手で叩くと必ず誤認識する**ことに人が気づいた（観察。数は数えていない）。M4 の学習データにはマイクへの接触・叩きの音が
  非嚥下として入っていない（0037 の条件別セッションは `quiet`・`water`・`talk`・`saliva`・`neck`・`water`・`cough`。叩きはセッション冒頭の時刻合わせで、記録の範囲の外）。
  改善の候補: 接触・叩きの音を非嚥下の学習データ（hard negative。0038 では「なし」を採った）として集め、学習時に弾く。評価用 `meal` の誤検出 70 回のうち接触によるものが
  いくつかは、FEAT を使わず `events.csv` にも印が無いので分からない（確かめていないこと）。
- 進め方の案（M5 の後）: 条件別セッションに `touch`（手で触れる・叩く）を足して記録 → 学習側に hard negative として入れて CV（0038 と同じ手順）→ 新しい評価側の `meal` を
  録って 1 回だけ採点（0041 の手順）。評価側を見た後の構成の変更に当たるので、新しい評価側が要る（0038、0041 決定 6）。
