owhinata/zaitaku-mealpace/docs/decisions/0041-m4-final-eval-procedure.md

# 0041 M4 の評価側の採点（#49）の手順を、採点の前に固定する（結果は追記）

日付: 2026-11-01　状態: 採用（人の決定 11/1。plan #49。Codex の plan レビューを 4 回通した plan による）。結果は末尾に追記（2026-11-01）

## 前置き

- Issue #49（M4 の評価。評価側を 1 回だけ採点し、M2・M3 と並べる）の事前登録の記録。採点の入口 `analysis/m4_final_eval.py` を実データに走らせるより前に
  書いてコミットする。入口は実行時にこの記録が git に追跡されていて、下の「機械が読む行」が入口の定数 `PROC_LINE` と一字一句一致することを確かめ、
  違えばデータを開かずに止まる。
- 書いた時点で、M4 の評価側（`M4-EVAL` の 4 本）の性能の数字は誰も見ていない。4 本の `detect.csv`・`feat.csv` は時刻の列だけが読まれ
  （0037 の追記 2026-11-01）、`positive`・`prob`・`led`・FEAT の値は誰も出していない。
- この記録は 0037・0038・`docs/evaluation.md` を変えない。0021 の記録の範囲の始まりを、咽喉マイクの `meal` の決まり（0031・0037 の 5「区切り」）に
  合わせて読み替える（下の 2）。
- 判定（#50）はこの記録ではしない。この記録は判定の材料の出し方を決める。

## 決定

### 1. 対象と構成

- 対象: 0037 の `M4-EVAL` の 4 本（`fixed_eval.M4_EXPECTED_EVAL`、この順）。`evaluate_detector.scan_root` は使わない（0037 の #49 への申し送り）。
  `root` のほかのセッション（M2 の `meal`・学習用 `meal` を含む）は見ない。
- 構成: 0038 の `M4-CONFIG`・`M4-MODEL`（CNN `mfe40` 種 0・1・2 の平均、ヒステリシス 入り 0.85・出 0.65、不応期 0.5 秒、塊の上限なし）。
  採点するのは装置の `detect.csv` の `positive`（0038 の後処理の出力。評価の数字は装置の出力。0037 の 4）。PC で採点し直した値で数字を出さない。
  0038 の報告の表のほかの行（P4 を含む）・ほかの閾値は評価側で採点しない。
- 合格線: `docs/evaluation.md` 29 行目（M2 の行）の数字を M4 に当てる（`docs/plan.md` の M4）。検出率 0.85 以上、誤検出率 1.0 回/分以下。
  報告は「満たす / 満たさない」と書く。

### 2. 記録の範囲（0021 の始まりの読み替え）

- **始まり = `events.csv` の `o start`**（`label` が `o` で、`note` が前後の空白を除いて `start` の行の `t_ms`。装置の時計）。0031・0037 の 5「区切り」の
  「学習用・評価用とも `o start` から後が記録の範囲」に合わせる。0021 の「最初の窓の開始」は使わない。
- 終わり = 0021 のまま（`detect.csv` の全行の `t_ms`、全行の `window_t_ms + 1000`、`feat.csv` の全行の `t_ms` の最大）。長さ = 終わり − `o start`。
- **採点に入れる窓 = 開始 `w` が `o start` 以上の窓**（窓の全体が範囲の内）。
- 採点と切り分け（下の 3・5）は、範囲の内の行だけを持つ `SessionData`（`rows` を範囲の内の窓に、始まりを `o start`、長さを上の値にしたもの）に当てる。
  `c` の時刻と、`classify_run` に渡す `t`・`c`・`n` の時刻も `o start` 以上に絞る。`o start` より前の窓の数は報告に出す。
- 装置の後処理と LED（目安）の状態は最初の窓から続いている。`o start` より前の窓の状態が後に持ち越されることは補正しない（注記）。
- 窓・ホップ・数え方（`[t − 0.5, t + 1.5]`、塊の間隔 `HOP_S × 1.5` 以下、非嚥下区間、回数の合算）は `docs/evaluation.md`・0011 のまま。

### 3. 出す数字（どれも同じ 1 回の実行で出す）

1. 主な数字: セッションごとの表（収集日、会話の有無、`s`、検出、検出率、誤検出の回数、非嚥下の分、誤検出率、範囲の内の陽性窓 / 全窓、`o start` より前の窓の数、
   `feat.csv` に無い窓の数、`meta.json` の `marker_offset_shift_max_ms`）。合算（`evaluate.aggregate`。キーは `M4-EVAL` の順）の検出率・誤検出率、
   評価に使ったセッション一覧、混同行列（イベント単位。TP / FN / FP。TN は定義しないので出さない）。合格線との比較（満たす / 満たさない）。
2. 参考値（0011「既知の弱点」）: 範囲の内の全窓を陽性にした場合（常時陽性）の数字、陽性窓の割合。収集日ごと・会話の有無ごとの合算（3 セッション未満でも出す）。
   評価側の収集日の数と、0037 の「2 日以上」を満たすか（止めない）。
3. 装置と PC の一致（下の 4）。
4. 届かなかった場合の切り分け（下の 5）。合格線を満たす・満たさないによらず出す。
5. M2（0027）・M3 構成 J（0034・0036）・M4・参考の M4 学習側 CV（0038。楽観側）を並べる表（0037 の 6）。M2・M3・学習側 CV の列は 0027・0036・0038 の本文の
   数字を入口の定数に写したもの（テストで本文と照らす）。注記: M4 と同じ条件（`meal`・0023・同じ合格線）で比べられるのは M2。M3 は条件別のセッションで
   `s` の決まりも違う。M4 の手法は `docs/evaluation.md` 29 行目・28 行目・8 行目からの記録した逸脱（0038）。
6. 注記（固定の文）: `s` は押せた嚥下だけ（0023）。ALSA・USB・arecord の中の測れない固定の遅れ（125 ms 程度までの推測）は補正していない（0037 の追記 10/29）。
   `events.csv` の `t_ms` は PC の受信時刻を `offset` で装置の時計に直した値。記録の範囲の始まりは `o start`。FEAT は使っていない。LED は嚥下の「目安」で
   評価には使わない（0018）。評価側の採点は 1 回だけ。

### 4. 装置と PC の一致（全窓。`o start` より前の窓を含む）

- `positive` の再計算: `m4_infer.parse_config(M4_CONFIG)` の値で `postprocess.PostStepper` を窓ごとに回した出力（`step(prob, True, k × 0.25)`。`k` は窓の番号。
  装置の `Detector.step` と同じ呼び方）と、`post_mask` の一括の出力の両方を作る。両者が一致しなければ止める（コードの不整合）。一致したら、装置の `positive` との
  不一致の行数（装置 1 / PC 0、装置 0 / PC 1）を数える。
- 丸めの候補の窓: `|prob − 0.85|` か `|prob − 0.65|` が 1e-8 以下の窓の数（`prob` は 9 桁の有効数字で書かれているので比較が変わりうる窓）。不一致の行数と並べて
  出し、原因は断定しない。
- `led` の再計算: `led_rule.LedStepper` を窓ごとに回した出力（`step(window_t_ms, 装置の positive)`）と `evaluate_detector.led_mismatch`（`led_states`）の両方で、
  装置の `led` との不一致の行数。
- 一致しなくても止めない（M2 と同じ。数を報告に出す）。

### 5. 切り分けの定義（範囲の内の `SessionData` に当てる）

- 誤検出の主分類: 範囲の内の誤検出の塊ごとに `m4_compare.classify_run`（0038 の学習側の誤検出の内訳と同じ定義。排他: 嚥下の直後の延び / 嚥下の直前 /
  動作に付くもの（`t`・`c`・`n`）/ `meal` の会話あり / `meal` の会話なし / その他）。主分類 × セッション、主分類 × 会話の有無の表と、「動作に付くもの」の副表
  （マーカーの種類ごと。重複あり）。主分類の合計が誤検出の回数と一致しなければ、数字を出す前に止める。
- 条件別: 会話あり / なしの誤検出率と、学習側 CV の `meal` だけの数字（0038。楽観側）を並べる。
- 嚥下の直後の延び: 主分類「嚥下の直後の延び」の回数と、陽性の塊の長さの中央値・最大。塊の長さ = 窓の数 × 0.25 秒（最後の窓の開始 − 最初の窓の開始 + 0.25 秒）。
  「嚥下を含む塊」= 窓の中心が `s` の `[t − 0.5, t + 1.5]` に入る窓を 1 つ以上含む塊、「誤検出の塊」= 誤検出に数えた塊。両方に入る塊がある（延びた塊）。
- `c` に紐づく誤検出の塊: `evaluate_detector.cough_linked`（M2 と同じ定義。塊の最初の窓の中心 − `t_c` が `[−1.0, +5.0]` 秒）。
- 見逃し（FN）: 見逃した `s` のうち、`[t − 3.0, t + 3.0]` 秒に中心がある陽性窓（範囲の内の装置の `positive`）がある数 / 無い数。±3.0 秒は切り分けの参考で、
  評価の定義ではない。**`prob` を使った見逃しの内訳はしない**（0038「評価側を見た後に閾値を変えない」の趣旨。閾値の近さの議論を評価側で始めない）。
- 装置と PC の差: 上の 4 の数と、#47 の再生モードの一致（学習用 `meal`、docs/log/2026-10-29.md「#47」）を引く 1 行。
- **FEAT は #49 では使わない。** `feat.csv` はファイルとしては読むが、各行の先頭 2 列（`t_ms`・`window_t_ms`。0021 の記録の範囲と、窓が `detect.csv` の部分集合で
  あることの検査）のほかは保持も変換も計算も出力もしない。0037 の 4「FEAT は #49 の 1 回の採点の後に、原因の切り分けにだけ使う」のうち、#49 の採点の中では
  使わないと決める（plan #49 のレビューの指摘 1。取り込み口の差は下の「確かめていないこと」）。

### 6. 1 回だけ（0037 の 7）と順序の約束

1. この記録と入口のコードのコミットより前に評価側を開かない。
2. 印 `docs/log/m4-final-49.txt`（固定のパス）の作成より前に、評価側 4 本のファイルを 1 つも開かない（`meta.json`・`events.csv` も）。印の前に見るのは、
   リポジトリの中のもの（git・決定の行・定数・重み・`DEPLOY_FILES`）と、`root` 直下に 4 本の名前のフォルダがあること（`lstat` だけ）。
3. 印は `O_EXCL` で排他作成し、書き込み・fsync・close（親のディレクトリも fsync）の後に評価側を開く。中身は実行の開始時刻・HEAD のコミット・決定（0037・0038・0041）・
   コマンド・4 本の名前だけで、数字は書かない。
4. 印の後、最初の数字を出す前に検査を全部済ませる（下の 7）。検査に当たったら、数字を 1 つも出さずに止まる。
5. 印の後に止まっても、印は消さず、固定のパスに残す（移さない・名前を変えない）。止まったときは出力と経緯を log に書き、その後どうするかは人が決め、この記録に追記する。
   事前に「もう 1 回」は決めない。**再採点は 0037 の 7（採点は 1 回だけ）の変更に当たる。するなら、数字が 1 つも出ていないときに限り、新しい記録で 0037 との関係を
   書いてから**（人の決定 11/1）。数字が 1 つでも出た後は採点し直さない。
6. 印の後に、構成・閾値・後処理・種・記録の範囲の定義・切り分けの定義を変えない（0038・0037 の 4・この記録）。印の後に追加の解析をするときは、別のスクリプトで
   「探索的（評価側を見た後）」と明記し、M4 の数字の差し替え・構成の選択に使わない。

### 7. 止まる条件

- 印の前（評価側を 1 つも開かない。印も作らない）: 追跡しているファイルに未コミットの変更がある、`analysis/`・`tools/`・`device/`・`docs/decisions/`・
  `docs/evaluation.md` に未コミットの変更か未追跡のファイルがある、git が使えない、0037・0038・この記録が無い・追跡されていない、0037 の `M4-` の行・0038 の
  `M4-CONFIG`・`M4-MODEL` の行・この記録の `M4-EVAL-PROC:` の行が定数と違う、`M4_EXPECTED_EVAL` が無い・`assert_m4_eval` に当たる、印がある（リンクを含む）、
  依存を import できない、重みの sha256 が `M4-MODEL` と違う、4 本のフォルダが無い・ディレクトリでない・シンボリックリンク。
- 印の後・数字の前（印は残す。出力は「未完了」）: `meta.json` の照合（`subject` `self`・`cond` `meal`・`fw` `unoq-detector`・`m4_config`・`model.sha256`・
  `feature_set`・`feature_names`・`rpc` が false・`window_ms` 1000・`hop_ms` 250・`unoq_detector.header.code_sha256` が手元の `DEPLOY_FILES` の値と一致）、
  `o start` がちょうど 1 つでない・最初の窓より前・終わり以降、`o start` より前に `s`・`t`・`c`、終わりの 1.5 秒以内の `s`（0037 の 5 の 5・6）、
  `detect.csv`・`feat.csv` の形と時刻（0021 の条件）、`feat.csv` の窓が `detect.csv` の部分集合でない、窓の隣との差が 250 ms でない、範囲の外の `s`、
  `PostStepper` と `post_mask` の不一致、誤検出の主分類の合計の不一致。
- 印の後の書き出しの失敗（実行の条件・報告を標準出力に書く・flush するときの失敗。容量不足・パイプの切断など）も止まる条件に入る。印は残り、
  出力は「未完了」（標準エラーに段の名前と例外の型の名前だけ。終了コード 0 以外）。途中まで出た報告は完成した報告として扱わない。
  標準出力が閉じていても終了コードは 1 で、終了時の再 flush のメッセージを出さない（失敗した出力先の記述子を `/dev/null` に差し替える）。
- 印の後の診断は、ファイル名・行番号・列名・条件の名前だけ。値・行の中身・例外のメッセージ・トレースバックを出さない（それ以外の例外は型の名前だけ）。

### 8. 機械が読む行

`analysis/m4_final_eval.py` が実行時にこの記録の `M4-EVAL-PROC:` で始まる行（ちょうど 1 行）を読み、定数 `PROC_LINE` と一字一句一致しなければ、データを開かずに止まる。
この行は定義の名前の一致を確かめるだけで、細部（上の 2・4・5 の境）の自動の検証ではない。細部とコードの対応はコミット前のレビューで見る。

```
M4-EVAL-PROC: range=o-start windows=start>=o-start device-agree=poststepper,ledstepper breakdown=classify_run,cough_linked,fn_near3s,run_length feat=unused prob-breakdown=none
```

- この行は `M4-` で始まるが、`fixed_eval.m4_lines_match` が読むのは 0037 の本文だけなので、0037 の照合と衝突しない（テストで確かめる）。

## `docs/evaluation.md` との関係

- 定義と合格線は変えない。M4 の手法の逸脱（29 行目・28 行目・8 行目）は 0038 に記録済み。
- 記録の範囲の始まりを `o start` にするのは 0021（検出器のセッションの記録の範囲の読み替え）の始まりの部分の読み替えで、0031・0037 の 5 に合わせる。
  窓・数え方・非嚥下区間・セッション単位の分割・3 セッション以上は変えない。

## 結果の記録の形

- `docs/log/2026-11-0X.md`「#49 M4 の評価側の採点（1 回だけ）」に、実行の条件（コミット、コマンド、印の中身、終了コード）と、標準出力と標準エラーを合わせて保存した
  出力の全文（最後の `exit=` の行まで。一字も変えない）を貼る。止まったなら、その事実と標準エラーの `未完了:` の行（完成した報告として扱わない）。
- この記録の末尾の「結果（追記）」に、合算の検出率・誤検出率と混同行列、評価に使ったセッション一覧、合格線との比較（満たす / 満たさない）、M2・M3 と並べる表、
  切り分けの要点（事実だけ。読みは「推測」と書く）、確かめていないこと。数字は出力から写し、log の節を引く。判定の選択肢は書くが、選ばない（#50 は人が別の記録で判定する）。

## 選ばなかった案

- 記録の範囲の始まりを 0021 のまま最初の窓の開始にする: 咽喉マイクの `meal` の区切り（0031・0037 の 5）と合わず、`o start` の前（装着と準備の間）が非嚥下区間に入る。
- 印の前に `meta.json`・`events.csv` を読んで照合する: 0037 の申し送り「評価側のファイルを開く前に印」に反する。
- 切り分けを、合格線に届かなかったときだけ別の実行で出す: 出すかどうかが結果で決まり、2 回目の実行が要る。
- 見逃しの内訳に `prob` を使う（閾値の近さ）: 評価側を見た後に閾値の議論を始める経路になる。
- FEAT を #49 の採点の中で使う（集計を出す）: FEAT の値や集計を `data/raw/` の外に出す経路になり、見た後に構成を変える材料にもなりうる（plan #49 のレビューの指摘 1）。
- 図を描く: Issue の範囲（数字と切り分け）に要らない。

## 塞がっていない経路（運用で注意）

- 印を消す、別の場所でコードを変えて走らせる、`data/raw/` のファイルを差し替える、入口の関数を Python から直接呼ぶ（`run` の `_sink` はテストのための口）、
  などの故意の経路はコードでは塞がない（0014・0034 と同じ）。
- 追記（2026-11-01、関門 #50 のレビューの指摘 1。人の決定: CONCERN、運用で注意）: 印はチェックアウトごとの固定パスなので、採点したコミット `497b066`（採点器と
  この記録があり、印がまだ無い唯一のコミット）を別の worktree に出して同じ `data/raw` を渡すと、git と印の検査を通って再採点できる。それ以降のコミットには印が入っているので
  止まる。チェックアウト間で共有する台帳は作らない（故意の経路。M4 の採点は 1 回だけ済んでいて、この経路を使った再採点は 0037 の 7 の変更に当たる）。

## 確かめていないこと

- 取り込み口の差: 学習用 `meal`（PC の経路、`arecord`）と評価用 `meal`（装置、ALSA から `detector.py`）で入力の大きさ・間引きが同じ値を出すか（0037「確かめていないこと」の
  まま。#49 では FEAT を使わないので調べない）。
- `o start` より前の窓の後処理の状態が範囲の内に持ち越されることの影響（補正しない）。
- 9 桁の有効数字の丸めによる装置と PC の比較の差（丸めの候補の窓の数を出すだけで、原因は断定しない）。
- 押せなかった嚥下・打ち遅れの向きと大きさ（0023）。

## 影響する場所

`analysis/m4_final_eval.py`・`analysis/test_m4_final_eval.py`（新規）、`analysis/README.md`、`docs/log/`（印 `docs/log/m4-final-49.txt` と採点の log）、`docs/status.md`。
`docs/evaluation.md`、0011・0021・0023・0031・0034・0037・0038 の本文、`evaluate_detector.py`・`evaluate.py`・`postprocess.py`・`led_rule.py`・`m4_infer.py`・
`m4_compare.py`・`fixed_eval.py`・`final_eval.py`・`split.py`、`device/unoq/`、`tools/`、`docs/data-schema.md`、`analysis/models/` は変えない。

## 結果（追記 2026-11-01）

採点は 2026-11-01 16:23 に 1 回だけ実行した（コミット `497b066`、印 `docs/log/m4-final-49.txt`、終了コード 0、`完了:` の行あり）。出力の全文は docs/log/2026-11-01.md
「#49 M4 の評価側の採点（1 回だけ）」。数字はそこから写した。判定（#50）はこの記録ではしない。

### 合算と合格線

- 評価に使ったセッション（4 本、収集日 3 日）: `20261030-201124_self_meal`（会話あり）、`20261031-145803_self_meal`（会話あり）、`20261031-195410_self_meal`（会話なし）、
  `20261101-134412_self_meal`（会話なし）。
- 検出率 0.957（199/208）。合格線 0.85 以上: **満たす**。
- 誤検出率 1.25 回/分（70 回 / 非嚥下 56.00 分）。合格線 1.0 回/分以下: **満たさない**。
- 混同行列（イベント単位。TN は定義しない）: TP 199、FN 9、FP 70（回）。
- 参考値: 常時陽性の場合は検出率 1.000（208/208）・誤検出率 0.07 回/分（4 回。長い陽性 1 つが塊 1 つに数えられるため）、陽性窓の割合 0.077（1156/15081）。

| セッション | 会話 | `s` | 検出 | 検出率 | 誤検出（回） | 非嚥下（分） | 誤検出率（回/分） |
|---|---|---|---|---|---|---|---|
| `20261030-201124_self_meal` | あり | 53 | 49 | 0.925 | 26 | 15.12 | 1.72 |
| `20261031-145803_self_meal` | あり | 50 | 50 | 1.000 | 17 | 12.41 | 1.37 |
| `20261031-195410_self_meal` | なし | 51 | 51 | 1.000 | 22 | 16.15 | 1.36 |
| `20261101-134412_self_meal` | なし | 54 | 49 | 0.907 | 5 | 12.33 | 0.41 |

### M2・M3 と並べる（0037 の 6）

| | M2（0027） | M3 構成 J（0034・0036） | M4（この採点） | 参考: M4 学習側 CV（0038。楽観側） |
|---|---|---|---|---|
| 評価側 | `meal` 3 本・3 収集日 | 条件別 7 本・1 収集日 | `meal` 4 本・3 収集日 | 26 本・収集日ごとの CV |
| `s` の決まり | 0023 | M1（すべての嚥下） | 0023 | 混在 |
| 検出率 | 0.150（21/140） | 1.000（30/30） | 0.957（199/208） | 0.955（338/354） |
| 誤検出率 | 2.03 回/分 | 1.19 回/分 | 1.25 回/分 | 0.86 回/分 |
| 合格線 | 85% / 1 回/分 | 70% / 3 回/分（分岐点） | 85% / 1 回/分 | （判定に使わない） |

M4 と同じ条件（`meal`・0023・同じ合格線）で比べられるのは M2。M3 は条件別で `s` の決まりも違う。学習側 CV の `meal` だけの数字（0.973 / 1.25 回/分）と評価側（0.957 / 1.25 回/分）は近い。

### 切り分けの要点（事実。読みは「推測」と書く）

- 装置と PC の一致: `positive`・`led` とも 15200 窓で不一致 0、丸めの候補の窓 0。装置の出力と PC の再計算の差は無い。
- 会話の有無: 会話あり 1.56 回/分（43 回 / 27.52 分）、会話なし 0.95 回/分（27 回 / 28.48 分）。会話ありの 2 本はどちらも合格線の外、会話なしは 1 本が外（1.36）・1 本が内（0.41）。
- 誤検出 70 回の主分類（0038 の学習側と同じ定義）: `meal` の会話あり 26、`meal` の会話なし 22、嚥下の直後の延び 10、嚥下の直前 6、動作に付くもの 6（`c` 5・`t` 1）、その他 0。
  `meal` の会話なし 22 のうち 18 は `20261031-195410`（会話なしの 1 本目）に集まっている。
- `c` 4 回に紐づく誤検出の塊 6（`c` 4/4 に 1 つ以上）。
- 見逃し 9 回のうち、±3 秒に陽性窓があるもの 6、無いもの 3。
- 陽性の塊の長さ: 嚥下を含む塊 199 個（中央値 1.25 秒・最大 2.50 秒）、誤検出の塊 70 個（中央値 1.00 秒・最大 2.50 秒）。
- 推測: 合格線に届かない分は、会話の音（会話ありの 2 本で 26 回）と、会話なしでも食事の音（咀嚼・食器など。`20261031-195410` の 18 回）に装置が反応したもの。嚥下の直後の延び・直前・動作に付くものは
  合わせて 22 回で、不応期 0.5 秒と塊の数え方（0011）で吸収しきれていない分がある。マーカー側の要因（打ち忘れ・打ち遅れの体感は 4 本とも「数回」）は向きと大きさを確定できない。
  取り込み口の差は調べていない（FEAT を使わない）。

### 判定の選択肢（#50。人が別の記録で決める。ここでは選ばない）

- M4 の合格線を**満たさない**（検出率は満たすが誤検出率が 1.25 回/分）と判定し、誤検出の内訳（会話・食事の音）を次の手の材料にする。
- 合格線の一方（検出率）を満たし、誤検出率が M2（2.03）・M3（1.19、条件別）と並べてどの位置かを踏まえて、試用（M5 以降）に進めるかを別に決める。
- どちらでも、評価側を見た後に構成・閾値・後処理を変えて採点し直すことはしない（0038、この記録の 6）。

### 確かめていないこと（結果を見た後も同じ）

- 取り込み口の差（学習用 `meal` の `arecord` の経路と装置の ALSA）。`o start` より前の窓の後処理の状態の持ち越し（0 にはならないが、不一致 0 なので装置と PC で同じ）。
  9 桁の丸め（候補の窓 0）。押せなかった嚥下・打ち遅れの向きと大きさ（0023）。
