owhinata/zaitaku-mealpace/docs/log/2026-10-31.md

# 2026-10-31

## #48 評価用 `meal` 2 本目（評価用の収集日 2、同じ日の 1 本目）

- M4 の評価用 `meal`（docs/decisions/0037 と追記 10/29。3 本以上・収集日 2 日以上、窓は 10/29〜11/1、打ち切り 11/1 の終わり）。装置の経路
  （`record.py --unoq-detector --feat --no-rpc --cond meal --duration 1800`、#47）。手順は `docs/recording-protocol.md`「評価用 `meal` の記録（装置の経路）」。被験者 `self`。
  1 本目は docs/log/2026-10-30.md。生の音声はどこにも残っていない。
- `tools/unoq_session_check.py` の数字は人が実行した出力から写した。マーカーの数は `events.csv`、記録の形は `meta.json` から写した（`detect.csv`・`feat.csv` は時刻の列だけ。
  陽性・`prob`・`led`・FEAT の値は出していない）。採否は人が記録の直後に決めた（下の「人の決定（10/31）」）。
- 装着の側は M3 と同じ側。叩きはしない。マトリクスは `--no-rpc` で消灯のまま（起動直後の消灯を人が目で確かめて Enter）。

| セッション | 条件 | 長さ（秒） | 止まり方 | 会話 | 同席者 | `s` | `t` | `c` | `o`（start / conv / その他の note） | 窓の数 | 取りこぼし | 逆行・1000 ms 超の飛び | 受信の遅れ `delay_meas`（中央値 / 最大 ms） | 時計（`anchor_spread_ms` / `clock_drift_max_ms`） | 構成の識別子 | FEAT の次元 | 使わない目安 | 打ち忘れの体感 | 打ち遅れの体感 | 記録時の `s` の決まり | 採否と理由 |
|---|---|---|---|---|---|---|---|---|---|---|---|---|---|---|---|---|---|---|---|---|---|
| `20261031-145803_self_meal` | meal | 850.2 | interrupt（食べ終わって Ctrl-C。検出器 eof） | あり | あり | 50 | 0 | 1 | 1 / 1 / 0 | 3397 | 0 窓（0.00%） | 0 箇所 | 230.0 / 412 | 0.143 / 1.216（`clock_drift_min_ms` −10.74） | 0038（`mfe40` CNN 種 0・1・2、hyst 0.85 / 0.65、不応期 0.5 秒） | 82（`m4-0037-feat82`） | 当たらない | 数回 | 数回 | 0023（意識した食べ物・飲み物の嚥下に `s`） | 採用（人の決定 10/31、数字を見る前） |

- `o start` は 1 つ（6.6 秒）で、その前に `s`・`t`・`c` は無い。`o conv` は `o start` の 3.3 秒後（会話あり）。`t` は 0（会話ありだが話し始めのキーは打たれていない。`meal` では捨てる理由にしない）。
  `o start` から記録の終端まで 14.1 分。最初の `s` は `o start` の 33.2 秒後、最後の `s` は終端の 7.9 秒前（0037 の 5 の 6「終わりの 1.5 秒以内の `s`」に当たらない）。
  `s` の間隔 10 秒未満は 17 組（`meal` では制限なし）。`wrong key` 0。
- 捨てる条件（0037 の 5、装置）1〜9: `unoq_session_check.py` の出力で 1〜8 は「当たらない」、9 は `wrong key` 0 で `s` に関わるものなし。条件 4 は `delay_meas` の最大 412 ms（規則 1000 ms）、
  時計は `anchor_spread_ms` 0.143・`clock_drift_min_ms` −10.74・`clock_drift_max_ms` 1.216（規則 250）で当たらない。`delay_upper` は中央値 921.1・最大 1103.1 ms（ssh の往復時間の最大 691.1 ms。
  記録の後の測定 10 回のうち 1 回だけ大きく、ほかは 3 ms 前後。値だけで判定に使わない）。
- 装置の動作: 読めない行 0、overrun の行 0、RPC の失敗 0（RPC なし）、行の途切れ 0 回、ハートビート 1703 回・書き込みの失敗 0、最初の窓までの待ち 2.1 秒。
  1 ホップの `proc_ms` 中央値 63.6・95 パーセンタイル 67.1・最大 79.4 ms（RPC なし。0040 の目安 125 / 250 ms に当たらない）、`e2e_ms` 中央値 189.0・最大 208 ms（装置の時計。固定の遅れの分だけ小さく出る）。
- `meta.json`: `fw` `unoq-detector`、`m4_config` は 0038 と同じ、`model.sha256` `c786086f…` = 0038 の `M4-MODEL`、H 行の `code_sha256` `7b98bde5…` = 10/29 夜に配り直した PC の値（1 本目と同じ）、
  `sensors[0].iface` `sh12jk-wired-unoq-usbaudio`、`position` `lateral-below-cricoid`、`band` `sh12jk-strap`、`mixer` Mic 58・on、`rpc` false、`stop` `interrupt`、`bad_lines` 0。
- 評価用 `meal` の累計: 2 本（10/30 会話あり、10/31 会話あり）、収集日 2 日、`s` の合計 103、`o start` から後の合計 31.0 分。目安の残り: 1 本以上（会話なしが望ましい）。収集日の目安（2 日以上）は満たした。
  打ち切りは 11/1 の終わり。

### 人の決定（10/31）

- `20261031-145803_self_meal` は**採用**（数字を見る前。捨てる条件に当たらず、`wrong key` 0）。打ち忘れ・打ち遅れの体感はどちらも「数回」。同席者あり。

## #48 評価用 `meal` 3 本目（評価用の収集日 2、同じ日の 2 本目。会話なし）

- 同じ日の 2 食目（上の 2 本目と同じ経路・手順・装着の側。食事ごとに付け直した）。1 食を複数のセッションに分けたものではない。
- `tools/unoq_session_check.py` の数字は人が実行した出力から写した。マーカーの数は `events.csv`、記録の形は `meta.json` から写した（`detect.csv`・`feat.csv` は時刻の列だけ。
  陽性・`prob`・`led`・FEAT の値は出していない）。採否は人が記録の直後に決めた（下の「人の決定（10/31、3 本目）」）。

| セッション | 条件 | 長さ（秒） | 止まり方 | 会話 | 同席者 | `s` | `t` | `c` | `o`（start / conv / その他の note） | 窓の数 | 取りこぼし | 逆行・1000 ms 超の飛び | 受信の遅れ `delay_meas`（中央値 / 最大 ms） | 時計（`anchor_spread_ms` / `clock_drift_max_ms`） | 構成の識別子 | FEAT の次元 | 使わない目安 | 打ち忘れの体感 | 打ち遅れの体感 | 記録時の `s` の決まり | 採否と理由 |
|---|---|---|---|---|---|---|---|---|---|---|---|---|---|---|---|---|---|---|---|---|---|
| `20261031-195410_self_meal` | meal | 1075.9 | interrupt（食べ終わって Ctrl-C。検出器 eof） | なし | なし | 51 | 0 | 1 | 1 / 0 / 0 | 4300 | 0 窓（0.00%） | 0 箇所 | 223.0 / 513 | 0.739 / 12.469（`clock_drift_min_ms` −2.022） | 0038（`mfe40` CNN 種 0・1・2、hyst 0.85 / 0.65、不応期 0.5 秒） | 82（`m4-0037-feat82`） | 当たらない | 数回 | 数回 | 0023（意識した食べ物・飲み物の嚥下に `s`） | 採用（人の決定 10/31、数字を見る前） |

- `o start` は 1 つ（7.8 秒）で、その前に `s`・`t`・`c` は無い。`o conv` は無い（会話なし）。`o start` から記録の終端まで 17.8 分。最初の `s` は `o start` の 47.4 秒後、
  最後の `s` は終端の 8.8 秒前（0037 の 5 の 6「終わりの 1.5 秒以内の `s`」に当たらない）。`s` の間隔 10 秒未満は 19 組（`meal` では制限なし）。`wrong key` 0。
- 捨てる条件（0037 の 5、装置）1〜9: `unoq_session_check.py` の出力で 1〜8 は「当たらない」、9 は `wrong key` 0 で `s` に関わるものなし。条件 4 は `delay_meas` の最大 513 ms（規則 1000 ms）、
  時計は `anchor_spread_ms` 0.739・`clock_drift_min_ms` −2.022・`clock_drift_max_ms` 12.469（規則 250）で当たらない。`delay_upper` は中央値 927.8・最大 1217.8 ms（ssh の往復時間の最大 704.8 ms。
  記録の後の測定 10 回のうち 1 回だけ大きく、ほかは 2〜3 ms。値だけで判定に使わない）。`marker_offset_shift_max_ms` 8。
- 装置の動作: 読めない行 0、overrun の行 0、RPC の失敗 0（RPC なし）、行の途切れ 0 回、ハートビート 2154 回・書き込みの失敗 0、最初の窓までの待ち 2.1 秒。
  1 ホップの `proc_ms` 中央値 63.6・95 パーセンタイル 67.0・最大 78.2 ms（RPC なし。0040 の目安 125 / 250 ms に当たらない）、`e2e_ms` 中央値 196.0・最大 213 ms（装置の時計。固定の遅れの分だけ小さく出る）。
- `meta.json`: `fw` `unoq-detector`、`m4_config` は 0038 と同じ、`model.sha256` `c786086f…` = 0038 の `M4-MODEL`、H 行の `code_sha256` `7b98bde5…`（1・2 本目と同じ）、
  `sensors[0].iface` `sh12jk-wired-unoq-usbaudio`、`position` `lateral-below-cricoid`、`band` `sh12jk-strap`、`mixer` Mic 58・on、`rpc` false、`stop` `interrupt`、`bad_lines` 0。
- 評価用 `meal` の累計: 3 本（10/30 会話あり、10/31 会話あり、10/31 会話なし）、収集日 2 日、`s` の合計 154、`o start` から後の合計 48.8 分。0037 の目安（3 本以上・収集日 2 日以上・
  会話なし 1・会話あり 1）をすべて満たした。打ち切りは 11/1 の終わりで、それまでに録った採用分はすべて評価側にする（本数で早く止める規則は置かない。0037 の追記 10/29）。

### 人の決定（10/31、3 本目）

- `20261031-195410_self_meal` は**採用**（数字を見る前。捨てる条件に当たらず、`wrong key` 0）。打ち忘れ・打ち遅れの体感はどちらも「数回」。同席者なし。
