owhinata/zaitaku-mealpace/docs/log/2026-10-30.md

# 2026-10-30

## #48 評価用 `meal` 1 本目（評価用の収集日 1）

- M4 の評価用 `meal`（docs/decisions/0037 と追記 10/29。3 本以上・収集日 2 日以上、窓は 10/29〜11/1、打ち切り 11/1 の終わり）。装置の経路
  （`record.py --unoq-detector --feat --no-rpc --cond meal --duration 1800`、#47）。手順は `docs/recording-protocol.md`「評価用 `meal` の記録（装置の経路）」。被験者 `self`。
  生の音声はどこにも残っていない（UNO Q はメモリで特徴量にして捨て、PC には `detect.csv`・`detect_rx.csv`・`feat.csv`・`events.csv`・`meta.json` だけ）。
- `tools/unoq_session_check.py` の数字は人が実行した出力から写した。マーカーの数は `events.csv`、記録の形は `meta.json` から写した（`detect.csv`・`feat.csv` は時刻の列だけ。
  陽性・`prob`・`led`・FEAT の値は出していない）。採否は人が記録の直後に決めた（下の「人の決定（10/30）」）。
- 装着の側は M3 と同じ側。叩きはしない（評価用。0037 の追記）。マトリクスは `--no-rpc` で消灯のまま（起動直後の消灯を人が目で確かめて Enter）。

| セッション | 条件 | 長さ（秒） | 止まり方 | 会話 | 同席者 | `s` | `t` | `c` | `o`（start / conv / その他の note） | 窓の数 | 取りこぼし | 逆行・1000 ms 超の飛び | 受信の遅れ `delay_meas`（中央値 / 最大 ms） | 時計（`anchor_spread_ms` / `clock_drift_max_ms`） | 構成の識別子 | FEAT の次元 | 使わない目安 | 打ち忘れの体感 | 打ち遅れの体感 | 記録時の `s` の決まり | 採否と理由 |
|---|---|---|---|---|---|---|---|---|---|---|---|---|---|---|---|---|---|---|---|---|---|
| `20261030-201124_self_meal` | meal | 1023.0 | interrupt（食べ終わって Ctrl-C。検出器 eof） | あり | あり | 53 | 8 | 2 | 1 / 1 / 1（`late`） | 4088 | 0 窓（0.00%） | 0 箇所 | 251.0 / 564 | 0.12 / 18.036 | 0038（`mfe40` CNN 種 0・1・2、hyst 0.85 / 0.65、不応期 0.5 秒） | 82（`m4-0037-feat82`） | 当たらない | 数回 | 数回 | 0023（意識した食べ物・飲み物の嚥下に `s`） | 採用（人の決定 10/30、数字を見る前） |

- `o start` は 1 つ（10.7 秒）で、その前に `s`・`t`・`c` は無い。`o conv` は `o start` の 3.2 秒後（会話あり）。`o` の note `late` が 311.1 秒に 1 つ（打ち遅れの自己申告。
  `meal` では打ち遅れで捨てない、0023）。`o start` から記録の終端まで 16.9 分。最初の `s` は `o start` の 40.0 秒後、最後の `s` は終端の 8.6 秒前（0037 の 5 の 6「終わりの 1.5 秒以内の `s`」に
  当たらない）。`s` の間隔 10 秒未満は 15 組（`meal` では制限なし）。`wrong key` 0。
- 捨てる条件（0037 の 5、装置）1〜9: `unoq_session_check.py` の出力で 1〜8 は「当たらない」、9 は `wrong key` 0 で `s` に関わるものなし。条件 4 は `delay_meas` の最大 564 ms（規則 1000 ms）、
  時計は `anchor_spread_ms` 0.12・`clock_drift_min_ms` 0.0・`clock_drift_max_ms` 18.036（規則 250）で当たらない。`delay_upper` は中央値 1096.6・最大 1409.6 ms（ssh の往復時間の最大 845.6 ms。
  値だけで判定に使わない）。
- 装置の動作: 読めない行 0、overrun の行 0、RPC の失敗 0（RPC なし）、行の途切れ 0 回、ハートビート 2047 回・書き込みの失敗 0、最初の窓までの待ち 2.1 秒。
  1 ホップの `proc_ms` 中央値 63.8・95 パーセンタイル 69.1・最大 77.2 ms（RPC なし。0040 の目安 125 / 250 ms に当たらない）、`e2e_ms` 中央値 205.0・最大 222 ms（装置の時計。固定の遅れの分だけ小さく出る）。
- `meta.json`: `fw` `unoq-detector`、`m4_config` は 0038 と同じ、`model.sha256` `c786086f…` = 0038 の `M4-MODEL`、H 行の `code_sha256` `7b98bde5…` = 10/29 夜に配り直した PC の値、
  `sensors[0].iface` `sh12jk-wired-unoq-usbaudio`、`position` `lateral-below-cricoid`、`band` `sh12jk-strap`、`mixer` Mic 58・on、`rpc` false、`stop` `interrupt`、`bad_lines` 0。
- 評価用 `meal` の累計: 1 本（10/30 会話あり）、収集日 1 日、`s` の合計 53、`o start` から後の合計 16.9 分。目安の残り: 2 本以上（うち会話なし 1）、収集日あと 1 日以上（10/31・11/1）。

### 人の決定（10/30）

- `20261030-201124_self_meal` は**採用**（数字を見る前。捨てる条件に当たらず、`wrong key` 0）。打ち忘れ・打ち遅れの体感はどちらも「数回」。同席者あり。
