owhinata/zaitaku-mealpace/docs/log/2026-10-29.md

# 2026-10-29

## #45 ステップ 3: 最終モデル（学習側 26 本、0038 の構成）

コミット 664d314 の上で `python analysis/m4_compare.py data/raw --final-model analysis/models/m4-0038.npz` を実行した。構成は 0038 の `M4-CONFIG`（C4 × P2）。
学習側は 0037 の `M4-TRAIN` の 26 本だけで、評価側（`M4_EVAL_FROM` 以降の名前）は開いていない。所要時間 13 分 31 秒（最大の常駐メモリ 約 4.8 GiB）、終了コード 0。

読み戻しの一致: 学習側の全窓で、保存前と読み戻した後の確率の差の最大は 0（1e-6 以下）、後処理の出力は完全に一致した。

報告（標準出力のまま）:

### M4 #45 最終モデル（ステップ 3）（プログラムの報告をそのまま。見出しの段だけ下げた）

- コミット: 664d314
- 構成: `M4-CONFIG: set=mfe40 classifier=cnn seeds=0,1,2 hard_negative=none post=hyst threshold=- enter=0.85 exit=0.65 cap_s=none refractory_s=0.5`
- 学習側のセッション: 26 本（0037 の M4-TRAIN）
- ファイル: `analysis/models/m4-0038.npz`（81668 バイト）
- 保存前後の確率の差の最大: 0（1e-6 以下）、後処理の出力: 完全に一致
- `M4-MODEL: path=analysis/models/m4-0038.npz sha256=c786086f069c55c55b27eea860963c3c950c04b728fe65d52bc35a7a4a806d90`

`sha256sum analysis/models/m4-0038.npz` の値は報告の sha256 と一致した。0038 の `M4-MODEL` の行と `fixed_eval.M4_MODEL` にこの値を入れ、`fixed_eval.m4_config_file_matches()` が真であることを確かめた。

テスト: `python -m unittest discover -s analysis` 472 件 OK、`-s tools` 88 件 OK。直したテスト: `analysis/test_fixed_eval.py` の `F6M4Config`（`setUp` で `M4_MODEL` も `None` に差し替える。`test_none_expected_lines` が実物の `M4_MODEL` を `None` と見ていたため）。

## #45 の close と、ランタイムの採否（0040）

- 人が #45 を close した（ステップ 3 まで済み、plan 14 節の完了の条件を満たす）。
- 人の問い「#47 に進む前に #51（ランタイムの採否）を決めたほうがよいのでは」→ そのとおり。メインが #51 の数字を 0038 の構成（1 窓に CNN 3 回）に当てはめた表を出し
  （numpy 約 100 ms / ホップ・CPU 約 6 割、im2col＋OpenBLAS 約 45 ms・約 2 割、LiteRT 約 20 ms・約 15%、GPU に利点なし。どれも 250 ms に収まる）、メインの推奨は numpy のまま
  だったが、人は **im2col ＋ OpenBLAS（1 スレッド）** を選び、LiteRT は M5 に送った。docs/decisions/0040 に記録（D9 の例外として `libopenblas0-pthread` を入れ直す、
  スレッド 1 固定、#47 で 1 ホップ全体を実測して中央値 125 ms 超・最大 250 ms 超なら見直す）。
- 訂正: メインは最初「OpenBLAS は入っていて alternatives を戻すだけ」と書いたが、10/24 の段階 5 で `libopenblas0-pthread` は外してあり、入れ直しが要る（0040 の前提に明記）。

## 0040 の 1: UNO Q に OpenBLAS を入れ直した（人、sudo）

- `sudo apt install libopenblas0-pthread` → `libopenblas0-pthread:arm64 0.3.29+ds-3`（10/24 に計った版と同じ。25.5 MB、ほかに入ったものなし）。
- alternatives は libblas・liblapack とも **auto mode** で `/usr/lib/aarch64-linux-gnu/openblas-pthread/` を指す（優先度 100。参照実装は 10 で候補に残る）。`libopenblas.so.0` も auto。
- メインが ssh で確かめた: `python3-numpy 1:2.2.4+ds-1` のまま、numpy 2.2.4 の `/proc/self/maps` に `openblas` が 16 行（実際に OpenBLAS を読んでいる）。
- `docs/unoq-setup.md` の BLAS の行と切り替えの節を直した（OpenBLAS は外さない）。0040 の残り（im2col、スレッド 1 固定、実測）は #47。

## #47 装置上の推論と表示（ステップ A・B・C）

plan #47（Codex 3 回、BLOCKING 0。人が 10/29 に承認、PLAN-SHA `de7babf9fa6db4f6`）。人の決定でハートビートを追記した（下。PLAN-SHA `041985bbc9871276`、Codex の plan レビューは回さず、
ステップ C の adversarial-review の diff に含めた）。評価用 `meal` は 11/1〜11/4（0037）。性能の数字（検出率・誤検出率）は出していない（この Issue は数字を出さない）。

### ステップ A（PC のコードと合成のテスト）

- `features_np._conv3x3` を im2col ＋ 行列の積に替えた（0040 決定 1）。旧実装（einsum）との差の最大: 乱数の重み 1.48e-08、`m4-0038.npz` 2.18e-10、`features_np_ref.npz` 0。
- `analysis/m4_infer.py`（`m4_compare.py` から推論の部分を移し、同じ名前を再輸出。`Detector`・`code_sha256` を足した）、`led_rule.LedStepper`、`features_np.mfe_and_feat`（FEAT の 82 次元）、
  `split.py` の `unoq-detector`。装置: `device/unoq/detector.py`（ライブ・再生・照合）、`audio_in.py`（ALSA と音声の入力を扱う唯一のモジュール）、`m4_infer.py`・`led_rule.py`・`m4-0038.npz` のリンク。
  PC: `tools/record.py --unoq-detector`、`tools/unoq_replay_check.py`、`tools/unoq_session_check.py`。`DEPLOY_FILES` を入れ替え（14 個）、`deploy-unoq` の検査を `analysis/models/` の `.npz` に広げた。
- plan との違い・決めたこと（報告の 1〜11）:
  1. plan 14 の「`Detector.step` の `prob` が `model_prob`（バッチ）と 1e-12 以内」は成り立たない（float32 の行列の積は B で和の順が変わり、バッチとの差は 1e-8 程度。einsum の版でも同じ）。
     テストは「窓 1 つずつ呼んだ `model_prob` と 1e-12、バッチと 1e-6、`positive`・`led` は完全に一致」にした。
  2. `m4_infer` は `led_rule` にも依存する（4 節の `Detector` が `LedStepper` を使うため。`led_rule` は標準ライブラリだけ）。
  3. E 行の `arecord_cpu_s` の鍵は `audio_in.CPU_KEY` に置いた（6.4 の「`audio_in.py` 以外は文字列 arecord を含まない」のため）。
  4. `code_sha256` は名前を含む（「`<名前> <sha256>`」の行を名前の順に並べた文字列の sha256）。装置は配った先の `.py`・`.npy`・`.npz` 全部を数えるので、一覧の外が残っていると照合が通らない。
  5. ホップ k の「新しい 4000 標本」は 16 kHz の番号 `[4000 k + 12000, 4000 k + 16000)`（窓 0 の最初の 12000 はどのホップにも数えない）。`backlog` は読んだブロックの中の未処理の標本で、パイプの中は含まない。
  6. 終了コード: 0 EOF・シグナル、1 誤り、2 照合の不一致、3 overrun、4 stdout-stall、5 stdout-closed（plan は 5 を決めていない）、6 heartbeat-timeout（追記）。
  7. plan に無いが足したもの: `--expect-config`・`--expect-sha256` はどのモードでも必須、起動時に RPC を開けなければ 1 で終わる、H 行に `rpc`・`python`、`record.py` は H 行の
     `input`・`rpc`・`feature_names`（と追記の後はハートビートの値）も照らす、終わりにつなぎが落ちていれば 1 回開き直して消灯を送る、後始末の間は SIGTERM・SIGHUP を無視する。
  8. スワップの確かめ（Q11）は `cat /proc/swaps`（`/dev/zram` 以外があれば始めない）。UNO Q のユーザーの PATH に `swapon` が無かった。
  9. 再生モードの一致は装置が作れる窓だけで比べる（最後の 1 窓ほどは間引きの遅れ 30 標本で作れない）。
  10. 再生モードの E 行の時計の診断値（anchor 0 からの値）は意味を持たない。
  11. `docs/data-schema.md` の追記の記録は 0037 の追記に含めた。
- 追記（人の決定 10/29）: **標準入力のハートビート**。UNO Q の sshd は `ClientAliveInterval` が既定の 0 で切断に気づかず、`stdout-stall` は ssh・TCP のバッファが埋まるまで
  （数分〜数十分の見込み）効かないため。`record.py` が 0.5 秒ごとに改行 1 バイトを書き、検出器（ライブ）は 2.0 秒届かなければ消灯して `heartbeat-timeout`（6）で止まる。再生は使わない。
- テスト（合成だけ）: analysis 491（472 から +19）、tools 112（88 から +24）、device/unoq 55（30 から +25）。すべて OK（ステップ C の修正の後は tools 113・device/unoq 58）。

### ステップ B（UNO Q での確かめ。人の目視とメインの集計。控えは scratch の stepB-1.md・stepB-2-live.md）

- 配置: 14 ファイルが一覧と一致、`__pycache__` 無し。照合（`--selftest`）: 参照との差 2.04e-08、im2col の新旧 7.39e-09、重みの sha256・M4-CONFIG 一致。numpy 2.2.4、`libopenblasp-r0.3.29.so`、
  スレッド 1。H 行の `code_sha256` `8a71c4b9…` = PC の値。スワップは zram だけ、コアダンプ無し、sshd は `ClientAliveInterval` 0（既定。`sshd -T` は sudo なしでは読めない）。
- 再生モードの一致（`20261026-190244_self_meal`、`--feat`）: 窓 3979（装置と PC で同じ集合）、`prob` の差の最大 1.61e-07、`positive`・`led` の不一致 0、FEAT の差の最大 5.00e-08、
  装置の `proc_ms`（RPC なし）中央値 35.8・95 パーセンタイル 36.4・最大 44.8 ms、所要 170 秒。UNO Q の上に新しいファイル 0 件。
- ライブ 180 秒 `water`（`20261029-132116_self_water`、RPC あり、`--feat`、721 窓）: 人の目視で波線 → 顔 → 波線。`proc_ms` 中央値 79.9・95 パーセンタイル 82.8・最大 106.2 ms、
  `delay_meas` 中央値 224・最大 366 ms、`delay_upper` 中央値 1000.8・最大 1142.8 ms（ssh の往復の最大 776.8 ms）、`e2e_ms` 中央値 207・最大 236 ms、`anchor_spread_ms` 0.103、
  `clock_drift_max_ms` 4.0、取りこぼし 0、overrun 0、RPC の失敗 0。
- 消灯の確かめ（plan 11.2。すべて人の目視）:
  - Ctrl-C: 顔・波線が出ている状態で Ctrl-C → 消えた。通過。
  - Wi-Fi 切断（`20261029-132500_self_water`）: `nmcli radio wifi off` から 2 秒後に消えた（ハートビートの設計どおり）。通過。
  - `kill -9`（`20261029-132804`・`132920`）: 表示は最後の状態のまま残り、`record.py` の後始末（`led_check.py off`）で消えた。通過。
  - 起動失敗（アダプタを抜く）: 「最初の窓の行が届きませんでした（child-exit）」、子の終了コード 1（arecord「audio open error: No such device」）、フォルダ無し。
    消灯のままだった（人の確認 10/29）。通過。
  - `--no-rpc` の前の消灯（`20261029-133213_self_water`、19 窓）: 先に消灯を送り、Enter を待った。通過。`proc_ms` 中央値 64.4 ms（RPC なし）。
- 30 分 `water`（`20261029-133256_self_water`、7201 窓、`duration`）: `proc_ms` 中央値 79.8・95 パーセンタイル 81.4・最大 86.1 ms、`lat_ms` 中央値 85.7・95 パーセンタイル 87.0・最大 92.5 ms、
  キューの最大 0、入力の溜まりの最大 1990 標本（1 ホップの 4000 未満）、`e2e_ms` 中央値 213・最大 236 ms（5 分ごとの中央値 208 → 213 → 213 → 212 → 217 → 225。増分 約 17 ms は
  `clock_drift_max_ms` 26.6（約 15 ppm）と同程度で、処理の溜まりではなく ALSA の標本の時計と単調時計のずれと見る）、`delay_meas` 中央値 232・最大 494 ms、`delay_upper` 中央値 1103.6・
  最大 1365.6 ms（ssh の往復の最大 871.6 ms）、`anchor_spread_ms` 0.089、`marker_offset_shift_max_ms` 1、行の途切れ 0、overrun 0、RPC の失敗 0。
  電池（PD のモバイルバッテリーの残量）: 73% → 69%（30 分で 4%、約 8%/時。待機は 6.8%/時）。
- 0040 決定 6 の目安（中央値 125 ms 超・最大 250 ms 超）: どの回も当たらない。
- これらの `water` のセッション 6 本は M4 の学習・評価に使わない。人の決定（10/29）: `data/raw/` に残さない（消すのは人。数字はこの log に写してある）。

### ステップ C（文書とコミット前のレビュー）

- 文書: `docs/recording-protocol.md`（評価用 `meal` の手順を確定、早見表に M4 評価の行）、`docs/unoq-setup.md`（検出器の節）、`firmware/unoq_mcu/README.md`（貼る表示とカード）、
  0035・0037・0040 の追記（本文は変えていない。0037 に条件 4 の当て方と時計のずれの許す幅を人が書く欄を空けた）、`docs/data-schema.md`（装置のセッション）、`analysis/README.md`。
- adversarial-review（`--scope working-tree`。指示の `--base 331ce20` は HEAD と同じで差分が空になるため、未コミットの変更すべてを同じ範囲として指定）: 3 回、どれも needs-attention。
  1 回目 high 2（パイプ型の core_pattern に `RLIMIT_CORE` が効かない／再生と検出器の直接の起動がスワップの確かめを通らない）、2 回目 critical 1・high 1（`arecord` は exec で
  dumpable が戻る／zram の書き戻し）、3 回目 high 1・medium 2（sysfs が見えないときの zram／`Decimate3` のスライスが入力ブロックを参照し続ける／列のずれた CSV の例外の文に値が出る）。
  どれも裏取りで正しく、直した: `audio_in.disable_dumps`（`PR_SET_DUMPABLE` 0）、`audio_in.core_pattern_ok`（ファイルに書く形だけを受け、パイプの形はすべて 2 で止まる。UNO Q の実物は `core`。
  最初は `systemd-coredump` のパイプも受ける形にしたが、UNO Q に入っていないと分かったので未確認の仮定ごと外した）、`audio_in.disk_swaps`（zram 以外・`backing_dev` が none 以外・sysfs が見えない zram は始めない）、`Decimate3` の末尾の `.copy()`、
  `unoq_session_check.py` の固定の文。指摘のたびに隣の経路が出て収束していないので、4 回目は回さず人に渡す（0009）。Issue #47 のコメントに全文。
  直した後のテスト: analysis 491・tools 113・device/unoq 58、すべて OK。配るファイル（`detector.py`・`audio_in.py`・`features_np.py`）が変わったので**配り直しが要る**
  （ステップ B の数字は直す前のコードのもの）。
- **レビューの修正の後に配り直して再確認**（10/29 夜）: UNO Q の実物はメインの読み取りで `core_pattern` = `core`（ファイルに書く形）、`fs.suid_dumpable` 0、`systemd-coredump` は入っていない、
  `/sys/block/zram0/backing_dev` は無い（書き戻しの無い kernel）、kernel 7.0.0、systemd 257。`core_pattern_ok` から未確認の仮定（`systemd-coredump` のパイプを受ける）を外し、
  ファイルに書く形だけを受けるようにした（パイプの形はすべて 2）。テスト: analysis 491・tools 113・device/unoq 58、すべて OK。
  `deploy-unoq` → 14 個が一致、`--selftest` OK（参照 2.04e-08、im2col 7.39e-09、sha256・構成一致）、`--replay --no-rpc </dev/null` も検査を通って H 行を出した。
  H 行の `code_sha256` `7b98bde5…181fbe5b` = PC の値。再生モードの一致（`20261026-190244_self_meal`、`--feat`）: 窓 3979、`prob` の差の最大 1.61e-07、`positive`・`led` の不一致 0、
  FEAT の差の最大 5.00e-08、`proc_ms`（RPC なし）中央値 35.8・最大 42.8 ms（前回と同じ）。UNO Q の上の新しいファイル 0 件、`__pycache__` 無し、コアダンプ無し。
- ステップ B の 11.2・11.3 の数字（ライブの `proc_ms`・遅れ・電池・消灯の確かめ）はレビューの修正の前のコードで測った。修正（`prctl`、スワップと core_pattern の検査、`Decimate3` の
  `copy()`、採否の道具の文）は起動の前の検査と後始末・表示だけで、ホップの処理（入力処理・特徴量・CNN・後処理・RPC）の式と順は変えていない（`Decimate3` の値も同じ）。
  配り直しの後の短いライブ（人、10/29。`20261029-144211_self_water`、60 秒、RPC あり、--feat）: 窓 241、取りこぼし 0、読めない行 0、止まり方 duration（検出器 eof）、overrun 0、RPC の失敗 0。
  proc_ms 中央値 80.5・95% 81.5・最大 84.0（RPC あり）、delay_meas 中央値 221・最大 355 ms、delay_upper 中央値 744.1・最大 878.1 ms（ssh 往復の最大 523.1 ms）、e2e_ms 中央値 206・最大 212、
  anchor_spread_ms 0.086、clock_drift_max_ms 1.318、行の途切れ 0。終了後に表示は消えた（人の目視）。最終の配布物で起動・受信・消灯が通った。このセッションも `water` で、人が消す。
- adversarial-review 4 回目（人の決定で最後。最終のコード、`--scope working-tree`、同じ focus）: needs-attention、high 1 件。「処理済みの入力ブロック（`src.read()` の `item`、
  48 kHz の 1 ブロック = 約 125 ms 分）が次の読み取りまで主のループのローカル変数に残る」。裏取りで正しいが、残るのはプロセスのメモリの中だけで、ファイル・標準出力・標準エラー・
  ssh・RPC に出る経路ではない（ダンプとスワップは 1〜3 回目の修正で止めてある）。人の決定の方針（直すのはそれらの出口か採否の道具の表示に当たる high 以上だけ）により、
  コードは変えず記録だけ（直すなら `pipe.feed(*item)` の後に `del item`）。採否の道具の表示の経路の指摘は無し。配り直しは要らない。5 回目は回さない。Issue #47 のコメントに全文。
- **条件 4 と時計のずれの許す幅: 済み（10/29、人の決定）**。条件 4 は `delay_meas` の最大 > 1000 ms で当たる（`delay_upper` は使わない: 往復時間は記録の前後に別の接続で測った
  外れ値を含み、記録中の遅れではない。`delay_meas` は片方向の最小の遅れの分だけ小さく出る）。時計は `anchor_spread_ms` ≤ 250、`clock_drift_min_ms`・`clock_drift_max_ms` の
  絶対値 ≤ 250（評価の窓に対して 1 ホップ分）、超えたら当たる。測れない固定の遅れは補正しない（0029 と同じ。#49 の報告に注記）。10/29 の 30 分の実測では当たらない
  （`delay_meas` 最大 494 ms、`anchor_spread_ms` 0.089、`clock_drift_max_ms` 26.6）。評価用の叩きはしないまま（人が再確認）。0037 の追記と `tools/unoq_session_check.py`
  （`RX_DELAY_RULE`・`CLOCK_RULE`、時計の行に判定）に入れた。tools のテスト 115（+2）、OK。配るファイルは変えていない。

## 評価側の窓を 10/29〜11/1 に前倒し（人の決定、0037 の追記）

- #47 が 10/29 に終わったので、人が評価用 `meal` を今日から録ると決めた。評価用の記録が 1 本も無い時点での事前登録の変更。
- 最初の案（窓 10/29〜11/4 ＋ 3 本以上・2 収集日以上に達した日の終わりで打ち切る）は、人の提案で「当初と同じ 4 日を 3 日前倒し（10/29〜11/1、打ち切り 11/1 の終わり）」に改めた。
  日付だけで打ち切る形（0023）を保ち、本数の規則を置かない。
- 0037 の `M4-EVAL-WINDOW: from=2026-10-29 to=2026-11-01` と `fixed_eval.M4_EVAL_FROM`・`M4_EVAL_TO` を同じコミットで直し、`m4_lines_match` は真。締めの翌日が窓の初日なので
  `list_train` の「締めより後で窓より前」は空になる（テストの期待を直した）。窓の境界のテストの名前を 10/29〜11/1 の中に移した。テストは analysis 491・tools 115 が通る。

## 次

- #48 評価用 `meal`（10/29〜11/1、3 本以上・2 収集日以上、`--feat --no-rpc`。採否は数字を見る前に `unoq_session_check.py` で）→ #49 の plan（評価側を 1 回だけ）。
