owhinata/zaitaku-mealpace/docs/decisions/0038-m4-detector-config.md

# 0038 M4（検出器・咽喉マイク版）の構成: 学習側 CV で選び、評価用の記録の前に固定する

日付: 2026-10-29　状態: 採用（人の決定 10/29。plan #45 の 9 節）

## 前置き

- 書いた日: 2026-10-28 に subagent が規則の行（P4）で下書きし、2026-10-29 に人の決定で次点の行（P2）に書き直した（#45 ステップ 2 の (3)。plan #45 の 13 節の 9。下の「規則からの変更」）。
- 評価側（`M4_EVAL_FROM` = 20261101 以降の名前の `meal`）はまだ存在せず、開いていない。本番の報告の「使わないセッション」でも `M4_EVAL_FROM` 以降は「なし（開いていない）」。
- 本番の報告: docs/log/2026-10-28.md「#45 ステップ 2 の (2): 本番の CV（学習側 26 本）」（コミット 15c7b6a の上で実行。報告はこの記録と同じコミットに入る）。図は `docs/log/2026-10-28-45/`。
- 学習側: 0037 の `M4-TRAIN`（26 本 = M3 の 21 本 `M4_TRAIN_M3` ＋ 学習用 `meal` 5 本。0037「追記（2026-10-28）」）。
- 値は本番の報告の候補の表の「CNN 種 0・1・2 の平均 × ヒステリシス＋不応期 0.5 秒」の行から写した。報告の規則が選んだ行（P4）ではない（下の「規則からの変更」。評価側はまだ存在しない）。

## 決定

1. **M4 の判定に使う構成**（25 行のうち、報告の規則の次点の行。人の決定 10/29）:
   - 分類器: **CNN**（`mfe40`、0033 §2 の構成と学習のまま）を種 0・1・2 で学習し、窓ごとの確率（シグモイドの出力）の算術平均を取る（plan #45 の 5.2。C4）。hard negative は使わない。
   - **分類器は CNN（LR ではない）。** 0039 決定 5 の入力: 装置（UNO Q の Linux 側）は 1 窓に CNN を 3 回回す。ランタイムの採否は 0039 決定 5 のとおり別の decision で決める（この記録では決めない）。
   - 後処理: ヒステリシス 入り 0.85・出 0.65 → 不応期 0.5 秒（塊ごと抑える）。塊の上限は使わない（`postprocess.PostStepper`・`post_mask`。plan #45 の 5.4。P2）。
   - 窓・ホップ（0.25 秒）・ラベル・数え方は変えない。LED は後処理の出力から 0018 の規則で決まる「目安」で、嚥下の有無の検出を示すだけ。
2. **規則と、規則からの変更**: plan #45 の 6.1・6.2 の規則は、各行の中では格子の点のうち誤検出率が 1.0 回/分以下（`M4_SELECT_FP_PER_MIN`）で検出率が最大の点、
   25 行の中ではその動作点の誤検出率が 1.0 回/分以下の行で検出率が最大（同率なら単純なほう）。比べる数字は学習側 26 本の合算だけ。この規則が選んだ行は
   **C4 × P4**（入り 0.80・出 0.50・上限 1.5 秒・不応期 0.5 秒。検出率 0.960、誤検出率 0.99 回/分）だった。
   **人が表を見た後に、次点の C4 × P2 に変えた**（10/29）。理由: (a) 合格線（85% / 1.0 回/分）に対する余裕が、検出率は約 10 ポイントあるのに誤検出率は 0.01 回/分しかなく、
   評価側で危ないのは誤検出の側である。(b) 評価側は `meal` だけで、学習側 CV の `meal` だけの数字は P2 のほうが検出率・誤検出率とも良い（0.973 / 1.25 対 0.969 / 1.43。
   規則では選択に使わないと決めていた数字）。(c) 規則を「検出率が合格線以上の行で誤検出率が最小」としていれば P2 が選ばれた。規則の向き（誤検出を制約、検出率を目的）は
   10/24 に表を見る前に決めたもので、どちらの向きも合格線が両側にある以上は筋が通る。
   この変更の代償: 学習側 CV の数字は、規則で選んだ場合より**さらに楽観側**になる（25 行の表を見た人が 2 行から選んだ）。評価側（`M4_EVAL_FROM` 以降）はこの時点で
   1 本も存在せず開いていないので、#49 の評価側の数字には影響しない。評価側を見た後の変更ではない。
   行の中の動作点（入り 0.85・出 0.65）は 6.1 の規則が P2 の行の格子から選んだ点のままで、人は変えていない。
3. **学習側 CV の数字**（収集日ごとの 6 fold の合算。**楽観側**: 25 行と各行の格子を同じ交差検証の数字で選んだので、選んだ行の数字は良い側に出る。
   合格線（85% / 1.0 回/分）を満たすかの判定には使わない。判定は #49 の評価側で読む）:
   - 検出率 0.955（338/354）、誤検出率 0.86 回/分（125 回 / 145.70 分）、TP / FN / FP = 338 / 16 / 125、陽性窓の割合 0.050（1899/37708）。
   - `meal` だけ: 検出率 0.973（250/257）、誤検出率 1.25 回/分（111 回 / 88.83 分）。条件別だけ: 検出率 0.907（88/97）、誤検出率 0.25 回/分（14 回 / 56.87 分）。
   - 規則が選んだ P4 の行（採用しなかった）: 検出率 0.960（340/354）、誤検出率 0.99 回/分（144 回 / 145.70 分）、TP / FN / FP = 340 / 14 / 144。
   - 常時陽性の場合（0011「既知の弱点」）: 検出率 1.000（354/354）、誤検出 26 回、誤検出率 0.18 回/分。
4. **機械が読む行**（`analysis/fixed_eval.py` の `M4_CONFIG`・`M4_MODEL` と一字一句一致。#47 の装置と #49 の入口が照合する）:

```
M4-CONFIG: set=mfe40 classifier=cnn seeds=0,1,2 hard_negative=none post=hyst threshold=- enter=0.85 exit=0.65 cap_s=none refractory_s=0.5
M4-MODEL: path=analysis/models/m4-0038.npz sha256=c786086f069c55c55b27eea860963c3c950c04b728fe65d52bc35a7a4a806d90
```

   2026-10-29 のステップ 3 で `M4-MODEL: path=analysis/models/m4-0038.npz sha256=<64 桁>` に置き換えた（`fixed_eval.M4_MODEL` と同じコミット。docs/log/2026-10-29.md）。
   最終モデルのファイルの形は plan #45 の 9.1（CNN: 種ごとの接頭辞 `s0/`・`s1/`・`s2/`、`numpy.savez`、`allow_pickle` を使わない）。

## `docs/evaluation.md` との関係（記録した逸脱。0034 と同じ扱い）

- **29 行目（M2 の行）**（M2 検出器の手法「Edge Impulse（int8、Nano 上で推論）」）: この構成はこれに当たらない（咽喉マイク、UNO Q の Linux 側の推論、CNN の float32、種 3 つの平均）。
  評価の定義からの逸脱として、評価の実行の前にここに記録する（0037 の 6 で予定済み）。`docs/evaluation.md` は書き換えない。
  合格線の数字（85% / 1 回/分）、窓、数え方、分割（セッション単位）はそのまま当てる。
- **28 行目（M1 の行）**（手法「手作り特徴量＋ロジスティック回帰」）: CNN を選んだので、0034 と同じくこれにも当たらない。
- **8 行目**（特徴量の並び）: `mfe40` は当たらない（0034 と同じ逸脱）。
- 後処理（ヒステリシス・不応期・種の平均）は陽性窓の列を作る規則で、定義（窓・数え方・非嚥下区間）を変えない（0033 §3 と同じ）。
- 選び方の上限 3.0 → 1.0 回/分の読み替え（6.1）は 0014・0033 の選び方の手順の変更で、評価の定義の変更ではない。

## 事前登録と、後から選ばないこと

- この構成は評価用 `meal`（11/1〜）を録る前に、この記録と `fixed_eval.M4_CONFIG` で固定する。規則からの変更（決定 2）もこの時点で済ませた。
- 評価側を見た後に、構成・閾値・後処理・種・hard negative を変えて採点し直さない。報告の表のほかの行（規則が選んだ P4 を含む）も評価側で採点しない。
- 評価用 `meal` の途中で構成や重みを変えたら、それより前の評価用 `meal` は使わない（0037 の 5）。

## 選ばなかった案（報告の表から要点だけ。どれも学習側 CV の数字で、楽観側）

- **R0 構成 J のまま**（CNN 種 0、入り 0.95・出 0.85）: 誤検出率 1.05 回/分で上限 1.0 を満たさない（参考の行で、候補ではない）。
- **CNN 種 0・1・2 の平均 × ヒステリシス＋塊の上限＋不応期**（入り 0.80・出 0.50・上限 1.5 秒。規則が選んだ P4）: 検出率 0.960（340/354）、誤検出率 0.99 回/分。
  検出が 2 件多いが、誤検出率が上限 1.0 のすぐ内側で `meal` だけでは 1.43 回/分（決定 2 の理由で採用しなかった）。
- **P4 を装置に載せ、P2 を事前登録した 2 つ目の採点として併記する案**（0034 の 2 構成の前例）: #49 の判定が 1 つに決まらず、装置に載る構成が P4 のままになるので採らなかった。
- **CNN 種 0・1・2 の平均（各種 hard negative）**（C5）の 5 行: 検出率 0.946〜0.949、誤検出率 0.89〜1.00 回/分。検出率が採用した行より低く、hard negative の利点が見えない。
- **CNN 種 0**（C2）・**CNN 種 0 ＋ hard negative**（C3）の行: 検出率 0.887〜0.921。上限 1.0 を満たす行もあるが検出率が低い。
- **LR `a52`**（C1）: 塊の上限を足した 2 行が上限 1.0 を満たす（検出率 0.932・0.929、誤検出率 0.97・0.96 回/分）が、検出率が低い。LR なら装置は numpy のままで済む道だった。
- 種 1・種 2 の単独（参考の行）は候補ではない（種による揺れの参考: 種 1 は検出率 0.966・誤検出率 0.97、種 2 は 0.921・0.99）。

## 確かめていないこと

- 学習側 CV は楽観側で、規則からの変更でさらに楽観側。評価側で合格線（85% / 1.0 回/分）を満たすかは分からない。
- 評価側は `meal` だけ。学習側 CV の `meal` だけの誤検出率は 1.25 回/分で 1.0 を上回る（25 行のどの行も `meal` だけでは 1.0 を上回り、1.25 がその最小）。
  評価側の誤検出率が合算（0.86）より `meal` だけの値に近く出るおそれがある。
- 誤検出の中身の表は R0 と規則が選んだ P4 の行だけで、P2 の行の内訳は出していない（P4 の内訳では `meal` の会話あり・なしの区間が 97 / 144 回、嚥下の直前 18・直後の延び 8）。
- 常時陽性の誤検出率（0.18 回/分）は合格線の上限を下回る（0011「既知の弱点」。セッションごとに塊が 1 つで、`meal` の非嚥下の分数が長いためと見る。推測）。採用した行の陽性窓の割合は 0.050 で、常時陽性に近い出し方ではない。
- 学習側 CV（収集日ごと）で選んだ動作点が、評価側（別の日、装置の取り込み口）に移るか（0032・0037「確かめていないこと」と同じ）。
- UNO Q で CNN を 1 窓 3 回回す時間（#44・#51 の数字からの見込みは 1 窓 100 ms 前後（推測、plan #45 の 5.2）。実測は #47）。
- 押せなかった本物の嚥下が `meal` では陰性として学習・採点に入る（0023・0037）。採用した行は hard negative を使わないので、重く陰性と教えることはない。

## 影響する場所

`analysis/fixed_eval.py`（`M4_CONFIG` にこの記録の値、`M4_MODEL` にステップ 3 の値）、`analysis/test_fixed_eval.py`・`analysis/test_m4_compare.py`（実物の `M4_CONFIG` が `None` という前提のテストを合成の値への差し替えに直した）、
docs/log/2026-10-28.md と `docs/log/2026-10-28-45/`、`docs/status.md`。`analysis/models/m4-0038.npz`（ステップ 3 で作った最終モデルの重み）。#47（装置の `detector.py` がこの構成と重みで推論する）、
#49（評価側の採点の入口がこの行と照合する）、0039 決定 5 の別の decision（分類器が CNN であることを入力にする）。
