owhinata/zaitaku-mealpace/docs/log/2026-10-28.md

# 2026-10-28

## #48 学習用 `meal` 5 本目（学習用の収集日 4。締めの日）

- M4 の学習用 `meal`（docs/decisions/0037。3 本、10/25〜10/28、締め 10/28 の終わり）。PC の記録の経路（`record.py --throat sh12jk-wired-unoq-usbaudio --cond meal --duration 1800`、
  docs/decisions/0028）。手順は `docs/recording-protocol.md`「M4 の `meal`（咽喉マイク）」。被験者 `self`。1 本目は docs/log/2026-10-25.md、2 本目は docs/log/2026-10-26.md、
  3・4 本目は docs/log/2026-10-27.md。
- `throat_check.py --tap-mode enter` の数字は人が実行した出力から写した。マーカーの数は `events.csv`、記録の形は `meta.json` から写した（音声の中身は見ていない。
  振幅・特徴量・分類器の結果は出していない）。採否は人が記録の直後に決めた（下の「人の決定（10/28）」）。
- 装着の側は M3 と同じ側。

| セッション | 条件 | 長さ（秒） | 止まり方 | 会話 | 同席者 | `s` | `t` | `c` | `o`（tap / start / conv / その他の note） | overrun の行 | 推定差（ms） | 段差 | 叩き 見つかった数 / `Δ` 中央値 | 使わない目安 | 打ち忘れの体感 | 打ち遅れの体感 | 記録時の `s` の決まり | 採否と理由 |
|---|---|---|---|---|---|---|---|---|---|---|---|---|---|---|---|---|---|---|
| `20261028-193716_self_meal` | meal | 906.250 | interrupt（食べ終わって Ctrl-C） | なし | なし | 41 | 0 | 1 | 5 / 1 / 0 / 0 | 0 | +34 | なし | 5 / 5、−72.3 ms（**印**。50 ms < \|Δ\| ≤ 125 ms） | 当たらない | ほぼ無し | ほぼ無し | 0023（意識した食べ物・飲み物の嚥下に `s`） | 採用（人の決定 10/28、数字を見る前） |

- `o start` は 1 つ（58.5 秒）で、その前に `s`・`t`・`c` は無い。`o conv` は無い（会話なし）。`o start` から記録の終端まで 14.1 分。`s` はすべて `o start` の後で、
  最初の `s` は `o start` の 10.9 秒後、最後の `s` は終端の 7.8 秒前（0023 の 6「終わりの 1.5 秒以内の `s`」に当たらない）。`s` の間隔 10 秒未満は 10 組（`meal` では制限なし）。
- 時刻の対応: c0 −148.3 ms、クロックの差 +63.4 ppm、残差の中央値 8.9 ms・95 パーセンタイル 26.2 ms・最大 98.2 ms。L と R の相関 1.000、RMS の比 1.000。0 の区間 0 回。
  `meta.json`: `fw` `pc-throat`、`sensors[0].iface` `sh12jk-wired-unoq-usbaudio`、`position` `lateral-below-cricoid`、`band` `sh12jk-strap`、`throat.mixer` Mic 58・on、`throat.stop` `interrupt`。
- 叩きの `Δ` の中央値は −72.3 ms（四分位範囲 −74.2〜−43.4 ms、最小 −93.7 ms、最大 −36.5 ms）で、`throat_check.py` は「時刻の対応が確かめられない」の印を出した。
  規則 10（docs/recording-protocol.md「咽喉マイク（M3）」。叩きが 3 回以上見つかり 50 ms < |Δ の中央値| ≤ 125 ms）に当たるので、**印を付けたまま使う**（#37 の 5 本と同じ範囲。
  `Δ` で時刻の対応は直さない、0029）。
- 捨てる条件（0037 の 5: M3 の 1〜7・9・10、0023 の 6・8・9）はどれにも当たらない。
- 学習用 `meal` の累計: 5 本（10/25 会話あり、10/26 会話なし、10/27 会話あり 2 本、10/28 会話なし）、収集日 4 日、`s` の合計 257、`o start` から後の合計 97.3 分。
  会話あり 3・会話なし 2。叩きの印つきはこの 1 本だけ。

### 人の決定（10/28）

- 採用。体感: 打ち忘れ「ほぼ無し」、打ち遅れ「ほぼ無し」。体感は採否に使わない（0023）。
- 同席者なし、会話なし。食べ終わって Ctrl-C で止めた。
- 学習用の締めは 10/28 の終わり（0037）。これより後に録った `pc-throat` のセッションは M4 に使わない。

## #45 ステップ 2 の (1): 学習側の一覧の固定（人の指示でメインが実施、10/28 夜）

- 人の決定: 5 本目の採否の後、今日はもう録らないので、締めの追記を今夜行う（plan #45 の 11 節 2。日付の縛りではなく「締めと採否の後」が条件）。
- 0037 の `M4-TRAIN:` の行と `analysis/fixed_eval.py` の `M4_EXPECTED_TRAIN` に同じ 26 本（M3 の 21 本 `M4_TRAIN_M3` ＋ 学習用 `meal` 5 本）を入れ、0037 に「追記（2026-10-28）」の節を足した
  （日付と「追記の時点で M4 のどの性能の数字も見ていない」を明記）。`m4_lines_match` は実物の 0037 で真。`m4_compare.list_train('data/raw')` は 26 本を返し、締めより後・評価側の窓の名前は 0 本。
- 学習用 `meal` は plan では 3 本（学習側 24 本）の見込みだったが、採用分 5 本をすべて入れて 26 本。`m4_compare.py` の報告文の「24 本」を一覧の本数（`len(L.train)`）に直した。
- 直したテスト（実物の定数が `None` という前提をやめ、合成の名前の検査は `None` に差し替えて動かす）:
  `test_fixed_eval.py` の `F2AssertM4Train`・`F4M4LinesMatch`・`F6M4Config` の `setUp`、`F4M4LinesMatch.test_real_0037_matches`（実物の 26 本: 先頭 21 本が M3、残りが `_self_meal`、締め以前、を確かめる）、
  `test_m4_compare.py` の `ListingTest.setUp`・`RunCase.setUpClass`・`SwitchTest.smoke`（`fixed` 引数）・`test_production_stops_before_reading`・`test_main_smoke_writes_nothing`・`test_smoke_stops_when_list_fixed`、
  `test_visualize.py` の `M4VisualizeTest.setUpClass`。テストは analysis 472 件・tools 88 件が通る。
- 本番（ステップ 2 の (2)）と 0038 はまだ。性能の数字は何も出していない。

## #45 ステップ 2 の (2): 本番の CV（学習側 26 本）

- 10/28 夜に実行した（plan #45 の 13 節の 8。plan では 10/29 の予定だったが、締めと採否が 10/28 夜に済んだので同じ夜に続けた）。コミット 15c7b6a の上で、working tree が clean の状態で
  `python analysis/m4_compare.py data/raw --figures docs/log/2026-10-28-45`。図の置き場は plan の `docs/log/2026-10-29-45` ではなく実行日の `docs/log/2026-10-28-45/`（41 枚）。
- 評価側（`M4_EVAL_FROM` = 20261101 以降の名前）は存在せず、開いていない。CNN の学習 81 回（`plan_trainings`。学習用 `meal` が 4 収集日なので、予行の見積もりの 3 通り 27・42・60 回より多い）、
  所要 2 時間 35 分 26 秒（`/usr/bin/time -v`。予算 3 時間の内）、最大の常駐メモリ 4,858,860 KB（`/usr/bin/time -v`。報告の 4.41 GiB はプログラム自身の計測）、終了コード 0。
- 下は標準出力の報告をそのまま貼ったもの（数字・見出しとも書き換えていない。次の「# M4 #45 …」から「時間の実測」の節の終わりまで）。**学習側 CV の数字は楽観側**（25 行と各行の格子を同じ交差検証の数字で選んだ）で、
  合格線（85% / 1.0 回/分）を満たすかの判定には使わない。判定に使うのは #49 の評価側。

# M4 #45 誤検出を減らす候補の比較（学習側の交差検証だけ）

## 実行の条件

- 実行: 本番（学習側だけ。評価側は開いていない・採点していない）
- コミット: 15c7b6a
- numpy 2.5.3、scipy 1.18.1、scikit-learn 1.9.1、librosa 1.0.0、torch 2.14.1+cpu
- `.venv` の全パッケージ（間接依存を含む）: ai-edge-litert==2.3.0、backports.strenum==1.2.8、certifi==2026.7.22、cffi==2.1.1、charset-normalizer==3.5.2、cloudpickle==3.1.2、contourpy==1.4.0、cycler==0.12.1、decorator==5.3.1、filelock==3.32.3、flatbuffers==25.12.19、fonttools==4.66.1、fsspec==2026.7.0、idna==3.20、jinja2==3.1.6、joblib==1.6.0、kiwisolver==1.5.1、lazy-loader==0.6、librosa==1.0.0、llvmlite==0.50.0、markupsafe==3.0.3、matplotlib==3.11.2、ml_dtypes==0.6.0、mpmath==1.3.0、msgpack==1.2.3、narwhals==2.26.0、ncnn==1.0.20261020、networkx==3.6.1、numba==0.68.0、numpy==2.5.3、onnx==1.23.2、onnx-ir==1.1.0、onnxruntime==1.31.0、onnxscript==0.7.2、packaging==26.3、pillow==12.3.0、pip==24.0、platformdirs==4.13.0、pnnx==20261020、pooch==1.9.0、portalocker==4.4.1、protobuf==7.36.2、pycparser==3.11、pyparsing==3.3.3、pyserial==3.5、python-dateutil==2.9.0.post0、requests==2.34.2、ruff==0.16.10、scikit-learn==1.9.1、scipy==1.18.1、setuptools==78.1.0、six==1.17.0、soundfile==0.14.0、soxr==1.1.0、sympy==1.14.0、threadpoolctl==3.7.0、torch==2.14.1+cpu、tqdm==4.70.1、typing_extensions==4.16.0、urllib3==2.8.0
- Python 3.12.3
- CPU: AMD Ryzen 7 8840U w/ Radeon 780M Graphics、コア数（os.cpu_count）16
- torch のスレッド数: 4、種: 0, 1, 2
- 閾値の格子 19 点、ヒステリシスの格子 45 点、塊の上限 1.5, 2.0, 2.5 秒、不応期 0.5 秒
- hard negative: 重み 3.0、決める動作点 入り 0.95・出 0.85（固定）、条件別のセッションだけ、入れ子
- 選び方の誤検出率の上限: 1.0 回/分（`M4_SELECT_FP_PER_MIN`）
- 0037 の `M4-` の行と `fixed_eval.py` の定数: 一致（docs/decisions/0037-m4-split-and-recording-plan.md）
- CNN の学習の回数: 81（plan_trainings）

## 学習側のセッション（26）

| セッション | cond | `s` の数 | 非嚥下（分） |
|---|---|---|---|
| 20261011-100847_self_quiet | quiet | 1 | 2.83 |
| 20261011-101644_self_water | water | 10 | 2.42 |
| 20261011-102354_self_talk | talk | 0 | 2.78 |
| 20261011-102854_self_saliva | saliva | 12 | 2.43 |
| 20261011-103352_self_neck | neck | 0 | 2.72 |
| 20261011-103912_self_water | water | 11 | 2.47 |
| 20261011-104408_self_cough | cough | 0 | 2.83 |
| 20261011-202238_self_quiet | quiet | 0 | 2.97 |
| 20261011-202730_self_water | water | 12 | 2.48 |
| 20261011-203152_self_talk | talk | 0 | 2.86 |
| 20261011-203631_self_saliva | saliva | 9 | 2.51 |
| 20261011-204057_self_neck | neck | 1 | 2.84 |
| 20261011-204526_self_water | water | 10 | 2.52 |
| 20261011-204956_self_cough | cough | 1 | 2.85 |
| 20261012-191826_self_quiet | quiet | 0 | 2.79 |
| 20261012-192531_self_water | water | 11 | 2.60 |
| 20261012-193001_self_talk | talk | 0 | 2.89 |
| 20261012-193459_self_saliva | saliva | 9 | 2.61 |
| 20261012-193929_self_neck | neck | 0 | 2.92 |
| 20261012-194417_self_water | water | 10 | 2.65 |
| 20261012-194854_self_cough | cough | 0 | 2.91 |
| 20261025-200807_self_meal | meal | 68 | 26.65 |
| 20261026-190244_self_meal | meal | 46 | 14.06 |
| 20261027-144545_self_meal | meal | 60 | 19.00 |
| 20261027-203815_self_meal | meal | 42 | 16.34 |
| 20261028-193716_self_meal | meal | 41 | 12.76 |

## 使わないセッション（名前だけ）

- 締めより後・評価側の窓より前: なし
- `M4_EVAL_FROM` 以降（開いていない）: なし
- 採らないもの（`fw` が `pc-throat` でない・`self` でない）: 47 本

## 交差検証の fold

| 検証側 | 正規化のセッション（CNN 種 0） | hard negative の窓（種 0・1・2） |
|---|---|---|
| 収集日 20261011: 20261011-100847_self_quiet, 20261011-101644_self_water, 20261011-102354_self_talk, 20261011-102854_self_saliva, 20261011-103352_self_neck, 20261011-103912_self_water, 20261011-104408_self_cough, 20261011-202238_self_quiet, 20261011-202730_self_water, 20261011-203152_self_talk, 20261011-203631_self_saliva, 20261011-204057_self_neck, 20261011-204526_self_water, 20261011-204956_self_cough | 12 本（学習側の fold だけ） | 9・0・25 |
| 収集日 20261012: 20261012-191826_self_quiet, 20261012-192531_self_water, 20261012-193001_self_talk, 20261012-193459_self_saliva, 20261012-193929_self_neck, 20261012-194417_self_water, 20261012-194854_self_cough | 19 本（学習側の fold だけ） | 8・0・38 |
| 収集日 20261025: 20261025-200807_self_meal | 25 本（学習側の fold だけ） | 92・33・200 |
| 収集日 20261026: 20261026-190244_self_meal | 25 本（学習側の fold だけ） | 205・18・133 |
| 収集日 20261027: 20261027-144545_self_meal, 20261027-203815_self_meal | 24 本（学習側の fold だけ） | 31・129・39 |
| 収集日 20261028: 20261028-193716_self_meal | 25 本（学習側の fold だけ） | 40・22・19 |

- 無効な窓（`valid = False`）: 0 / 37708

## 候補の表（25 行。学習側の交差検証の合算）

| 行 | 動作点 | 検出率 | 誤検出率（回/分） | TP / FN / FP | 陽性窓の割合 | meal だけ 検出率 | meal だけ 誤検出率 | 条件別だけ 検出率 | 条件別だけ 誤検出率 | 合格線 85% / 1.0 |
|---|---|---|---|---|---|---|---|---|---|---|
| LR a52 × なし | 閾値 0.95 | 0.935（331/354） | 1.08（157 回 / 145.70 分） | 331 / 23 / 157 | 0.049（1843/37708） | 0.918（236/257） | 1.53（136 回 / 88.83 分） | 0.979（95/97） | 0.37（21 回 / 56.87 分） | 満たす / 満たさない |
| LR a52 × ヒステリシス | 入り 0.95・出 0.85 | 0.935（331/354） | 1.07（156 回 / 145.70 分） | 331 / 23 / 156 | 0.054（2049/37708） | 0.918（236/257） | 1.50（133 回 / 88.83 分） | 0.979（95/97） | 0.40（23 回 / 56.87 分） | 満たす / 満たさない |
| LR a52 × ヒステリシス＋不応期 0.5 秒 | 入り 0.95・出 0.85・不応期 0.5 秒 | 0.932（330/354） | 1.06（155 回 / 145.70 分） | 330 / 24 / 155 | 0.054（2043/37708） | 0.914（235/257） | 1.49（132 回 / 88.83 分） | 0.979（95/97） | 0.40（23 回 / 56.87 分） | 満たす / 満たさない |
| LR a52 × ヒステリシス＋塊の上限 | 入り 0.95・出 0.85・上限 1.5 秒 | 0.932（330/354） | 0.97（141 回 / 145.70 分） | 330 / 24 / 141 | 0.050（1878/37708） | 0.914（235/257） | 1.34（119 回 / 88.83 分） | 0.979（95/97） | 0.39（22 回 / 56.87 分） | 満たす / 満たす |
| LR a52 × ヒステリシス＋塊の上限＋不応期 0.5 秒 | 入り 0.95・出 0.85・上限 1.5 秒・不応期 0.5 秒 | 0.929（329/354） | 0.96（140 回 / 145.70 分） | 329 / 25 / 140 | 0.050（1872/37708） | 0.911（234/257） | 1.33（118 回 / 88.83 分） | 0.979（95/97） | 0.39（22 回 / 56.87 分） | 満たす / 満たす |
| CNN 種 0 × なし | 閾値 0.95 | 0.918（325/354） | 1.17（170 回 / 145.70 分） | 325 / 29 / 170 | 0.044（1676/37708） | 0.930（239/257） | 1.77（157 回 / 88.83 分） | 0.887（86/97） | 0.23（13 回 / 56.87 分） | 満たす / 満たさない |
| CNN 種 0 × ヒステリシス | 入り 0.95・出 0.75 | 0.921（326/354） | 1.01（147 回 / 145.70 分） | 326 / 28 / 147 | 0.053（2012/37708） | 0.934（240/257） | 1.50（133 回 / 88.83 分） | 0.887（86/97） | 0.25（14 回 / 56.87 分） | 満たす / 満たさない |
| CNN 種 0 × ヒステリシス＋不応期 0.5 秒 | 入り 0.95・出 0.75・不応期 0.5 秒 | 0.921（326/354） | 1.00（145 回 / 145.70 分） | 326 / 28 / 145 | 0.053（2005/37708） | 0.934（240/257） | 1.47（131 回 / 88.83 分） | 0.887（86/97） | 0.25（14 回 / 56.87 分） | 満たす / 満たす |
| CNN 種 0 × ヒステリシス＋塊の上限 | 入り 0.95・出 0.75・上限 2.0 秒 | 0.912（323/354） | 0.99（144 回 / 145.70 分） | 323 / 31 / 144 | 0.050（1900/37708） | 0.922（237/257） | 1.46（130 回 / 88.83 分） | 0.887（86/97） | 0.25（14 回 / 56.87 分） | 満たす / 満たす |
| CNN 種 0 × ヒステリシス＋塊の上限＋不応期 0.5 秒 | 入り 0.95・出 0.75・上限 2.5 秒・不応期 0.5 秒 | 0.915（324/354） | 1.00（145 回 / 145.70 分） | 324 / 30 / 145 | 0.051（1939/37708） | 0.926（238/257） | 1.47（131 回 / 88.83 分） | 0.887（86/97） | 0.25（14 回 / 56.87 分） | 満たす / 満たす |
| CNN 種 0 ＋ hard negative × なし | 閾値 0.95 | 0.890（315/354） | 1.08（157 回 / 145.70 分） | 315 / 39 / 157 | 0.041（1563/37708） | 0.918（236/257） | 1.69（150 回 / 88.83 分） | 0.814（79/97） | 0.12（7 回 / 56.87 分） | 満たす / 満たさない |
| CNN 種 0 ＋ hard negative × ヒステリシス | 入り 0.95・出 0.85 | 0.893（316/354） | 0.97（142 回 / 145.70 分） | 316 / 38 / 142 | 0.047（1783/37708） | 0.922（237/257） | 1.51（134 回 / 88.83 分） | 0.814（79/97） | 0.14（8 回 / 56.87 分） | 満たす / 満たす |
| CNN 種 0 ＋ hard negative × ヒステリシス＋不応期 0.5 秒 | 入り 0.95・出 0.75・不応期 0.5 秒 | 0.893（316/354） | 0.95（139 回 / 145.70 分） | 316 / 38 / 139 | 0.050（1900/37708） | 0.922（237/257） | 1.47（131 回 / 88.83 分） | 0.814（79/97） | 0.14（8 回 / 56.87 分） | 満たす / 満たす |
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

- 常時陽性の場合（全窓を陽性にした場合。学習側 CV、全行で同じ）: 検出率 1.000（354/354）、誤検出 26 回、誤検出率 0.18 回/分
- TP / FN / FP はイベント単位（学習側 CV の合算。TN は定義できない）。評価側の混同行列と評価に使ったセッションの一覧は #49。

## 選んだ行

- **CNN 種 0・1・2 の平均 × ヒステリシス＋塊の上限＋不応期 0.5 秒、入り 0.80・出 0.50・上限 1.5 秒・不応期 0.5 秒**
- 規則: 25 行のうち、動作点の誤検出率が 1.0 回/分以下の行で検出率が最大（同率なら単純なほう: C1 < C2 < C3 < C4 < C5、同じ分類器なら P0 < P1 < P2 < P3 < P4）。学習側の交差検証の 26 本の合算だけで選んだ（`meal` だけ・条件別だけの数字は選択に使っていない）
- 0038 の機械が読む行: `M4-CONFIG: set=mfe40 classifier=cnn seeds=0,1,2 hard_negative=none post=hyst threshold=- enter=0.80 exit=0.50 cap_s=1.5 refractory_s=0.5`
- 分類器: CNN
- 注記: 25 行と各行の格子を同じ交差検証の数字で選ぶので、選んだ行の学習側 CV の数字は楽観側に出る。選んだ構成の性能は #49 の評価側で読む。

## 誤検出の中身（R0 と選んだ行。主分類は排他、上から順に最初に当たった 1 つ）

### R0 構成 J のまま（153 回）

| 主分類 | cough | meal | neck | quiet | saliva | talk | water | 計 | 回/分（計 ÷ 非嚥下の分数の計） |
|---|---|---|---|---|---|---|---|---|---|
| 嚥下の直後の延び | 0 | 14 | 0 | 0 | 5 | 0 | 0 | 19 | 0.13 |
| 嚥下の直前 | 0 | 16 | 0 | 0 | 1 | 0 | 0 | 17 | 0.12 |
| 動作に付くもの（t・c・n） | 0 | 4 | 5 | 0 | 0 | 0 | 0 | 9 | 0.06 |
| meal の会話あり | 0 | 26 | 0 | 0 | 0 | 0 | 0 | 26 | 0.18 |
| meal の会話なし | 0 | 79 | 0 | 0 | 0 | 0 | 0 | 79 | 0.54 |
| その他 | 1 | 0 | 2 | 0 | 0 | 0 | 0 | 3 | 0.02 |
| 非嚥下（分） | 8.58 | 88.83 | 8.48 | 8.59 | 7.55 | 8.52 | 15.14 | 145.70 | |
| 回/分（計） | 0.12 | 1.56 | 0.83 | 0.00 | 0.79 | 0.00 | 0.00 | |

副表（重複あり。「動作に付くもの」の塊で、範囲にあるマーカーの種類ごとの塊の数）: `t` 3、`c` 1、`n` 5

### 選んだ行: CNN 種 0・1・2 の平均 × ヒステリシス＋塊の上限＋不応期 0.5 秒（144 回）

| 主分類 | cough | meal | neck | quiet | saliva | talk | water | 計 | 回/分（計 ÷ 非嚥下の分数の計） |
|---|---|---|---|---|---|---|---|---|---|
| 嚥下の直後の延び | 0 | 8 | 0 | 0 | 6 | 0 | 1 | 15 | 0.10 |
| 嚥下の直前 | 0 | 18 | 0 | 1 | 1 | 0 | 0 | 20 | 0.14 |
| 動作に付くもの（t・c・n） | 0 | 4 | 5 | 0 | 0 | 0 | 0 | 9 | 0.06 |
| meal の会話あり | 0 | 44 | 0 | 0 | 0 | 0 | 0 | 44 | 0.30 |
| meal の会話なし | 0 | 53 | 0 | 0 | 0 | 0 | 0 | 53 | 0.36 |
| その他 | 1 | 0 | 0 | 1 | 0 | 0 | 1 | 3 | 0.02 |
| 非嚥下（分） | 8.58 | 88.83 | 8.48 | 8.59 | 7.55 | 8.52 | 15.14 | 145.70 | |
| 回/分（計） | 0.12 | 1.43 | 0.59 | 0.23 | 0.93 | 0.00 | 0.13 | |

副表（重複あり。「動作に付くもの」の塊で、範囲にあるマーカーの種類ごとの塊の数）: `t` 3、`c` 1、`n` 5

- `meal` の咀嚼と会話（同席者の声を含む）はマーカーで分けられないので分けない。
- M3 の評価側の内訳（23 回: water の非嚥下区間 9、saliva 5、neck 5、talk 4、cough 0、quiet 0）は評価側、ここは学習側 CV で、そのまま比べない。

## 付録: 行ごとの格子

### LR a52 × なし

- 決め方: 誤検出率が 1.0 回/分以下の点が無いので、誤検出率が最小（同率なら 入り・出・上限 が高い・長いほう）

| 動作点 | 検出率 | 検出/嚥下 | 誤検出（回） | 誤検出率（回/分） | 採用 |
|---|---|---|---|---|---|
| 閾値 0.05 | 1.000 | 354/354 | 2140 | 14.69 |  |
| 閾値 0.10 | 1.000 | 354/354 | 2006 | 13.77 |  |
| 閾値 0.15 | 1.000 | 354/354 | 1763 | 12.10 |  |
| 閾値 0.20 | 0.997 | 353/354 | 1642 | 11.27 |  |
| 閾値 0.25 | 0.997 | 353/354 | 1513 | 10.38 |  |
| 閾値 0.30 | 0.997 | 353/354 | 1361 | 9.34 |  |
| 閾値 0.35 | 0.997 | 353/354 | 1218 | 8.36 |  |
| 閾値 0.40 | 0.994 | 352/354 | 1106 | 7.59 |  |
| 閾値 0.45 | 0.994 | 352/354 | 1007 | 6.91 |  |
| 閾値 0.50 | 0.994 | 352/354 | 919 | 6.31 |  |
| 閾値 0.55 | 0.994 | 352/354 | 828 | 5.68 |  |
| 閾値 0.60 | 0.994 | 352/354 | 756 | 5.19 |  |
| 閾値 0.65 | 0.994 | 352/354 | 688 | 4.72 |  |
| 閾値 0.70 | 0.994 | 352/354 | 602 | 4.13 |  |
| 閾値 0.75 | 0.992 | 351/354 | 515 | 3.53 |  |
| 閾値 0.80 | 0.986 | 349/354 | 458 | 3.14 |  |
| 閾値 0.85 | 0.980 | 347/354 | 374 | 2.57 |  |
| 閾値 0.90 | 0.972 | 344/354 | 265 | 1.82 |  |
| 閾値 0.95 | 0.935 | 331/354 | 157 | 1.08 | ○ |

### LR a52 × ヒステリシス

- 決め方: 誤検出率が 1.0 回/分以下の点が無いので、誤検出率が最小（同率なら 入り・出・上限 が高い・長いほう）

| 動作点 | 検出率 | 検出/嚥下 | 誤検出（回） | 誤検出率（回/分） | 採用 |
|---|---|---|---|---|---|
| 入り 0.15・出 0.05 | 1.000 | 354/354 | 1209 | 8.30 |  |
| 入り 0.20・出 0.10 | 1.000 | 354/354 | 1275 | 8.75 |  |
| 入り 0.25・出 0.15 | 1.000 | 354/354 | 1229 | 8.44 |  |
| 入り 0.25・出 0.05 | 1.000 | 354/354 | 929 | 6.38 |  |
| 入り 0.30・出 0.20 | 0.997 | 353/354 | 1157 | 7.94 |  |
| 入り 0.30・出 0.10 | 0.997 | 353/354 | 958 | 6.58 |  |
| 入り 0.35・出 0.25 | 0.997 | 353/354 | 1079 | 7.41 |  |
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
| 入り 0.95・出 0.85・上限 2.5 秒 | 0.935 | 331/354 | 156 | 1.07 |  |
| 入り 0.95・出 0.75・上限 1.5 秒 | 0.929 | 329/354 | 144 | 0.99 |  |
| 入り 0.95・出 0.75・上限 2.0 秒 | 0.929 | 329/354 | 158 | 1.08 |  |
| 入り 0.95・出 0.75・上限 2.5 秒 | 0.932 | 330/354 | 167 | 1.15 |  |
| 入り 0.95・出 0.65・上限 1.5 秒 | 0.927 | 328/354 | 144 | 0.99 |  |
| 入り 0.95・出 0.65・上限 2.0 秒 | 0.927 | 328/354 | 165 | 1.13 |  |
| 入り 0.95・出 0.65・上限 2.5 秒 | 0.932 | 330/354 | 177 | 1.21 |  |
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
