owhinata/zaitaku-mealpace/docs/log/2026-10-25.md

# 2026-10-25

## #48 学習用 `meal` 1 本目（学習用の収集日 1）

- M4 の学習用 `meal`（docs/decisions/0037。3 本、10/25〜10/28、締め 10/28 の終わり）。PC の記録の経路（`record.py --throat sh12jk-wired-unoq-usbaudio --cond meal --duration 1800`、
  docs/decisions/0028）。手順は `docs/recording-protocol.md`「M4 の `meal`（咽喉マイク）」。被験者 `self`。
- `throat_check.py --tap-mode enter` の数字は人が実行した出力から写した。マーカーの数は `events.csv`、記録の形は `meta.json` から写した（音声の中身は見ていない。
  振幅・特徴量・分類器の結果は出していない）。採否は人が記録の直後に決めた（下の「人の決定（10/25）」）。
- 装着の側は M3 と同じ側。

| セッション | 条件 | 長さ（秒） | 止まり方 | 会話 | 同席者 | `s` | `t` | `c` | `o`（tap / start / conv / その他の note） | overrun の行 | 推定差（ms） | 段差 | 叩き 見つかった数 / `Δ` 中央値 | 使わない目安 | 打ち忘れの体感 | 打ち遅れの体感 | 記録時の `s` の決まり | 採否と理由 |
|---|---|---|---|---|---|---|---|---|---|---|---|---|---|---|---|---|---|---|
| `20261025-200807_self_meal` | meal | 1800.125 | duration（30 分の自動終了。食べ終わる前に切れた） | あり（`o conv`） | あり | 68 | 12 | 0 | 4 / 1 / 1 / 1（`tao`。`tap` の綴り違い） | 0 | +27 | なし | 4 / 4、−102.1 ms（印（50 ms < \|Δ\| ≤ 125 ms、条件 10）） | 当たらない | 数回 | ほぼ無し | 0023（意識した食べ物・飲み物の嚥下に `s`） | 採用（人の決定 10/25、数字を見る前） |

- `o start` は 1 つ（64.7 秒）で、その前に `s`・`t`・`c` は無い。`o conv` は `o start` の 3.8 秒後。`o start` から記録の終端まで 28.9 分。`s` はすべて `o start` の後で、
  最初の `s` は `o start` の 143 秒後、最後の `s` は終端の 7.7 秒前（0023 の 6「終わりの 1.5 秒以内の `s`」に当たらない）。`s` の間隔 10 秒未満は 9 組（`meal` では制限なし）。
- 時刻の対応: c0 −164.2 ms、クロックの差 +27.0 ppm、残差の中央値 8.5 ms・95 パーセンタイル 23.8 ms・最大 153.8 ms。L と R の相関 1.000、RMS の比 1.000。0 の区間 0 回。
  `meta.json`: `fw` `pc-throat`、`sensors[0].iface` `sh12jk-wired-unoq-usbaudio`、`position` `lateral-below-cricoid`、`band` `sh12jk-strap`、`throat.mixer` Mic 58・on、`throat.stop` `duration`。
- 捨てる条件（0037 の 5: M3 の 1〜7・9・10、0023 の 6・8・9）はどれにも当たらない。条件 10（叩きの `Δ` の印）に当たり、印を付けたまま使う。

### 人の決定（10/25）

- 採用。2 回目の叩きの note `tao`（`tap` の綴り違い）は、0037 が `meal` に当てる番号つきの条件には無く、叩きは残りの 4 回で見つかり条件 9 を満たすので、捨てる理由にしない。
- 体感: 打ち忘れ「数回」（2〜3 回）、打ち遅れ「ほぼ無し」。体感は採否に使わない（0023）。
- 同席者あり、会話あり。30 分の自動終了で食べ終わる前に切れた（0023: 自動終了した記録もそのまま 1 セッション）。

## 次

- 学習用 `meal` 2 本目・3 本目（10/28 まで。会話なしを 1 本含めるのが目安）。締めの後に名前を 0037 の `M4-TRAIN` と `fixed_eval.M4_EXPECTED_TRAIN` に追記（plan #45 のステップ 2 の (1)）。
