owhinata/zaitaku-mealpace/docs/log/2026-10-12-43/session_20261011-102354_self_talk.png

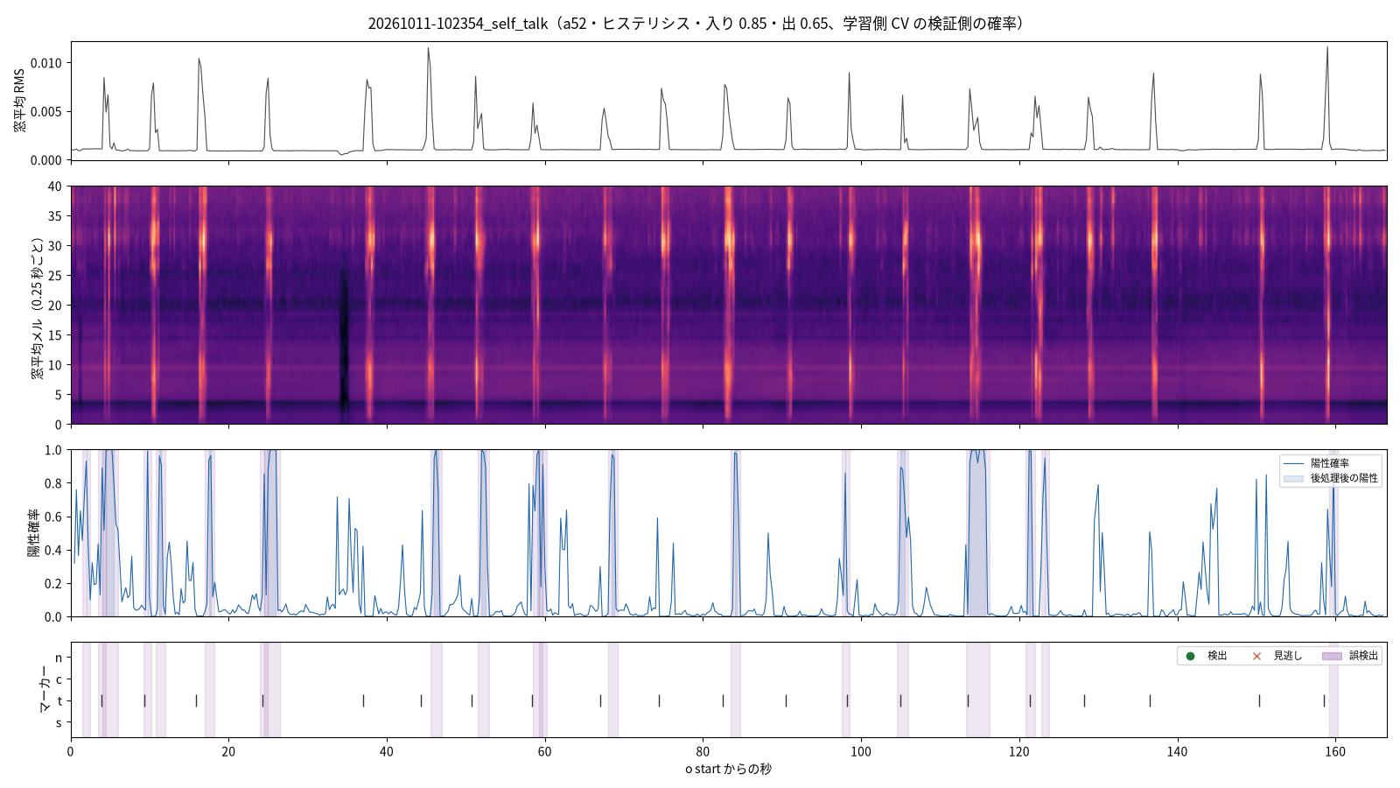
docs/log/2026-10-12-43/session_20261011-102354_self_talk.png
