owhinata/zaitaku-mealpace/docs/log/2026-10-12-43/session_20261011-103912_self_water.png

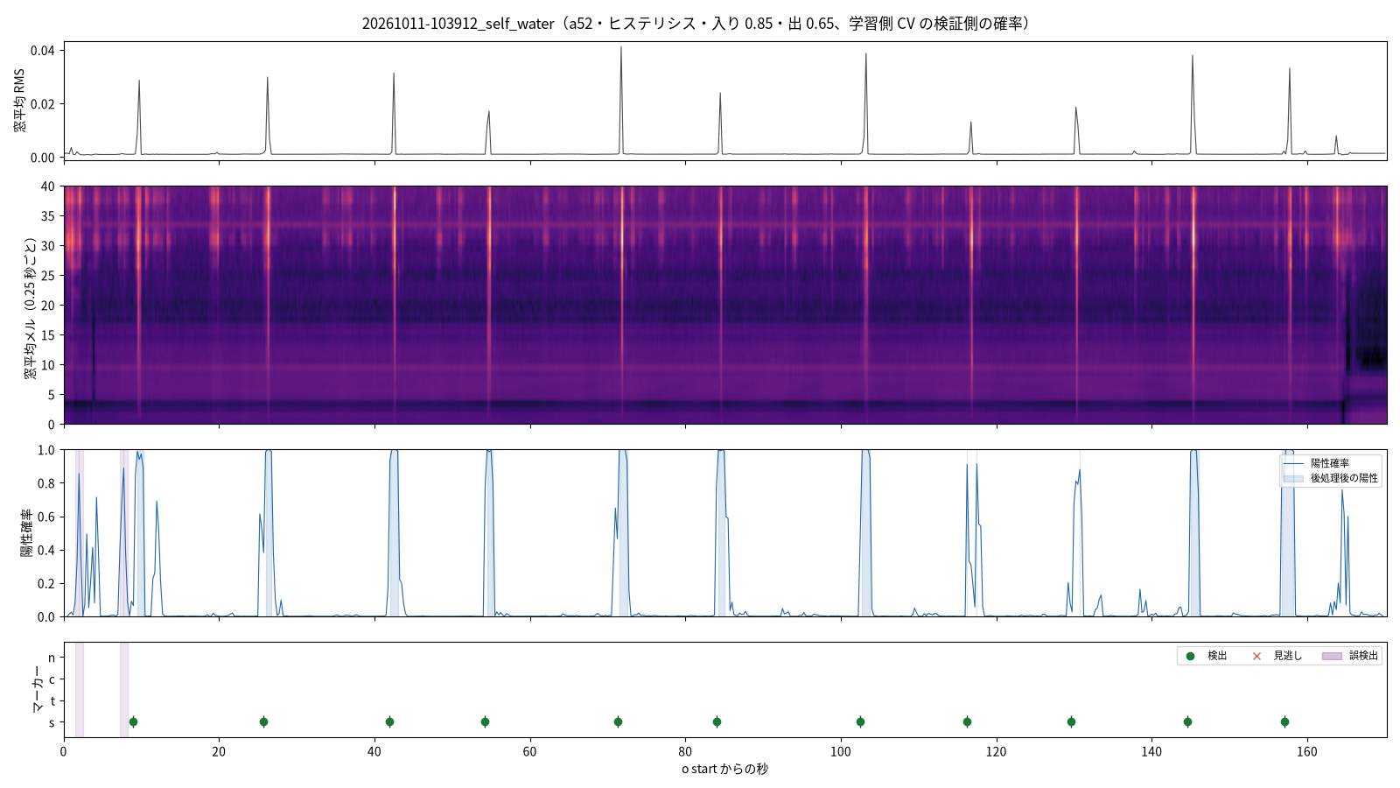
docs/log/2026-10-12-43/session_20261011-103912_self_water.png
