owhinata/zaitaku-mealpace/docs/log/2026-10-12-43/session_20261011-202730_self_water.png

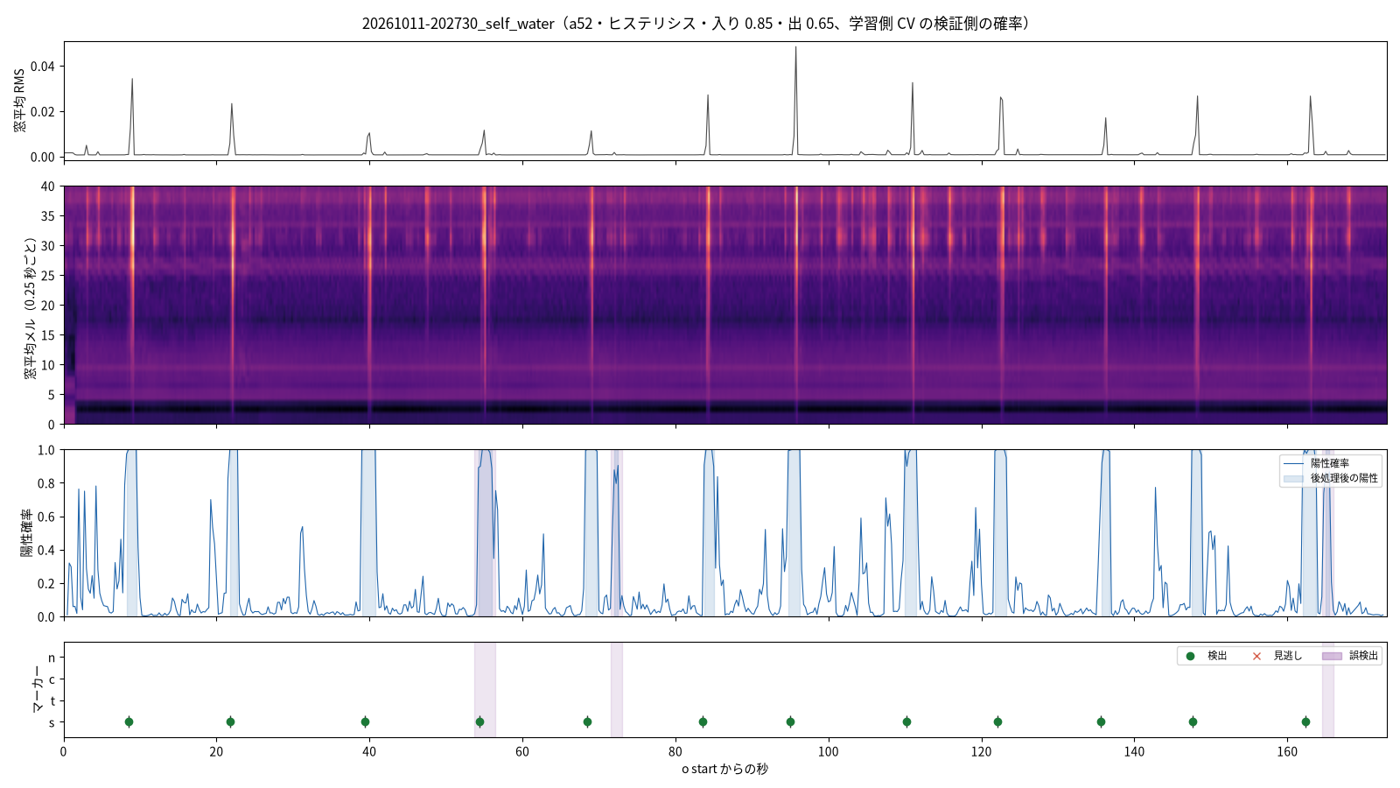
docs/log/2026-10-12-43/session_20261011-202730_self_water.png
