owhinata/zaitaku-mealpace/docs/log/2026-10-12-43/session_20261011-203152_self_talk.png

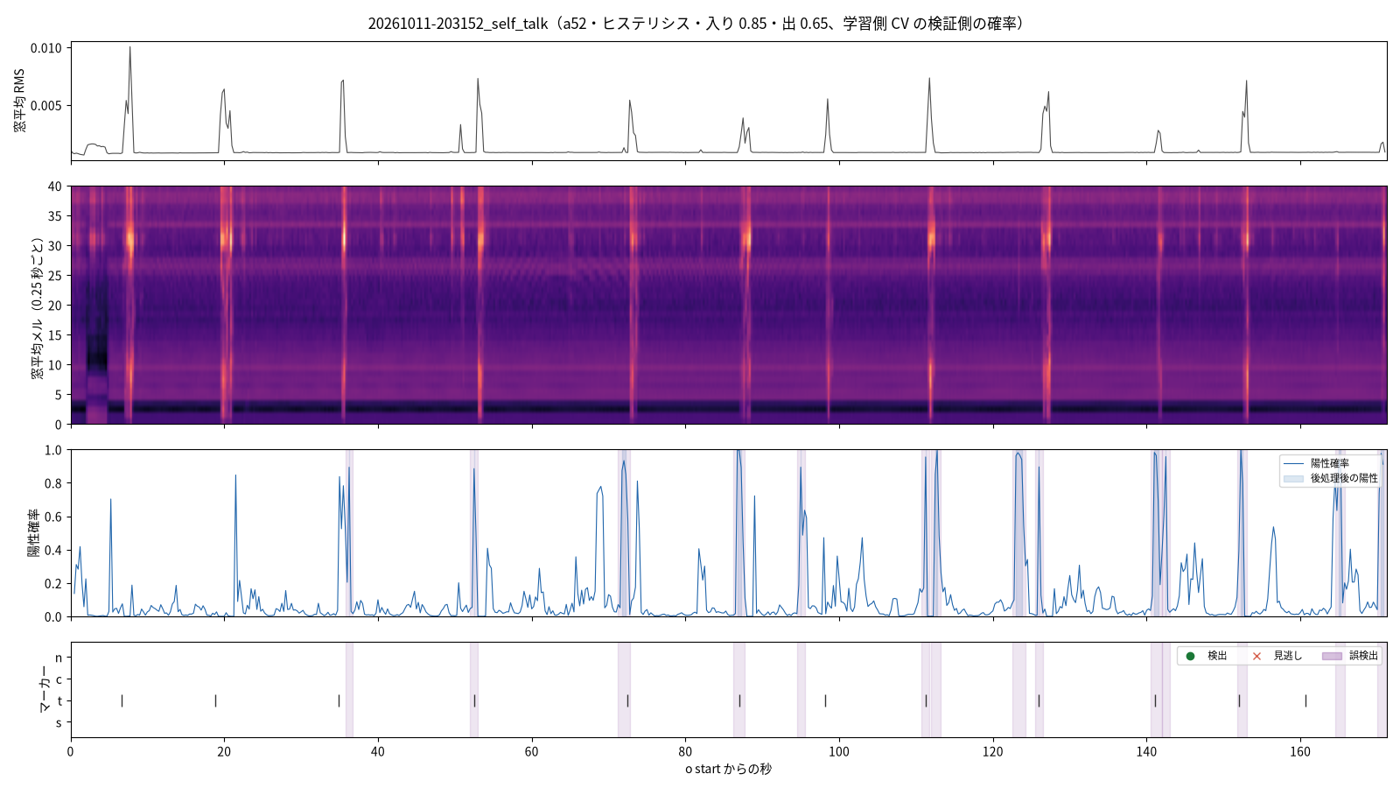
docs/log/2026-10-12-43/session_20261011-203152_self_talk.png
