owhinata/zaitaku-mealpace/docs/log/2026-10-12-43/session_20261011-204956_self_cough.png

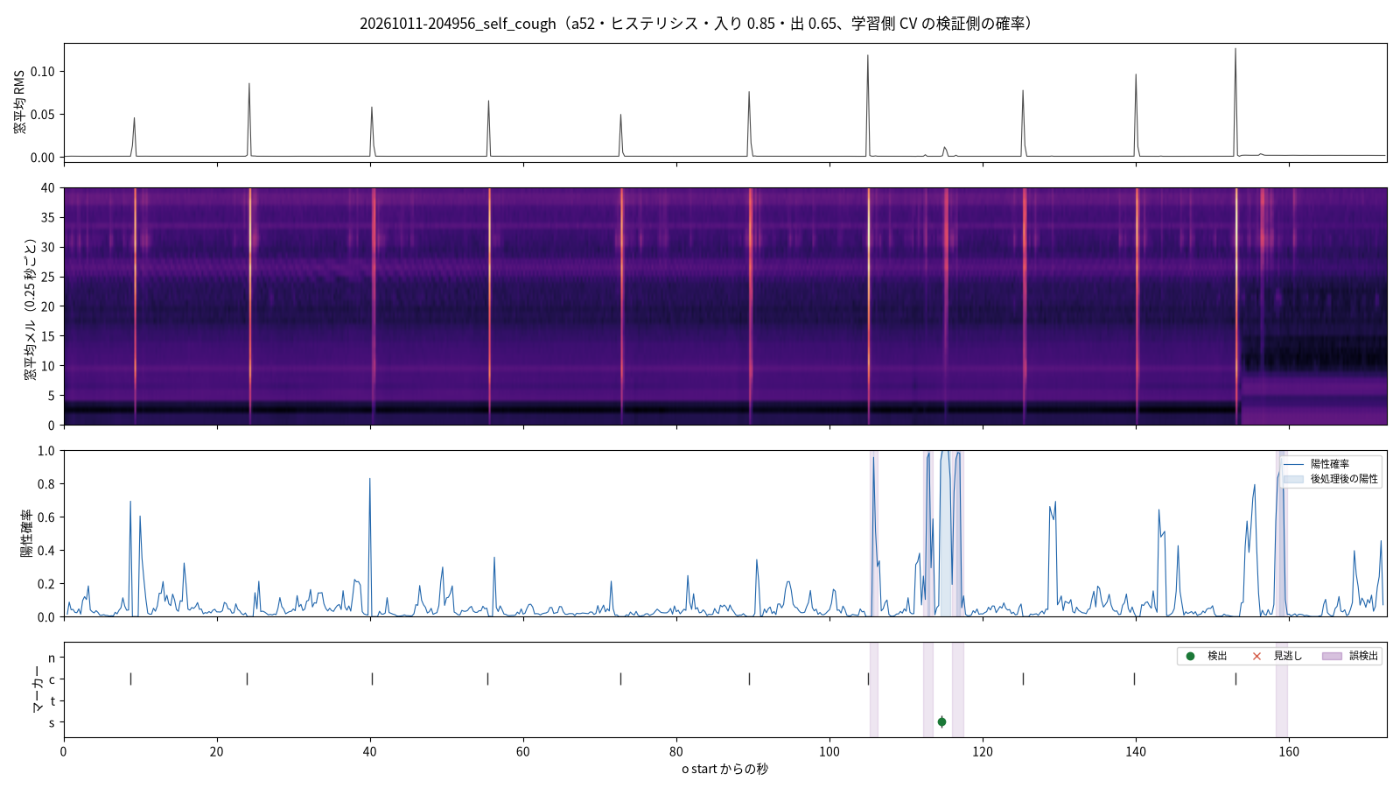
docs/log/2026-10-12-43/session_20261011-204956_self_cough.png
