owhinata/zaitaku-mealpace/docs/log/2026-10-13-40/events_02.png

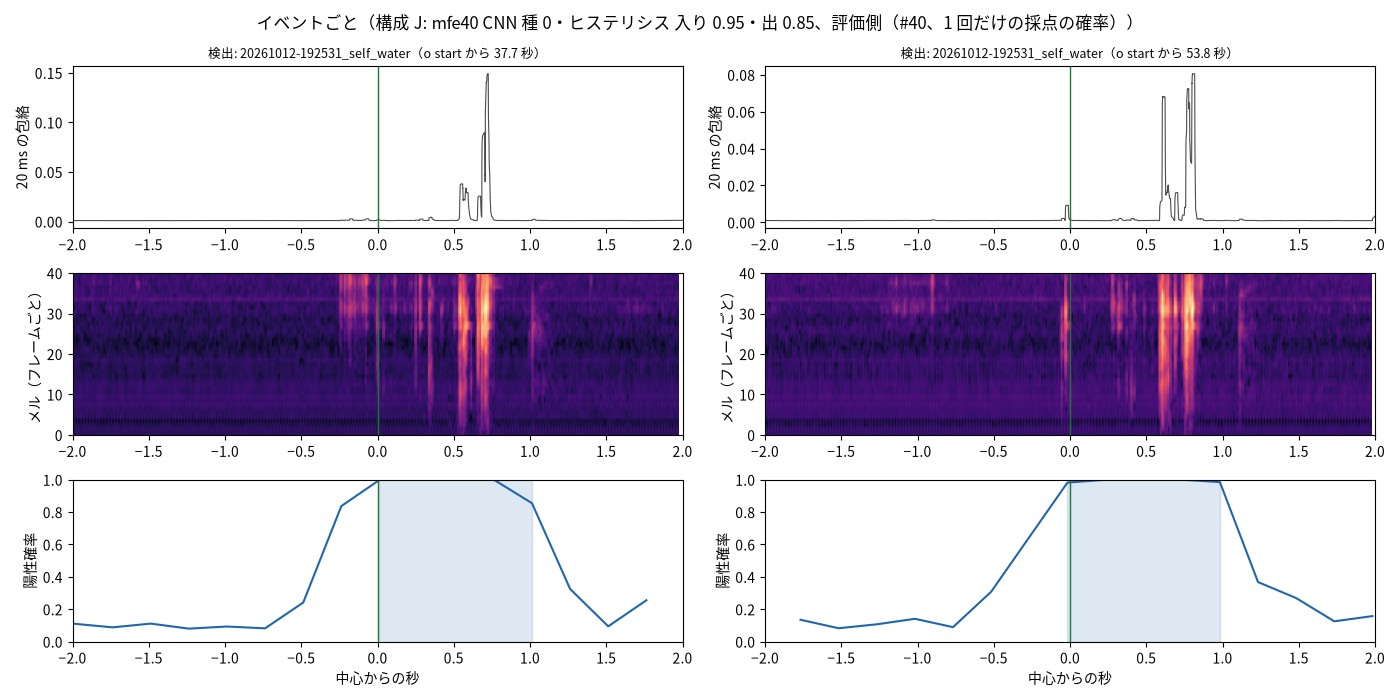
docs/log/2026-10-13-40/events_02.png
