owhinata/zaitaku-mealpace/docs/log/2026-10-13-40/final.png

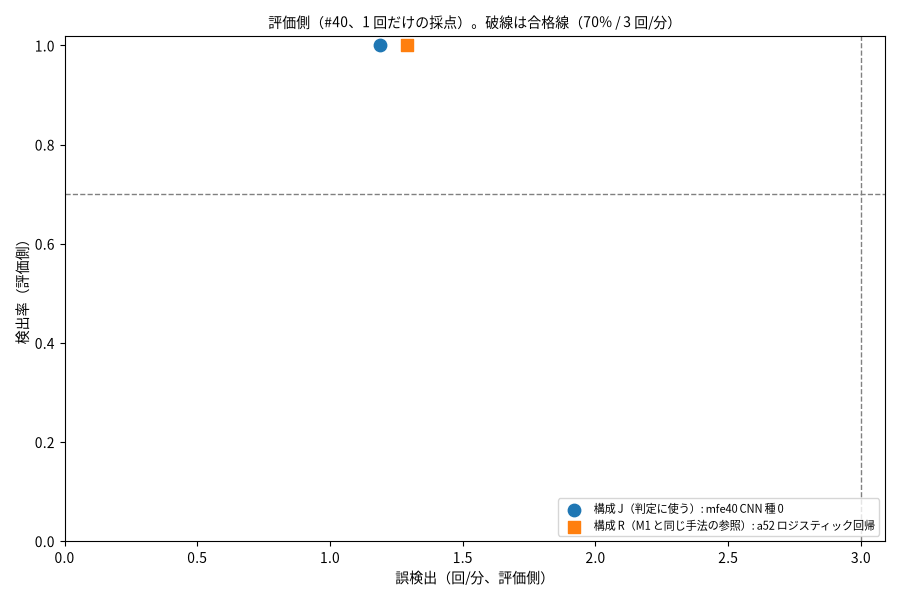
docs/log/2026-10-13-40/final.png
