owhinata/zaitaku-mealpace/docs/log/2026-10-13-40/session_20261012-191826_self_quiet.png

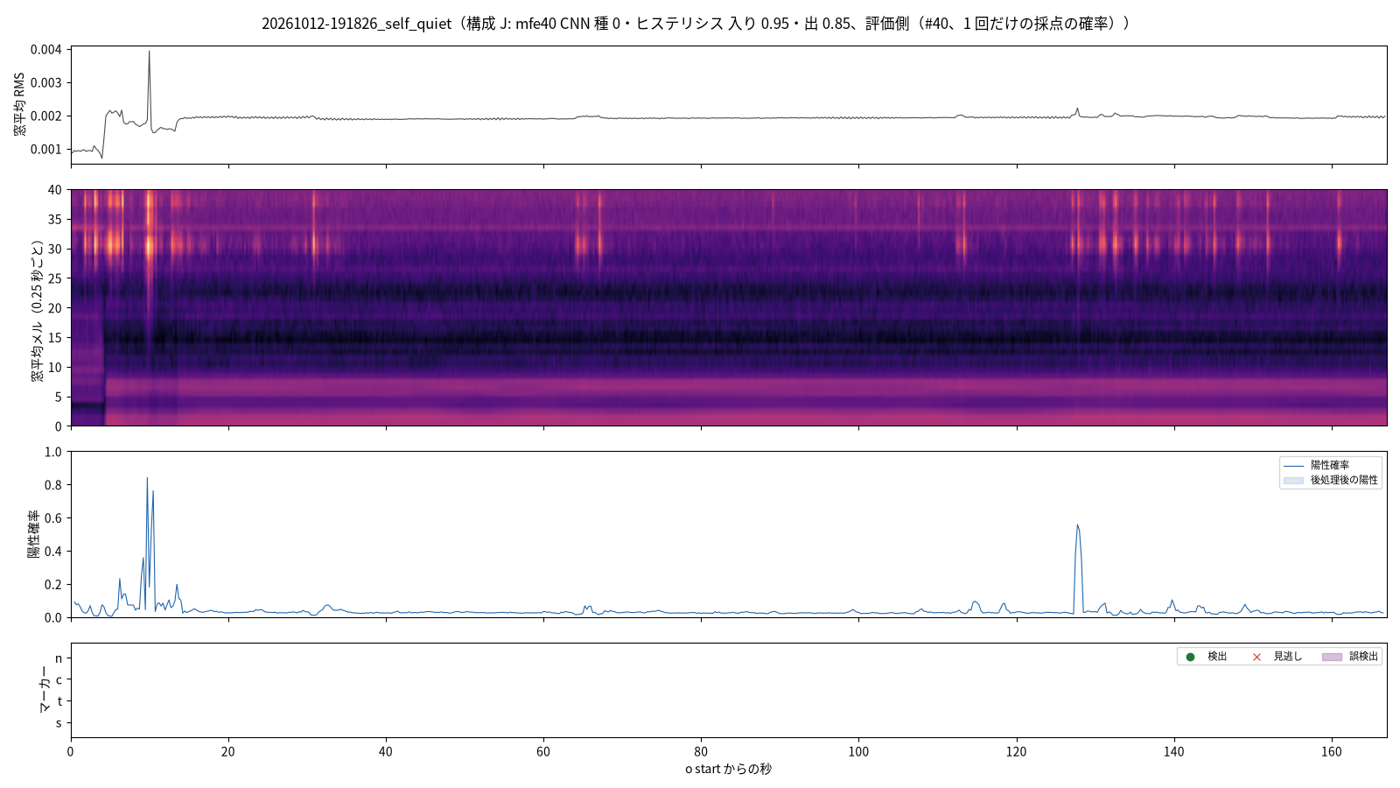
docs/log/2026-10-13-40/session_20261012-191826_self_quiet.png
