owhinata/zaitaku-mealpace/docs/log/2026-10-13-40/session_20261012-192531_self_water.png

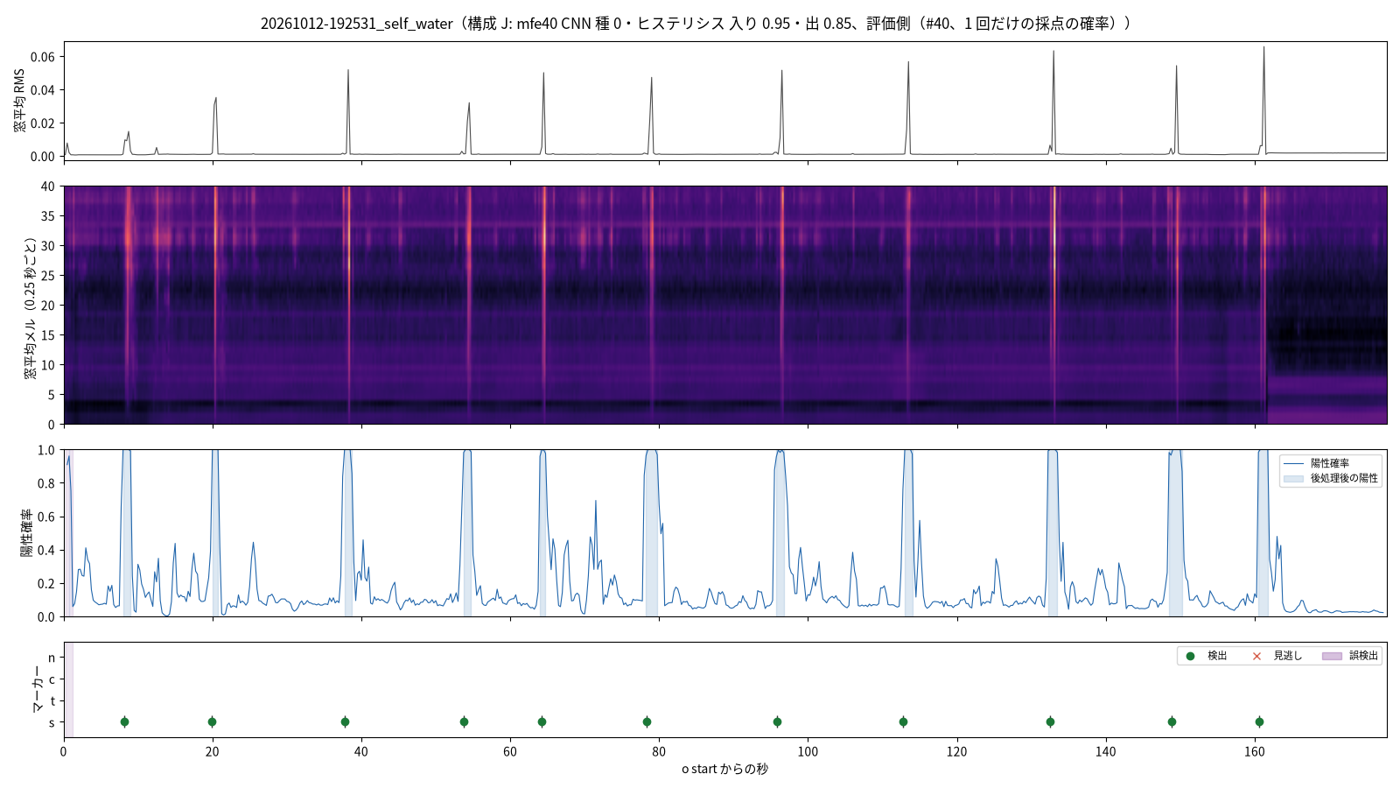
docs/log/2026-10-13-40/session_20261012-192531_self_water.png
