owhinata/zaitaku-mealpace/docs/log/2026-10-13-40/session_20261012-193001_self_talk.png

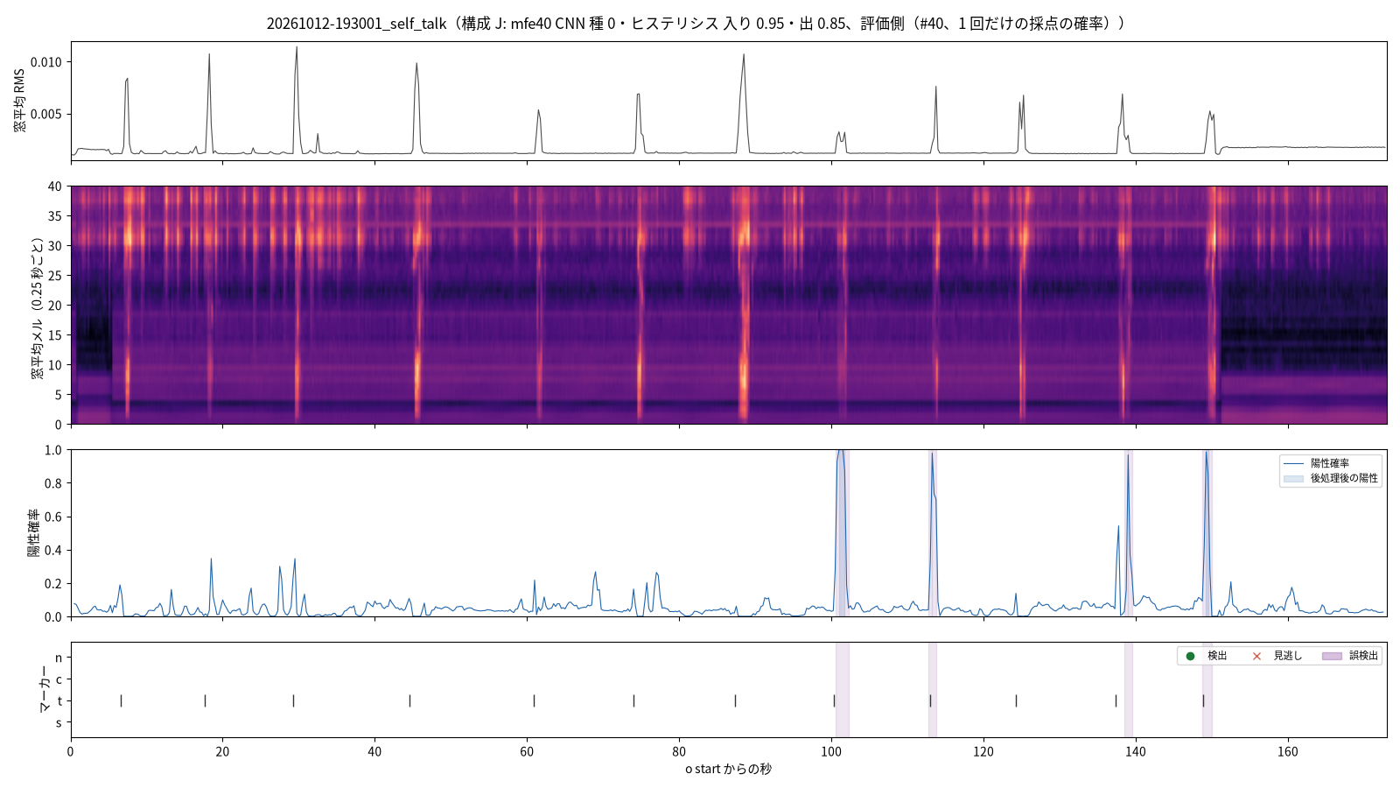
docs/log/2026-10-13-40/session_20261012-193001_self_talk.png
