owhinata/zaitaku-mealpace/docs/log/2026-10-13-40/session_20261012-193459_self_saliva.png

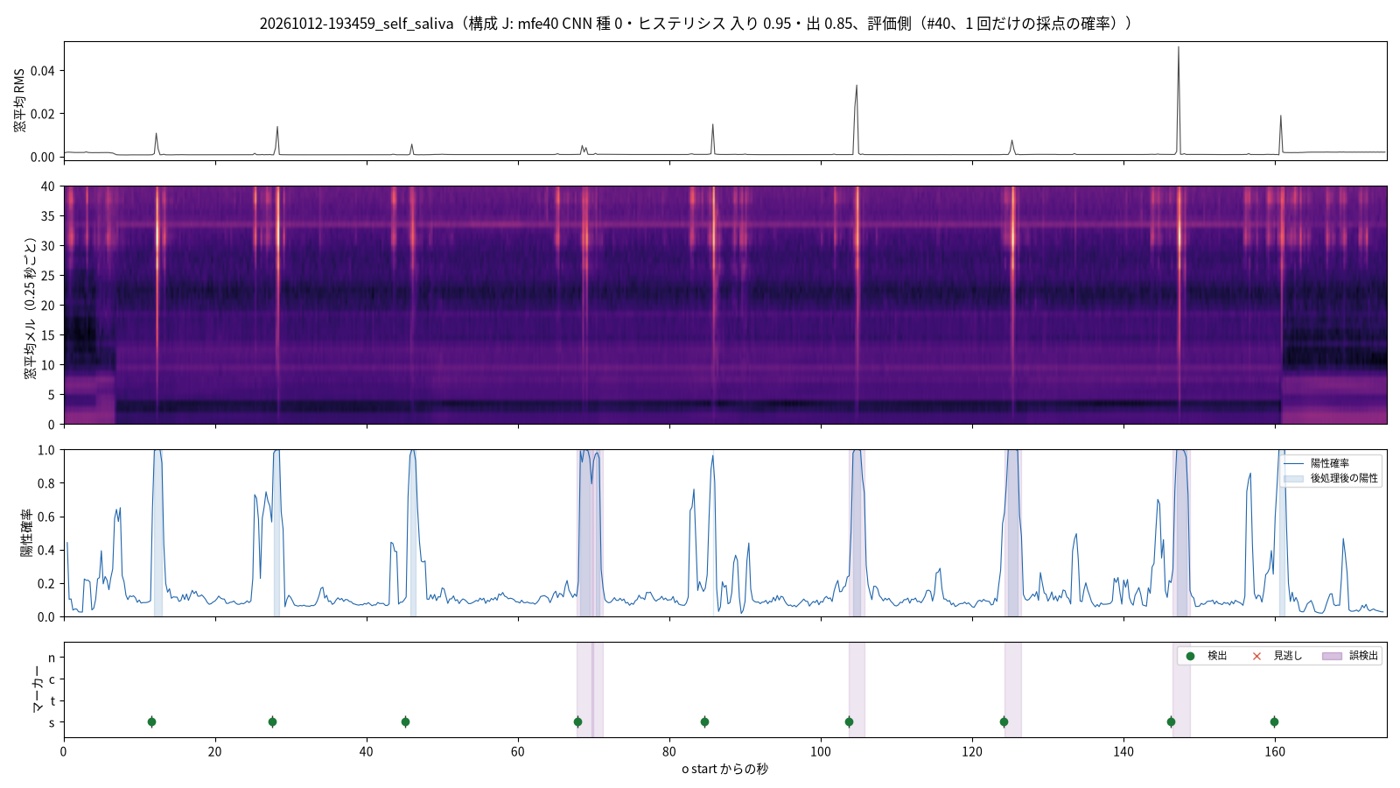
docs/log/2026-10-13-40/session_20261012-193459_self_saliva.png
