owhinata/zaitaku-mealpace/docs/log/2026-10-13-40/session_20261012-193929_self_neck.png

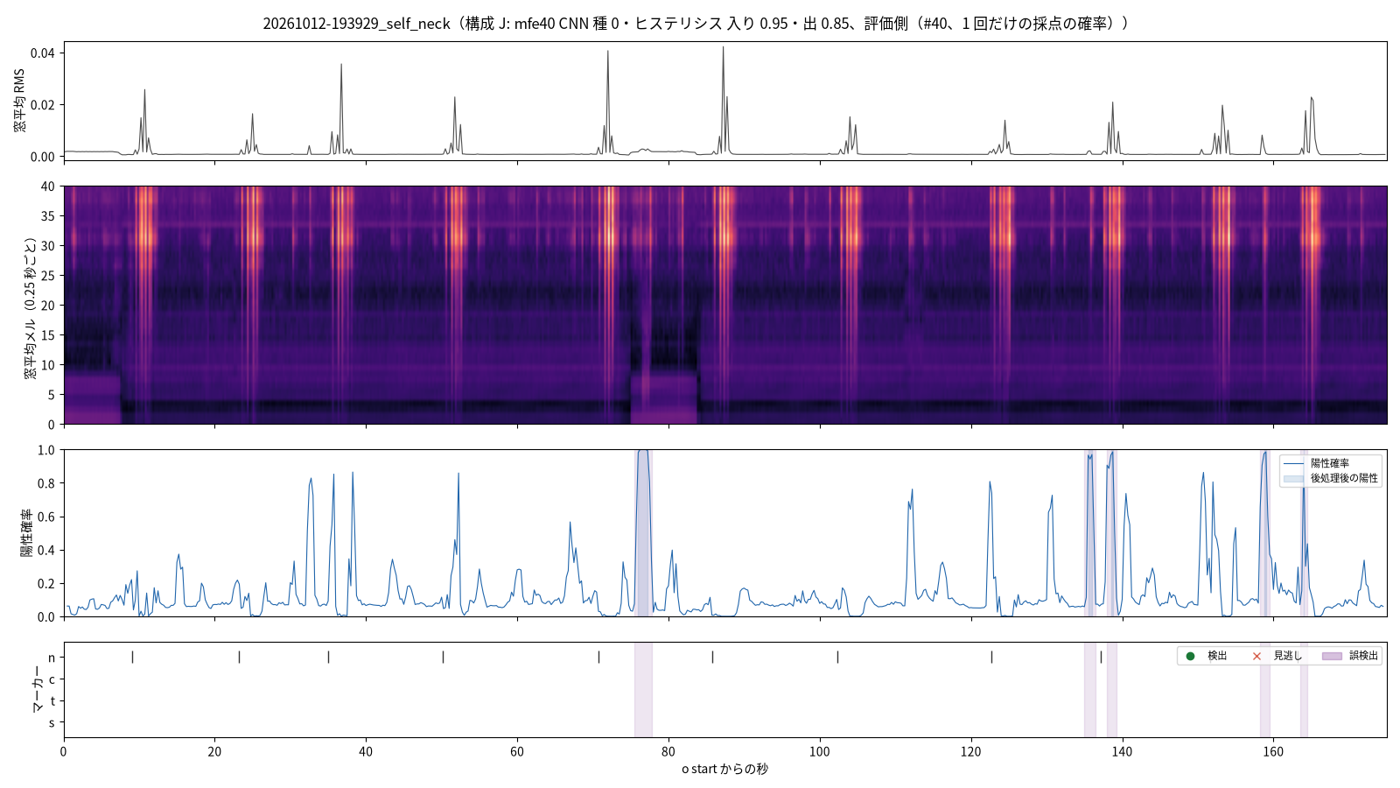
docs/log/2026-10-13-40/session_20261012-193929_self_neck.png
