owhinata/zaitaku-mealpace/docs/log/2026-10-13-40/session_20261012-194854_self_cough.png

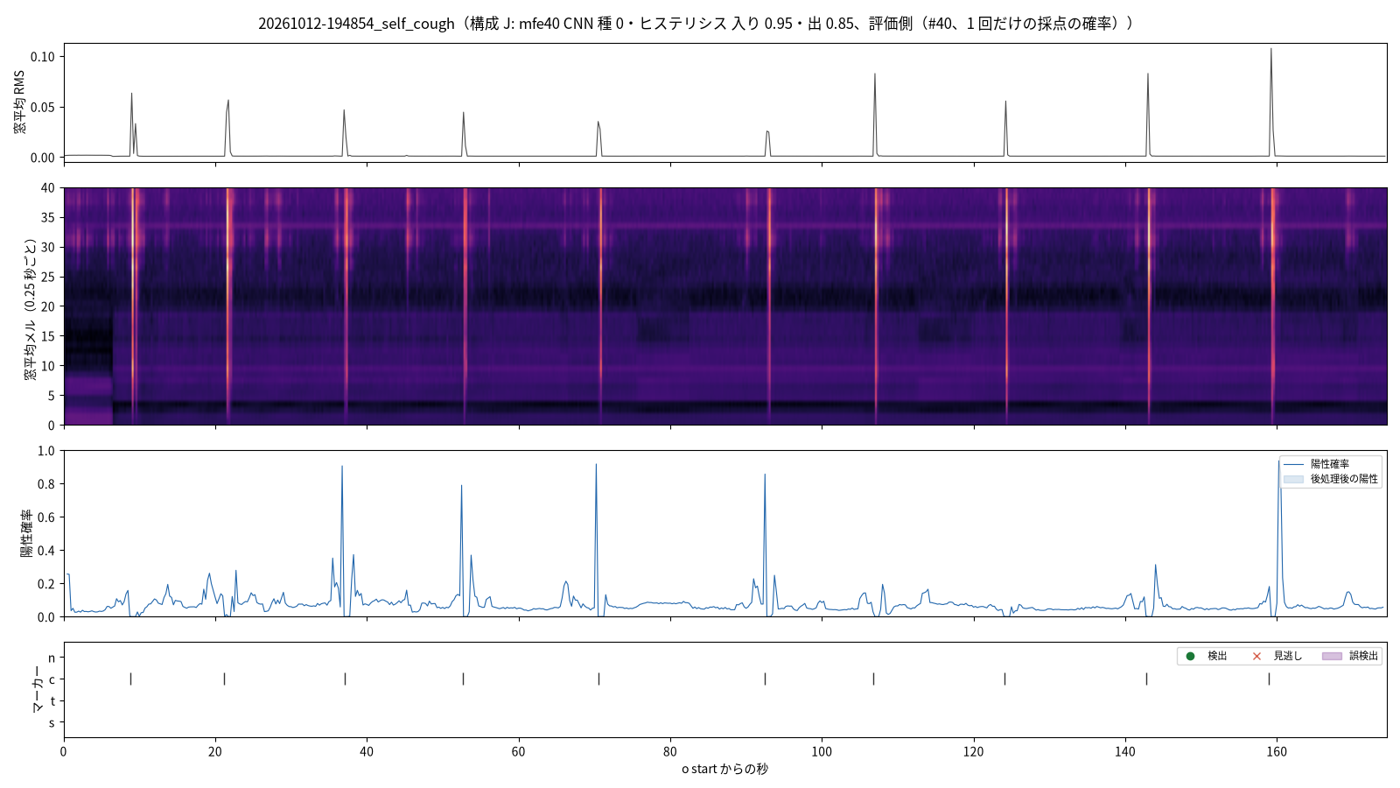
docs/log/2026-10-13-40/session_20261012-194854_self_cough.png
