owhinata/zaitaku-mealpace/docs/log/2026-10-28-45/compare.png

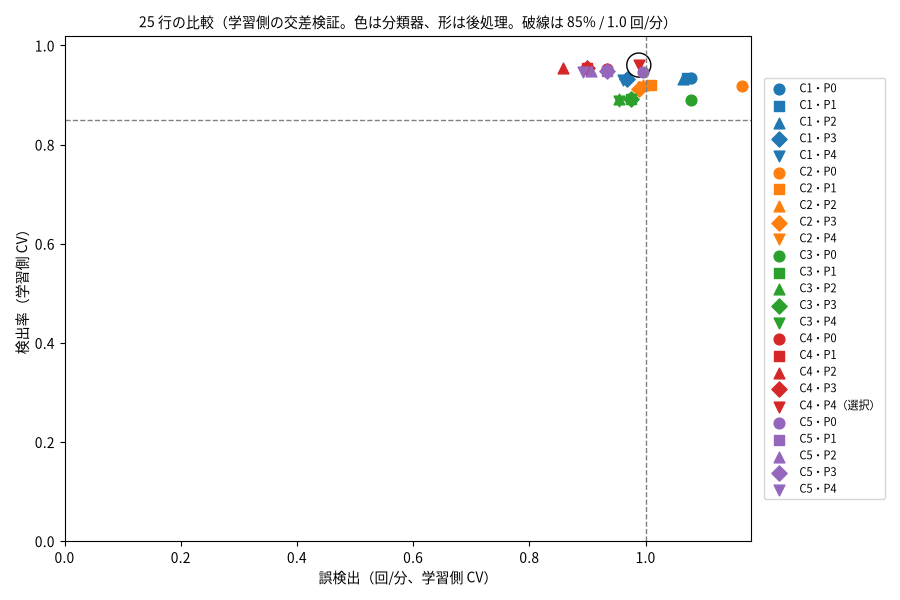
docs/log/2026-10-28-45/compare.png
