owhinata/zaitaku-mealpace/docs/log/2026-10-28-45/events_04.png

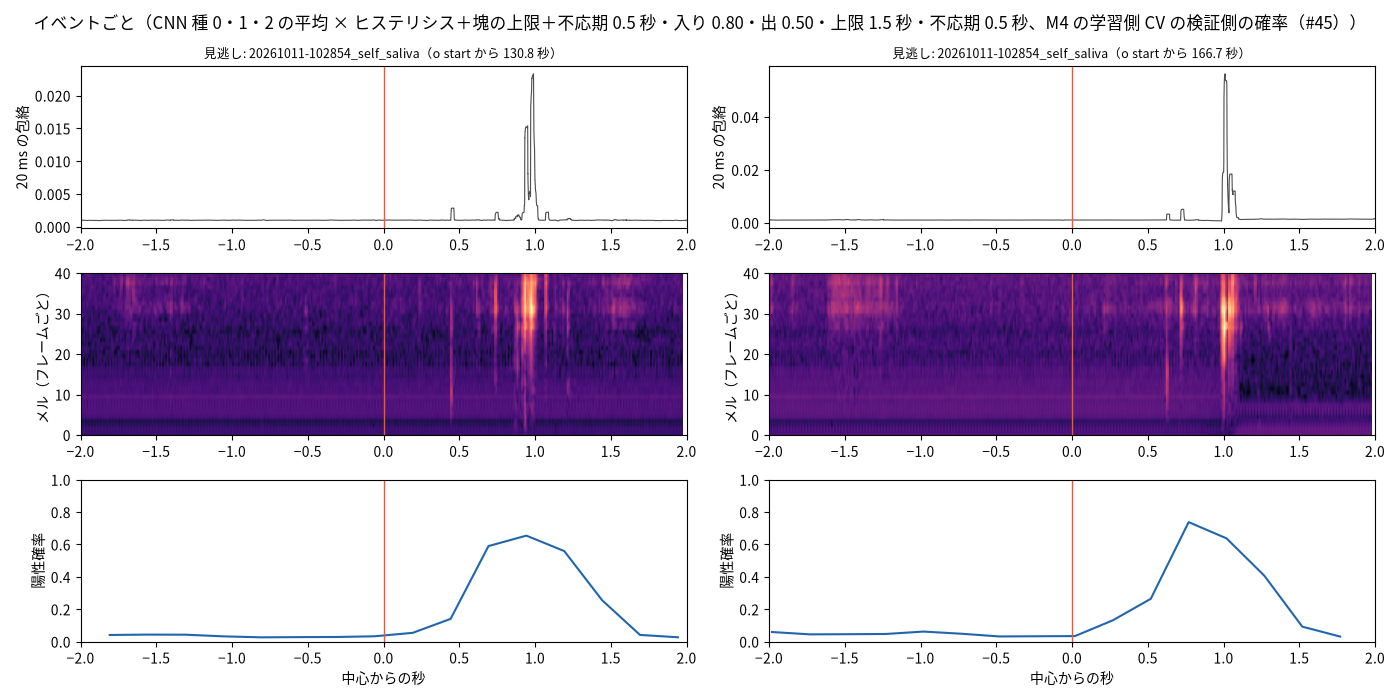
docs/log/2026-10-28-45/events_04.png
