owhinata/zaitaku-mealpace/docs/log/2026-10-28-45/events_05.png

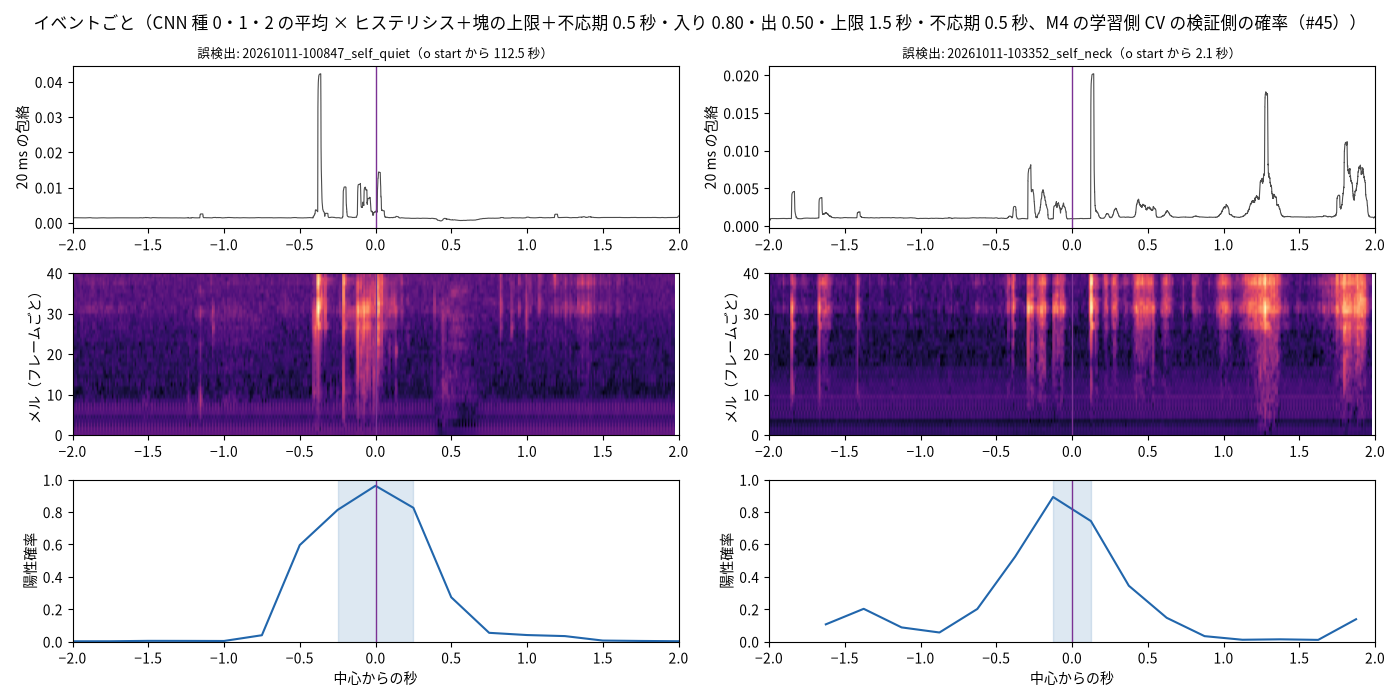
docs/log/2026-10-28-45/events_05.png
