owhinata/zaitaku-mealpace/docs/log/2026-10-28-45/fp_breakdown.png

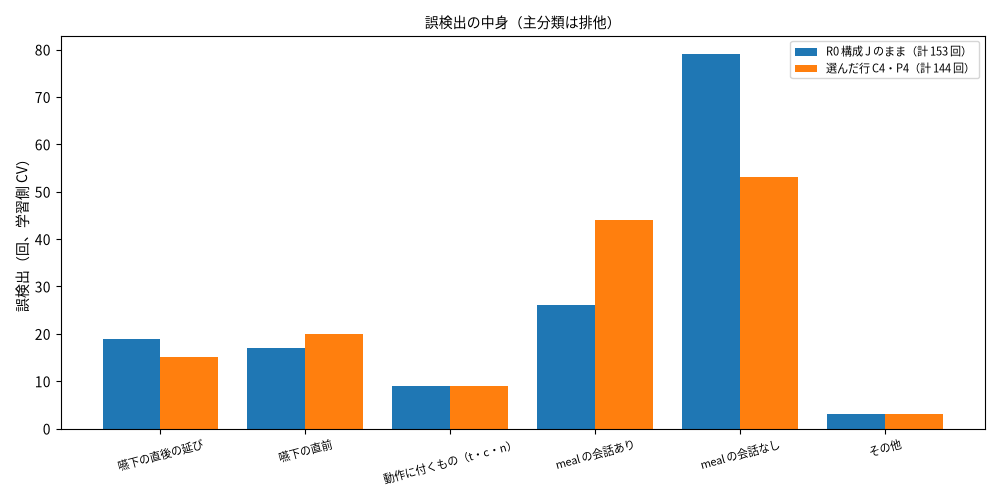
docs/log/2026-10-28-45/fp_breakdown.png
