owhinata/zaitaku-mealpace/docs/log/2026-10-28-45/session_20261011-100847_self_quiet.png

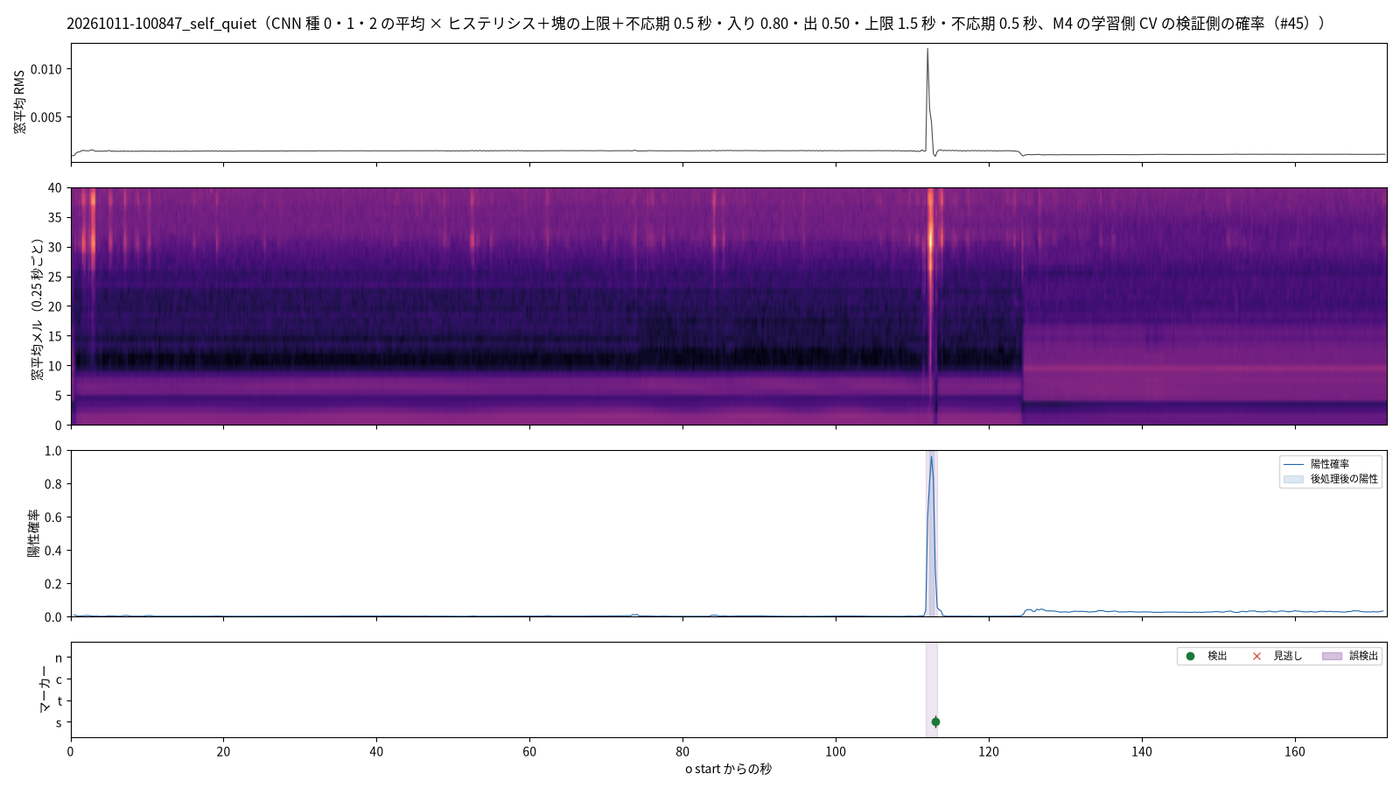
docs/log/2026-10-28-45/session_20261011-100847_self_quiet.png
