owhinata/zaitaku-mealpace/docs/log/2026-10-28-45/session_20261011-103352_self_neck.png

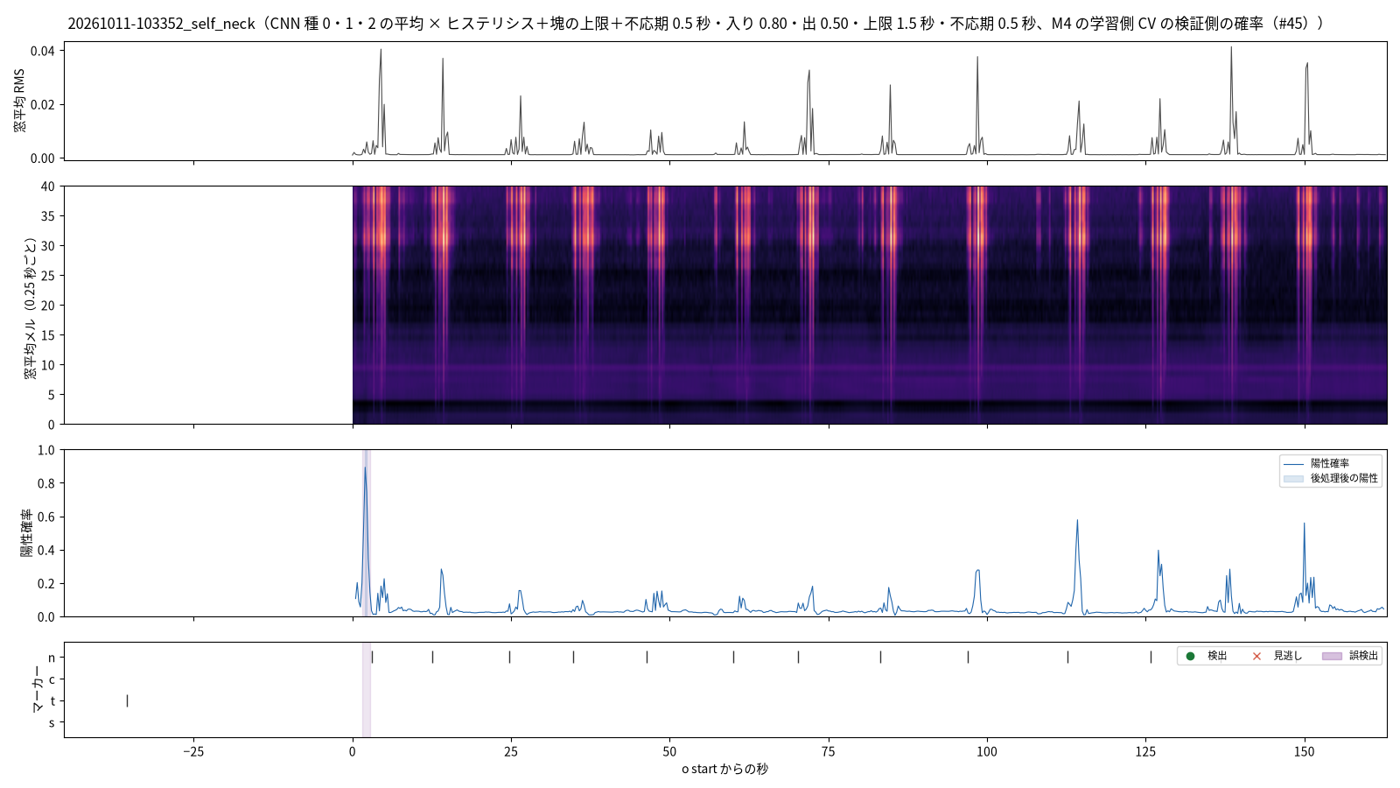
docs/log/2026-10-28-45/session_20261011-103352_self_neck.png
