owhinata/zaitaku-mealpace/docs/log/2026-10-28-45/session_20261011-104408_self_cough.png

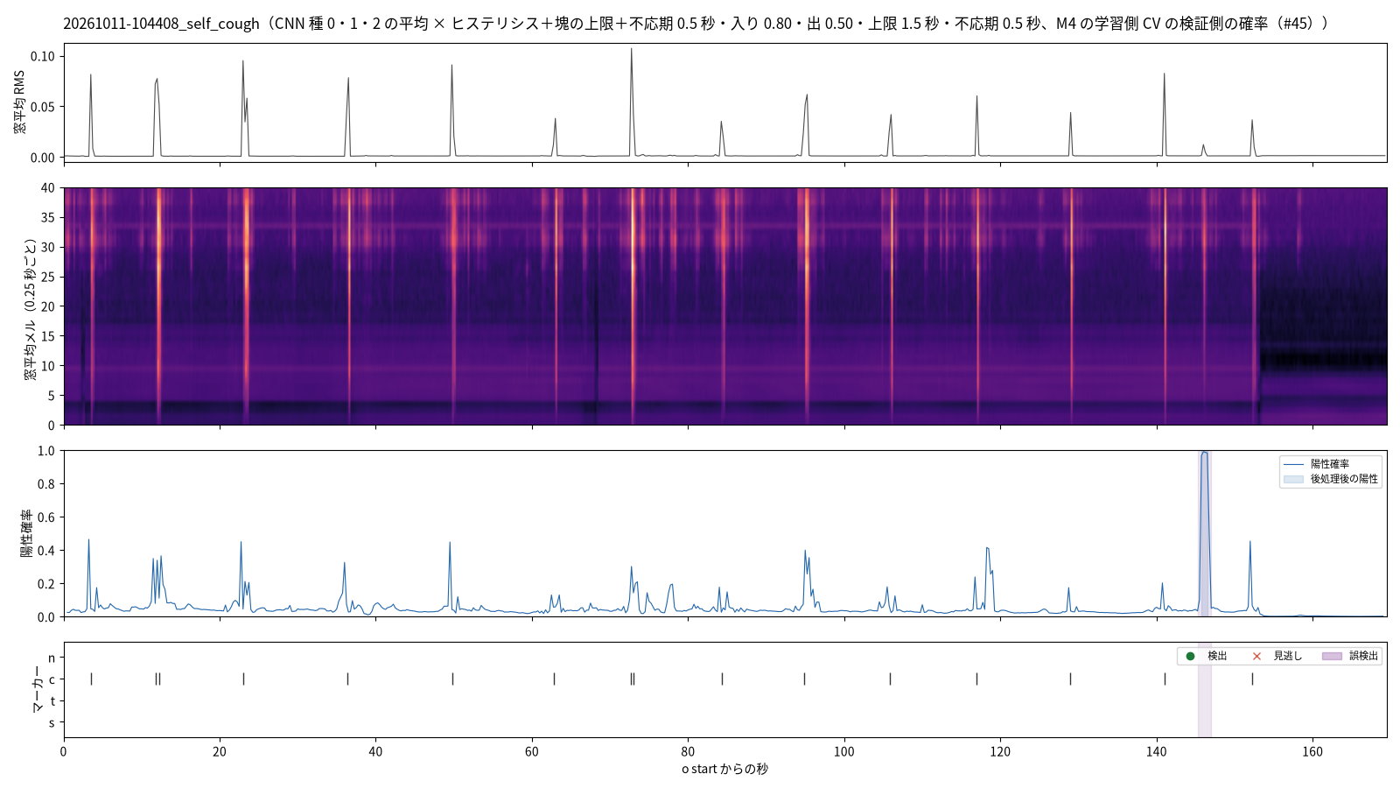
docs/log/2026-10-28-45/session_20261011-104408_self_cough.png
