owhinata/zaitaku-mealpace/docs/log/2026-10-28-45/session_20261011-202238_self_quiet.png

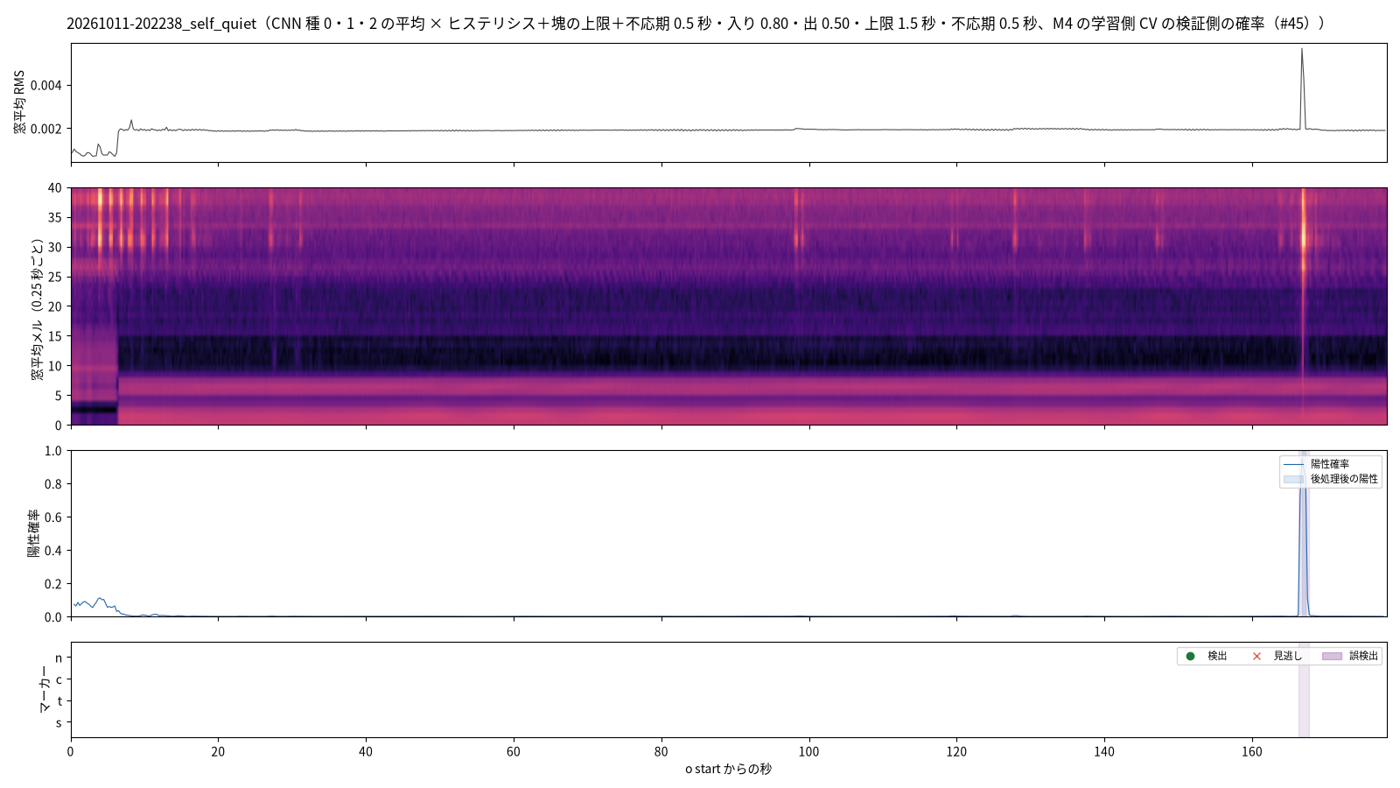
docs/log/2026-10-28-45/session_20261011-202238_self_quiet.png
