owhinata/zaitaku-mealpace/docs/log/2026-10-28-45/session_20261011-203631_self_saliva.png

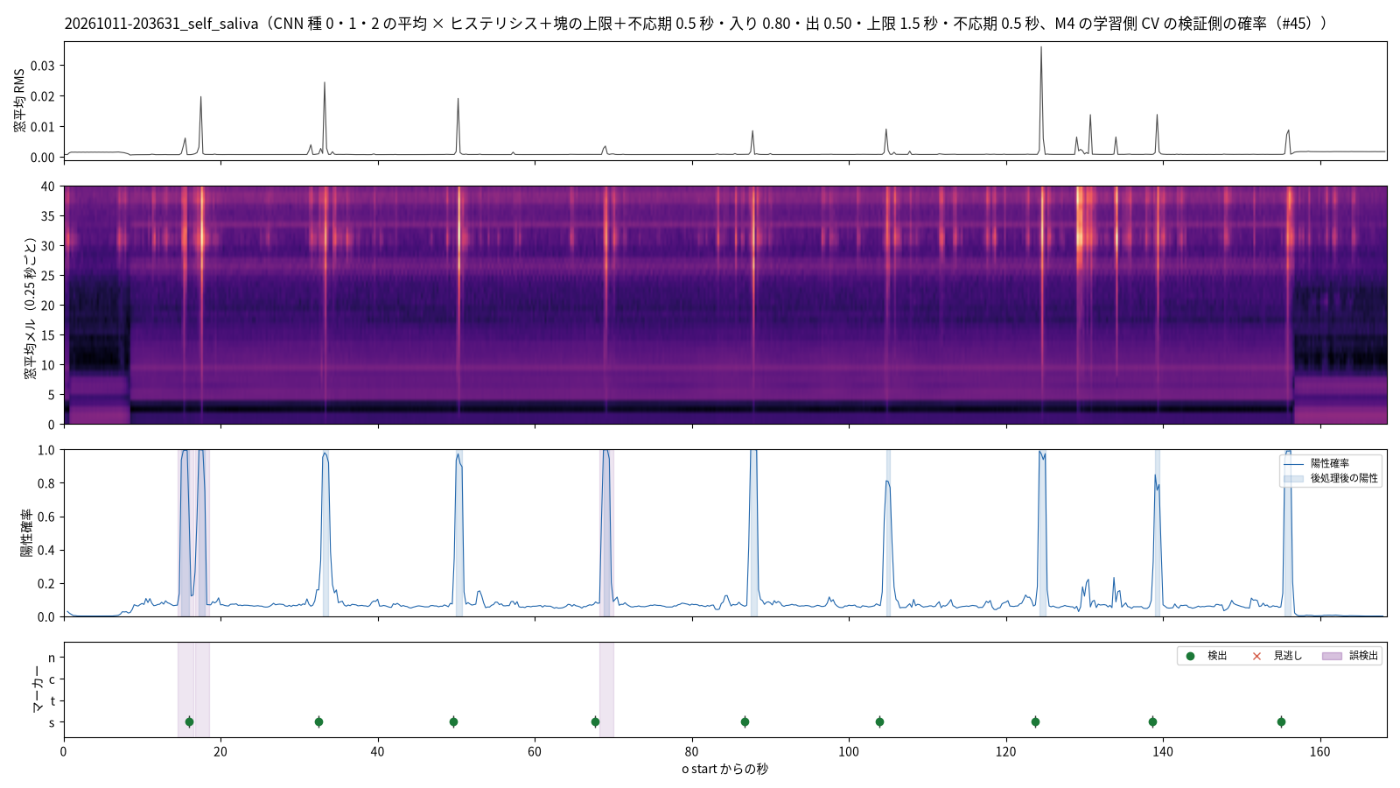
docs/log/2026-10-28-45/session_20261011-203631_self_saliva.png
