owhinata/zaitaku-mealpace/docs/log/2026-10-28-45/session_20261012-193459_self_saliva.png

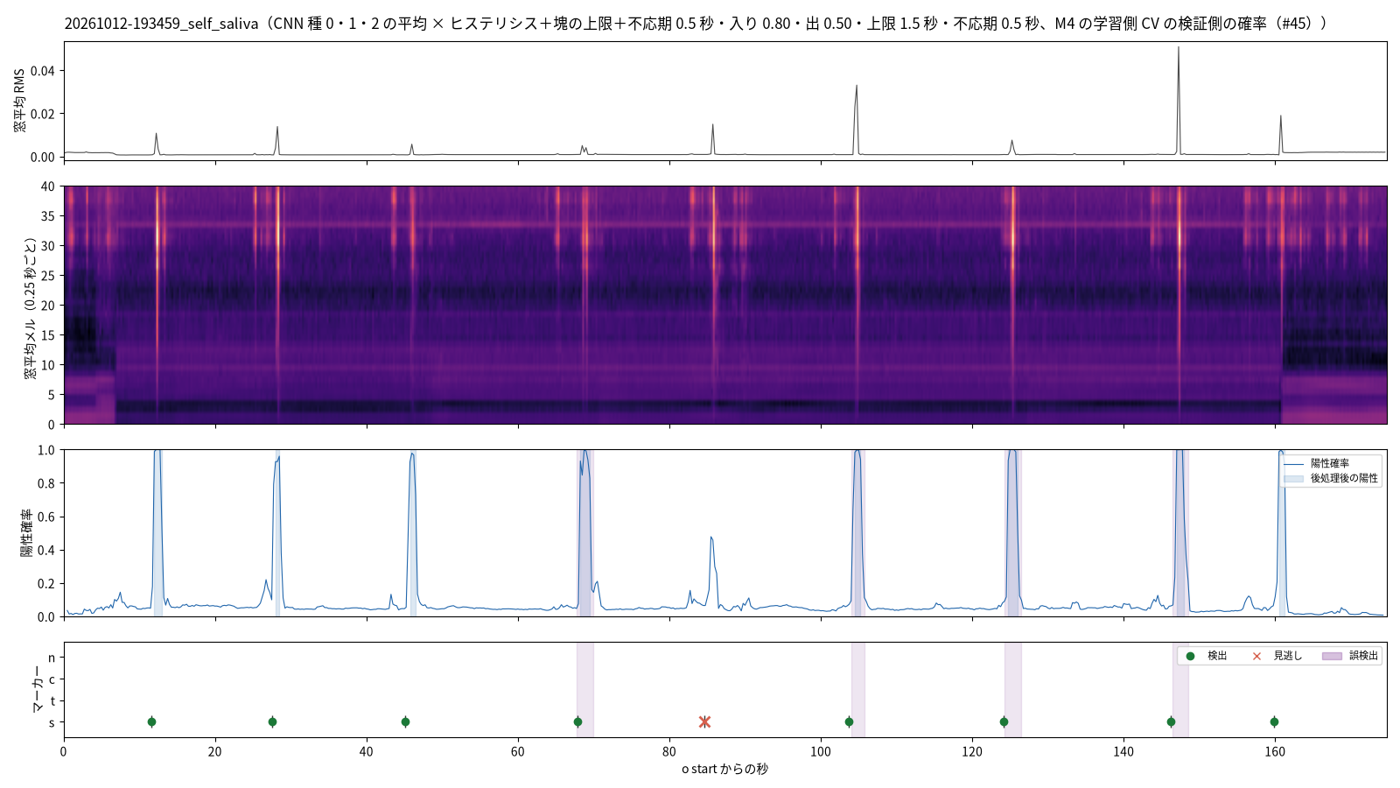
docs/log/2026-10-28-45/session_20261012-193459_self_saliva.png
