owhinata/zaitaku-mealpace/docs/log/2026-10-28-45/session_20261012-193929_self_neck.png

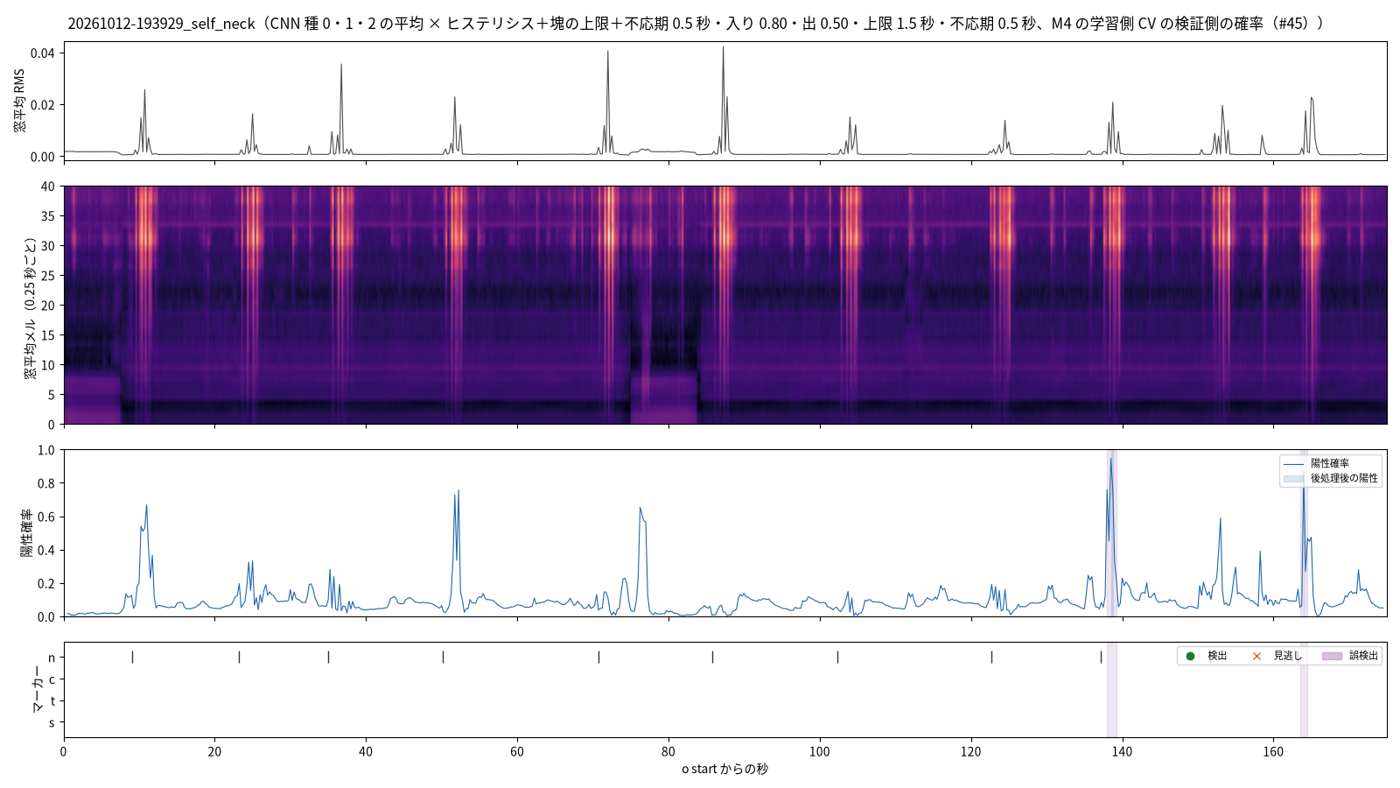
docs/log/2026-10-28-45/session_20261012-193929_self_neck.png
