owhinata/zaitaku-mealpace/docs/log/2026-10-28-45/session_20261012-194417_self_water.png

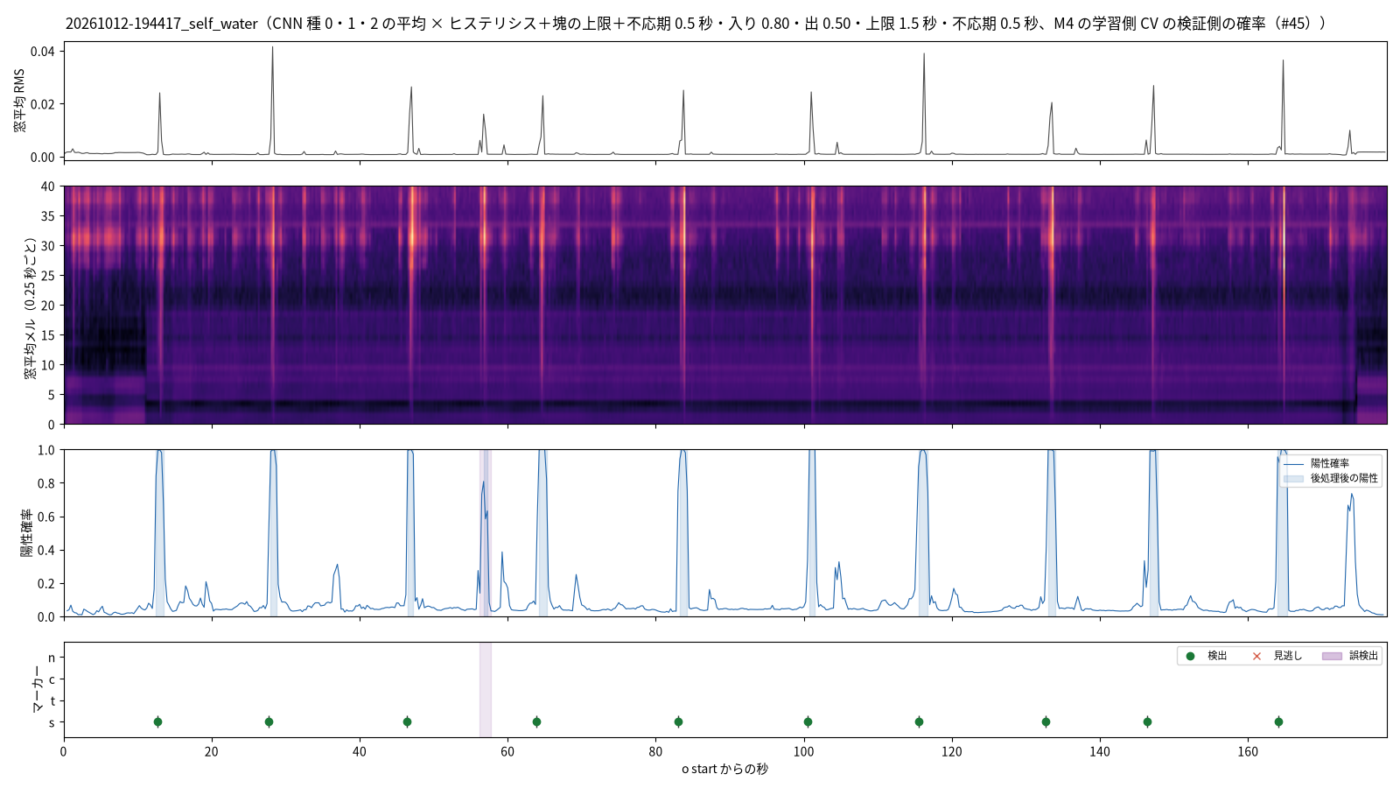
docs/log/2026-10-28-45/session_20261012-194417_self_water.png
