owhinata/zaitaku-mealpace/docs/log/2026-10-28-45/session_20261025-200807_self_meal_p05.png

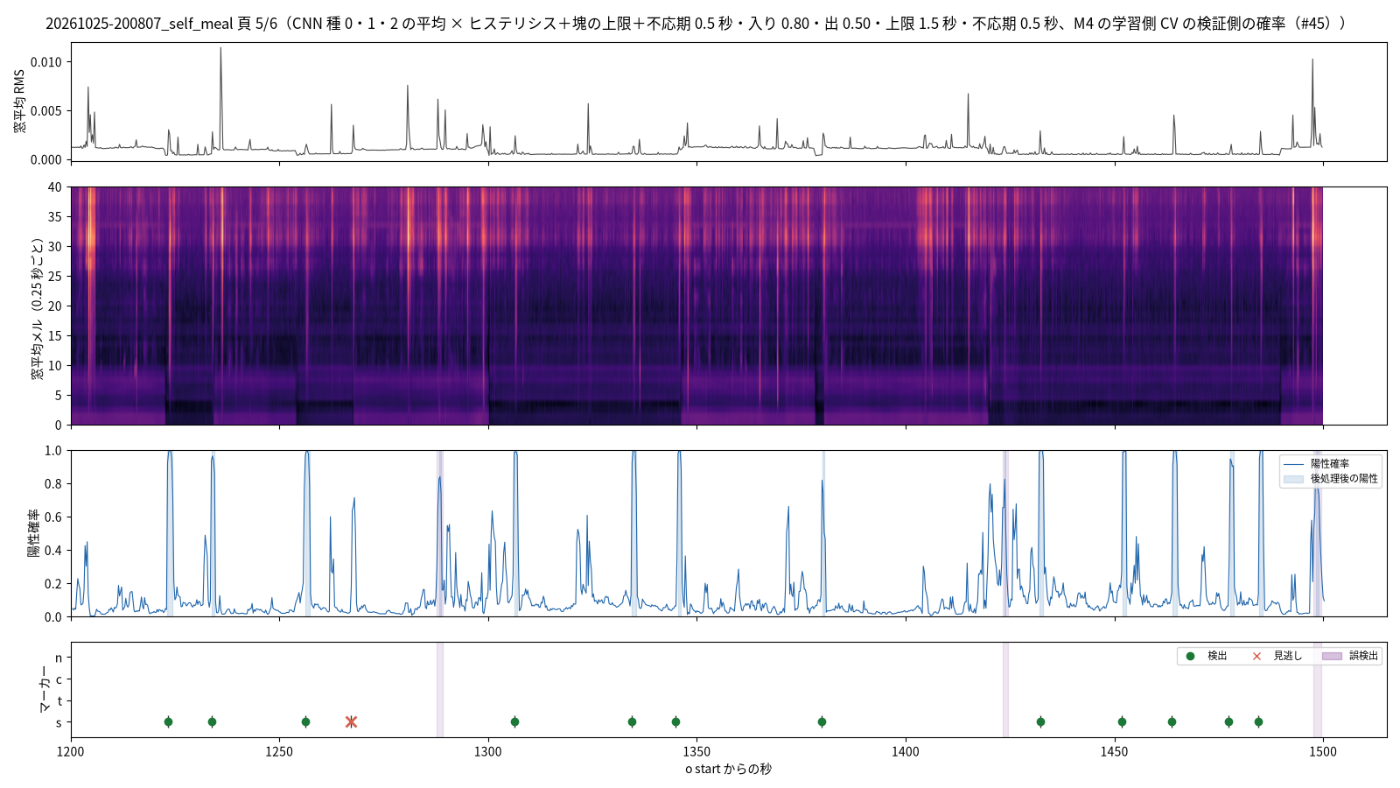
docs/log/2026-10-28-45/session_20261025-200807_self_meal_p05.png
