owhinata/zaitaku-mealpace/docs/log/2026-10-28-45/session_20261027-144545_self_meal_p01.png

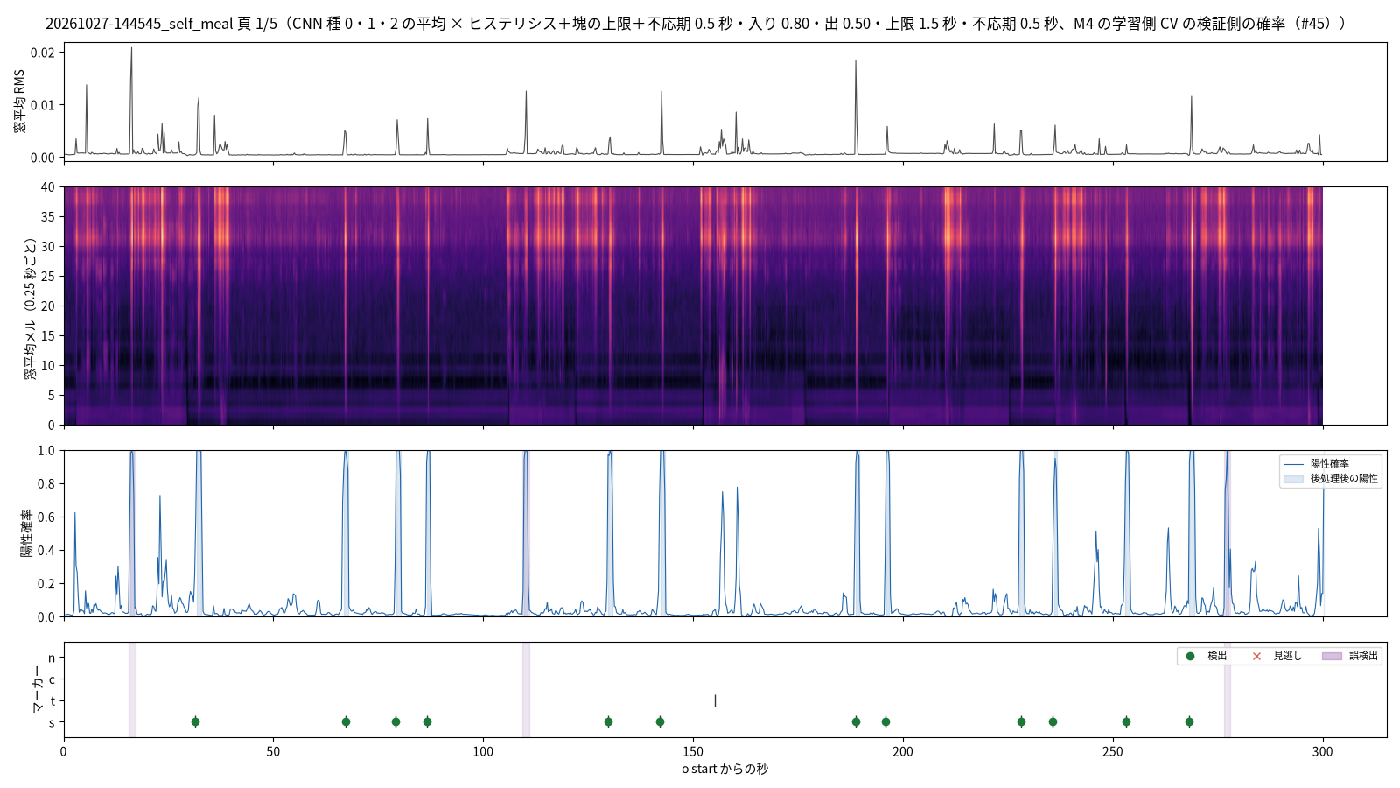
docs/log/2026-10-28-45/session_20261027-144545_self_meal_p01.png
