owhinata/zaitaku-mealpace/docs/unoq-setup.md

# UNO Q の設定と構成 B の接続

咽喉マイクの記録（`tools/record.py --throat`）で使う UNO Q（Linux 側）に、人とエージェントが残した設定と、構成 B（NZ-W210C の送信機 → UNO Q の A2DP シンク）の
接続の手順。UNO Q を作り直すとき、2GB 版で同じことをするときの再現のために置く（plan #38 第 6 節）。
決定は docs/decisions/0028（USB オーディオの経路）・0030（構成 B）。無線リンクと検出器の境界は #42 で決めるもので、この文書には書かない。
送信機の BD アドレスは書かない（`<addr>`）。

## 版

| 項目 | 値 |
|---|---|
| OS | Debian 13 (trixie) aarch64 |
| bluez | 5.82-1.1 |
| PipeWire | 1.4.2-1~qcom1（libspa-0.2-bluetooth 1.4.2） |
| WirePlumber | 0.5.8-2 |
| pulseaudio-utils | 無い（入れない。取り出しは PipeWire の `pw-record`） |
| コーデック | SBC（UNO Q 側の A2DP シンクは sbc / opus_05 / opus_g。送信機とは SBC で合意） |
| arduino-router | 0.11.0（Debian パッケージ。10/24 の apt の更新で 0.10.0 から上がった。`arduino-router.service`、ソケット `/var/run/arduino-router.sock`（0.11.0 では `srw-rw---- root arduino-router`。0.10.0 の 10/13 は `srw-rw-rw-`）、MCU とはシリアル `/dev/ttyHS1` 115200。#38・#44） |
| arduino-cli / arduino-app-cli | 1.5.1 / 0.14.0（基板の上。arduino-app-cli は 10/24 の apt の更新で 0.13.0 から上がった。App Lab の既定のアプリは無い） |
| Python | 3.13.5（msgpack・pip・scipy・librosa は無い） |
| numpy | 2.2.4（`python3-numpy 1:2.2.4+ds-1`。人が `sudo apt install python3-numpy` で入れた。10/24、#44。一緒に `libblas3 3.12.1-6`・`liblapack3 3.12.1-6`・`libgfortran5`・`python3-numpy-dev` が入った） |
| BLAS | **OpenBLAS**（`libopenblas0-pthread` 0.3.29+ds-3。docs/decisions/0040 の D9 の例外として人が 10/29 に `sudo apt install libopenblas0-pthread` で入れ直した）。alternatives は libblas・liblapack とも **auto mode** で OpenBLAS（優先度 100。参照実装 `libblas3` は優先度 10 で候補に残る）。確かめ方: `update-alternatives --display libblas.so.3-aarch64-linux-gnu`。numpy が実際に読んだ BLAS は `/proc/self/maps` の `openblas` で分かる（10/29 に 16 行。`np.show_config` はビルド時の値のまま）。装置の推論は 1 スレッド固定（`OPENBLAS_NUM_THREADS=1`、0040 決定 3。既定だと 4 コアが空回りする） |
| rsync | 3.5.0（人が `sudo apt install rsync` で入れた。10/13、#38 の `deploy-unoq` のため） |

## 残した設定（音声ではない）

| 場所 | 中身 | 置いた人 | 理由 | 確かめ方（読み取り） |
|---|---|---|---|---|
| `/etc/bluetooth/main.conf` | `Class = 0x240414`（Audio/Video・Loudspeaker） | 人（sudo） | 送信機が Audio/Video の機器だけを探すため | `grep -n '^Class' /etc/bluetooth/main.conf`、`bluetoothctl show` の Class |
| `/etc/bluetooth/main.conf` | `JustWorksRepairing = always` | 人（sudo） | 送信機は電源を入れるたびに新規ペアリングで来る。既定（`never`）では鍵が残っていると拒む。**適用済み（人、10/9〜10）**。これと送信機の trust（1 回）で、承認のエージェントは要らない（E9、10/10） | `grep -n JustWorksRepairing /etc/bluetooth/main.conf` |
| `/var/lib/lightdm/.config/wireplumber/wireplumber.conf.d/90-disable-bluez.conf` | lightdm の WirePlumber で bluez の監視を止める | 人（sudo） | A2DP のエンドポイントは先に登録した WirePlumber が持ち、ログイン画面（lightdm）側に音が流れていた | `ls` |
| `~/.config/wireplumber/wireplumber.conf.d/90-bluez-no-seat.conf`（arduino） | コメント 1 行と、`wireplumber.profiles = { main = { monitor.bluez.seat-monitoring = disabled } }` の入れ子の 5 行（下） | メイン（ssh、sudo 不要） | ssh のセッションは seat0 の active ではなく、arduino の WirePlumber が bluez の監視を始めない | `cat` |
| arduino の linger（`loginctl enable-linger arduino`） | ssh のセッションが無くても arduino の user manager（PipeWire・WirePlumber）を動かしたままにする | メイン（10/10） | linger が無いと、最後の ssh が閉じて約 10 秒で PipeWire が止まり、送信機の A2DP が切れる（10/10 の実測） | `loginctl show-user arduino -p Linger` |
| `arduino` を `arduino-router` のグループに足した（`sudo usermod -aG arduino-router arduino`） | `arduino` が router のソケットを開けるようにする | 人（sudo、10/24、#44） | `arduino-router` 0.11.0 でソケットが `srw-rw---- root arduino-router` になり、`mcu_rpc.py` の接続が `PermissionError` になった。新しいログインのセッションから効く | `id`（`110(arduino-router)` があること）、`ls -l /var/run/arduino-router.sock` |
| rfkill の soft block（`sudo rfkill block bluetooth`） | Bluetooth の無線を止める（`/sys/class/rfkill/rfkill0/soft` = 1、`bluetoothctl show` の Powered: no） | 人（sudo、10/11） | 構成 B を記録に使わないと決めた（10/10）後、Discoverable が yes のまま残っていた。有線の記録と M4 の間は Bluetooth を使わないので止める。`main.conf` と WirePlumber の設定は残す。systemd-rfkill が状態を保存するので再起動後も無効のまま。`all` は付けない（rfkill1 は Wi-Fi で、ssh が落ちる） | `cat /sys/class/rfkill/rfkill0/soft`（1）、`bluetoothctl show | grep Powered`（no）。`rfkill` は `/usr/sbin` にあり一般ユーザーの PATH に無い |

`90-bluez-no-seat.conf` の中身（コメントを除く。10/10 の実物）:

```
wireplumber.profiles = {
  main = {
    monitor.bluez.seat-monitoring = disabled
  }
}
```

- ここに無い PipeWire・WirePlumber の設定を足さない（docs/decisions/0030「塞がっていない経路」）。`record.py` は構成 B の記録の前に、`~/.config/pipewire` と
  `~/.config/wireplumber/wireplumber.conf` が無いこと、`~/.config/wireplumber/wireplumber.conf.d/` が `90-bluez-no-seat.conf` だけで、中身がコメント行と空行を除き空白を正規化して上の 5 行と一致することを確かめ、
  違えば記録を始めない。`/etc/pipewire`・`/etc/wireplumber` は一覧を `meta.json` に残すだけ（中身は確かめない）。

## 構成 B の接続（記録の座の初めに 1 回）

送信機を切らなければ、5 条件の間は接続が保たれる見込み。送信機は接続が無いと約 3 分で自動 OFF。

### 主の手順（`JustWorksRepairing = always` を適用した後。10/9〜10 に適用済み）

**10/11 から Bluetooth は rfkill で無効（上の表）。構成 B を再び試すときは、先に人が `sudo rfkill unblock bluetooth` を行い、`bluetoothctl show` で Powered: yes を確かめてから下へ進む。** `record.py --throat sh12jk-nz210c-a2dp-unoq` は Bluetooth が無効だと起動前の検査で止まる（意図どおり）。

1. 人が `/etc/bluetooth/main.conf` の `[General]` に `JustWorksRepairing = always` を書き、bluetooth を再起動する（sudo。1 回だけ。済み）。
   適用の確かめ（読み取り）: `grep -n JustWorksRepairing /etc/bluetooth/main.conf`。
2. UNO Q の電源を入れ、ssh が通ることを確かめる。受信機 NZ-W210R は電源を切ったまま。
   **UNO Q を再起動した後は**（10/10 に分かった）:
   - Pairable は再起動で off に戻るので `bluetoothctl pairable on`。
   - 起動直後は A2DP Sink のエンドポイントが登録されていないことがあるので `systemctl --user restart wireplumber` を行い、
     `bluetoothctl show` の UUID に Audio Sink があることを確かめる。
   - linger（上の表）が有効なことを `loginctl show-user arduino -p Linger` で確かめる。
3. 送信機の電源を入れる（ペアリングモードで来る）。鍵の削除（`bluetoothctl remove`）は要らない。
   **初めての送信機（または鍵を消した後）は 1 回だけ** `bluetoothctl trust <addr>` を行う。trust が無いと、再ペアリングは通るが A2DP のサービスの認可が
   拒まれる（bluetoothd「Authentication attempt without agent」）。trust の後は、送信機の次の試行で A2DP がつながる。
4. `record.py` を起動する。子を起動する前に `pw-dump` で接続を確かめる。ノードが無ければ「送信機が接続されていません」と出て止まるので、3 からやり直す。

   ```
   .venv/bin/python tools/record.py --throat sh12jk-nz210c-a2dp-unoq --position lateral-below-cricoid --cond quiet --duration 100
   ```

- **エージェントは要らない**（E9、10/10: `JustWorksRepairing = always` ＋ trust 1 回）。下のエージェントは、適用の前の手順と、trust の前につながらないときにだけ使う
  （PC の端末で前面に置く。ペアリングが済んだら Ctrl-C で止めてよい）:

  ```
  ssh arduino@<UNO Q> 'while sleep 0.5; do echo yes; done | bluetoothctl --agent NoInputNoOutput'
  ```

- 手で接続を見るなら: `ssh arduino@<UNO Q> 'XDG_RUNTIME_DIR=/run/user/$(id -u) pw-dump' | grep -c bluez_input`。

### 適用の前の手順（10/8。適用までの間だけ使う）

1. UNO Q の電源を入れ、ssh が通ることを確かめる（上の 2）。
2. ペアリング済みなら、UNO Q で `bluetoothctl remove <addr>`（鍵が残っていると送信機の新規ペアリングを拒む）。
3. 上のエージェントを起動したままにする。
4. 送信機の電源を入れる（上の 3）→ `record.py` を起動する（上の 4）。

### `record.py` が確かめること

- 子を起動する前（1 回の ssh。読み取りのみ）: ユーザーの PipeWire・WirePlumber の設定（上）、目的のノード（`bluez_input.<addr>.<番号>`、`media.class` が `Stream/Output/Audio`（実物、10/10）か `Audio/Source`、`api.bluez5.profile` が `a2dp-source`）の有無、
  ミュート、他の取り込みのストリームがつながっていないこと、`libpipewire-module-pipe-tunnel` が無いこと。`--throat-device` を省くと、条件に合うノードがちょうど 1 つのときだけそれを使う。
- 起動後: `pw-record`（`node.name` = `zm-throat-record`）が目的のノードにだけつながっているか（`meta.json` の `throat.pipewire.link_check`）。受信が 2 秒止まれば記録を止める（`stall`）。
- 記録の直後に `tools/throat_check.py <セッション>` で 0 の区間を確かめる。

## UNO Q に音声のファイルが残っていないことの確かめ方（読み取り）

構成 B の記録の後に行う。`<時刻>` は記録を始める前の時刻。

```
ssh arduino@<UNO Q> 'find ~ /tmp -xdev -type f -newermt "<時刻>" 2>/dev/null'
ssh arduino@<UNO Q> 'find ~ /tmp -xdev -type f \( -iname "*.wav" -o -iname "*.raw" -o -iname "*.pcm" -o -iname "*.flac" -o -iname "*.sbc" -o -iname "*.mp3" -o -iname "*.ogg" \)'
```

新しいファイルに音声の形式のものが無く、音声の拡張子のファイルが 0 件であること（docs/log/2026-10-08.md と同じ方法）。
`~/.local/state/wireplumber/stream-properties` は確認から除く。`pw-record` のストリームが来ると WirePlumber が音量・ミュートの復元の状態を書くテキストで、音声ではない（10/10 の実測）。
ほかに音声ではない既知のもの（10/13）: `~/.bash_history`（人の対話のシェルの履歴）、`/tmp/.X0-lock`（起動のたびに X が作る）、`~/zaitaku-mealpace-device/` の配ったファイル（下）。
自動起動のユニットを有効にした後（#53、0050）: `~/.config/systemd/user/zaitaku-detector.service` と `~/.config/systemd/user/default.target.wants/zaitaku-detector.service`
（どちらもシンボリックリンク。`find -type f` には出ない。下の「自動起動」の確かめ方で `find -type l` で見る）、journald のファイル（`/var/log/journal` か `/run/log/journal`。文だけ）。
#51 の計測用の venv がある間（10/24〜）: `~/zaitaku-mealpace-bench-venv/` の下のファイル（pip が入れたもの）、`~/.cache/pip/`（pip のキャッシュ）、
`~/.cache/Microsoft/DeveloperTools/.onnxruntime/` の `deviceid`・`onnxruntime.db`（ONNX Runtime 1.31 が import のたびに作る・書き直す。0039 決定 6）。
`~/.cache/mesa_shader_cache/`（Mesa の GPU のシェーダのキャッシュ。10/24 14:44 にできた。計測は `MESA_SHADER_CACHE_DISABLE=true` で増やさない）。
UNO Q の時計は起動の後に進むことがある（10/13、ファイルの日時と `date -u` がずれた。NTP によると見ているが未確認）。`-newermt` の基準時刻が曖昧なときも、音声の拡張子の検索が 0 件であることで補う。

## MCU のスケッチと Linux 側の配置（#38、docs/decisions/0035）

- **MCU 側のスケッチ**: `firmware/unoq_mcu/`（RPC で `zm_set_state(int)` を公開し、8×13 の LED マトリクスに状態 0 = 全消灯、1 = 流れる波線、2 = 微笑む顔を出すだけ。
  図形と順序は `firmware/indicator/` へのシンボリックリンク。行は上下を反転して書き、UNO Q では波線が左から右へ流れて見える（人が可とした）。LED3 は使わない。0035 決定 7）。
  0018 の保持は持たない（Linux 側の `detector.py` が持つ）。MCU は `loop()` が `zm_set_state` の受信に気づいてから約 2 秒（2000 ms）次の受信が無ければ自分で消灯する（#52、0049）。
  今入っているのは 2026-11-03 10:43 JST に書き込んだ自律消灯の版（#52、0049。時間切れの後は次の受信まで消灯を保つ版。スケッチ 90,348 B。docs/log/2026-11-03.md「#52」）。
  USB を直挿しできないときは ssh 経由でも書ける: remoteocd が運ぶ 3 つのファイル（`flash_sketch.cfg`、zephyr の elf、スケッチの `.bin`）を scp で `/tmp/remoteocd/` に置き、
  基板上で `/opt/openocd/bin/openocd -s /opt/openocd -f /opt/openocd/openocd_gpiod.cfg -c "set filename0 <elf>" -c "set filename1 <bin>" -f /tmp/remoteocd/flash_sketch.cfg`
  （`arduino` は gpiod グループ）。手順と出力は docs/log/2026-11-03.md「#52」。
  その前は 10/13 22:5x JST の波線と顔の版（さらに前に LED3 の緑の版、顔だけの版を書いた）。
  コア `arduino:zephyr@1.0.0`、`Arduino_RouterBridge@0.4.3`（依存 `Arduino_RPClite` 0.3.1）、FQBN `arduino:zephyr:unoq`。版は基板の上の `~/.arduino15` と同じ。
  UGREEN アダプタ（PD 給電 + USB オーディオ）が UNO Q の USB-C を占めている間は、PC から adb に見えない。書き込みのときはアダプタを外して PC に直挿しし
  （`lsusb` に `2341:0078` が出る）、終わったらアダプタを戻す（11/3、#52）。
  書き込みは UNO Q の USB-C を PC に直につなぎ、`arduino-cli board list` に出るポート（`/dev/ttyACM0`、`configuration: ADB Configuration`）で:

  ```
  cmake -S . -B build-unoq -DSKETCH_NAME=unoq_mcu -DPORT=/dev/ttyACM0 -DPYTHON3=$PWD/.venv/bin/python3
  cmake --build build-unoq --target build && cmake --build build-unoq --target upload
  ```

  中身は remoteocd（USB の adb 越し）。書く物を UNO Q の `/tmp/remoteocd/`（`flash_sketch.cfg`、`unoq_mcu.ino.elf-zsk.bin`、`zephyr-arduino_uno_q_stm32u585xx.elf`）に置き、
  基板の上の openocd が SWD で書く。`/tmp` は tmpfs で、再起動で消える。音声ではない。10/13 に書き込んだ（10/13 のコミットのスケッチ）。
  書き込みの直後に router の journal に `decoding packet: invalid packet, expected array` が数行出るが、その後の RPC は通る。
- **Linux 側の配置**: `cmake --build build-unoq --target deploy-unoq`（rsync `--copy-links`。宛先は `-DUNOQ_HOST`、既定 `arduino@unoq.local`）で、
  `device/unoq/DEPLOY_FILES` の一覧だけを `~/zaitaku-mealpace-device/` に配る（#51 の後は 14 個。下の「推論ランタイムの比較の計測」。#47 で入れ替えて今は別の 14 個。下の「検出器」）。#44 の 9 つ（10/24）: `mcu_rpc.py`、`led_check.py`、`bench_infer.py`、`features_np.py`、
  `mel40_htk_0_4000.npy`、`mel26_htk_0_4000.npy`、`features_np_ref.npz`、`postprocess.py`、`evaluate.py`。うち後ろの 6 つは `analysis/` へのリンクで、
  送る前に先が `analysis/` の直下の普通のファイルであることを確かめる（0035 の追記）。UNO Q の上はどれも普通のファイル。音声のファイルは無い。
  常駐は単独モードのユーザーユニット 1 つだけ（`zaitaku-detector.service`、#53、0050。下の「自動起動」）。ファイルを書かない。実行は `python3 -B`（`__pycache__` を作らない）:

  ```
  ssh arduino@unoq.local 'python3 -B ~/zaitaku-mealpace-device/led_check.py wave'    # smile / off / bench --n 100 --warmup 5
  ```

  `wave`・`smile` は状態を送って終わり、表示は約 2 秒で MCU が消す（`loop()` が受信に気づいてから約 2 秒（2000 ms）次の受信が無いため。0049）。`bench` は顔と消灯を交互に送って往復を測る（状態を渡して応答が返るまで。描画は含まない）。最後に消灯を送る。

  1 窓あたりの処理時間の計測（#44。合成入力だけ、ファイルを書かない、標準出力は集計の行だけ。最初に `features_np_ref.npz` との照合をし、NG なら測らない。
  RPC は消灯を送るだけで、最後にも消灯を送る）。1 スレッド指定と既定（ssh のセッションの値を引き継がない）の 2 回:

  ```
  ssh arduino@unoq.local 'cd ~/zaitaku-mealpace-device && env OPENBLAS_NUM_THREADS=1 OMP_NUM_THREADS=1 MKL_NUM_THREADS=1 python3 -B bench_infer.py'
  ssh arduino@unoq.local 'cd ~/zaitaku-mealpace-device && env -u OPENBLAS_NUM_THREADS -u OMP_NUM_THREADS -u MKL_NUM_THREADS python3 -B bench_infer.py'
  ```

  `--no-rpc` で RPC を省く（PC のテスト用）。10/24 の結果は docs/log/2026-10-24.md。

  記録（`record.py`）の間は動かさない（0028 決定 3）。消すときは `ssh arduino@unoq.local 'rm -r ~/zaitaku-mealpace-device'`。
- **推論ランタイムの比較の計測（#51、docs/decisions/0039）**: 配る一覧は 14 個（上の 9 つに `bench_runtimes.py` と乱数の重みのモデル 4 つ `cnn_rand0.onnx`・
  `cnn_rand0.tflite`・`cnn_rand0.ncnn.param`・`cnn_rand0.ncnn.weights` を足した。モデルは `analysis/` へのリンク）。計測のために入れたものは一時的なもので、
  装置の推論は numpy のまま（0039 決定 1）。計測が終わって要らなければ人が外す（下）。

  計測用の venv（配る先の外。numpy は system の 2.2.4 を共有する）の作り方（人、10/24）:

  ```
  ssh arduino@unoq.local 'python3 -m venv --system-site-packages ~/zaitaku-mealpace-bench-venv'
  ssh arduino@unoq.local '~/zaitaku-mealpace-bench-venv/bin/pip install ai-edge-litert==2.3.0 ncnn==1.0.20261020'
  ssh arduino@unoq.local '~/zaitaku-mealpace-bench-venv/bin/pip install --no-cache-dir --no-deps onnxruntime==1.31.0'
  ```

  10/24 に入れたもの（人、`sudo`）:

  | 入れ方 | 名前と版 | 用途 |
  |---|---|---|
  | apt | `python3-onnxruntime` 1.21.0+dfsg-1 | ONNX Runtime（import で SIGILL になり使えない。PyPI の wheel で測った） |
  | apt | `python3-pyarmnn` 23.08-5、`armnn-latest-cpu-gpu` 23.08-5（`libarm-compute43` 24.11） | Arm NN の CpuAcc・GpuAcc |
  | apt | `python3-venv` 3.13.5 | 計測用の venv |
  | apt | `libopenblas0-pthread` 0.3.29+ds-3 | OpenBLAS の計測（C） |
  | apt | `ocl-icd-opencl-dev` 2.3.3-1 | `libOpenCL.so` のリンク（Arm NN GpuAcc の再試行） |
  | venv（pip） | `ai-edge-litert` 2.3.0、`ncnn` 1.0.20261020、`onnxruntime` 1.31.0 | LiteRT・ncnn・ONNX Runtime |

  apt は自動で入ったものを含めて 47 個（一覧は `/var/log/apt/history.log` の 10/24 の行）。ディスクの空きは 1.8 GB → 1.6 GB、venv は 130 MB。

  走らせ方（`~/zaitaku-mealpace-device/` で、venv の python。バックエンドごとに別の ssh。合成入力だけ、ファイルを書かない、標準出力は集計の行だけ。最初に #44 の照合、
  次にバックエンドごとに `cnn_forward` との照合をし、NG なら測らない。RPC は消灯を送るだけ）:

  ```
  ssh arduino@unoq.local 'cd ~/zaitaku-mealpace-device && ~/zaitaku-mealpace-bench-venv/bin/python -B bench_runtimes.py --list'
  ssh arduino@unoq.local 'cd ~/zaitaku-mealpace-device && env OPENBLAS_NUM_THREADS=1 OMP_NUM_THREADS=1 MKL_NUM_THREADS=1 RUSTICL_ENABLE=freedreno MESA_SHADER_CACHE_DISABLE=true ~/zaitaku-mealpace-bench-venv/bin/python -B bench_runtimes.py --only ncnn-vulkan --threads 1 --overlap; echo "rc=$?"'
  ssh arduino@unoq.local 'cd ~/zaitaku-mealpace-device && ~/zaitaku-mealpace-bench-venv/bin/python -B bench_runtimes.py --only idle'
  ```

  既定のスレッドは `env -u OPENBLAS_NUM_THREADS -u OMP_NUM_THREADS -u MKL_NUM_THREADS …` と `--threads 0`。`--sustain-s`（既定 60）は持続的な負荷の秒数、0 で省く。
  GPU の環境変数（`RUSTICL_ENABLE=freedreno`・`MESA_SHADER_CACHE_DISABLE=true`）は計測のコマンドで渡し、ファイルに固定しない（0039 決定 3）。
  import でプロセスごと落ちる経路（SIGILL の 132 など）は出力が出ないので、終了コードを必ず控える。10/24 の結果は docs/log/2026-10-24.md「#51」。

  BLAS の切り替え（人、`sudo`）。OpenBLAS を入れると alternatives が OpenBLAS に替わる（auto、優先度 100）。参照実装に戻すには:

  ```
  sudo update-alternatives --set libblas.so.3-aarch64-linux-gnu /usr/lib/aarch64-linux-gnu/blas/libblas.so.3
  sudo update-alternatives --set liblapack.so.3-aarch64-linux-gnu /usr/lib/aarch64-linux-gnu/lapack/liblapack.so.3
  ```

  `--set` の後は **manual mode**。OpenBLAS を外すか `sudo update-alternatives --auto libblas.so.3-aarch64-linux-gnu`（liblapack も）に戻すまでそのまま
  （10/24 の計測の間はこの状態だった。10/24 の段階 5 で外して auto に戻り、10/29 に 0040 で入れ直してからは auto mode で OpenBLAS。上の表）。
  実際に読み込んだ BLAS は `bench_runtimes.py` の環境の行（`/proc/self/maps`）で分かる（`np.show_config` はビルド時の値のままで替わらない）。

  消し方（人。計測の後、要らなければ。外す前に `apt-get -s remove …` で一覧を見て、もとから入っていたものを外さないことを確かめる）:

  ```
  ssh arduino@unoq.local 'rm -r ~/zaitaku-mealpace-bench-venv ~/.cache/Microsoft'
  sudo apt remove python3-onnxruntime python3-pyarmnn armnn-latest-cpu-gpu python3-venv libopenblas0-pthread ocl-icd-opencl-dev && sudo apt autoremove
  ```

  `libopenblas0-pthread` を外すと alternatives の候補は参照実装だけになる。外したもの・残したものは docs/log と 0039 に書く。
  **10/29 以降は `libopenblas0-pthread` を外さない**（装置の推論が使う。0040）。
- **PD 給電の構成（10/13）**: PD 対応モバイルバッテリー → USB-C→3.5 mm 変換アダプタ（UGREEN CM721。DAC 搭載、PD 60 W パススルー）の PD の入口 → UNO Q。
  SH-12JK はこのアダプタの 3.5 mm に挿す。ALSA では `hw:CARD=Audio`。PC とは Wi-Fi の ssh だけ。この構成で `record.py --throat sh12jk-wired-unoq-usbaudio` の
  60 秒が使わない目安に当たらなかった（docs/log/2026-10-13.md）。

## 検出器（`detector.py`。#47）

- **配る一覧（14 個、10/29〜）**: `mcu_rpc.py`、`led_check.py`、`bench_infer.py`、`features_np.py`、`mel40_htk_0_4000.npy`、`mel26_htk_0_4000.npy`、`features_np_ref.npz`、
  `postprocess.py`、`evaluate.py`、`detector.py`、`audio_in.py`、`m4_infer.py`、`led_rule.py`、`m4-0038.npz`。`m4_infer.py`・`led_rule.py` は `analysis/` の直下へ、
  `m4-0038.npz` は `analysis/models/` へのリンク（`deploy-unoq` は `analysis/models/` の直下の `.npz` も受ける）。`bench_runtimes.py` と `cnn_rand0.*` の 4 つは外した
  （リポジトリには残す。UNO Q の上の古いものは人が 10/29 に `rm` した。`--delete` は使わない）。配った後に `ls -A ~/zaitaku-mealpace-device/` が一覧と一致すること。
  一覧の外の `.py`・`.npy`・`.npz` が残っていると、H 行の `code_sha256` が PC の値と合わず `record.py` は始めない。
  11/3（#53）から一覧に `zaitaku-detector.service`（単独モードのユニット）を足して 15 個。`.service` は `code_sha256` に入らない（`.py`・`.npy`・`.npz` だけを数える）。
- **起動**（人が直接打つのは照合だけ。記録は `tools/record.py --unoq-detector` が ssh で起動する）。BLAS のスレッドを 1 つにする 3 つの変数を `env` で渡し
  （`detector.py` も numpy の import の前に同じ値を置く。0040 決定 3）、`python3 -u -B`（`__pycache__` を作らない）:

  ```
  ssh arduino@unoq.local 'cd ~/zaitaku-mealpace-device && env OPENBLAS_NUM_THREADS=1 OMP_NUM_THREADS=1 MKL_NUM_THREADS=1 python3 -B detector.py --selftest --expect-config "set=mfe40 classifier=cnn seeds=0,1,2 hard_negative=none post=hyst threshold=- enter=0.85 exit=0.65 cap_s=none refractory_s=0.5" --expect-sha256 c786086f069c55c55b27eea860963c3c950c04b728fe65d52bc35a7a4a806d90'
  ```

  照合は `features_np_ref.npz` との差（1e-5）、im2col の新旧の差（乱数の重み、1e-6）、重みの sha256 と構成。違えば消灯のまま 2 で終わる。10/29 の結果: 参照 2.04e-08、
  im2col 7.39e-09、一致。版とスレッド数は H 行（`--replay --no-rpc </dev/null` で窓 0 のまま出る）: numpy 2.2.4、`libopenblasp-r0.3.29.so`、スレッド 1。
- **ライブ**（`--live [--device hw:CARD=Audio,DEV=0] [--feat] [--no-rpc]`）: `arecord` を子プロセスで起動して標準出力のパイプをメモリで読む（`audio_in.py` だけ。出力先は `-` だけ、
  PCM 名は hw / plughw だけ）。行（H・F・D・T・E）は標準出力に出し、音声・配列は出さない（F 行の 82 次元だけ）。ファイルを書かない。コアダンプを無効にする
  （`RLIMIT_CORE` 0 と `prctl(PR_SET_DUMPABLE, 0)`。core_pattern がパイプの収集には `RLIMIT_CORE` が効かないため。止められなければ始めない）。
  ライブ・再生とも、`/proc/swaps` にディスクに出うるスワップ（zram 以外、または `/sys/block/zram*/backing_dev` が `none` でない zram）があれば（読めなくても）始めない
  （終了コード 2。`record.py` も起動前に `/proc/swaps` の名前を確かめる）。
  子の `arecord` は exec で dumpable が戻るので、`RLIMIT_CORE` 0（引き継ぐ）だけが効く。そのため `/proc/sys/kernel/core_pattern` がファイルに書く形（先頭が `|` でない。
  kernel が `RLIMIT_CORE` 0 を守る）のときだけ始める。パイプの形はすべて受けない（終了コード 2、理由の文に core_pattern の値）。UNO Q の実物は `core`
  （10/29 にメインが読み取りで確かめた。`fs.suid_dumpable` 0、`systemd-coredump` は入っていない、`/sys/block/zram0/backing_dev` は無い = 書き戻しの無い kernel。kernel 7.0.0、systemd 257）。
- **ハートビート**: `record.py` は検出器の標準入力に 0.5 秒ごとに改行 1 バイトを書く。検出器（ライブ）は 2.0 秒何も届かなければ消灯して `heartbeat-timeout`（終了コード 6）で止まる。
  UNO Q の sshd は `ClientAliveInterval` が既定の 0（`/etc/ssh/sshd_config` でコメントのまま。`sshd -T` は sudo なしでは読めない）で切断に気づかないので、それに頼らない。
  10/29 の試験: PC の Wi-Fi を切ってから 2 秒で消えた。
- **止め方と消灯**: 標準入力の EOF（`record.py` が閉じる）、SIGTERM・SIGHUP、ハートビートの時間切れ、標準出力の詰まり（キューが 2 秒分を超えたら `stdout-stall`、4）、
  `overrun` の行（3）で止まり、どれも消灯を送ってから RPC を閉じる。窓の結果が 1.0 秒出なければ消灯を 1 回送る。`kill -9`・`arduino-router` の停止では Linux 側が消灯を送れないが、
  MCU が、`loop()` が最後の受信に気づいてから約 2 秒（2000 ms）で消す（#52、0049）。電源断は MCU ごと消える。`record.py` は E 行が来なかったことを見て `led_check.py off` を送る後始末を
  今までどおり行う（10/29 の試験で消えた。MCU の消灯とどちらが先かは区別しない）。
  `arduino-router` の停止の確かめ（#52）は `record.py --unoq-detector` の経路で行う（ハートビートが続く）。`record.py` は窓ごとの行を表示せず、窓が届き始めた時・
  1 秒以上届かない時（「窓の行が N 秒届いていない」）・届き直した時（「窓の行が届き直した（途切れ N 秒）」）だけを表示する。router を止めている間は、`record.py` が動き続けていて
  「窓の行が N 秒届いていない」が出ないことを確かめる（言えるのは「1 秒以上の途切れは表示されなかった」まで）。router を戻してから Ctrl-C で止め、終わりの集計の「RPC の失敗」を控える。
  単独モード（`--live --standalone`、#53、0050）の止まり方: SIGTERM（`systemctl --user stop`。0 で終わり、再起動しない）、入力の終わり（アダプタが無い・抜けた。0 以外）、`overrun`（3）。
  ハートビートと標準出力の詰まりは無い（標準入力を読まず、標準出力に行を出さない）。`kill -9` は MCU の約 2 秒で消え、ユニットの `Restart` が約 2 秒後に起動し直す。
- **再生モード**（一致の確かめだけ）: `--replay --no-rpc [--feat]` は標準入力から S16_LE・48 kHz・2 ch を読む（ファイルを開かない）。PC から
  `.venv/bin/python tools/unoq_replay_check.py data/raw/<学習用 meal> --feat`（M4-TRAIN の学習用 `meal` だけ。集計だけを出し、どこにもファイルを書かない）。
  10/29: `20261026-190244_self_meal` で窓 3979、`prob` の差の最大 1.61e-07、`positive`・`led` の不一致 0、FEAT の差の最大 5.00e-08。
- **確かめ方（読み取り）**: 記録の前の時刻を控え、後で `find ~ /tmp /var/tmp -xdev -type f -newermt "<時刻>"` が 0 件（配ったファイルは rsync が日時を保つので出ない）、
  音声の拡張子の `find`（上の節）が 0 件、`~/zaitaku-mealpace-device/` に `__pycache__` が無いこと。スワップは `/usr/sbin/swapon --show`（ユーザーの PATH に無い）か
  `cat /proc/swaps` で zram だけ（`record.py` は起動前に `/proc/swaps` を読み、zram 以外があれば始めない）。コアダンプは `ls /var/lib/systemd/coredump/ /var/crash/` が空
  （10/29: どちらも空・無し）。

## 自動起動（単独モード、#53、docs/decisions/0050）

電源投入から PC なしで、検出器がマトリクスに目安だけを出す。PC に何も送らず、UNO Q にファイルを書かず、journald には文だけを残す。
ユニットは `device/unoq/zaitaku-detector.service`（`deploy-unoq` で `~/zaitaku-mealpace-device/` に配る）。

- **前提**: 0049 の MCU のスケッチ（約 2 秒の自律消灯）を書き込み済みであること。それより前の版では有効にしない。linger が有効（上の表）。
  `flock` に `-F`（`--no-fork`）があること（`flock --version`、`flock --help | grep -e --no-fork`。**無ければ有効にせず、plan を直す**）。
  user manager のグループ: `systemd-run --user --wait -P id` に `arduino-router`（router のソケット）と `audio`（ALSA）があること。
  非対話の ssh から `systemctl --user` を打つときは `XDG_RUNTIME_DIR=/run/user/$(id -u)` を付ける（10/8 の `pw-dump` と同じ。実機で要否を確かめる）。下の例では省いている。
- **有効にする（1 回だけ）**:

  ```
  systemctl --user link ~/zaitaku-mealpace-device/zaitaku-detector.service
  systemctl --user enable zaitaku-detector
  systemctl --user start zaitaku-detector
  ```

  11/3 に有効にした（#53）。今入っているリンクは `~/.config/systemd/user/zaitaku-detector.service` と `~/.config/systemd/user/default.target.wants/zaitaku-detector.service` の 2 本
  （どちらも `~/zaitaku-mealpace-device/zaitaku-detector.service` を指す）。電源投入から動く。
- **電源投入から波線まで（11/3 の実機）**: MCU の RPC が揃う前にユニットが 1〜2 回 1 で終わって再起動し、波線まで約 40 秒かかる（設計どおり。journal に「RPC を開けない」が出る）。

- **止める・戻す**: `systemctl --user stop zaitaku-detector`（消灯して止まる。再起動しない）、`start`、外すときは `disable`（リンクは `systemctl --user disable` が `default.target.wants/` から外す。
  `~/.config/systemd/user/zaitaku-detector.service` のリンクは `rm` で外す）。
- **状態**: `systemctl --user status zaitaku-detector`、`journalctl --user -u zaitaku-detector -b --no-pager`。止まった・失敗した理由の文は `detector: ` で始まる。
  始めの文に `code_sha256` の先頭 12 桁が出る（どの版が動いたかを log に書く）。
- **再起動の上限**: 0 以外で終わると 2 秒後に起動し直す。120 秒に 10 回を超えると `failed` で止まる（アダプタを挿し忘れたなど）。直したら
  `systemctl --user reset-failed zaitaku-detector && systemctl --user start zaitaku-detector`。
  記録のロックが取れなかったとき（75）は再起動しない（`failed`）。記録の後に `start`。
  アダプタ未接続では約 2 分で `failed` になる（11/3 の実機。終了コード 1）。挿してから `systemctl --user reset-failed zaitaku-detector && systemctl --user start zaitaku-detector`。
- **配り直し**: `stop` → `cmake --build build-unoq --target deploy-unoq` → `systemctl --user daemon-reload` → `--selftest`（上の「検出器」）→ `start`。
  ユニットの `--expect-config`・`--expect-sha256` は重みと構成の値なので、直すのは重み・構成を替えたときだけ（`device/unoq/test_detector.py` の sa6 が `analysis/fixed_eval.py` と照らす）。
- **記録の前に `stop`、後に `start`**: `record.py --unoq-detector` と UNO Q を通す `record.py --throat` は、起動前にユニットの状態を読み、動いている（`activating` = 再起動の待ちを含む）なら
  始めない。UNO Q の上の記録の子（`arecord`・`pw-record`）と検出器は、どれも `flock -n -F -E 75 /home/arduino` の下で起動するので、同時には動かない（取れない側は 75 で終わる）。
  `detector.py --live` を手で直接起動するときも `exec flock -n -F -E 75 /home/arduino …` を前に付ける（付けないと排他が効かない。0050 決定 4）。
- **確かめ方（読み取り）**:
  - 普通のファイル: 記録の前の時刻を控え、`find ~ /tmp /var/tmp -xdev -type f -newermt "<時刻>"` が 0 件。音声の拡張子の `find`（上の節）が 0 件、`__pycache__` 無し、
    `ls /var/lib/systemd/coredump/ /var/crash/` が空。
  - リンク: 時刻に頼らず `find ~ -xdev -type l` で全部出して見る。ユニットの 2 つのリンク（`~/.config/systemd/user/zaitaku-detector.service` と
    `~/.config/systemd/user/default.target.wants/zaitaku-detector.service`）の先が、`~/zaitaku-mealpace-device/zaitaku-detector.service` か
    `~/.config/systemd/user/zaitaku-detector.service` のどちらかであること。ほかに知らないリンクが無いこと。
  - journald: `journalctl --user -u zaitaku-detector -b --no-pager -o cat` について、まず全行で D/T/F/H/E の形の行（`D `・`T `・`F `・`H `・`E ` で始まる、または `detector: ` の後が
    その形）が 0 であることを確かめる。そのうえで「`detector: ` の行」「systemd の既知の行（`Started`・`Stopped`・`Stopping`・`Main process exited`・`Failed with result`・
    `Scheduled restart job`・`Consumed` など）」「どちらでもない行」の 3 つに分けて数える。3 つ目が 1 行でもあれば中身の種類を調べる。中身は log に貼らず、数と文の種類だけを書く。
    journald の置き場所（`ls /var/log/journal`。あれば永続、無ければ `/run` で揮発）も書く。

## 構成 A は使わない。構成 B も記録には使わない

- 送信機 → 受信機 NZ-W210R → USB オーディオ → UNO Q（構成 A）は使わない（人の決定、10/8）。iface `sh12jk-nz210c-rx-unoq-usbaudio` は予約のまま。
- 構成 B（送信機 → UNO Q の A2DP）は動くが、送信機 NZ-W210C は入力がごく小さいとき無音（ちょうど 0）を送るノイズゲートを持ち（取説に切替なし。docs/log/2026-10-10.md）、
  装着して静止した咽喉マイクの `quiet` が成り立たない。人の決定（10/10）で学習用の記録には使わず、記録と検出器は有線（USB オーディオアダプタ）で進める。
  上の設定と `record.py` の構成 B の実装は残す（再び使うときの手順はこの文書のとおり）。
