owhinata/zaitaku-mealpace/docs/evaluation.md

# 評価の定義（固定）

分類器を作る前に固定する。変更は `docs/decisions/` に記録が必要。

## 窓

- 窓長 1.0 秒、ホップ 0.25 秒
- 各窓の特徴量: IMU（振幅、RMS、ピーク数、主軸方向）＋ 音（MFCC 13 次元、スペクトル重心、ゼロ交差率）

## イベント単位の数え方

- マーカー時刻 `t`（events.csv の `s`）に対し、`[t − 0.5 s, t + 1.5 s]` に 1 つでも陽性窓があれば「検出」
- **検出率** = 検出された嚥下 ÷ マーカーを打った嚥下
- **誤検出率** = 非嚥下区間で陽性になった回数 ÷ 非嚥下区間の分数（回／分）
  - 陽性が連続する窓は 1 回と数える
  - 非嚥下区間 = マーカー `s` の `[t − 0.5 s, t + 1.5 s]` を除いた時間

## 分割

- 学習と評価は**セッション単位**で分ける。窓単位の分割は禁止
- 評価には 3 セッション以上を使う。収集日が異なることが望ましい
- 報告には、評価に使ったセッションの一覧と混同行列を必ず添える

## 合格線

| 段階 | 手法 | 検出率 | 誤検出 |
|---|---|---|---|
| M1 分岐点 | 手作り特徴量＋ロジスティック回帰 | 70% 以上 | 3 回/分 以下 |
| M2 検出器 | Edge Impulse（int8、Nano 上で推論） | 85% 以上 | 1 回/分 以下 |

## 被験者ごとの扱い

- M1・M2 の数字は `self` のみ
- `p1` については、M4 で本人データで再学習した結果を別に報告する。`self` の数字と混ぜない
