owhinata/zaitaku-mealpace/docs/decisions/0003-evaluation-frozen.md

# 0003 評価の定義を分類器の前に固定する

日付: 2026-09-19　状態: 採用

## 決定

- `docs/evaluation.md` の窓長、イベント単位の数え方、セッション単位の分割、合格線を、分類器の実装前に固定する。
- 変更は本ディレクトリに記録を残してから行う。

## 理由

- テストデータの作り方次第で「検出率 85%」はいくらでも出る。学習と評価を窓単位で混ぜれば簡単に 90% を超えて、本人の食事で動かない。
- 数字を後から動かせないことで、関門の判定に意味を持たせる。
