owhinata/zaitaku-mealpace/docs/m4-issues-draft.md

# M4 検出器（咽喉マイク版）の Issue の草案（人がレビューしてから起票。起票後にこのファイルは削除）

作成: 2026-10-13 夜（メイン）。M3 は 10/13 に通過（docs/decisions/0036、`gate-M3`）。
前提: docs/plan.md の M4 の行（10/26〜11/7、学習・装置上の推論・表示・`self` の `meal` の通し記録。合格線は M2 と同じ 85% / 1 回/分。届かない場合も数字と原因の切り分けを公開の材料にする）、
docs/decisions/0024・0025（＋2026-10-12 の追記）・0032〜0036、docs/log/2026-10-12.md・2026-10-13.md。
人の考え（10/13 夜、#41）: M4 で削るものは今は決めない。構成 J（CNN）の 1.19 回/分はこのままでは M4 の合格線（1 回/分）に届かないので、**誤検出を減らす取り組み**が要る。**UNO Q での推論時間の計測**は必要。

## 一覧（起票の順。番号は仮）

| 仮 | 題 | 中身 | 依存 | 目安 |
|---|---|---|---|---|
| M4-1 | UNO Q の Linux 側で推論を動かす土台と、1 窓あたりの処理時間の計測 | numpy を UNO Q に入れる決定、メルのフィルタ行列を定数として配る、合成入力で 1 窓の時間（特徴量・CNN・RPC）を測る | なし | 10/14〜10/17 |
| M4-2 | 誤検出を減らす検討（学習側だけ。M4 の合格線 1 回/分に向けて） | 誤検出の中身の分析、後処理と学習の候補を学習側 CV で比べ、M4 の構成を事前に固定（決定） | M4-3（分割の決定） | 10/14〜10/22 |
| M4-3 | M4 の学習・評価の分割と、追加の記録の計画（決定） | 学習側に M3 の 21 本＋追加、評価側は `meal` 3 本以上・最後の 2 収集日。記録の日程。`fixed_eval.py` の検査を M4 の決定に合わせる | なし | 10/14〜10/16 |
| M4-4 | 装置上の推論と表示（UNO Q の Linux 側 `detector.py`、MCU のマトリクス、PC の受け口） | ALSA からメモリに取り特徴量→推論→後処理→0018 の規則→RPC。PC に窓ごとの結果だけを送る。生の音声を書かない・送らない | M4-1、M4-2 | 10/18〜10/28 |
| M4-5 | 学習用と評価用の記録（条件別の追加、`meal` の通し記録。人） | 記録の手順の追記、採否の規則、集計表 | M4-3、M4-4（評価用の `meal` は装置で録る） | 10/17〜11/2 |
| M4-6 | M4 の評価（評価側を 1 回だけ。M2 と並べる） | 固定した構成で評価側（`meal`）を 1 回だけ採点。装置の `detect.csv` と PC の再計算の一致。混同行列とセッション一覧 | M4-2、M4-4、M4-5 | 11/3〜11/5 |
| M4-7 | 【判定】M4 検出器（咽喉マイク版）（閉じるのは人、`gate-M4` は人） | 関門のレビュー（`--base gate-M3`）、判定の decision、M5 へ渡すもの | 全部 | 11/6〜11/7 |

並行: M4-1 と M4-3 は初日から並行。M4-2 は M4-3 の決定の後、M4-4 と並行。M4-5 の学習用の記録は M4-3 の直後から（PC の記録の経路のまま）。評価用の `meal` は M4-4 の装置が動いてから。

## メインが決めたこと（人のレビューで覆してよい。何を・なぜ・どのように）

| # | 決めたこと | なぜ | どのように |
|---|---|---|---|
| D1 | **M4 を 10/14 から始める**（plan.md の 10/26 を待たない。終わりは 11/7 のまま） | M3 が 12 日早く終わった。誤検出を減らす検討と装置化は時間がかかるので、空けない | plan.md の日付は人が直すまで変えない。status に「M4 は 10/14 から前倒し」と書く |
| D2 | **M4 の評価側は `meal` の通し記録 3 本以上・最後の 2 収集日**（M2 と同じ）。学習側は M3 の 21 本（条件別）＋追加の条件別＋**学習用の `meal`**（評価側より前の収集日） | 合格線は M2 と同じで「`meal` で測る」のが plan.md。M2 は条件別だけで学習して `meal` で 0.150 だった（条件の違い）。学習に `meal` を入れないと同じ失敗を繰り返す | M4-3 で決定（0037）。`fixed_eval.py` の固定一覧を M4 の一覧に差し替え（M3 の評価側 7 本は M4 では学習側）。評価側 2 日は 0014 の規則のまま |
| D3 | **装置の推論は numpy だけで動かす**（librosa・scipy を UNO Q に入れない） | UNO Q に pip が無い。librosa は numba・llvmlite を連れてくる。特徴量は `mfe40`（メル 40 本の対数）で、要るのはメルのフィルタ行列・フレーム分割・FFT・対数だけ | メルのフィルタ行列を PC で `librosa.filters.mel` から作り、`.npy` の定数として `device/unoq/` に配る（音声ではない）。PC 側の `features_v2.mfe_one` と装置側の numpy 版が同じ値を出すことをテスト。numpy は Debian の `python3-numpy`（人が apt。版を 0035 の追記に固定） |
| D4 | **判定に使う構成は M4-2 で学習側だけで選び直し、事前に固定する**（CNN を基本に、後処理と学習データで誤検出を減らす）。評価側（`meal`）は 1 回だけ | 0003・0014・0034 の原則。M3 の構成 J のまま評価しても 1 回/分には届きにくい | 候補: ヒステリシスの出を上げる、陽性の塊の長さの上限、検出の直後の不応期（塊の後 N 秒は新しい塊にしない）、CNN の種の平均（3 種の確率の平均）、学習データの増強。多数決は採らない（人の決定 10/4）。選ぶ規則は 0014 を「誤検出 1.0 回/分以下のうち検出率が最大」に読み替え、満たす行が無ければ誤検出が最小 |
| D5 | **1 ホップは M4 でも 0.25 秒のまま**。0.1 秒への変更は M4-1 の実測を見て、M5 の前に別の decision で扱う | 評価の定義（0011・0012）に入るので M2・M3 と並べられなくなる。M4 の合格線を通すことが先 | M4-1 で 1 窓の時間を測り、0.1 秒で収まるかの数字だけを log に残す |
| D6 | **表示の規則（0018）は UNO Q の Linux 側が持ち、MCU は状態を画にするだけ**（0035 のまま） | 0018 の規則は窓の結果の時刻で決まる。M2 の検出器と同じ置き方で、PC の再計算（`analysis/led_rule.py`）と一致を確かめられる | `device/unoq/detector.py` が `analysis/led_rule.py` と同じ式で状態を出し、`zm_set_state` を送る。1.0 秒で消灯は Linux 側の時計で。MCU の `shape_seq` は変えない |
| D7 | **PC への出力は窓ごとの結果だけ**（`window_t_ms`、`prob`、`positive`、`led`。FEAT に当たる特徴量は `self` の学習用に別の設定で送れるが既定は送らない） | CLAUDE.md（生の音声を書かない・送らない）。M2 の DETECT と同じ形にすれば `detect.csv`・`evaluate_detector.py` が使える | `detector.py` は標準出力に 1 窓 1 行（JSON か CSV）を出し、PC の `record.py --unoq-detector` が ssh で受けて `detect.csv` を書く（0028 の経路と同じ形）。UNO Q はファイルを書かない。stderr にも波形・特徴量を出さない |
| D8 | **学習用の `meal` は PC の記録の経路（`record.py --throat`、UNO Q の `arecord`）で録る。評価用の `meal` は装置（`detector.py`）で録り、同時に生の音声も PC で録る**（M2 の #27 と同じく、装置の `detect.csv` と PC の再計算の一致を確かめるため） | 評価の数字は装置の出力で出す（plan.md「装置上の推論」）。再計算の一致で装置の実装を確かめる | 同じ UNO Q で記録と検出器を同時に動かさない（0028 決定 3）が、評価用の `meal` は「検出器が動き、PC が ssh の別の口で音声を受ける」形になる。これは 0028 決定 3 の例外になるので M4-3 の決定に書く（記録専用の経路の音声は PC にだけ書く。検出器は書かない） |
| D9 | **UNO Q に入れるパッケージは `python3-numpy` だけ**（人が apt）。推論時間の計測は合成入力（乱数と正弦波）で、音声は使わない | 0035 の方針（依存を足さない）との折り合い。推論に numpy は要る | 0035 に追記（版）。`DEPLOY_FILES` に `analysis/` の共有ファイル（`features_v2.py` の numpy 部分、`postprocess.py`、`led_rule.py`、CNN の重みの `.npz`）を足す。重みは学習の成果で音声ではない |
| D10 | **削るかは M4-4 の終わり（10/28 ごろ）に判断**。削る候補の順: (1) 評価用 `meal` の本数を 3 本に絞る、(2) 装置の推論を PC 上に置き換えて UNO Q は表示だけ（0024 の候補） | 人の考え（削らない）。ただし 11/7 は動かない | status の「保留中の判断」に書く |
| D11 | **本人試用（`p1`）の準備は M4 に入れない**（0024 のとおり応募後） | 期限 | — |

## 各 Issue の本文

### M4-1 UNO Q の Linux 側で推論を動かす土台と、1 窓あたりの処理時間の計測

ラベル: firmware、analysis　Milestone: M4

**背景**

M4 は装置（UNO Q）の上で推論する（docs/plan.md、0025）。#38 で LED の RPC・PD 電源・arduino-cli と、Linux 側のコードの置き場所（`device/unoq/`、rsync で配る。0035）が整った。
UNO Q には numpy・pip が無く（0028）、M3 の推論（0034 の構成 J: `mfe40` の特徴量＋numpy の CNN 順伝播。構成 R: `a52`＋ロジスティック回帰）は PC では 1 窓 1.05 ms だが UNO Q では未計測（0034「確かめていないこと」）。
人の意向（10/11）: 1 ホップ 0.25 → 0.1 秒の判断の材料に、1 窓の処理時間（特徴量・推論・RPC）の実測が要る。

**やること**

- UNO Q に `python3-numpy`（Debian 13 のパッケージ）を人が入れる（sudo）。版を 0035 の追記に固定する。librosa・scipy は入れない（D3）。
- `analysis/features_v2.py` の `mfe40`（フレーム 400/160、Hamming、プリエンファシス 0.97、`n_fft` 512、メル 40 本 0〜4000 Hz、対数）を **numpy だけ**で計算する関数を分け、メルのフィルタ行列は PC で `librosa.filters.mel` から作った `.npy` を定数として読む。
  PC で librosa 版と numpy 版が同じ値（float32 で 1e-5）を出すことをテスト。`a52` の `delta` も同様（必要なら）。
- `device/unoq/DEPLOY_FILES` に、推論に要る共有ファイル（numpy 版の特徴量、`postprocess.py`、CNN の順伝播 `cnn_forward`、メル行列 `.npy`、CNN の重み `.npz`（学習の成果。音声ではない））を足す。
  `analysis/` のファイルを配る形（0035「M4 は同じ一覧に PC と同じ推論のファイルを足す」）。`__pycache__` は作らない（`python3 -B`）。
- 計測スクリプト `device/unoq/bench_infer.py`（合成入力。乱数と正弦波。音声は使わない。ファイルを書かない）: 1 窓（16000 サンプル）の特徴量、CNN の順伝播、`a52`＋LR、`zm_set_state` の往復を各 200 回、中央値と 95 パーセンタイルと最大。1 スレッドと既定のスレッド数。
- 0.1 秒のホップで必要になる「0.1 秒ごとに 1 窓」の処理が収まるか（1 窓の合計 < 100 ms か）を数字で書く。判断は別の decision（D5）。
- 結果を docs/log と 0035 の追記に書く。

**完了の条件**

- UNO Q で numpy 版の特徴量と CNN の順伝播が動き、PC の librosa 版と同じ値を出す（テスト）。
- 1 窓の処理時間（特徴量、CNN、LR、RPC）の中央値・95 パーセンタイルが log にある。1 ホップ 0.25 秒に収まるか、0.1 秒に収まるかの事実が書いてある。
- UNO Q に音声のファイルが無い（docs/unoq-setup.md の確かめ方）。

**関係するファイル**: `analysis/features_v2.py`、`device/unoq/`（`DEPLOY_FILES`、`bench_infer.py`）、docs/decisions/0035（追記）、docs/unoq-setup.md、docs/log/

**制約**: 推論のパイプラインに触れるので Codex の plan レビューの対象。装置側は生の音声を保存も送信もしない（この Issue では音声を扱わない）。UNO Q に置くのは `DEPLOY_FILES` の一覧だけ。

### M4-2 誤検出を減らす検討（学習側だけ。M4 の合格線 1 回/分に向けて）

ラベル: analysis　Milestone: M4

**背景**

M3 の評価側で、判定に使った構成 J（CNN `mfe40` 種 0、ヒステリシス 0.95/0.85）は検出 30/30、誤検出 1.19 回/分（docs/log/2026-10-13.md）。M4 の合格線は 85% / **1 回/分以下**で、このままでは届かない（人の考え、#41）。
M3 の誤検出 23 回の内訳は water の非嚥下区間 9、saliva 5、neck 5、talk 4、cough 0、quiet 0。嚥下の直後に陽性が `[t − 0.5, t + 1.5]` を越えて続くと誤検出に数えられる。
学習側は 1 収集日 14 本だけだった。

**やること**

- M4-3 の分割（学習側 = M3 の 21 本＋追加の条件別＋学習用 `meal`）で、学習側だけを使う。評価側（`meal` の最後の 2 収集日）は名前以外読まない。
- 誤検出の中身の分析（学習側 CV の検証側の確率で）: 嚥下の直後の延び（塊が `t + 1.5` を越える）、動作に付くもの（talk・neck・cough）、`meal` の中の咀嚼・会話、に分けて数える。図は #43 の `visualize.py` を使う。
- 候補（すべて学習側 CV で比べ、評価側で選ばない）:
  1. ヒステリシスの出を上げる（格子は 0033 の 45 点のまま）。
  2. 陽性の塊の長さの上限（例: 2.0 秒を越えた分は陰性に）。
  3. 検出の直後の不応期（塊の終わりから N 秒は新しい塊を作らない。N は {0.5, 1.0, 1.5}）。
  4. CNN の 3 種（0・1・2）の確率の平均（アンサンブル）。
  5. 学習データの増強（M4-3 の追加分）。
  - 採らないもの: 多数決（人の決定 10/4）、評価の定義の変更（窓・数え方・合格線）、ホップの変更（D5）。
- 組の選び方: 0014 の規則を「誤検出 1.0 回/分以下のうち検出率が最大、同率なら単純なほう。満たす行が無ければ誤検出が最小」に読み替える。
- 選んだ構成（特徴量・分類器・種・後処理の値）を **docs/decisions/0038 に事前に固定**し、評価側を開く前にコミットする（0033・0034 と同じ）。
- `docs/evaluation.md` 28 行目の手法（M2 の行は Edge Impulse）からの逸脱は 0034 と同じく記録する。

**完了の条件**

- 学習側 CV の表（候補ごとの検出率・誤検出率・陽性窓の割合）と図が log にあり、選んだ構成が 0038 に固定されている。
- 評価側（`meal`）を 1 本も開いていない（`fixed_eval.py` の検査が通る）。
- 合成データのテストが通る（新しい後処理の入り・出・不応期・塊の上限）。

**関係するファイル**: `analysis/postprocess.py`、`analysis/compare.py`、`analysis/visualize.py`、`analysis/fixed_eval.py`、docs/decisions/0038（新規）、docs/log/

**制約**: 評価の分割と指標、推論のパイプラインに触れるので Codex の plan レビューの対象。評価側を見てから組・閾値・後処理を変えない。`docs/evaluation.md` は変えない。

### M4-3 M4 の学習・評価の分割と、追加の記録の計画（決定）

ラベル: docs、analysis　Milestone: M4

**背景**

M3 の分割（0032・0034: 学習 = 10/11 の 14 本、評価 = 10/12 の 7 本）は M3 の判定のためのもので、M4 の判定は `meal` の通し記録で行う（docs/plan.md、M2 と同じ合格線）。
M2 は条件別のセッションだけで学習して `meal` で 0.150 だった（0027）。M4 では学習に `meal` を入れる（D2）。

**やること**

- 決定 0037 を書く（人がレビュー）:
  - 評価側: `meal` の通し記録、**3 本以上、最後の 2 収集日**（0014 の規則）。評価側の `meal` は装置（M4-4 の `detector.py`）で録り、同時に生の音声を PC で録る（D8。再計算の一致のため）。
  - 学習側: M3 の 21 本（10/11・10/12。評価側だった 7 本は M4 では学習側）＋追加の条件別セッション（1〜2 収集日、10/11 の形。任意）＋**学習用の `meal` 2〜3 本**（評価側より前の収集日。PC の記録の経路で録る）。
  - 収集日の規則: 学習側のどの日も評価側のどの日より前。`fixed_eval.py` の固定の一覧を M4 の一覧に差し替える（M3 の一覧は 0034 の記録として残す）。
  - 0028 決定 3（同じ UNO Q で記録と検出器を同時に動かさない）の例外: 評価用の `meal` は検出器が動き、PC が ssh の別の口で音声を受ける。検出器はファイルを書かない。
  - `meal` の `s` の押し方と捨てる条件は 0023 のまま。打ち切りは最後の収集日で。
- 記録の日程の案（人が決める）: 学習用 `meal` 10/18〜10/22 に 2〜3 本、評価用 `meal` 10/30〜11/2 に 3 本以上（2 日）。
- `docs/recording-protocol.md` に「M4 の `meal`（咽喉マイク）」の節（装着、`o start`、叩き、装置の起動、PC の受け口）。

**完了の条件**

- 0037 が採用され、`fixed_eval.py`・`docs/recording-protocol.md` が合っている。記録の日程が status にある。

**関係するファイル**: docs/decisions/0037（新規）、`analysis/fixed_eval.py`、`docs/recording-protocol.md`、`docs/status.md`

**制約**: 評価の分割に触れるので Codex の plan レビューの対象。`docs/evaluation.md` の定義と合格線は変えない。

### M4-4 装置上の推論と表示（UNO Q の Linux 側 `detector.py`、MCU のマトリクス、PC の受け口）

ラベル: firmware、analysis　Milestone: M4

**背景**

M4 の中心。UNO Q の Linux 側が ALSA から音をメモリに取り、特徴量に変換して破棄し、推論と後処理と 0018 の規則で状態を決め、MCU に RPC で送る（0025、CLAUDE.md「データの扱い」「実装方針」）。
MCU 側は #38 で `zm_set_state(0/1/2)` → 消灯／波線／顔ができている（0035）。PC には窓ごとの結果だけを送る（D7）。

**やること**

- 人が先に CLAUDE.md の「UNO Q の Linux 側は ALSA からメモリに取り」「UNO Q 側はプロジェクトのプログラムを置かず」の文言を 0035 に合わせて直す（D1b。AGENTS.md も同じコミット）。
- `device/unoq/detector.py`: ALSA（`hw:CARD=Audio`、48 kHz・2 ch）から読む経路は **1 モジュール**（`device/unoq/audio_in.py`）に閉じ、L を 16 kHz に落として 1.0 秒の窓・0.25 秒のホップのリングバッファに入れる。
  窓ごとに numpy 版の特徴量（M4-1）→ 0038 の構成で確率 → 後処理 → `analysis/led_rule.py` と同じ式で状態 → `zm_set_state`（`mcu_rpc.py`）。1.0 秒以上新しい結果が出なければ消灯（Linux 側の時計）。
  **波形・特徴量・確率の配列をファイル・ログ・標準エラー・RPC に出さない。** 標準出力は 1 窓 1 行（`window_t_ms`、`prob`、`positive`、`led`）だけ。
- `tools/record.py --unoq-detector`: ssh で `detector.py` を起動して標準出力を受け、`detect.csv`（M2 と同じ列）と `events.csv`・`meta.json` を書く。同時に生の音声を受ける口（`--throat sh12jk-wired-unoq-usbaudio` と同じ `arecord`）を**別の ssh**で開くか、`detector.py` が音声を取るので `arecord` は使えない（ALSA の口は 1 つ）→ **検出器が取った音声を PC に流す口を検出器に持たせない**（CLAUDE.md）。
  → 評価用の記録の形は M4-3 の決定で決める（候補: (a) UNO Q の ALSA に `dsnoop` 相当の分岐を設定して `arecord` と検出器が同じ口を読む（UNO Q の設定の追加。0029 の「ALSA のユーザー設定が無いこと」の条件と衝突するので決定が要る）、(b) 評価用は検出器だけで録り、再計算の一致は学習用の `meal`（PC の音声あり）に検出器を**後から**当てて確かめる（装置で録った音声は無いので一致の確認は別の日の記録で）。**推奨は (b)**: 検出器に音声の出口を作らない。再計算の一致は、学習用 `meal` の `throat.wav` を UNO Q の `detector.py` に標準入力から流す「再生モード」（ファイルは読むが書かない）で確かめる）。
- 装置の起動と停止: 常駐はさせない（0035）。`record.py` が ssh で起動し、Ctrl-C で止める。起動失敗は MCU 側の消灯のまま。
- 時間: 1 ホップ 0.25 秒に収まること（M4-1 の数字）。窓の時刻は UNO Q の単調時計で、PC は受信の時刻も記録する。
- 表示: 0018 の規則のまま（緑 = 顔、黄 = 波線、消灯）。文言は「目安」。貼る表示とカードは `firmware/indicator/README.md` のものを UNO Q 用に写す。
- テスト: 合成の音（ファイルから読む再生モード）で、PC の `features_v2` ＋ `postprocess` ＋ `led_rule.py` の再計算と `detect.csv` が一致（`prob` は 1e-5、`positive`・`led` は完全一致）。音声の出口が無いことの静的な検査（`audio_in.py` 以外が ALSA を開かない、`open(..., "w")` が無い、stdout の行に数値の配列が無い）。

**完了の条件**

- UNO Q の上で `detector.py` が動き、装着して水を飲むとマトリクスが波線 → 顔 → 波線と変わるのを人が目で確かめる（約 2 秒で戻る）。
- PC の `detect.csv` と PC の再計算が一致する（再生モード）。
- UNO Q に音声・特徴量・確率のファイルが無い（`find` の確かめ）。標準出力・標準エラーに波形が出ない（テスト）。
- 1 ホップの処理が 0.25 秒に収まる（log に数字）。

**関係するファイル**: `device/unoq/`（`detector.py`、`audio_in.py`、`DEPLOY_FILES`）、`tools/record.py`、`docs/data-schema.md`（`detect.csv` の `meta.json` の追記）、`docs/unoq-setup.md`、CLAUDE.md・AGENTS.md（人）、docs/log/

**制約**: 生データの扱い・推論のパイプライン・LED の表示ロジックと文言に触れるので Codex の plan レビューの対象。コミット前に adversarial-review（focus: 検出器が生の音声を保存・送信する経路）。

### M4-5 学習用と評価用の記録（条件別の追加、`meal` の通し記録。人）

ラベル: docs　Milestone: M4

**背景**

M4-3 の決定に従って `self` を録る。学習用の `meal` は PC の記録の経路（0028。`record.py --throat`）、評価用の `meal` は装置（M4-4）で録る。条件別の追加は任意。

**やること**

- 学習用: `meal` 2〜3 本（評価側より前の収集日）、条件別 1〜2 収集日（任意。10/11 の 7 本の形）。各セッションの直後に `throat_check.py`、採否は数字を見る前に人。
- 評価用: `meal` 3 本以上、最後の 2 収集日、装置で録る（`record.py --unoq-detector`）。捨てる条件は 0023 の 1〜5 を咽喉マイク版に読み替えた規則（M4-3 で固定）。
- 収集日ごとの集計表を log に（M3 と同じ形）。
- 装着の側・位置・バンドは M3 のまま（両側、`lateral-below-cricoid`、`sh12jk-strap`）。食事の内容は自由（固形物を含む）。

**完了の条件**

- 学習用 `meal` 2 本以上、評価用 `meal` 3 本以上（2 収集日）の記録と集計表が log にある。評価側のセッションは名前の一覧だけを M4-6 に渡す。

**関係するファイル**: `docs/recording-protocol.md`、`docs/log/`、`tools/record.py`、`tools/throat_check.py`

**制約**: 生データはコミットしない。被験者は `self`。評価側の `meal` の音声は PC に無い（D8 の推奨 (b)）か、あっても M4-6 まで開かない。

### M4-6 M4 の評価（評価側を 1 回だけ。M2 と並べる）

ラベル: analysis　Milestone: M4

**背景**

M4 の合格線は M2 と同じ（85% / 1 回/分以下、`meal`）。評価側は装置の `detect.csv`（M4-5）。構成は 0038 で固定済み。

**やること**

- `analysis/evaluate_detector.py`（M2 の #27 で使ったもの）を咽喉マイクの `detect.csv` に当てる（列は同じ）。評価側の全セッションを 1 回だけ採点。混同行列（TP/FN/FP）、検出率、誤検出率（回／非嚥下の分）、常時陽性の参照、陽性窓の割合、セッションごとの表。
- 装置の `led` と PC の再計算の一致（M2 の #27 と同じ）。
- M2（0027: 0.150、2.03 回/分）と M3（0036）と並べる表。手法・センサ・評価側の違いの注記（0034・0038 の逸脱）。
- 印のファイル（`final_eval.py` と同じ仕組み）で 2 回目を止める。
- 「85% 達成」のような書き方はしない。合格線との比較は「満たす / 満たさない」。

**完了の条件**

- 評価側の数字（混同行列、セッション一覧）が log にあり、合格線との比較の事実が書いてある。届かなかった場合は、原因の切り分け（条件別の誤検出、嚥下の直後の延び、装置と PC の差）が log にある（plan.md「届かない場合も数字と原因の切り分けを公開の材料にする」）。

**関係するファイル**: `analysis/evaluate_detector.py`、`analysis/final_eval.py`（M4 版の入口）、docs/log/、docs/decisions/0038

**制約**: 評価側を 1 回だけ。見た後に構成・閾値・後処理を変えない。`docs/evaluation.md` は変えない。

### M4-7 【判定】M4 検出器（咽喉マイク版）

ラベル: docs　Milestone: M4

**この Issue を閉じるのは人。** エージェントは閉じない。

**やること**

- M4-6 の数字を合格線（85% / 1 回/分以下）と照らす。届いた／届かなかった、届かなかった数字と原因の切り分け。
- 関門のレビューを 1 回回す（`--base gate-M3`）。focus: 検出器が生の音声を保存・送信していないこと（0025 の追記の境界）、評価の 1 回だけ・事前登録、LED の文言。生の出力は折りたたみで Issue に貼る。
- 判定の decision（0039）。M5（公開）に渡すもの: 数字、図、装置の写真（マネキンか開発者自身）、表示の文言。
- 1 ホップ 0.1 秒（D5）と p1 の記録先（保留中）の扱いを M5 の前に決めるかを書く。

**完了の条件**

- [ ] M4-1〜M4-6 が閉じている。
- [ ] 報告に混同行列と評価に使ったセッション一覧がある。評価は 3 セッション以上、セッション単位の分割、評価側 2 収集日。
- [ ] 検出器が生の音声を保存していない・装置の外に送っていない（関門のレビューの focus）。
- [ ] 関門のレビューで BLOCKING が残っていない。CONCERN の採否がコメントにある。
- [ ] 通過・届かなかった（数字と原因）のどちらかが `docs/decisions/` に記録されている。
- [ ] 通過したら人が `gate-M4` タグを打つ。届かなくても M5 へ進む（plan.md）。

**関係するファイル**: `docs/evaluation.md`、`docs/plan.md`、`docs/decisions/`、`docs/log/`、`docs/workflow.md`

## 人に決めてもらう点（起票の前）

1. D1（M4 を 10/14 から前倒し）でよいか。plan.md の日付を直すか。
2. D2（学習に `meal` を入れる。評価側は `meal` 3 本以上・最後の 2 収集日）でよいか。学習用 `meal` の本数（2〜3 本）と日程。
3. D8 の評価用 `meal` の録り方: 推奨 (b)（検出器に音声の出口を作らず、再計算の一致は学習用 `meal` の再生モードで確かめる）でよいか。(a)（ALSA の分岐）は 0029 の条件の変更が要る。
4. D4 の候補（出の閾値、塊の上限、不応期、種の平均、データ増強）で足す・外すものはあるか。多数決は採らない（10/4 の決定のまま）。
5. D9（UNO Q に `python3-numpy` だけ入れる。人が apt）でよいか。
6. D10（削る判断は 10/28 ごろ。候補の順）でよいか。
7. Issue の番号の割り当てと、M4-5 の記録の日程（人のカレンダー）。
8. 人の別コミット: `device/` を edit-gate の対象に（#38 D8）、CLAUDE.md・AGENTS.md の文言（0035 D1b）。M4-4 の前に。
