owhinata/zaitaku-mealpace/firmware/indicator/shapes.h

// clang-format off
// shapes.h — 表示器の図形の表（Issue #32、docs/decisions/0018 の追記）。
// 生成物。直接書き換えない。python3 firmware/indicator/shapes/gen_shapes.py
// で作り直す（元は shapes/gen_shapes.py）。
// 状態 1 = 流れる波線（動画。FRAME_MS ごとに次のフレームへ進めてループ）、
// 状態 2 = 微笑む顔（静止画。FRAME_MS は 0）。
// 状態 0 は消灯（表を持たない）。Arduino 依存なし。
#pragma once
#include <stdint.h>

static const int SHAPE_WAVE_FIRST = 0;   // 状態 1 の最初のフレーム
static const int SHAPE_WAVE_COUNT = 6;   // 状態 1 のフレーム数
static const int SHAPE_SMILE = 6;        // 状態 2 のフレーム

static const uint8_t FRAMES[7][8][12] = {
  // [0] 流れる波線 200 ms
  //   ............
  //   ............
  //   ............
  //   .##....##...
  //   #..#..#..#..
  //   ....##....##
  //   ............
  //   ............
  {{0,0,0,0,0,0,0,0,0,0,0,0},{0,0,0,0,0,0,0,0,0,0,0,0},{0,0,0,0,0,0,0,0,0,0,0,0},{0,1,1,0,0,0,0,1,1,0,0,0},{1,0,0,1,0,0,1,0,0,1,0,0},{0,0,0,0,1,1,0,0,0,0,1,1},{0,0,0,0,0,0,0,0,0,0,0,0},{0,0,0,0,0,0,0,0,0,0,0,0}},
  // [1] 流れる波線 200 ms
  //   ............
  //   ............
  //   ............
  //   ##....##....
  //   ..#..#..#..#
  //   ...##....##.
  //   ............
  //   ............
  {{0,0,0,0,0,0,0,0,0,0,0,0},{0,0,0,0,0,0,0,0,0,0,0,0},{0,0,0,0,0,0,0,0,0,0,0,0},{1,1,0,0,0,0,1,1,0,0,0,0},{0,0,1,0,0,1,0,0,1,0,0,1},{0,0,0,1,1,0,0,0,0,1,1,0},{0,0,0,0,0,0,0,0,0,0,0,0},{0,0,0,0,0,0,0,0,0,0,0,0}},
  // [2] 流れる波線 200 ms
  //   ............
  //   ............
  //   ............
  //   #....##....#
  //   .#..#..#..#.
  //   ..##....##..
  //   ............
  //   ............
  {{0,0,0,0,0,0,0,0,0,0,0,0},{0,0,0,0,0,0,0,0,0,0,0,0},{0,0,0,0,0,0,0,0,0,0,0,0},{1,0,0,0,0,1,1,0,0,0,0,1},{0,1,0,0,1,0,0,1,0,0,1,0},{0,0,1,1,0,0,0,0,1,1,0,0},{0,0,0,0,0,0,0,0,0,0,0,0},{0,0,0,0,0,0,0,0,0,0,0,0}},
  // [3] 流れる波線 200 ms
  //   ............
  //   ............
  //   ............
  //   ....##....##
  //   #..#..#..#..
  //   .##....##...
  //   ............
  //   ............
  {{0,0,0,0,0,0,0,0,0,0,0,0},{0,0,0,0,0,0,0,0,0,0,0,0},{0,0,0,0,0,0,0,0,0,0,0,0},{0,0,0,0,1,1,0,0,0,0,1,1},{1,0,0,1,0,0,1,0,0,1,0,0},{0,1,1,0,0,0,0,1,1,0,0,0},{0,0,0,0,0,0,0,0,0,0,0,0},{0,0,0,0,0,0,0,0,0,0,0,0}},
  // [4] 流れる波線 200 ms
  //   ............
  //   ............
  //   ............
  //   ...##....##.
  //   ..#..#..#..#
  //   ##....##....
  //   ............
  //   ............
  {{0,0,0,0,0,0,0,0,0,0,0,0},{0,0,0,0,0,0,0,0,0,0,0,0},{0,0,0,0,0,0,0,0,0,0,0,0},{0,0,0,1,1,0,0,0,0,1,1,0},{0,0,1,0,0,1,0,0,1,0,0,1},{1,1,0,0,0,0,1,1,0,0,0,0},{0,0,0,0,0,0,0,0,0,0,0,0},{0,0,0,0,0,0,0,0,0,0,0,0}},
  // [5] 流れる波線 200 ms
  //   ............
  //   ............
  //   ............
  //   ..##....##..
  //   .#..#..#..#.
  //   #....##....#
  //   ............
  //   ............
  {{0,0,0,0,0,0,0,0,0,0,0,0},{0,0,0,0,0,0,0,0,0,0,0,0},{0,0,0,0,0,0,0,0,0,0,0,0},{0,0,1,1,0,0,0,0,1,1,0,0},{0,1,0,0,1,0,0,1,0,0,1,0},{1,0,0,0,0,1,1,0,0,0,0,1},{0,0,0,0,0,0,0,0,0,0,0,0},{0,0,0,0,0,0,0,0,0,0,0,0}},
  // [6] 微笑む顔（静止画）
  //   ............
  //   ............
  //   ...##..##...
  //   ...##..##...
  //   ............
  //   ..#......#..
  //   ...######...
  //   ............
  {{0,0,0,0,0,0,0,0,0,0,0,0},{0,0,0,0,0,0,0,0,0,0,0,0},{0,0,0,1,1,0,0,1,1,0,0,0},{0,0,0,1,1,0,0,1,1,0,0,0},{0,0,0,0,0,0,0,0,0,0,0,0},{0,0,1,0,0,0,0,0,0,1,0,0},{0,0,0,1,1,1,1,1,1,0,0,0},{0,0,0,0,0,0,0,0,0,0,0,0}},
};
static const uint16_t FRAME_MS[7] = {200,200,200,200,200,200,0};
