owhinata/zaitaku-mealpace/firmware/unoq_mcu/shapes_unoq.h

// clang-format off
// shapes_unoq.h — UNO Q の LED マトリクス（8×13）に出す点灯の確かめの図形。
// firmware/indicator/shapes.h（#32。shapes/gen_shapes.py の生成物）の
// [6] 微笑む顔（静止画。12 列×8 行）を 1 枚だけ写したもの。12 列のまま持ち、
// 書くとき（led_out.cpp）に 13 列の左寄せ（右端の 1 列は消灯）にする。
// 流れる波線（動画）と表示の規則（docs/decisions/0018）は M4。Arduino 依存なし。
#pragma once
#include <stdint.h>

static const int SMILE_ROWS = 8;
static const int SMILE_COLS = 12;

// 微笑む顔（静止画）
//   ............
//   ............
//   ...##..##...
//   ...##..##...
//   ............
//   ..#......#..
//   ...######...
//   ............
static const uint8_t SMILE[8][12] = {
  {0,0,0,0,0,0,0,0,0,0,0,0},
  {0,0,0,0,0,0,0,0,0,0,0,0},
  {0,0,0,1,1,0,0,1,1,0,0,0},
  {0,0,0,1,1,0,0,1,1,0,0,0},
  {0,0,0,0,0,0,0,0,0,0,0,0},
  {0,0,1,0,0,0,0,0,0,1,0,0},
  {0,0,0,1,1,1,1,1,1,0,0,0},
  {0,0,0,0,0,0,0,0,0,0,0,0},
};
