owhinata/zaitaku-mealpace/tools/test_record_tty.py

"""record.py の終了後に端末が元に戻ることを pty で検証する（#16）。

実行: python -m unittest discover -s tools -v
子プロセスの stdin/stdout/stderr を pty の slave につなぎ、
シリアルは偽物に差し替えて
`record.main()` を動かす。出力先は tempfile で、`data/raw/` は読み書きしない。
偽物のシリアルは合図（#33）を受けると、最初の read() で META
のフレームを返す（NO_META=1 なら返さない）。
POSIX 以外では skip（Windows の経路は端末の設定を変えない）。
"""

from __future__ import annotations
import csv, os, subprocess, sys, tempfile, threading, time, unittest
from pathlib import Path

POSIX = os.name == "posix"
if POSIX:
    import pty, select, signal, termios

import record

TOOLS_DIR = Path(__file__).resolve().parent
EXIT_DEADLINE = 5.0  # 終了の期限（秒）
WAIT_DEADLINE = 5.0  # 出力・端末の設定を待つ期限（秒）

# 子プロセスの中身。record.serial と record.RAW_DIR を差し替えてから main()
# を呼ぶ。
CHILD = r'''
import os, sys, time, types
from pathlib import Path
sys.path.insert(0, os.environ["RECORD_DIR"])
import record

FAIL_AT = int(os.environ.get("FAIL_AT", "0"))     # 記録の段（META を返した後）の read() の何回目で失敗するか
FAIL_KIND = os.environ.get("FAIL_KIND", "os")
NO_META = os.environ.get("NO_META", "") == "1"
if os.environ.get("META_WAIT_S"):
    record.META_WAIT_S = float(os.environ["META_WAIT_S"])


def meta_frame():
    """t_ms 0 の検出器の META（マーカーの時刻は 0 ms のまま）。"""
    payload = b'{"fw":"detector","threshold":0.5,"model":{},"feature_names":["a"]}'
    body = bytes([record.ID_META]) + len(payload).to_bytes(2, "little") + (0).to_bytes(4, "little") + payload
    x = 0
    for b in body:
        x ^= b
    return record.SYNC + body + bytes([x])


class FakeSerial:
    """合図を受けたら最初の read() で META を返し、以後は少し待って空のバイト列を返すだけ。実機は要らない。"""

    def __init__(self, port, baud, timeout=0.05, write_timeout=None):
        if FAIL_KIND == "init":
            raise OSError("fake: port not found")
        self.n = 0
        self.meta_pending = False

    def write(self, data):
        if data == record.META_REQUEST and not NO_META:
            self.meta_pending = True
        return len(data)

    def read(self, n):
        if self.meta_pending:
            self.meta_pending = False
            return meta_frame()
        self.n += 1
        if FAIL_AT and self.n >= FAIL_AT:
            if FAIL_KIND == "exit":
                raise SystemExit(3)
            raise OSError("fake: serial gone")
        time.sleep(0.02)
        return b""

    def close(self):
        pass


record.serial = types.SimpleNamespace(Serial=FakeSerial)
record.RAW_DIR = Path(os.environ["RAW_DIR"])
if os.environ.get("THROAT_FAKE"):
    # --throat の子を偽の子（test_record_throat.FAKE_CHILD）に差し替える（t11）
    import json
    record.throat_argv = lambda host, device: json.loads(os.environ["THROAT_FAKE"])
    record.mixer_argv = lambda host, device: None
    record.asoundrc_check_argv = lambda host: [sys.executable, "-c", "pass"]
if os.environ.get("UNOQ_FAKE"):
    # --unoq-detector の ssh の子を偽の検出器（test_record_unoq.FAKE_DET）に
    # 差し替える（#47）。起動前の確かめ・往復時間・消灯も偽のコマンドに
    import json
    py = lambda code: [sys.executable, "-I", "-c", code]
    record.unoq_detector_argv = lambda host, args: json.loads(os.environ["UNOQ_FAKE"])
    record.led_off_argv = lambda host: py("pass")
    record.rtt_argv = lambda host: py(
        "import sys\nfor l in sys.stdin:\n    sys.stdout.write(l); sys.stdout.flush()"
    )
    record.busy_check_argv = lambda host: py("import sys; sys.exit(1)")
    record.swap_check_argv = lambda host: py("print('Filename Type')")
    record.asoundrc_check_argv = lambda host: py("pass")
    record.mixer_argv = lambda host, device: None
record.main()
'''


class Child:
    """pty の上で record.main() を動かす子プロセス。"""

    def __init__(self, test: unittest.TestCase, args=(), env_extra=None):
        self.master, self.slave = pty.openpty()
        self.tmp = tempfile.TemporaryDirectory()
        self.raw_dir = Path(self.tmp.name)
        env = dict(os.environ)
        env.update(
            {
                "RECORD_DIR": str(TOOLS_DIR),
                "RAW_DIR": str(self.raw_dir),
                "SUBJECT": "",
                "COND": "",
                "POSITION": "",
                "BAND": "",
                "DURATION": "",
            }
        )
        env.update(env_extra or {})
        self._out = bytearray()
        self._lock = threading.Lock()
        self._stop = threading.Event()
        self.proc = subprocess.Popen(
            [sys.executable, "-c", CHILD, *args],
            stdin=self.slave,
            stdout=self.slave,
            stderr=self.slave,
            start_new_session=True,
            env=env,
            cwd=str(TOOLS_DIR.parent),
        )
        self._drain = threading.Thread(target=self._drain_loop, daemon=True)
        self._drain.start()
        test.addCleanup(self.cleanup)

    def _drain_loop(self):
        while not self._stop.is_set():
            try:
                if not select.select([self.master], [], [], 0.1)[0]:
                    continue
                data = os.read(self.master, 4096)
            except OSError:
                return
            if not data:
                return
            with self._lock:
                self._out += data

    def cleanup(self):
        self._stop.set()
        if self.proc.poll() is None:
            self.proc.kill()
            self.proc.wait(timeout=EXIT_DEADLINE)
        self._drain.join(timeout=1.0)
        os.close(self.master)
        os.close(self.slave)
        self.tmp.cleanup()

    # --- 端末と入出力 ---
    def lflag(self) -> tuple[bool, bool]:
        """pty の (ECHO, ICANON)。"""
        lf = termios.tcgetattr(self.slave)[3]
        return bool(lf & termios.ECHO), bool(lf & termios.ICANON)

    def output(self) -> str:
        with self._lock:
            return bytes(self._out).decode("utf-8", "replace")

    def send(self, text: str) -> None:
        os.write(self.master, text.encode("utf-8"))

    def signal(self, sig: int) -> None:
        os.kill(self.proc.pid, sig)

    # --- 待つ ---
    def wait_for(self, pred, what: str, timeout: float = WAIT_DEADLINE) -> None:
        end = time.monotonic() + timeout
        while time.monotonic() < end:
            if pred():
                return
            if self.proc.poll() is not None and not pred():
                raise AssertionError(
                    f"{what} を待つ間に子が終了した（出力: {self.output()!r}）"
                )
            time.sleep(0.02)
        raise AssertionError(
            f"{what} を {timeout} 秒待っても起きない（出力: {self.output()!r}）"
        )

    def wait_text(self, text: str, timeout: float = WAIT_DEADLINE) -> None:
        self.wait_for(lambda: text in self.output(), f"出力 {text!r}", timeout)

    def wait_ready(self) -> None:
        """記録が始まり、端末が cbreak になるまで待つ。"""
        self.wait_text("recording...")
        self.wait_for(lambda: self.lflag() == (False, False), "cbreak")

    def wait_note_prompt(self) -> None:
        """note の入力に入り、端末が元の設定に戻るまで待つ。"""
        self.wait_text("note: ")
        self.wait_for(
            lambda: self.lflag() == (True, True), "元の設定（行の編集とエコー）"
        )

    def wait_exit(self, timeout: float = EXIT_DEADLINE) -> int:
        try:
            return self.proc.wait(timeout=timeout)
        except subprocess.TimeoutExpired:
            self.proc.kill()
            raise AssertionError(
                f"{timeout} 秒で終わらない（出力: {self.output()!r}）"
            )

    # --- 記録 ---
    def events(self) -> list[list[str]]:
        """セッションの events.csv（ヘッダを除く）。"""
        dirs = [d for d in self.raw_dir.iterdir() if d.is_dir()]
        if len(dirs) != 1:
            raise AssertionError(f"セッションフォルダが1つではない: {dirs}")
        with open(dirs[0] / "events.csv", newline="", encoding="utf-8") as f:
            rows = list(csv.reader(f))
        assert rows[0] == ["t_ms", "label", "note"], rows[0]
        return rows[1:]


@unittest.skipUnless(POSIX, "POSIX の経路のテスト")
class RecordTtyTest(unittest.TestCase):
    def start(self, *args, **kwargs) -> Child:
        c = Child(self, args=args, **kwargs)
        self.before = c.lflag()
        return c

    def assertTtyRestored(self, c: Child):
        self.assertEqual(
            c.lflag(),
            self.before,
            f"端末が戻っていない（出力: {c.output()!r}）",
        )

    def test_t1_duration_exit_restores_tty(self):
        c = self.start("--duration", "0.5")
        self.assertEqual(c.wait_exit(), 0, c.output())
        self.assertTtyRestored(c)

    def test_t2_sigint_restores_tty(self):
        c = self.start()
        c.wait_ready()
        c.signal(signal.SIGINT)
        self.assertEqual(c.wait_exit(), 0, c.output())
        self.assertTtyRestored(c)

    def test_t3_sigterm_restores_tty(self):
        c = self.start()
        c.wait_ready()
        c.signal(signal.SIGTERM)
        self.assertEqual(c.wait_exit(), 128 + signal.SIGTERM, c.output())
        self.assertTtyRestored(c)

    def test_t4_cbreak_while_running_and_marker(self):
        c = self.start()
        c.wait_ready()  # 実行中は cbreak（ICANON=False）
        self.assertEqual(c.lflag(), (False, False))
        c.send("s")
        c.wait_text("[0 ms] s")
        c.signal(signal.SIGINT)
        self.assertEqual(c.wait_exit(), 0, c.output())
        self.assertTtyRestored(c)
        self.assertEqual(c.events(), [["0", "s", ""]])

    def test_t5_note_then_marker(self):
        c = self.start()
        c.wait_ready()
        c.send("o")
        c.wait_note_prompt()  # note の入力中は ECHO=True・ICANON=True
        c.send("memo\n")
        c.wait_text("[0 ms] o memo")
        c.wait_for(lambda: c.lflag() == (False, False), "cbreak に戻る")
        c.send("s")
        c.wait_text("[0 ms] s")
        c.signal(signal.SIGINT)
        self.assertEqual(c.wait_exit(), 0, c.output())
        self.assertTtyRestored(c)
        self.assertEqual(c.events(), [["0", "o", "memo"], ["0", "s", ""]])

    def test_t5b_note_and_next_key_in_one_write(self):
        """note の改行より後ろの `s` を捨てない。"""
        c = self.start()
        c.wait_ready()
        c.send("o")
        c.wait_note_prompt()
        c.send("memo\ns")
        c.wait_text("[0 ms] s")
        c.signal(signal.SIGINT)
        self.assertEqual(c.wait_exit(), 0, c.output())
        self.assertEqual(c.events(), [["0", "o", "memo"], ["0", "s", ""]])

    def test_t5c_key_note_and_next_key_in_one_write(self):
        """`o` と note と次のキーが1回で届いても、順に処理する。"""
        c = self.start()
        c.wait_ready()
        c.send("omemo\ns")
        c.wait_text("[0 ms] s")
        c.signal(signal.SIGINT)
        self.assertEqual(c.wait_exit(), 0, c.output())
        self.assertTtyRestored(c)
        self.assertEqual(c.events(), [["0", "o", "memo"], ["0", "s", ""]])

    def test_t6_unfinished_note_duration(self):
        """note を打ち終える前に --duration で終わっても、
        止まらず端末が戻る。"""
        c = self.start("--duration", "1.5")
        c.wait_ready()
        c.send("o")
        c.wait_note_prompt()
        self.assertEqual(c.wait_exit(), 0, c.output())
        self.assertTtyRestored(c)
        self.assertEqual(c.events(), [])

    def test_t6b_unfinished_note_sigint(self):
        c = self.start()
        c.wait_ready()
        c.send("o")
        c.wait_note_prompt()
        c.signal(signal.SIGINT)
        self.assertEqual(c.wait_exit(), 0, c.output())
        self.assertTtyRestored(c)
        self.assertEqual(c.events(), [])

    def test_t7_read_frames_raises_oserror(self):
        c = self.start(env_extra={"FAIL_AT": "3", "FAIL_KIND": "os"})
        c.wait_ready()
        self.assertEqual(c.wait_exit(), 1, c.output())
        self.assertTtyRestored(c)
        self.assertIn("fake: serial gone", c.output())

    def test_t7b_read_frames_raises_systemexit(self):
        c = self.start(env_extra={"FAIL_AT": "3", "FAIL_KIND": "exit"})
        c.wait_ready()
        self.assertEqual(c.wait_exit(), 3, c.output())
        self.assertTtyRestored(c)

    def test_t8_failure_before_tty_change(self):
        """端末を変える前に失敗したら、端末は元のまま。"""
        c = self.start(env_extra={"FAIL_KIND": "init"})
        self.assertNotEqual(c.wait_exit(), 0)
        self.assertTtyRestored(c)
        self.assertNotIn("recording...", c.output())

    def test_t10_no_meta_stops_before_recording(self):
        """META が届かなければ recording... を出さずに止まり、端末は元のまま、
        フォルダはできない（#33）。"""
        c = self.start(env_extra={"NO_META": "1", "META_WAIT_S": "0.3"})
        self.assertEqual(c.wait_exit(), 1, c.output())
        self.assertTtyRestored(c)
        self.assertNotIn("recording...", c.output())
        self.assertIn("META が 0.3 秒以内に届きませんでした", c.output())
        self.assertEqual(list(c.raw_dir.iterdir()), [])

    def test_t11_throat_sigint_restores_tty_and_stops_child(self):
        """--throat（偽の子）でも SIGINT で端末が戻り、子が残らず、throat.wav と
        meta.json（throat.stop = interrupt）ができる（#36）。"""
        import json
        from test_record_throat import FAKE_CHILD, pid_alive

        with tempfile.TemporaryDirectory() as d:
            fake = Path(d) / "fake_child.py"
            fake.write_text(FAKE_CHILD, encoding="utf-8")
            pidfile = Path(d) / "child.pid"
            argv = [
                sys.executable,
                "-I",
                str(fake),
                json.dumps({"pidfile": str(pidfile)}),
            ]
            c = self.start(
                "--throat",
                "sh12jk-wired-unoq-usbaudio",
                "--cond",
                "quiet",
                env_extra={"THROAT_FAKE": json.dumps(argv)},
            )
            c.wait_ready()
            c.send("s")
            c.wait_text("ms] s")
            c.signal(signal.SIGINT)
            self.assertEqual(c.wait_exit(), 0, c.output())
            self.assertTtyRestored(c)
            self.assertFalse(pid_alive(int(pidfile.read_text())))
            dirs = [p for p in c.raw_dir.iterdir() if p.is_dir()]
            self.assertEqual(len(dirs), 1)
            self.assertTrue((dirs[0] / "throat.wav").exists())
            meta = json.loads(
                (dirs[0] / "meta.json").read_text(encoding="utf-8")
            )
            self.assertEqual(meta["throat"]["stop"], "interrupt")
            self.assertEqual([r[1] for r in c.events()], ["s"])

    def test_t12_unoq_no_rpc_enter_marker_sigint(self):
        """--unoq-detector --no-rpc（偽の検出器）: 消灯の後に Enter を待ち、
        cbreak でマーカーを受け、SIGINT で端末が戻り、子が残らない（#47）。"""
        import json
        from test_record_throat import pid_alive
        from test_record_unoq import FAKE_DET, good_header

        with tempfile.TemporaryDirectory() as d:
            fake = Path(d) / "fake_det.py"
            fake.write_text(FAKE_DET, encoding="utf-8")
            pidfile = Path(d) / "det.pid"
            cfg = {
                "pidfile": str(pidfile),
                "header": good_header(no_rpc=True),
                "interval": 0.05,
            }
            argv = [sys.executable, "-I", str(fake), json.dumps(cfg)]
            c = self.start(
                "--unoq-detector",
                "--no-rpc",
                "--cond",
                "water",
                env_extra={"UNOQ_FAKE": json.dumps(argv)},
            )
            c.wait_text("目で確かめてから続ける（Enter）")
            self.assertFalse(pidfile.exists())  # Enter の前は起動しない
            c.send("\n")
            c.wait_ready()
            c.wait_text("窓が届き始めた")
            c.send("s")
            c.wait_text("ms] s")
            c.signal(signal.SIGINT)
            self.assertEqual(c.wait_exit(), 0, c.output())
            self.assertTtyRestored(c)
            self.assertFalse(pid_alive(int(pidfile.read_text())))
            self.assertEqual([r[1] for r in c.events()], ["s"])
            dirs = [p for p in c.raw_dir.iterdir() if p.is_dir()]
            meta = json.loads(
                (dirs[0] / "meta.json").read_text(encoding="utf-8")
            )
            self.assertEqual(meta["stop"], "interrupt")
            self.assertFalse(meta["rpc"])
            # Ctrl-C で標準入力を閉じ、検出器の E 行を受けてから終わる
            self.assertEqual(meta["unoq_detector"]["end"]["stop"], "eof")
            self.assertNotIn("0.777777777", c.output())


class MarkAfterCloseTest(unittest.TestCase):
    """close() の後の mark() は書かない（pty なし）。"""

    def test_t9_mark_after_close_is_ignored(self):
        with tempfile.TemporaryDirectory() as d:
            sess = record.Session(Path(d), "self", "quiet", "pos", "band")
            sess.mark("s")
            sess.close()
            ev = sess.dir / "events.csv"
            before = ev.read_text(encoding="utf-8")
            sess.mark("t")
            sess.mark("o", "note")
            self.assertEqual(ev.read_text(encoding="utf-8"), before)
            self.assertEqual(before.splitlines()[1:], ["0,s,"])
            sess.close()  # 二度目の close() も通る


if __name__ == "__main__":
    unittest.main()
