owhinata/zaitaku-mealpace/tools/test_check_session.py

"""check_session.py を合成データで検証する（#23、docs/decisions/0021）。

実行: python -m unittest discover -s tools -v
合成セッションは tempfile に作る。data/raw/ は使わない。C6 だけは
data/sample/（self の 10 秒の見本）を読む。
"""

from __future__ import annotations
import contextlib, io, tempfile, unittest
from pathlib import Path

import check_session

SAMPLE = (
    Path(__file__).resolve().parent.parent
    / "data"
    / "sample"
    / "20260920-000000_self_quiet"
)
N_WINDOWS = 240
LAG_MS = 1030  # 送信時刻 − 窓の開始（合成の値）

# data/sample/20260920-000000_self_quiet に対する変更前（HEAD c9ae24a）の出力。
# 1 行目のフォルダ名は除く
SAMPLE_EXPECTED = """[IMU]
  行数: 1055
  記録の長さ: 9.989 秒
  実効レート: 105.52 Hz（公称 104 Hz 比 101.5%）
  1周期（飛びでない t_ms 差分の平均）: 9.48 ms
  飛び: 0 箇所 / 失われた行数(推定): 0 / 取りこぼし率: 0.000%
  最大差分: 11 ms / t_ms の逆行: 0 箇所
[音声]
  チャンク数: 2500
  総サンプル数(推定): 160000（1チャンク 64 サンプル、公称 4.000 ms）
  飛び: 0 箇所 / 失われたチャンク数(推定): 0 / 取りこぼし率: 0.000%
  最大差分: 4 ms / t_ms の逆行: 0 箇所
  sample_index の差分が最頻値と違う箇所: 0 箇所
  実効サンプルレート: 16000.0 Hz（公称 16000 Hz 比 100.00%）

[判定] 取りこぼし率 1%未満を「基準内」とする（Issue #7 の作業上の基準。docs/evaluation.md の合格線ではない）
  IMU:   基準内（0.000%）
  音声:  基準内（0.000%）
  ※ XOR 不一致数はここでは分からない。tools/record.py の終了時の表示を見ること。"""


def windows(
    n: int = N_WINDOWS, start_ms: int = 1000, hop_ms: int = 250
) -> list[int]:
    return [start_ms + hop_ms * i for i in range(n)]


def write_detect(d: Path, w: list[int], lag_ms: int = LAG_MS) -> None:
    lines = ["t_ms,window_t_ms,positive,prob,led"] + [
        f"{x + lag_ms},{x},1,0.95,2" for x in w
    ]
    (d / "detect.csv").write_text("\n".join(lines) + "\n", encoding="utf-8")


def write_feat(
    d: Path, w: list[int], lag_ms: int = LAG_MS + 2, n_dims: int = 5
) -> None:
    header = ["t_ms", "window_t_ms"] + [f"f{i}" for i in range(n_dims)]
    lines = [",".join(header)] + [
        ",".join([str(x + lag_ms), str(x)] + ["0.5"] * n_dims) for x in w
    ]
    (d / "feat.csv").write_text("\n".join(lines) + "\n", encoding="utf-8")


def run_main(d: Path) -> tuple[int, str]:
    out = io.StringIO()
    with contextlib.redirect_stdout(out):
        try:
            check_session.main([str(d)])
        except SystemExit as e:
            return (e.code if isinstance(e.code, int) else 1), out.getvalue()
    raise AssertionError("main() が sys.exit で終わらなかった")
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
