owhinata/zaitaku-mealpace/(commit log)

2026-09-19 Add Codex review rules and plan review gate
    Document when and how Codex reviews run in docs/workflow.md: a plan
    review before ExitPlanMode and an adversarial review at each milestone
    gate. Only BLOCKING findings gate; CONCERNs are decided by a human, and
    re-reviews are capped at two rounds.
    Add AGENTS.md as the summary of CLAUDE.md constraints that Codex reads,
    and the codex-review skill for plan reviews. Enforce the gate with
    hooks: plan-approve.sh is the only writer of the approval marker; it
    rejects Codex output that lacks a PLAN-SHA line matching the current
    plan file or that carries a BLOCKING verdict. plan-gate.sh lets
    ExitPlanMode through only when the plan file hash matches the mark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
2026-09-19 #2 Verify upload and frame reception on hardware
    Fix the record target, whose $ENV{} arguments expanded to nothing at
    configure time, by letting tools/record.py read SUBJECT, COND, POSITION,
    BAND and DURATION from the environment. Add --duration, per-stream
    counts of valid frames and XOR mismatches, and skip the key thread
    without a tty. The recording format is unchanged.
    Align docs/data-schema.md with the actual session folder (decision
    0006: the device-reported sample rates are authoritative) and set the
    monitor baudrate to 2000000 after measuring that USB CDC ignores it.
    Log the 10-second desk recording: 1 META, 1045 IMU and 2475 AUDIO
    frames with no XOR mismatch. The audio chunk timesta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
    [record.py]
2026-09-20 #4 Record Edge Impulse project settings
    Log the settings of the newly created private project: one label per
    data item, Raspberry Pi RP2040 target with 264 KB RAM and 16 MB ROM,
    and a 100 ms inference latency target. The project ID and API keys stay
    out of the repository.
    Add the IMU/audio fusion method to the decisions due before M2, since
    Edge Impulse only fuses channels that share a sampling frequency.
2026-09-20 #6 Resume the Codex thread for plan re-reviews
    Fresh sessions re-read the repository and raised new CONCERNs on every
    round in #2. Re-reviews now continue the previous thread and only check
    that earlier findings are resolved. First reviews and gate reviews stay
    fresh; the two-round limit is unchanged (docs/decisions/0008).
2026-09-20 #6 Fix record.py output to data/raw
    The M0 gate review found that --out let a p1 session be written straight
    into data/sample, which .gitignore re-includes. Drop the option and
    resolve data/raw from the script location so the cwd no longer matters.
    Remaining paths (git add -f, manual moves, p1 storage location) are
    listed in docs/decisions/0007.
    [record.py]
2026-09-20 #6 Reject cond values that escape data/raw
    The gate re-review showed that cond was joined into the session path
    unchecked, so --cond ../../../sample/leak wrote into data/sample. Limit
    cond to alphanumerics and hyphens, and make Session refuse any folder
    that is not a direct child of the output directory.
    [record.py]
2026-09-20 #6 Drop the re-review count limit
    With plan re-reviews resuming the previous thread, a fixed cap no longer
    earns its keep. Stopping is decided by content: keep fixing while
    BLOCKING remains, hand CONCERN-only results and non-converging reviews
    to the human (docs/decisions/0009).
2026-09-20 #7 Verify 60 s logging has no dropped frames
    Add tools/check_session.py, which estimates dropped IMU rows and audio
    chunks from t_ms gaps. A 60 s worn recording (self, quiet) showed no
    gaps and no XOR mismatches, so the logger firmware is left unchanged.
2026-09-20 #8 Fix the M1 recording protocol for self
    Add docs/recording-protocol.md: mounting, per-condition sessions,
    marker rules, when to discard a session, and how the 50+ counts are
    taken. The last two collection days form the evaluation side.
2026-09-20 #10 Align evaluate.py and split.py with the evaluation definition
    Fix nine mismatches with docs/evaluation.md (double counting a window
    as hit and false positive, overlapping swallow intervals, unclipped
    record edges, runs split by a swallow, eval-min below three, substring
    subject match) and pin the counting with synthetic unittest cases.
    Interpretations of points the definition leaves open are recorded in
    docs/decisions/0011. docs/evaluation.md is unchanged.
2026-09-20 #11 Add per-window features for the M1 classifier
    analysis/features.py computes 29 features per 1.0 s / 0.25 s window
    (IMU amplitude, RMS, peak count, principal axis; audio MFCC, spectral
    centroid, zero-crossing rate) on the device t_ms axis, with numpy only.
    Formulas are fixed in docs/decisions/0012 before looking at real data.
    Normalization statistics come only from the sessions passed to fit.
2026-09-20 #9 Add a 10 s self sample under data/sample
    A quiet 10.000 s excerpt (2500 audio chunks and the IMU rows in the same
    t_ms range) for format checks and for running the analysis scripts
    without raw data. sample_index is rebased to 0; t_ms is kept as the
    device millis(). The audio was listened to before committing.
    [audio_chunks.csv, events.csv, imu.csv]
2026-09-20 #15 Define audio chunk t_ms as the read-time stamp
    Align docs/data-schema.md with the firmware: the chunk t_ms is millis()
    taken right after PDM.read(), treated as the end-side time, and the
    first-sample time is t_ms minus the chunk duration (docs/decisions/0013).
    features.py converts per chunk and detects audio gaps on the converted
    timeline. Firmware and recorded data are unchanged.
2026-09-20 #16 Restore the terminal after record.py exits
    The marker input ran in a daemon thread that put the terminal in cbreak
    and restored it in its own finally, which never runs at process exit.
    Move save/restore to the main thread (atexit + finally, SIGTERM routed
    through SystemExit), read keys with select + os.read so the thread can
    stop itself, and read the "o" note in the original terminal mode.
    Session.mark() is a no-op after close(). The recording format, marker
    timing, arguments and output location are unchanged.
    Add pty-based tests that run main() with a fake serial port and a
    temporary output folder.
2026-09-22 #5 Take the alternative sensor inquiry out of any milestone
    M0 is closed; the inquiry stays open without a milestone.
2026-09-24 #19 Record the bite-button and LED display rule
    Bite button (marker b) is not used in M2; latency waits for M3+.
    LED shows green (swallow observed, guide only) and yellow (not yet);
    green from the first positive window, held 2.0 s (windows starting
    within 1.75 s), off when no window result for 1.0 s. On-board RGB via
    WiFiNINA with fallback to two external LEDs. DETECT led value 0/1/2.
    Wording uses "guide", never "judgement" or instructions.
2026-09-24 #20 Measure cross-day drift and cough windows on existing data
    Throwaway analysis (reference only, #13 numbers unchanged): leave-one-
    day-out 4-fold CV with the M1 features and procedure, per-day
    normalisation as a diagnostic, per-sensor folds, per-dimension day
    shift, and cough-window statistics (which dimensions separate c from s,
    false-positive run timing after c, run-length breakdown). Hypotheses
    H1-H4 judged; implications for #18, #19 and #21 recorded in the log.
2026-09-24 #17 Measure on-device feature cost for three candidates
    Add firmware/bench (synthetic input only, no sensors, no raw audio):
    Edge Impulse MFCC/MFE DSP blocks from a dummy impulse, a C++ port of the
    0012 audio features (15 dims, full-window and frame-reuse), and a port
    of the 0012 IMU features (14 dims). Ports are checked against
    analysis/features.py on the host (max rel. error 1e-6). CMake gains
    SKETCH_NAME and BUILD_FLAGS; the EI export under firmware/bench/src is
    gitignored. Results on the Nano RP2040 Connect (125 MHz, N=20): IMU
    8.1 ms per hop; audio 0.56-4.18 s per hop for every candidate, none
    within 250 ms; RAM fits for all. Table and estimates in the log.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
    [audio_features.cpp, audio_features.h, bench.ino, ei_dsp_case.cpp, ei_dsp_case.h, fft512.cpp]
2026-09-24 #26 Add the M2 meal recording procedure
    One session is one meal (until finished, cut off at 30 min), at least
    three sessions with 50 swallows in total, one without and one with
    conversation, on two or more days. Markers s, c and t only; b, n and q
    are not pressed (0018). Acceptance criteria as in M1 plus fw=detector.
    M2 numbers come only from detector-recorded meal sessions. The record.py
    arguments, detect/feat file names and check_session support are marked
    as fixed by #23.
2026-09-24 #18 Decide the IMU/audio fusion and the Edge Impulse data
    Device computes per-window features (IMU 14 dims as in 0012 plus a
    reduced audio set fixed in #21) and feeds one vector to an int8
    classifier trained in Edge Impulse; EI DSP blocks are not used. Inputs
    are self-only feature vectors, one window per item, labels as in 0014,
    three classes (swallow/cough/other) collapsed to a binary output.
    Training on days 1-3, test on day 4, session-level validation. Project
    goes Public after the #21 checks; the exported C++ library is committed
    as-is. Mark the three M2 decisions as decided in docs/plan.md.
2026-09-24 #21 Fix the M2 audio feature formula (stage 1)
    Add analysis/features_m2.py (8 kHz by 2-sample averaging, 25 ms frames
    with 25 ms stride, per-frame pre-emphasis, 256-point FFT, centroid from
    the same spectrum; IMU dims and window grid reused from features.py).
    Parameterise firmware/bench (AF_PROFILE=1 selects the M2 formula, the
    default build is unchanged) and check the port against the Python
    implementation. On the Nano RP2040 Connect the audio hop takes 126 ms
    (134 ms with IMU), within the 200 ms working budget. A 3-fold CV inside
    days 1-3 stays within the agreed margins of the M1 formula; day 4 was
    not opened. Numbers in the log.
    [audio_features.cpp, audio_features.h, bench.ino, fft512.cpp, fft512.h]
2026-09-24 #21 Record the M2 audio feature formula in 0020 (stage 2)
    Fix analysis/features_m2.py on the d-prime formula chosen after the
    stage 1 measurements, add 27 synthetic-session tests, document the
    module and the planned ei_upload.py in analysis/README.md, and add
    docs/decisions/0020 replacing the audio part of 0012 for M2 only.
2026-09-24 #23 Define DETECT/FEAT streams and adapt record and evaluation
    frame.h gains FRAME_DETECT (window_t_ms, swallow prob as float32,
    positive, led) and FRAME_FEAT (window_t_ms plus pre-normalisation
    float32 features); logger behaviour is unchanged. record.py writes
    detect.csv/feat.csv and creates stream files on first frame; markers
    keep the send-time t_ms. check_session.py estimates window drops from
    window_t_ms without counting positives. New evaluate_detector.py counts
    events per docs/evaluation.md with the session span taken from the
    detector streams (0011 reinterpretation in 0021, send lag <= 1 s,
    float32 threshold comparison, --scorer hook). split.py excludes
    fw=detector sessions from the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
2026-09-24 #21 Add the Edge Impulse upload script (stage 3, dry run)
    analysis/ei_upload.py computes M2 feature vectors for the self sessions,
    labels windows swallow/cough/other per 0019, drops invalid and boundary
    windows, fits the normalisation constants on the fit sessions only
    (writes analysis/m2_norm.json), and uploads one window per request via
    urllib with metadata (session, day, t_ms). Day 4 is accepted only for
    the testing bucket after the constants exist. --probe sends nine
    synthetic items to check ingestion. 27 tests with a fake sender; the
    dry run on days 1-3 lists 14440 windows (437/152/13851). No upload yet.
2026-09-24 #21 Send x-file-name on ingestion requests
    The Edge Impulse ingestion API rejects multipart uploads without the
    x-file-name header (HTTP 422, seen on the first probe). Add the header
    with the same value as the multipart filename, document it, and test it.
    The nine-item probe into the project was then accepted.
2026-09-24 #21 Add --workers to parallelise the upload
    Sequential uploads ran at about 40 items per minute (six hours for the
    day 1-3 set). --workers N sends items of a session concurrently with a
    thread pool; headers, retries and duplicate handling are unchanged, a
    failed item stops after in-flight sends finish, and progress lines are
    flushed per session. Three tests added.
2026-09-24 #21 Add the M2 normalisation constants (stage 3)
    Per-feature mean and standard deviation over the valid windows of the 21
    self sessions of days 1-3 (15030 windows), as decided in 0019 and its
    addendum. Used to normalise the vectors uploaded to Edge Impulse and, via
    #22, by the detector firmware and the PC re-scoring. Day 4 is not
    included.
2026-09-24 #21 Record the upload, training and version (stages 3-5)
    Log the probe, the C-2 validation split, the day 1-3 upload (14440
    windows, duplicates removed and day 1 re-uploaded), the impulse and
    training settings, candidates A and B with validation numbers, the
    choice of B, version 1, the day 4 test-set upload (4824) and the single
    Model testing run (window-level, reference only). Note in 0019 that the
    validation sessions could not be read from Studio. README examples
    follow the C-2 form. Public switch is still pending the human checks.
2026-09-24 #22 Record the export, threshold and EI comparison; #21 Public switch
    Log the C++ export, the host build, the day 4 threshold table (0.95
    frozen; 58.8% / 0.75 per minute, reference only), and the comparison
    with the Edge Impulse model-testing probabilities (no mismatch at the
    threshold, 3 argmax mismatches, 176 of 4824 windows differ by at least
    one 1/256 step after matching the API rounding; recorded as a
    difference, no tolerance defined). Fix the classify result page path in
    ei_testing_result.py. Record the Public switch for #21.
2026-09-24 #24 Add the detector firmware (stage 1: modules, host tests, builds)
    firmware/detector: detector.ino plus sensors (PDM callback and an IMU
    RTOS thread; the only files touching Arduino/mbed APIs), audio_capture
    (two 4000-sample 16 kHz slices with FREE/WRITING/READY/IN_USE states,
    chunk-gap detection, sequence gaps), imu_capture (ring, moving-average
    period, 0012 validity rule), pipeline (0020 features, m2_normalize,
    classify, threshold 0.95, led 0), classify (Edge Impulse SDK confined),
    META and DETECT/FEAT packers. Shared sources are symlinks to
    firmware/bench and firmware/logger. No path sends raw audio. Host tests
    (187) cover the buffers, validity rule against features.py, META and
    frame l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
2026-09-26 #24 Make the detector keep up on the device (stages 2-3)
    On the board the first-fill of the audio window cost 1.2 s and every
    hop then dropped chunks, so no window was ever produced. The reuse path
    in firmware/bench/audio_features.cpp now computes each slice's new
    frames as the slice arrives (check_port output unchanged bit for bit).
    Profiling with a time-based stats line showed the IMU poll thread at
    2 ms / 100 kHz I2C costing 138 ms per hop; the defaults are now I2C
    400 kHz and a 4 ms poll, giving 208 ms per hop (audio 188, IMU 12,
    inference 6, send 1) with no drops. The IMU period baseline is the
    clamped mean of recent intervals (the non-gap moving average locked
    low at start-up). Profile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
2026-09-26 #24 Record the detector bring-up, profiling and 60 s check
    Log the module layout, the profiling ladder (P1-P6), the chosen
    defaults (I2C 400 kHz, 4 ms poll, -Os; 208 ms per hop), the worn 120 s
    run with marker timing, the 60 s water recording with check_session and
    the PC re-scoring (exact match), the raw-audio path greps, and the
    deviations from the plan. Update docs/status.md.
2026-09-26 docs: subagent の model は opus か sonnet を必ず指定する
    model 未指定の subagent はメインの model（Fable）を継承し、利用上限で
    止まった（#25・#27、9/26）。workflow.md「メインと subagent」に規則を書く。
2026-09-26 #25 Add the LED display to the detector (stage 1: rule, NINA output, PC recalculation)
    - led_rule.h/.cpp: docs/decisions/0018 の規則（緑 = 開始が [w − 1.75, w] にある陽性窓、黄 = それ以外）。
    Arduino 依存なし。消灯の式と、書き込みを飛ばしたときの表示の進め方も純粋な式で持つ
    - led_out.h/.cpp: 基板の RGB LED（WiFiNINA、黄 = 赤＋緑）。変化したときだけ書く。ACK が LOW でなければ
    書かずに数える。Arduino / WiFiNINA の API はこのファイルだけ
    - detector.ino: setup() でセンサの前に led_out_begin()。loop() に 1.0 秒の消灯のタイムアウト。
    DETECT の led は実際に表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
2026-09-26 #25 Record the LED bring-up, profiling, recordings and the hidden-LED finding
    - docs/log/2026-09-26.md「#25」: 極性、20 秒で止めて消灯、プロファイル 60 秒（total_max 207.9 ms、
    digitalWrite 最大 373 µs、led_skipped 0）、記録 A（water）・B（cough）の check_session と
    evaluate_detector の出力（led の不一致 0、PC の再採点との差 0）、緑の遅れ（6 口中 3 口、中央値 750 ms）、
    語と境界の grep、0018 の切り替え条件 (a) に当たったこと（基板の LED は装着すると見えない）
    - docs/status.md: #25 の項目と、人に諮ること（外付け 2 灯への切り替え、案A/案C）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
2026-09-26 #29 Add the indicator (second board's RGB LED fed by record.py) — stage 1
    - firmware/indicator/: indicator.ino（USB シリアルで 0/1/2 を受けて基板の RGB LED を点ける。1.0 秒届かなければ消灯）、
    indicator_rx（受信の解釈。Arduino 依存なし、host tests 37）、led_out.*・led_rule.h は ../detector/ へのリンク、README
    - tools/record.py: --indicator <port>。DETECT の led を別スレッドで 1 バイトずつ転送（読み取りとマーカーは書き込みを待たない）。
    開始前に開けなければ始めない、開始後の失敗では止めない。tests r10〜r17
    - docs/decisions/0018: 追記（切り替え条件 (a) に当た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
2026-09-26 #29 Record the indicator bring-up, latency and recordings; fix the upload-port example
    - docs/log/2026-09-26.md「#29」: 表示器単体の確認、PC → 表示器の往復（単体 0.82 / 2.13 ms、検出器と一緒 0.29 / 0.84 ms）、
    記録 C（目視 6/6 口、転送 292/0）と D（表示器を抜いても記録が続く。転送 58/134）、A との比較（取りこぼし 0%、
    led 不一致 0、再採点の差 0）、語と境界の grep、確かめていないこと
    - docs/status.md: #29 の項目、「今」の段落（#27 の meal を始められる。#30 は #27 の後）
    - CMakeLists.txt・firmware/indicator/README.md: 書き込みの -DPORT は実体の /dev/ttyACMx（b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
2026-10-01 #32 Move the indicator to the UNO R4 WiFi LED matrix (shapes) — stage 1
    - firmware/indicator/: UNO R4 WiFi 版。matrix_out（Arduino_LED_Matrix、このファイルだけ）、shape_seq（状態と時刻 → フレーム。
    Arduino 依存なし、host tests 表 11〜18）、shapes.h（生成物）と shapes/gen_shapes.py（図形の元、--check）、indicator.ino、
    led_out.* のリンクを削除。状態 1 = 流れる波線の動画（200 ms × 6）、2 = 微笑む顔、0 = 消灯（人の決定、10/1）
    - docs/decisions/0018: 追記（基板の変更、色 → 形、動画と顔は人の決定、赤は発光色、貼る表示とカードの文面）
    - CMakeLists.txt: SKETCH_NAME=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
2026-10-01 #32 Record the matrix indicator bring-up, latency and recordings
    - docs/log/2026-10-01.md「#32」: 表示器単体の目視（問題なし）、PC → 表示器の往復（単体 1.42 / 2.12 ms、検出器と一緒 1.16 / 2.64 ms）、
    記録 C'（目視 3/6 口は META 無しで消した最初の C'）と D'（表示器を抜いても記録が続く）、#29 の C・D との比較
    （取りこぼし 0%、led 不一致 0、再採点の差 0）、META の取りこぼし（#33）
    - docs/status.md: #32 の項目と「今」の段落。実機: 検出器 795773a、表示器 2bc1ef6（UNO R4 WiFi）
2026-10-01 #33 Resend META on request so record.py always gets meta.json — stage 1
    - detector.ino: loop() の先頭で 20 ms ごとに受信を確かめ、合図 'M'（DETECTOR_META_REQUEST）で setup() と同じ META を
    1 回送り直す。起動時の 1 回は残す。他のバイトは捨てる。DETECTOR_PROFILE に meta_resends / meta_send_max
    - record.py: 開始時に 'M' を送り、5 秒以内に条件を満たす META（fw が空でない文字列。detector なら threshold・model・
    feature_names。--cond meal なら fw == detector）を受けてから Session を作る。届かなければフォルダを作らず終了コード 1。
    待つ間のフレームは記録の開始前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
2026-10-01 #33 Record the META-on-request bring-up and recordings
    - docs/log/2026-10-01.md「#33」: 挿し直さずに 2 回続けて META を受けた、挿し直すと META 2（観察）、60 秒 water ×2
    （表示器なし・あり）で飛び 0・led 不一致 0・再採点の差 0、プロファイル（合図 7 回 / META 8、再送 1 回 最大 2.6 ms、
    total_max 207〜208 ms、wall_max 211〜212 ms、取りこぼし 0）、合格の条件との照合、#34 の切り出し
    - docs/status.md: #33 の項目、「今」の段落（次は #27 の meal。挿し直し不要）
    - firmware/indicator/README.md: 記録の行から「挿し直してから」を外す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
2026-10-01 #34 Keep a trailing 0xA5 so a frame split at the SYNC is not lost
    - tools/record.py parse_frames: SYNC が見つからないとき末尾が 0xA5 なら 1 バイト残す（読み取りの切れ目が
    A5 と 5A の間に来てもフレームを失わない）。他の分岐は不変
    - tests r25（SYNC の途中で切る）、r25b（1 バイトずつ）、r25c（ゴミは捨てる）。tools 50、analysis 261
    - docs/log/2026-10-01.md「#34」、docs/status.md
2026-10-02 #27 Stop discarding meal sessions for missed or late s; cut off on 10/4
    - docs/decisions/0023: meal の s は意識した食べ物・飲み物の嚥下に押す。打ち忘れ・打ち遅れでは捨てず、体感（3 段）を
    集計表に書く。捨てる条件は 9 項目。記録は 2026-10-04 の終わりで打ち切り、続けて評価して #28 に渡す
    （3 本未満は合算を出さない）。docs/evaluation.md の定義と合格線は変えていない
    - docs/recording-protocol.md: meal の節と早見表の M2 の行を 0023 に合わせる（M1 の節は不変）
    - docs/log/2026-10-02.md: 予行の water 4 本（装着し直しで検出 0/3 → 3/3。参考値）、meal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
2026-10-02 #28 Record the milestone reorg and the throat mic on UNO Q
    - docs/decisions/0024: 本人試用を応募期間の外に出す。#27 は 10/4 で打ち切って #28 で判定し、結果にかかわらず M3 へ。
    M3 = 咽喉マイクの試用、M4 = 検出器（咽喉マイク版）。試用ブランチは関門の前に始めてよい（main は関門の後）
    - docs/decisions/0025: 音を咽喉マイク SH-12JK、基板を手元の UNO Q に。Linux 側は音声をディスクに書かない。
    0001・0002・0019・評価の定義との関係、後の plan で決める記録形式の 4 項目、CLAUDE.md の差し替えの順序
    - docs/decisions/0026: IMU なしで始める（仮説）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
2026-10-02 #28 Update the proposal for the throat mic on UNO Q
    - 7・8 章を UNO Q と咽喉マイクの構成に。5 章の表から頭部・体幹角と食事場所を「将来の拡張」へ
    - LED の説明を docs/decisions/0018 の緑・黄・消灯の「目安」に合わせる（次の一口や中断を指示しない）
    - 姿勢との同時記録は「設計上の拡張点（未実施）」。9・11・12 章を本人試用が応募期間の外である前提に
    - docs/decisions/0024〜0026
2026-10-02 #28 Align three proposal passages with the throat mic setup
    - Section 4, item 1: say the device records swallow events and counts;
    latency, laryngeal movement and coughing are extension points that are
    not implemented at submission time (same granularity as the table in
    section 5).
    - Section 6: replace "cheap sensor and small microcontroller" with what
    the project actually tests (a throat mic that has been used for
    cervical auscultation in care settings, per the maker's published
    example, plus a general-purpose Arduino), and note that GOKURI detects
    swallows from sound, per its public descriptions.
    - Section 12: the mitigation for wearing acceptance is now adjusting the
    capsu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
2026-10-02 Record the M3 issues (#36-#42) in the status
    - docs/status.md: list the seven issues filed for M3 (throat mic trial)
    with their dependencies, and note which run on the trial branch
    trial/throat-mic before #28 and which must wait for main after #28
    (decision 0024).
    - Record the signal criteria that #36 will fix in the log before any
    recording (decided by the user on 10/3).
    - Pending items: the LSM6DSOX and the two adapter cables for the NZ-210C
    receiver are to be procured by the user; CLAUDE.md is to be replaced
    after #38 and before the plan for #39; the wireless boundary question
    is tracked in #42.
2026-10-03 #27 Record the second meal session (no conversation) in the log
    Add docs/log/2026-10-03.md with the acceptance summary for
    20261003-194511_self_meal: 780.3 s, s 49, t 0, no frame loss, XOR
    mismatch 0, META 2, meta.json matching the first session. Accepted
    under docs/decisions/0023. Two accepted sessions so far (one with and
    one without conversation, two collection days, s total 94). Positives
    have not been looked at.
    Update docs/status.md: one more meal session is needed by 2026-10-04.
2026-10-04 #27 Evaluate the three meal sessions and hand the M2 numbers to #28
    Run evaluate_detector.py on the default target at 4f4ca8e (reproduced
    twice, rescoring with m2_scorer.py matches the device on every window).
    Detection rate 0.150 (TP 21 / FN 119) and false detection rate 2.03 per
    minute (FP 89 / 43.86 non-swallow minutes); neither M2 pass line is met.
    Definitions, threshold and model are unchanged; the decision belongs to
    #28. The log carries the full report, the breakdown by day and by
    conversation, the 0017 questions and the hand-off table.
2026-10-04 #28 Record the M2 gate verdict: not passed, next stage is the throat mic
    Add decision 0027. The meal evaluation misses both M2 pass lines
    (detection rate 0.150, 2.03 false detections per minute), so the gate is
    not passed and the project moves to the throat mic and UNO Q as decided
    in 0024 and 0025. The Codex gate review (base gate-M1) raised three
    findings; the two that are not the numbers themselves are CONCERN by
    human decision: the capture faces keep the waveform in RAM until
    overwritten (no path out of the detector), and --sessions does not check
    cond (the report shows the target). Update the log and the status, and
    set review-M2 as the base tag for the next gate review.
    Co-Authored-By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
2026-10-07 #36 Add throat-mic-only sessions to record.py via the UNO Q route
    tools/record.py gains --throat <iface> (plus --throat-host and
    --throat-device): a session with no serial device, where a child
    process (arecord on the UNO Q over ssh, or arecord on the PC with
    --throat-host local) streams raw S16_LE PCM to stdout and the PC writes
    data/raw/<session>/throat.wav (48 kHz, 2 ch, as received),
    throat_chunks.csv (arrival time and first frame of each read) and
    events.csv. Markers use the PC monotonic clock from the first PCM byte.
    meta.json gets fw = pc-throat, the iface, the actual sample rate, the
    arecord settings, overrun line count, an estimated frame difference and
    the read-only mixer gain. --s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
2026-10-08 #37 Log the wired throat-mic sessions and the fixed-criteria results
    Five wired sessions (quiet 100 s, water, cough, neck, talk with six
    markers each) recorded on 10/8 through the UNO Q route: zero overruns,
    no steps, all five taps found in each. The tap delta medians are
    -55 to -74 ms, past the 50 ms cue, so the sessions carry a mark and the
    user decided to use them without correcting the mapping. One aborted
    8.5 s quiet session is listed as unused.
    Against the criteria fixed in docs/log/2026-10-07.md, the wired route
    meets all three (s amplitude ratio median 137.66; s IQR above the quiet
    IQR; 6 of 6 s exceed twice the quiet median). The log lists the ratios
    for c, n and t, the band energy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
2026-10-08 #37 Note the actual mic position for the wired sessions
    The wired sessions carry the default position in meta.json; the user
    reports the mic sat beside the trachea just below the cricoid. Later
    throat-mic recordings pass --position lateral-below-cricoid.
2026-10-08 #38 Log the NZ-210C direct A2DP pairing trial on the UNO Q (route B works)
    Hands-on trial on 10/8 before the #38 plan, at the user's request: the
    NZ-W210C transmitter paired with the UNO Q acting as an A2DP sink and
    its audio reached the arduino session's PipeWire as a bluez_input node
    (SBC, 48 kHz, 2 ch), read with pw-record to stdout only. Four things
    had to change, each recorded with who made it: the Bluetooth class
    (the transmitter filters by Audio/Video), bluez disabled in the lightdm
    WirePlumber (it owned the endpoints), seat monitoring disabled in the
    arduino WirePlumber (an ssh session is not the active seat), and the
    stale bond removed before each pairing because the transmitter com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
2026-10-08 #42 Record the user's decision to use NZ-210C route B only
    Route B (transmitter to the UNO Q as an A2DP sink) worked on 10/8, so
    the user decided not to use route A (transmitter, receiver, adapter
    cables, USB audio); the 6.3 mm to 3.5 mm cables are not being
    procured. The #37 route-difference criterion keeps its number (20%)
    and its computation; only the compared route changes from the receiver
    path to the A2DP path, and the route B sessions are recorded after this
    decision. record.py still accepts arecord with hw/plughw only, so the
    #38 plan has to extend the --throat path to pw-record under Codex
    review. The 0025 addendum stays with #42.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
2026-10-08 #38 Record route B (A2DP into the UNO Q) as a second recording-only path
    docs/decisions/0030, adopted by the user on 10/8: the NZ-W210C
    transmitter sends to the UNO Q acting as an A2DP sink, pw-record on the
    UNO Q writes raw PCM to stdout only, and tools/record.py on the PC
    writes data/raw/<session>/throat.wav. The same rules as 0028 apply
    (PC writes, nothing of the project and no audio on the UNO Q, self
    only). The paths left open are listed as a CONCERN handled
    operationally, and whether the wireless link may be used by the
    detector itself stays with #42.
    In the same commit, as docs/workflow.md requires, the recording-path
    sentence in CLAUDE.md, AGENTS.md invariant 4 and viewpoint 1 of th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
2026-10-08 #38 Add route B (A2DP via pw-record) to record.py --throat and throat_check.py
    tools/record.py: the iface sh12jk-nz210c-a2dp-unoq now runs pw-record on
    the UNO Q over ssh (stdout only, fixed arguments with
    node.dont-fallback, node.dont-reconnect and a fixed stream name).
    --throat-device accepts only bluez_input.<addr>.<n> names for this
    iface and only hw/plughw names for the ALSA ifaces; when omitted, the
    node is found from pw-dump if exactly one A2DP source exists. Before
    starting, one ssh read checks the PipeWire/WirePlumber user config, the
    node (Audio/Source, a2dp-source, not muted, no other capture, no
    pipe-tunnel module). After the first bytes a second read verifies the
    link, and two s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
    [record.py, test_record_throat.py, test_throat_check.py, throat_check.py]
2026-10-10 #38 Fix the route B pre-check to the measured PipeWire shape; fix ZERO_RUN_MS = 100 ms
    Measurements E1-E6 and E9 ran on the UNO Q on 10/10 (results in
    docs/log/2026-10-10.md). Two assumptions in the plan did not match the
    board: the bluez source node has media.class Stream/Output/Audio, not
    Audio/Source, and the seat-monitoring config fragment is a five-line
    nested block. record.py now accepts either media.class together with
    the a2dp-source profile, and compares the fragment's normalized content
    with the expected block instead of matching one line. The node format
    rate is 44100 (48000 is PipeWire's conversion); pw-record exits by
    itself when the target is missing and does not fall back.
    Th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
    [record.py, test_record_throat.py, test_throat_check.py, throat_check.py]
2026-10-10 #38 Log the cleanup checks (6b): no pw-record or stream is left on the UNO Q
    Four stop paths were exercised on the real route B on 10/10: duration
    end, Ctrl-C (stop = interrupt, link_check = ok), SIGTERM of the child
    argv started outside record.py, and a stall caused by powering the
    transmitter off (stop = stall, exit 1). After each, the UNO Q had no
    pw-record process and no zm-throat-record stream. The start-wait
    timeout path (a) was tried once and the window was not hit because
    audio arrives within about 0.6 s; the user accepted (b) as the check
    of the stop mechanism. Test sessions were deleted without looking at
    their amplitudes. E8: the node name keeps its suffix across a power
    cycle; th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
2026-10-10 #37 Record the decision to drop route B from recording and continue wired
    The NZ-W210C manual lists no noise-gate or auto-mute setting, so the
    silence gating found on 10/10 cannot be turned off. The user decided
    that route B (transmitter to the UNO Q over A2DP) is not used for the
    throat-mic training recordings: the quiet baseline of the fixed
    criteria cannot be taken over a gated link and the latency is large and
    variable. #39 and the M4 detector use the wired USB audio route. The
    #37 route difference is recorded as "cannot be judged". The route B
    code, 0030 and the UNO Q settings stay; the 0025 addendum (#42) will
    summarise routes A and B.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
2026-10-10 #37 Record the user's judgment: the swallow signal is visible over the wired route
    M3 step (1): the user judged on 10/10 that the throat mic shows the
    swallow signal, based on the five wired sessions of 10/8 meeting all
    three fixed criteria. The route difference stays "cannot be judged"
    because of the transmitter's silence gating. Closing #37 is the user's.
2026-10-10 #39 Fix the throat-mic recording protocol and 0031 before the first collection day
    Stage A of plan #39 (Codex: three LGTM after one round of concerns).
    docs/recording-protocol.md gets a "throat mic (M3)" section built on
    the M1 procedure: wired route only, position lateral-below-cricoid,
    the supplied strap, seven sessions per collection day in the M1 order,
    210 s per session (five Enter taps with the mic, then put it on, then
    an "o start" marker that begins the evaluated span), the same markers
    as M1, throat_check.py right after each session, the discard rules
    including the tap-delta rule fixed by the user (3 taps and a median
    within 125 ms), four collection days by 10/18 with the last two f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
2026-10-10 #39 Log that the throat mic is worn on both sides for all collection days
    The SH-12JK has one element on each side of the trachea and both are
    worn with the supplied strap, so the "side" entry of 0031 is "both" and
    stays the same for all three collection days. The two elements arrive
    as one signal (L = R), so no per-side recording is made.
2026-10-11 #39 Rename stage A/B to step A/B in 0031 and the status
    The user chose "ステップ A/B" over "段 A/B", which is not a common
    wording. Only the two files that used it are changed; no content changes.
2026-10-11 Record that Bluetooth on the UNO Q was disabled with rfkill
    The user decided to turn off Bluetooth on the UNO Q since configuration B
    (A2DP from the NZ-210C transmitter) is no longer used for recording and
    the adapter was still discoverable. The user ran the rfkill soft block
    with sudo; main.conf, the WirePlumber files, linger and the record.py
    code path stay as they are. The setup document gets a table row and a
    note before the pairing procedure, with the way to re-enable it.
2026-10-12 #43 Add the throat-mic feature-set comparison, post-processing, and figures (stage 1, synthetic tests only)
    Stage 1 of plan #43 (PLAN-SHA 812729f1737f6598, Codex 3x LGTM):
    analysis/features_v2.py computes the fixed comparison sets (base15,
    a52, base15_mw, a52_mw, mfe40) from an in-memory 16 kHz signal so the
    same code can run on the device later; postprocess.py adds the
    hysteresis post-processing; compare.py runs the leave-one-session-out
    comparison on the training side only (the evaluation side is listed
    by name and never opened; there is no --final); visualize.py draws
    the three figure kinds for training sessions with the fine-resolution
    audio display limited to 10 s per figure. features.p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
2026-10-12 #42 Record the NZ-210C configuration results and the detector boundary as an addendum to 0025
    Append a dated addendum to decision 0025: configuration A was never
    tried and is not used; configuration B (transmitter to the UNO Q A2DP
    sink) works but the transmitter's noise gate replaces quiet input with
    exact zeros, so recordings and the M4 detector use the wired path;
    Bluetooth on the UNO Q stays disabled. The addendum defines the
    detector boundary: the microphone-to-board input link (wired or
    wireless) is inside the device and is not "transmission" by the
    detector, while the prohibition on the detector storing or sending
    the waveform after it receives it is unchanged, and lists the
    condition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
2026-10-12 Mark the wireless-link judgment as settled by #42 in the status
2026-10-12 #43 Run the feature-set comparison on the training side and pick a52 with hysteresis
    Stage 2 of plan #43 on the 14 training-side sessions (collection day 1)
    only; the 7 evaluation-side sessions were never opened. The full
    compare.py report, the 19 figures (14 per-session, 4 event panels,
    1 comparison scatter) and the selection are in the 2026-10-12 log.
    Selected by the 0014 rule over the 8 logistic-regression rows: a52
    (MFCC-13 window statistics, 52 dims, mel 0-4000 Hz) with hysteresis
    enter 0.85 / exit 0.65. Training-side CV: 67/67 detected, 2.16 false
    detections per minute. These are selection numbers and are optimistic;
    the always-positive reference (0.37/min) is lower than every row,
    wh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
2026-10-12 #40 Add the one-shot evaluation entry point and decision 0034 (stage 1, no real data)
    analysis/final_eval.py scores the throat-mic evaluation side (collection
    day 2, 7 sessions) exactly once with two pre-registered configurations:
    J, the CNN (mfe40, seed 0, hysteresis 0.95/0.85) used for the M3
    judgment, and R, a52 + logistic regression with hysteresis 0.85/0.65 as
    the reference that matches the M1 method. Both are retrained on all 14
    training sessions; nothing is re-selected. Before opening the
    evaluation side the entry point checks a clean tree, that decision 0034
    is committed and its FINAL-* lines match the constants, that no marker
    exists, then creates the marker docs/log/m3-final-40.txt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
2026-10-12 Add the M1 versus M3 evaluation-side comparison to the log as material for #41
2026-10-12 #38 Add the UNO Q MCU LED sketch, the Linux-side RPC caller, and the deploy target (PC side)
    Continuation of #38 (plan PLAN-SHA fa908f0da6355c58, Codex 3x LGTM).
    R0 on the device (read-only) confirmed the expected setup: arduino-router
    0.10.0 serving MessagePack-RPC on /var/run/arduino-router.sock, core
    zephyr 1.0.0 and Arduino_RouterBridge 0.4.3 on the board, no numpy or
    msgpack in its Python, Bluetooth still disabled.
    firmware/unoq_mcu/ exposes zm_set_led over the router bridge (RPC
    confined to rpc_server.cpp, GPIO to led_out.cpp, LED3 green). device/unoq/
    holds mcu_rpc.py (the only module that opens the router socket, with a
    small built-in MessagePack codec checked against the msgpack pa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
2026-10-12 #38 Log the upload, deployment, LED check, and RPC round-trip measurement on the UNO Q
2026-10-12 #38 Note that the user confirmed the LED turned off
2026-10-12 #38 Log the PD-power checks P1, P3 and P2b
2026-10-13 #38 Adopt decision 0035 and document the UNO Q MCU sketch, deployment, and PD-power checks
    The remaining #38 items are done on the device: the unoq_mcu sketch was
    uploaded over USB (adb / remoteocd), device/unoq/ was deployed with
    rsync (the user installed rsync on the UNO Q), the user confirmed LED3
    green turning on and off from the Linux side, and the RPC round trip
    measured 5.1 ms median / 5.2 ms p95 both on direct USB power and on the
    PD battery through the CM721 pass-through. On PD power the audio
    adapter is recognised and a 60 s quiet recording passes the discard
    checks (the session was moved to trial-throat). No audio file exists on
    the UNO Q; Bluetooth remains disabled. Decision 0035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
2026-10-13 #38 Show the #32 smile face on the UNO Q LED matrix for the LED check instead of LED3
    At the user's request the on/off check now drives the MCU-side 8x13 LED
    matrix with the static smile face the user chose in #32
    (firmware/indicator/shapes.h), left-aligned with the 13th column dark;
    off clears the matrix. The RPC name and the Linux side are unchanged.
    The wave animation and the display rule stay for M4. Decision 0035
    records this as a change to D6. The sketch builds (88,208 B) but has
    not been uploaded yet because the battery-runtime measurement (P4) is
    running on PD power.
2026-10-13 #38 Stop the idle battery-runtime measurement; the real measurement moves to M4
2026-10-13 Bring the #38 status row up to date (device steps done, P4 stopped, matrix sketch pending upload)
2026-10-13 #38 Correct the log: the battery measurement was stopped by the agent, not the user, and is resumed
2026-10-13 #38 Fix the resume time of the battery measurement in the log and status
2026-10-13 #38 Log the idle battery discharge rate (6.8 %/h) and the user's decision to stop P4
2026-10-13 #38 Flip the matrix face vertically and record the matrix-version check and timing
    The first matrix upload showed the smile face upside down on the UNO Q
    (its matrix row order is opposite to the UNO R4 WiFi); led_out.cpp now
    writes the rows flipped while the #32 frame table stays unchanged. The
    user confirmed the face and the clear. Round trip with the matrix
    version: 5.29 ms median, 5.41 ms p95. Decision 0035 and the setup
    document record the matrix version as uploaded. All three remaining
    #38 items are done.
2026-10-13 #38 Drive the UNO Q matrix with a state RPC showing the wave and the smile face
    Per plan-38d (Codex 3x LGTM, PLAN-SHA 1922dee707ff3658) the MCU now
    exposes zm_set_state(int) with the 0018 values: 0 clears the matrix,
    1 shows the flowing wave, 2 shows the smile face. The frames and the
    frame sequence are symlinked from firmware/indicator/ (and led_rule.h
    from firmware/detector/) so the #32 pictures have a single source; the
    old shapes_unoq.h is removed. The state is shared with the RPC thread
    through std::atomic<uint8_t> and drawn only from loop(); the
    Arduino-independent matrix_frame module (range check, vertical flip,
    13-column layout) has a g++ host test (793 checks). The Linux side
    gains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
2026-10-13 #41 Add the M3 gate materials (decision 0036, awaiting the user's judgment) and the gate review result
    The Codex adversarial review of the M3 diff against review-M2 approved
    with no material findings: no path on the detector side stores or sends
    the raw waveform, the recording path is separate, the one-shot
    evaluation entry keeps the day split and the pre-registered
    configurations, the report carries the confusion matrices and the
    session lists, and the pass line and the public-information line are
    unchanged. Decision 0036 assembles the checklist, the #37 and #40
    numbers, the recorded deviations, the comparison with M1 and the
    options; the judgment itself is left to the user.
    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
2026-10-13 Draft the M4 issue set (detector, throat-mic version) for the user's review
    Seven issues: the UNO Q inference base and per-window timing, the
    false-detection reduction study on the training side with a
    pre-registered configuration, the M4 split and recording plan, the
    on-device detector and display, the recordings, the single evaluation
    run, and the gate. The draft lists the decisions the main agent made
    with the reasons (start M4 early, meal sessions in training, numpy-only
    inference on the device, hop kept at 0.25 s, display rule on the Linux
    side, per-window results only to the PC, no audio outlet in the
    detector) and the points left for the user.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
2026-10-13 File the M4 issues (#44-#50) after the user's review and remove the draft
    The review added the FEAT stream for the evaluation meals, shared
    downsampling code between the device and the PC, a 0.5 s cap on the
    refractory candidate, hard-negative weighting, unbuffered detector
    output with latency logging, and settled D8 on recording the
    evaluation meals with the detector only. Training meals: 3 sessions
    10/18-10/22; evaluation meals: 3+ sessions on the last two days
    10/30-11/2.
2026-10-24 #44 Share numpy-only feature code between PC and UNO Q (stage 1)
    Add analysis/features_np.py (numpy and stdlib only): 48 kHz -> 16 kHz
    decimation (61-tap FIR matching scipy resample_poly, whole-session and
    block-wise), framing/power spectrum, mfe40, a52 (MFCC, delta) and
    cnn_forward. features_v2.py and tools/throat_check.py now call it, so
    the PC path and the device use the same code and the same filter taps.
    Mel matrices and a synthetic-input reference set are generated by
    make_features_np_consts.py and committed (not audio).
    Add device/unoq/bench_infer.py (synthetic input only, writes no files)
    to measure per-window time on the UNO Q: decimation, mfe40, CNN, a52+LR,
    RPC round trip, and th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
2026-10-24 #46 Fix the M4 split and recording plan (decision 0037)
    Add docs/decisions/0037: the M4 figures come from meal sessions recorded
    on the device within 2026-11-01..11-04 (3 or more sessions, 2 or more
    days, cut off on 11-04); the training side is the 21 M3 sessions plus 3
    training meals recorded over the PC path by 2026-10-28. Train and eval
    are separated by date, with name lists fixed in 0037 and fixed_eval.py
    before any figure is seen. Evaluation meals keep FEAT enabled but only
    as per-window summaries (82 dims), never the 98x40 mel frames. The M3
    list and check are left unchanged; M4 gets its own constants and checks
    (assert_m4_train / assert_m4_eval / m4_lines_match) plus tests.
    tools/rec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
2026-10-24 #44 Measure per-window time on the UNO Q and record the results
    Stage 2 and 3 of plan #44. Deployed the 9 shared files to the UNO Q
    (rsync --copy-links after the realpath check; sha256 identical to the
    PC) and ran bench_infer.py with synthetic input, 200 iterations, both
    with a single thread and with the default environment. The reference
    check passed (max diff 6.1e-08). Per-window medians: decimation 2.7 ms,
    mfe40 6.7 ms, CNN 27.8 ms, a52+LR 6.6 ms, RPC round trip 5.3 ms. The
    whole hop pipeline (config J, RPC included) is 45 ms at a 0.25 s hop and
    42 ms at a 0.1 s hop; J+R is 54 / 48 ms. Median, p95 and max all fit
    within 250 ms (0.25 s hop) and 100 ms (0.1 s hop). The hop is not
    changed he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
2026-10-24 #51 Add the runtime comparison bench and the converted random-weight CNN
    Stage 1 of plan #51 (PC side). make_runtime_models.py converts the same
    random-weight CNN used by bench_infer (features_np.random_cnn, seed 0)
    to ONNX (opset 17), TFLite and ncnn; the four files (87 KB in total,
    not audio and not trained weights) are committed and symlinked into
    device/unoq/ for deployment. test_runtime_models.py checks each format
    against cnn_forward within 1e-5 and inspects the operator lists.
    device/unoq/bench_runtimes.py measures the CNN stage with numpy
    variants (einsum, einsum without optimize, im2col), ONNX Runtime,
    LiteRT (CPU, GPU, GPU fp32), Arm NN (CpuAcc, GpuAcc, GpuAcc fp16) and
    ncnn (CPU,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
2026-10-24 #51 Read the Arm NN backends from the runtime device spec
    pyarmnn 33.0.0 (Arm NN 23.08) has no BackendRegistryInstance; use
    IRuntime.GetDeviceSpec().GetSupportedBackends() instead. Found on the
    UNO Q during stage 3; the CpuAcc rows run with this fix.
2026-10-24 #51 Record the runtime comparison on the UNO Q (decision 0039)
    Stages 3 and 4 of plan #51. Measured the CNN stage on the UNO Q with
    synthetic input and random weights, RPC included, 200 iterations each,
    one thread and default threads, plus a 60 s sustained-load run and a
    threaded overlap variant for the GPU rows. Per-window medians: numpy
    27.7 ms on the reference BLAS and 14.6-14.9 ms on OpenBLAS; LiteRT CPU
    1.3 ms, ONNX Runtime CPU 1.4-2.2 ms, ncnn CPU 1.7-1.8 ms, Arm NN CpuAcc
    2.2 ms; ncnn Vulkan on the Adreno 702 8.7-9.7 ms with 2.5 ms of CPU
    time. Every measured row fits within 250 ms (0.25 s hop) and 100 ms
    (0.1 s hop). Did not run: ORT XNNPACK EP (absent from the wheel), Arm NN
    GpuAcc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
2026-10-24 Trim the status to-do section to the open M4 work
    Drop the finished M2 and M3 issue tables and the old progress notes
    from "次にやること"; their results stay in the recent-status entries
    and the decisions. Keep the M4 table with #44, #46 and #51 marked done,
    the schedule from 0037, the next step (#45 plan) and the user's
    remaining tasks.
2026-10-24 #45 Add M4 candidate comparison code and smoke run (step 1)
    Add the step-1 code of plan #45 before any M4 performance number
    is seen: a causal post-processing stepper (hysteresis, 0.5 s
    refractory, run cap) and seed averaging in postprocess.py,
    optional per-window sample weights in compare.cnn_fit,
    m4_compare.py (M4 train listing that never opens folders after the
    cutoff, day-wise CV, nested hard negatives, 25 candidate rows,
    selection, false-positive breakdown, --smoke and --final-model),
    the m4train side of visualize.py, and the M4_CONFIG/M4_MODEL
    placeholders in fixed_eval.py. Record the smoke run (no
    performance numbers) in the log. Tests: analysis 418 -> 472.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
2026-10-28 Decide the device runtime: numpy im2col with OpenBLAS, LiteRT deferred to M5
    Decision 0040 (human, 10/29) settles 0039 decision 5 before the #47
    plan. The UNO Q keeps numpy as the only inference code (shared with the
    PC, 0025) but the convolution becomes im2col (padding, sliding window,
    one matrix product) and libopenblas0-pthread is reinstalled as the one
    exception to D9, with the thread count pinned to 1. With the 0038
    configuration (three CNN seeds per window) the expected hop cost is
    about 45 ms against 250 ms. LiteRT CPU, ncnn CPU and the GPU backends
    are recorded with their #51 numbers and deferred to M5. #47 measures the
    whole hop and the decision is revisited if the median exceeds 12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
2026-10-28 Record the OpenBLAS reinstall on the UNO Q (decision 0040, item 2)
    The human reinstalled libopenblas0-pthread 0.3.29+ds-3 (the version
    measured on 10/24); libblas and liblapack are in auto mode and point to
    OpenBLAS (priority 100), and numpy 2.2.4 loads it (16 openblas lines in
    /proc/self/maps). unoq-setup.md now states the BLAS in use, the auto
    mode, the one-thread rule for the detector, and that the package is no
    longer removed. Log 2026-10-29 updated.
2026-10-29 #47 Run the M4 detector on the UNO Q and record evaluation meals through it
    Implements plan #47 (approved 10/29, Codex plan review x3, BLOCKING 0),
    plus the stdin heartbeat addendum (human decision, no extra plan review).
    Device side (device/unoq/, deployed by deploy-unoq, 14 files):
    - audio_in.py is the only module that opens ALSA (arecord child,
    stdout pipe read in memory) or reads replay PCM from stdin; it also
    refuses disk swap and pipe-type core patterns and makes the process
    non-dumpable.
    - detector.py: 1.0 s window / 0.25 s hop, mfe40 -> three-seed CNN mean
    -> hysteresis 0.85/0.65 with 0.5 s refractory (decision 0038) -> LED
    rule 0018 -> zm_set_state over RPC; H/D/T/F/E out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
2026-10-29 Fix the M4 evaluation-meal acceptance rules for receive delay and clock drift
    Human decision of 10/29, written into the 0037 addendum before any
    evaluation meal is recorded:
    - condition 4 is hit when the max of delay_meas exceeds 1000 ms;
    delay_upper (which adds a round-trip outlier measured outside the
    recording) is printed but not used;
    - clock drift is accepted up to anchor_spread 250 ms and
    |clock_drift_min/max| 250 ms (one hop against the [t-0.5, t+1.5]
    marker window); the unmeasurable fixed latency is not corrected, as
    in 0029;
    - the evaluation meal stays without taps.
    unoq_session_check.py now applies both rules (verdict lines, missing
    values count as a hit), with tests (too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
2026-10-30 #48 Record the first M4 evaluation meal (2026-10-30) as accepted
    Add the docs/log/2026-10-30.md entry for 20261030-201124_self_meal recorded
    through the UNO Q detector (--feat --no-rpc): session-check results, marker
    counts, device timing and the human acceptance decision made before any
    positive/prob/FEAT value was shown. Update docs/status.md.
2026-10-31 #48 Record the second M4 evaluation meal (2026-10-31) as accepted
    Add the docs/log/2026-10-31.md entry for 20261031-145803_self_meal recorded
    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
2026-10-31 #48 Record the third M4 evaluation meal (2026-10-31, no conversation) as accepted
    Add the second entry of docs/log/2026-10-31.md for 20261031-195410_self_meal
    recorded through the UNO Q detector (--feat --no-rpc): session-check results,
    marker counts, device timing and the human acceptance decision made before
    any positive/prob/FEAT value was shown. The three accepted evaluation meals
    now meet the 0037 targets. Update docs/status.md.
2026-11-01 #48 Record the fourth M4 evaluation meal (2026-11-01, no conversation) as accepted
    Add the docs/log/2026-11-01.md entry for 20261101-134412_self_meal recorded
    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
2026-11-01 #49 Record the plan review (4 Codex rounds) and approval in the log and status
    Plan #49 (M4 evaluation-side scoring, once only) was drafted by a subagent,
    reviewed by Codex four times on one resumed thread (BLOCKING in rounds 1-2,
    all LGTM in round 4, PLAN-SHA 15e1f59302953f8c) and approved by the human
    on 2026-11-01. Note #48 closed and step A handed to the implementation
    subagent.
2026-11-01 #49 Add the M4 evaluation-side scorer (run once) and pre-register its procedure as decision 0041
    Step A of plan #49 (PLAN-SHA 15e1f59302953f8c, approved 2026-11-01).
    - analysis/m4_final_eval.py: new entry point that scores the four M4-EVAL
    sessions once. Pre-flight checks open nothing under data/raw; the marker
    docs/log/m4-final-49.txt is created with O_EXCL before any evaluation
    file is opened and is never removed; all checks run after the marker
    and before any number is printed; detect.csv/feat.csv are read with a
    loader that never echoes values (diagnostics carry file, line and
    column only, feat.csv keeps only its two time columns). Range starts
    at 'o start'; device/PC agre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
2026-11-01 #50 Run the M4 gate review against gate-M3 and draft decision 0042 (judgement pending)
    - Adversarial review of the 39 commits since gate-M3: needs-attention,
    two high findings, no BLOCKING. The human classified both as CONCERN:
    (1) the once-only marker is per checkout, so a separate worktree of
    commit 497b066 could re-score; recorded in 0041 as a known unclosed
    path, no shared ledger. (2) the MCU keeps the last state when the
    Linux-MCU RPC drops; an autonomous blank-out timer is to be added
    before M5 with a decision amending 0035.
    - decision 0042: judgement material drafted in the 'pending (human)'
    state: numbers copied from 0041 and the log, completion-condition
    check, break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
2026-11-01 README: rewrite the opening to the throat-microphone + UNO Q device and the M4 numbers
    The intro still described the M1-era IMU+microphone board and a per-meal
    summary store that was never built. It now states the current device
    (SH-12JK throat microphone, inference on the UNO Q Linux side, LED matrix
    'guide' display), that raw audio is discarded after feature extraction,
    the M4 evaluation result and what remains unverified. The rest of the
    README is left to #58.
2026-11-01 Record the ProtoPedia account and the work title 在宅MealPace (human, 2026-11-01)
2026-11-02 Add the GitHub Project for tracking and record its rules (0046)
    Create the Projects v2 board "zaitaku-mealpace - Development Management"
    (users/owhinata/projects/6, private, linked to the repository) with eight
    fields and five views, register issues #1-#59 and set their initial values.
    docs/workflow.md gains a "GitHub Projects" section: where the source of
    truth lives (issue state on GitHub, Status in the Project, Gate Result and
    Decision Status mirrored from docs/decisions and the issues, dates only
    from plan.md, milestones and issue bodies), the Status mapping, who updates
    it and when, and how the five views feed the weekly review.
    docs/decisions/0046 records the decision, the initial cl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
2026-11-03 #55 CLAUDE.md: p1 raw data goes to data/raw/ like self (0048)
    Rewrite the p1 line in "データの扱い" per docs/decisions/0048: p1 raw
    recordings are placed in data/raw/ like self, the encrypted-disk requirement
    is dropped, and the remaining rules are restated (never pasted into chat,
    issues or external services; aggregates and anonymised excerpts only; not in
    data/sample/; deleted after the model is fixed, 0005). The reference on the
    PC-side waveform line now points to 0005 and 0048.
    Edited by the agent on the human's explicit instruction (2026-11-03), using
    the diff proposed on #55. AGENTS.md and the codex-review skill were checked
    in the same step: neither mentions the encrypted disk,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
2026-11-03 #52 MCU turns the matrix off 2 s after the last state it noticed (0049)
    The UNO Q MCU sketch no longer keeps the last state forever when the Linux
    side stops sending: once loop() has noticed a zm_set_state reception, it
    blanks the matrix if no further reception is noticed for about 2 s
    (UNOQ_RX_OFF_MS = 2000, firmware/unoq_mcu/rx_hold.*). After a timeout the
    off state is latched until the next reception, so a millis() wrap after
    ~49.7 days cannot re-light a stale cue (adversarial-review finding, fixed).
    The handler only bumps an atomic reception counter; time is read on the
    main thread. The shared firmware/detector/led_rule.h (1.0 s for the M2
    detector and the indicator) is unchanged, and th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
2026-11-03 #53 Standalone detector mode, systemd user unit, and recording exclusion (0050)
    Add a standalone mode to the UNO Q detector (detector.py --live
    --standalone): it reads no stdin (no heartbeat), writes no lines to stdout
    (NullOutput), and leaves only text on stderr/journald (a code_sha256 prefix
    at start, window and error counts at the end; never per-window values).
    The matrix cue is the only output; the MCU's 2 s auto-off (0049) covers
    the case where the detector dies.
    Add device/unoq/zaitaku-detector.service (user unit, After=sound.target,
    Restart=on-failure with RestartSec=2 and a 10/120 s start limit,
    StandardOutput=null, StandardError=journal, KillMode=mixed), distributed via
    DEPLOY_FILE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
2026-11-03 #53 Record the on-device checks of the standalone autostart (0050)
    The human ran step B on the UNO Q (docs/log/2026-11-03.md "#53"): flock
    2.41.5 has --no-fork and the /home/arduino lock returns 0/75; the unit was
    linked and enabled; from power-on with no PC the wave appears after about
    40 s (the unit exits 1 twice while the MCU RPC is not yet provided and
    Restart retries); swallowing shows the face; kill -9 of a directly started
    detector blanks in ~2 s and stays dark, kill -9 of the unit's main process
    blanks and the wave is back in 2-3 s; stop blanks and does not restart,
    start brings it back; power-off blanks; booting without the audio adapter
    leaves the matrix dark, exit status 1, and th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
2026-11-05 #56 story.1: carry medication through the body, marked as unevaluated
    The opening now names medication as a second scene, so the rest of the
    text names it too: where the device is meant to be used, what the LED
    is not (not a confirmation that the medicine went down), the aim, and
    the closing. Every evaluation passage keeps saying meals only, and
    medication is added to the unverified list.
2026-11-05 #56 story.1: LED table with matrix illustrations, heading without "light"
    Rename the second section to "convey the swallow 'guide' on the spot"
    (human decision 11/5: the LED is the current prototype's output, not
    the final answer). Replace the three bullets with a table whose first
    column shows a small picture of the 8x13 matrix. The pictures are
    generated by tools/gen_led_images.py from the firmware's own shape
    source (firmware/indicator/shapes/gen_shapes.py), so they match what
    the device shows.
2026-11-05 #56 story.1: meaning column first, matrix pictures at half size
    Reorder the LED table to meaning / appearance / picture (human
    direction 11/5) and halve the generated pictures (101x66 px).
2026-11-05 #56 story.1: join the two sentences that introduce the device
2026-11-05 #56 story.1: shorter smile row and a softer LED sentence
    Table: the smile row's meaning is just "swallow detected"; "returns to
    the wave after a moment" moves to the appearance column. Drop the
    sentence listing what the LED is not; keep "the LED is one more cue
    for the caregiver" (human direction 11/5).
2026-11-05 #56 story.1: tighten the opening scene
    Shorten the two medicine sentences to the length of the first two lines
    and join them to the first paragraph. Join "meals and medication at
    home are every day" to the sentence before it. Drop the bold sentence
    about a cue at the everyday table (human direction 11/5).
2026-11-05 #56 story.1: drop the hospital paragraph and "in the current prototype"
    Remove the paragraph about VE at the hospital from the opening, and
    shorten the LED sentence to "the result is conveyed to the caregiver
    on the LED matrix" (human direction 11/5).
2026-11-05 #56 story.1: drop the development and demo section
    Materials, the repository URL, and the video go in ProtoPedia's own
    fields, and the video and evaluation are already described in the
    body, so the section is removed as a whole (human direction 11/5).
2026-11-05 #56 story.1: plain two-part account of how it was built and how far it got
    Fold the eight sub-sections into two sections of ordinary length.
    "How it was built" keeps the signal path, the two discarded attempts,
    and the no-audio-kept design. "How far it got" states the two measures
    in words a caregiver can read: of 208 swallows the developer marked by
    key press, the device detected 199 (95.7%); in 56 minutes without a
    swallow it fired 70 times (1.25 per minute). The TP/FN/FP table is
    gone, but the same counts are in the text, and the session list is
    reached through a link to decision 0042.
2026-11-05 #56 story.1: plain rates only; record the exception as decision 0051
    Human direction (11/5): the story names the first measure "of the
    swallows the person judged, the share the device detected", gives
    95.7% and 1.25 per minute without the counts behind them, restores the
    comparison with the first configuration as a table, and drops the
    guess about causes, the caveat about attributing the improvement, the
    link to the detailed record, and the closing sentence.
    Leaving the confusion matrix and the session list out of a published
    number steps outside CLAUDE.md's evaluation rule, so the human's
    decision is recorded first as docs/decisions/0051: the exception
    covers the ProtoPedia story only, the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
2026-11-09 #56 Add the cover image and the system diagram for the ProtoPedia page
    Both drawn by the human (11/6, diagram corrected 11/9). The people are
    illustrations; the photo shows only the device.
2026-11-13 #57 Record the video URL and that the materials are complete
    The human uploaded the demo video and decided (11/13) that the video,
    the cover image, and the system diagram are all the materials for #57;
    the wearing photo and the photo of the posted wording are not made.
    The video's content was not checked by the agent.
2026-11-13 #58 README: structure and usage follow the UNO Q detector
    The structure list gains the device, MCU sketch, the earlier firmware
    with its place in the history, and the ProtoPedia files. Usage shows
    the UNO Q build, upload, and deploy targets instead of the M1 logger
    steps, at the same level of detail, and points to docs/unoq-setup.md.
2026-11-13 #58 README: confusion matrix, evaluation sessions, and public links
    Attach the confusion matrix and the four evaluation sessions to the
    reported numbers, with a direct link to decision 0042 (carried over
    from the 11/3 review). Add links to the ProtoPedia page and the video.
